andrewpaterson/HCP65/Website/docs/runtime/index.md

# HCP65 Drivers and Runtime

The HCP65's device drivers and the runtime routines compiled programs call.

- [W65C816 Runtime](w65c816.md) - the compiler's multiply, divide, shift and BCD routines, with
  and without the maths tables, and where the tables are in memory.
