andrewpaterson/HCP65/Documents/HCP65/GPIO 4bit/GPIO 4bit.odt

FEATURES

- 4 bits of individually programmable IO
- 5V CMOS level outputs and 5V TTL level inputs
- Latch input values for later reading

DESCRIPTION

The HCP65 GPIO 4bit board is a general purpose input or output component with four individually programmable pins in a pseudo DIP package.

The HCP65 GPIO 4bit board is designed to interface with an 8bit microprocessors database

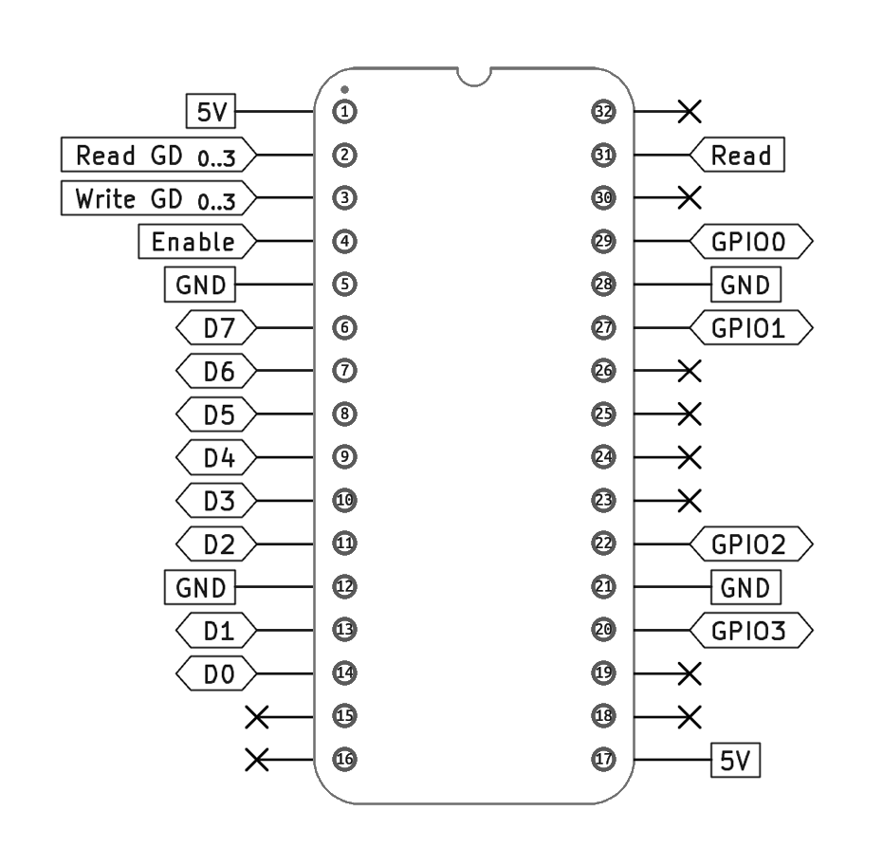
[picture p9: figure]

Pin | | I/O | Function
Name | Number
5V | 1, 17 | Power
GND | 5, 12, 21, 28 | Power
Read GD | 2 | I | Read from data bus.
Write GD | 3 | I | Write to data bus.
D0 | 14 | IO | Data bus. Eight data lines with 3-state outputs provide a bidirectional path for data and control of the GPIO board.
D1 | 13
D2 | 11
D3 | 10
D4 | 9
D5 | 8
D6 | 7
D7 | 6
Enable | 4 | I
GPIO0 | 29 | IO
GPIO1 | 27
GPIO2 | 22
GPIO3 | 20
No Connect | 15, 16, 18, 19, 23, 24, 25, 26, 30, 32 | NC

FUNCTIONAL BLOCK DIAGRAM

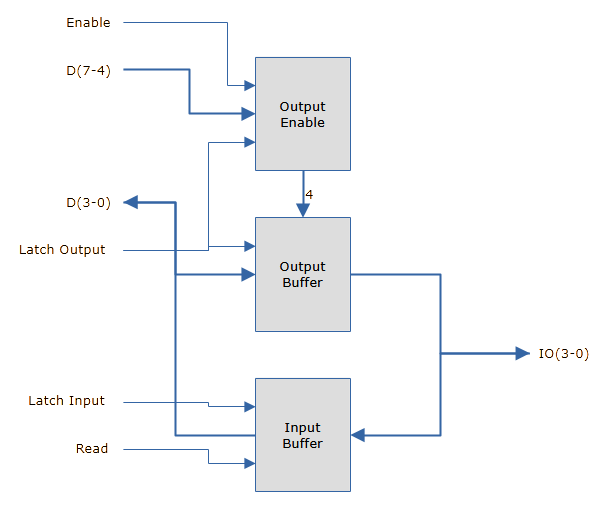
[picture p10: figure]

SCHEMATIC DIAGRAM

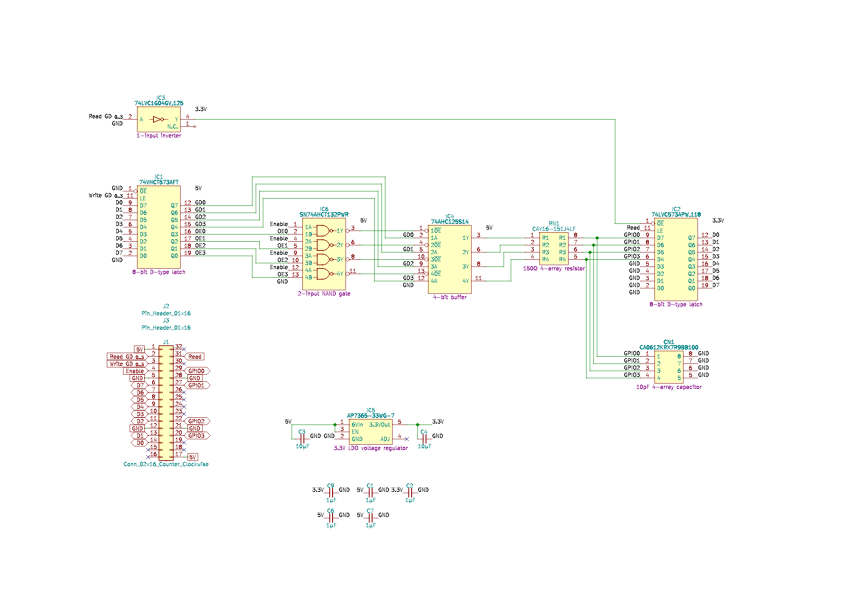
[picture p11: figure]

HCP65 GPIO 4bit
