andrewpaterson/HCP65/Documents/HCP65/Blank Pinouts/HCP65 32Pad Board W15.24mm.png

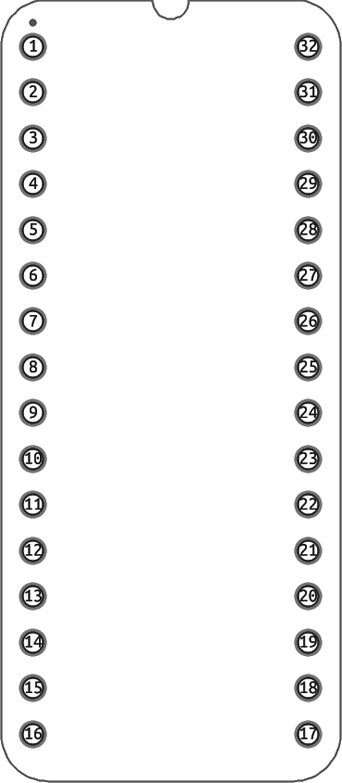
Documents/HCP65/Blank Pinouts/HCP65 32Pad Board W15.24mm.png
