andrewpaterson/HCP65/Documents/HCP65/Mainboard Small.png

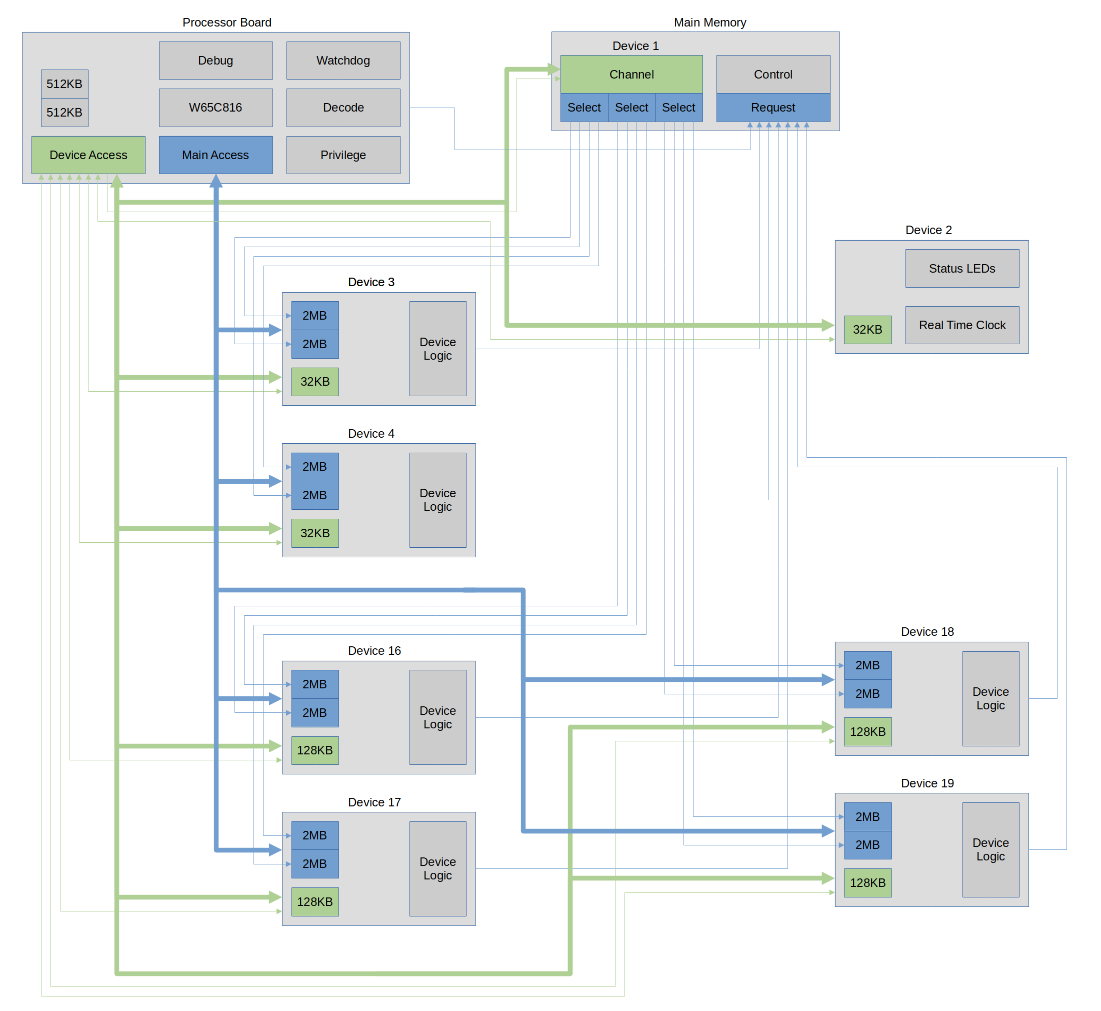
Documents/HCP65/Mainboard Small.png
