andrewpaterson/HCP65/Documents/NAND ABT.png

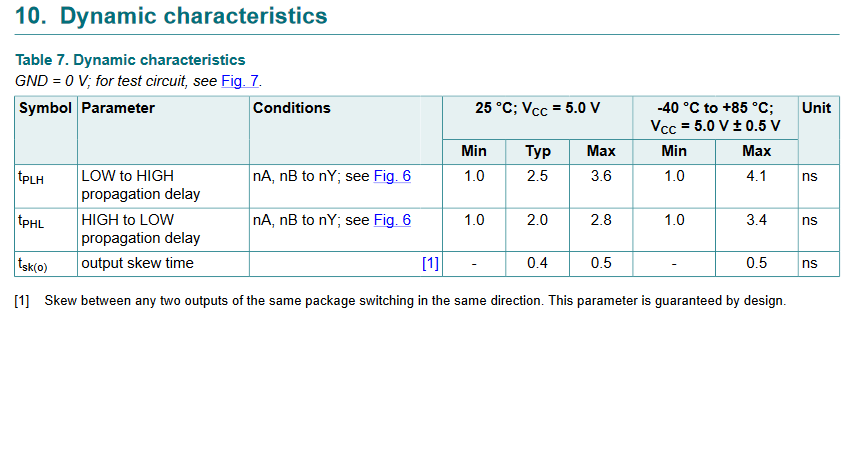
Documents/NAND ABT.png
