andrewpaterson/HCP65/Documents/NAND AC.png

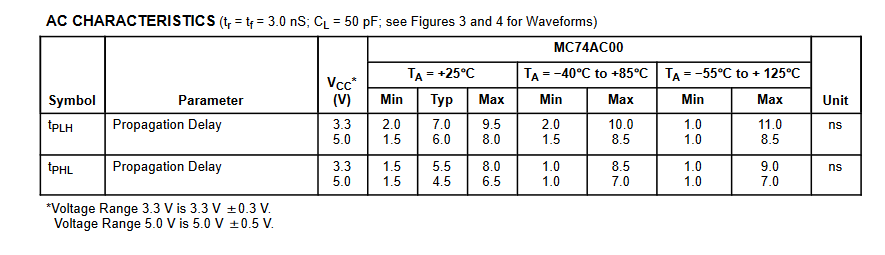
Documents/NAND AC.png
