andrewpaterson/HCP65/Documents/NAND ACT.png

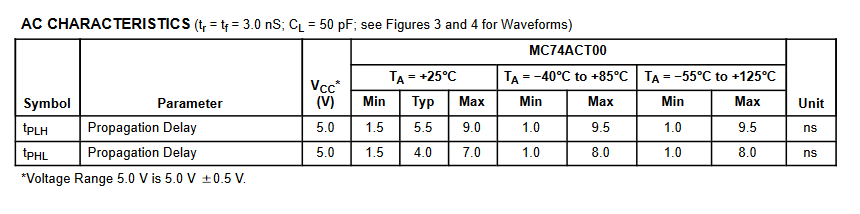
Documents/NAND ACT.png
