andrewpaterson/HCP65/Documents/NAND AHC and AHCT.png

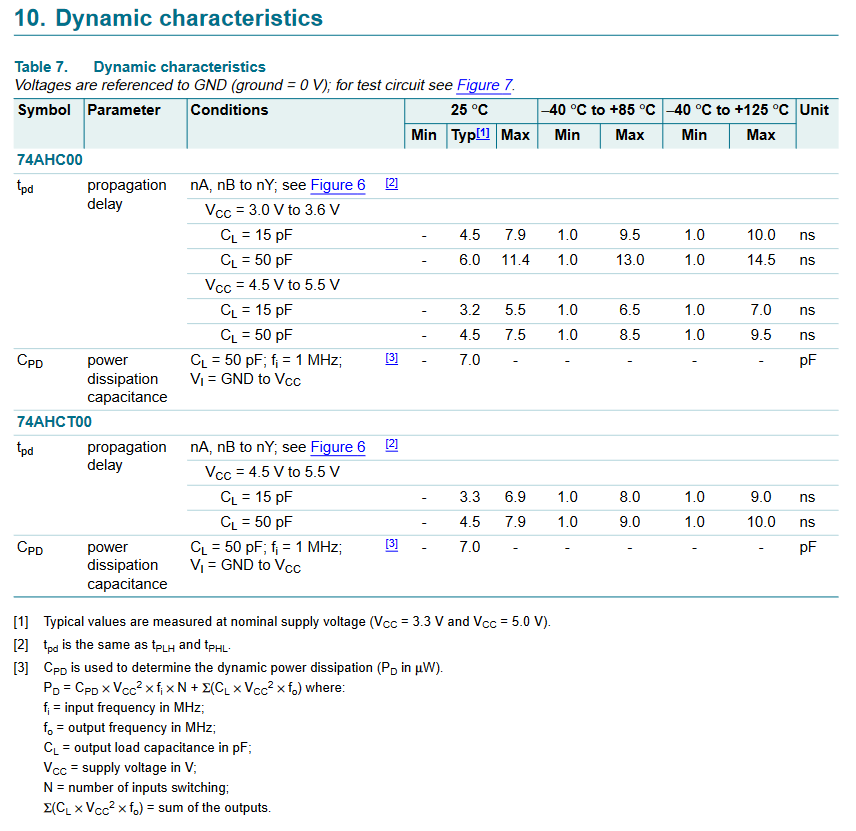
Documents/NAND AHC and AHCT.png
