andrewpaterson/HCP65/Documents/NAND ALVC.png

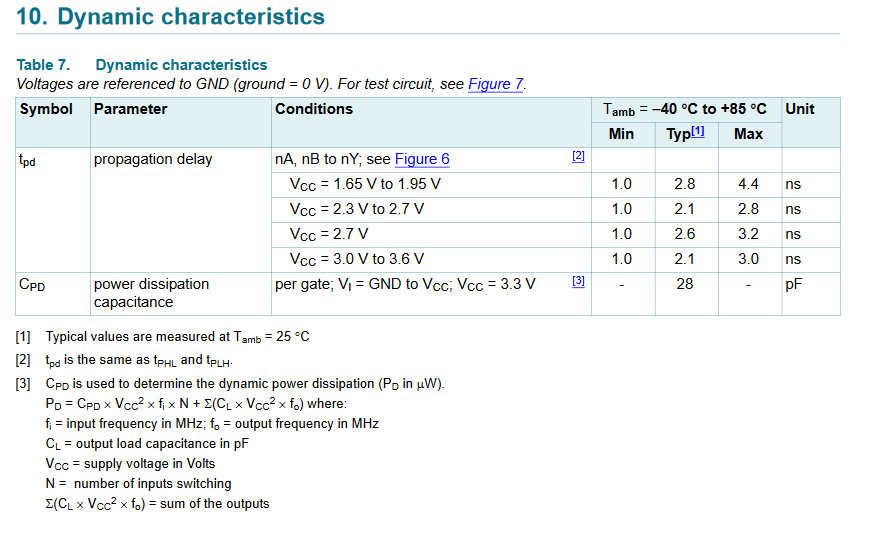
Documents/NAND ALVC.png
