andrewpaterson/HCP65/Documents/NAND F.png

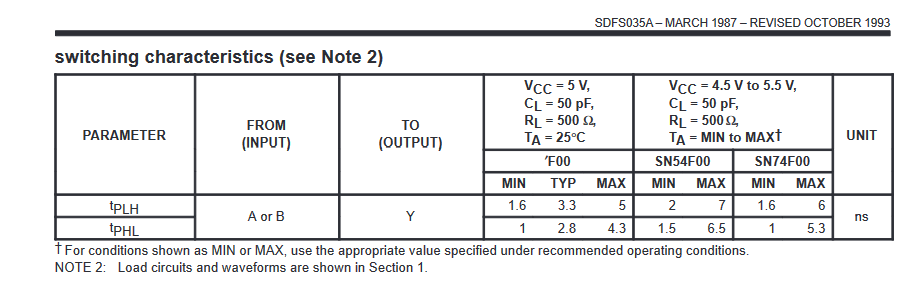
Documents/NAND F.png
