andrewpaterson/HCP65/Documents/NAND HC and HCT.png

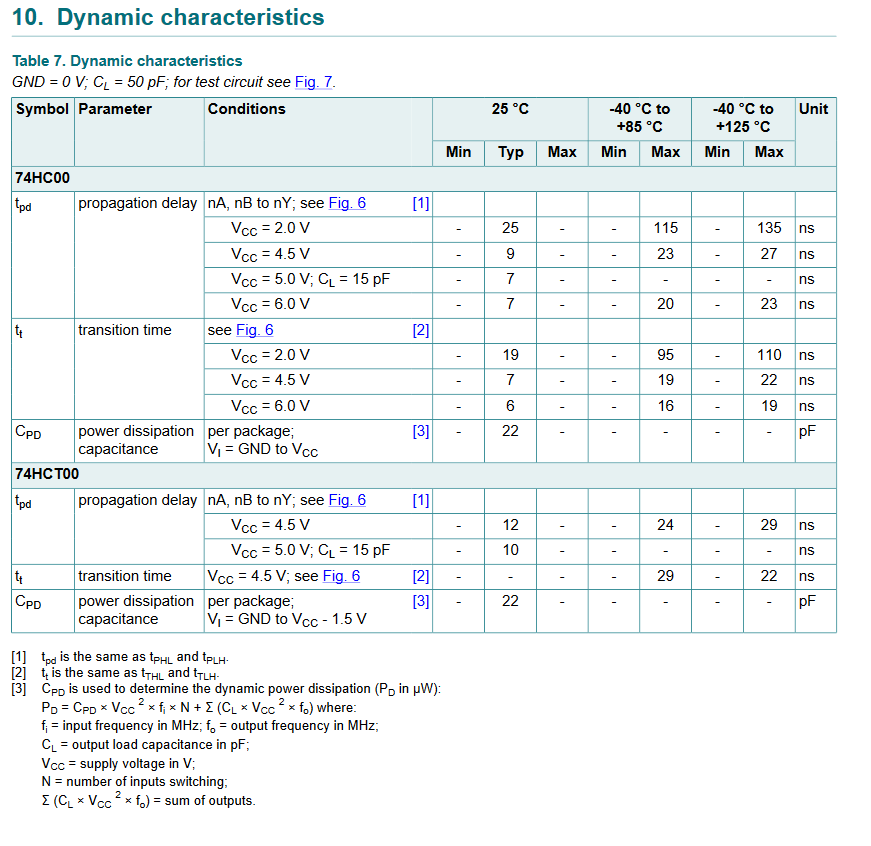
Documents/NAND HC and HCT.png
