andrewpaterson/HCP65/Documents/NAND LCX.png

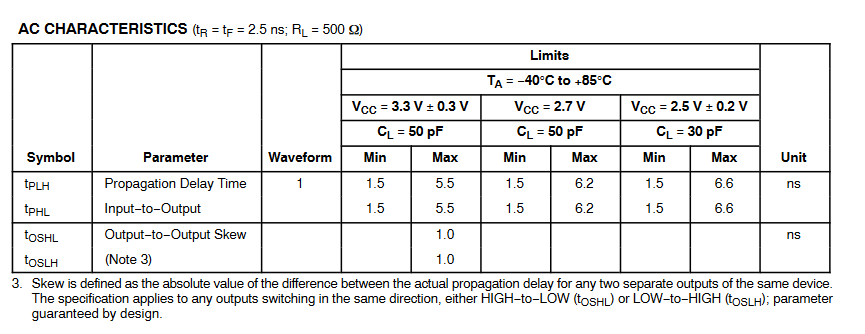
Documents/NAND LCX.png
