andrewpaterson/HCP65/Documents/NAND LV.png

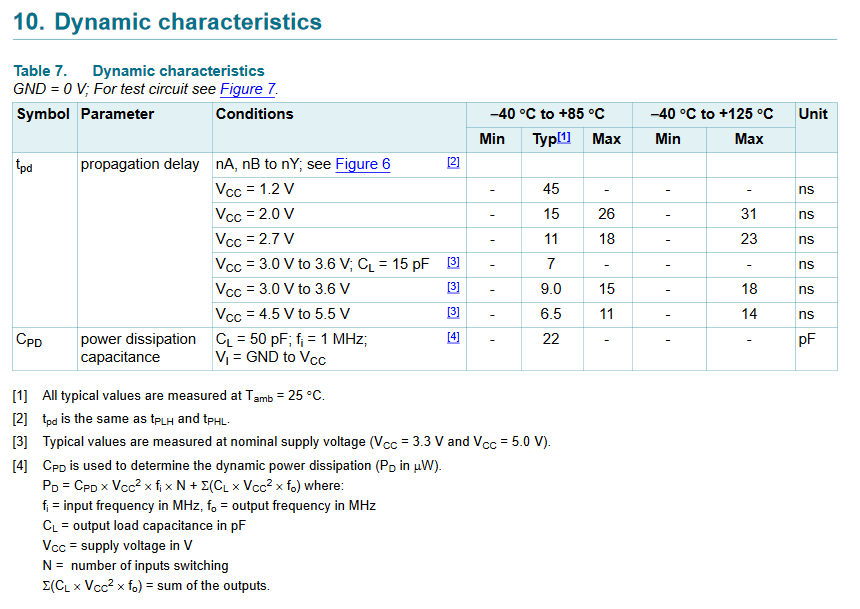
Documents/NAND LV.png
