andrewpaterson/HCP65/Documents/NAND LVC.png

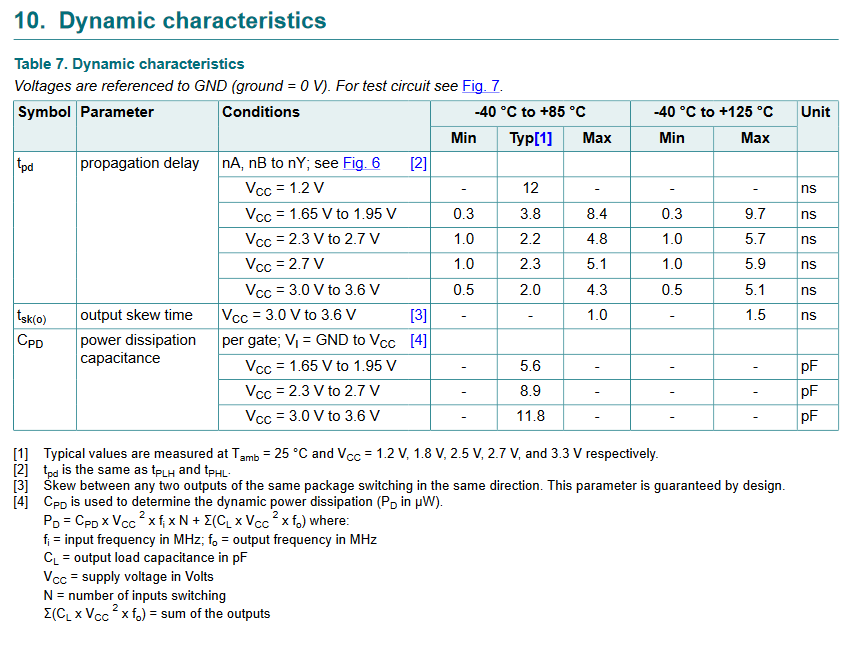
Documents/NAND LVC.png
