andrewpaterson/HCP65/Documents/NAND VHC.png

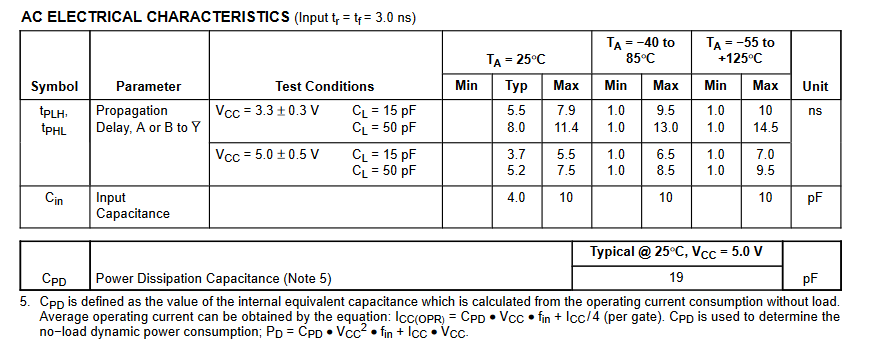
Documents/NAND VHC.png
