andrewpaterson/HCP65/Documents/NAND VHCT.png

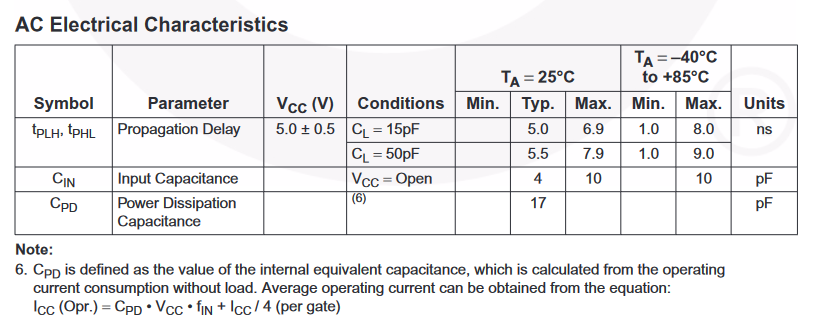
Documents/NAND VHCT.png
