andrewpaterson/HCP65/Pictures/3 Input Or Gare - Source 3V.png

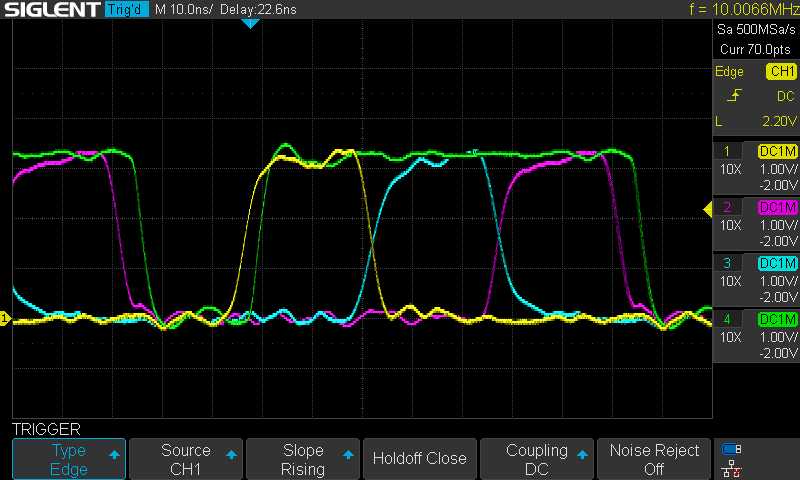
Pictures/3 Input Or Gare - Source 3V.png
