andrewpaterson/HCP65/Pictures/3 Input Or Gare - Source 5V.png

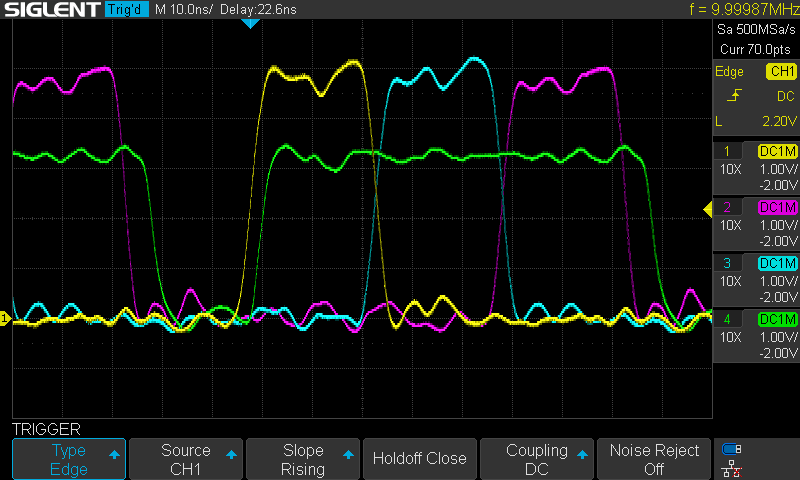
Pictures/3 Input Or Gare - Source 5V.png
