andrewpaterson/HCP65/Pictures/7 Segment Reader.png

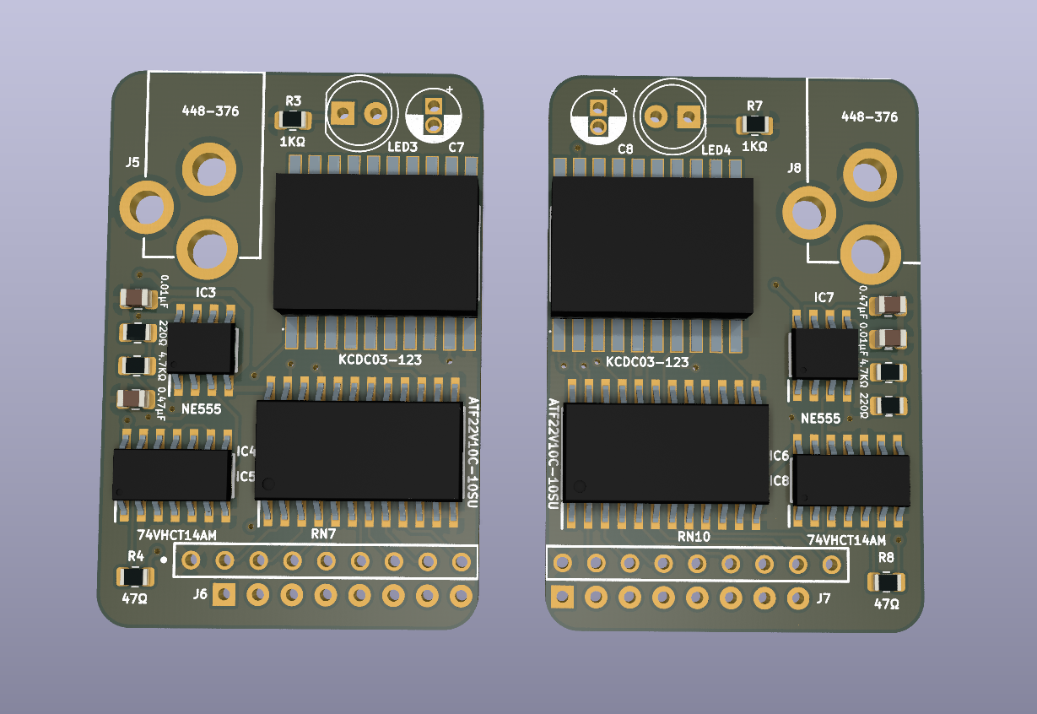
Pictures/7 Segment Reader.png
