andrewpaterson/HCP65/Pictures/300Hz No Schmitt.png

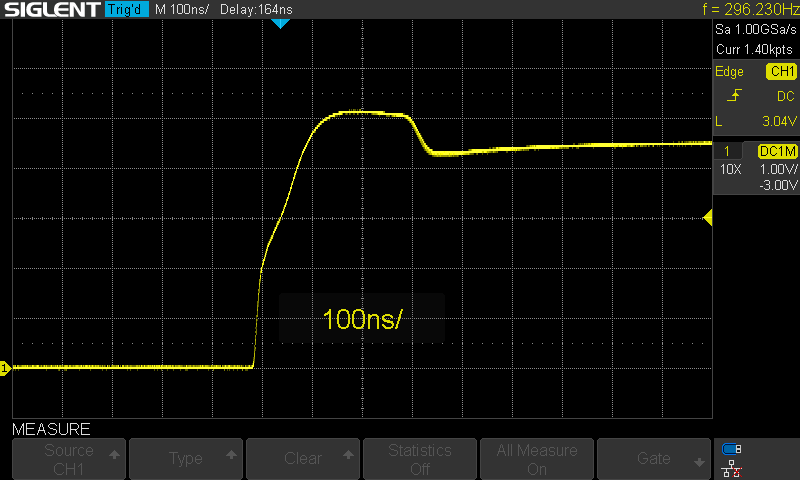
Pictures/300Hz No Schmitt.png
