andrewpaterson/HCP65/Pictures/300Hz with Schmitt.png

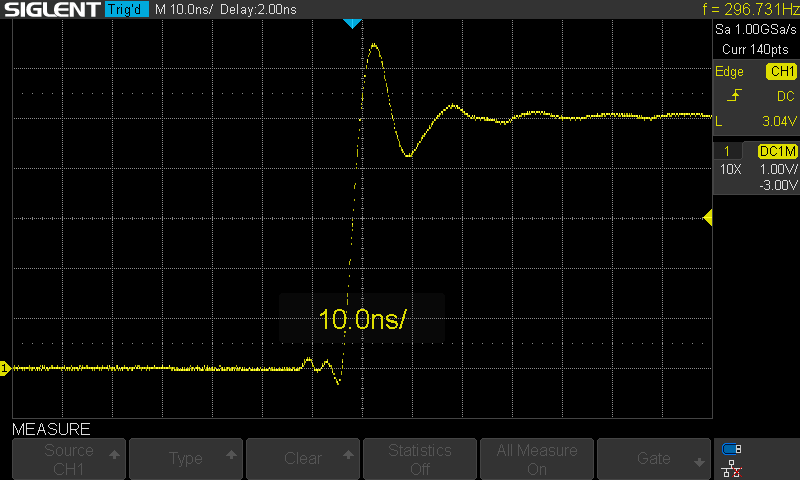
Pictures/300Hz with Schmitt.png
