andrewpaterson/HCP65/Pictures/300Hz.png

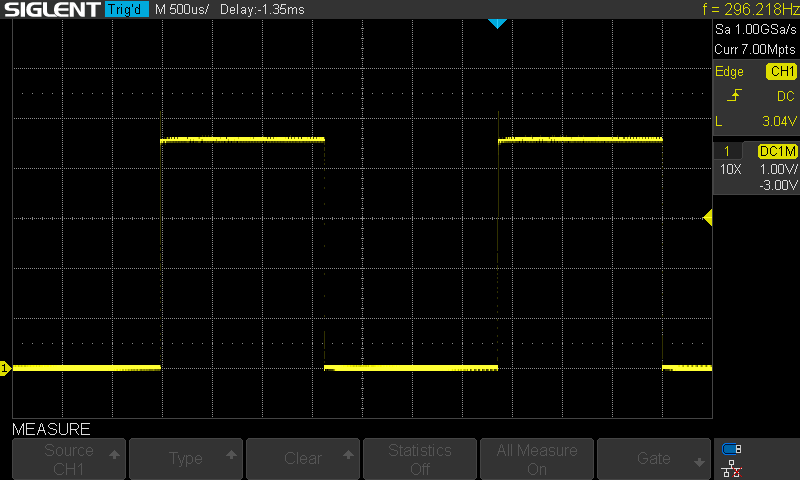
Pictures/300Hz.png
