andrewpaterson/HCP65/Pictures/400x300 Ref1.png

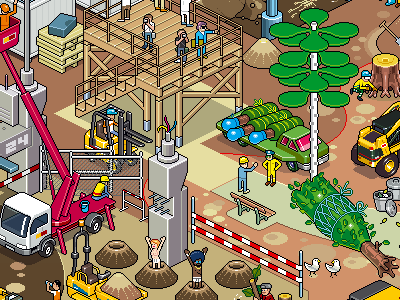
Pictures/400x300 Ref1.png
