andrewpaterson/HCP65/Pictures/400x300 Ref2.png

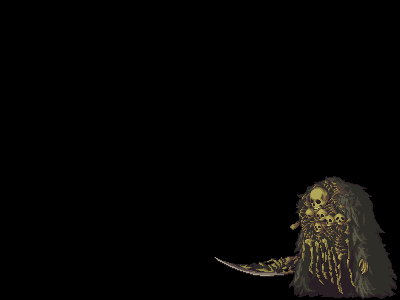
Pictures/400x300 Ref2.png
