andrewpaterson/HCP65/Pictures/400x300 Ref3.png

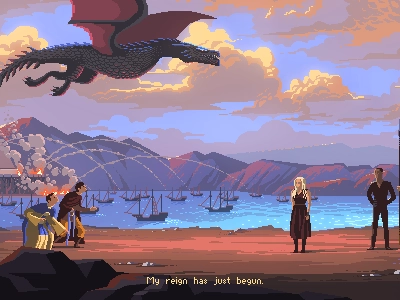
Pictures/400x300 Ref3.png
