andrewpaterson/HCP65/Pictures/400x300 Ref4.png

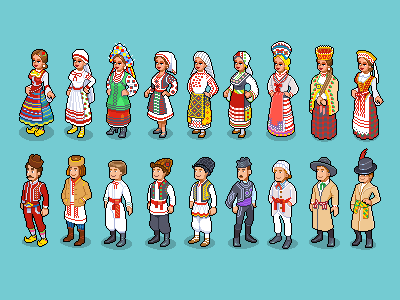
Pictures/400x300 Ref4.png
