andrewpaterson/HCP65/Pictures/816 Bodge Board V1 - important stuff.png

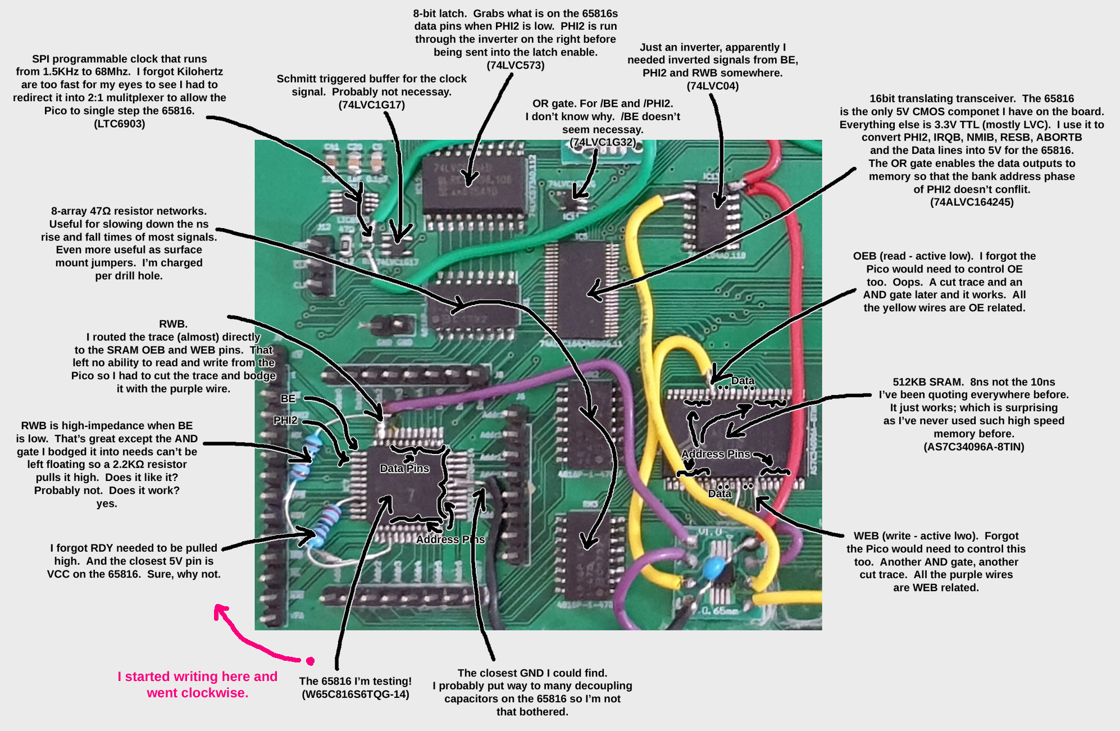
Pictures/816 Bodge Board V1 - important stuff.png
