andrewpaterson/HCP65/Pictures/816 bodge board V1 populated.jpg

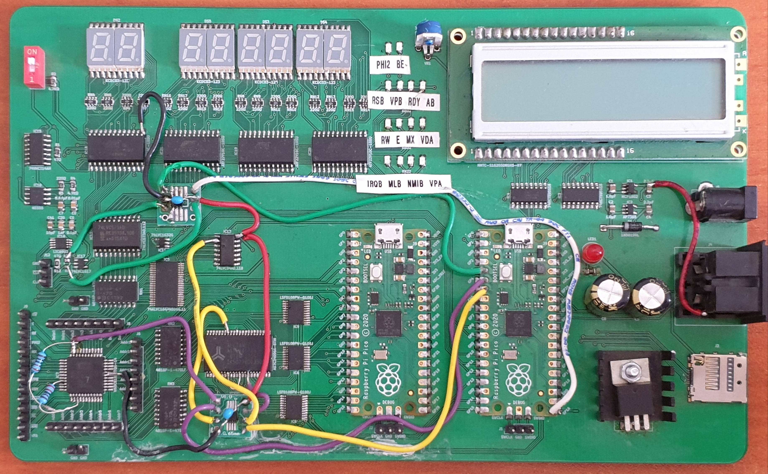
Pictures/816 bodge board V1 populated.jpg
