andrewpaterson/HCP65/Pictures/816 bodge board V1 running.jpg

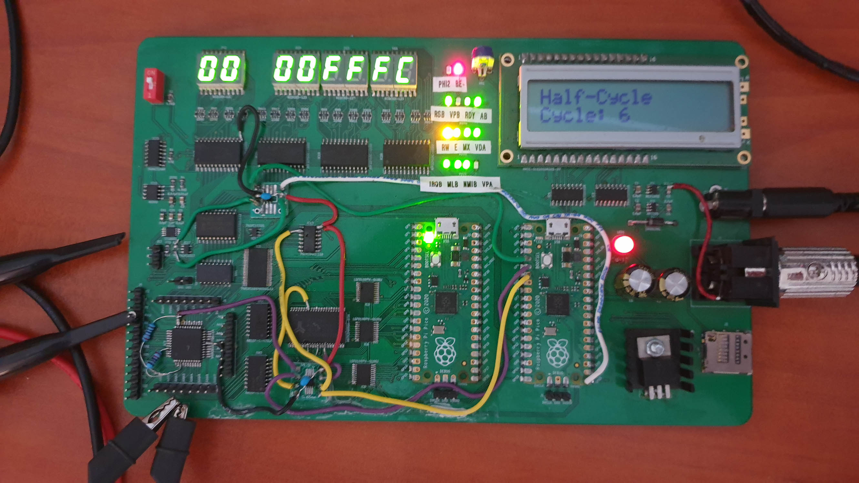
Pictures/816 bodge board V1 running.jpg
