andrewpaterson/HCP65/Pictures/816 bodge board V1 unpopulated.jpg

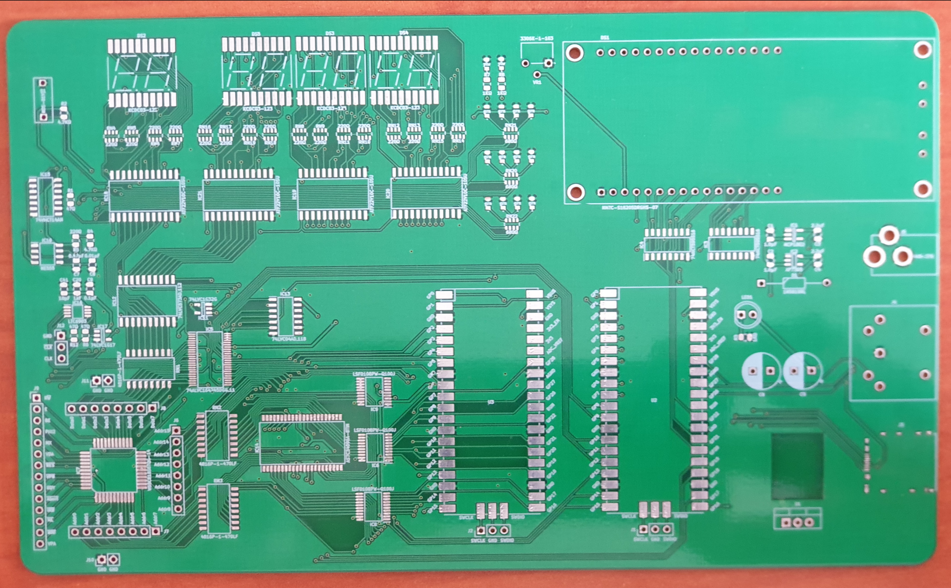
Pictures/816 bodge board V1 unpopulated.jpg
