andrewpaterson/HCP65/Pictures/20220211_165340.jpg

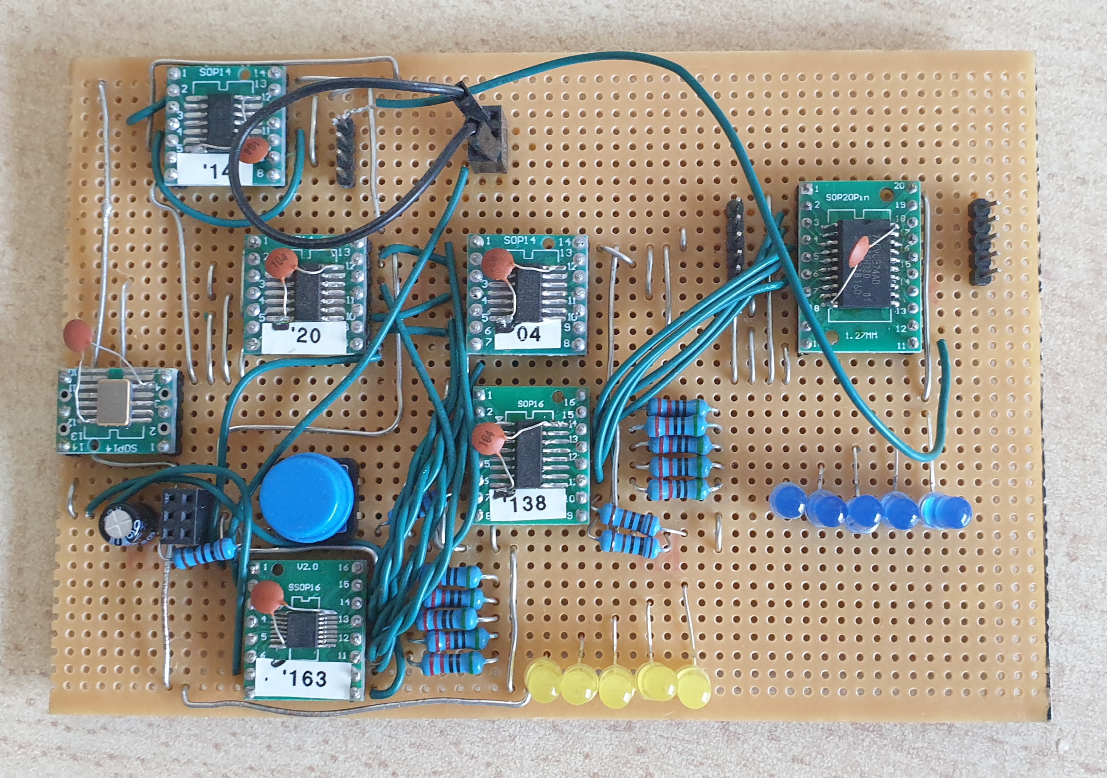
Pictures/20220211_165340.jpg
