andrewpaterson/HCP65/Pictures/20220607_114405.jpg

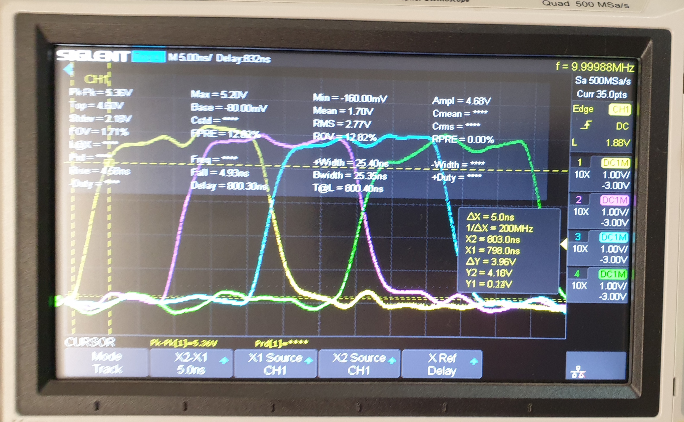
Pictures/20220607_114405.jpg
