andrewpaterson/HCP65/Pictures/Address Decode.png

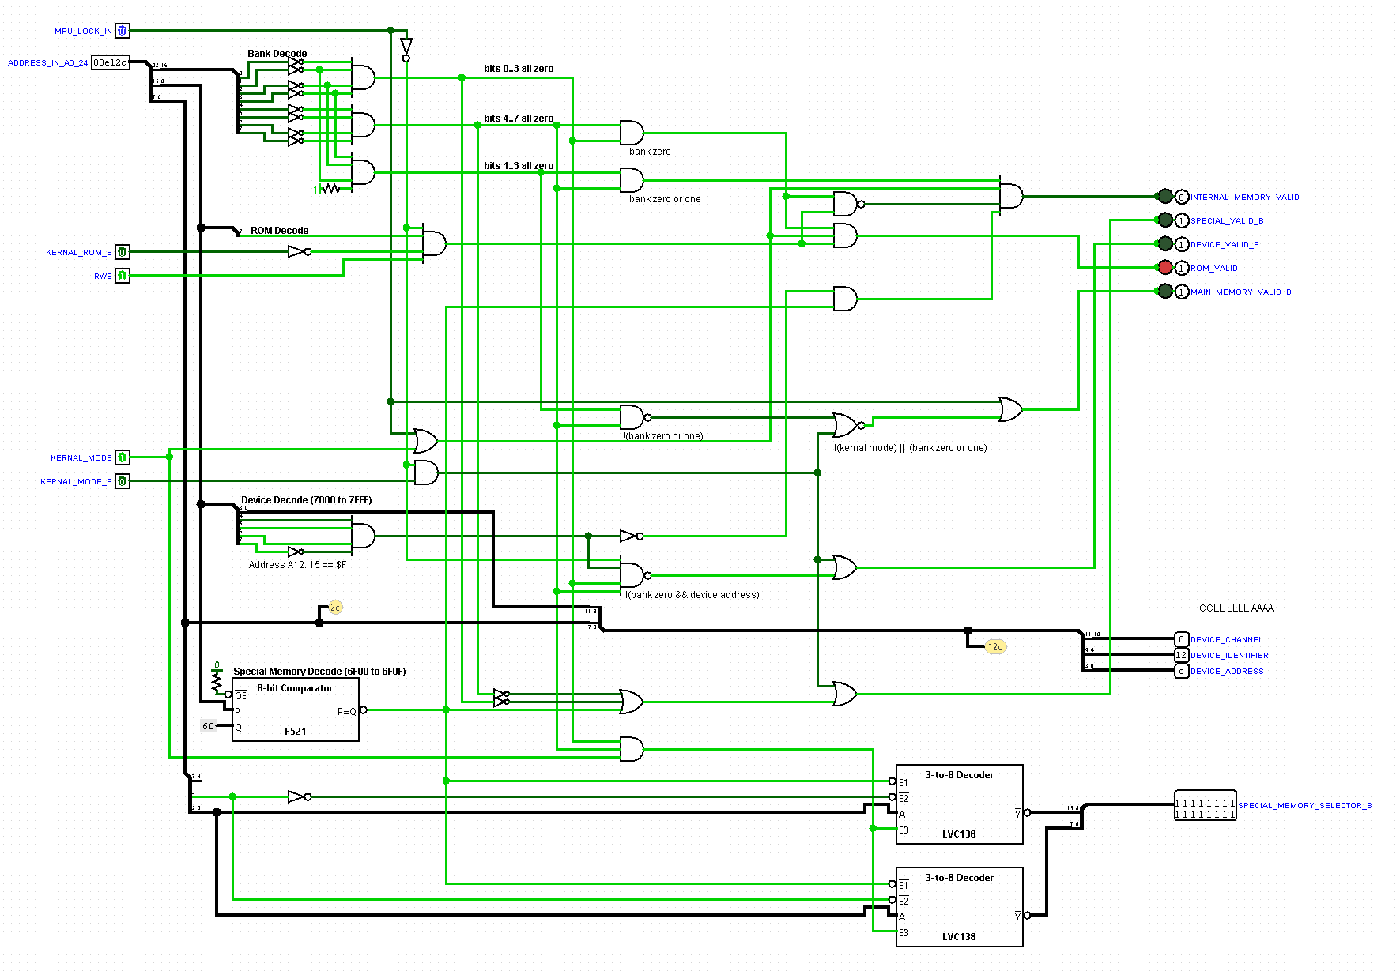
Pictures/Address Decode.png
