andrewpaterson/HCP65/Pictures/Address Predecode.png

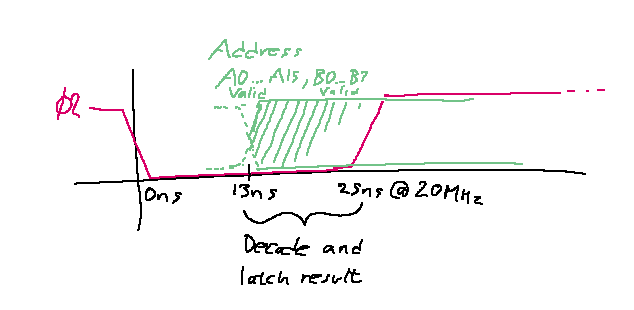
Pictures/Address Predecode.png
