andrewpaterson/HCP65/Pictures/Apple II/Apple II Rev0 - partially populated.jpg

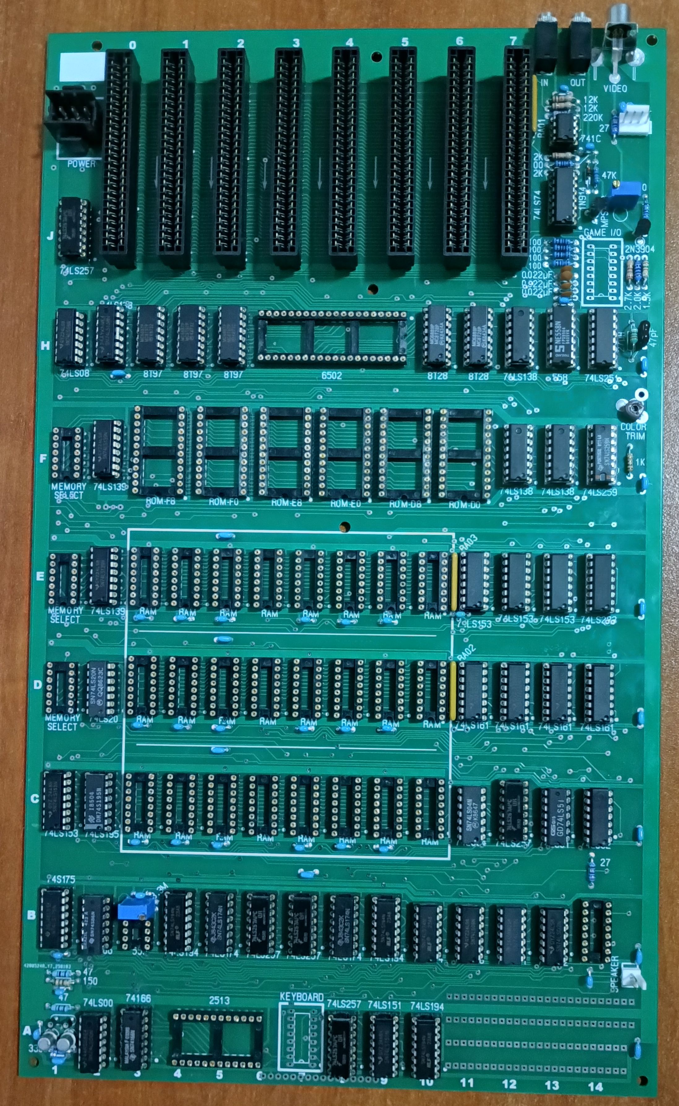
Pictures/Apple II/Apple II Rev0 - partially populated.jpg
