andrewpaterson/HCP65/Pictures/Audio DAC schematic 2.png

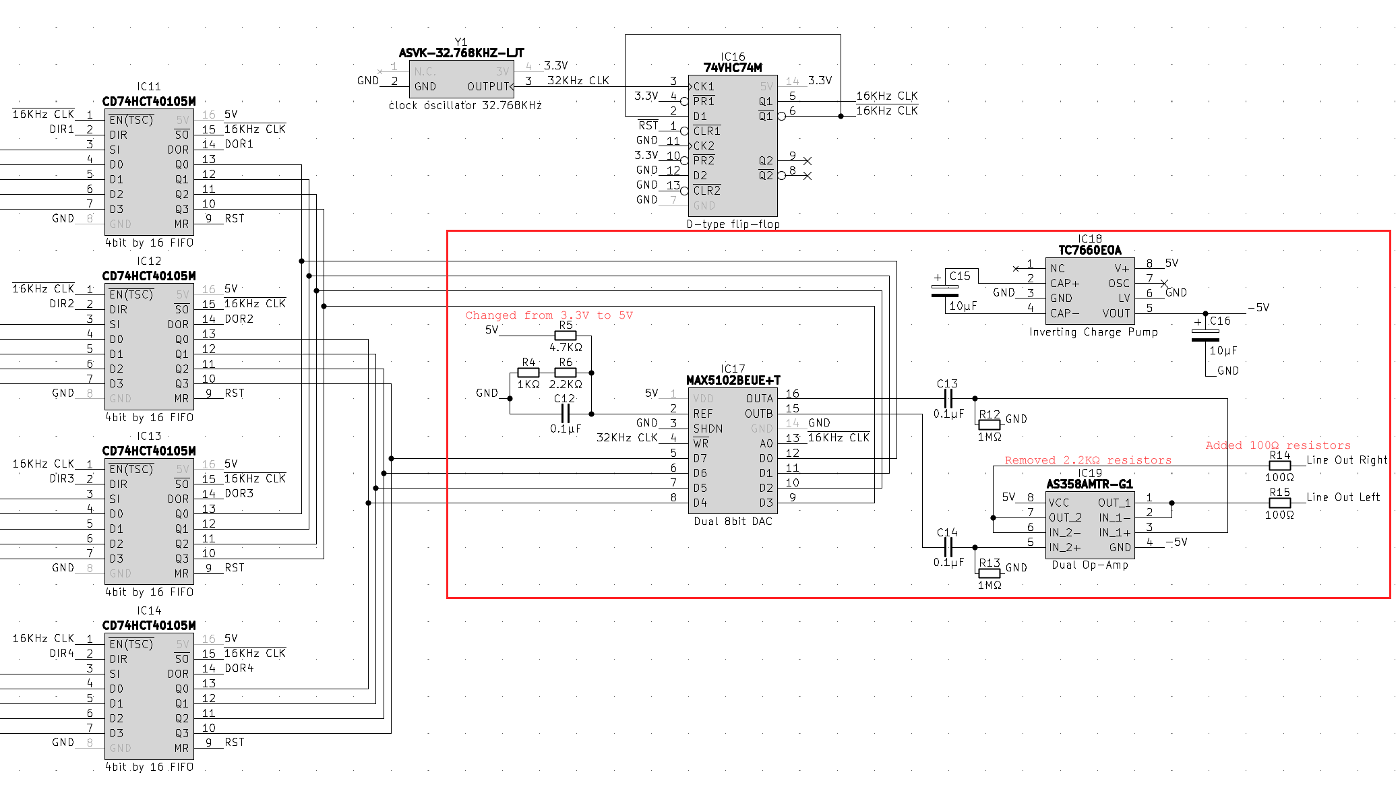
Pictures/Audio DAC schematic 2.png
