andrewpaterson/HCP65/Pictures/Audio DAC schematic.png

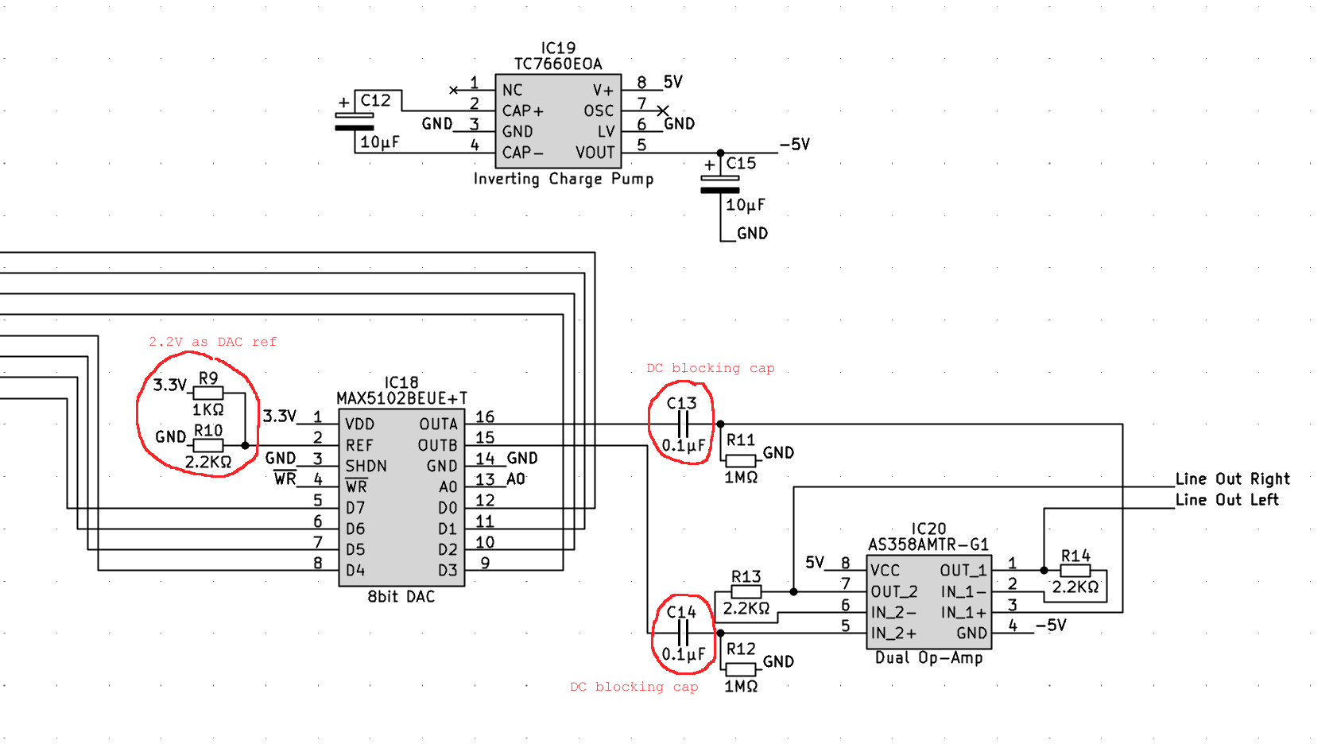
Pictures/Audio DAC schematic.png
