andrewpaterson/HCP65/Pictures/Audio DAC waveform.jpg

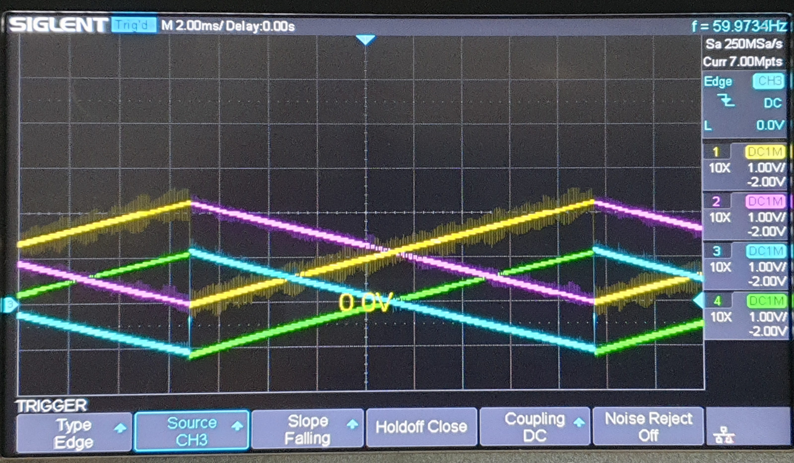
Pictures/Audio DAC waveform.jpg
