andrewpaterson/HCP65/Pictures/Audo DAC boad.jpg

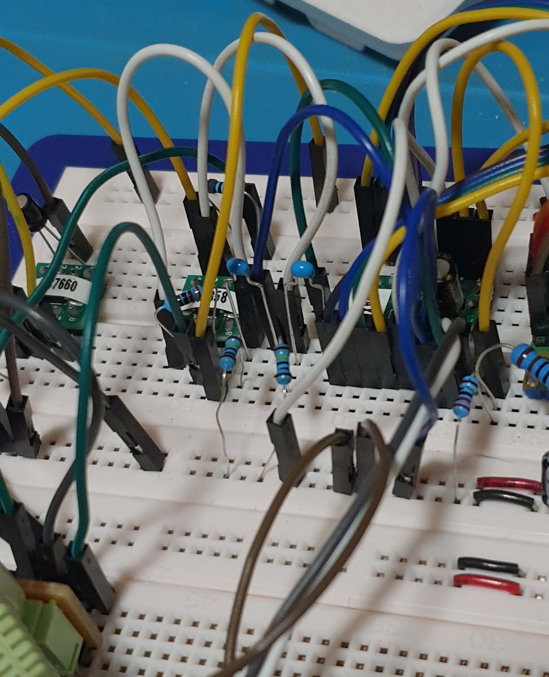
Pictures/Audo DAC boad.jpg
