andrewpaterson/HCP65/Pictures/Bank is Zero Latch.png

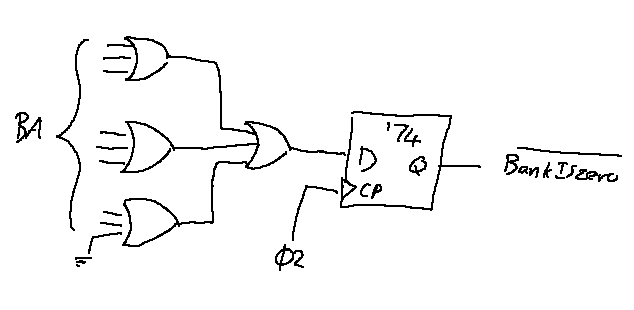
Pictures/Bank is Zero Latch.png
