andrewpaterson/HCP65/Pictures/Blitter Board.png

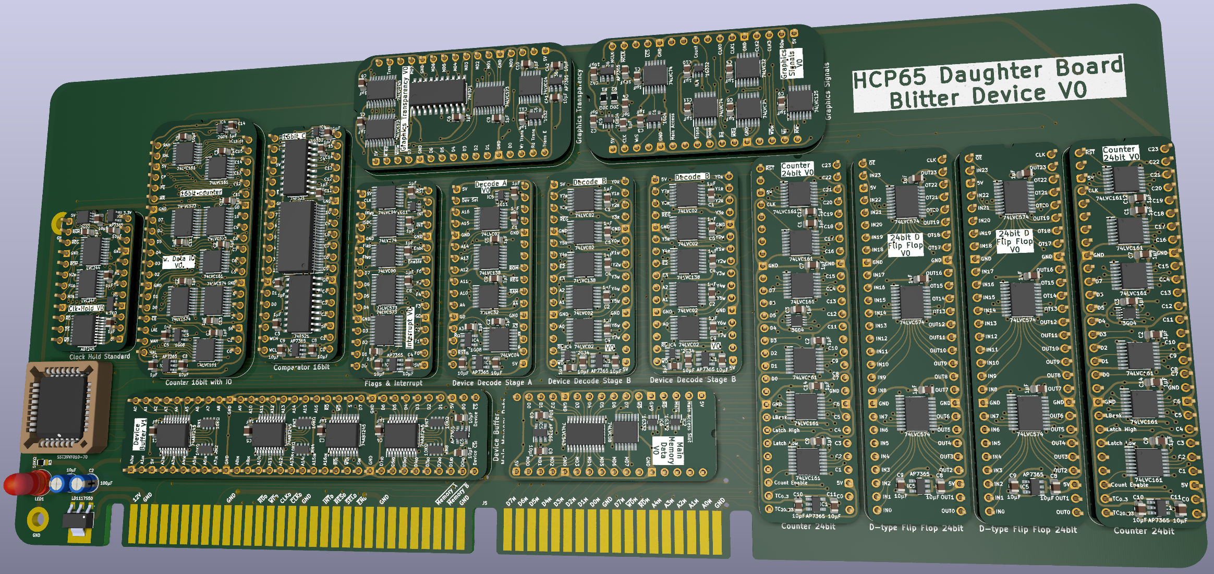
Pictures/Blitter Board.png
