andrewpaterson/HCP65/Pictures/Block Diagram/Bigger Block Diagram.png

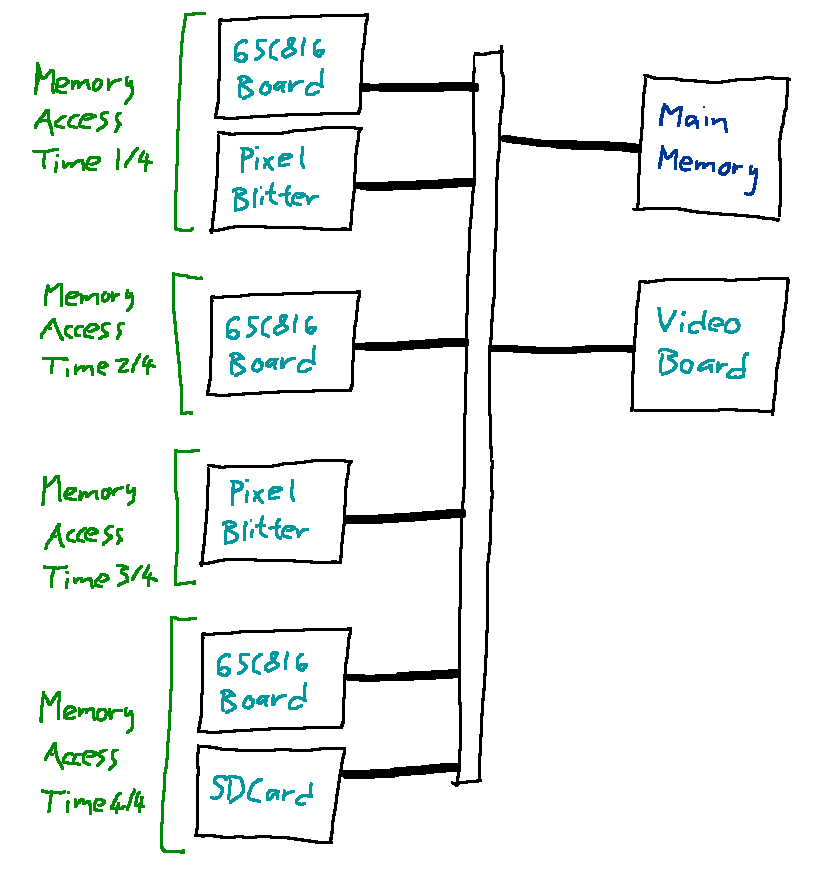
Pictures/Block Diagram/Bigger Block Diagram.png
