andrewpaterson/HCP65/Pictures/Block Diagram/Sorta Block Diagram.png

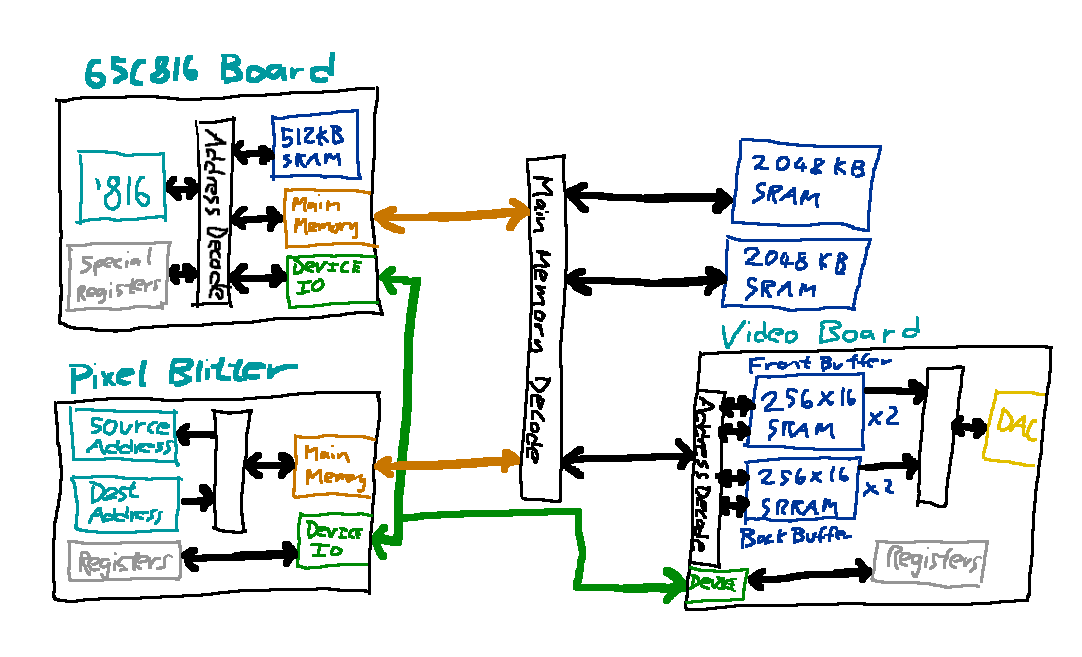
Pictures/Block Diagram/Sorta Block Diagram.png
