andrewpaterson/HCP65/Pictures/Block Diagram/Timing.png

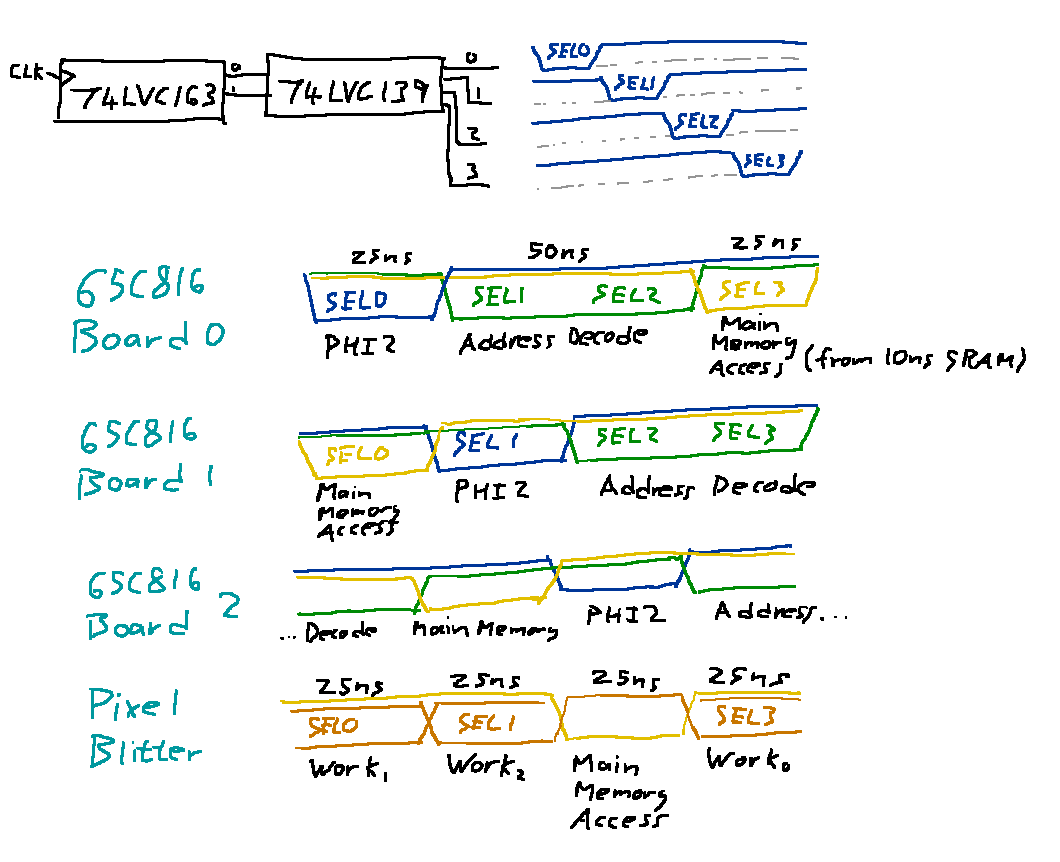
Pictures/Block Diagram/Timing.png
