andrewpaterson/HCP65/Pictures/Buffered Timer.jpg

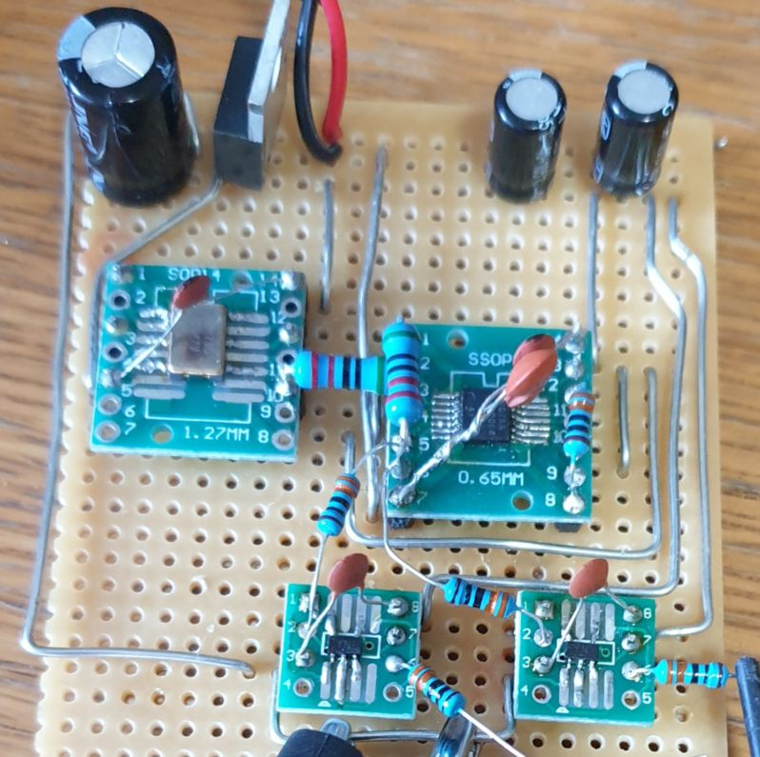
Pictures/Buffered Timer.jpg
