andrewpaterson/HCP65/Pictures/Calling Conventiion/Function Call.png

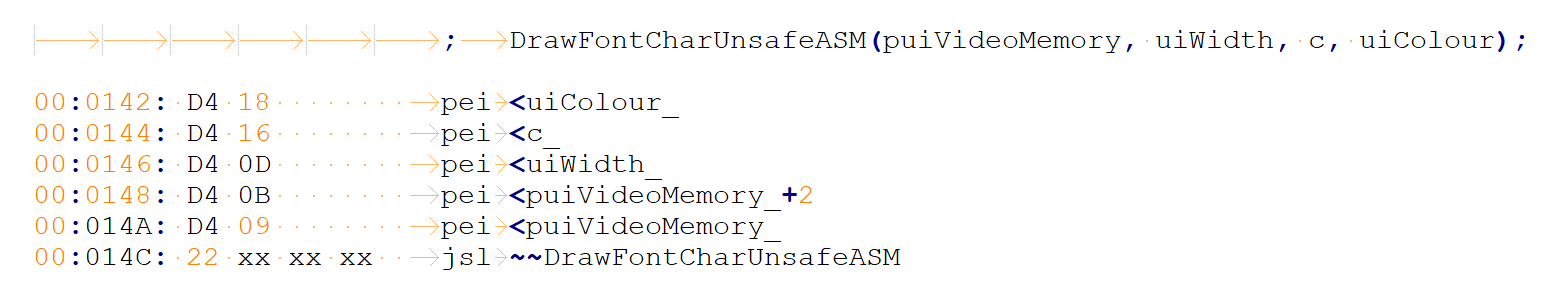
Pictures/Calling Conventiion/Function Call.png
