andrewpaterson/HCP65/Pictures/Calling Conventiion/Function Cleanup.png

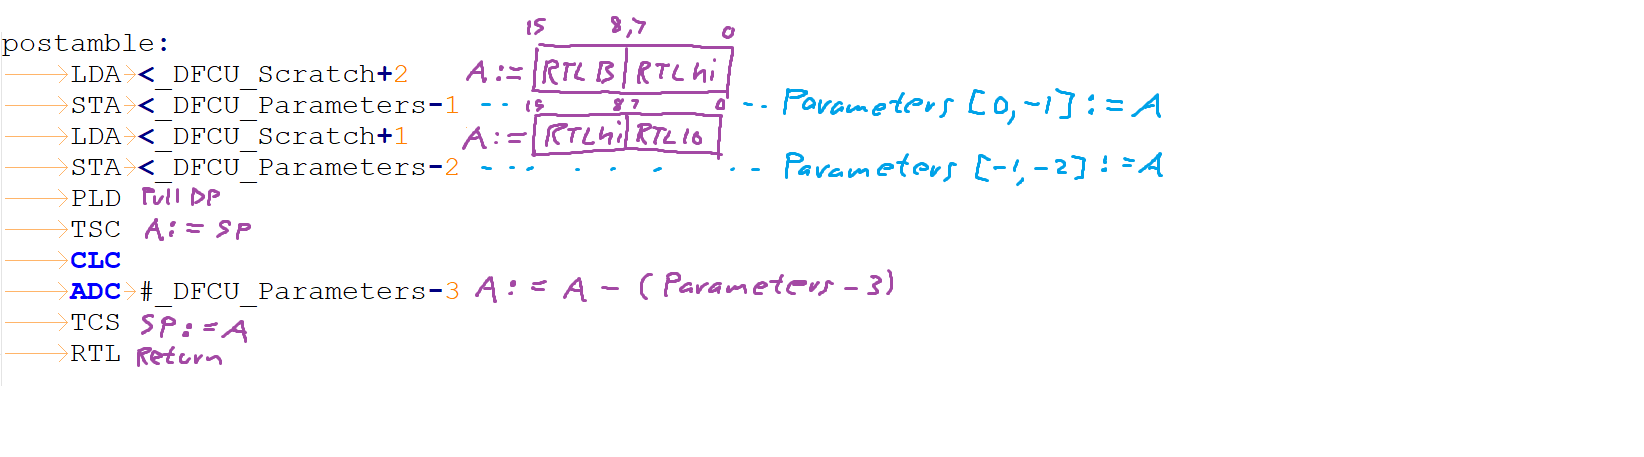
Pictures/Calling Conventiion/Function Cleanup.png
