andrewpaterson/HCP65/Pictures/Calling Conventiion/Function Definition.png

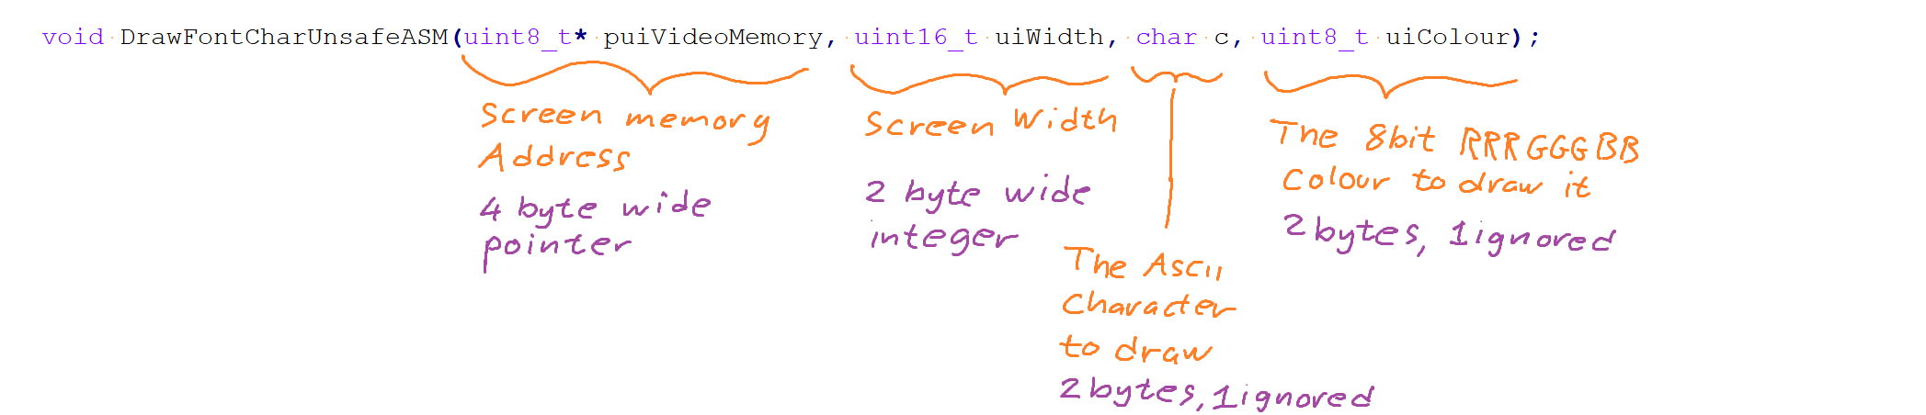
Pictures/Calling Conventiion/Function Definition.png
