andrewpaterson/HCP65/Pictures/Calling Conventiion/Function Stack After Cleanup.png

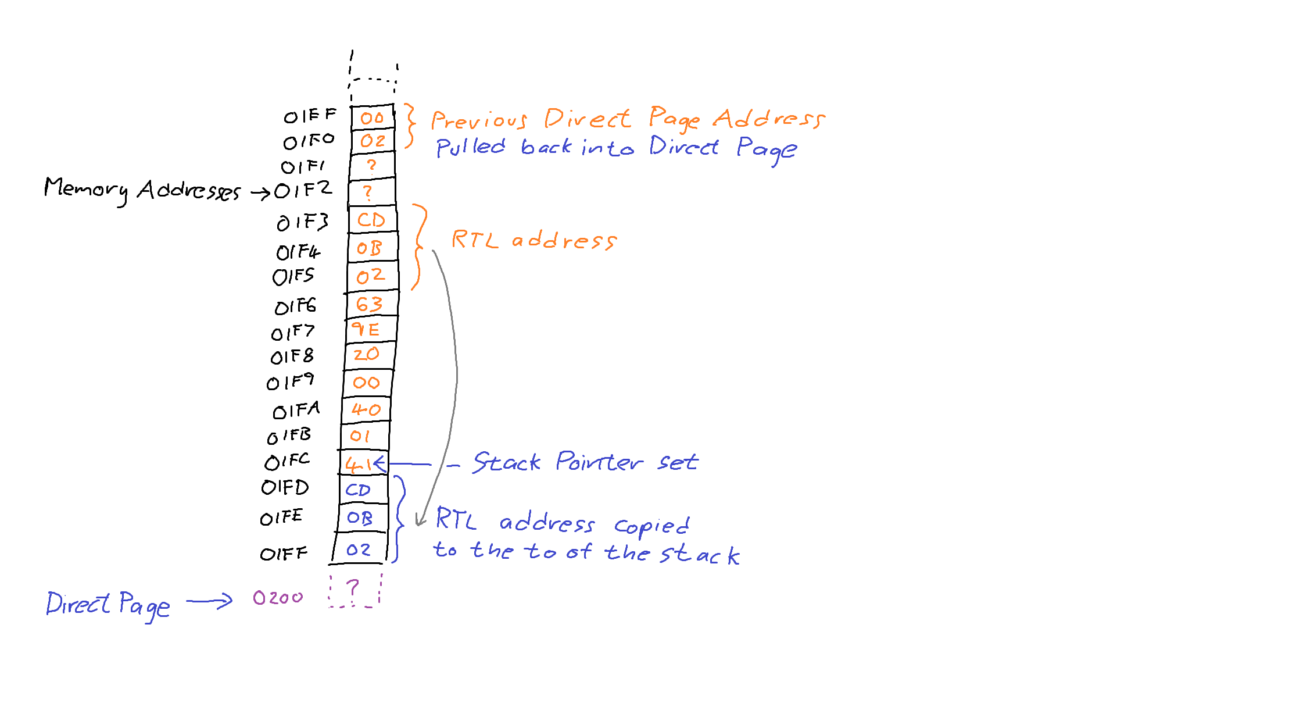
Pictures/Calling Conventiion/Function Stack After Cleanup.png
