andrewpaterson/HCP65/Pictures/Clock Hold.png

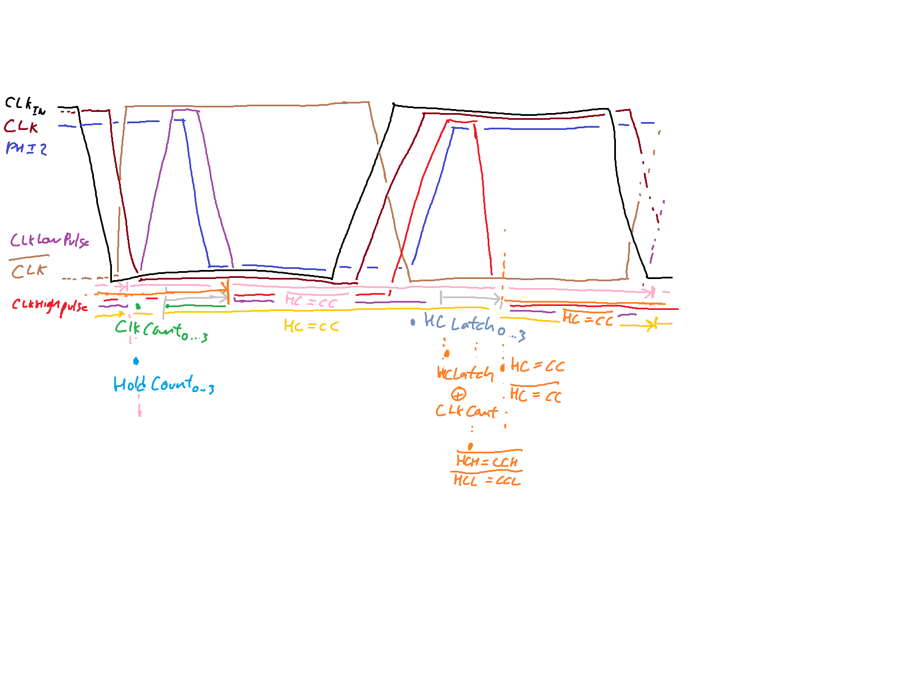
Pictures/Clock Hold.png
