andrewpaterson/HCP65/Pictures/Coprocessor/Coprocessor Board - Additional.png

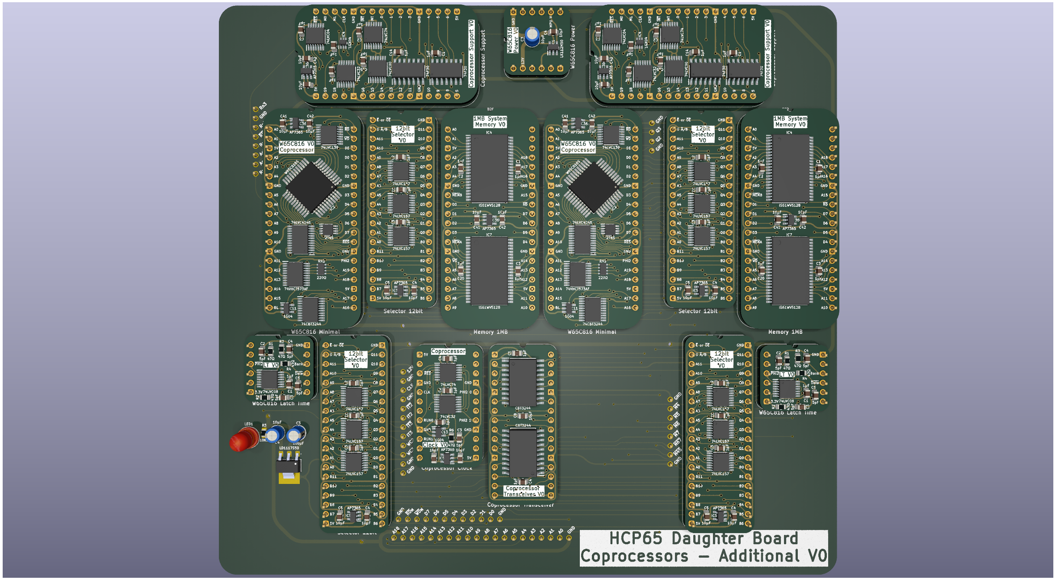
Pictures/Coprocessor/Coprocessor Board - Additional.png
