andrewpaterson/HCP65/Pictures/Coprocessor/Coprocessor Board - Main.png

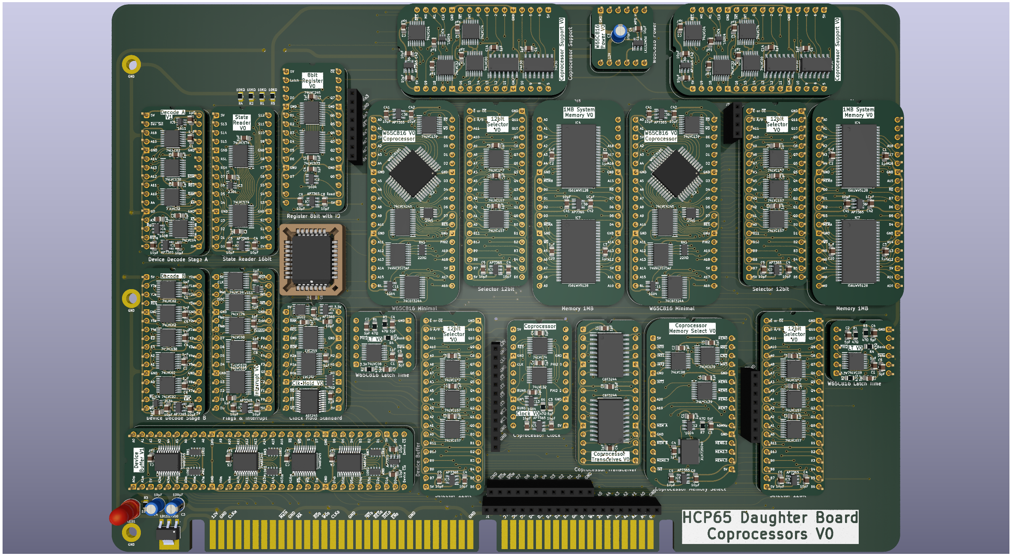
Pictures/Coprocessor/Coprocessor Board - Main.png
