andrewpaterson/HCP65/Pictures/CounterDecoder.png

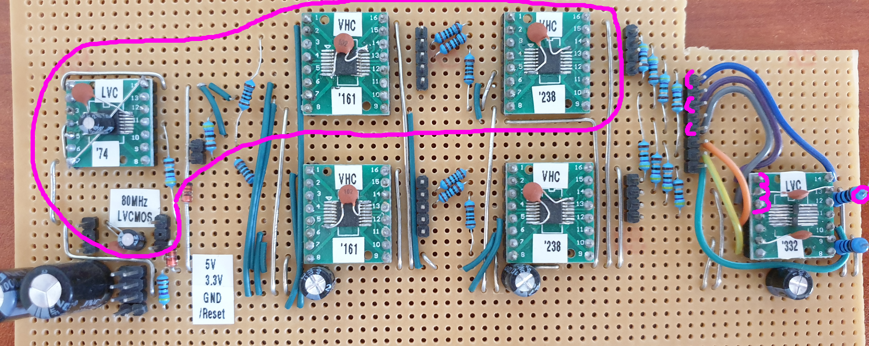
Pictures/CounterDecoder.png
