andrewpaterson/HCP65/Pictures/EPM570 Programmer PCB.png

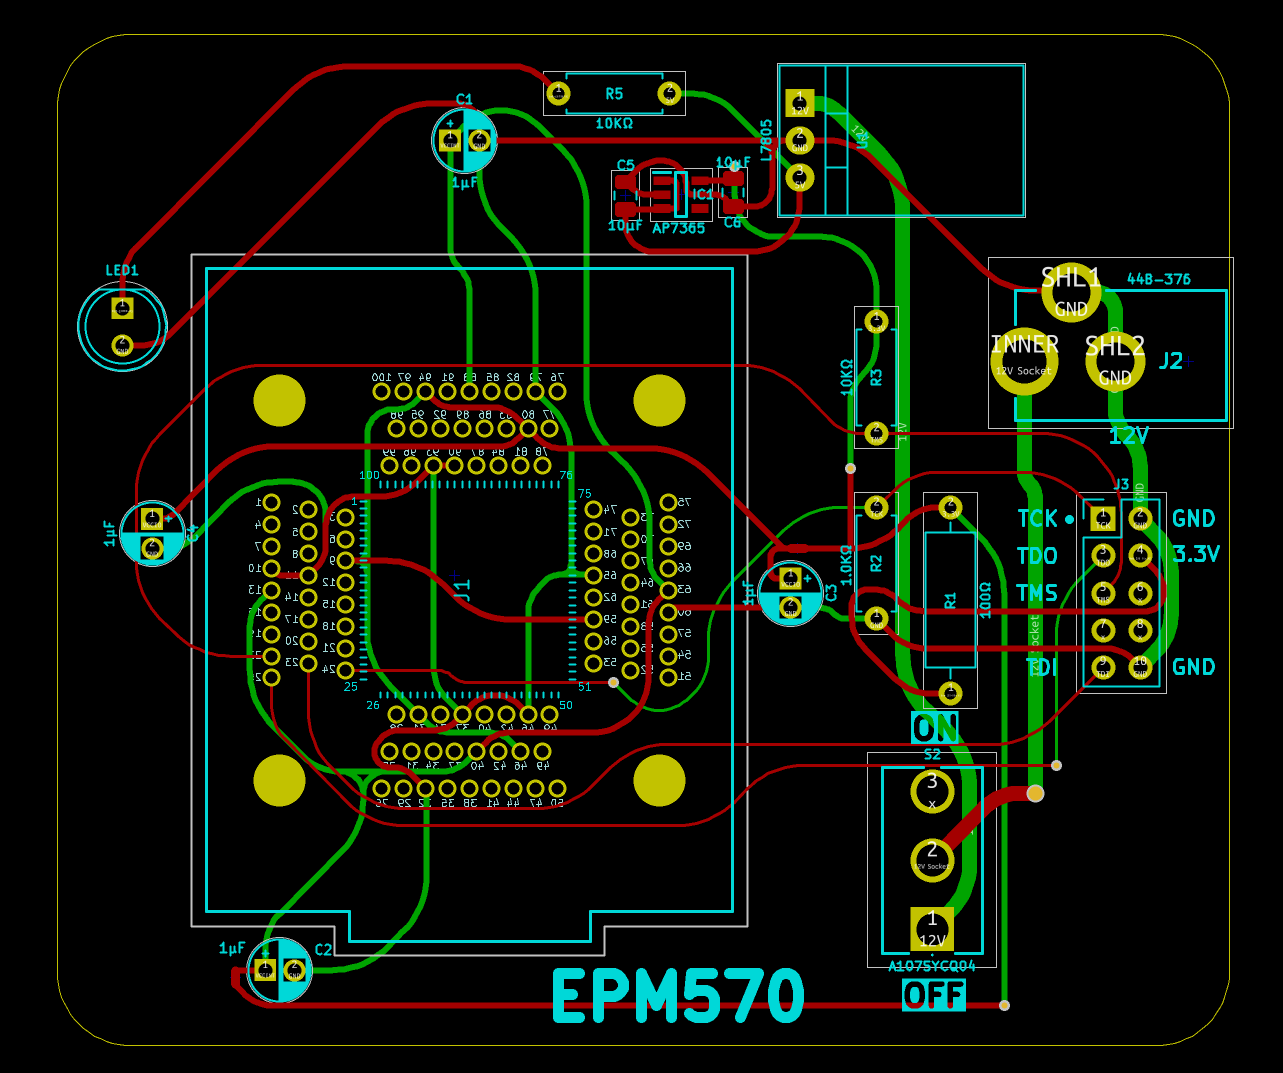
Pictures/EPM570 Programmer PCB.png
