andrewpaterson/HCP65/Pictures/EPM570 Programmer Schematic.png

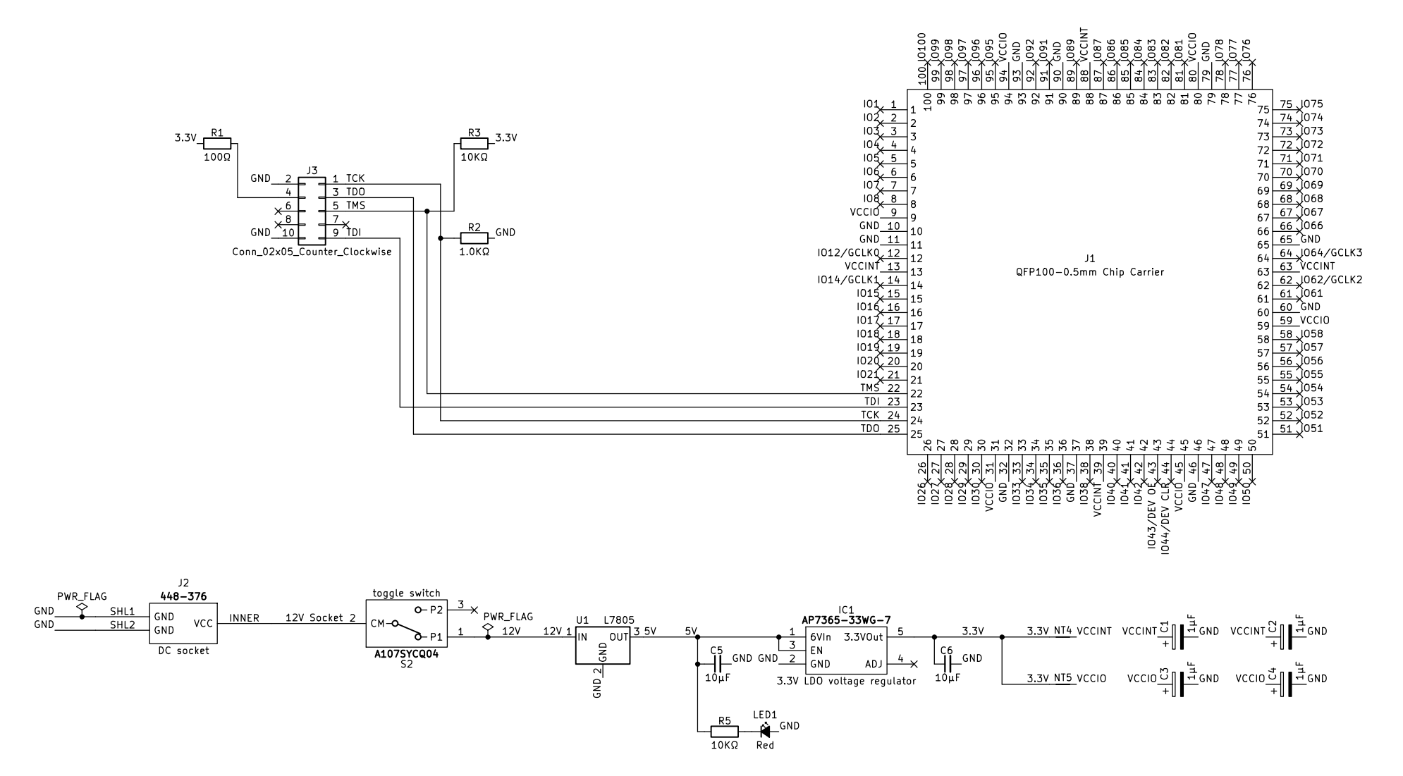
Pictures/EPM570 Programmer Schematic.png
