andrewpaterson/HCP65/Pictures/EPM570 Programmer.jpg

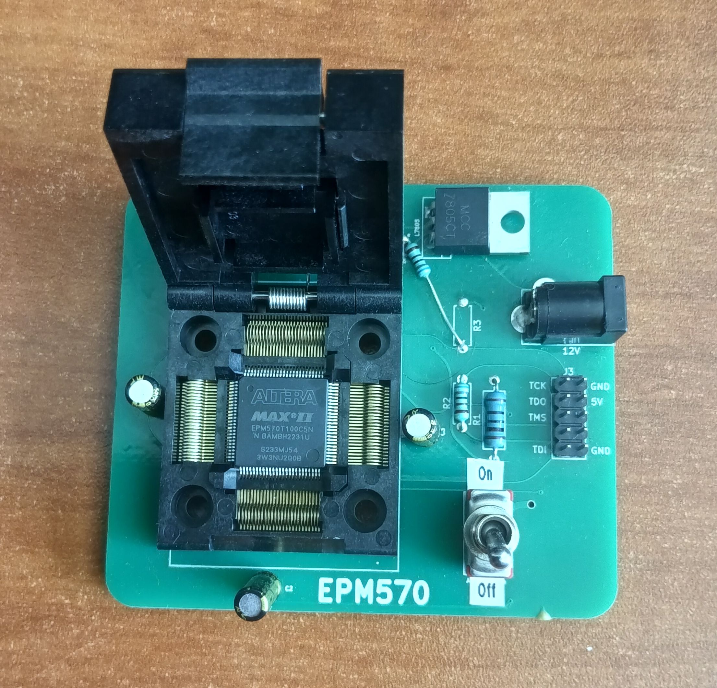
Pictures/EPM570 Programmer.jpg
