andrewpaterson/HCP65/Pictures/EPM7160S - 100pin TQFP.png

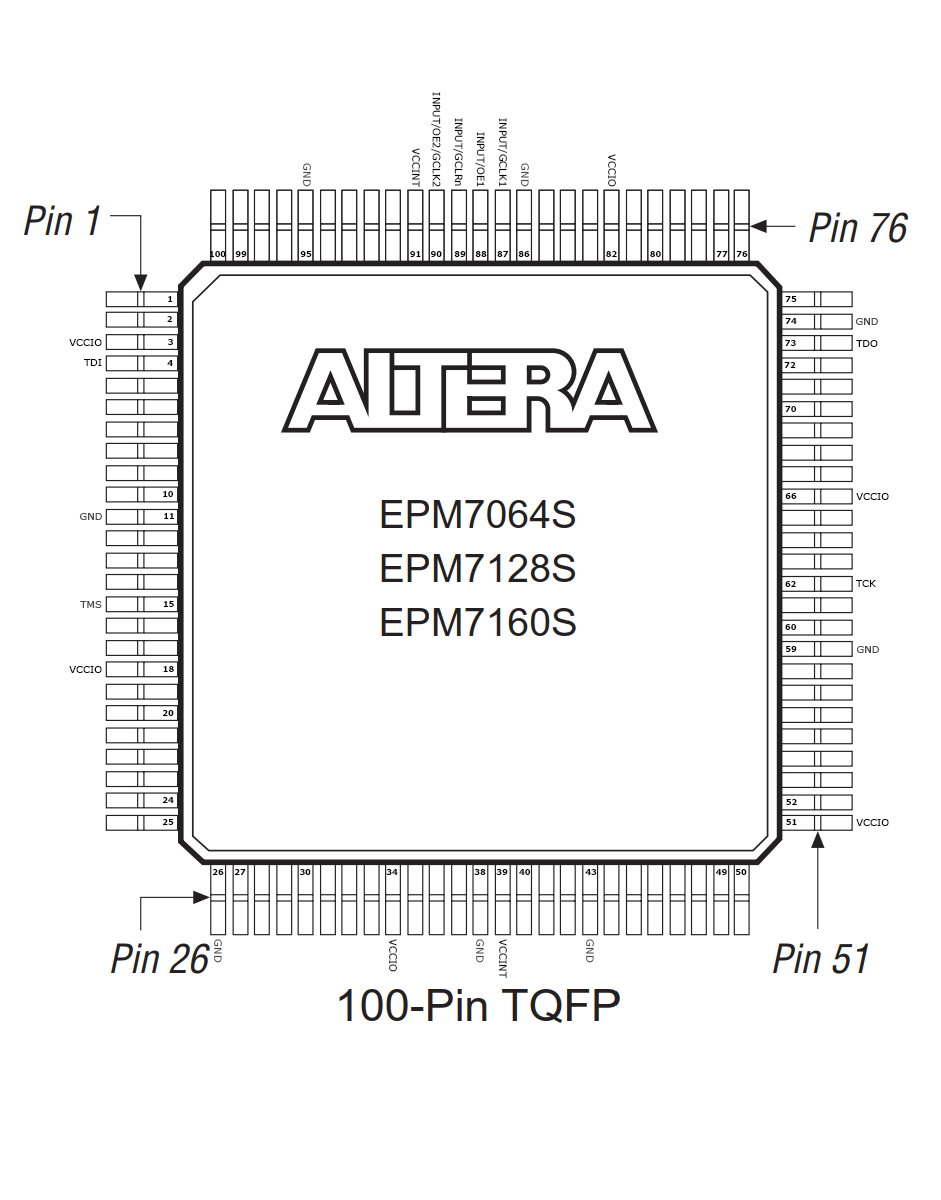
Pictures/EPM7160S - 100pin TQFP.png
