andrewpaterson/HCP65/Pictures/HCP65 MPU NMI/MPU NMI DIP render.png

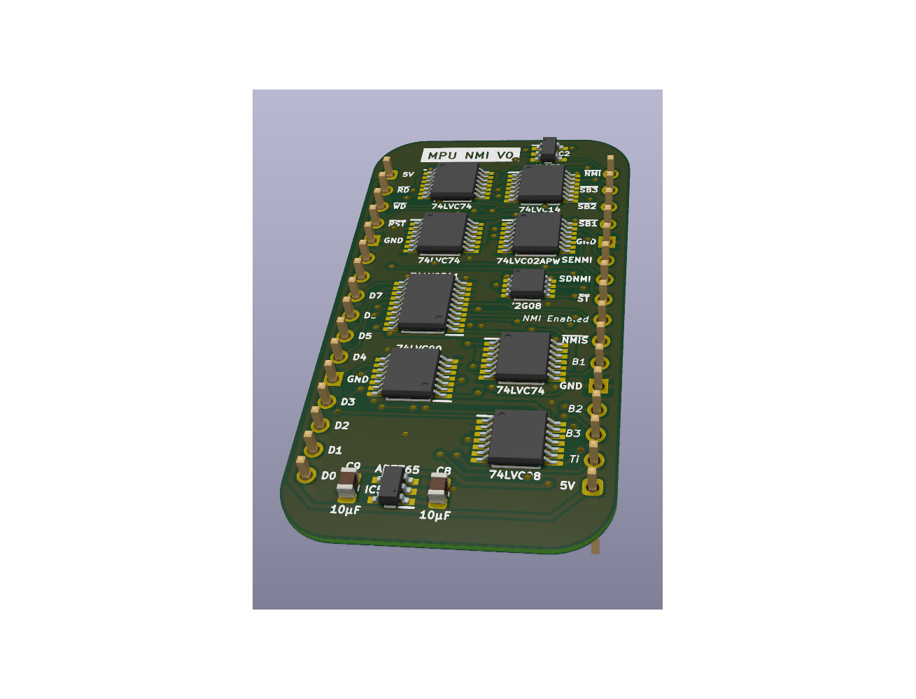
Pictures/HCP65 MPU NMI/MPU NMI DIP render.png
