andrewpaterson/HCP65/Pictures/HCP65 MPU NMI/NMI Mask.png

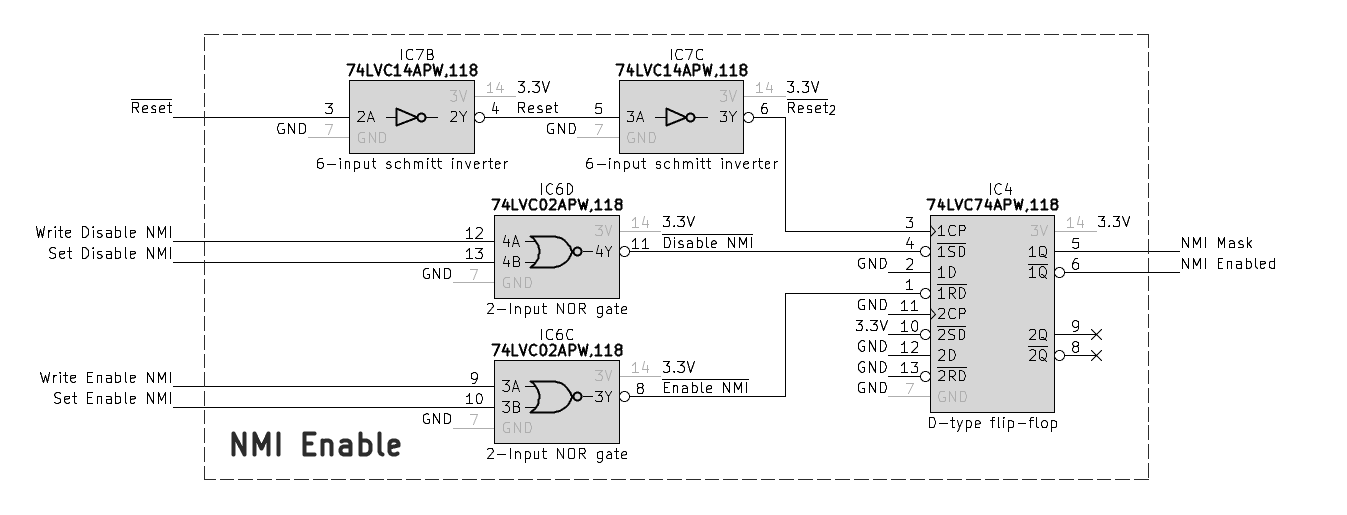
Pictures/HCP65 MPU NMI/NMI Mask.png
