andrewpaterson/HCP65/Pictures/HCP65 MPU NMI/NMI Read State and Write Clear.png

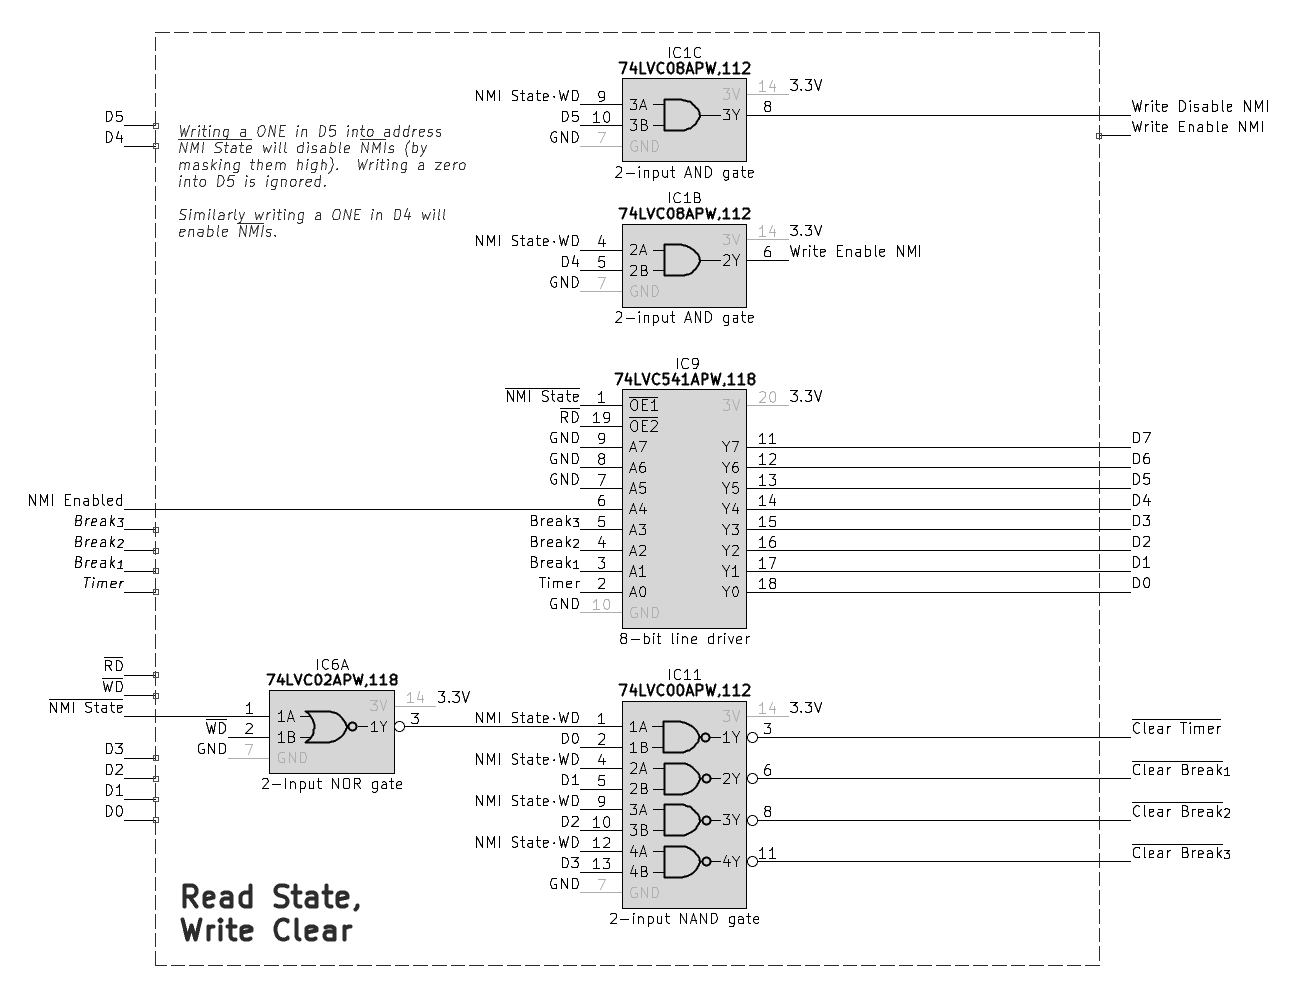
Pictures/HCP65 MPU NMI/NMI Read State and Write Clear.png
