andrewpaterson/HCP65/Pictures/HCP65 MPU NMI/NMI Signal.png

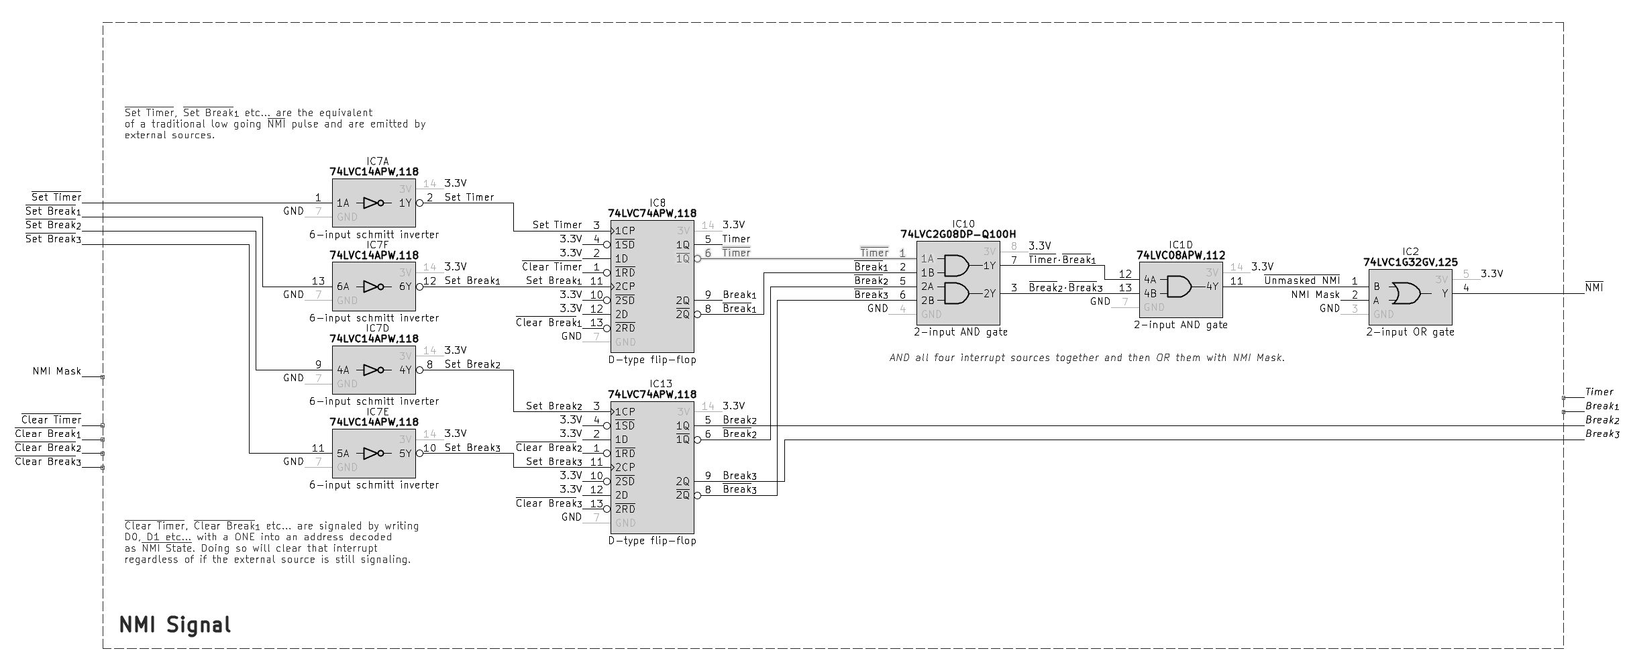
Pictures/HCP65 MPU NMI/NMI Signal.png
