andrewpaterson/HCP65/Pictures/HCP65 Processor Board.jpg

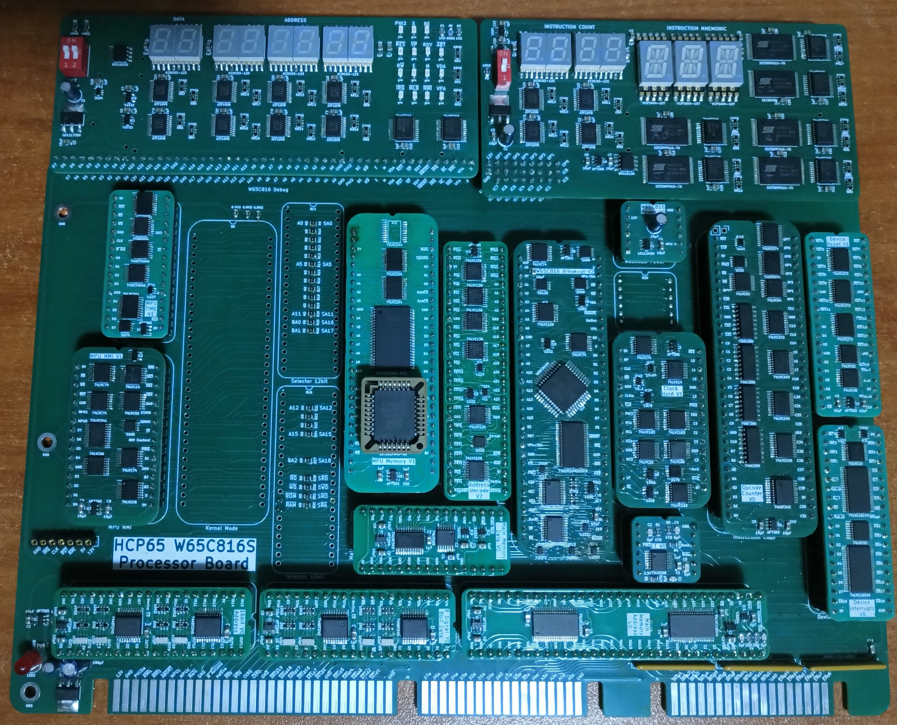
Pictures/HCP65 Processor Board.jpg
