andrewpaterson/HCP65/Pictures/HCP65.png

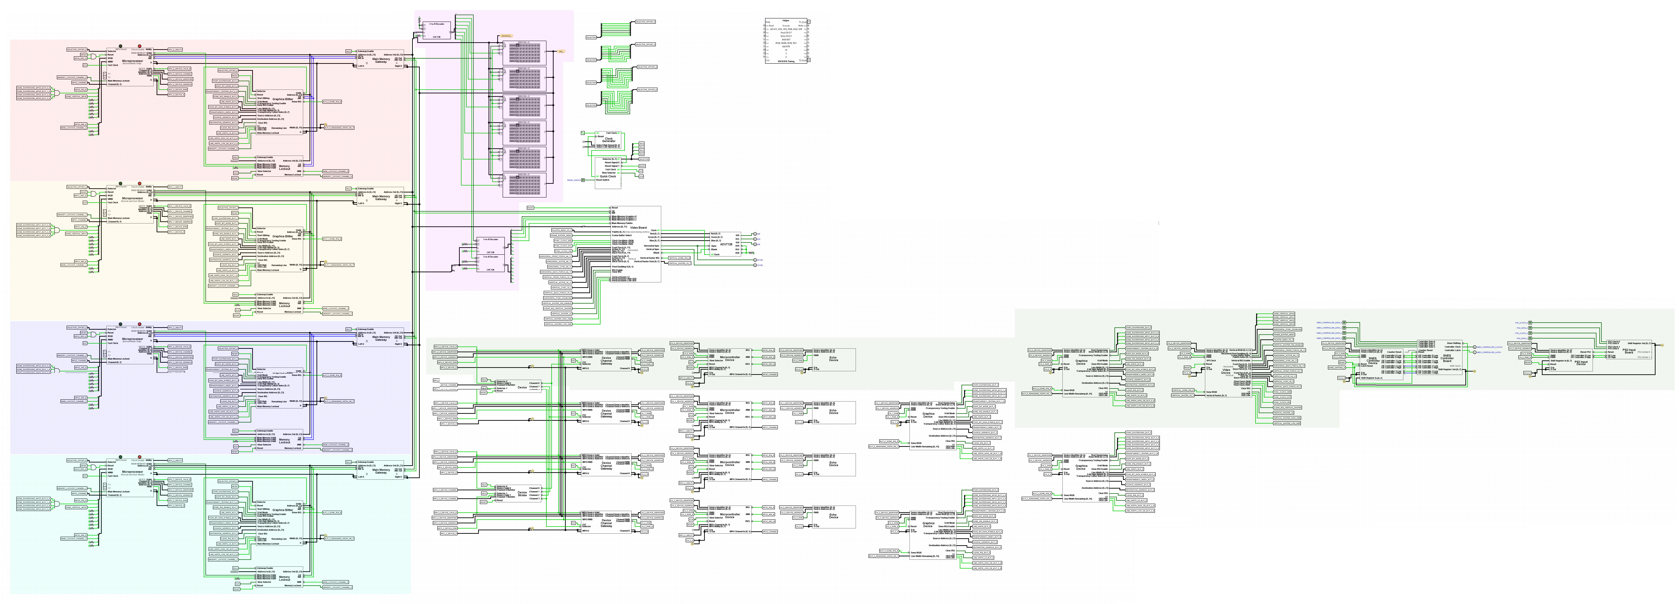
Pictures/HCP65.png
