andrewpaterson/HCP65/Pictures/LogicimPaths.png

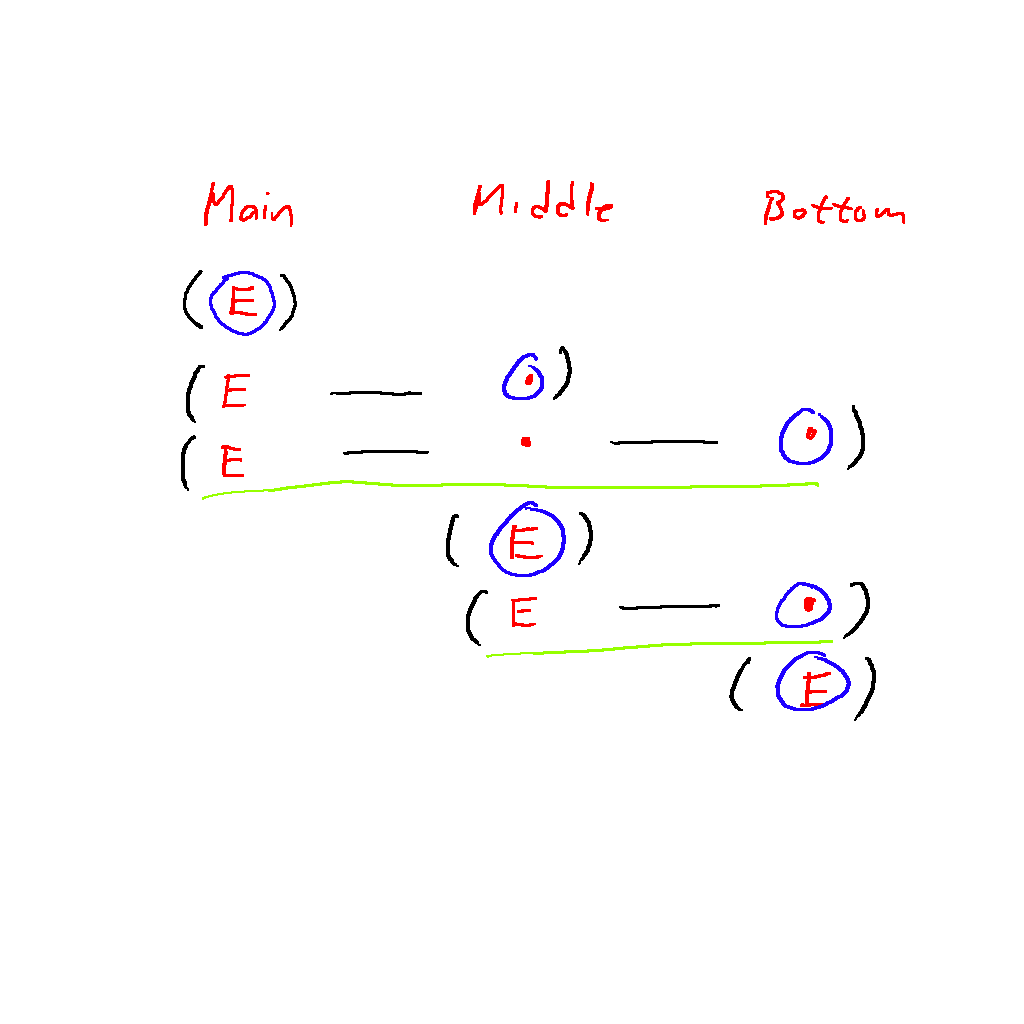
Pictures/LogicimPaths.png
