andrewpaterson/HCP65/Pictures/LSF0102 Circuit.jpg

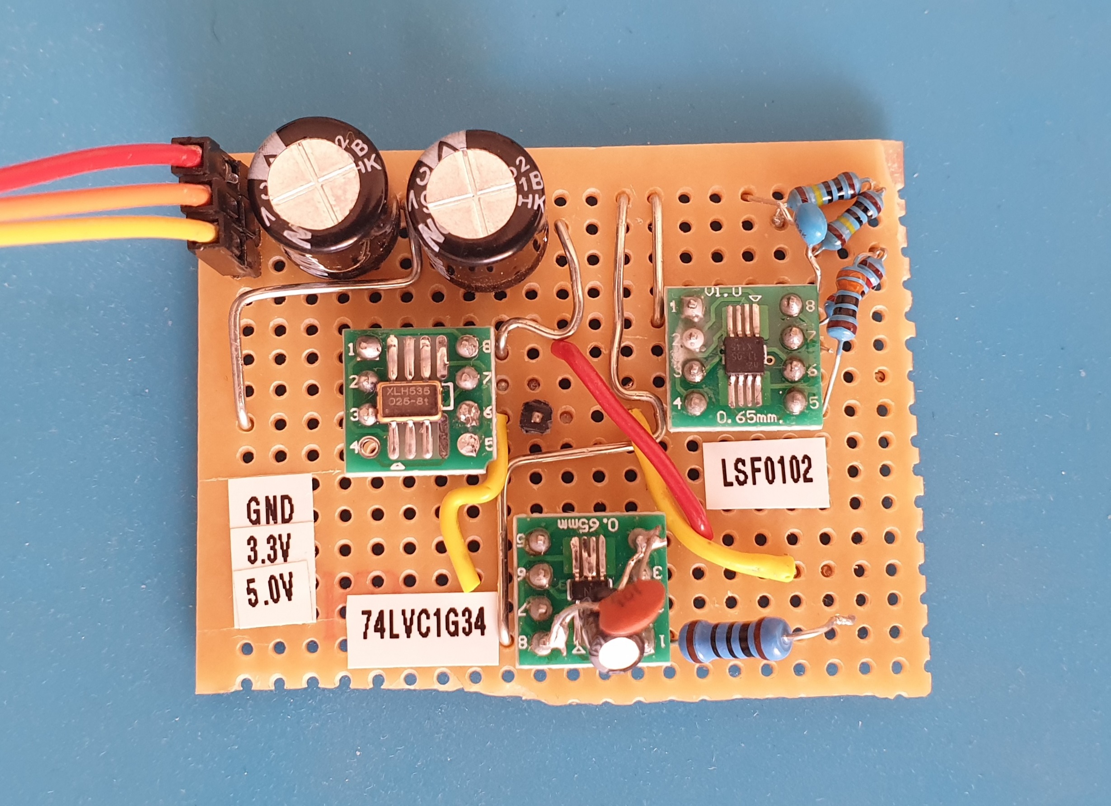
Pictures/LSF0102 Circuit.jpg
