andrewpaterson/HCP65/Pictures/LSF0102 Connected.png

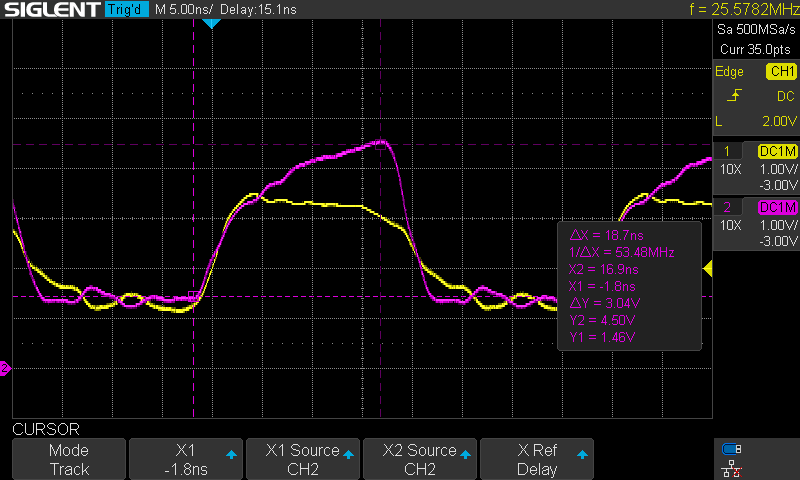
Pictures/LSF0102 Connected.png
