andrewpaterson/HCP65/Pictures/LSF0102 Disconnected.png

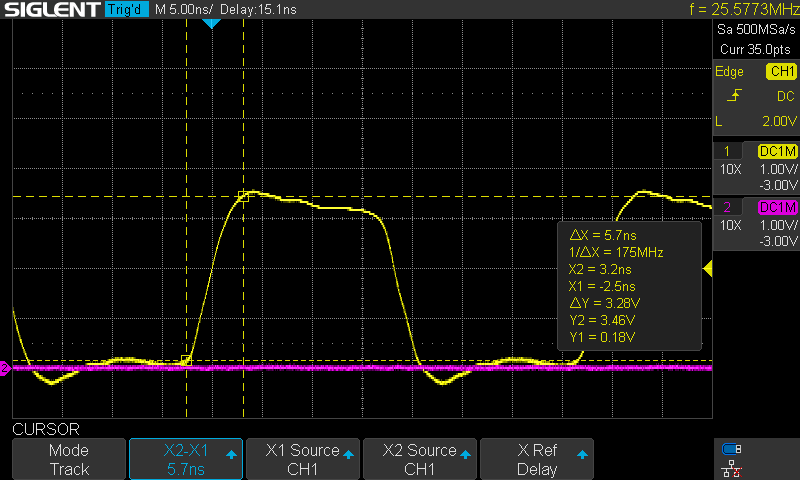
Pictures/LSF0102 Disconnected.png
