andrewpaterson/HCP65/Pictures/LSF0102.png

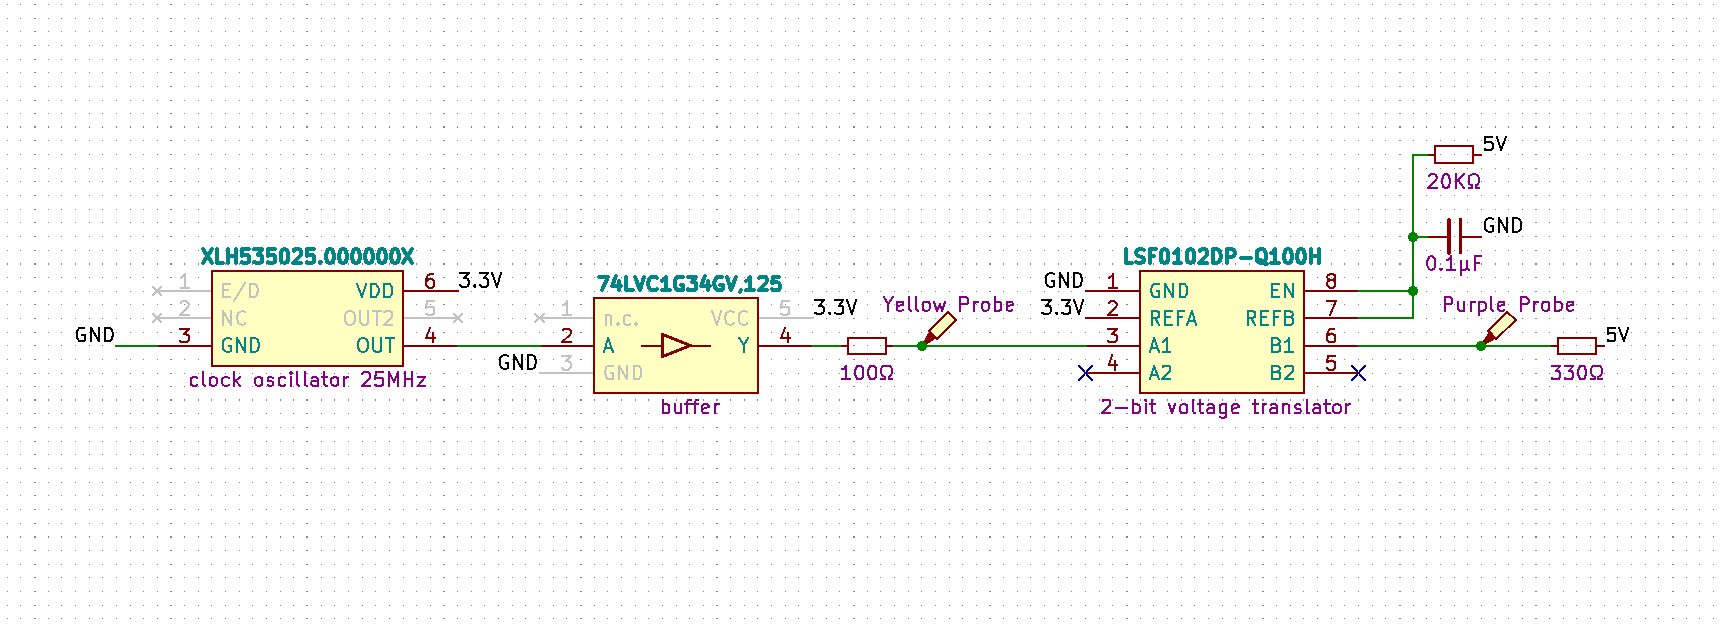
Pictures/LSF0102.png
