andrewpaterson/HCP65/Pictures/LSF0204.jpg

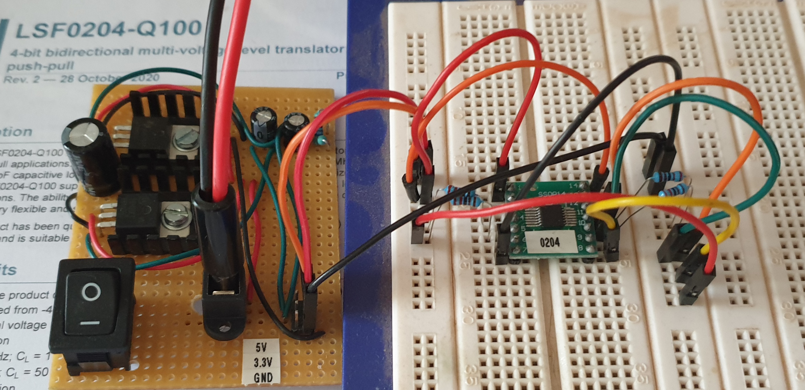
Pictures/LSF0204.jpg
