andrewpaterson/HCP65/Pictures/LSF0204.png

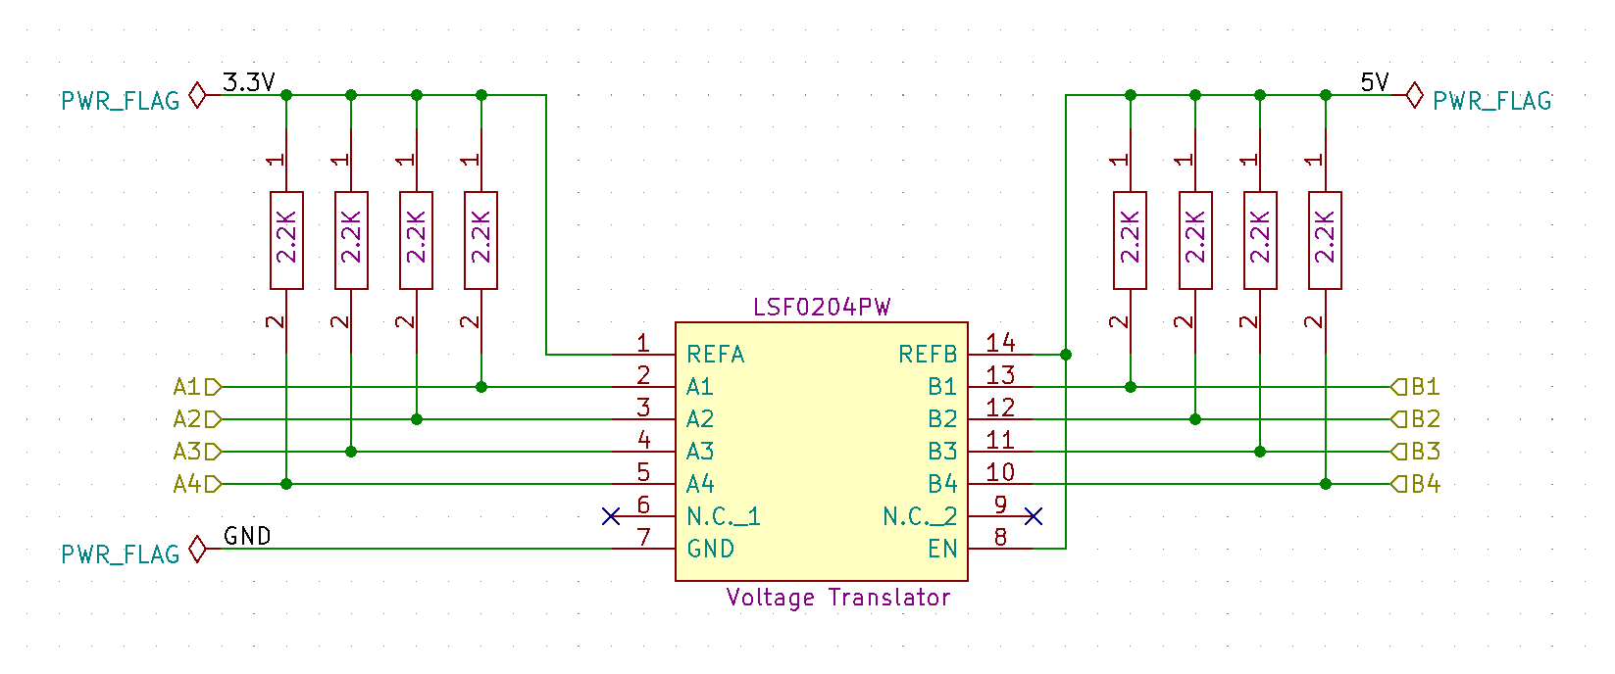
Pictures/LSF0204.png
