andrewpaterson/HCP65/Pictures/Mainboard Full.png

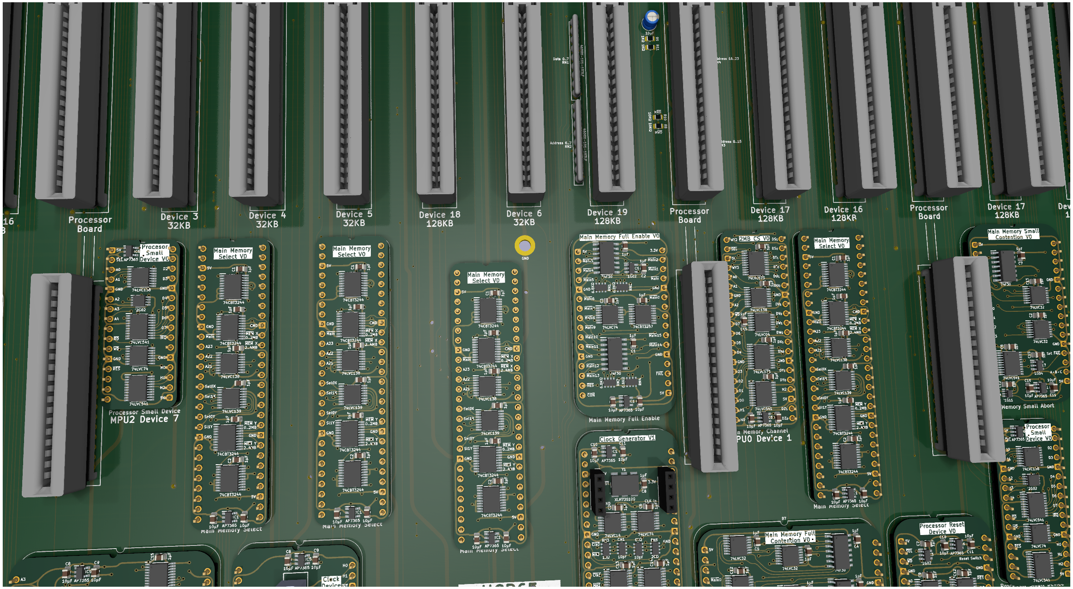
Pictures/Mainboard Full.png
