andrewpaterson/HCP65/Pictures/Mainboard Small - Populated.png

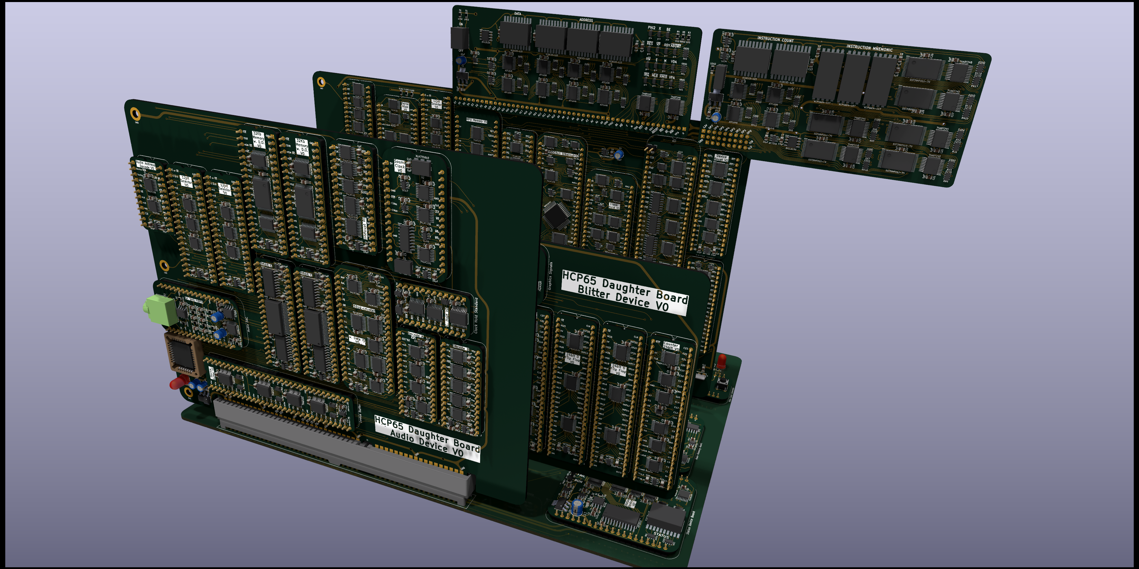
Pictures/Mainboard Small - Populated.png
