andrewpaterson/HCP65/Pictures/Mainboard Small.png

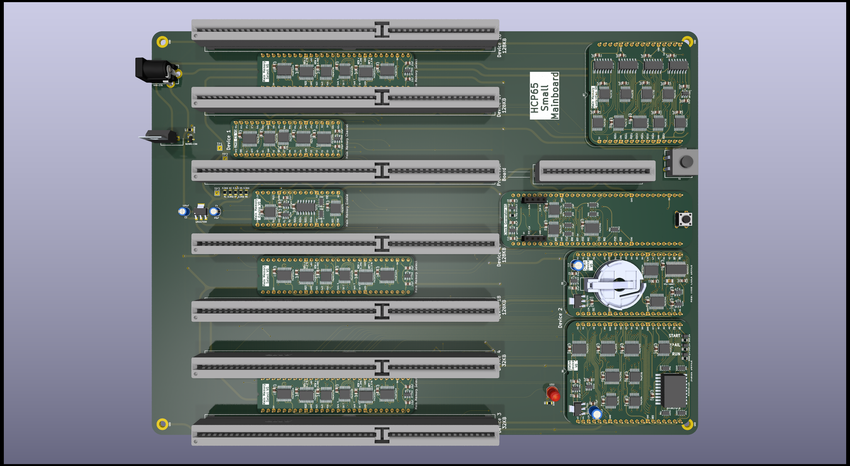
Pictures/Mainboard Small.png
