andrewpaterson/HCP65/Pictures/Memory Map (Andre)y.png

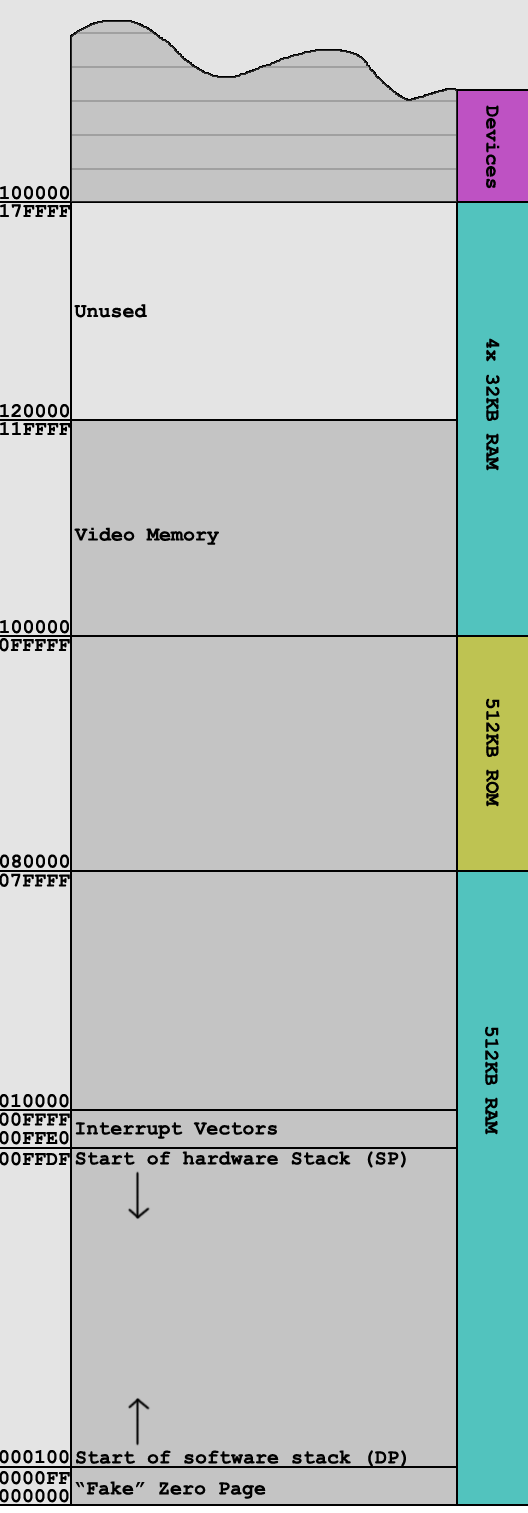
Pictures/Memory Map (Andre)y.png
