andrewpaterson/HCP65/Pictures/Memory Map.png

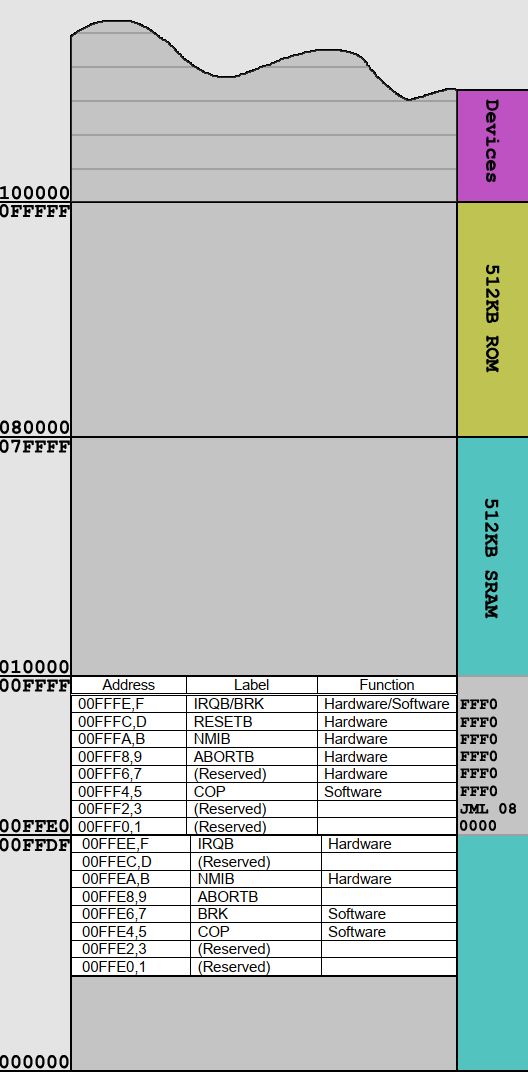
Pictures/Memory Map.png
