andrewpaterson/HCP65/Pictures/MPU Kernal Only.png

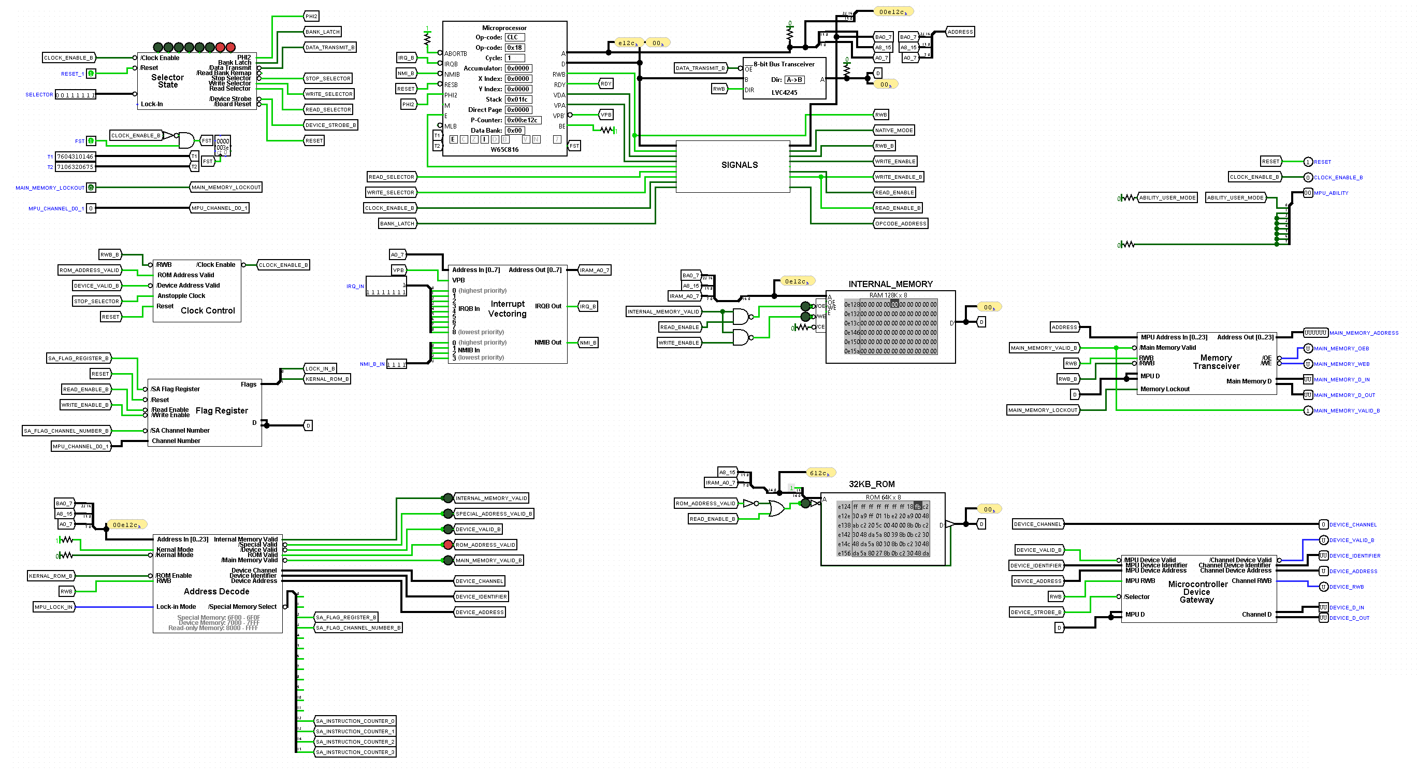
Pictures/MPU Kernal Only.png
