andrewpaterson/HCP65/Pictures/PHI2 Timing.png

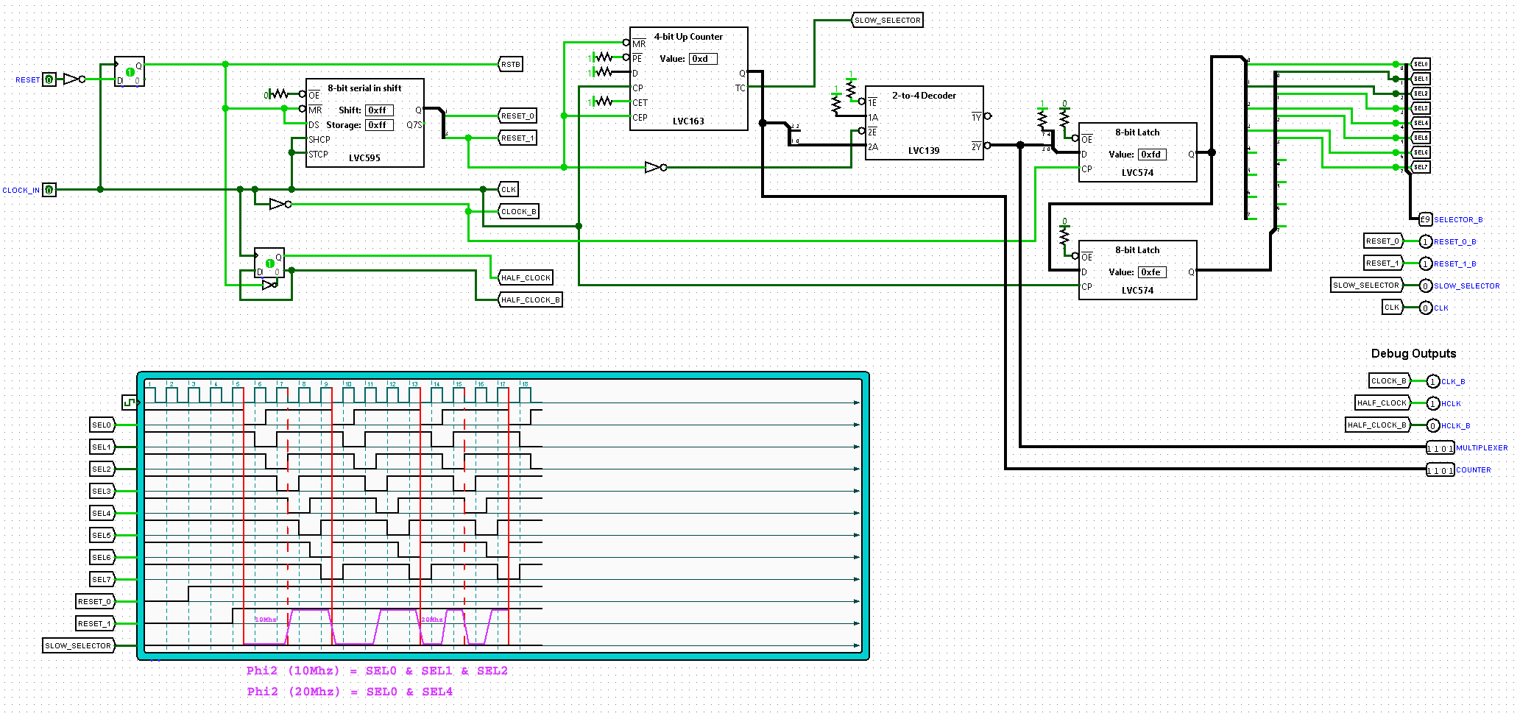
Pictures/PHI2 Timing.png
