andrewpaterson/HCP65/Pictures/Pico to Pi Connection.png

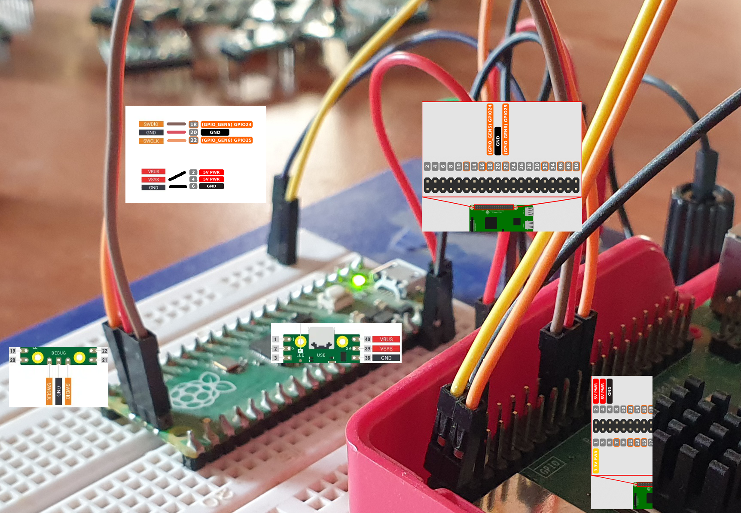
Pictures/Pico to Pi Connection.png
