andrewpaterson/HCP65/Pictures/Processor Board V2-2.png

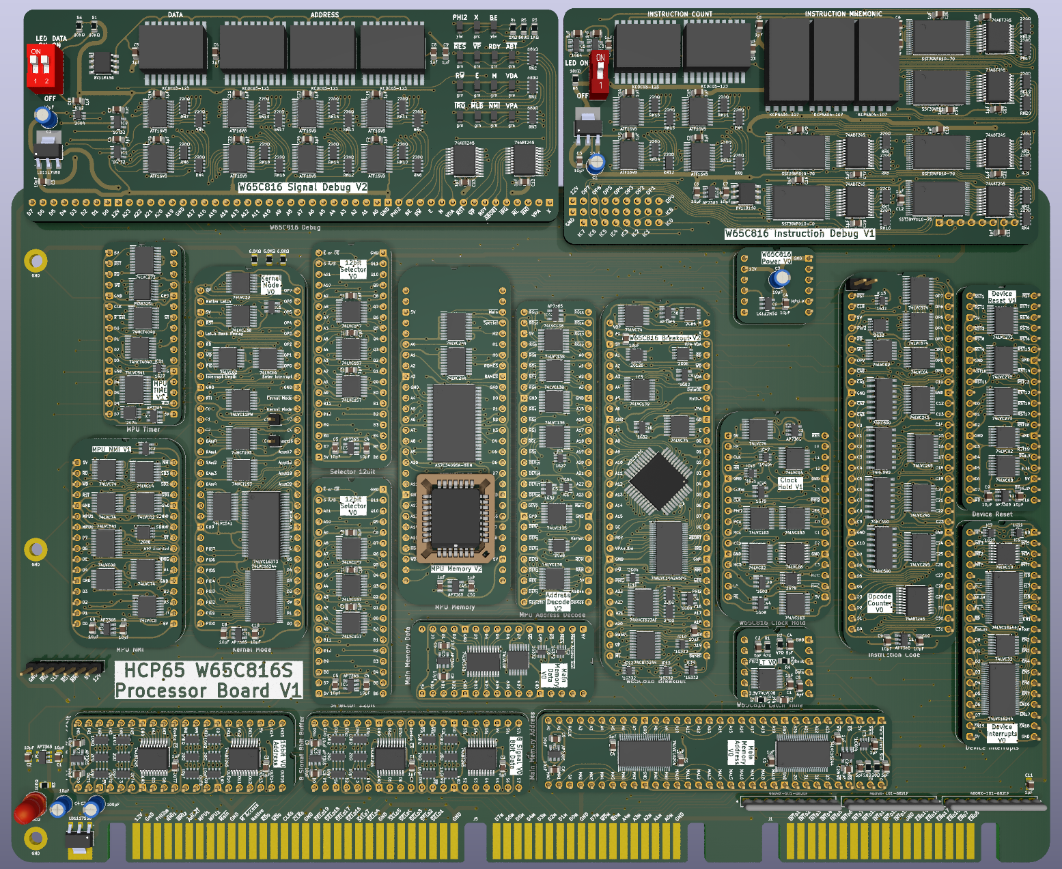
Pictures/Processor Board V2-2.png
