andrewpaterson/HCP65/Pictures/Putty/Github-New-ssh-key.png

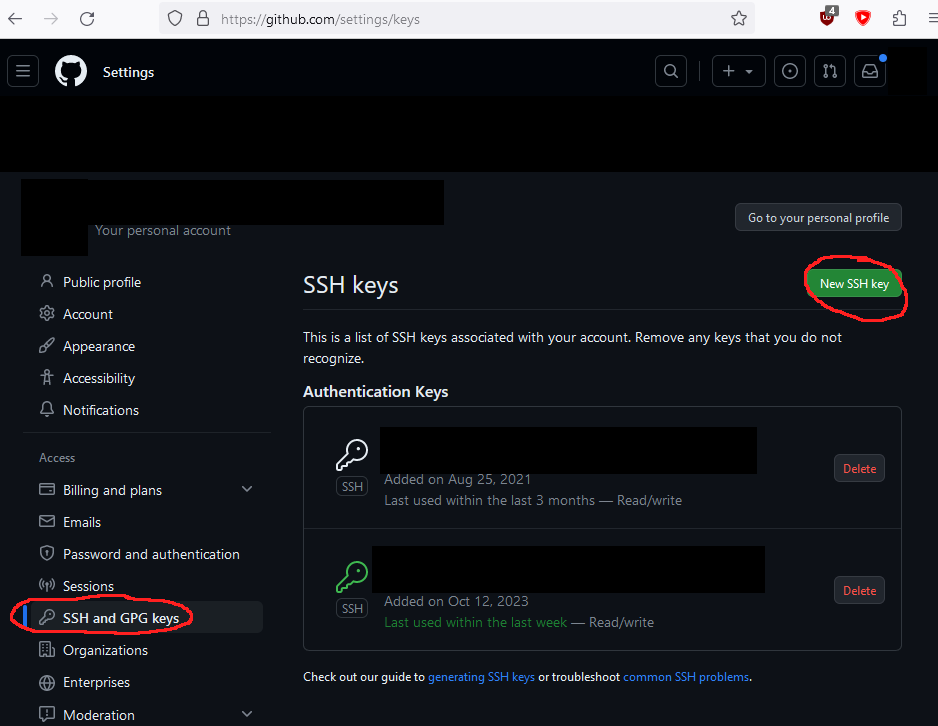
Pictures/Putty/Github-New-ssh-key.png
