andrewpaterson/HCP65/Pictures/Putty/Github-Paste-key.png

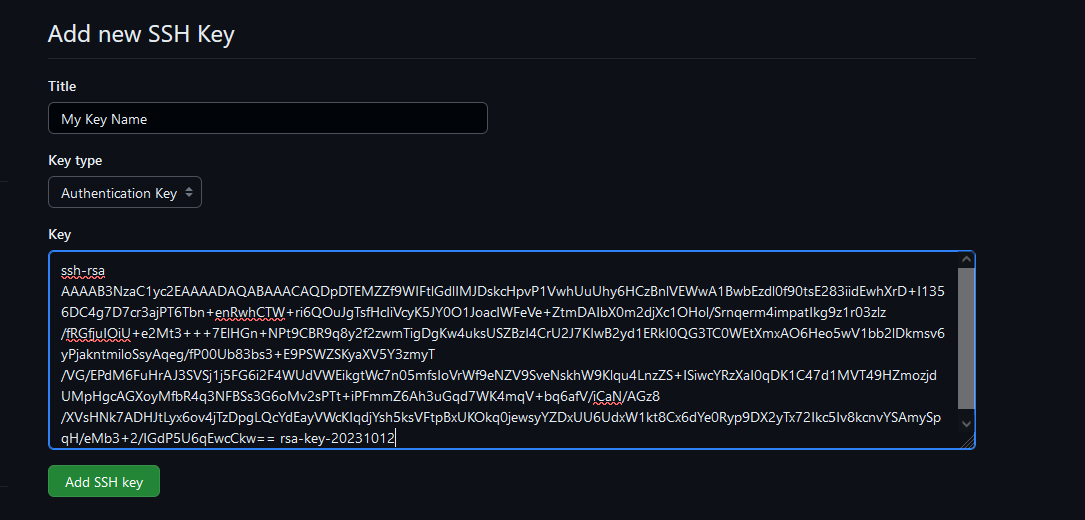
Pictures/Putty/Github-Paste-key.png
