andrewpaterson/HCP65/Pictures/Putty/Pageant-Add-key.png

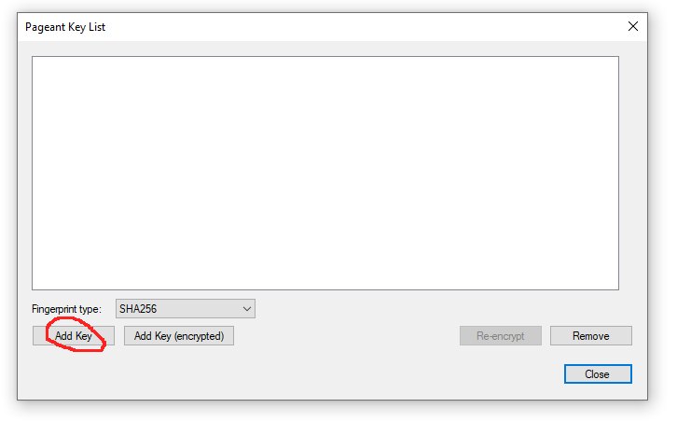
Pictures/Putty/Pageant-Add-key.png
