andrewpaterson/HCP65/Pictures/Putty/Pageant-done.png

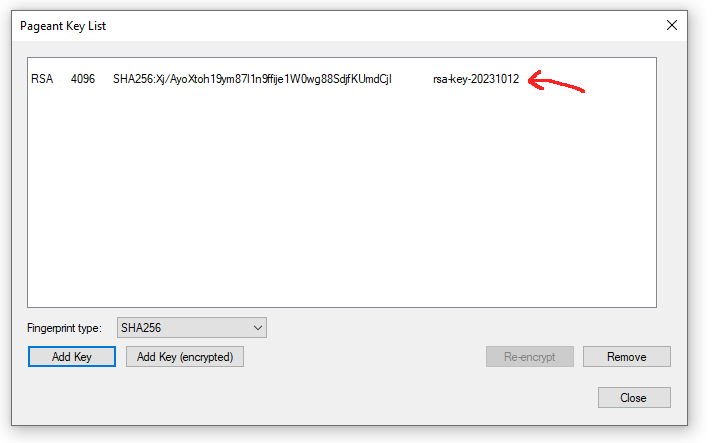
Pictures/Putty/Pageant-done.png
