andrewpaterson/HCP65/Pictures/Putty/Pageant-Taskbar.png

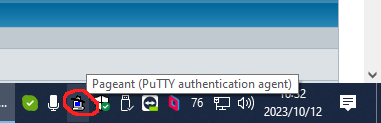
Pictures/Putty/Pageant-Taskbar.png
