andrewpaterson/HCP65/Pictures/Putty/PuttyGen-Copy-public-key.png

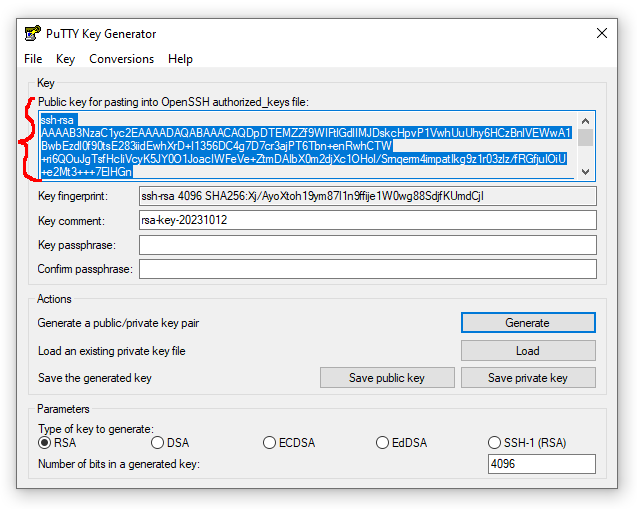
Pictures/Putty/PuttyGen-Copy-public-key.png
