andrewpaterson/HCP65/Pictures/Putty/PuttyGen-Export-private-key.png

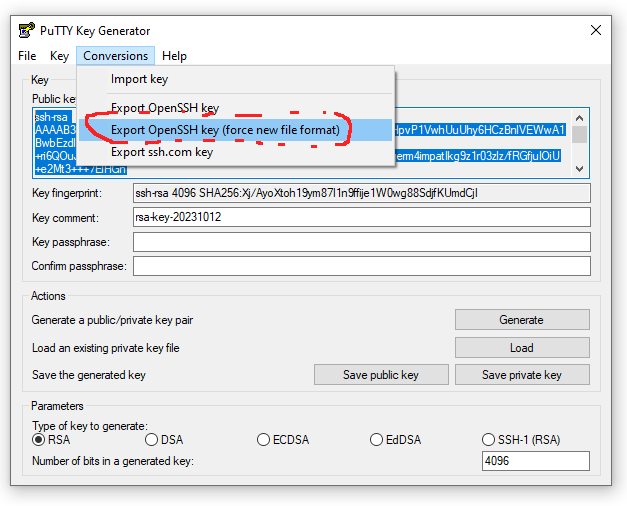
Pictures/Putty/PuttyGen-Export-private-key.png
