andrewpaterson/HCP65/Pictures/Putty/PuttyGen-Generate.png

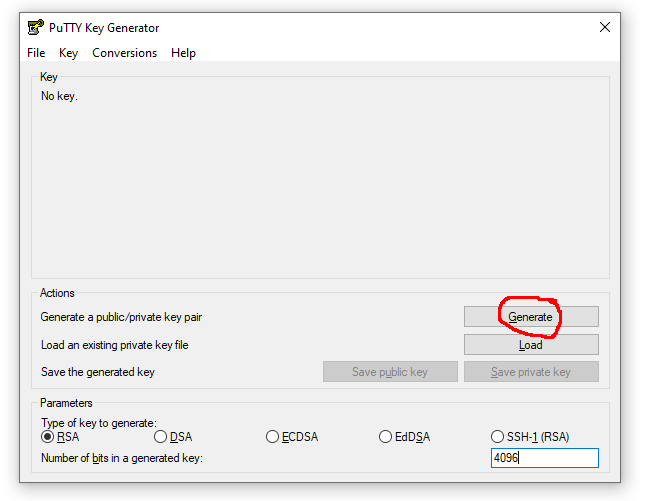
Pictures/Putty/PuttyGen-Generate.png
