andrewpaterson/HCP65/Pictures/Read Data Hold Time.png

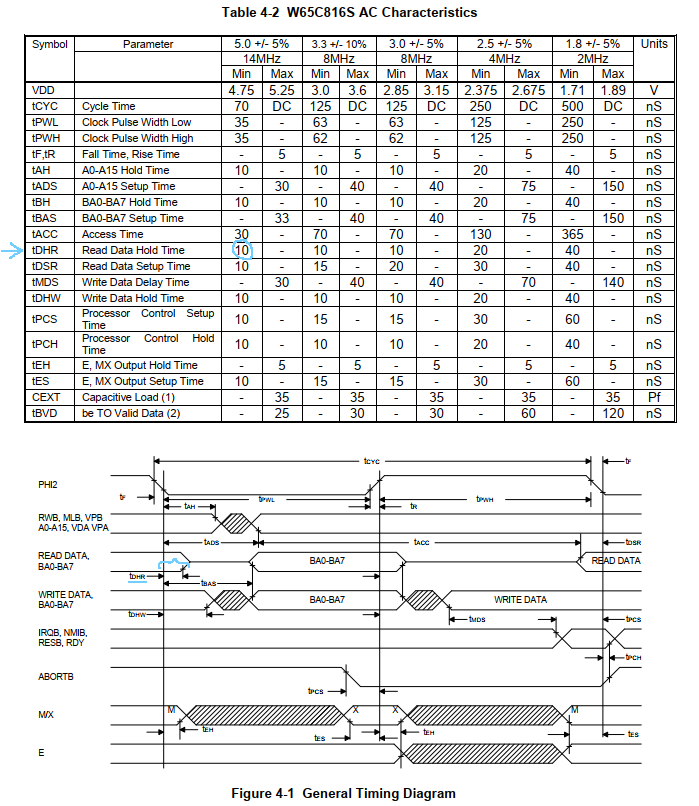
Pictures/Read Data Hold Time.png
