andrewpaterson/HCP65/Pictures/Read Write 139.png

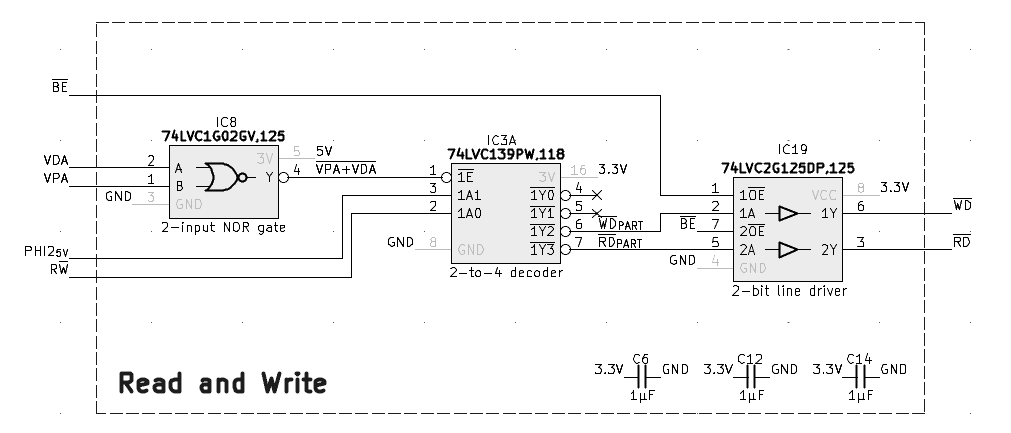
Pictures/Read Write 139.png
