andrewpaterson/HCP65/Pictures/Reset Long Vector.png

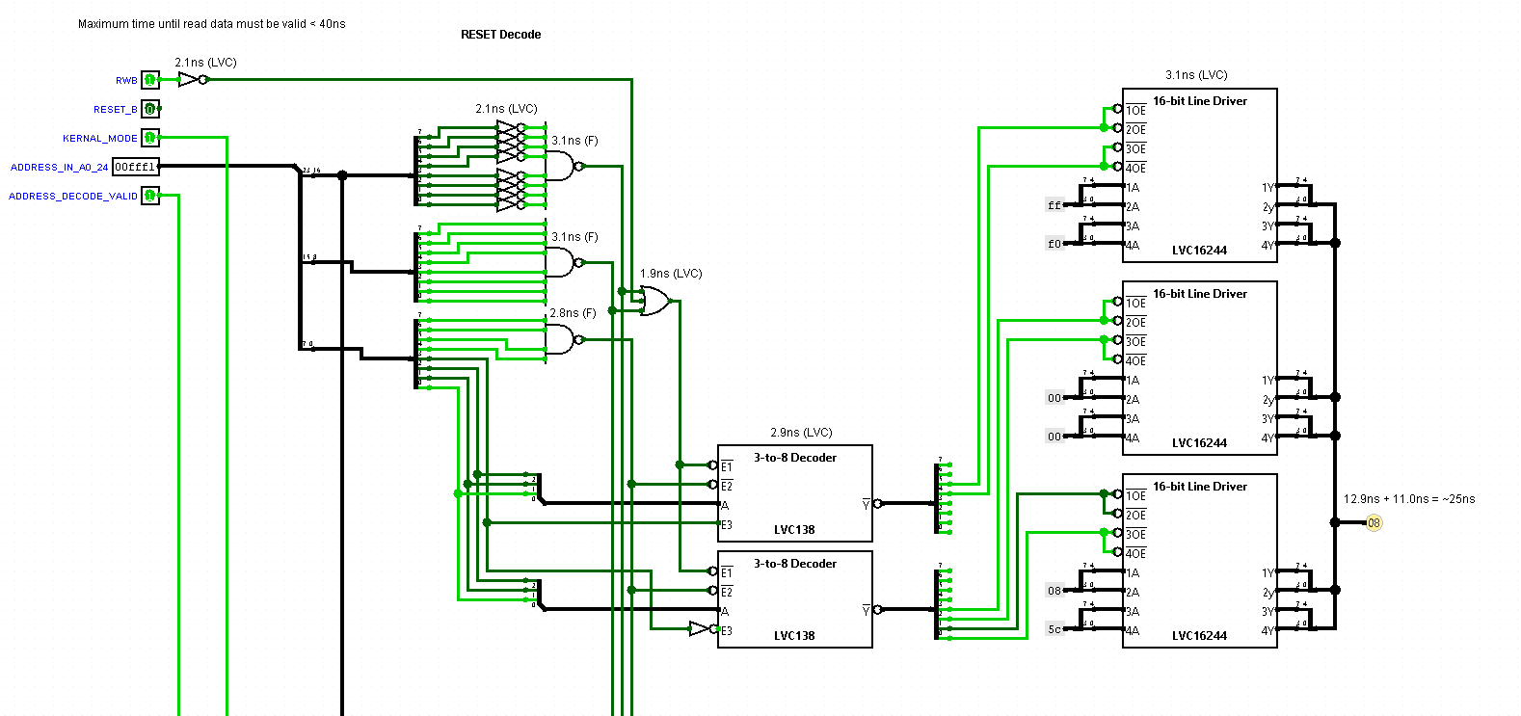
Pictures/Reset Long Vector.png
