andrewpaterson/HCP65/Pictures/Reset/65C816 Reset.png

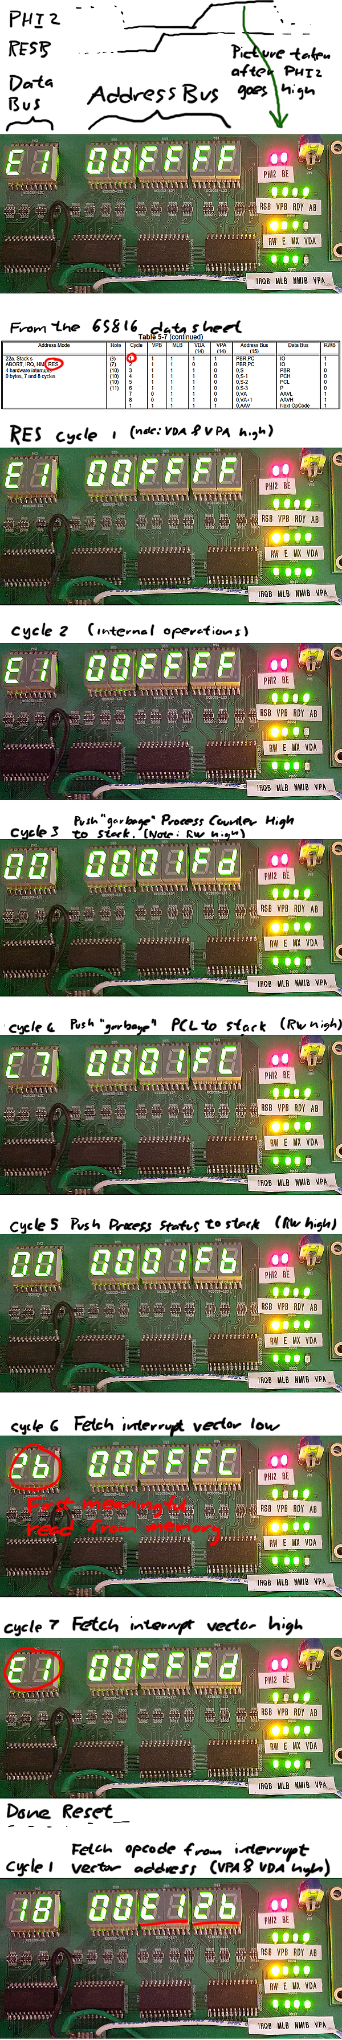
Pictures/Reset/65C816 Reset.png
