andrewpaterson/HCP65/Pictures/Reset/20230302_093954.jpg

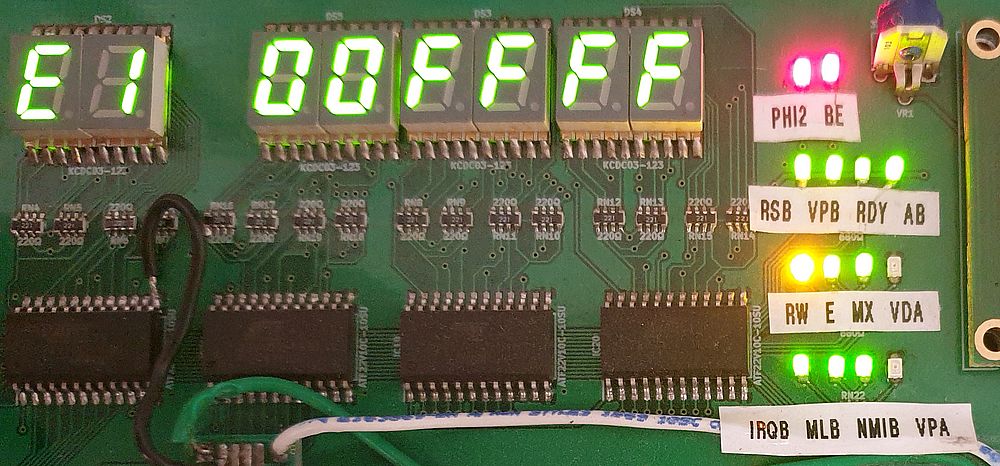
Pictures/Reset/20230302_093954.jpg
