andrewpaterson/HCP65/Pictures/Reset/20230302_094029.jpg

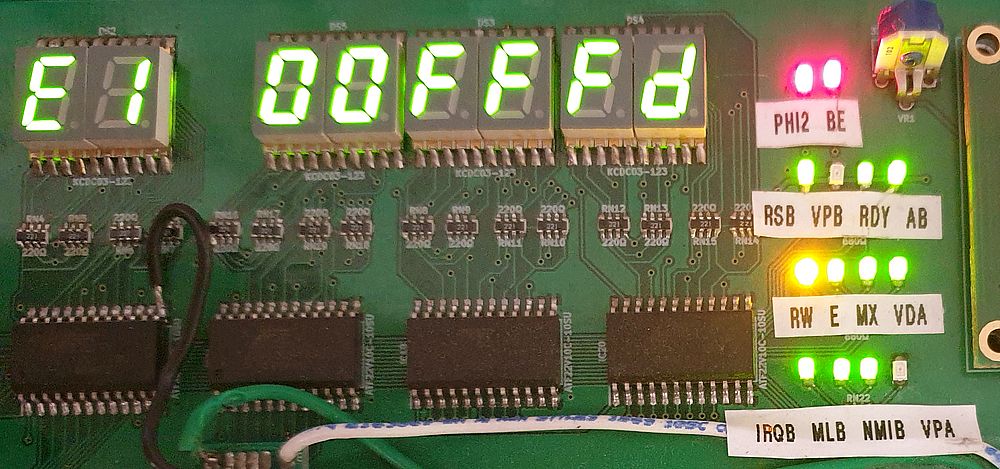
Pictures/Reset/20230302_094029.jpg
