andrewpaterson/HCP65/Pictures/Reset/20230302_094040.jpg

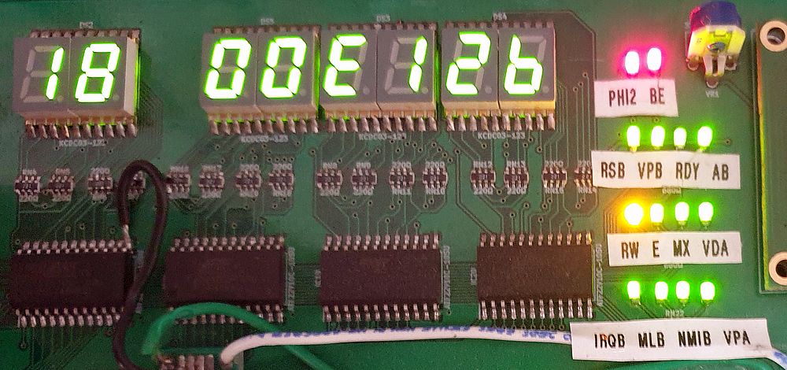
Pictures/Reset/20230302_094040.jpg
