andrewpaterson/HCP65/Pictures/SD Card Board - back.png

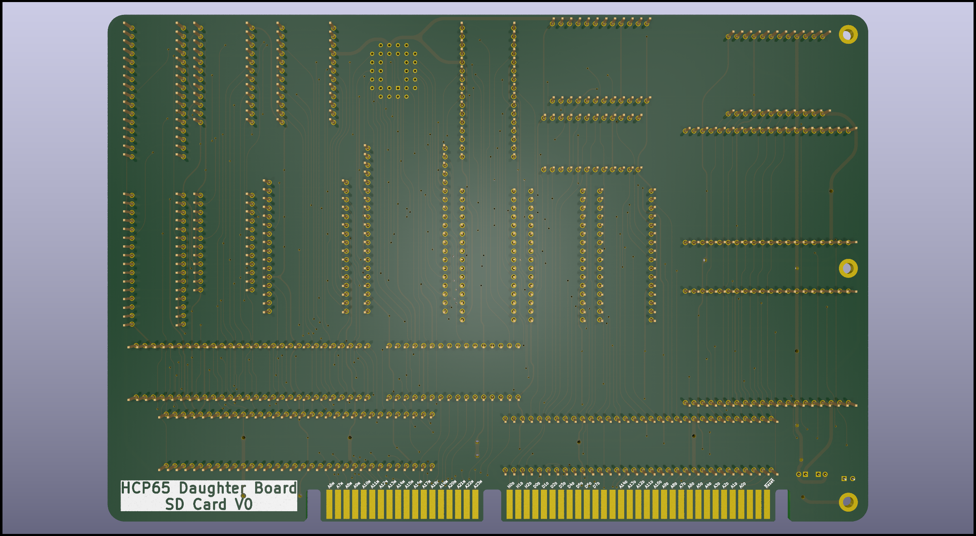
Pictures/SD Card Board - back.png
