andrewpaterson/HCP65/Pictures/SD Card Board - no mess.png

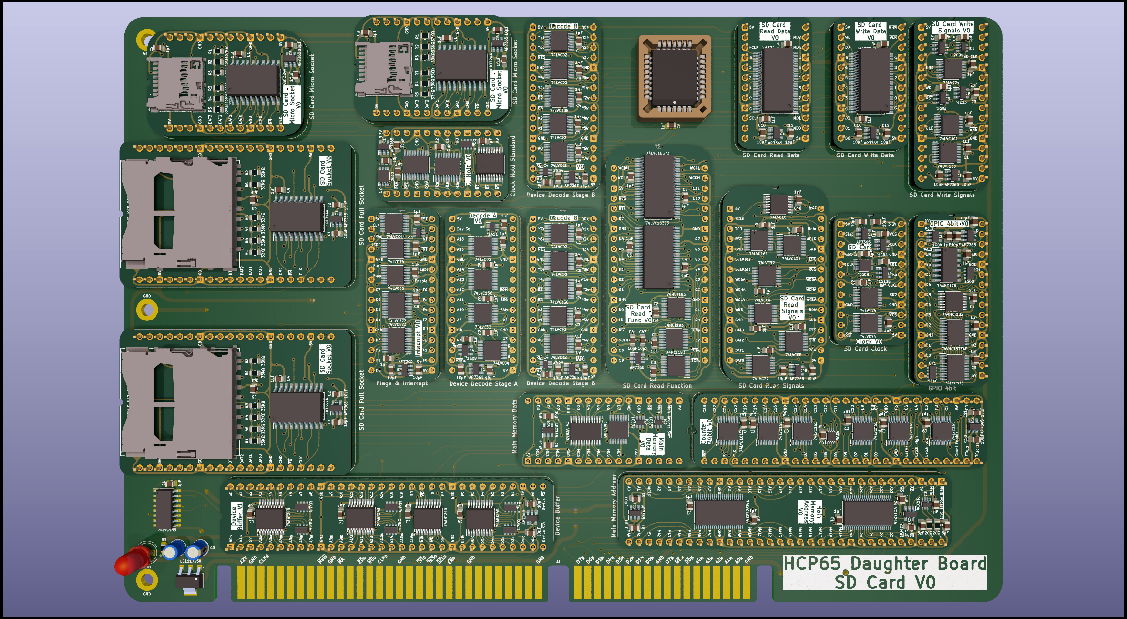
Pictures/SD Card Board - no mess.png
