andrewpaterson/HCP65/Pictures/SD Card/SD Card Bus Timing.png

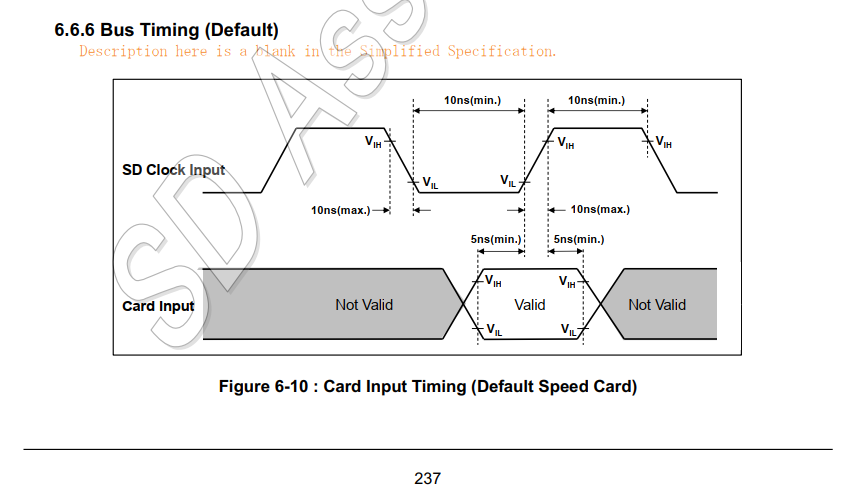
Pictures/SD Card/SD Card Bus Timing.png
