andrewpaterson/HCP65/Pictures/SD Card/SD Card Cmd0 Detail.png

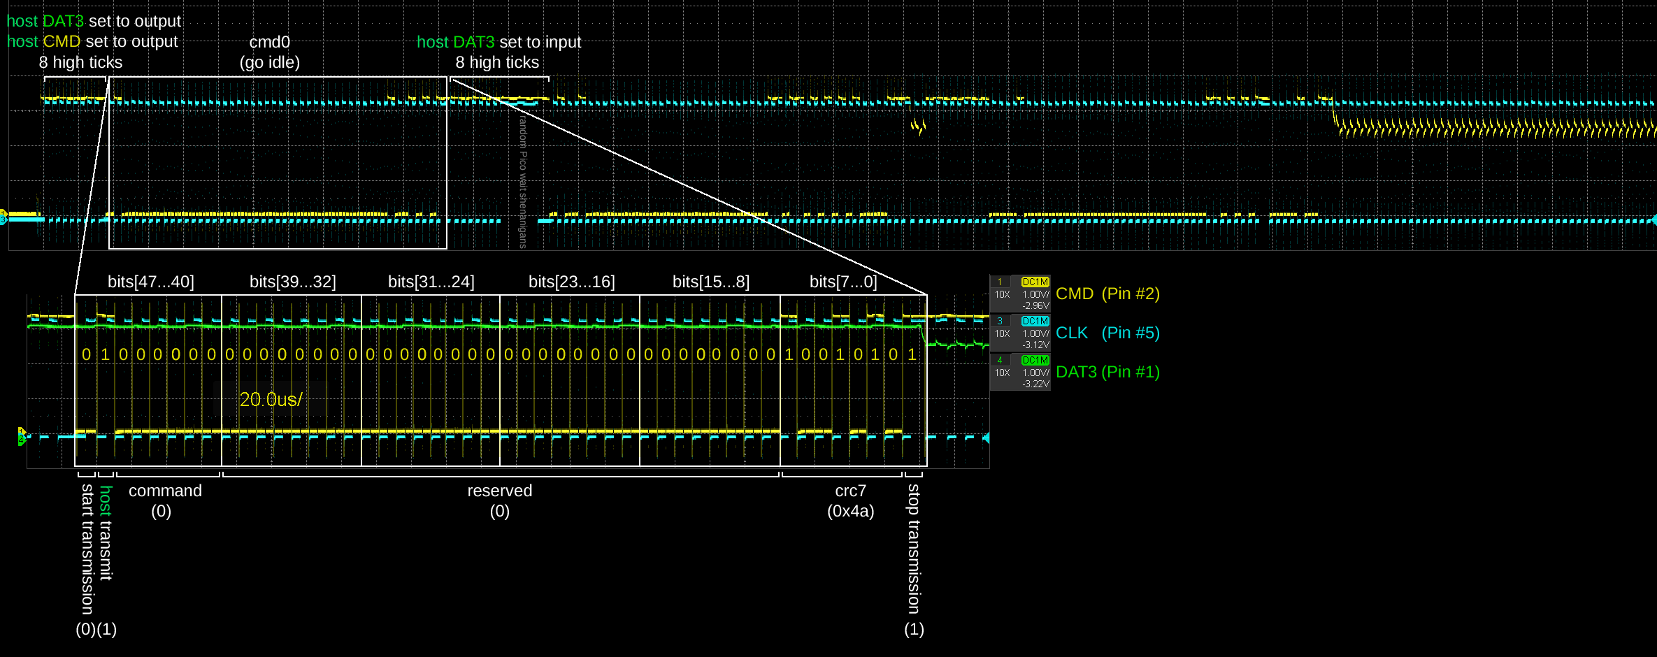
Pictures/SD Card/SD Card Cmd0 Detail.png
