andrewpaterson/HCP65/Pictures/SD Card/SD Card Cmd8 Detail.png

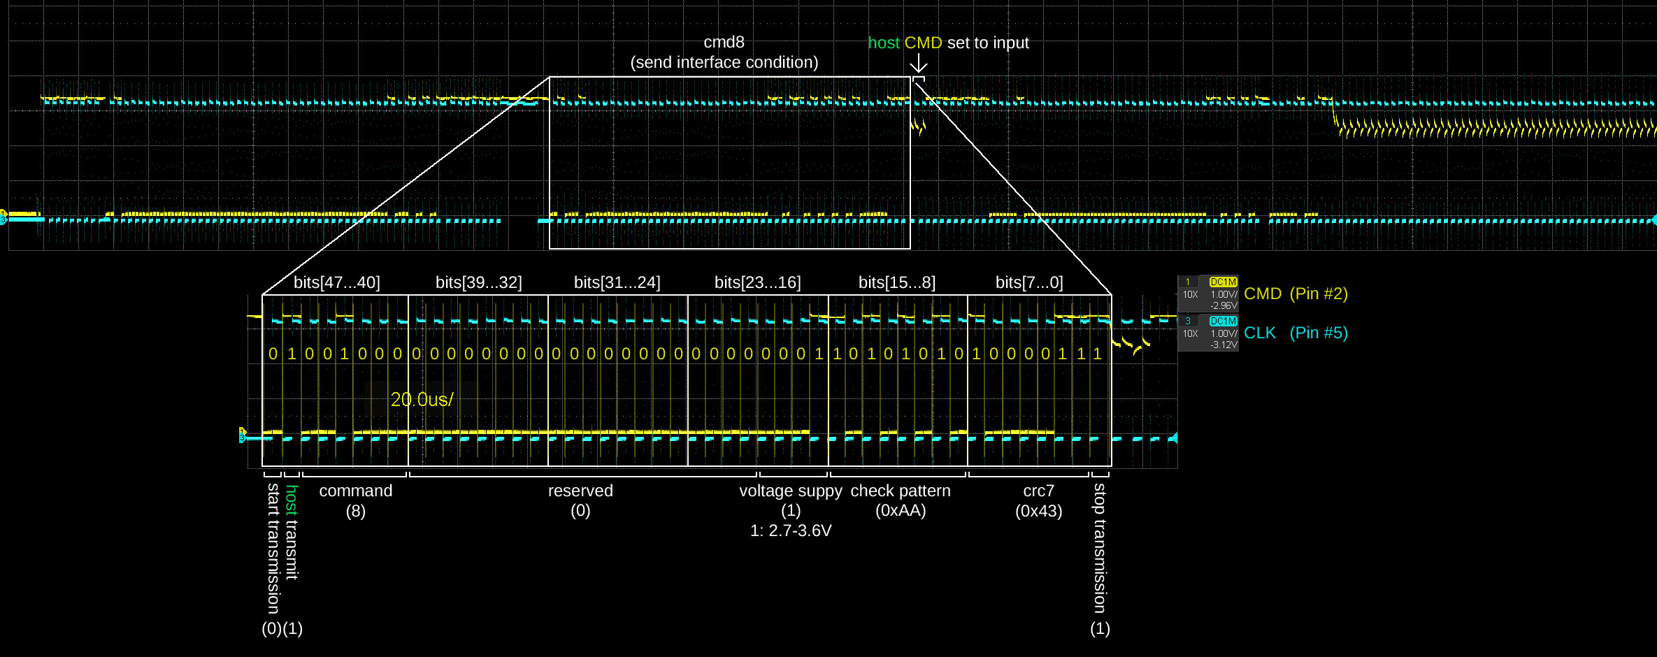
Pictures/SD Card/SD Card Cmd8 Detail.png
