andrewpaterson/HCP65/Pictures/SD Card/SD Card Cmd8 Response Detail.png

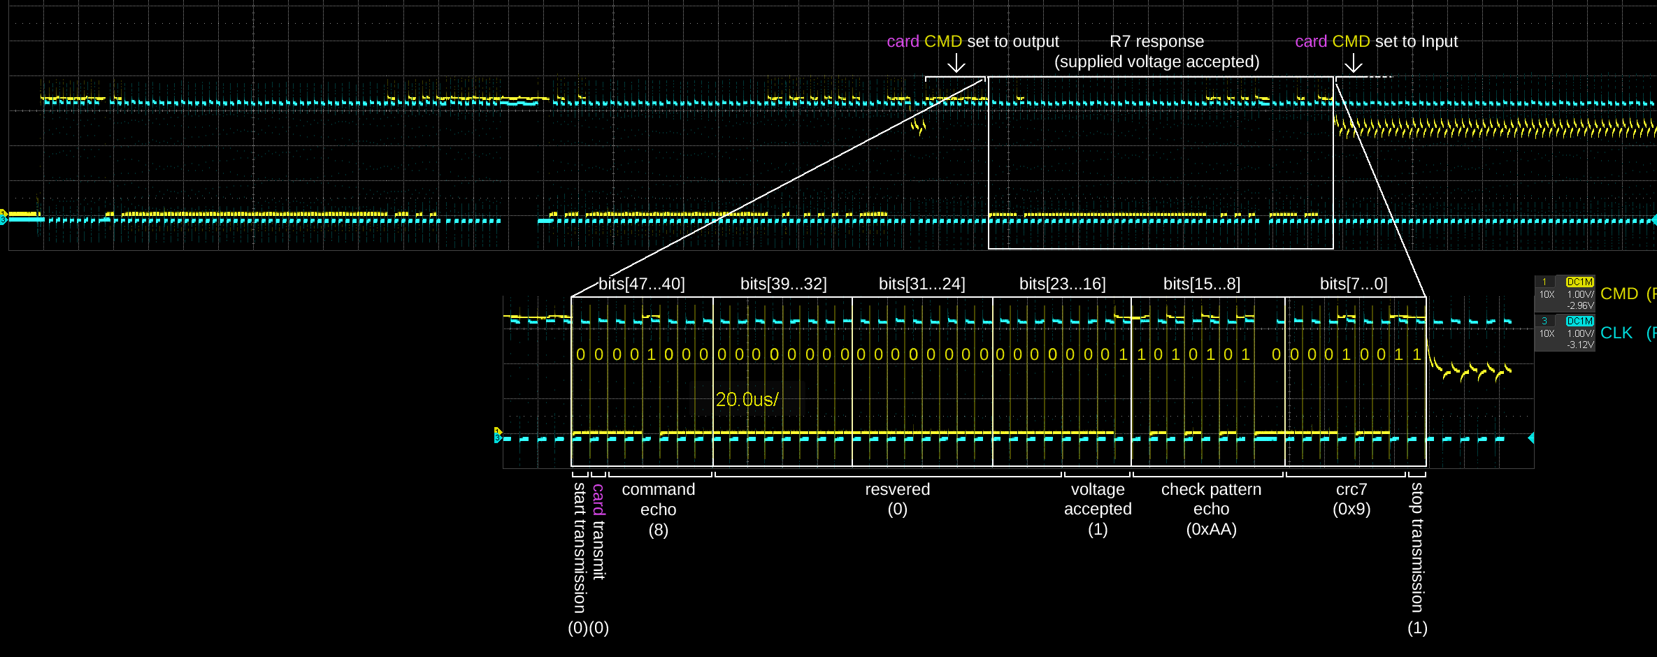
Pictures/SD Card/SD Card Cmd8 Response Detail.png
