andrewpaterson/HCP65/Pictures/SD Card/SD Card Command Format.png

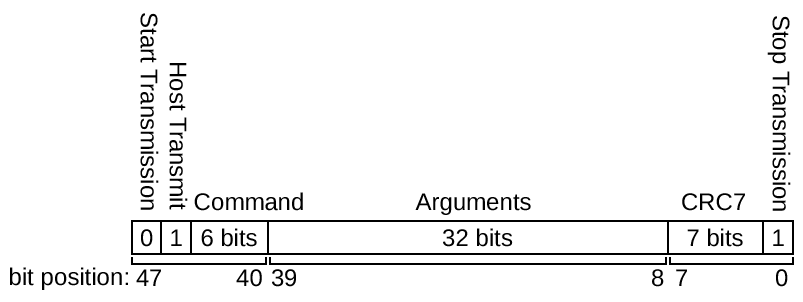
Pictures/SD Card/SD Card Command Format.png
