andrewpaterson/HCP65/Pictures/SD Card/SD Card Initialistion Flow.png

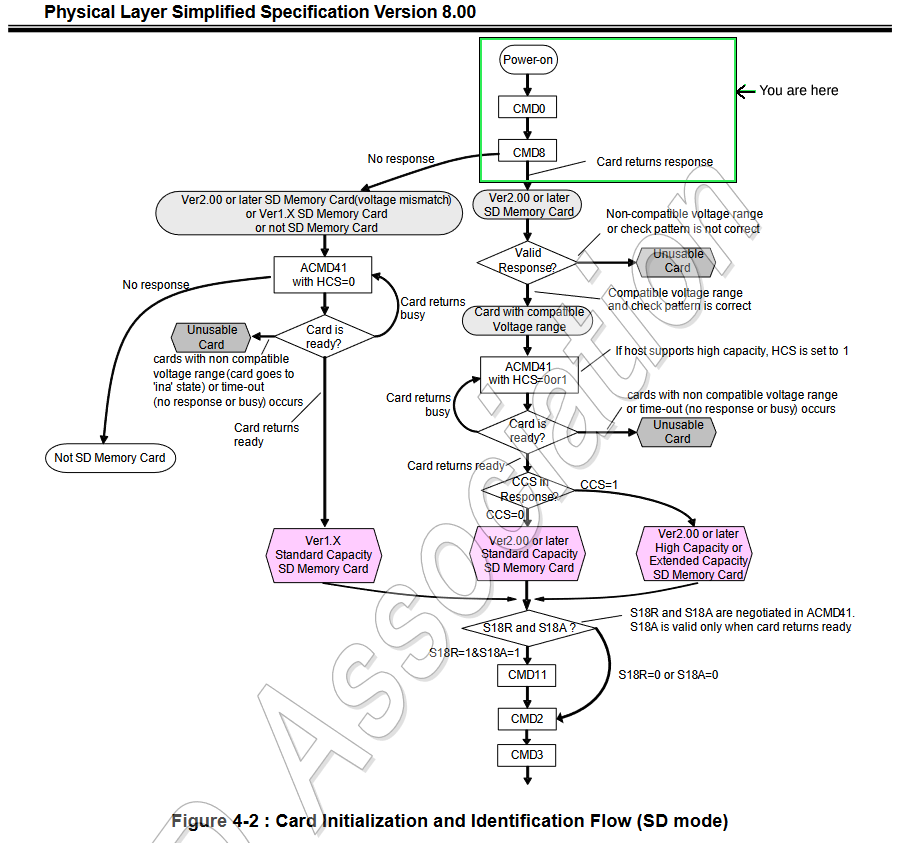
Pictures/SD Card/SD Card Initialistion Flow.png
