andrewpaterson/HCP65/Pictures/SD Card/SD Card Pins.png

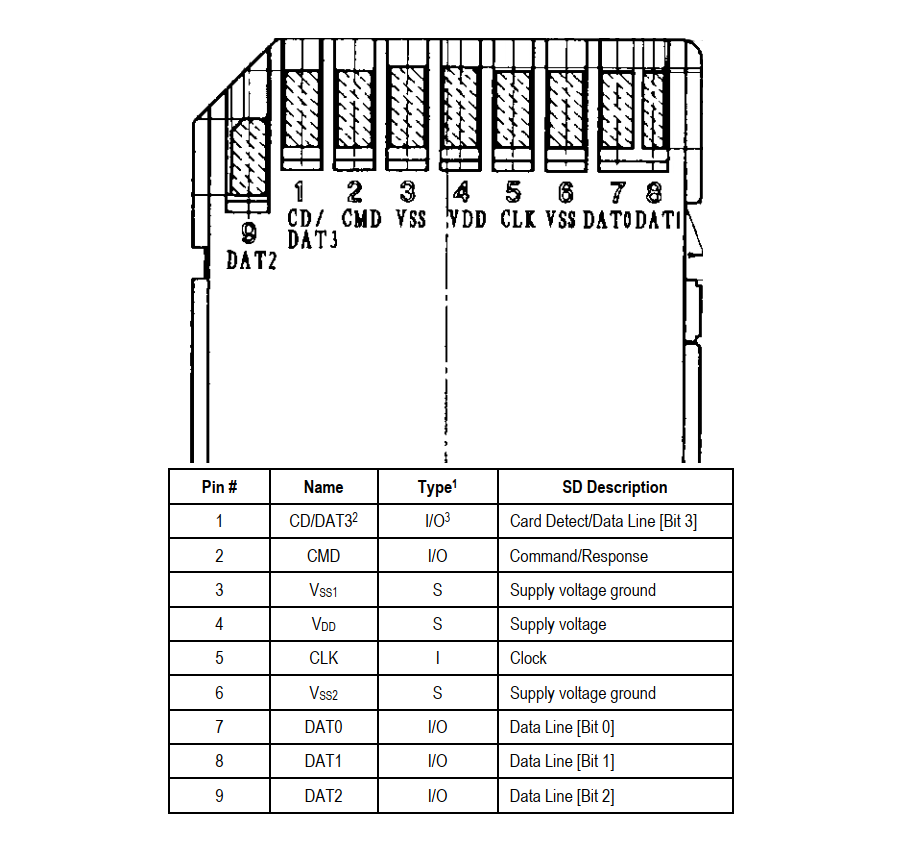
Pictures/SD Card/SD Card Pins.png
