andrewpaterson/HCP65/Pictures/SD Card/SD Card Read Timing.png

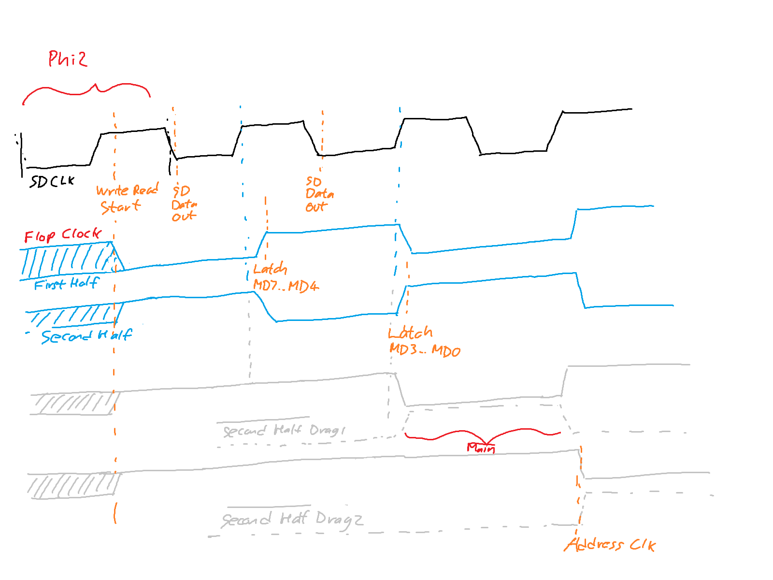
Pictures/SD Card/SD Card Read Timing.png
