andrewpaterson/HCP65/Pictures/Small Signal Delay/Pic1 Schematic.png

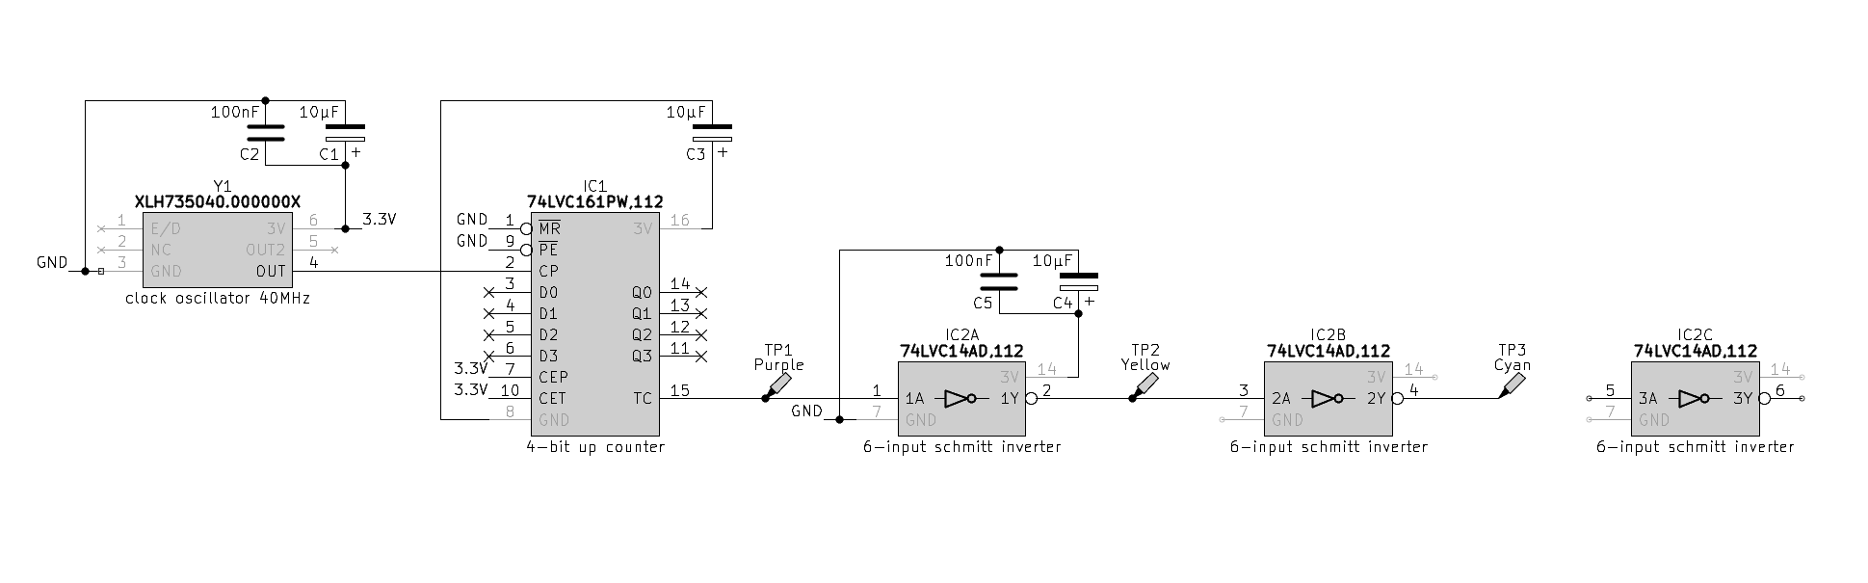
Pictures/Small Signal Delay/Pic1 Schematic.png
