andrewpaterson/HCP65/Pictures/Small Signal Delay/Pic1 Trace.jpg

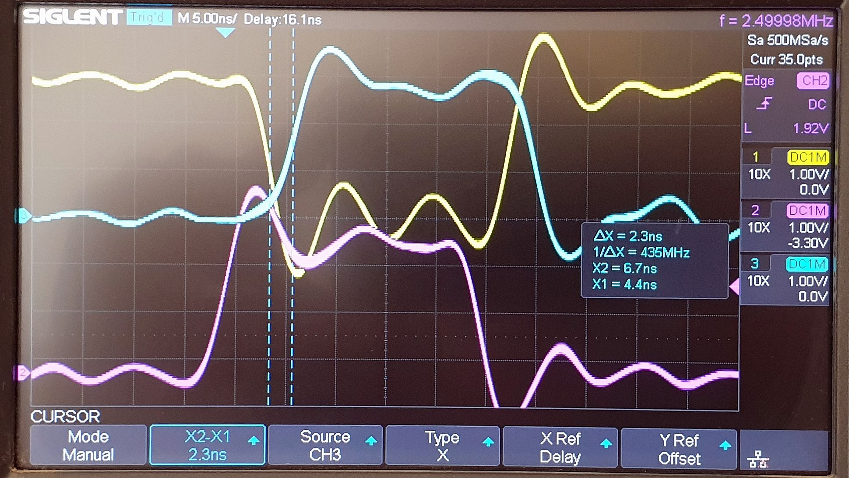
Pictures/Small Signal Delay/Pic1 Trace.jpg
