andrewpaterson/HCP65/Pictures/Small Signal Delay/Pic2 Trace.jpg

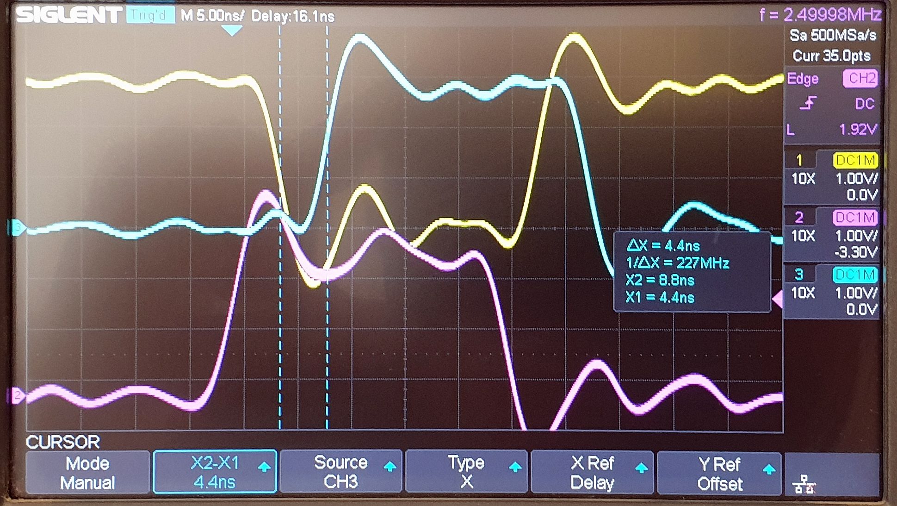
Pictures/Small Signal Delay/Pic2 Trace.jpg
