andrewpaterson/HCP65/Pictures/Small Signal Delay/Pic3 Trace.jpg

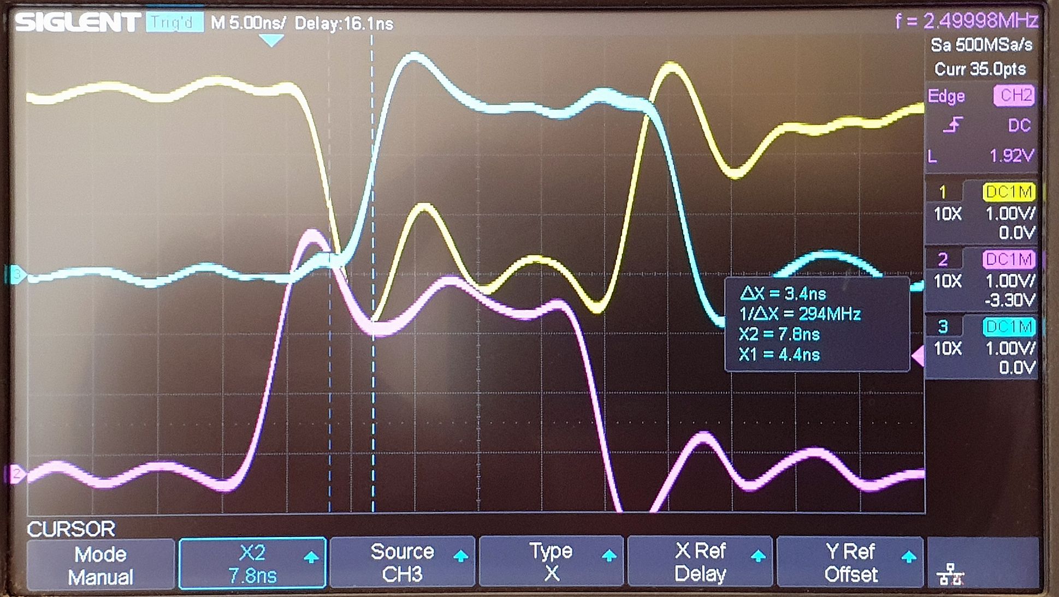
Pictures/Small Signal Delay/Pic3 Trace.jpg
