andrewpaterson/HCP65/Pictures/Small Signal Delay/Pic4 Trace.jpg

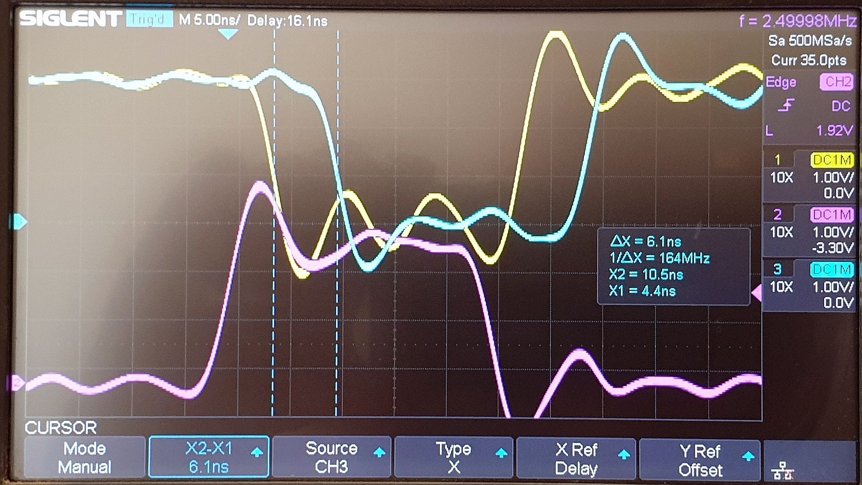
Pictures/Small Signal Delay/Pic4 Trace.jpg
