andrewpaterson/HCP65/Pictures/Small Signal Delay/Pic5 Trace.jpg

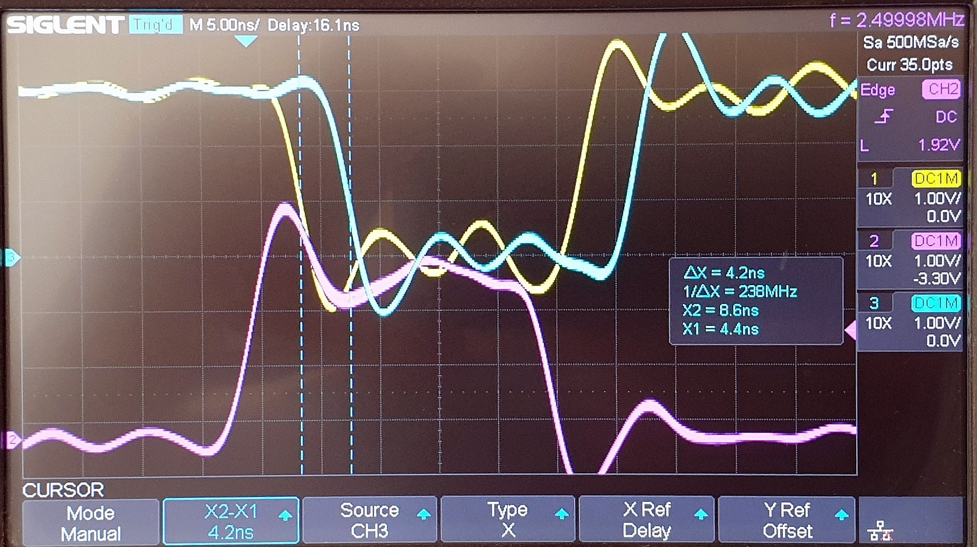
Pictures/Small Signal Delay/Pic5 Trace.jpg
