andrewpaterson/HCP65/Pictures/Small Signal Delay/Pic6 Breadboard.jpg

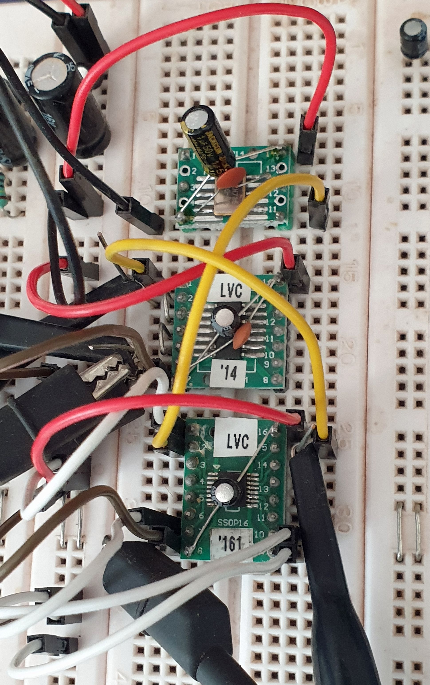
Pictures/Small Signal Delay/Pic6 Breadboard.jpg
