andrewpaterson/HCP65/Pictures/Small Signal Delay/Pic7 Trace.jpg

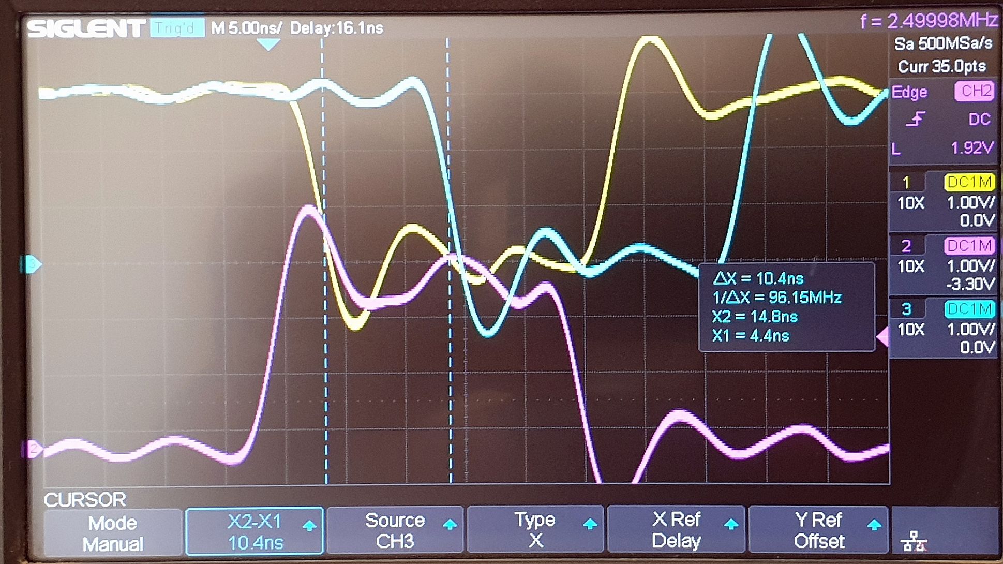
Pictures/Small Signal Delay/Pic7 Trace.jpg
