andrewpaterson/HCP65/Pictures/SNES Controller.png

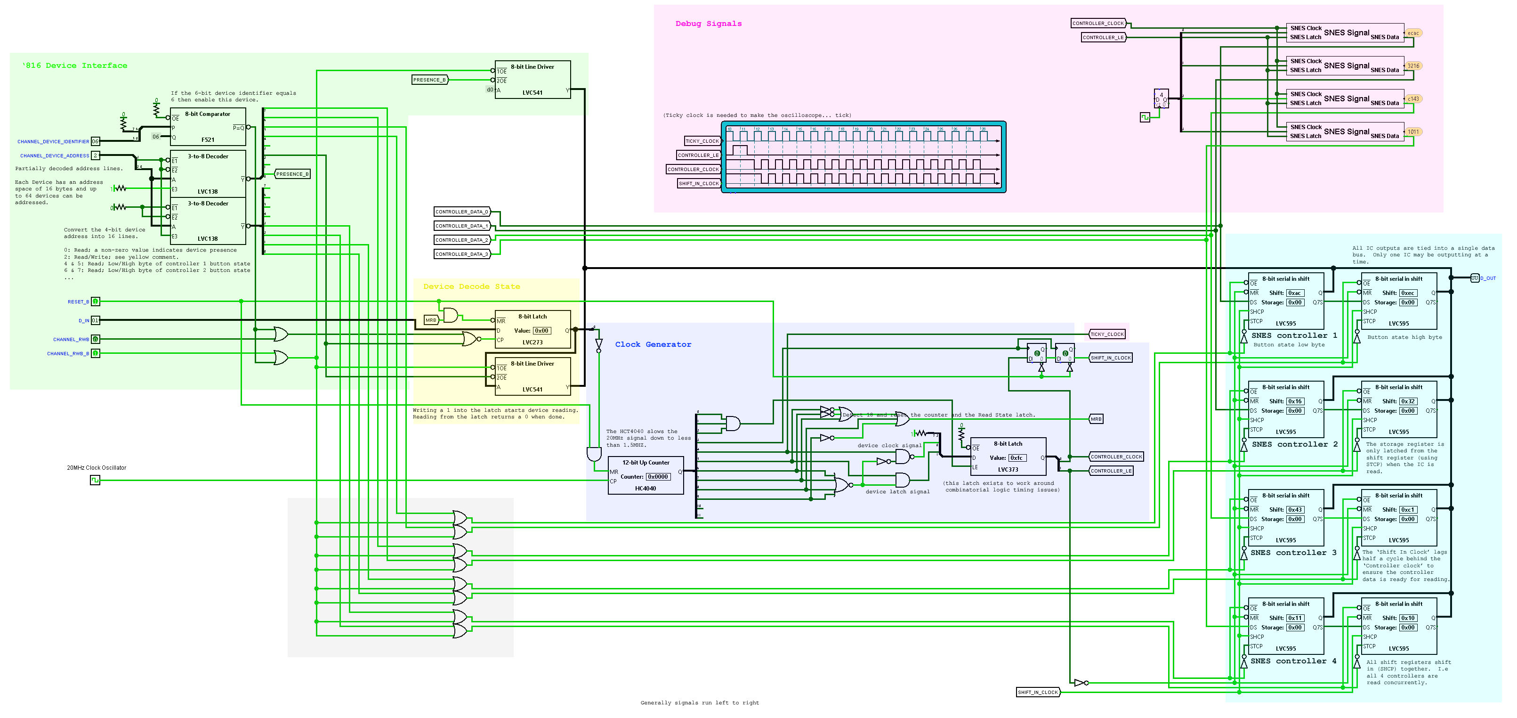
Pictures/SNES Controller.png
