andrewpaterson/HCP65/Pictures/SO MANY FIFOS.png

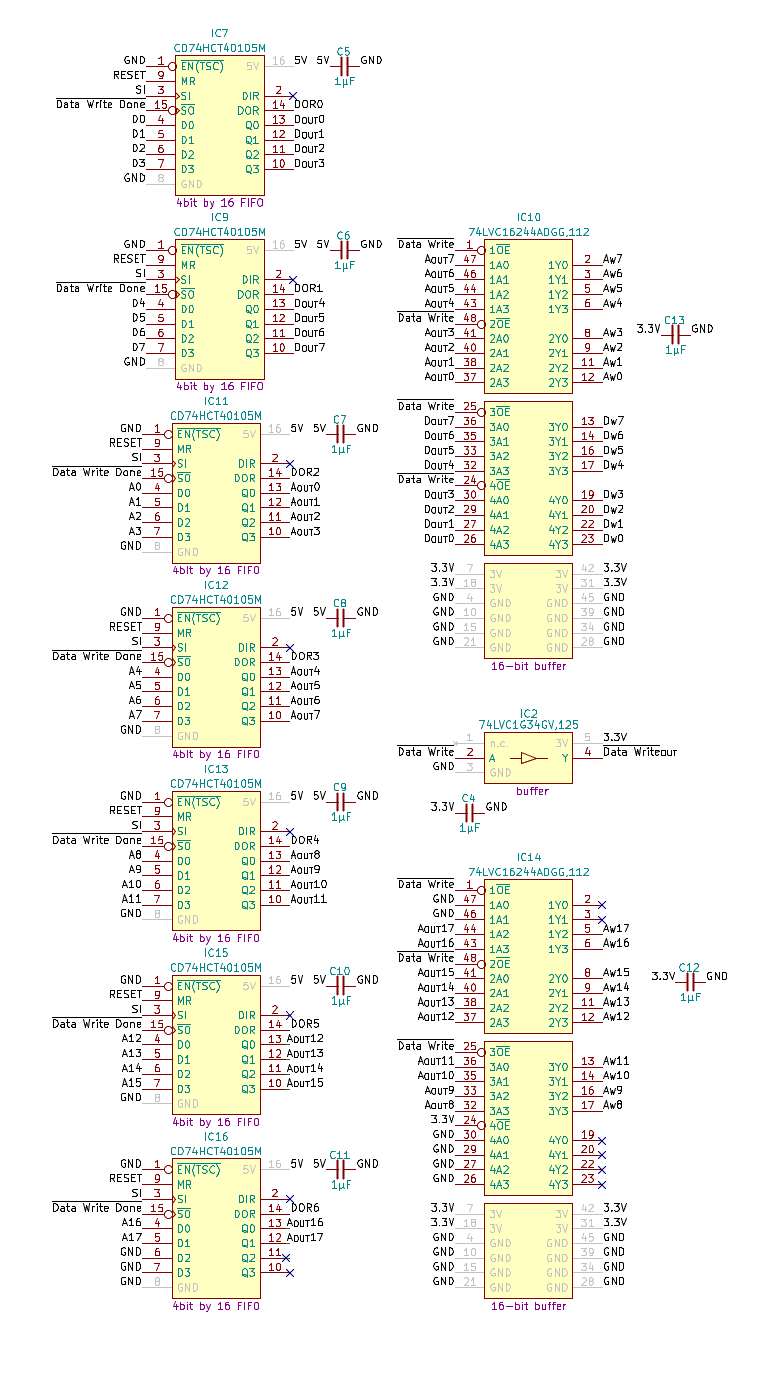
Pictures/SO MANY FIFOS.png
