andrewpaterson/HCP65/Pictures/Sound Buffer Device.jpg

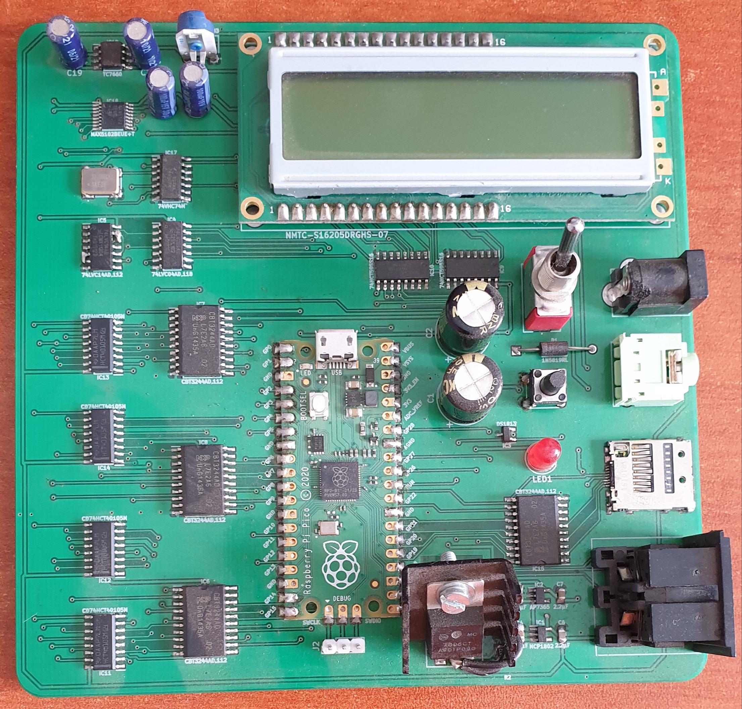
Pictures/Sound Buffer Device.jpg
