andrewpaterson/HCP65/Pictures/Sprite Stretching 1.png

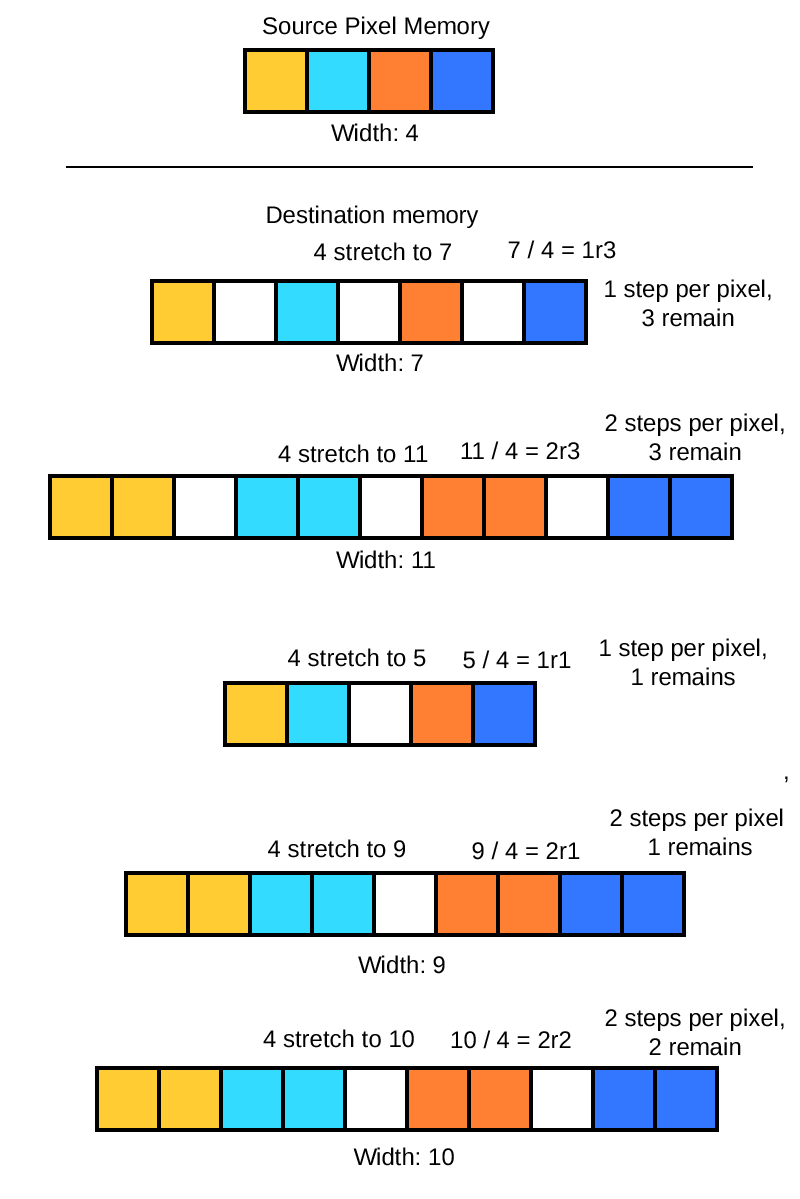
Pictures/Sprite Stretching 1.png
