andrewpaterson/HCP65/Pictures/Sprite Stretching 2.png

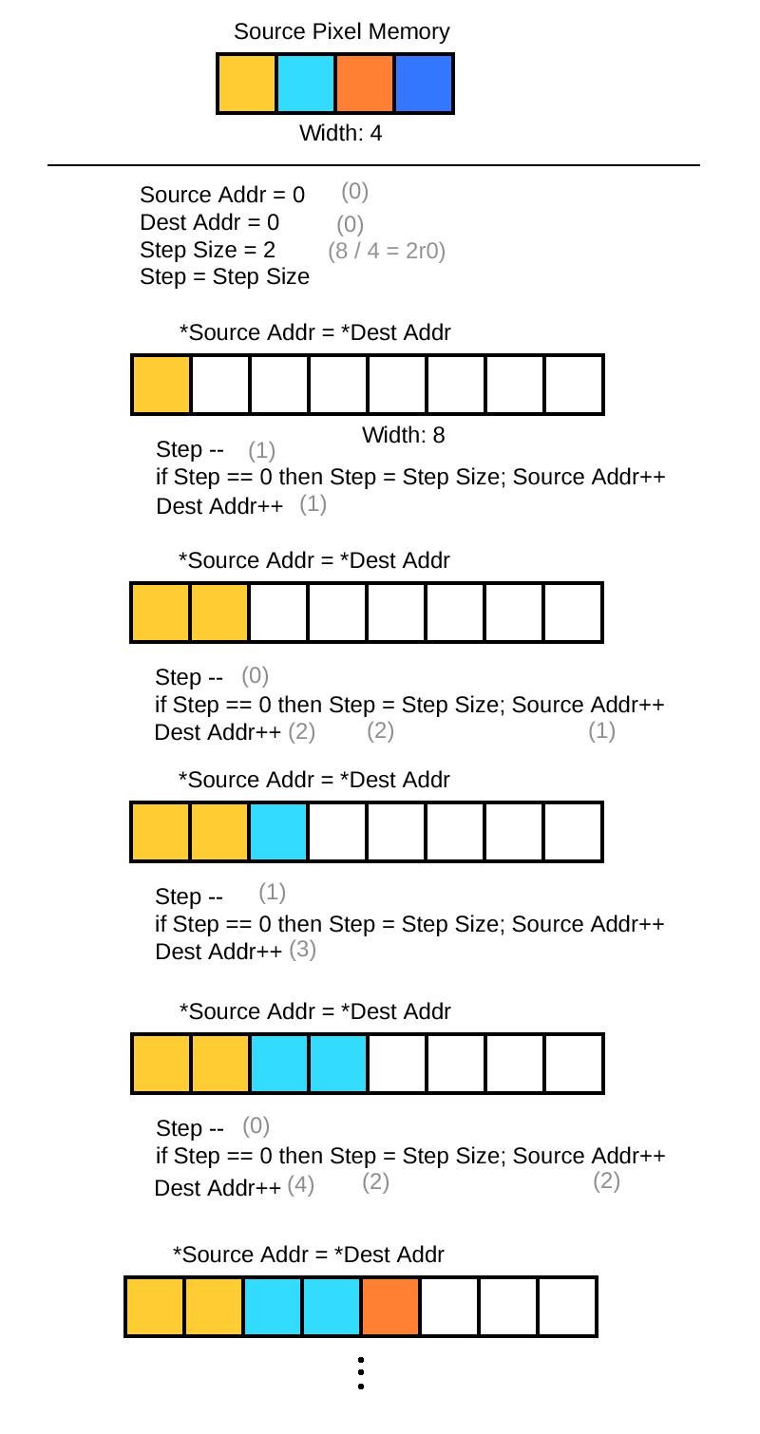
Pictures/Sprite Stretching 2.png
