andrewpaterson/HCP65/Pictures/Sprite Stretching 3.png

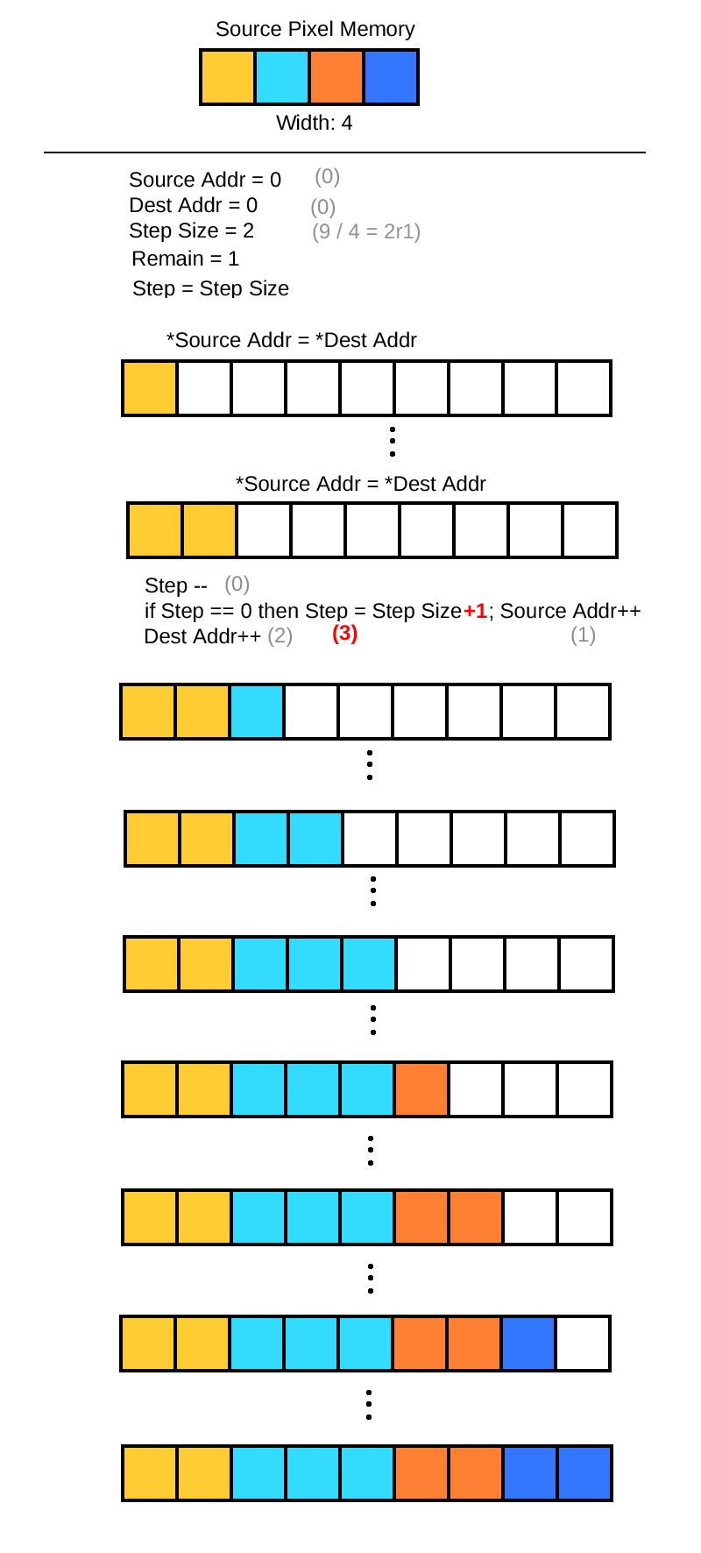
Pictures/Sprite Stretching 3.png
