andrewpaterson/HCP65/Pictures/Sprite Stretching 5.png

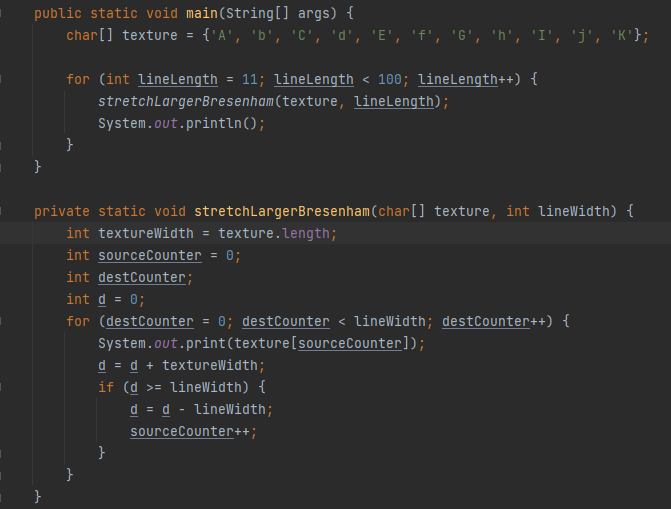
Pictures/Sprite Stretching 5.png
