andrewpaterson/HCP65/Pictures/Sprite Stretching 7.png

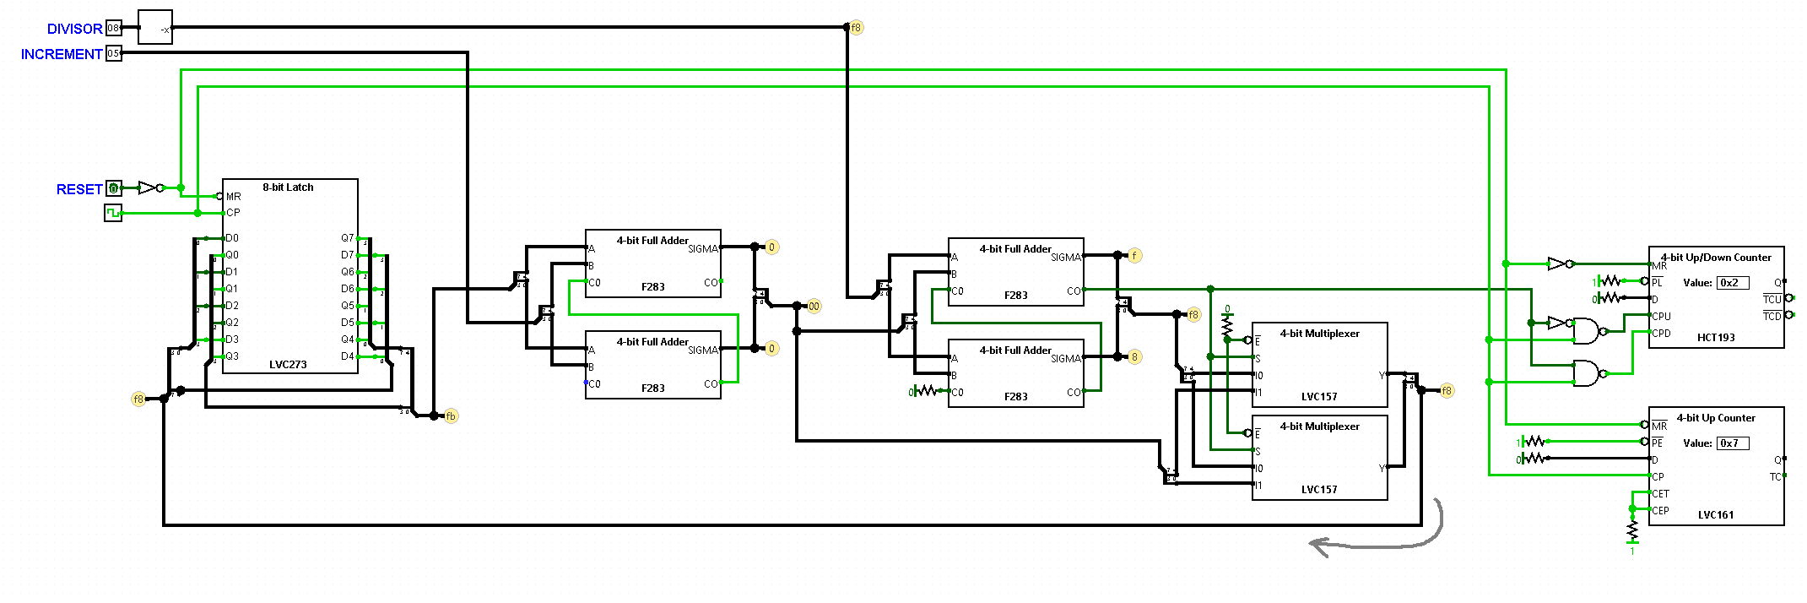
Pictures/Sprite Stretching 7.png
