andrewpaterson/HCP65/Pictures/Sprite Stretching 8.png

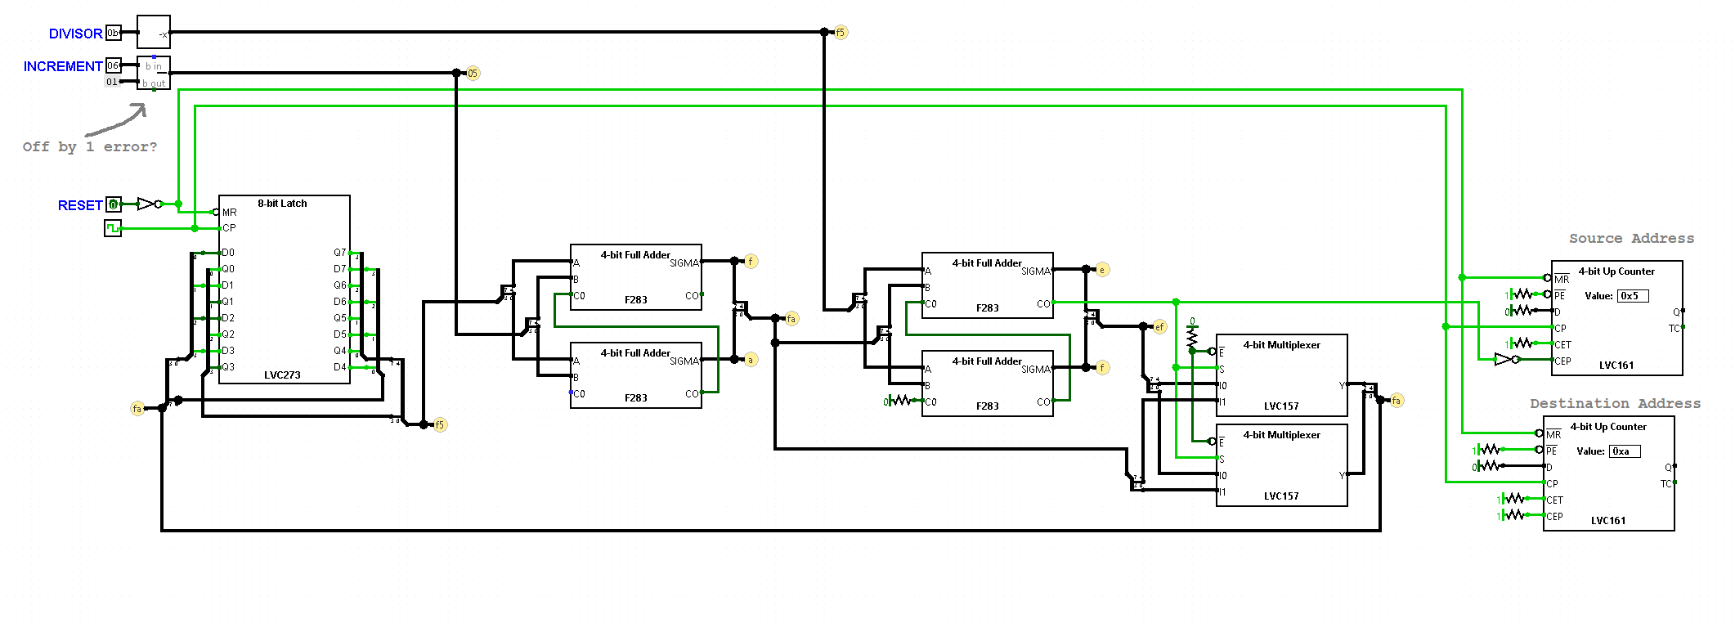
Pictures/Sprite Stretching 8.png
