andrewpaterson/HCP65/Pictures/Sprite Stretching 9.png

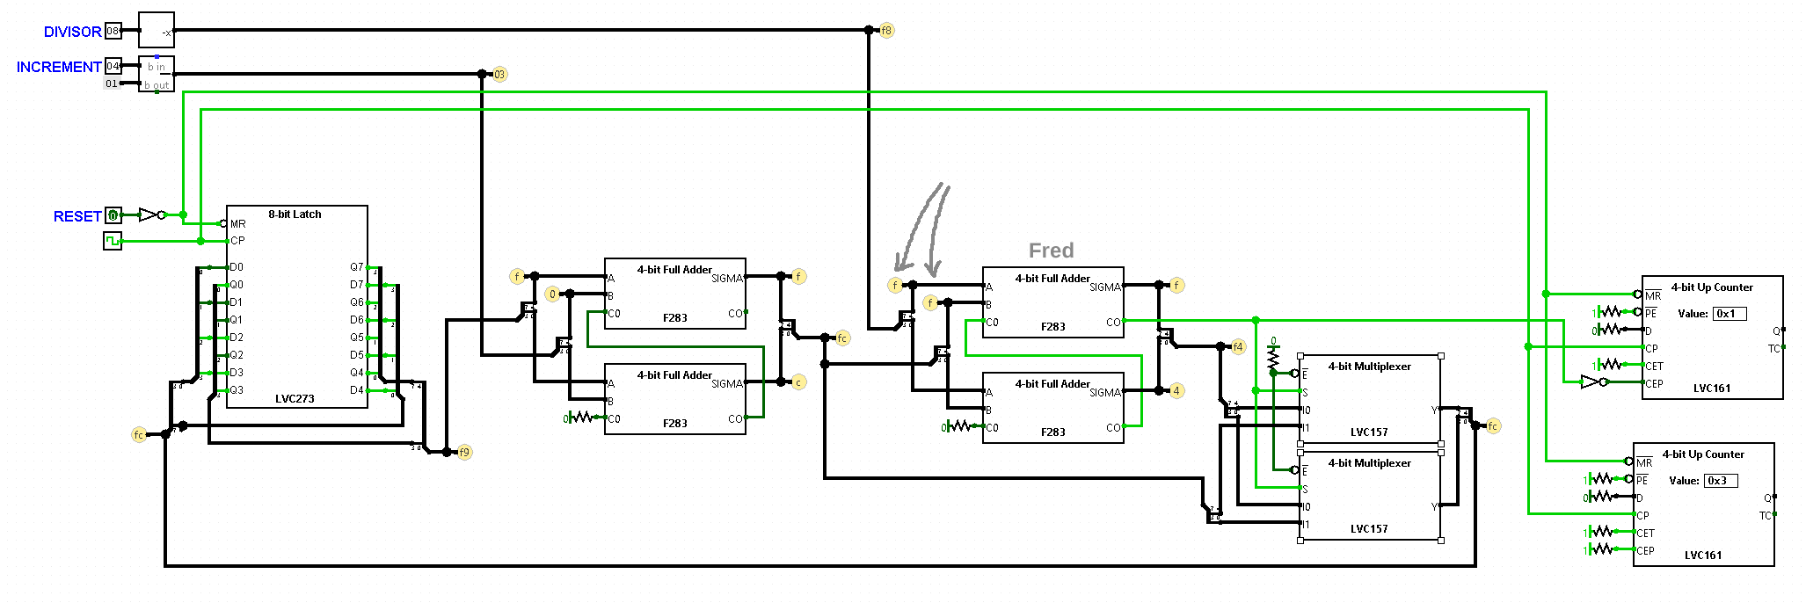
Pictures/Sprite Stretching 9.png
