andrewpaterson/HCP65/Pictures/Sprite Stretching A.png

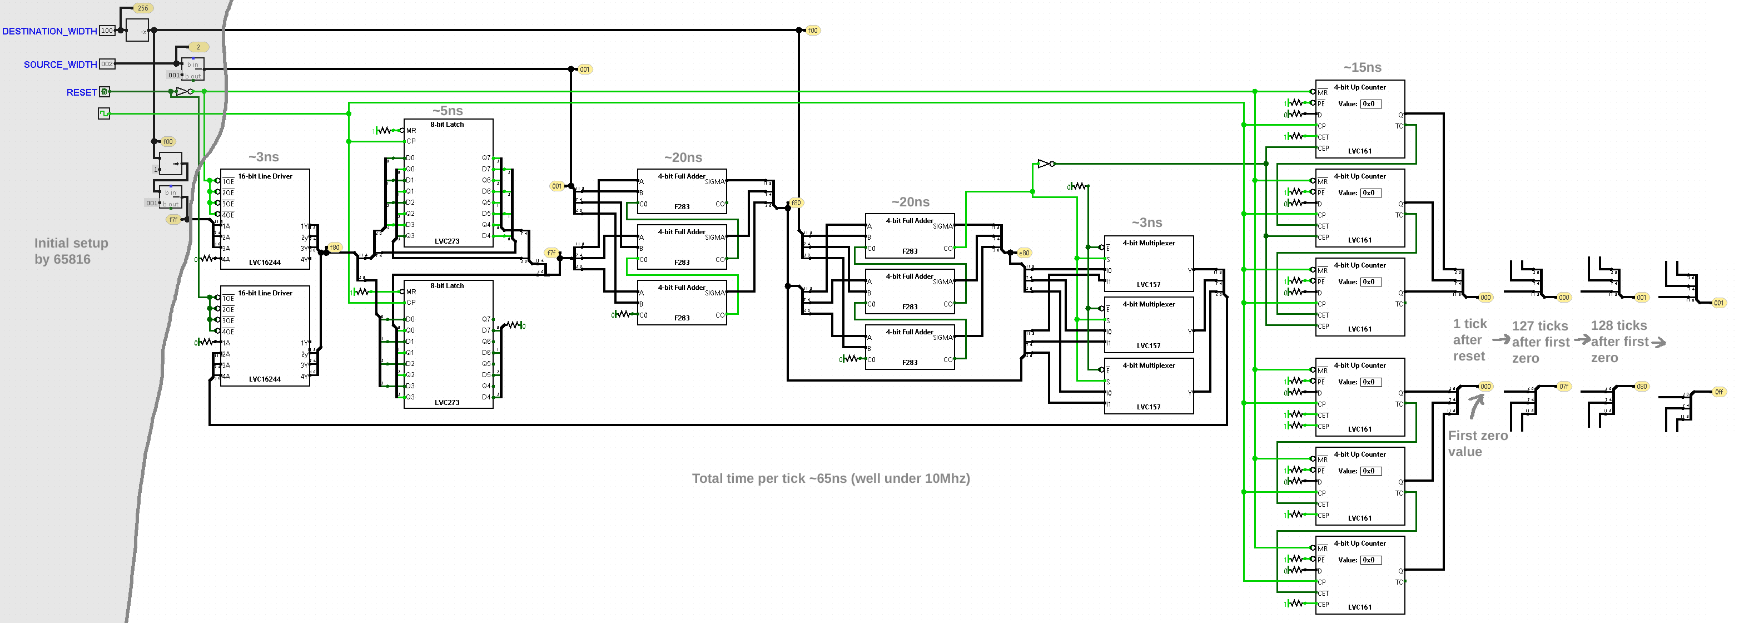
Pictures/Sprite Stretching A.png
