andrewpaterson/HCP65/Pictures/Sprite Stretching B.png

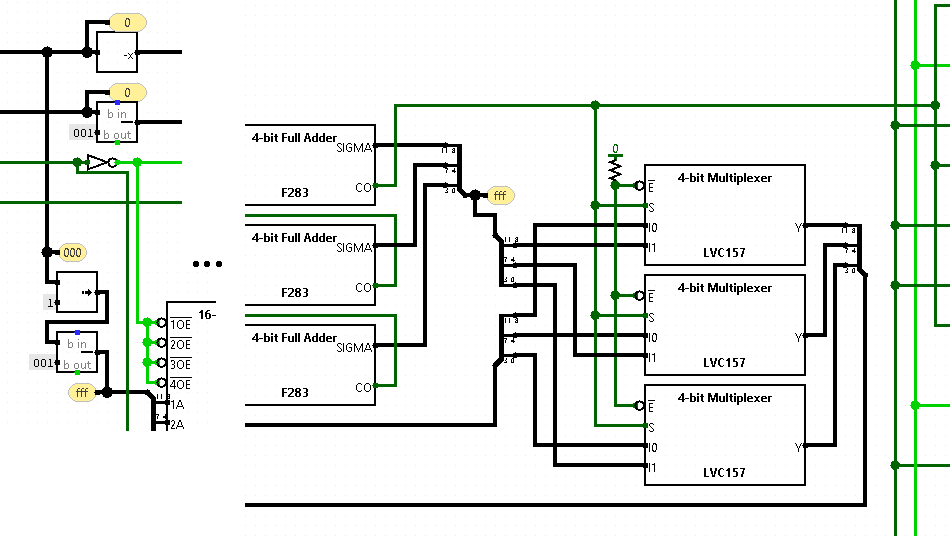
Pictures/Sprite Stretching B.png
