andrewpaterson/HCP65/Pictures/Sprite Stretching C.png

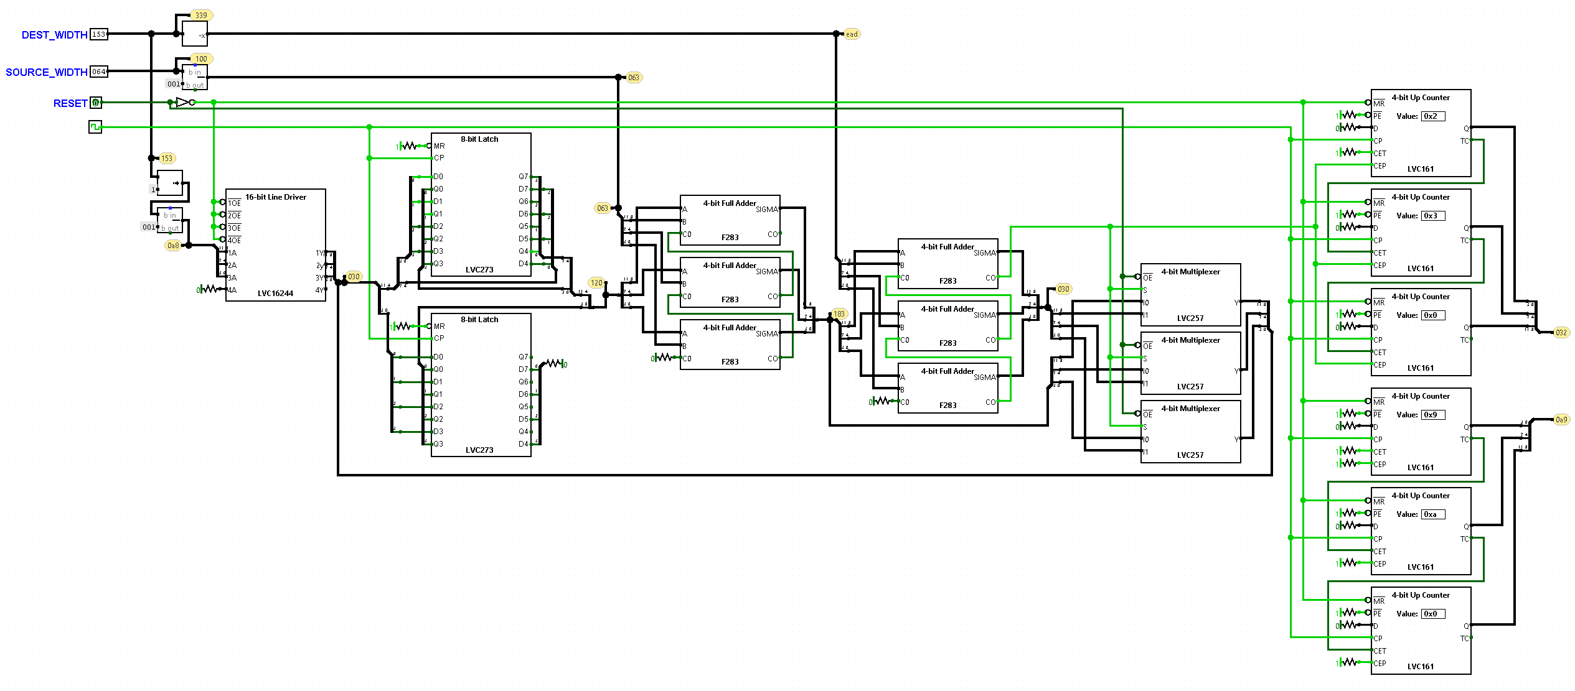
Pictures/Sprite Stretching C.png
