andrewpaterson/HCP65/Pictures/Stripboard.jpg

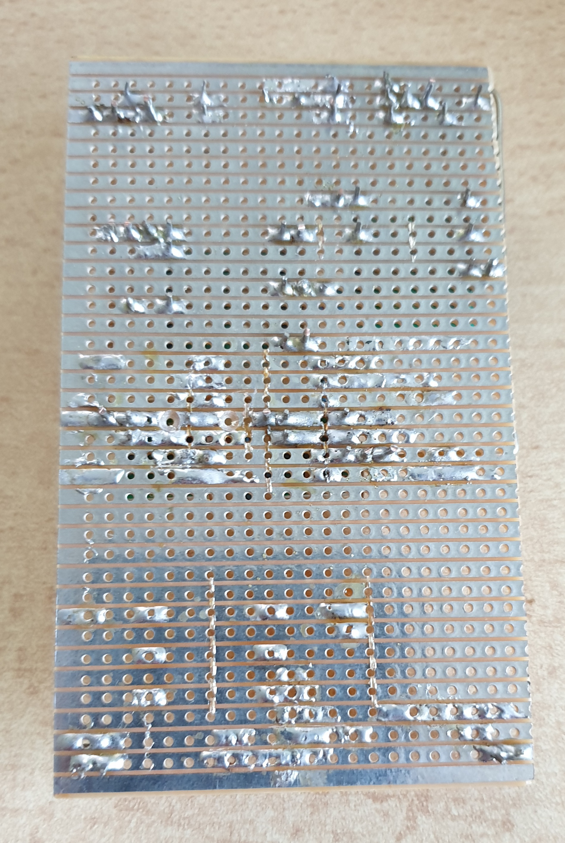
Pictures/Stripboard.jpg
