andrewpaterson/HCP65/Pictures/Timing.png

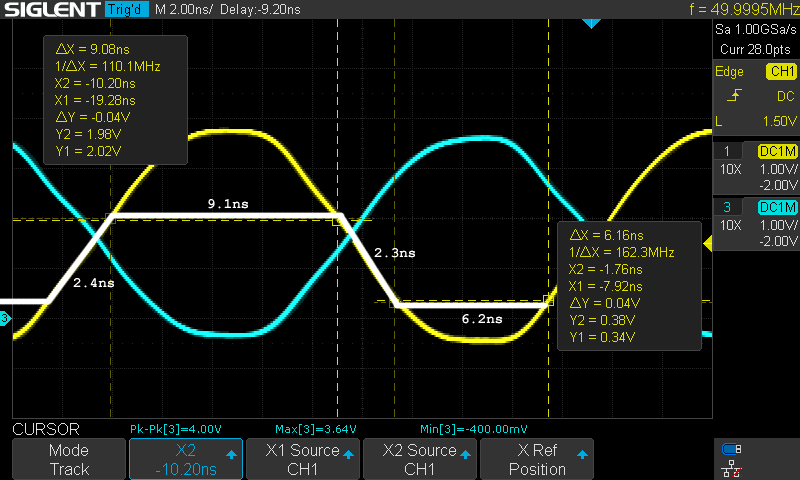
Pictures/Timing.png
