andrewpaterson/HCP65/Pictures/Tomb Raider 512x384.png

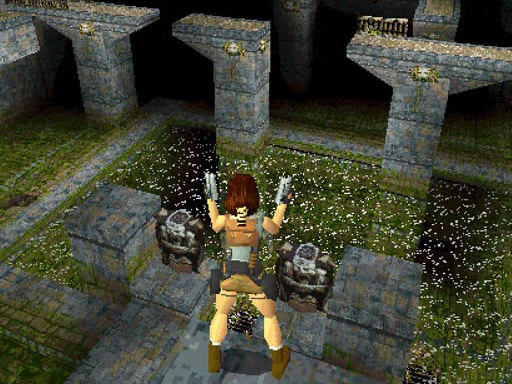
Pictures/Tomb Raider 512x384.png
