andrewpaterson/HCP65/Pictures/USB Blasters.jpg

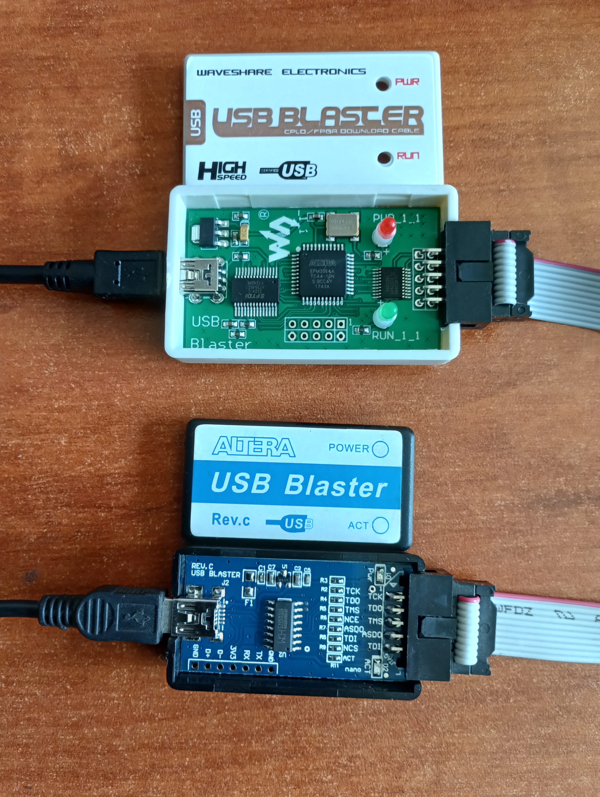
Pictures/USB Blasters.jpg
