andrewpaterson/HCP65/Pictures/Video board - memory.png

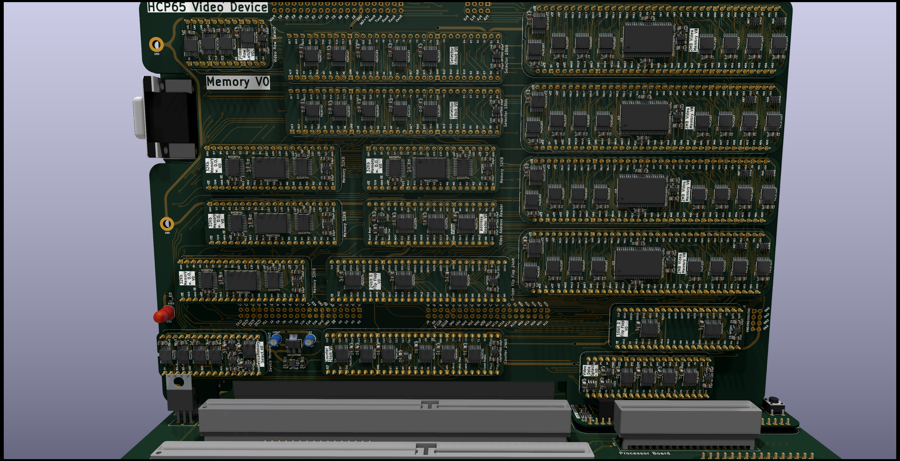
Pictures/Video board - memory.png
