andrewpaterson/HCP65/Pictures/Video board - signals.png

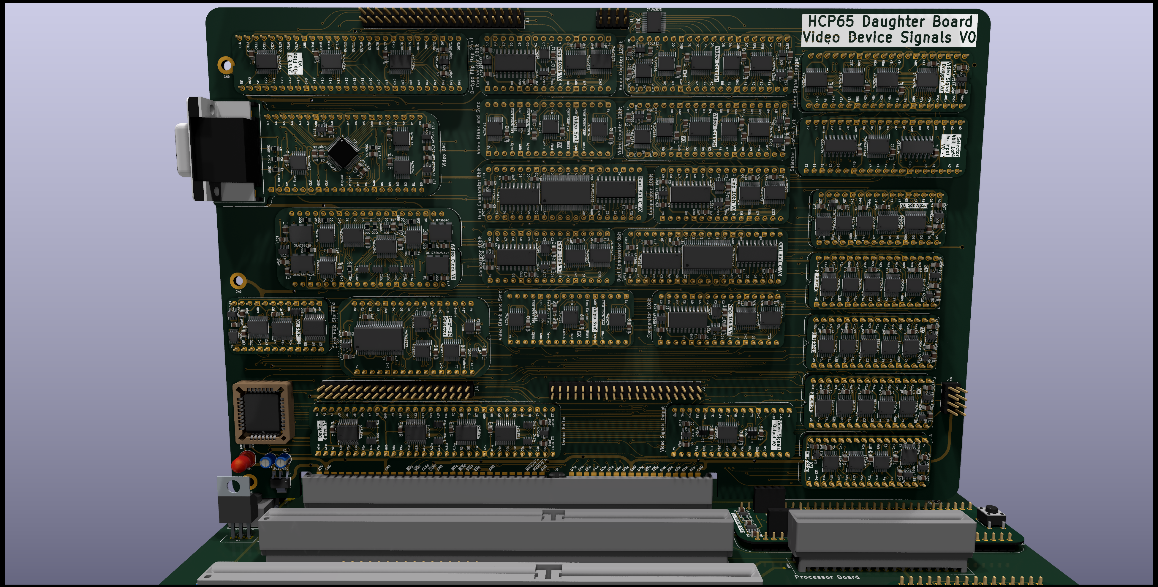
Pictures/Video board - signals.png
