andrewpaterson/HCP65/Pictures/Video Card/Memory Front Copper.png

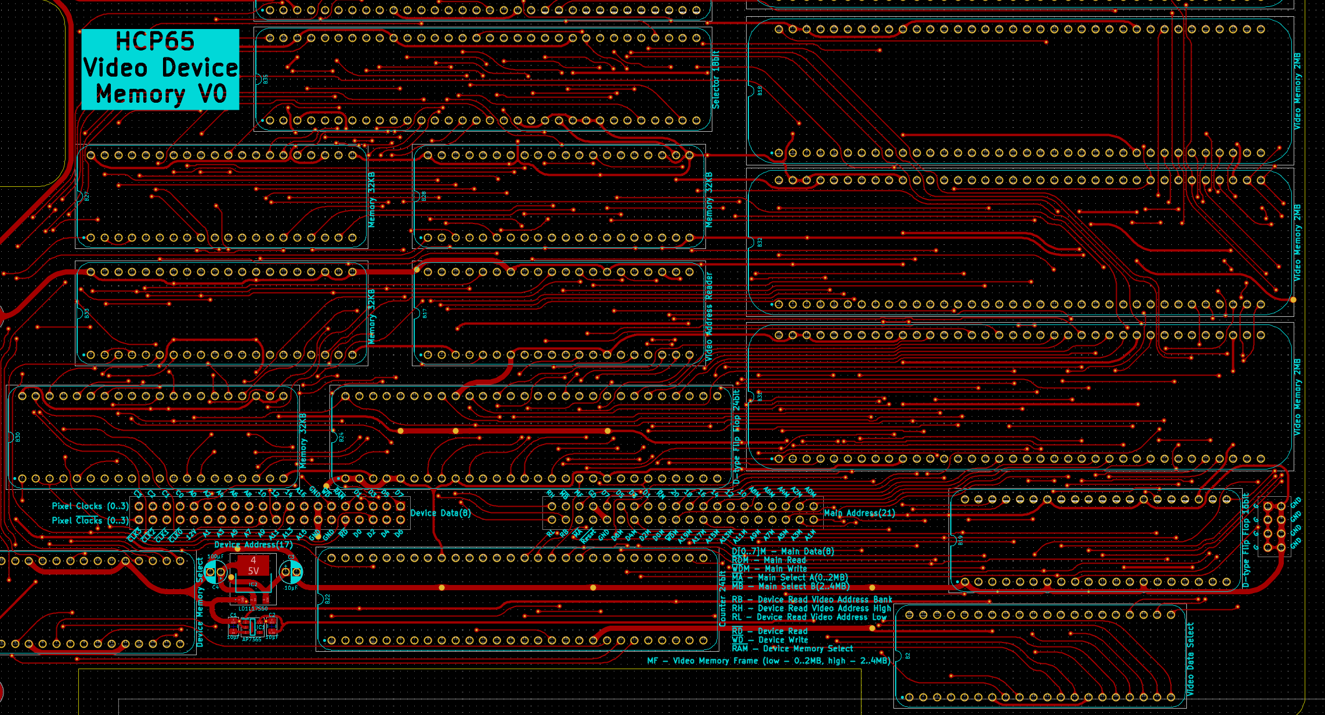
Pictures/Video Card/Memory Front Copper.png
