andrewpaterson/HCP65/Pictures/Video Card/Memory Render.png

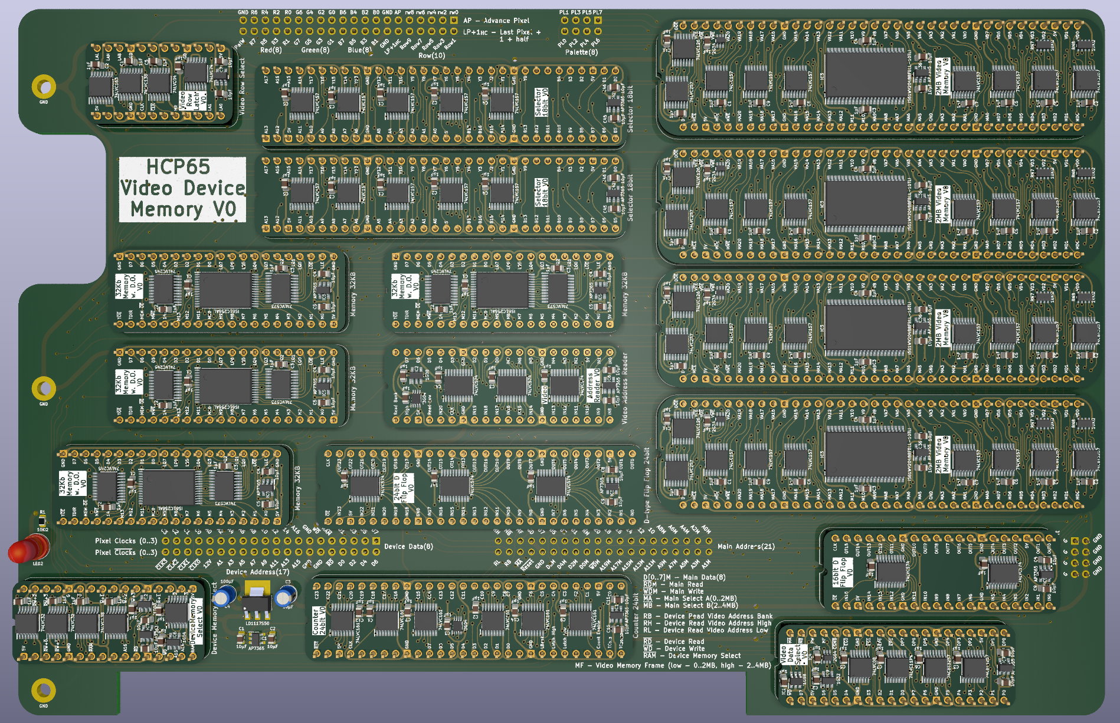
Pictures/Video Card/Memory Render.png
