andrewpaterson/HCP65/Pictures/Video Card/Signals Front Copper.png

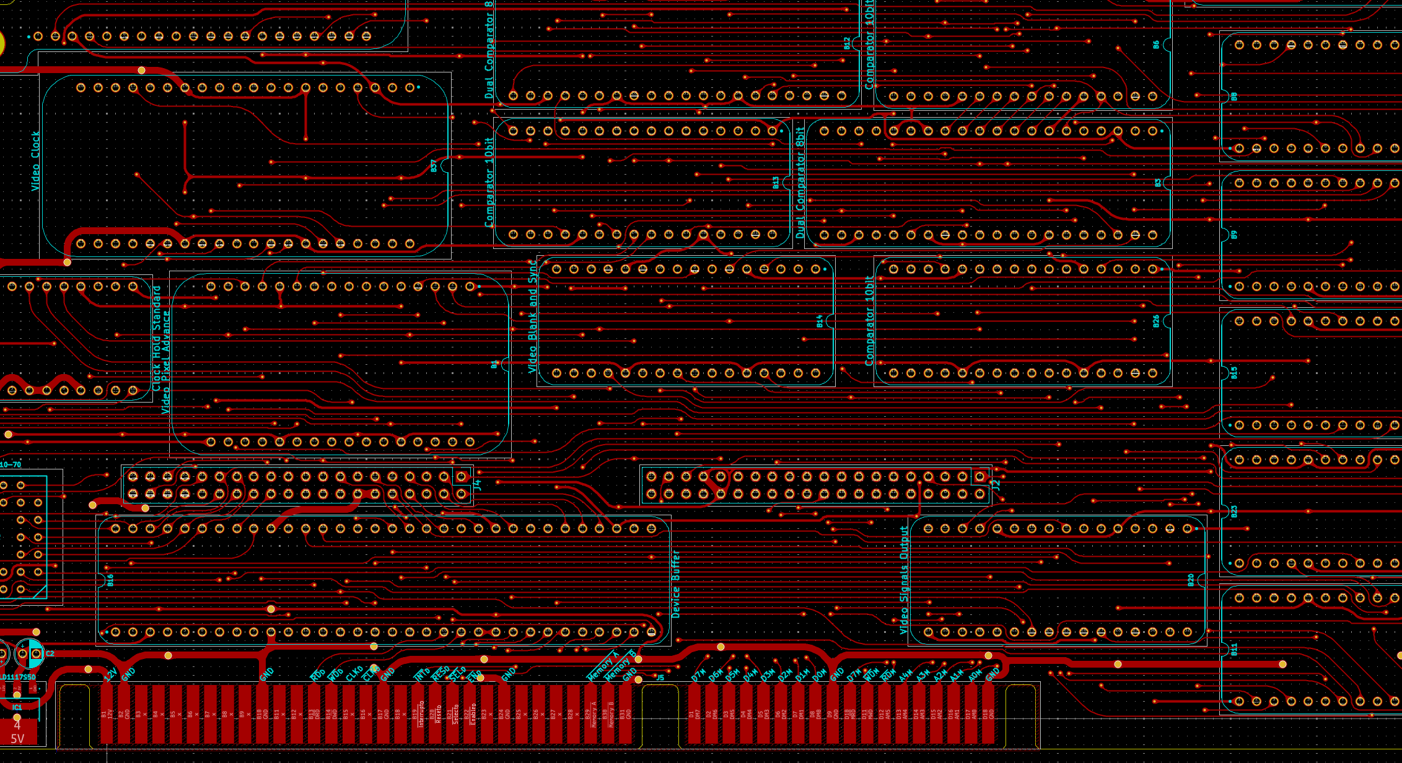
Pictures/Video Card/Signals Front Copper.png
