andrewpaterson/HCP65/Pictures/Video Card/Signals Render.png

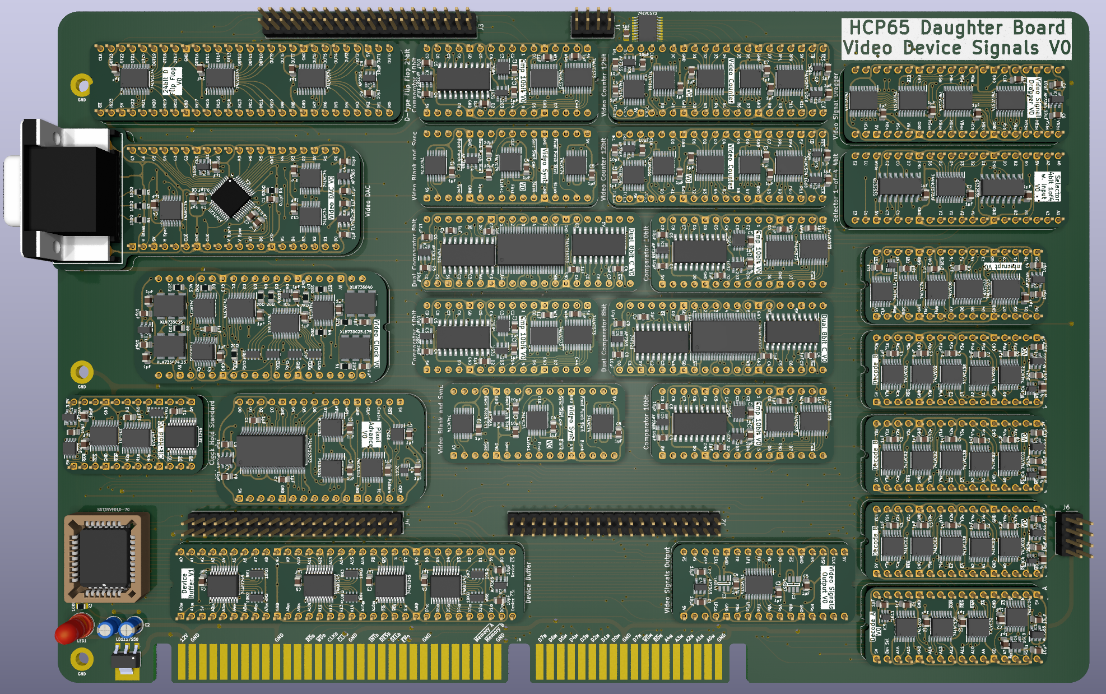
Pictures/Video Card/Signals Render.png
