andrewpaterson/HCP65/Pictures/Video Write Waiting.png

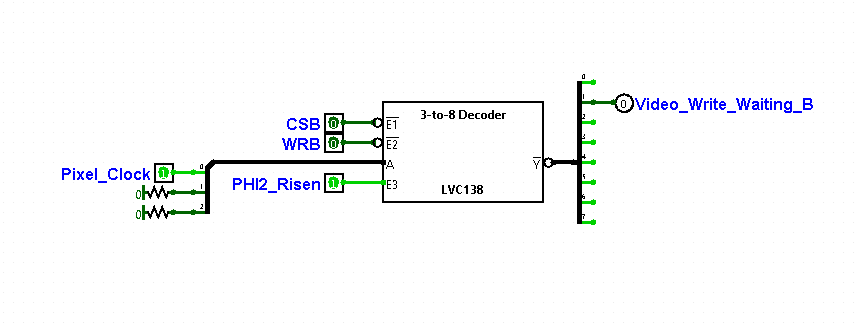
Pictures/Video Write Waiting.png
