andrewpaterson/HCP65/Pictures/W65C51 Status Register.png

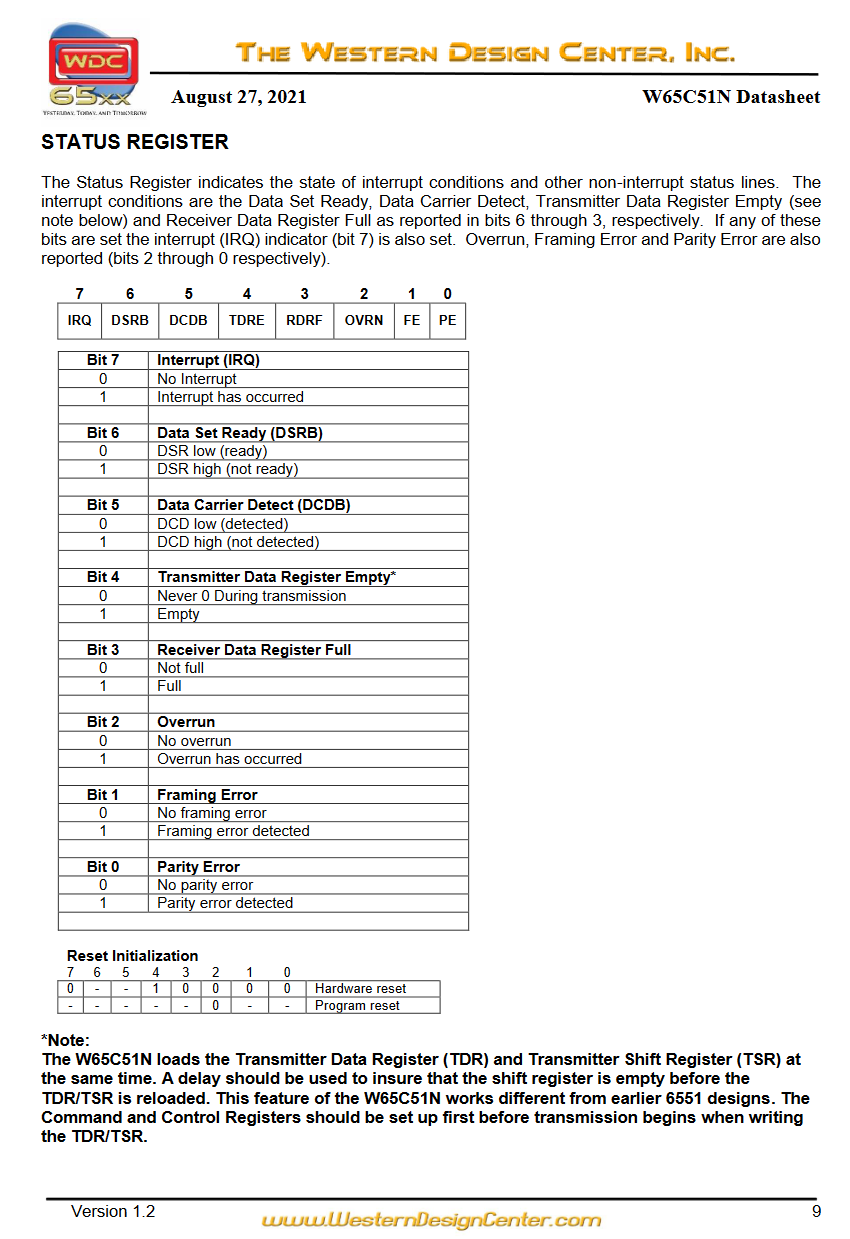
Pictures/W65C51 Status Register.png
