andrewpaterson/HCP65/Pictures/W65C134.png

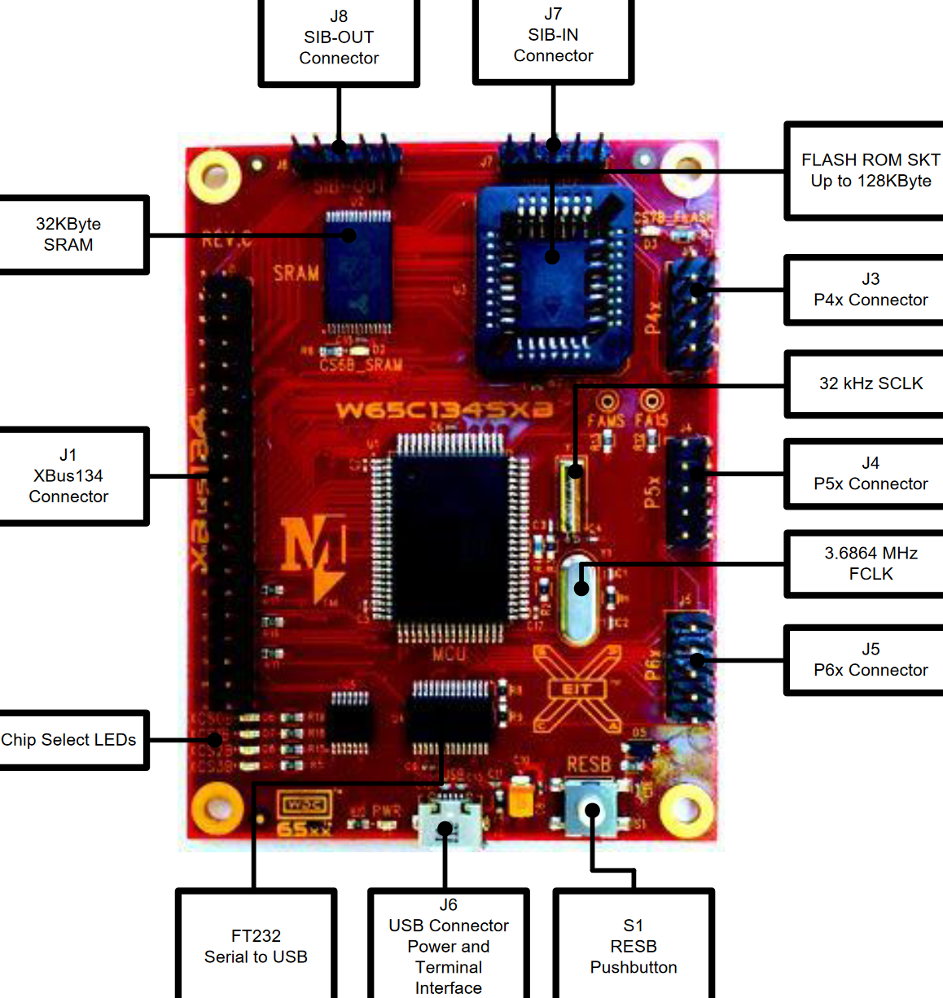
Pictures/W65C134.png
