andrewpaterson/HCP65/Pictures/W65C265.png

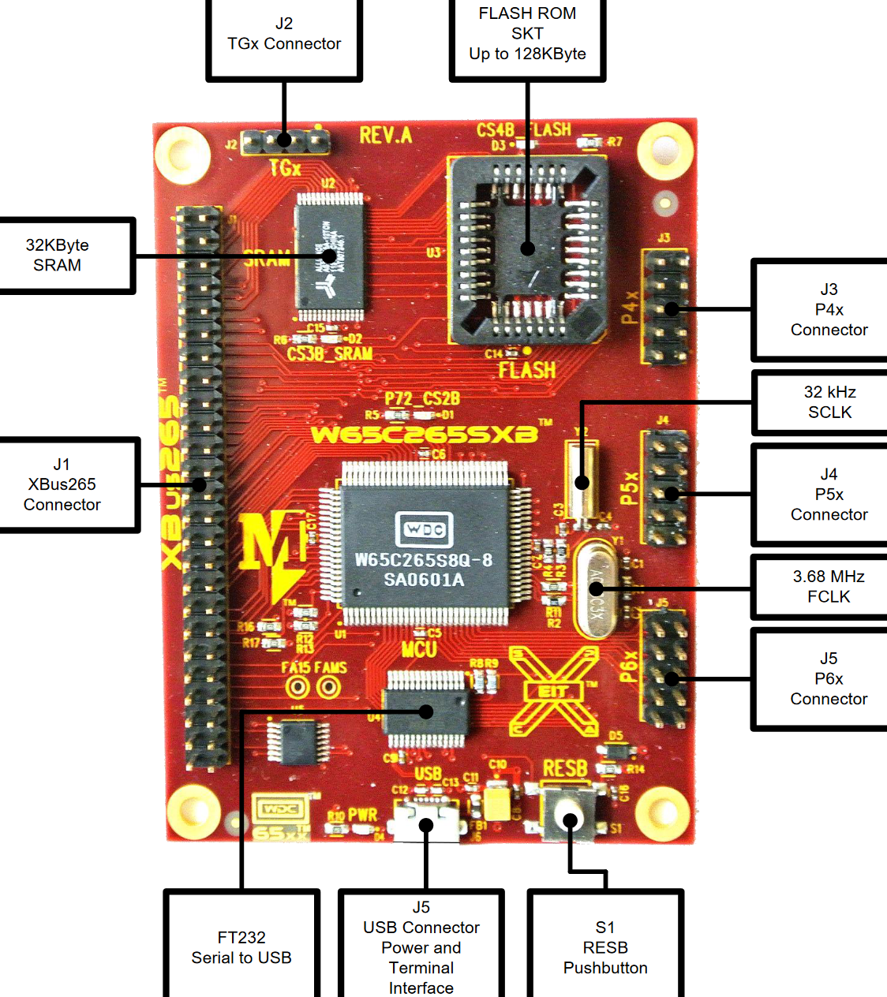
Pictures/W65C265.png
