andrewpaterson/HCP65/Pictures/W65C816S Footprint.png

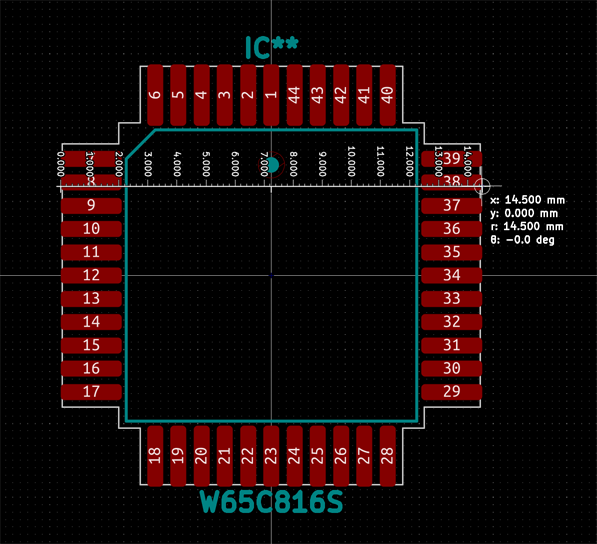
Pictures/W65C816S Footprint.png
