andrewpaterson/HCP65/Pictures/Zener Protection.png

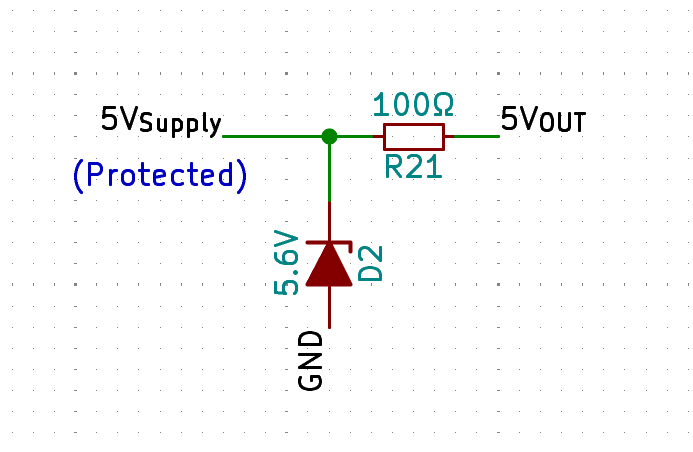
Pictures/Zener Protection.png
