andrewpaterson/HCP65/W65C64/Addressing Modes.png

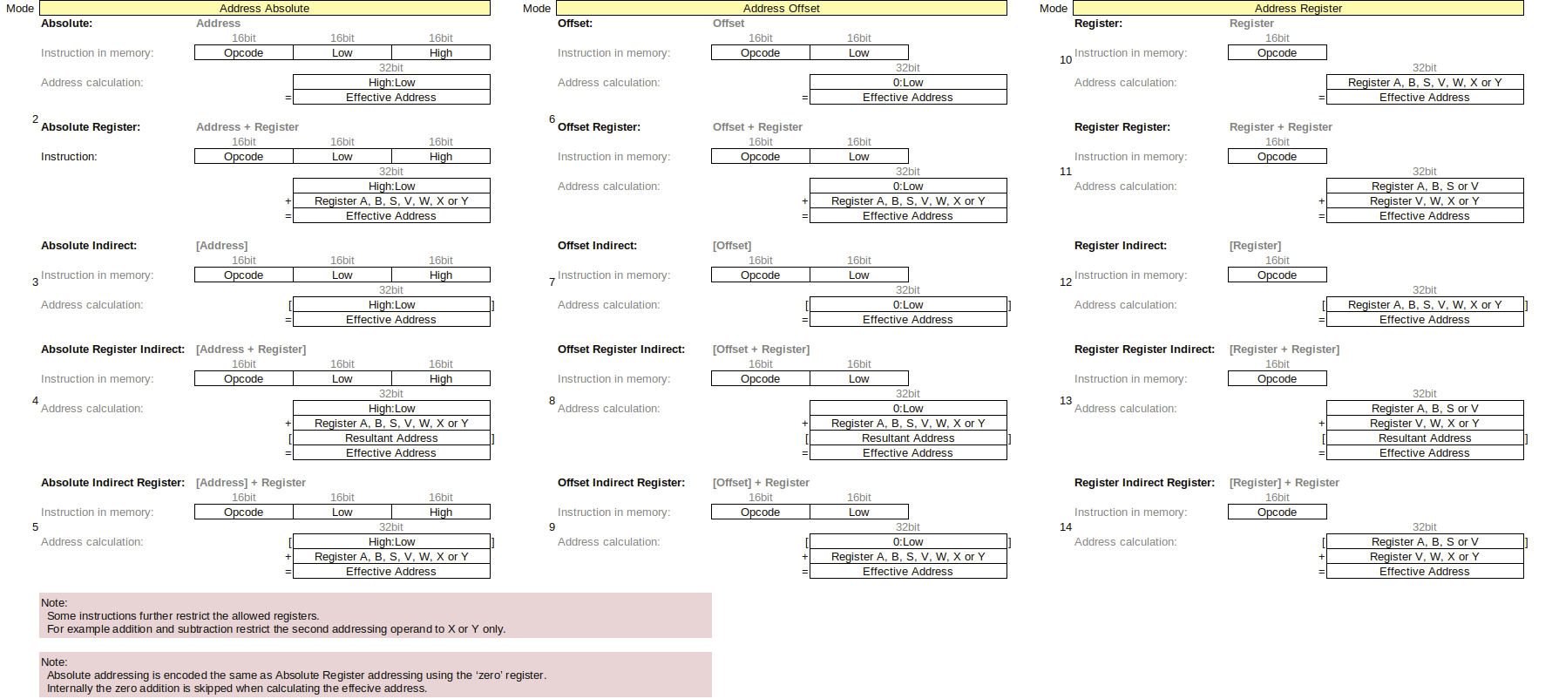
W65C64/Addressing Modes.png
