andrewpaterson/HCP65/W65C64/Opcode Encoding.png

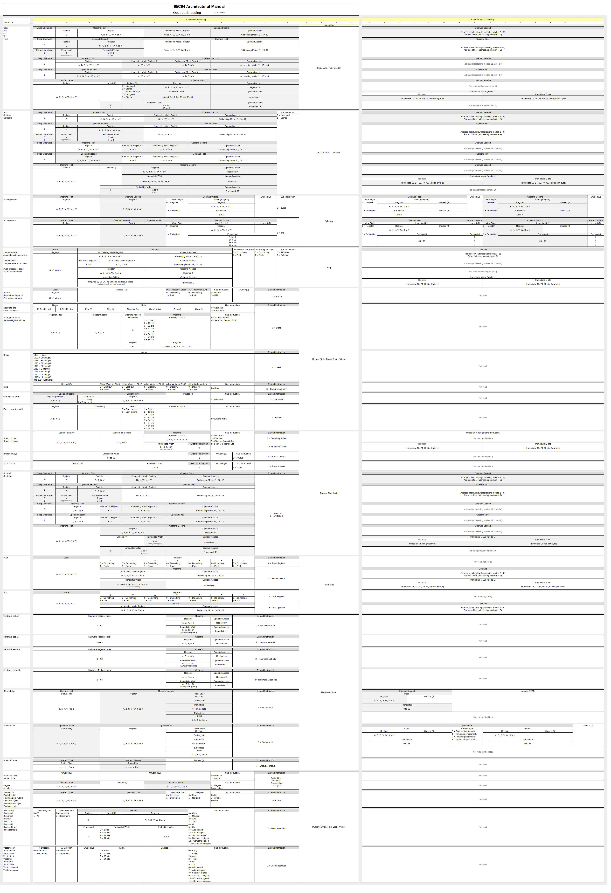
W65C64/Opcode Encoding.png
