andrewpaterson/HCP65/W65C64/Operand Mode Encoding.png

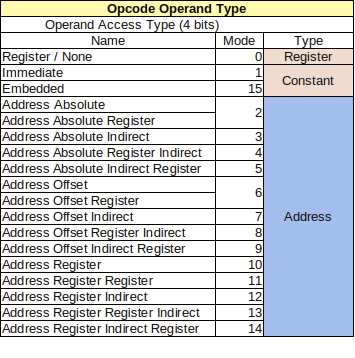
W65C64/Operand Mode Encoding.png
