andrewpaterson/HCP65/W65C64/Registers.png

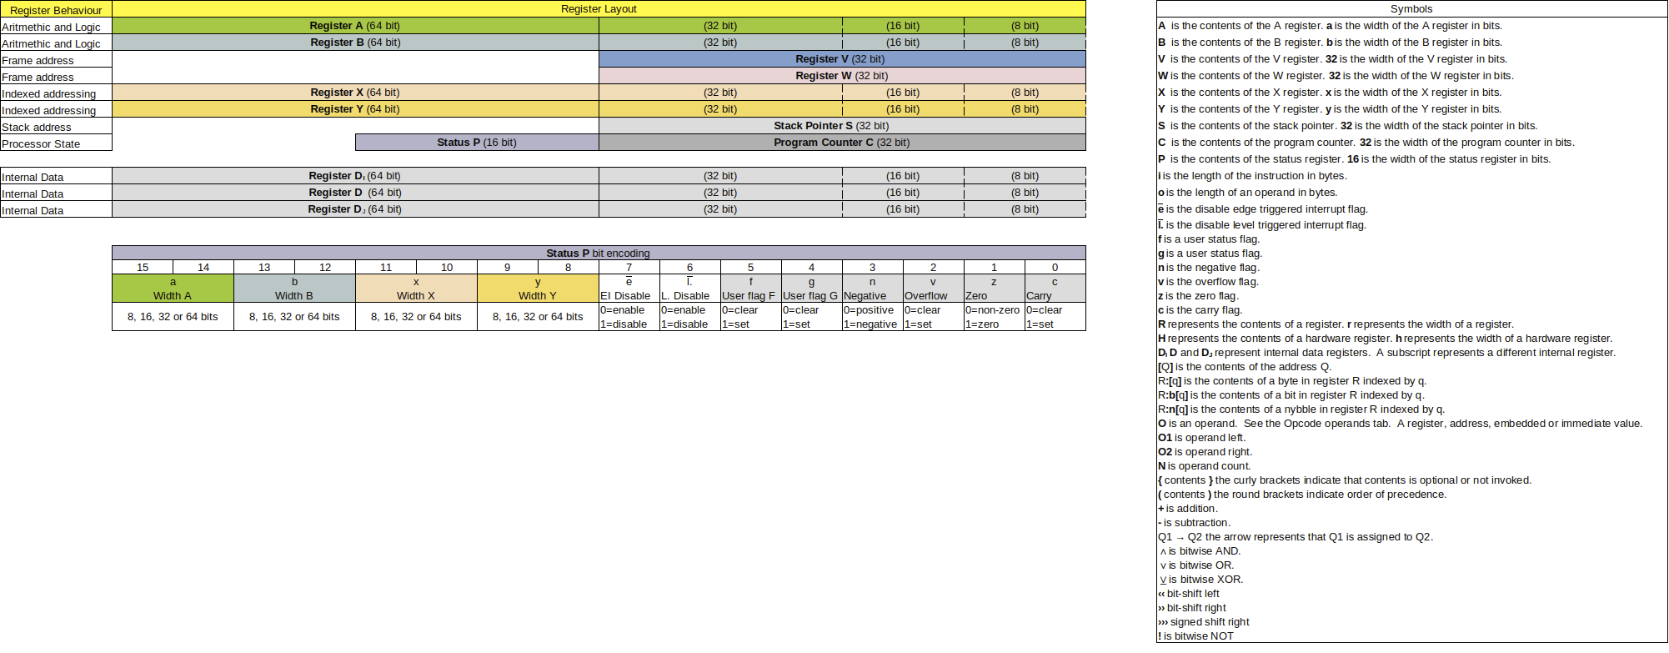
W65C64/Registers.png
