andrewpaterson/HCP65/(list of files, cad)

Other CAD files:
Kicad/Old/Pico Programmer/GPIO Address Decode/Pico GPIO Address Decode.step
Kicad/Old/Pico Programmer/Pico Power/Pico Power.step
