andrewpaterson/HCP65/Documents/65020/Indexed Instructions.ods

Indexed Indirect Instruction | Operand | Notes
Opcode | 16bit address
 | +
 | 32bit Index Register | (A0-A3 or X0-X3)
 | =
 | 32bit indirect address
 | -> | (dereference)
 | 32bit effective address
Indexed Instruction | Operand | Notes
Opcode | 16bit or 32bit address
 | +
 | 32bit Index Register | (A0-A3, X0-X3, Y0-Y3, Z or SP)
 | =
 | 32bit effective address
Indirect Indexed Instruction | Operand | Notes
Opcode | 16bit address
 | -> | (dereference)
 | 32bit indirect address
 | +
 | 32bit Index Register | (Y0-Y3, Z, SP, PC, or 0)
 | =
 | 32bit effective address
