andrewpaterson/HCP65/Pictures/816BodgeBoardOperation.png

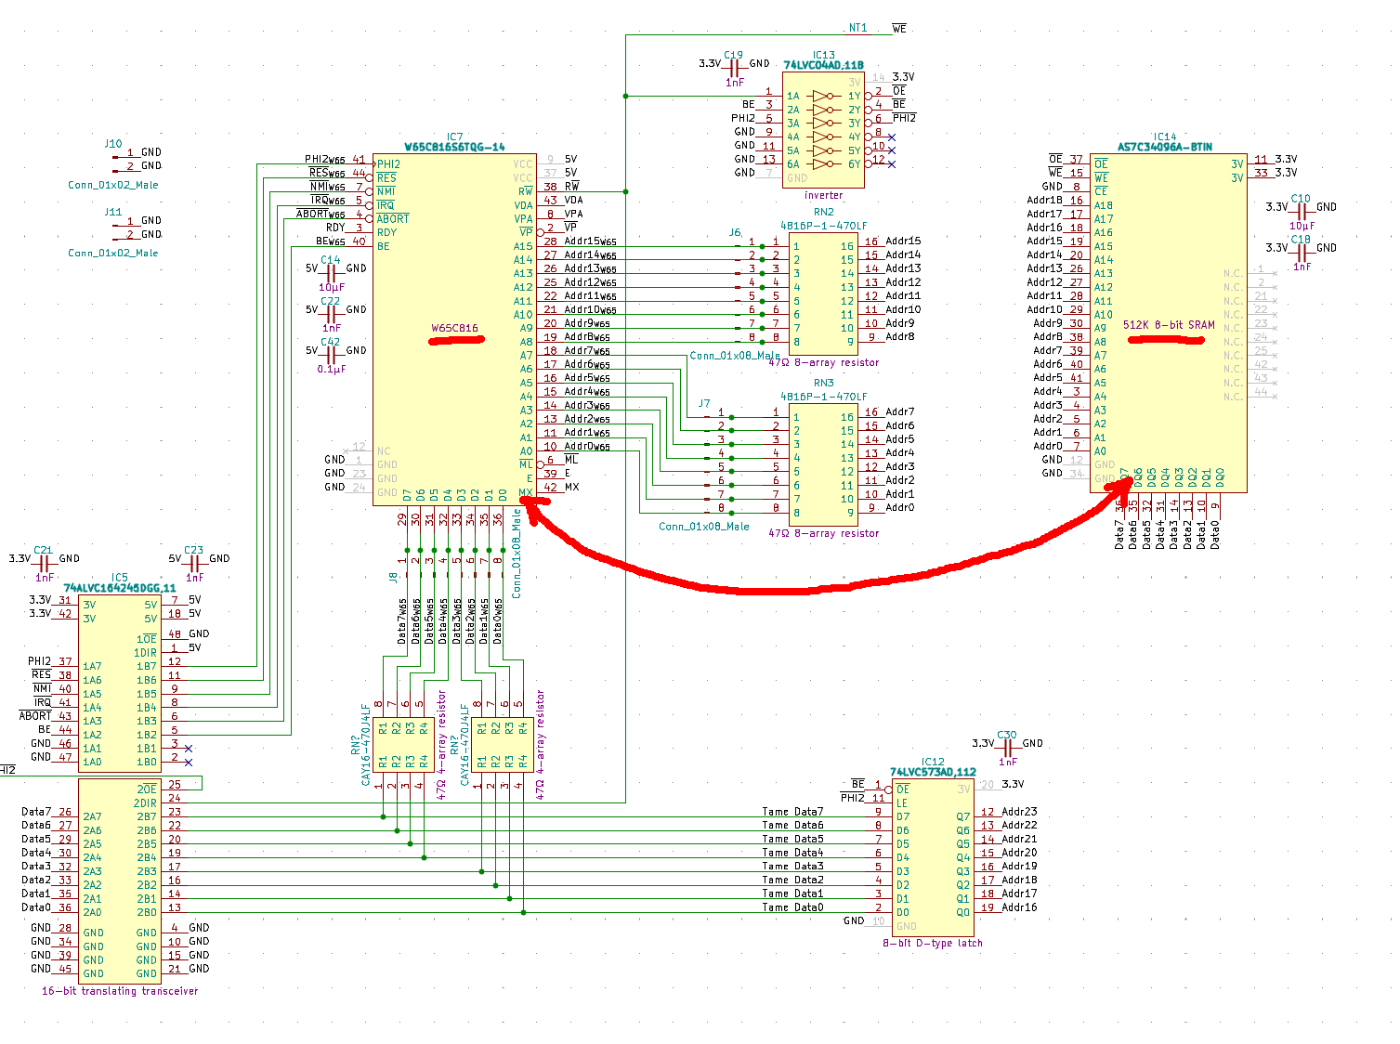
Pictures/816BodgeBoardOperation.png
