andrewpaterson/HCP65/Pictures/Calling Conventiion/Function Setup.png

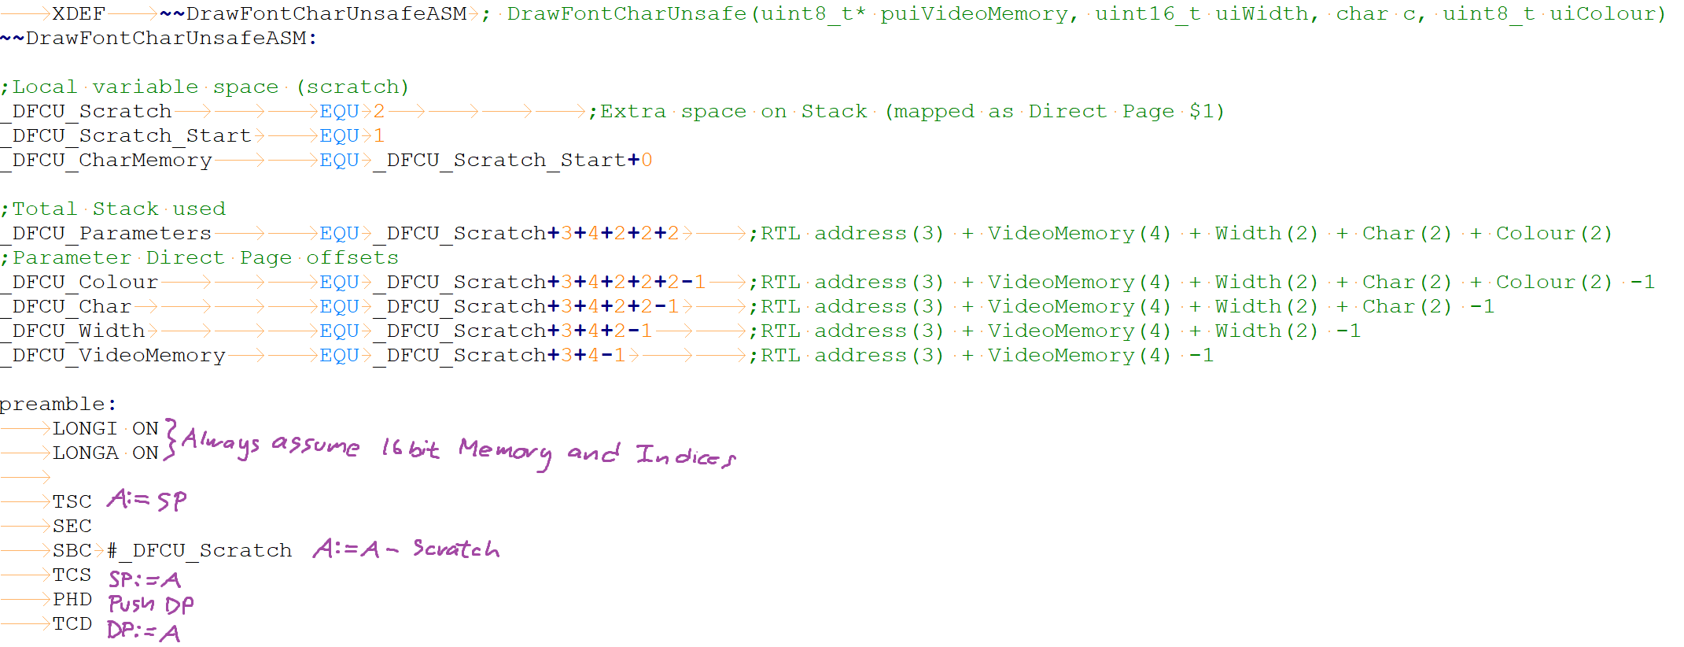
Pictures/Calling Conventiion/Function Setup.png
