andrewpaterson/HCP65/Pictures/Calling Conventiion/Function Stack after Setup.png

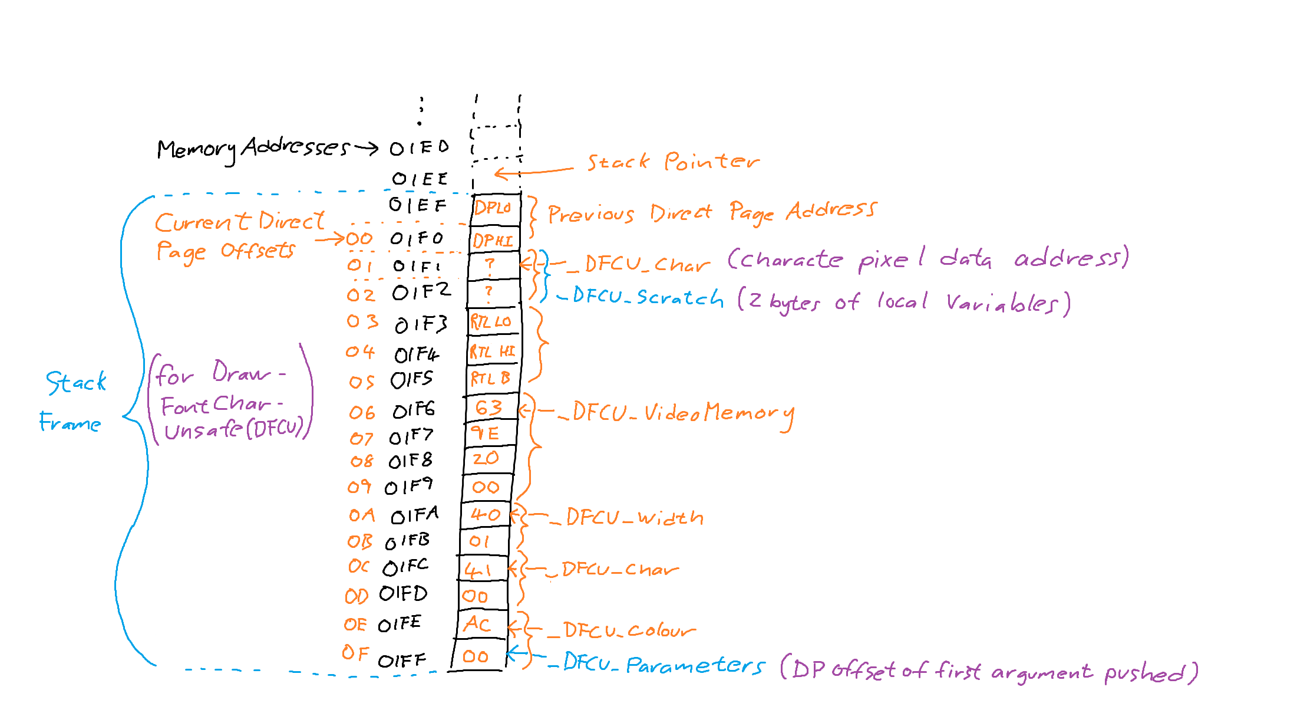
Pictures/Calling Conventiion/Function Stack after Setup.png
