andrewpaterson/HCP65/Pictures/Calling Conventiion/Function Stack before Setup.png

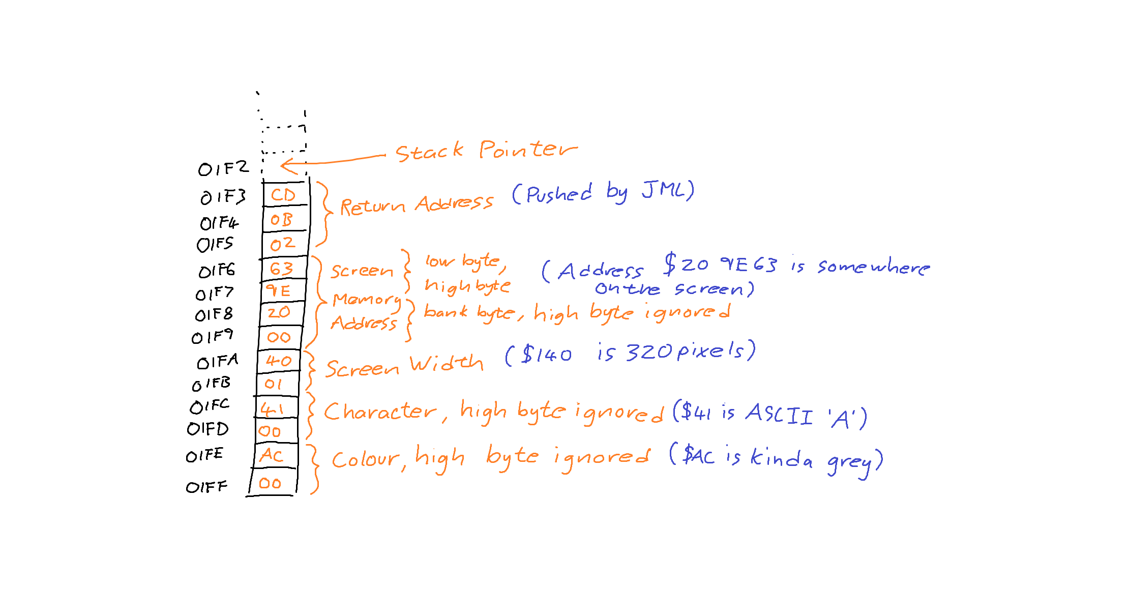
Pictures/Calling Conventiion/Function Stack before Setup.png
