andrewpaterson/HCP65/Pictures/Calling Conventiion/PEA Instruction.png

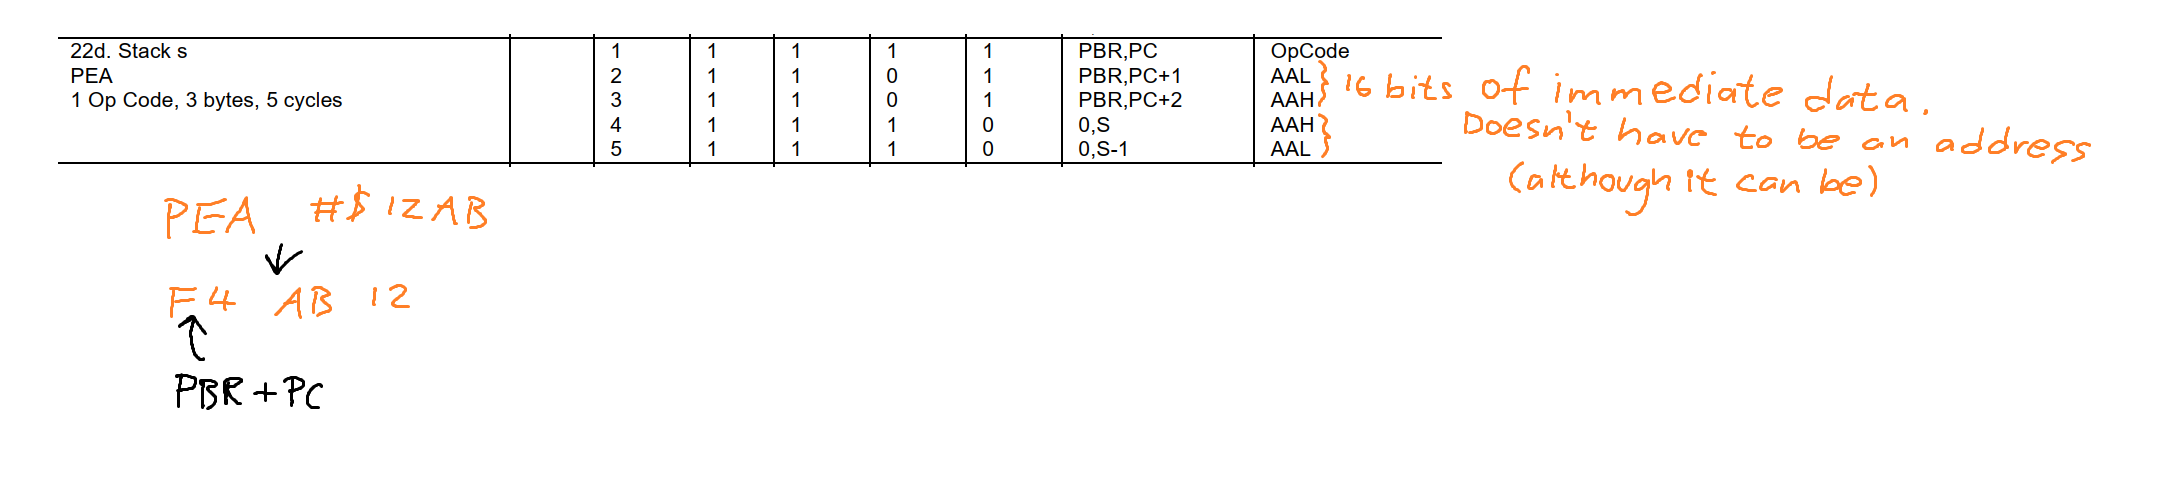
Pictures/Calling Conventiion/PEA Instruction.png
