andrewpaterson/HCP65/Pictures/Calling Conventiion/PEI Instruction.png

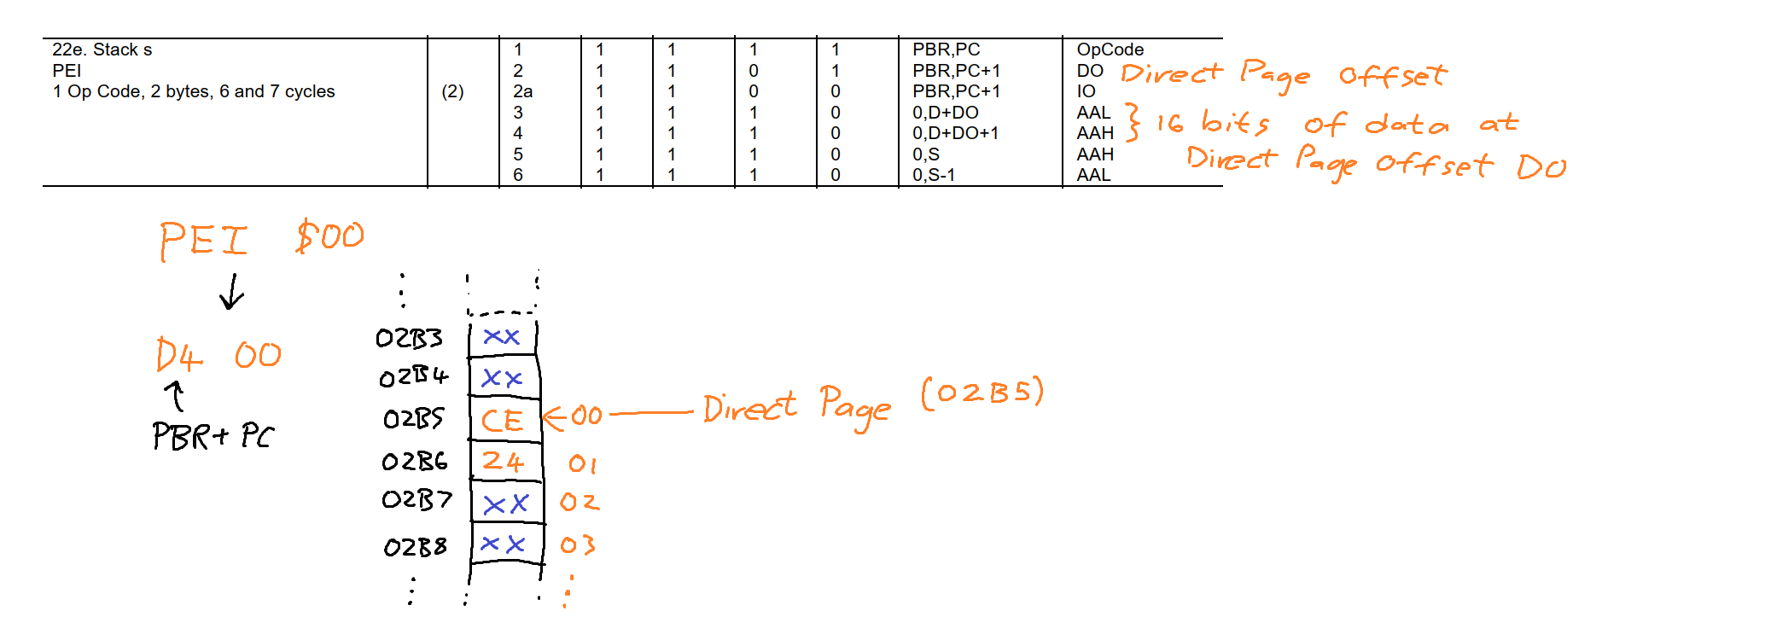
Pictures/Calling Conventiion/PEI Instruction.png
