andrewpaterson/HCP65/Pictures/Debug Display/Instruction Debug.png

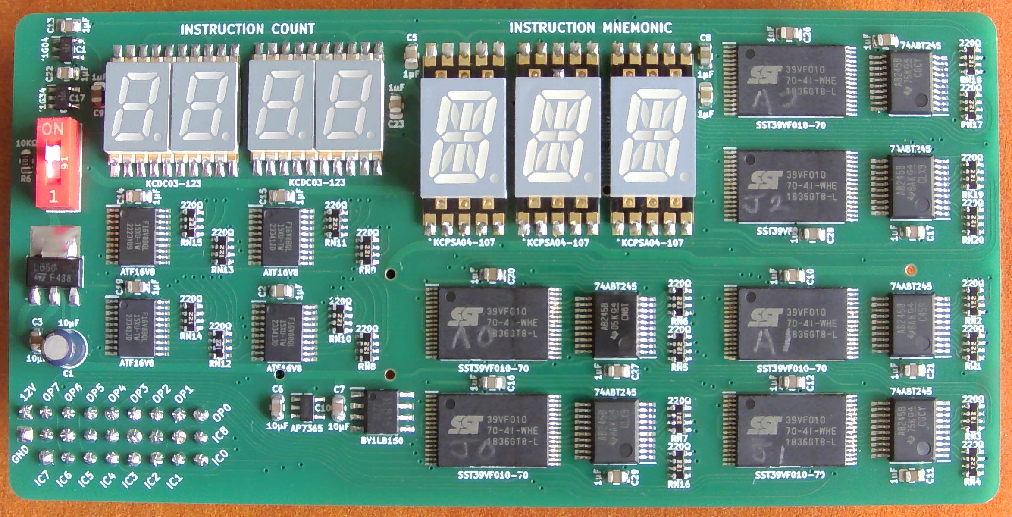
Pictures/Debug Display/Instruction Debug.png
