andrewpaterson/HCP65/W65C64/Instruction Set - sample.png

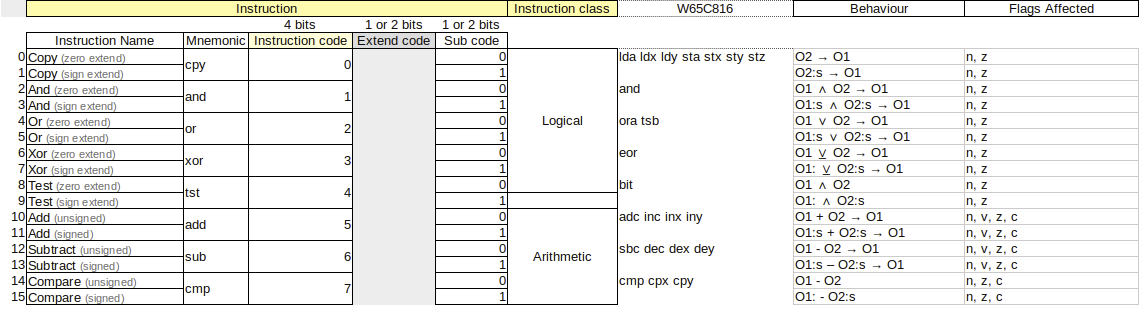
W65C64/Instruction Set - sample.png
