andrewpaterson/HCP65/W65C64/Instruction Set.png

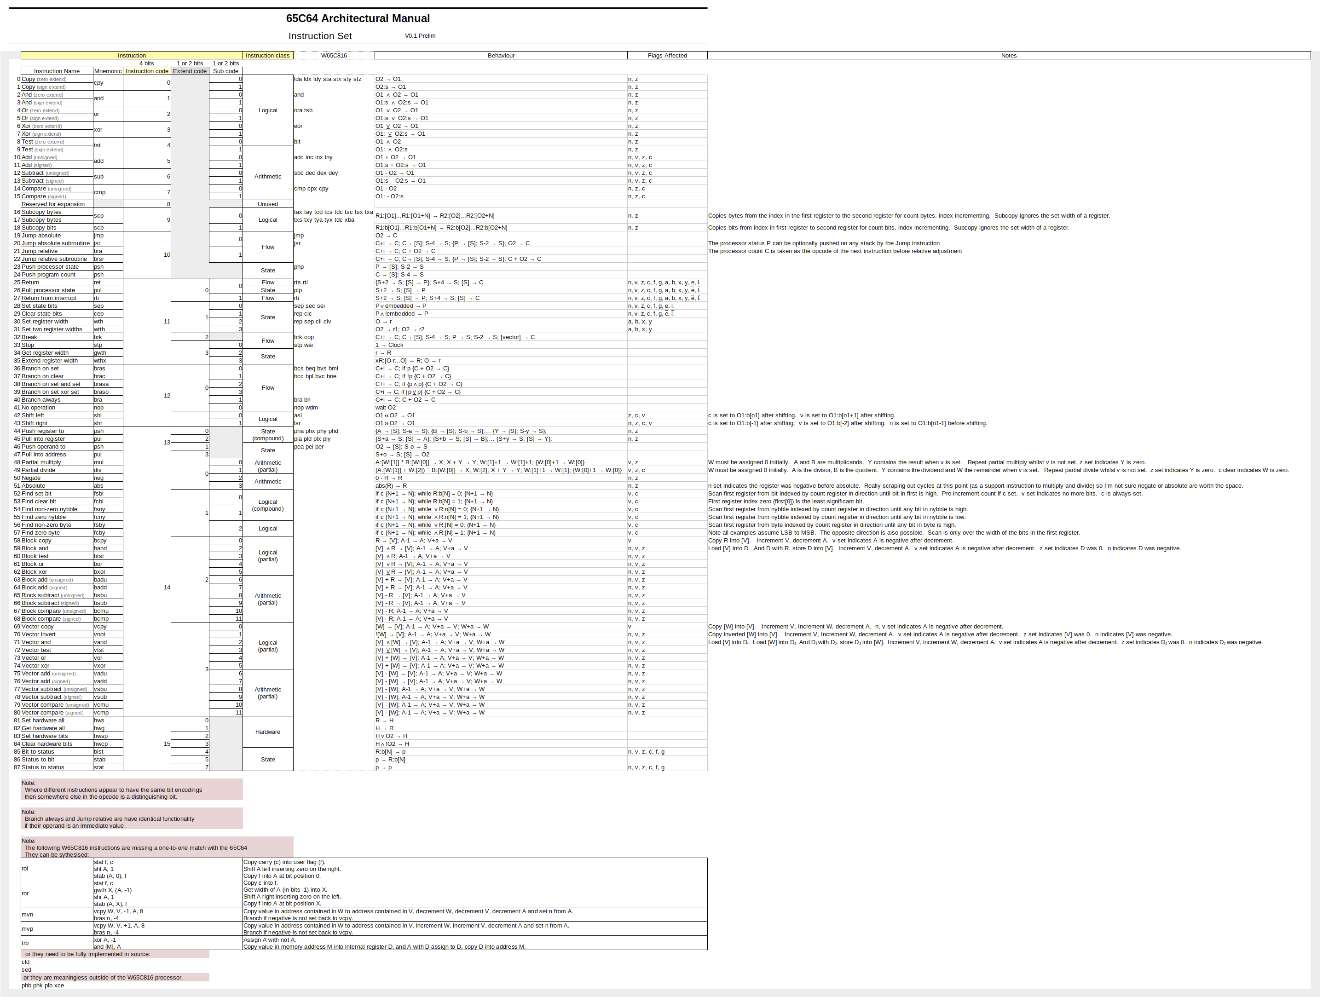
W65C64/Instruction Set.png
