andrewpaterson/HCP65/Pictures/Calling Conventiion/PEA Result.png

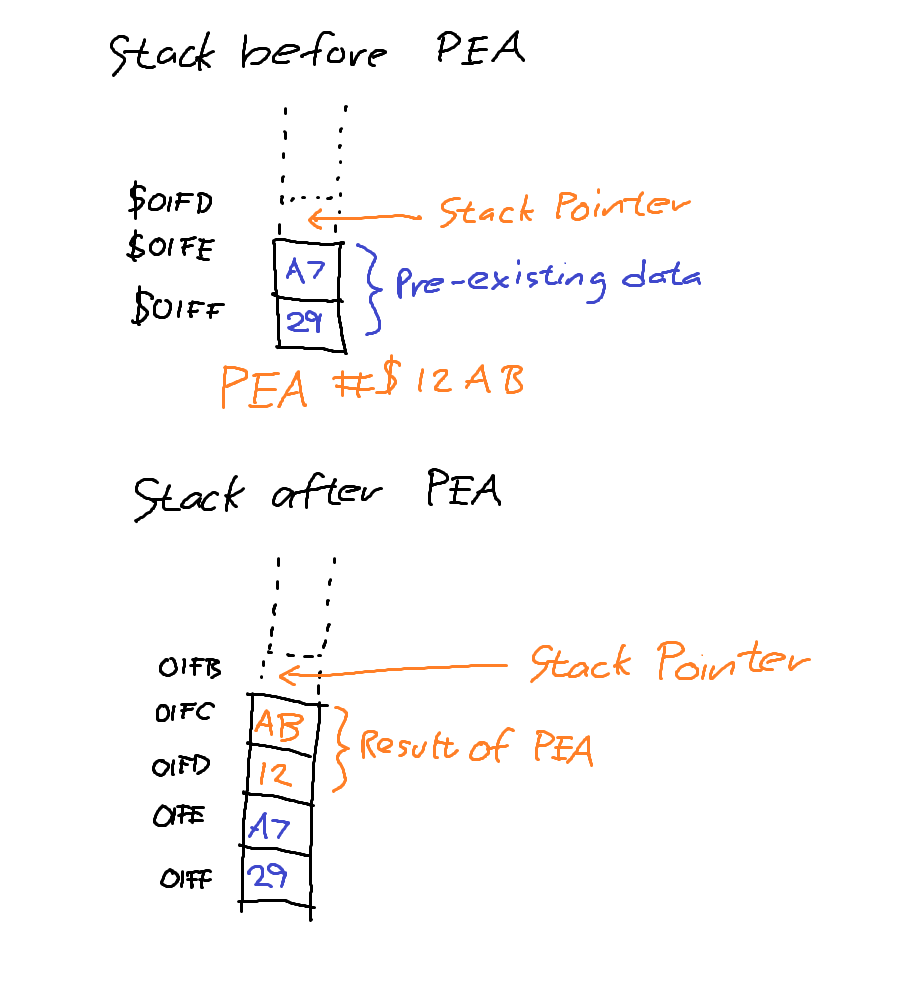
Pictures/Calling Conventiion/PEA Result.png
