andrewpaterson/HCP65/Pictures/Calling Conventiion/PEI Result.png

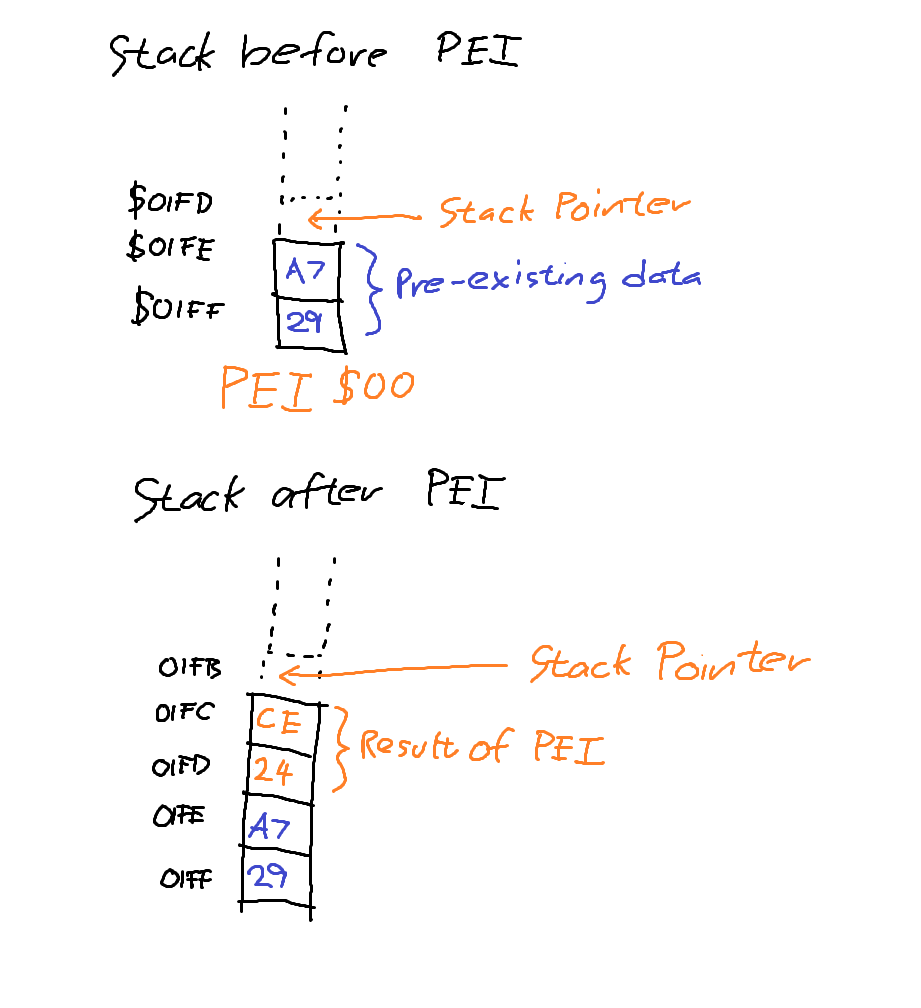
Pictures/Calling Conventiion/PEI Result.png
