andrewpaterson/HCP65/Pictures/HCP65 Tester.jpg

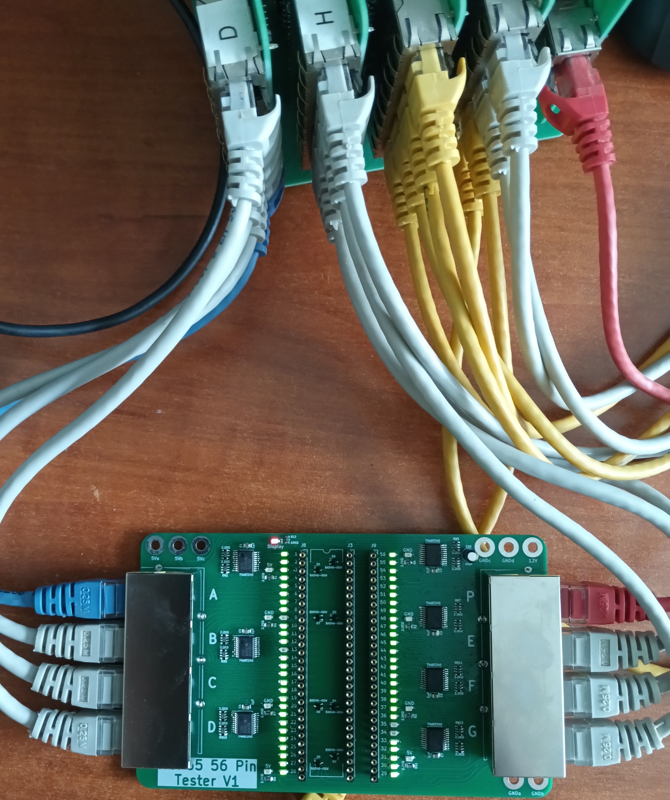
Pictures/HCP65 Tester.jpg
