andrewpaterson/HCP65/Pictures/Pico Tester.png

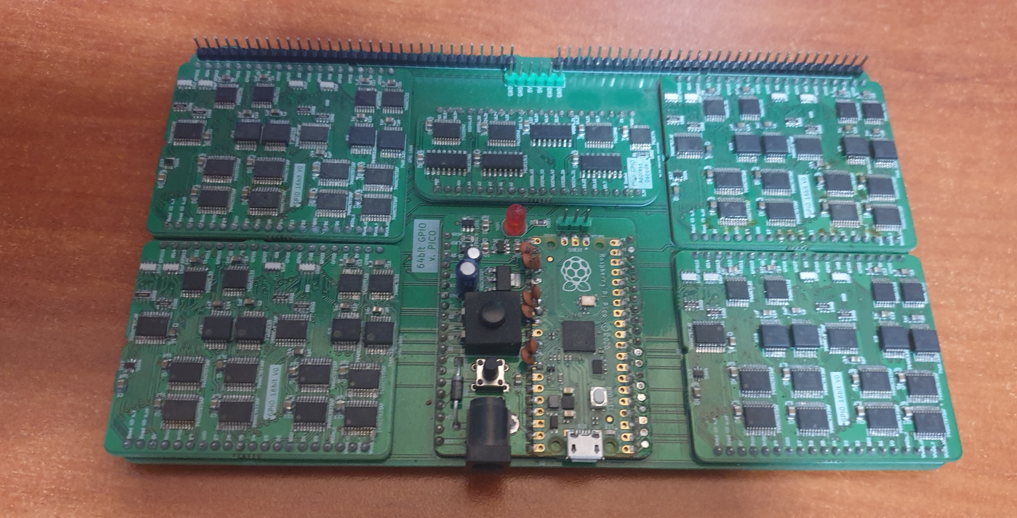
Pictures/Pico Tester.png
