andrewpaterson/HCP65/Pictures/Debug Display/Front Gerbers.png

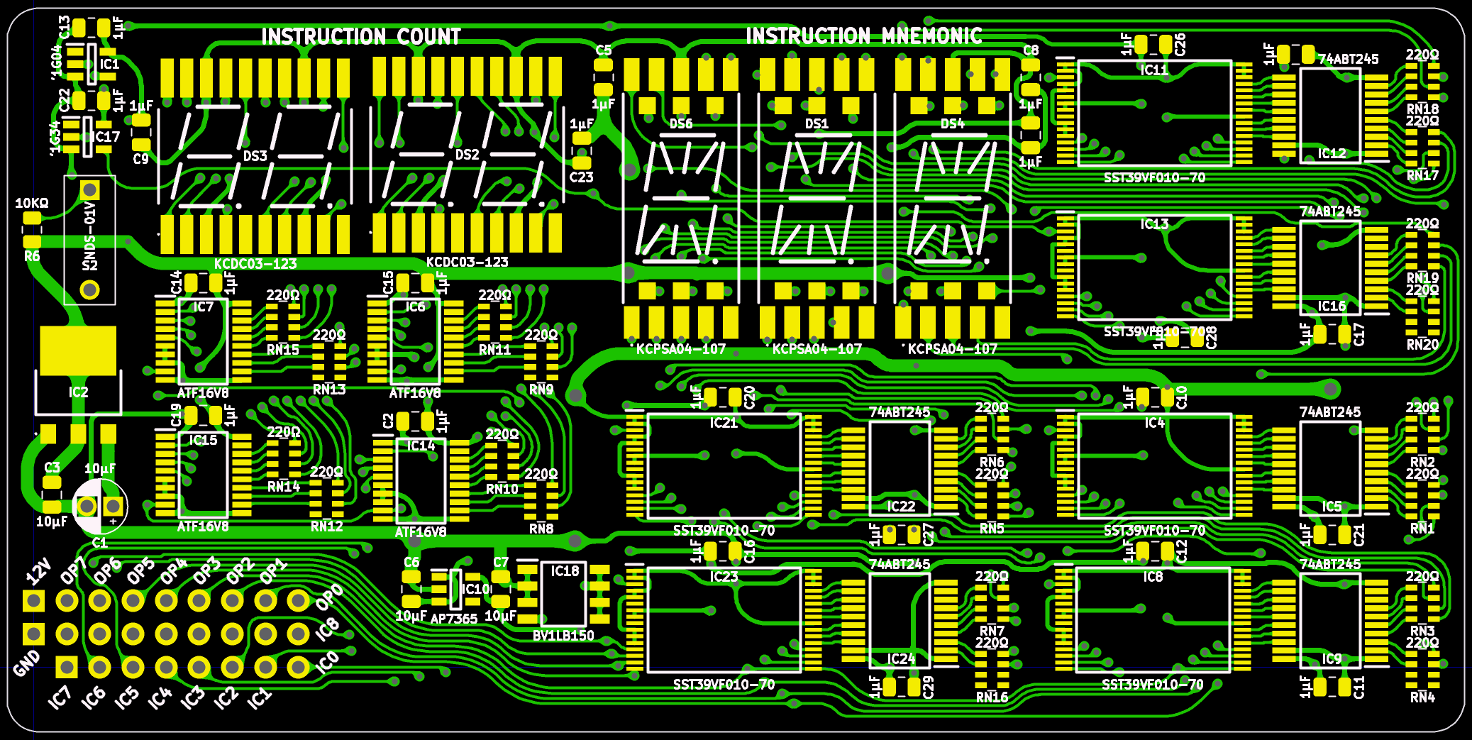
Pictures/Debug Display/Front Gerbers.png
