andrewpaterson/HCP65/Pictures/Debug Display/Signal Debug.png

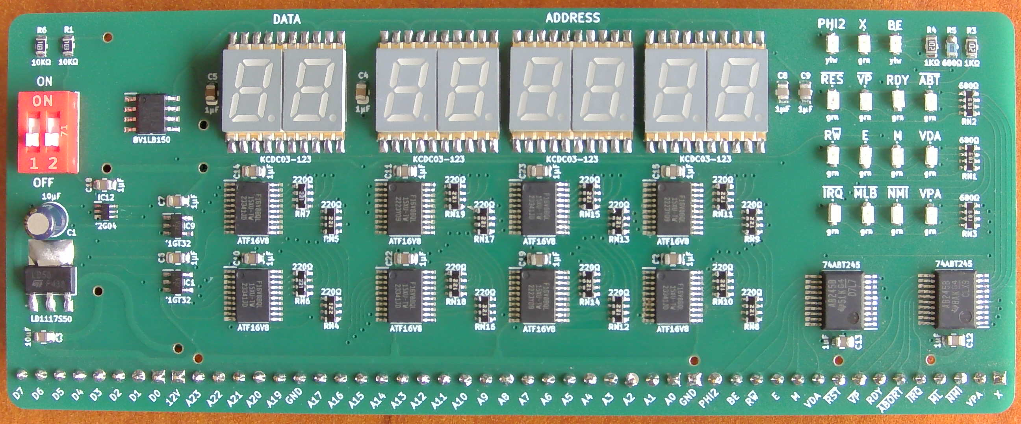
Pictures/Debug Display/Signal Debug.png
