andrewpaterson/HCP65/Kicad/Computer/Main/Mainboard Small/Mainboard Small.kicad_pcb

## KiCad design Kicad/Computer/Main/Mainboard Small/Mainboard Small.kicad_pcb (2026-11-08)

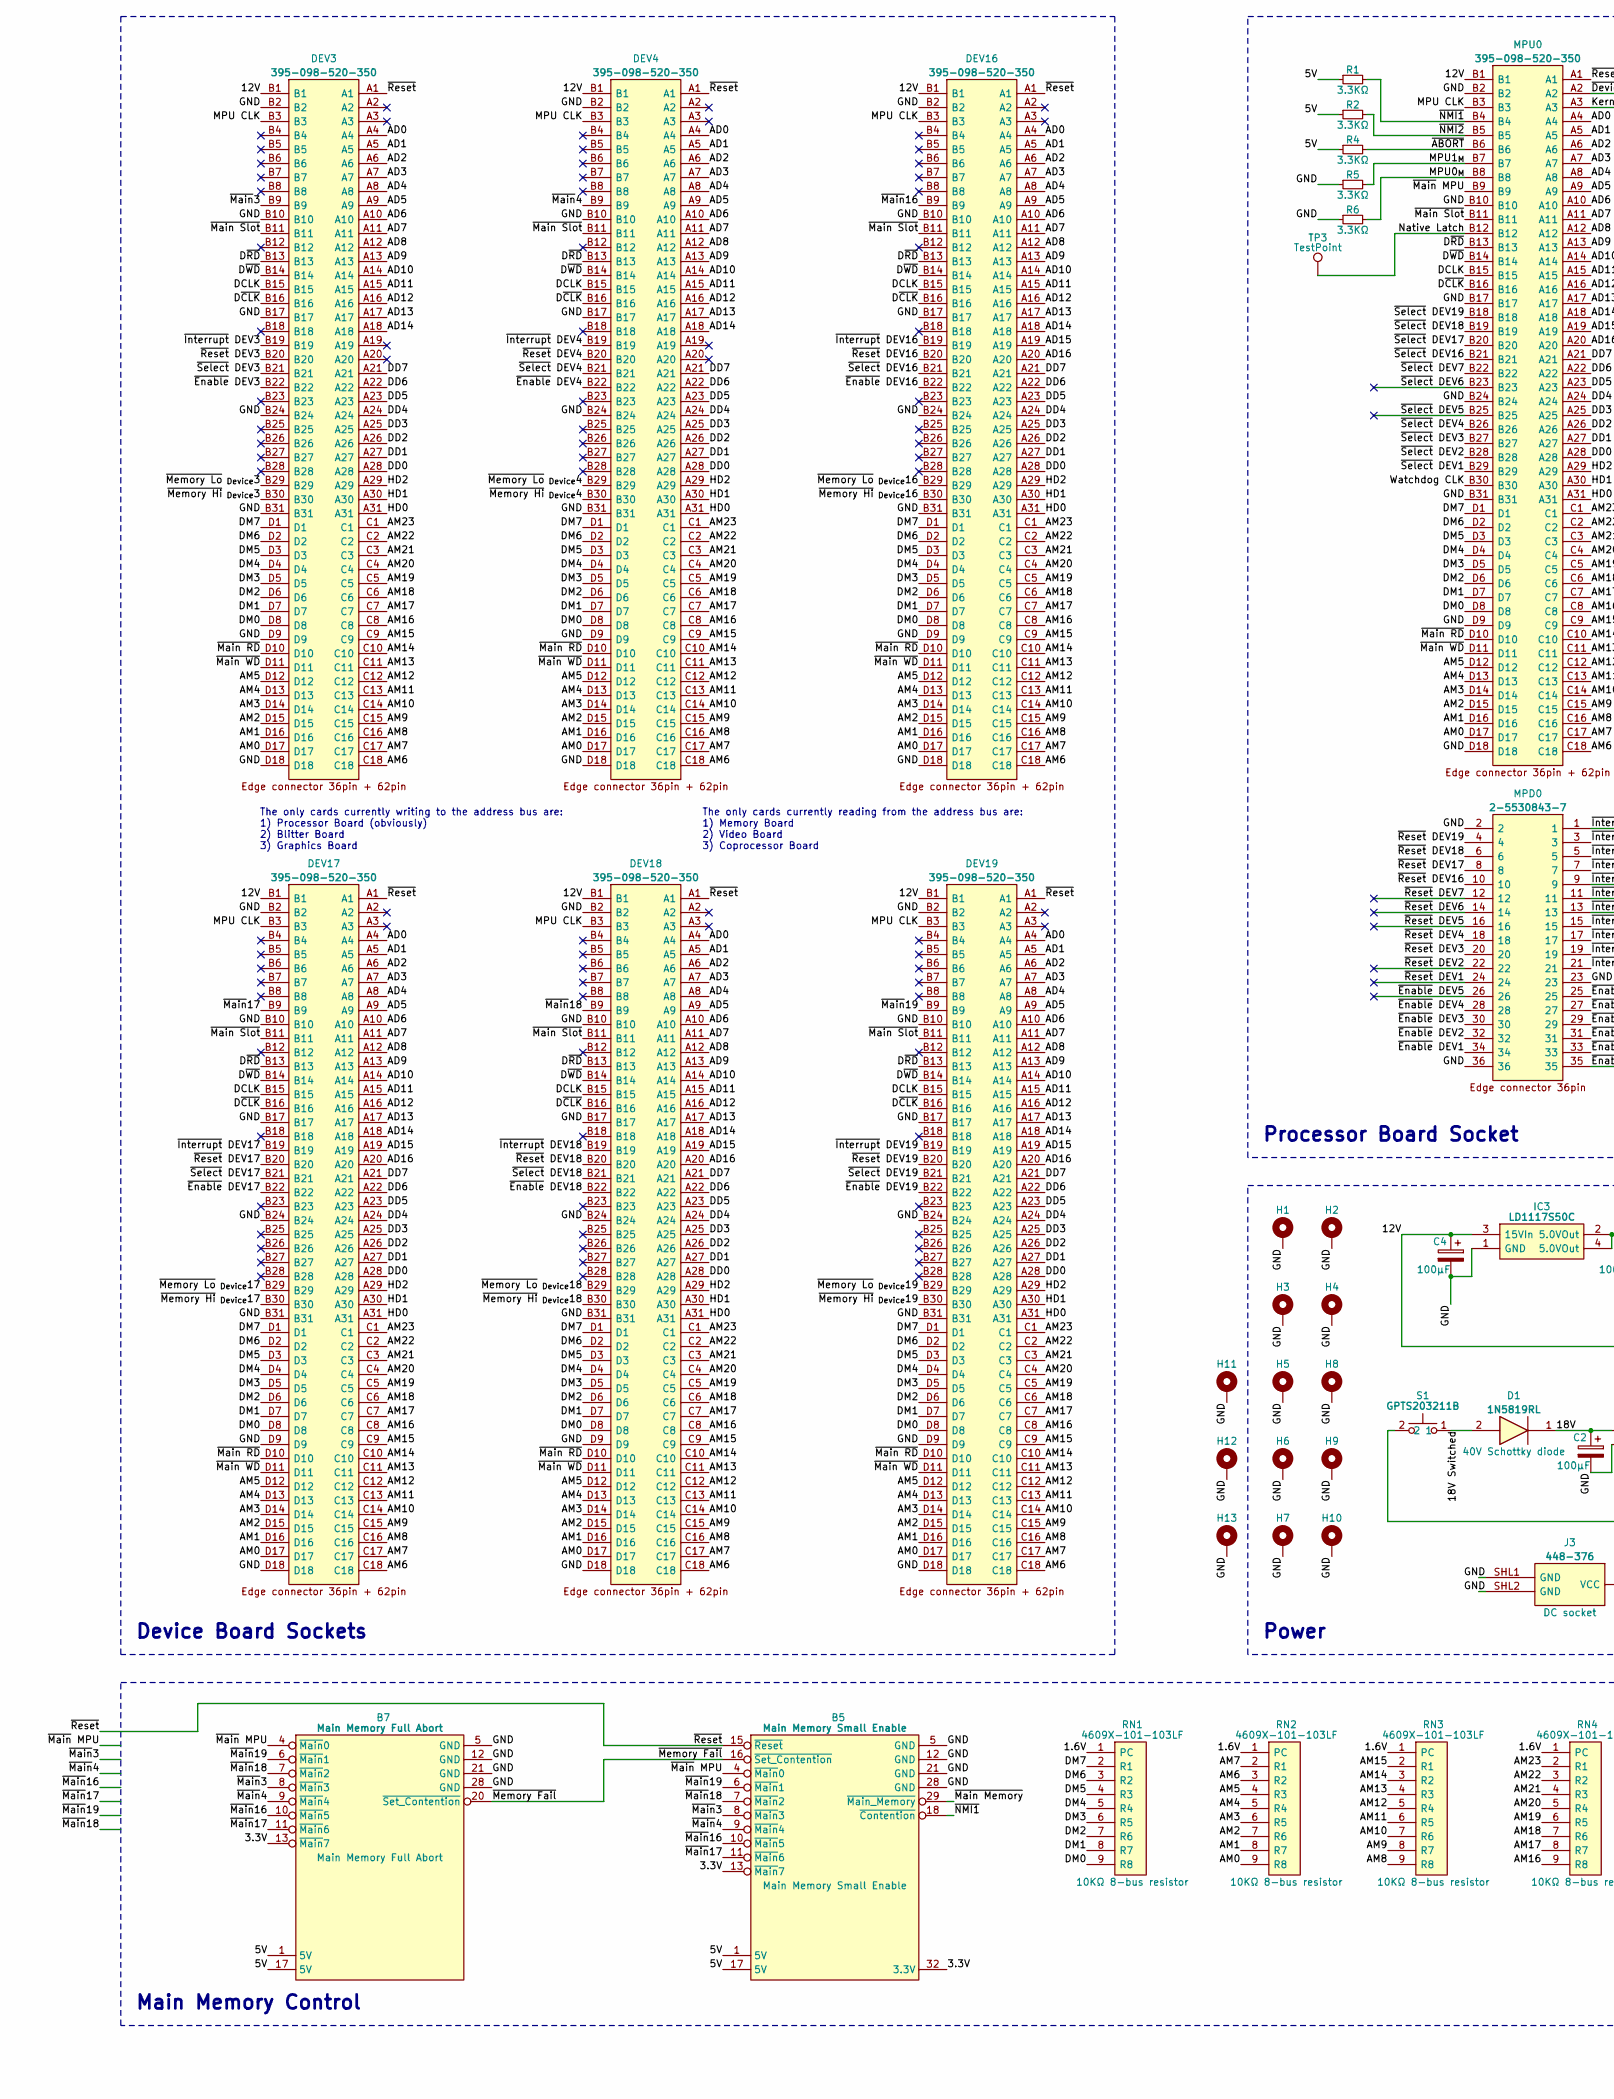
[picture p173: schematic Mainboard Small.kicad_sch, HCP65 Small Mainboard, part in row 1, column 1]

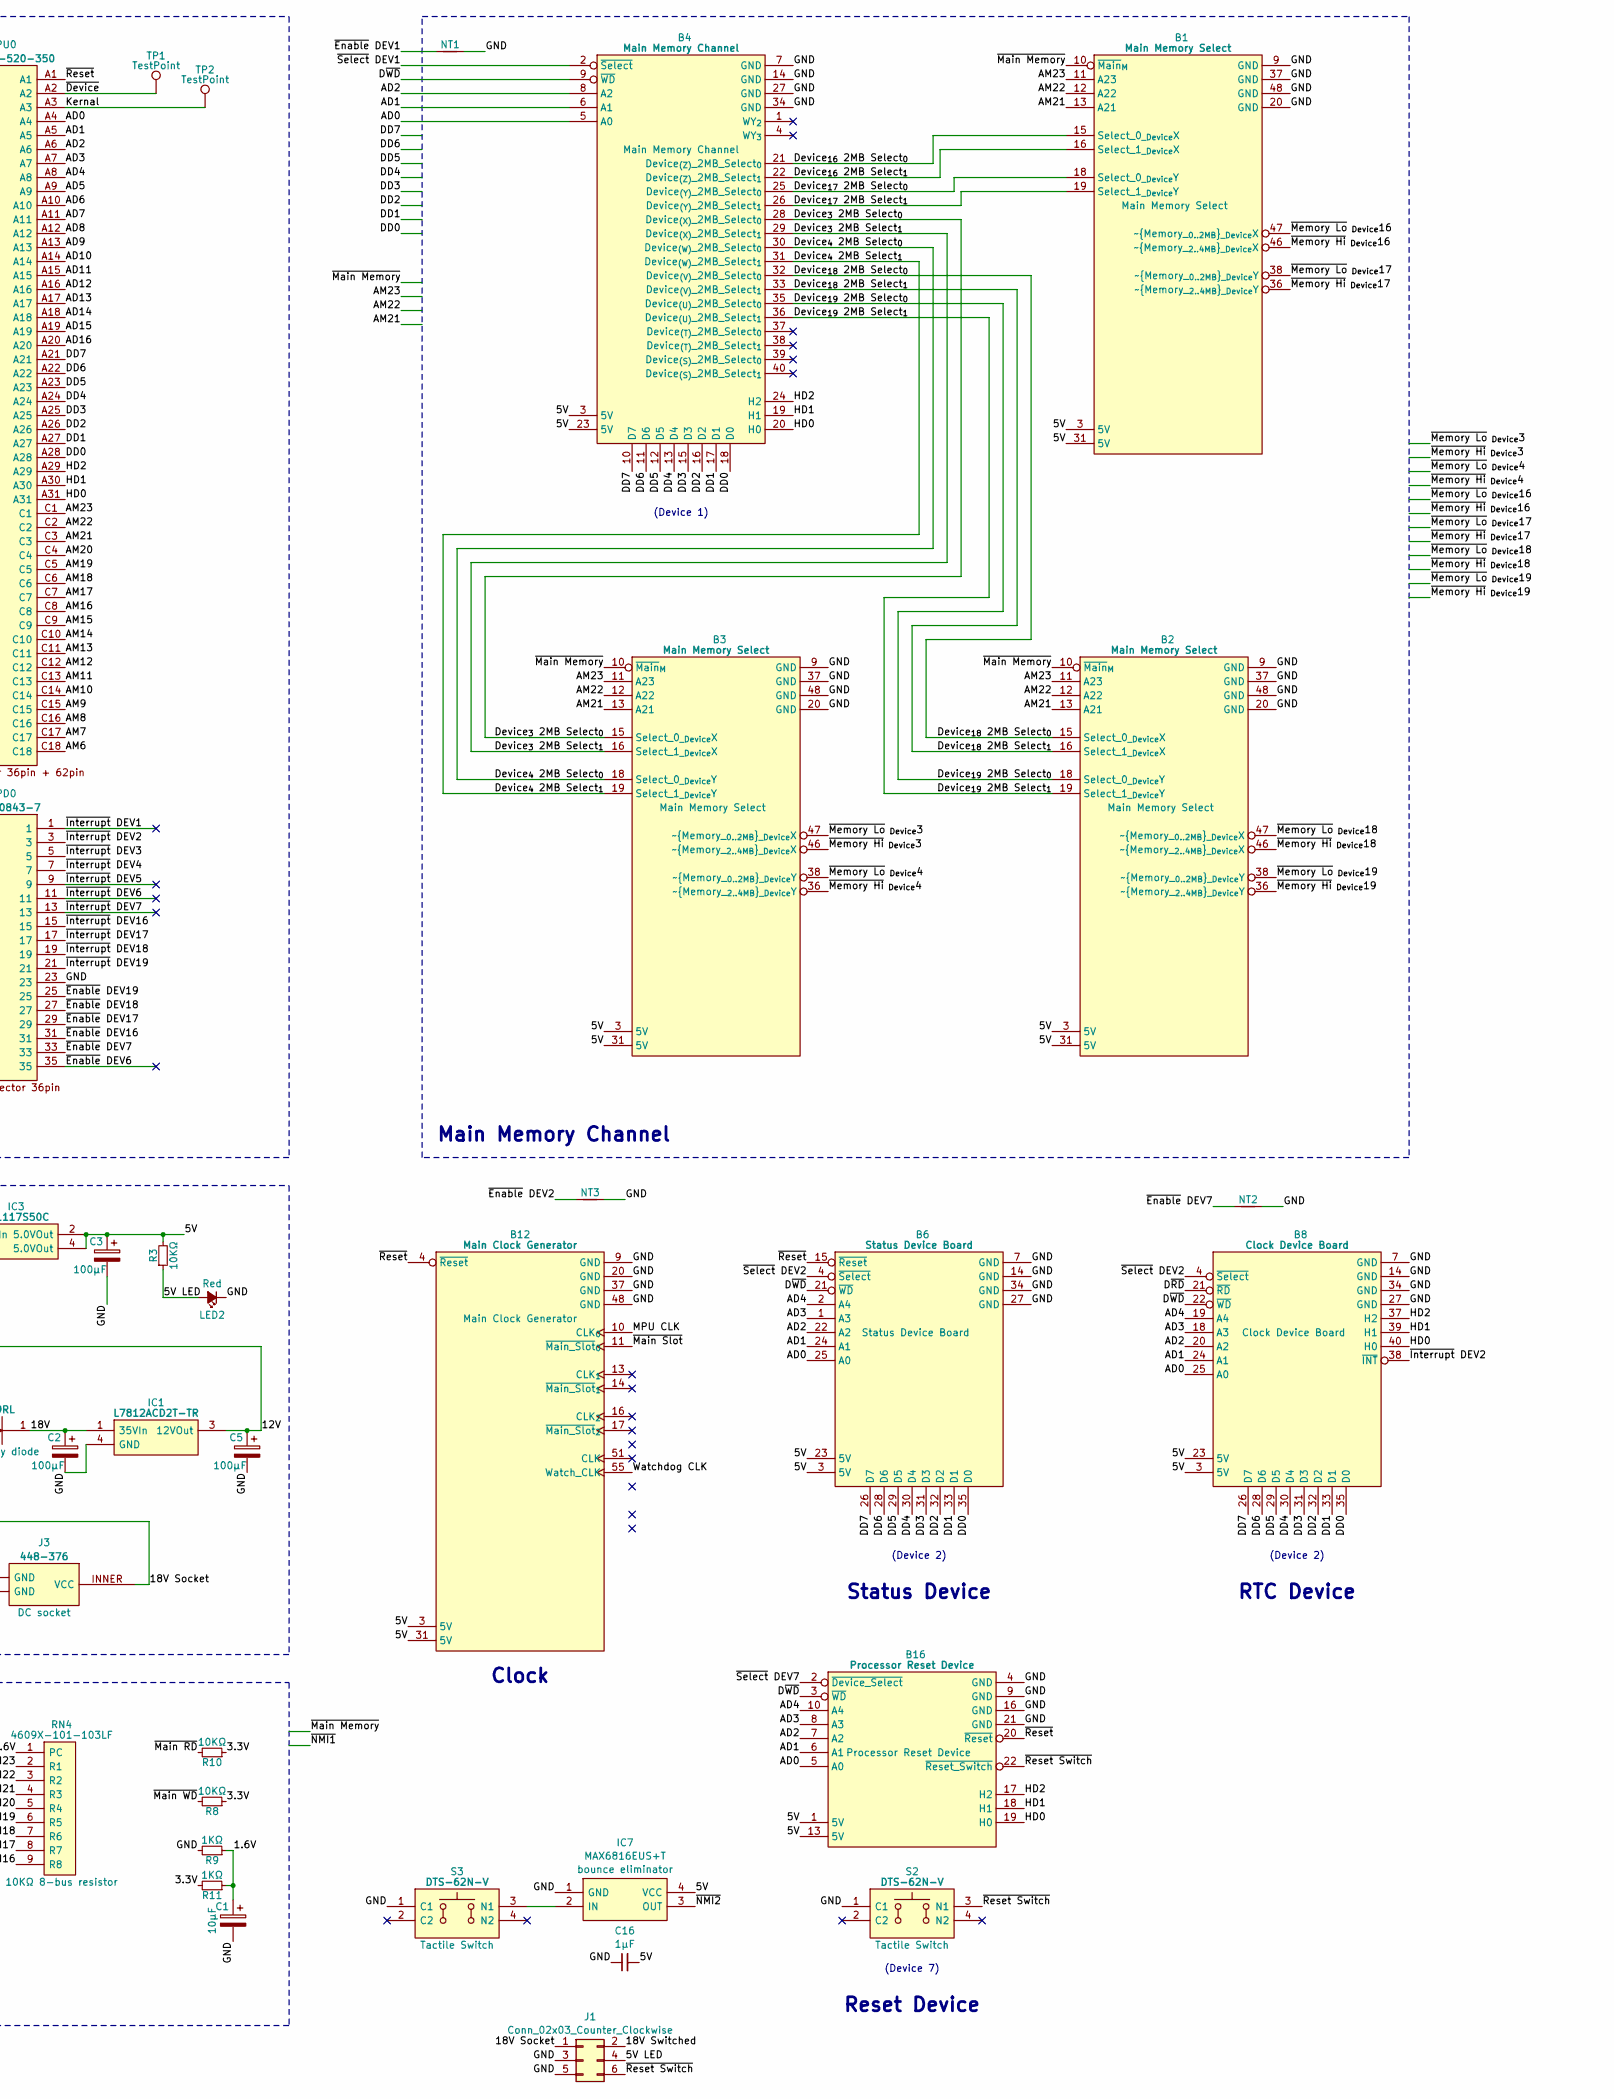
[picture p174: schematic Mainboard Small.kicad_sch, HCP65 Small Mainboard, part in row 1, column 2]

Parts:
B1, B2, B3: Main Memory Select; HCP65_Main_Memory_Select
B4: Main Memory Channel; HCP65_Main_Memory_Channel
B5: Main Memory Small Enable; HCP65_Main_Memory_Small_Enable
B6: Status Device Board; HCP65_Status_Device_Board
B7: Main Memory Full Abort; HCP65_Main_Memory_Full_Abort
B8: Clock Device Board; HCP65_Clock_Device_Board
B12: Main Clock Generator; HCP65_Clock_Generator
B16: Processor Reset Device; HCP65_Processor_Reset_Device
C1: 10μF; CP_Radial_D4.0mm_P2.00mm
C2, C3, C4, C5: 100μF; CP_Radial_D6.3mm_P2.50mm
C16: 1μF; C_0805
D1: 1N5819RL; DIOAD1414W86L464D238; Manufacturer_Part_Number 1N5819RL; Mouser Part Number 511-1N5819-TR
DEV3, DEV4, DEV16, DEV17, DEV18, DEV19: 395-098-520-350; 395098520350; Manufacturer_Part_Number 395-098-520-350; Mouser Part Number 587-395-098-520-350
H1, H2, H3, H4, H5, H6, H7, H8, H9, H10, H11, H12, H13: MountingHole_Pad; HCP65_MountingHole_M3_
IC1: L7812ACD2T-TR; TO254P1542X460-3N; Manufacturer_Part_Number L7812ACD2T-TR
IC3: LD1117S50C; LD1117S33C; Manufacturer_Part_Number LD1117S50C
IC7: MAX6816EUS+T; MAX812REUST; Manufacturer_Part_Number MAX6816EUS+T; Mouser Part Number 700-MAX6816EUST
J1: Conn_02x03_Counter_Clockwise; PinHeader_2x03_P2.54mm_Vertical
J3: 448-376; 448376; Manufacturer_Part_Number 448-376
LED2: Red; LED_D5.0mm
MPD0: 2-5530843-7; 255308437; Manufacturer_Part_Number 2-5530843-7; Mouser Part Number 571-2-5530843-7
MPU0: 395-098-520-350; 395098520350; Manufacturer_Part_Number 395-098-520-350; Mouser Part Number 587-395-098-520-350
NT1, NT2, NT3: NetTie; NetTie-2_SMD_Pad0.5mm
R1, R2, R4, R5, R6: 3.3KΩ; R_0805
R3, R8, R10: 10KΩ; R_0805
R9, R11: 1KΩ; R_0805
RN1, RN2, RN3, RN4: 4609X-101-103LF; 4609X
S1: GPTS203211B; Manufacturer_Part_Number GPTS203211B; Mouser Part Number 629-GPTS203211B
S2, S3: DTS-62N-V; DTS62NV; Manufacturer_Part_Number DTS-62N-V; Mouser Part Number 113-DTS-62N-V
TP1, TP2, TP3: TestPoint; TestPoint_THTPad_2.0x2.0mm_Drill1.0mm

Connections:
/1.6V: C1.1, R9.1, R11.1, RN1.1 (PC), RN2.1 (PC), RN3.1 (PC), RN4.1 (PC)
/3.3V: B5.13 (~Main7), B5.32 (3.3V), B7.13 (~Main7), R8.1, R10.1, R11.2
/5V: B1.3 (5V), B1.31 (5V), B2.3 (5V), B2.31 (5V), B3.3 (5V), B3.31 (5V), B4.3 (5V), B4.23 (5V), B5.1 (5V), B5.17 (5V), B6.3 (5V), B6.23 (5V), B7.1 (5V), B7.17 (5V), B8.3 (5V), B8.23 (5V), B12.3 (5V), B12.31 (5V), B16.1 (5V), B16.13 (5V), C3.1, C16.2, IC3.2 (5.0VOut), IC3.4 (5.0VOut), IC7.4 (VCC), R1.1, R2.1, R3.2, R4.1
/5V LED: J1.4, LED2.2 (A), R3.1
/12V: C4.1, C5.1, DEV3.B1, DEV4.B1, DEV16.B1, DEV17.B1, DEV18.B1, DEV19.B1, IC1.3 (12VOut), IC3.3 (15VIn), MPU0.B1
/18V: C2.1, D1.1, IC1.1 (35VIn)
/18V Socket: J1.1, J3.INNER (VCC), S1.2
/18V Switched: D1.2, J1.2, S1.1
/AD0: B4.5 (A0), B6.25 (A0), B8.25 (A0), B16.5 (A0), DEV3.A4, DEV4.A4, DEV16.A4, DEV17.A4, DEV18.A4, DEV19.A4, MPU0.A4
/AD1: B4.6 (A1), B6.24 (A1), B8.24 (A1), B16.6 (A1), DEV3.A5, DEV4.A5, DEV16.A5, DEV17.A5, DEV18.A5, DEV19.A5, MPU0.A5
/AD2: B4.8 (A2), B6.22 (A2), B8.20 (A2), B16.7 (A2), DEV3.A6, DEV4.A6, DEV16.A6, DEV17.A6, DEV18.A6, DEV19.A6, MPU0.A6
/AD3: B6.1 (A3), B8.18 (A3), B16.8 (A3), DEV3.A7, DEV4.A7, DEV16.A7, DEV17.A7, DEV18.A7, DEV19.A7, MPU0.A7
/AD4: B6.2 (A4), B8.19 (A4), B16.10 (A4), DEV3.A8, DEV4.A8, DEV16.A8, DEV17.A8, DEV18.A8, DEV19.A8, MPU0.A8
/AD5: DEV3.A9, DEV4.A9, DEV16.A9, DEV17.A9, DEV18.A9, DEV19.A9, MPU0.A9
/AD6: DEV3.A10, DEV4.A10, DEV16.A10, DEV17.A10, DEV18.A10, DEV19.A10, MPU0.A10
/AD7: DEV3.A11, DEV4.A11, DEV16.A11, DEV17.A11, DEV18.A11, DEV19.A11, MPU0.A11
/AD8: DEV3.A12, DEV4.A12, DEV16.A12, DEV17.A12, DEV18.A12, DEV19.A12, MPU0.A12
/AD9: DEV3.A13, DEV4.A13, DEV16.A13, DEV17.A13, DEV18.A13, DEV19.A13, MPU0.A13
/AD10: DEV3.A14, DEV4.A14, DEV16.A14, DEV17.A14, DEV18.A14, DEV19.A14, MPU0.A14
/AD11: DEV3.A15, DEV4.A15, DEV16.A15, DEV17.A15, DEV18.A15, DEV19.A15, MPU0.A15
/AD12: DEV3.A16, DEV4.A16, DEV16.A16, DEV17.A16, DEV18.A16, DEV19.A16, MPU0.A16
/AD13: DEV3.A17, DEV4.A17, DEV16.A17, DEV17.A17, DEV18.A17, DEV19.A17, MPU0.A17
/AD14: DEV3.A18, DEV4.A18, DEV16.A18, DEV17.A18, DEV18.A18, DEV19.A18, MPU0.A18
/AD15: DEV16.A19, DEV17.A19, DEV18.A19, DEV19.A19, MPU0.A19
/AD16: DEV16.A20, DEV17.A20, DEV18.A20, DEV19.A20, MPU0.A20
/AM0: DEV3.D17, DEV4.D17, DEV16.D17, DEV17.D17, DEV18.D17, DEV19.D17, MPU0.D17, RN2.9 (R8)
/AM1: DEV3.D16, DEV4.D16, DEV16.D16, DEV17.D16, DEV18.D16, DEV19.D16, MPU0.D16, RN2.8 (R7)
/AM2: DEV3.D15, DEV4.D15, DEV16.D15, DEV17.D15, DEV18.D15, DEV19.D15, MPU0.D15, RN2.7 (R6)
/AM3: DEV3.D14, DEV4.D14, DEV16.D14, DEV17.D14, DEV18.D14, DEV19.D14, MPU0.D14, RN2.6 (R5)
/AM4: DEV3.D13, DEV4.D13, DEV16.D13, DEV17.D13, DEV18.D13, DEV19.D13, MPU0.D13, RN2.5 (R4)
/AM5: DEV3.D12, DEV4.D12, DEV16.D12, DEV17.D12, DEV18.D12, DEV19.D12, MPU0.D12, RN2.4 (R3)
/AM6: DEV3.C18, DEV4.C18, DEV16.C18, DEV17.C18, DEV18.C18, DEV19.C18, MPU0.C18, RN2.3 (R2)
/AM7: DEV3.C17, DEV4.C17, DEV16.C17, DEV17.C17, DEV18.C17, DEV19.C17, MPU0.C17, RN2.2 (R1)
/AM8: DEV3.C16, DEV4.C16, DEV16.C16, DEV17.C16, DEV18.C16, DEV19.C16, MPU0.C16, RN3.9 (R8)
/AM9: DEV3.C15, DEV4.C15, DEV16.C15, DEV17.C15, DEV18.C15, DEV19.C15, MPU0.C15, RN3.8 (R7)
/AM10: DEV3.C14, DEV4.C14, DEV16.C14, DEV17.C14, DEV18.C14, DEV19.C14, MPU0.C14, RN3.7 (R6)
/AM11: DEV3.C13, DEV4.C13, DEV16.C13, DEV17.C13, DEV18.C13, DEV19.C13, MPU0.C13, RN3.6 (R5)
/AM12: DEV3.C12, DEV4.C12, DEV16.C12, DEV17.C12, DEV18.C12, DEV19.C12, MPU0.C12, RN3.5 (R4)
/AM13: DEV3.C11, DEV4.C11, DEV16.C11, DEV17.C11, DEV18.C11, DEV19.C11, MPU0.C11, RN3.4 (R3)
/AM14: DEV3.C10, DEV4.C10, DEV16.C10, DEV17.C10, DEV18.C10, DEV19.C10, MPU0.C10, RN3.3 (R2)
/AM15: DEV3.C9, DEV4.C9, DEV16.C9, DEV17.C9, DEV18.C9, DEV19.C9, MPU0.C9, RN3.2 (R1)
/AM16: DEV3.C8, DEV4.C8, DEV16.C8, DEV17.C8, DEV18.C8, DEV19.C8, MPU0.C8, RN4.9 (R8)
/AM17: DEV3.C7, DEV4.C7, DEV16.C7, DEV17.C7, DEV18.C7, DEV19.C7, MPU0.C7, RN4.8 (R7)
/AM18: DEV3.C6, DEV4.C6, DEV16.C6, DEV17.C6, DEV18.C6, DEV19.C6, MPU0.C6, RN4.7 (R6)
/AM19: DEV3.C5, DEV4.C5, DEV16.C5, DEV17.C5, DEV18.C5, DEV19.C5, MPU0.C5, RN4.6 (R5)
/AM20: DEV3.C4, DEV4.C4, DEV16.C4, DEV17.C4, DEV18.C4, DEV19.C4, MPU0.C4, RN4.5 (R4)
/AM21: B1.13 (A21), B2.13 (A21), B3.13 (A21), DEV3.C3, DEV4.C3, DEV16.C3, DEV17.C3, DEV18.C3, DEV19.C3, MPU0.C3, RN4.4 (R3)
/AM22: B1.12 (A22), B2.12 (A22), B3.12 (A22), DEV3.C2, DEV4.C2, DEV16.C2, DEV17.C2, DEV18.C2, DEV19.C2, MPU0.C2, RN4.3 (R2)
/AM23: B1.11 (A23), B2.11 (A23), B3.11 (A23), DEV3.C1, DEV4.C1, DEV16.C1, DEV17.C1, DEV18.C1, DEV19.C1, MPU0.C1, RN4.2 (R1)
/DCLK: DEV3.B15, DEV4.B15, DEV16.B15, DEV17.B15, DEV18.B15, DEV19.B15, MPU0.B15
/DD0: B4.18 (D0), B6.35 (D0), B8.35 (D0), DEV3.A28, DEV4.A28, DEV16.A28, DEV17.A28, DEV18.A28, DEV19.A28, MPU0.A28
/DD1: B4.17 (D1), B6.33 (D1), B8.33 (D1), DEV3.A27, DEV4.A27, DEV16.A27, DEV17.A27, DEV18.A27, DEV19.A27, MPU0.A27
/DD2: B4.16 (D2), B6.32 (D2), B8.32 (D2), DEV3.A26, DEV4.A26, DEV16.A26, DEV17.A26, DEV18.A26, DEV19.A26, MPU0.A26
/DD3: B4.15 (D3), B6.31 (D3), B8.31 (D3), DEV3.A25, DEV4.A25, DEV16.A25, DEV17.A25, DEV18.A25, DEV19.A25, MPU0.A25
/DD4: B4.13 (D4), B6.30 (D4), B8.30 (D4), DEV3.A24, DEV4.A24, DEV16.A24, DEV17.A24, DEV18.A24, DEV19.A24, MPU0.A24
/DD5: B4.12 (D5), B6.29 (D5), B8.29 (D5), DEV3.A23, DEV4.A23, DEV16.A23, DEV17.A23, DEV18.A23, DEV19.A23, MPU0.A23
/DD6: B4.11 (D6), B6.28 (D6), B8.28 (D6), DEV3.A22, DEV4.A22, DEV16.A22, DEV17.A22, DEV18.A22, DEV19.A22, MPU0.A22
/DD7: B4.10 (D7), B6.26 (D7), B8.26 (D7), DEV3.A21, DEV4.A21, DEV16.A21, DEV17.A21, DEV18.A21, DEV19.A21, MPU0.A21
/DM0: DEV3.D8, DEV4.D8, DEV16.D8, DEV17.D8, DEV18.D8, DEV19.D8, MPU0.D8, RN1.9 (R8)
/DM1: DEV3.D7, DEV4.D7, DEV16.D7, DEV17.D7, DEV18.D7, DEV19.D7, MPU0.D7, RN1.8 (R7)
/DM2: DEV3.D6, DEV4.D6, DEV16.D6, DEV17.D6, DEV18.D6, DEV19.D6, MPU0.D6, RN1.7 (R6)
/DM3: DEV3.D5, DEV4.D5, DEV16.D5, DEV17.D5, DEV18.D5, DEV19.D5, MPU0.D5, RN1.6 (R5)
/DM4: DEV3.D4, DEV4.D4, DEV16.D4, DEV17.D4, DEV18.D4, DEV19.D4, MPU0.D4, RN1.5 (R4)
/DM5: DEV3.D3, DEV4.D3, DEV16.D3, DEV17.D3, DEV18.D3, DEV19.D3, MPU0.D3, RN1.4 (R3)
/DM6: DEV3.D2, DEV4.D2, DEV16.D2, DEV17.D2, DEV18.D2, DEV19.D2, MPU0.D2, RN1.3 (R2)
/DM7: DEV3.D1, DEV4.D1, DEV16.D1, DEV17.D1, DEV18.D1, DEV19.D1, MPU0.D1, RN1.2 (R1)
/Device_{3} 2MB Select_{0}: B3.15 (Select_0_{_Device}X), B4.28 (Device_{(X)}_2MB_Select_{0})
/Device_{3} 2MB Select_{1}: B3.16 (Select_1_{_Device}X), B4.29 (Device_{(X)}_2MB_Select_{1})
/Device_{4} 2MB Select_{0}: B3.18 (Select_0_{_Device}Y), B4.30 (Device_{(W)}_2MB_Select_{0})
/Device_{4} 2MB Select_{1}: B3.19 (Select_1_{_Device}Y), B4.31 (Device_{(W)}_2MB_Select_{1})
/Device_{16} 2MB Select_{0}: B1.15 (Select_0_{_Device}X), B4.21 (Device_{(Z)}_2MB_Select_{0})
/Device_{16} 2MB Select_{1}: B1.16 (Select_1_{_Device}X), B4.22 (Device_{(Z)}_2MB_Select_{1})
/Device_{17} 2MB Select_{0}: B1.18 (Select_0_{_Device}Y), B4.25 (Device_{(Y)}_2MB_Select_{0})
/Device_{17} 2MB Select_{1}: B1.19 (Select_1_{_Device}Y), B4.26 (Device_{(Y)}_2MB_Select_{1})
/Device_{18} 2MB Select_{0}: B2.15 (Select_0_{_Device}X), B4.32 (Device_{(V)}_2MB_Select_{0})
/Device_{18} 2MB Select_{1}: B2.16 (Select_1_{_Device}X), B4.33 (Device_{(V)}_2MB_Select_{1})
/Device_{19} 2MB Select_{0}: B2.18 (Select_0_{_Device}Y), B4.35 (Device_{(U)}_2MB_Select_{0})
/Device_{19} 2MB Select_{1}: B2.19 (Select_1_{_Device}Y), B4.36 (Device_{(U)}_2MB_Select_{1})
/D~CLK: DEV3.B16, DEV4.B16, DEV16.B16, DEV17.B16, DEV18.B16, DEV19.B16, MPU0.B16
/D~RD: B8.21 (~RD), DEV3.B13, DEV4.B13, DEV16.B13, DEV17.B13, DEV18.B13, DEV19.B13, MPU0.B13
/D~WD: B4.9 (~WD), B6.21 (~WD), B8.22 (~WD), B16.3 (~WD), DEV3.B14, DEV4.B14, DEV16.B14, DEV17.B14, DEV18.B14, DEV19.B14, MPU0.B14
/GND: B1.9 (GND), B1.20 (GND), B1.37 (GND), B1.48 (GND), B2.9 (GND), B2.20 (GND), B2.37 (GND), B2.48 (GND), B3.9 (GND), B3.20 (GND), B3.37 (GND), B3.48 (GND), B4.7 (GND), B4.14 (GND), B4.27 (GND), B4.34 (GND), B5.5 (GND), B5.12 (GND), B5.21 (GND), B5.28 (GND), B6.7 (GND), B6.14 (GND), B6.27 (GND), B6.34 (GND), B7.5 (GND), B7.12 (GND), B7.21 (GND), B7.28 (GND), B8.7 (GND), B8.14 (GND), B8.27 (GND), B8.34 (GND), B12.9 (GND), B12.20 (GND), B12.37 (GND), B12.48 (GND), B16.4 (GND), B16.9 (GND), B16.16 (GND), B16.21 (GND), C1.2, C2.2, C3.2, C4.2, C5.2, C16.1, DEV3.B2, DEV3.B10, DEV3.B17, DEV3.B24, DEV3.B31, DEV3.D9, DEV3.D18, DEV4.B2, DEV4.B10, DEV4.B17, DEV4.B24, DEV4.B31, DEV4.D9, DEV4.D18, DEV16.B2, DEV16.B10, DEV16.B17, DEV16.B24, DEV16.B31, DEV16.D9, DEV16.D18, DEV17.B2, DEV17.B10, DEV17.B17, DEV17.B24, DEV17.B31, DEV17.D9, DEV17.D18, DEV18.B2, DEV18.B10, DEV18.B17, DEV18.B24, DEV18.B31, DEV18.D9, DEV18.D18, DEV19.B2, DEV19.B10, DEV19.B17, DEV19.B24, DEV19.B31, DEV19.D9, DEV19.D18, H1.1 (GND_1), H2.1 (GND_1), H3.1 (GND_1), H4.1 (GND_1), H5.1 (GND_1), H6.1 (GND_1), H7.1 (GND_1), H8.1 (GND_1), H9.1 (GND_1), H10.1 (GND_1), H11.1 (GND_1), H12.1 (GND_1), H13.1 (GND_1), IC1.4 (GND), IC3.1 (GND), IC7.1 (GND), J1.3, J1.5, J3.SHL1 (GND), J3.SHL2 (GND), LED2.1 (K), MPD0.2, MPD0.23, MPD0.36, MPU0.B2, MPU0.B10, MPU0.B17, MPU0.B24, MPU0.B31, MPU0.D9, MPU0.D18, NT1.2, NT2.2, NT3.2, R5.1, R6.1, R9.2, S2.1 (C1), S3.1 (C1)
/HD0: B4.20 (H0), B8.40 (H0), B16.19 (H0), DEV3.A31, DEV4.A31, DEV16.A31, DEV17.A31, DEV18.A31, DEV19.A31, MPU0.A31
/HD1: B4.19 (H1), B8.39 (H1), B16.18 (H1), DEV3.A30, DEV4.A30, DEV16.A30, DEV17.A30, DEV18.A30, DEV19.A30, MPU0.A30
/HD2: B4.24 (H2), B8.37 (H2), B16.17 (H2), DEV3.A29, DEV4.A29, DEV16.A29, DEV17.A29, DEV18.A29, DEV19.A29, MPU0.A29
/Kernal: MPU0.A3, TP2.1 (1_1)
/MPU0_{M}: MPU0.B8, R6.2
/MPU1_{M}: MPU0.B7, R5.2
/MPU CLK: B12.10 (CLK_{0}), DEV3.B3, DEV4.B3, DEV16.B3, DEV17.B3, DEV18.B3, DEV19.B3, MPU0.B3
/Native Latch: MPU0.B12, TP3.1 (1_1)
/Watchdog CLK: B12.55 (Watch_CLK), MPU0.B30
/~ABORT: MPU0.B6, R4.2
/~Device: MPU0.A2, TP1.1 (1_1)
/~Enable DEV1: MPD0.34, NT1.1
/~Enable DEV2: MPD0.32, NT3.1
/~Enable DEV3: DEV3.B22, MPD0.30
/~Enable DEV4: DEV4.B22, MPD0.28
/~Enable DEV5: MPD0.26
/~Enable DEV6: MPD0.35
/~Enable DEV7: MPD0.33, NT2.1
/~Enable DEV16: DEV16.B22, MPD0.31
/~Enable DEV17: DEV17.B22, MPD0.29
/~Enable DEV18: DEV18.B22, MPD0.27
/~Enable DEV19: DEV19.B22, MPD0.25
/~Interrupt DEV1: MPD0.1
/~Interrupt DEV2: B8.38 (~INT), MPD0.3
/~Interrupt DEV3: DEV3.B19, MPD0.5
/~Interrupt DEV4: DEV4.B19, MPD0.7
/~Interrupt DEV5: MPD0.9
/~Interrupt DEV6: MPD0.11
/~Interrupt DEV7: MPD0.13
/~Interrupt DEV16: DEV16.B19, MPD0.15
/~Interrupt DEV17: DEV17.B19, MPD0.17
/~Interrupt DEV18: DEV18.B19, MPD0.19
/~Interrupt DEV19: DEV19.B19, MPD0.21
/~Main Memory: B1.10 (~Main_{M}), B2.10 (~Main_{M}), B3.10 (~Main_{M}), B5.29 (~Main_Memory)
/~Main RD: DEV3.D10, DEV4.D10, DEV16.D10, DEV17.D10, DEV18.D10, DEV19.D10, MPU0.D10, R10.2
/~Main Slot: B12.11 (~Main_Slot_{0}), DEV3.B11, DEV4.B11, DEV16.B11, DEV17.B11, DEV18.B11, DEV19.B11, MPU0.B11
/~Main WD: DEV3.D11, DEV4.D11, DEV16.D11, DEV17.D11, DEV18.D11, DEV19.D11, MPU0.D11, R8.2
/~Main3: B5.8 (~Main3), B7.8 (~Main3), DEV3.B9
/~Main4: B5.9 (~Main4), B7.9 (~Main4), DEV4.B9
/~Main16: B5.10 (~Main5), B7.10 (~Main5), DEV16.B9
/~Main17: B5.11 (~Main6), B7.11 (~Main6), DEV17.B9
/~Main18: B5.7 (~Main2), B7.7 (~Main2), DEV18.B9
/~Main19: B5.6 (~Main1), B7.6 (~Main1), DEV19.B9
/~Main MPU: B5.4 (~Main0), B7.4 (~Main0), MPU0.B9
/~Memory Fail: B5.16 (~Set_Contention), B7.20 (~Set_Contention)
/~Memory Hi_{ Device}3: B3.46 (~Memory__{2..4MB}_{_Device}X), DEV3.B30
/~Memory Hi_{ Device}4: B3.36 (~Memory__{2..4MB}_{_Device}Y), DEV4.B30
/~Memory Hi_{ Device}16: B1.46 (~Memory__{2..4MB}_{_Device}X), DEV16.B30
/~Memory Hi_{ Device}17: B1.36 (~Memory__{2..4MB}_{_Device}Y), DEV17.B30
/~Memory Hi_{ Device}18: B2.46 (~Memory__{2..4MB}_{_Device}X), DEV18.B30
/~Memory Hi_{ Device}19: B2.36 (~Memory__{2..4MB}_{_Device}Y), DEV19.B30
/~Memory Lo_{ Device}3: B3.47 (~Memory__{0..2MB}_{_Device}X), DEV3.B29
/~Memory Lo_{ Device}4: B3.38 (~Memory__{0..2MB}_{_Device}Y), DEV4.B29
/~Memory Lo_{ Device}16: B1.47 (~Memory__{0..2MB}_{_Device}X), DEV16.B29
/~Memory Lo_{ Device}17: B1.38 (~Memory__{0..2MB}_{_Device}Y), DEV17.B29
/~Memory Lo_{ Device}18: B2.47 (~Memory__{0..2MB}_{_Device}X), DEV18.B29
/~Memory Lo_{ Device}19: B2.38 (~Memory__{0..2MB}_{_Device}Y), DEV19.B29
/~NMI1: B5.18 (~Contention), MPU0.B4, R1.2
/~NMI2: IC7.3 (OUT), MPU0.B5, R2.2
/~Reset Switch: B16.22 (~Reset_Switch), J1.6, S2.3 (N1)
/~Reset: B5.15 (~Reset), B6.15 (~Reset), B12.4 (~Reset), B16.20 (~Reset), DEV3.A1, DEV4.A1, DEV16.A1, DEV17.A1, DEV18.A1, DEV19.A1, MPU0.A1
/~Reset DEV1: MPD0.24
/~Reset DEV2: MPD0.22
/~Reset DEV3: DEV3.B20, MPD0.20
/~Reset DEV4: DEV4.B20, MPD0.18
/~Reset DEV5: MPD0.16
/~Reset DEV6: MPD0.14
/~Reset DEV7: MPD0.12
/~Reset DEV16: DEV16.B20, MPD0.10
/~Reset DEV17: DEV17.B20, MPD0.8
/~Reset DEV18: DEV18.B20, MPD0.6
/~Reset DEV19: DEV19.B20, MPD0.4
/~Select DEV1: B4.2 (~Select), MPU0.B29
/~Select DEV2: B6.4 (~Select), B8.4 (~Select), MPU0.B28
/~Select DEV3: DEV3.B21, MPU0.B27
/~Select DEV4: DEV4.B21, MPU0.B26
/~Select DEV5: MPU0.B25
/~Select DEV6: MPU0.B23
/~Select DEV7: B16.2 (~Device_Select), MPU0.B22
/~Select DEV16: DEV16.B21, MPU0.B21
/~Select DEV17: DEV17.B21, MPU0.B20
/~Select DEV18: DEV18.B21, MPU0.B19
/~Select DEV19: DEV19.B21, MPU0.B18
unnamed: IC7.2 (IN), S3.3 (N1)

Notes on the sheet:
RTC Device
Clock
(Device 1)
Processor Board Socket
Power
Main Memory Control
The only cards currently writing to the address bus are: 1) Processor Board (obviously) 2) Blitter Board 3) Graphics Board
(Device 2)
(Device 7)
The only cards currently reading from the address bus are: 1) Memory Board 2) Video Board 3) Coprocessor Board
Main Memory Channel
Status Device
Device Board Sockets
Reset Device

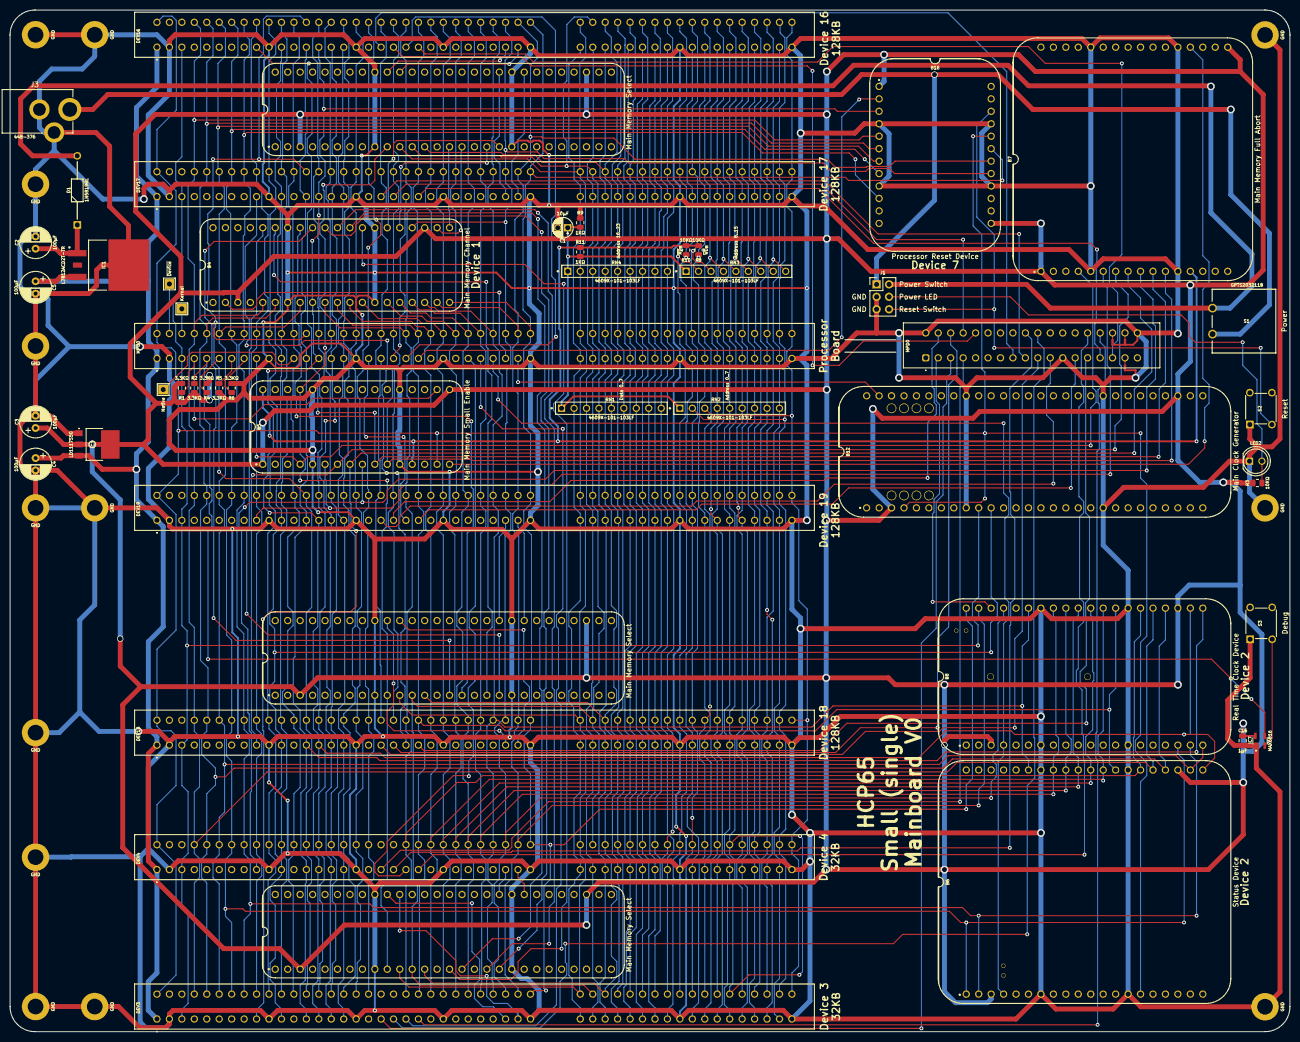
[picture p175: board Mainboard Small.kicad_pcb from above]

Board: 2 copper layers, 261.1 x 208.4 mm, 67 parts (0 on the bottom side), 153 nets.
