andrewpaterson/HCP65/Kicad/Computer/Processor/Processor Board/Processor Board.kicad_pcb

## KiCad design Kicad/Computer/Processor/Processor Board/Processor Board.kicad_pcb (2026-11-08)

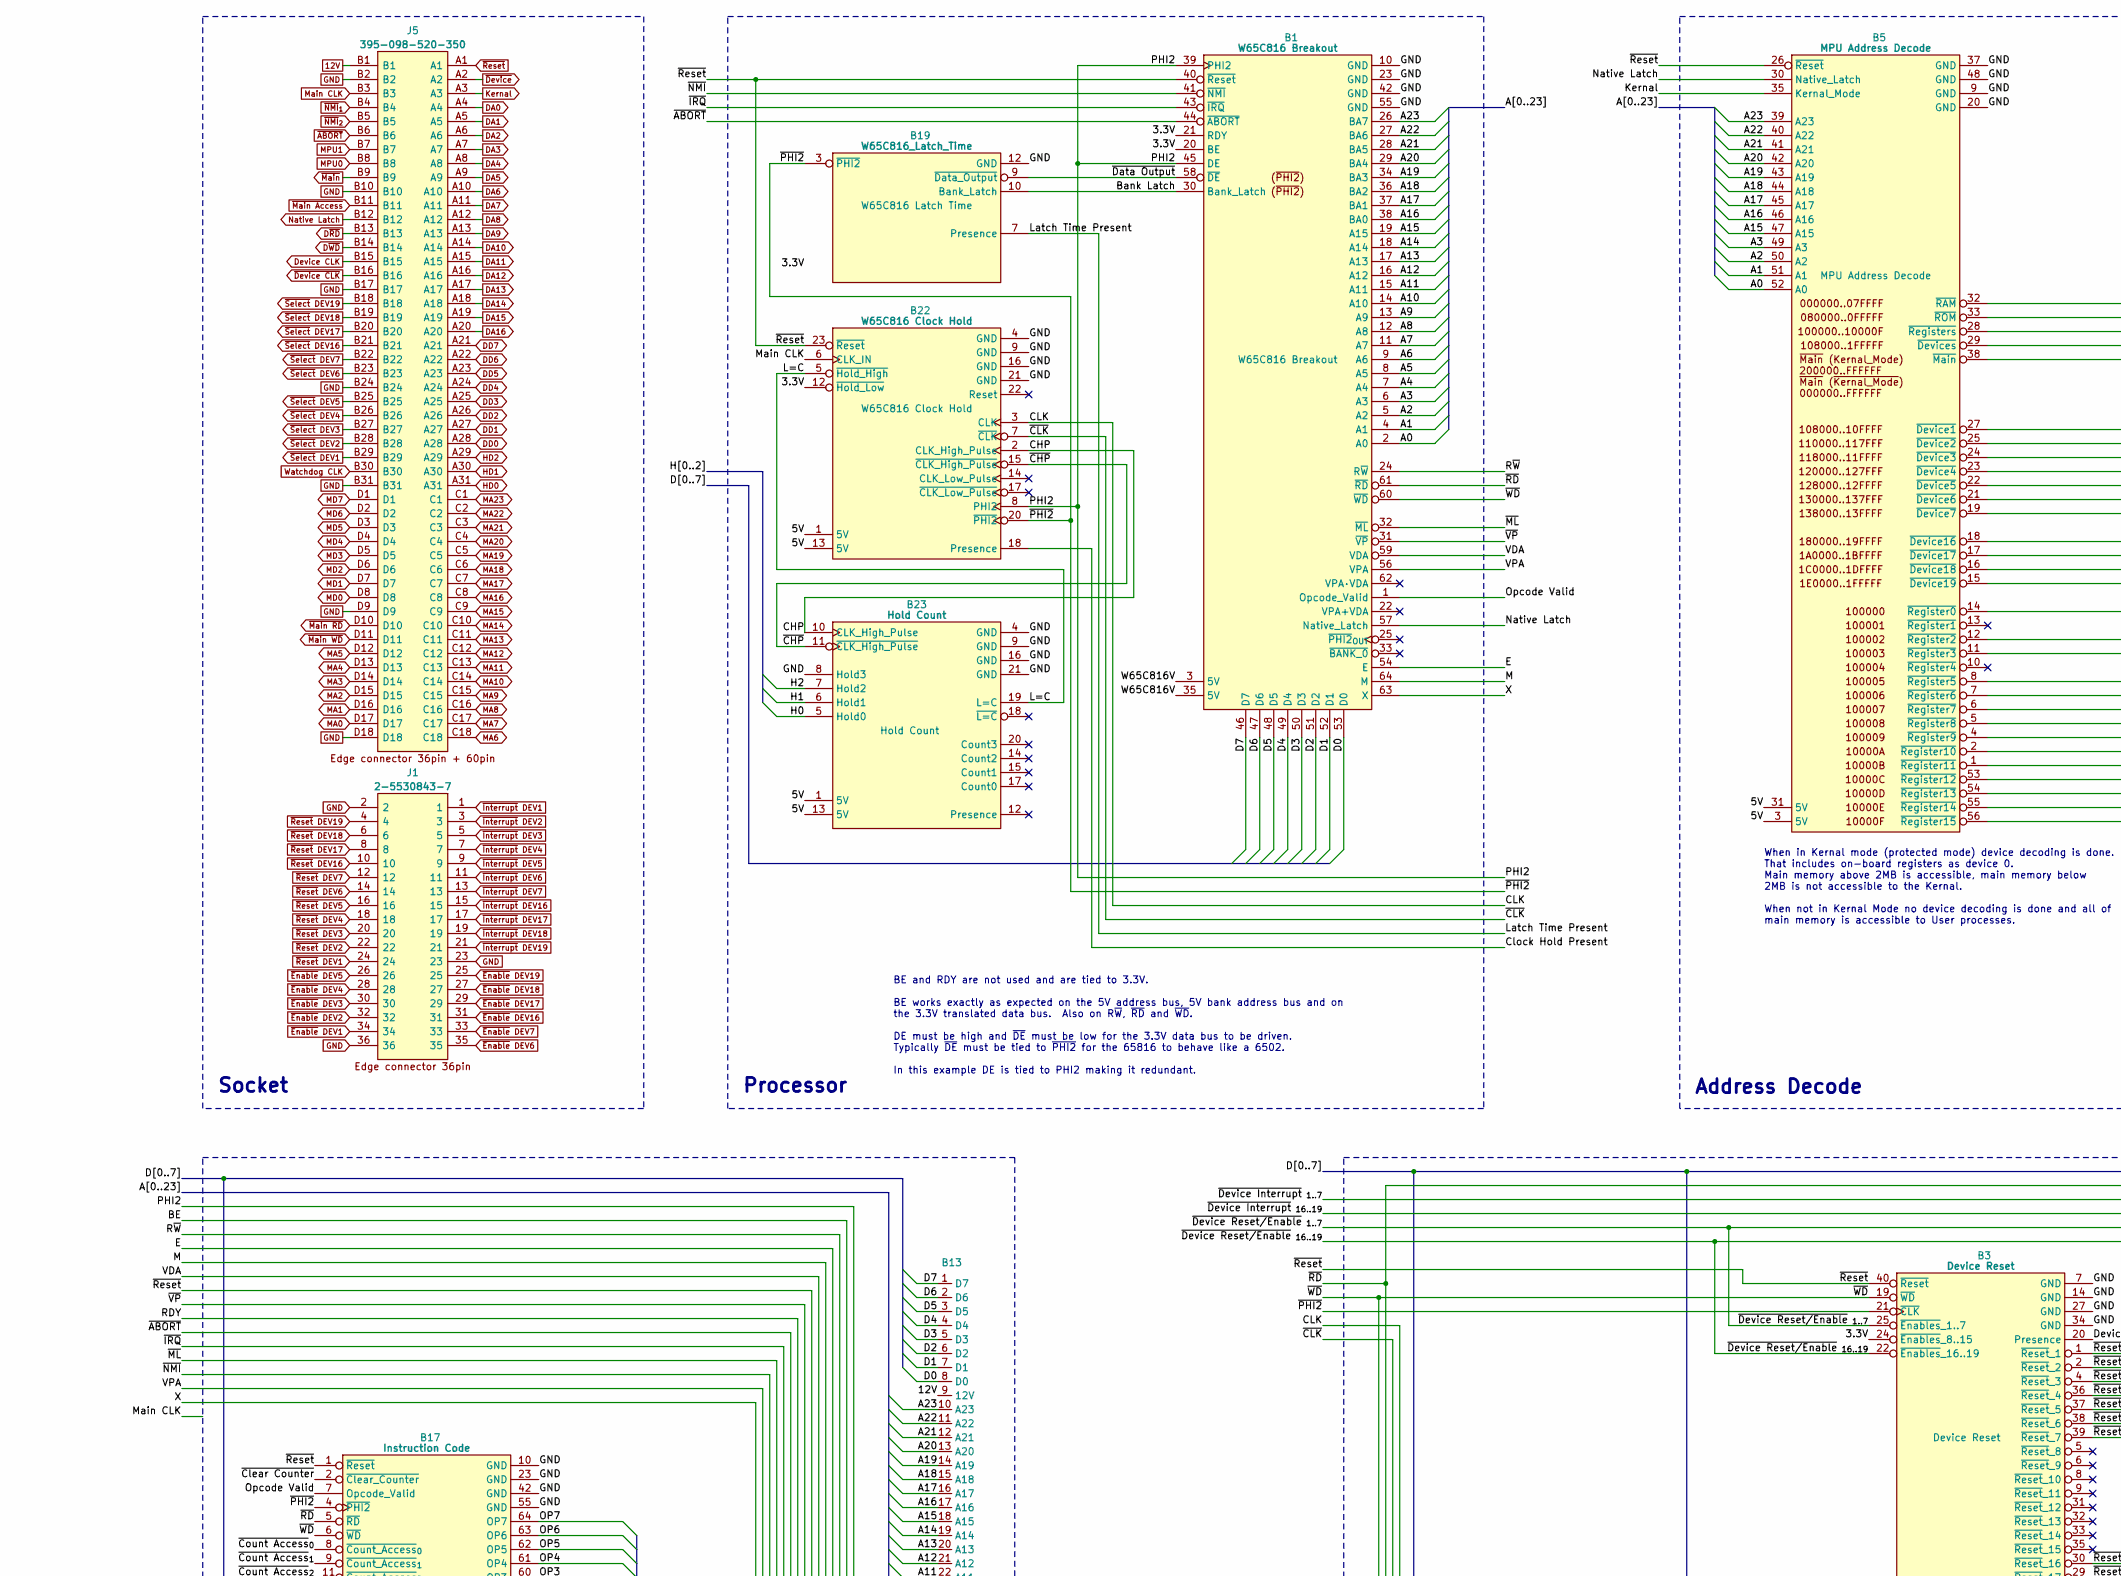
[picture p176: schematic Processor Board.kicad_sch, HCP65 Test MPU Board, part in row 1, column 1]

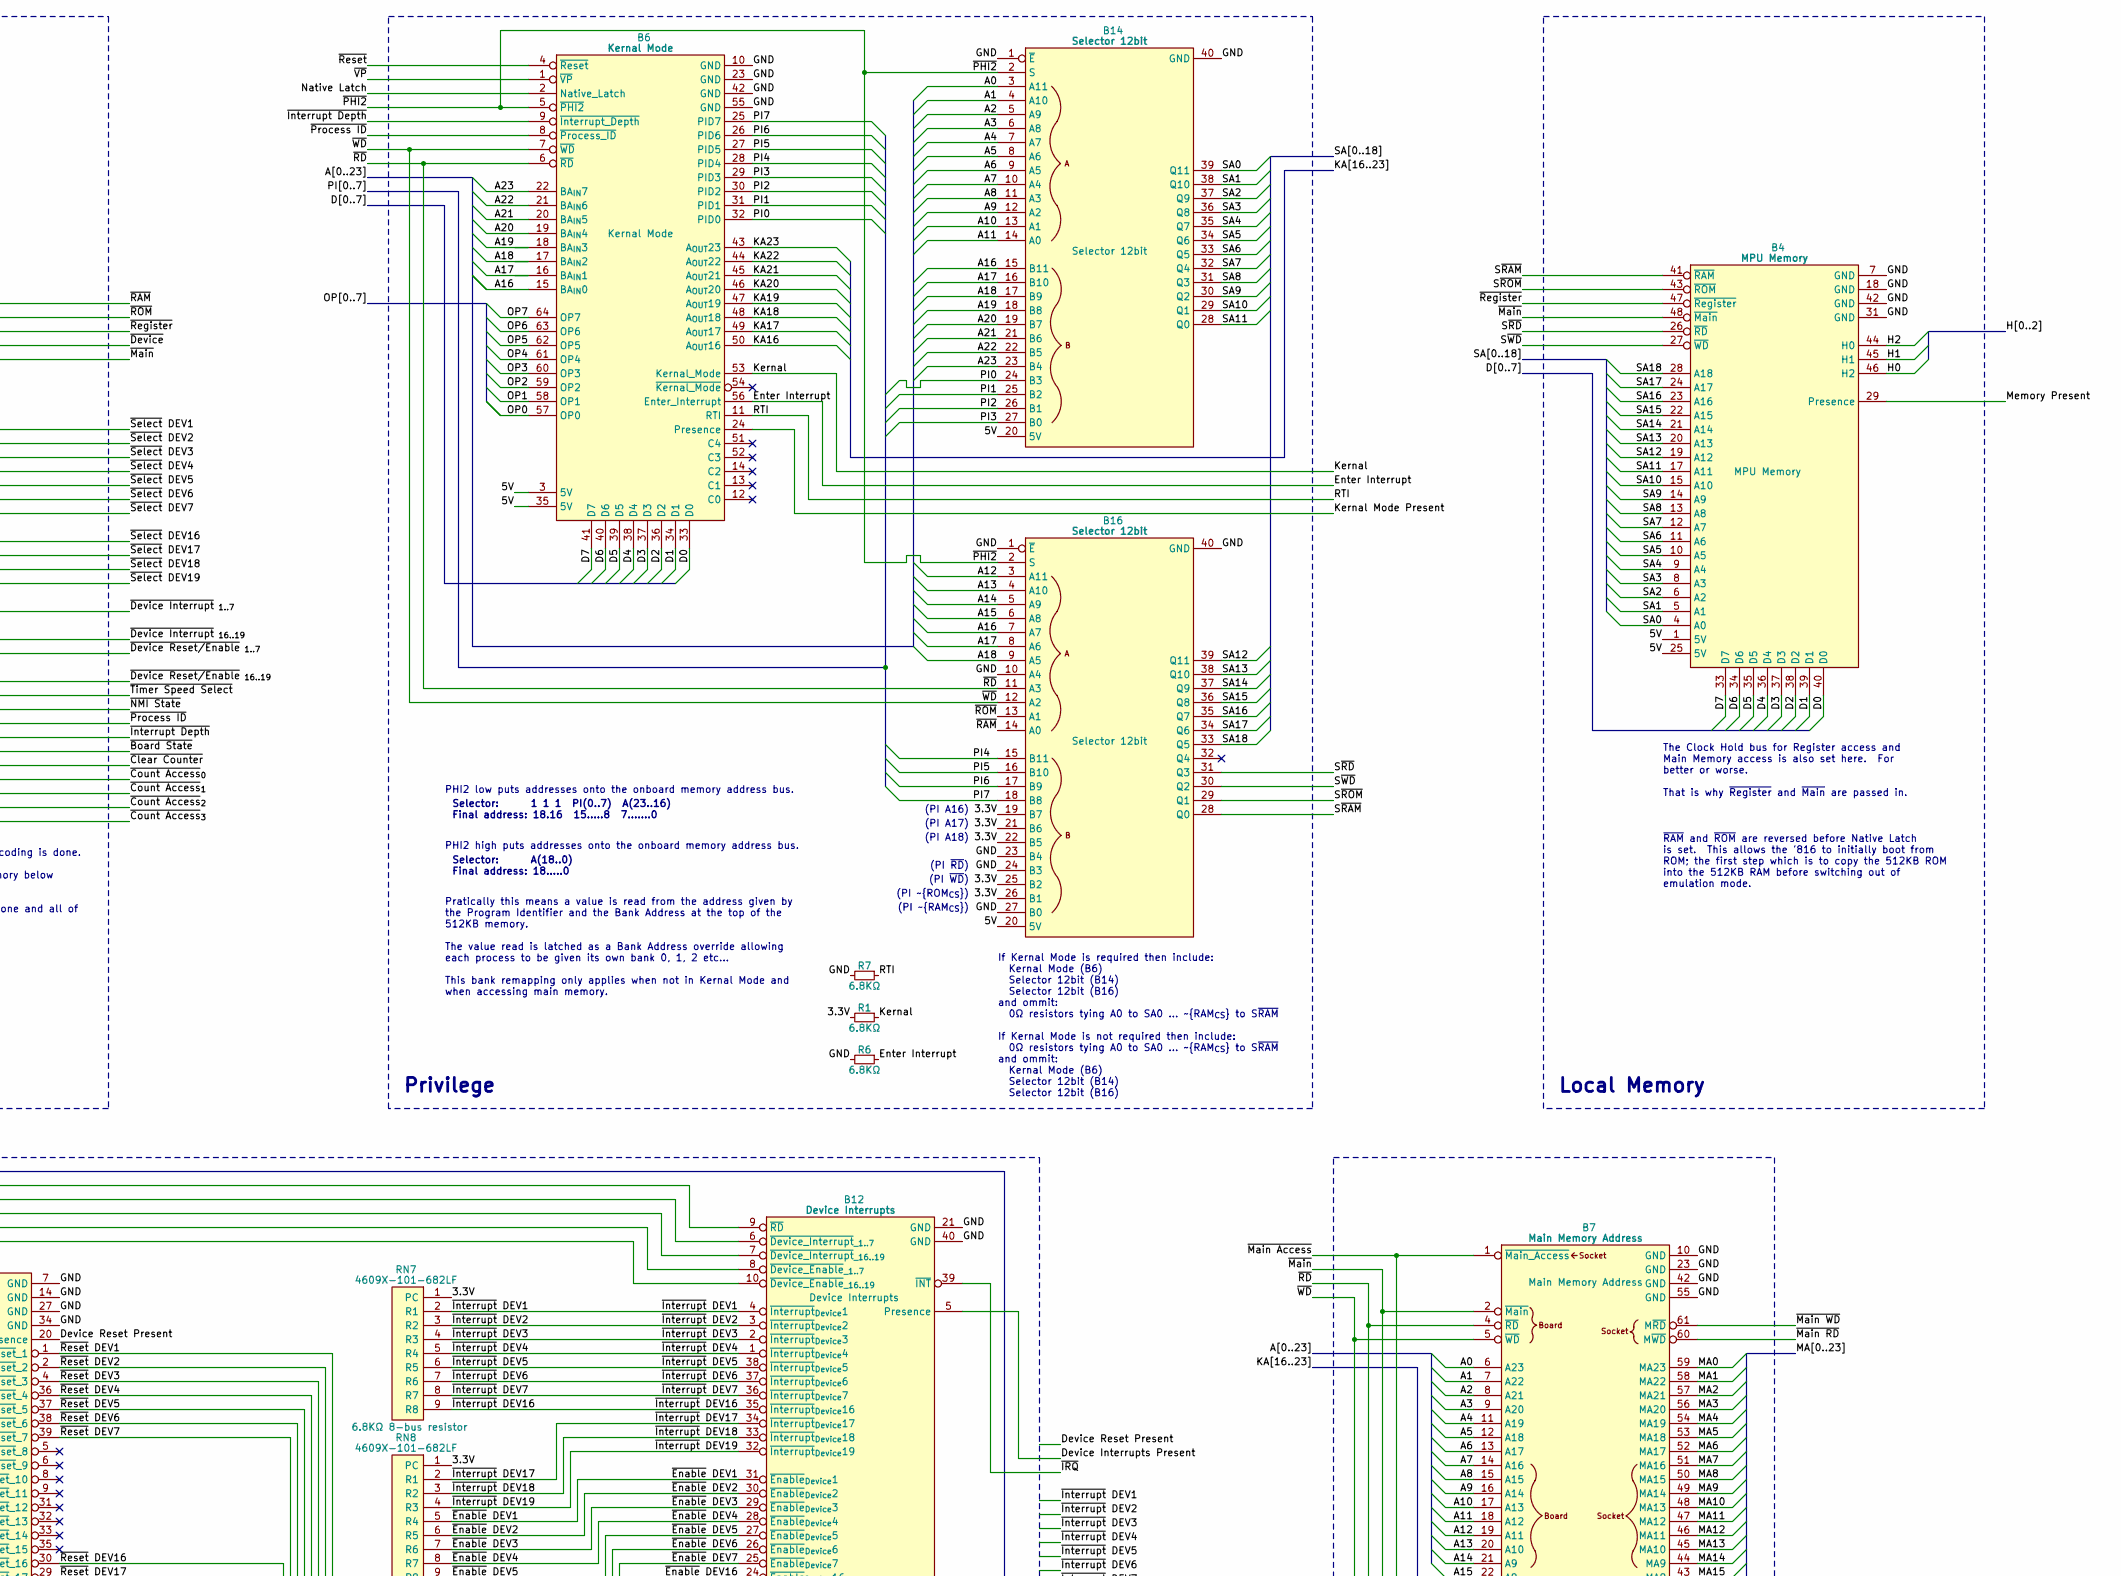
[picture p177: schematic Processor Board.kicad_sch, HCP65 Test MPU Board, part in row 1, column 2]

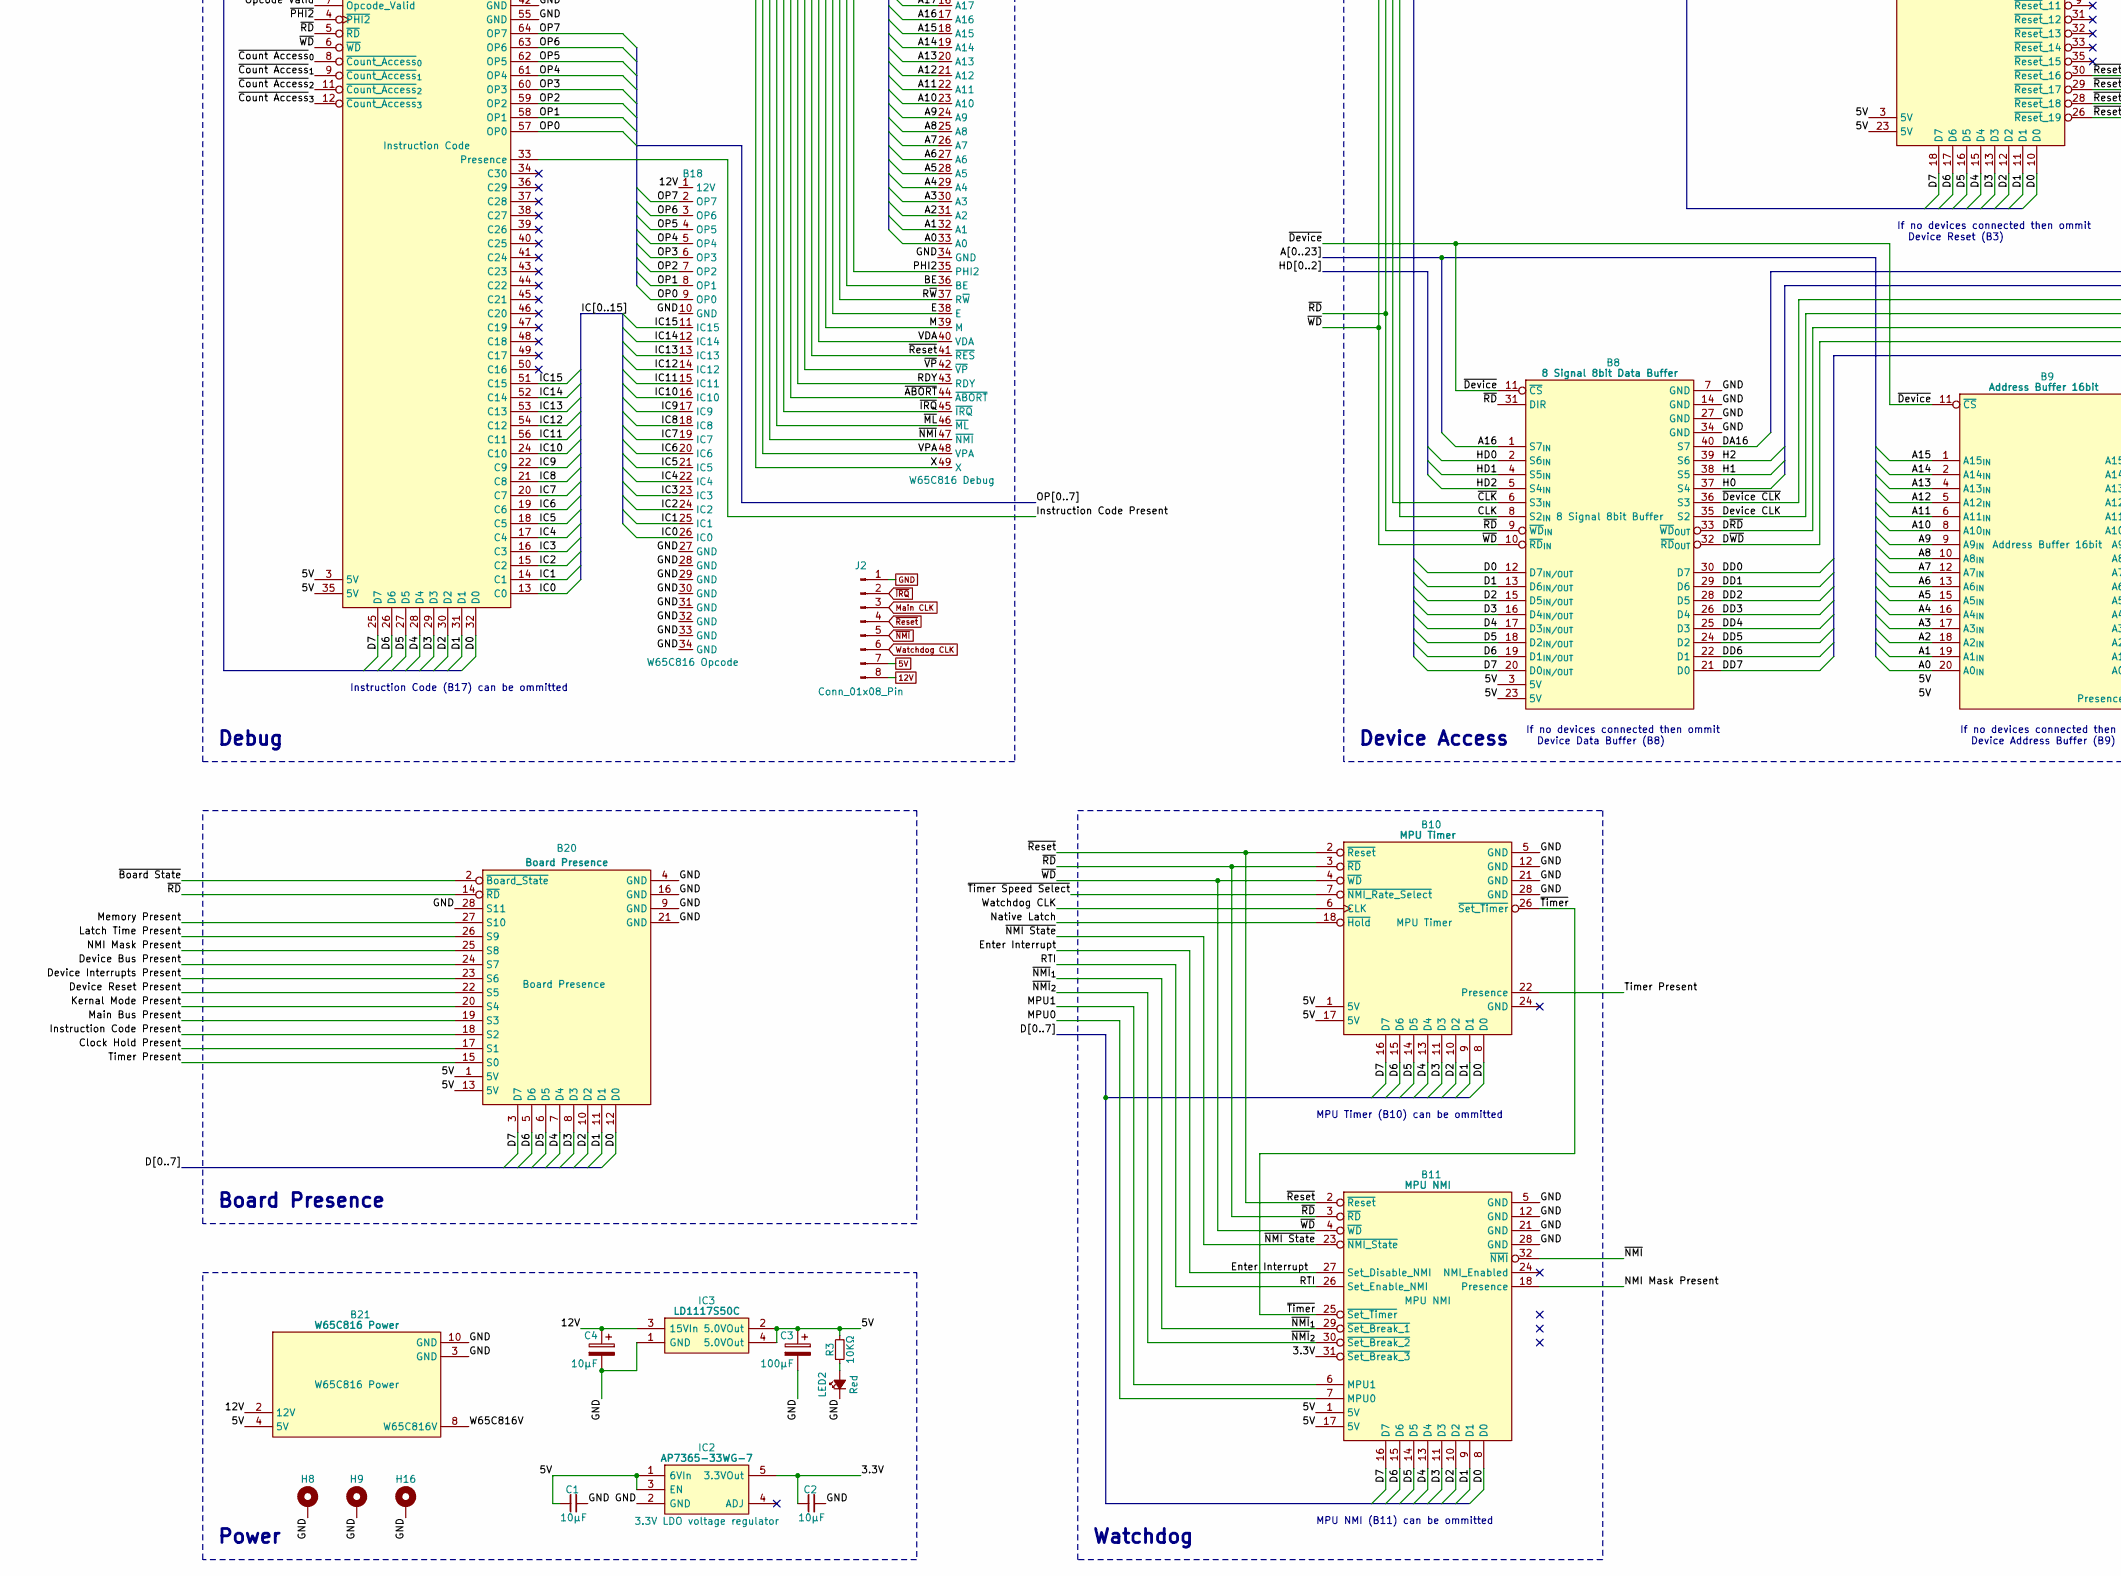
[picture p178: schematic Processor Board.kicad_sch, HCP65 Test MPU Board, part in row 2, column 1]

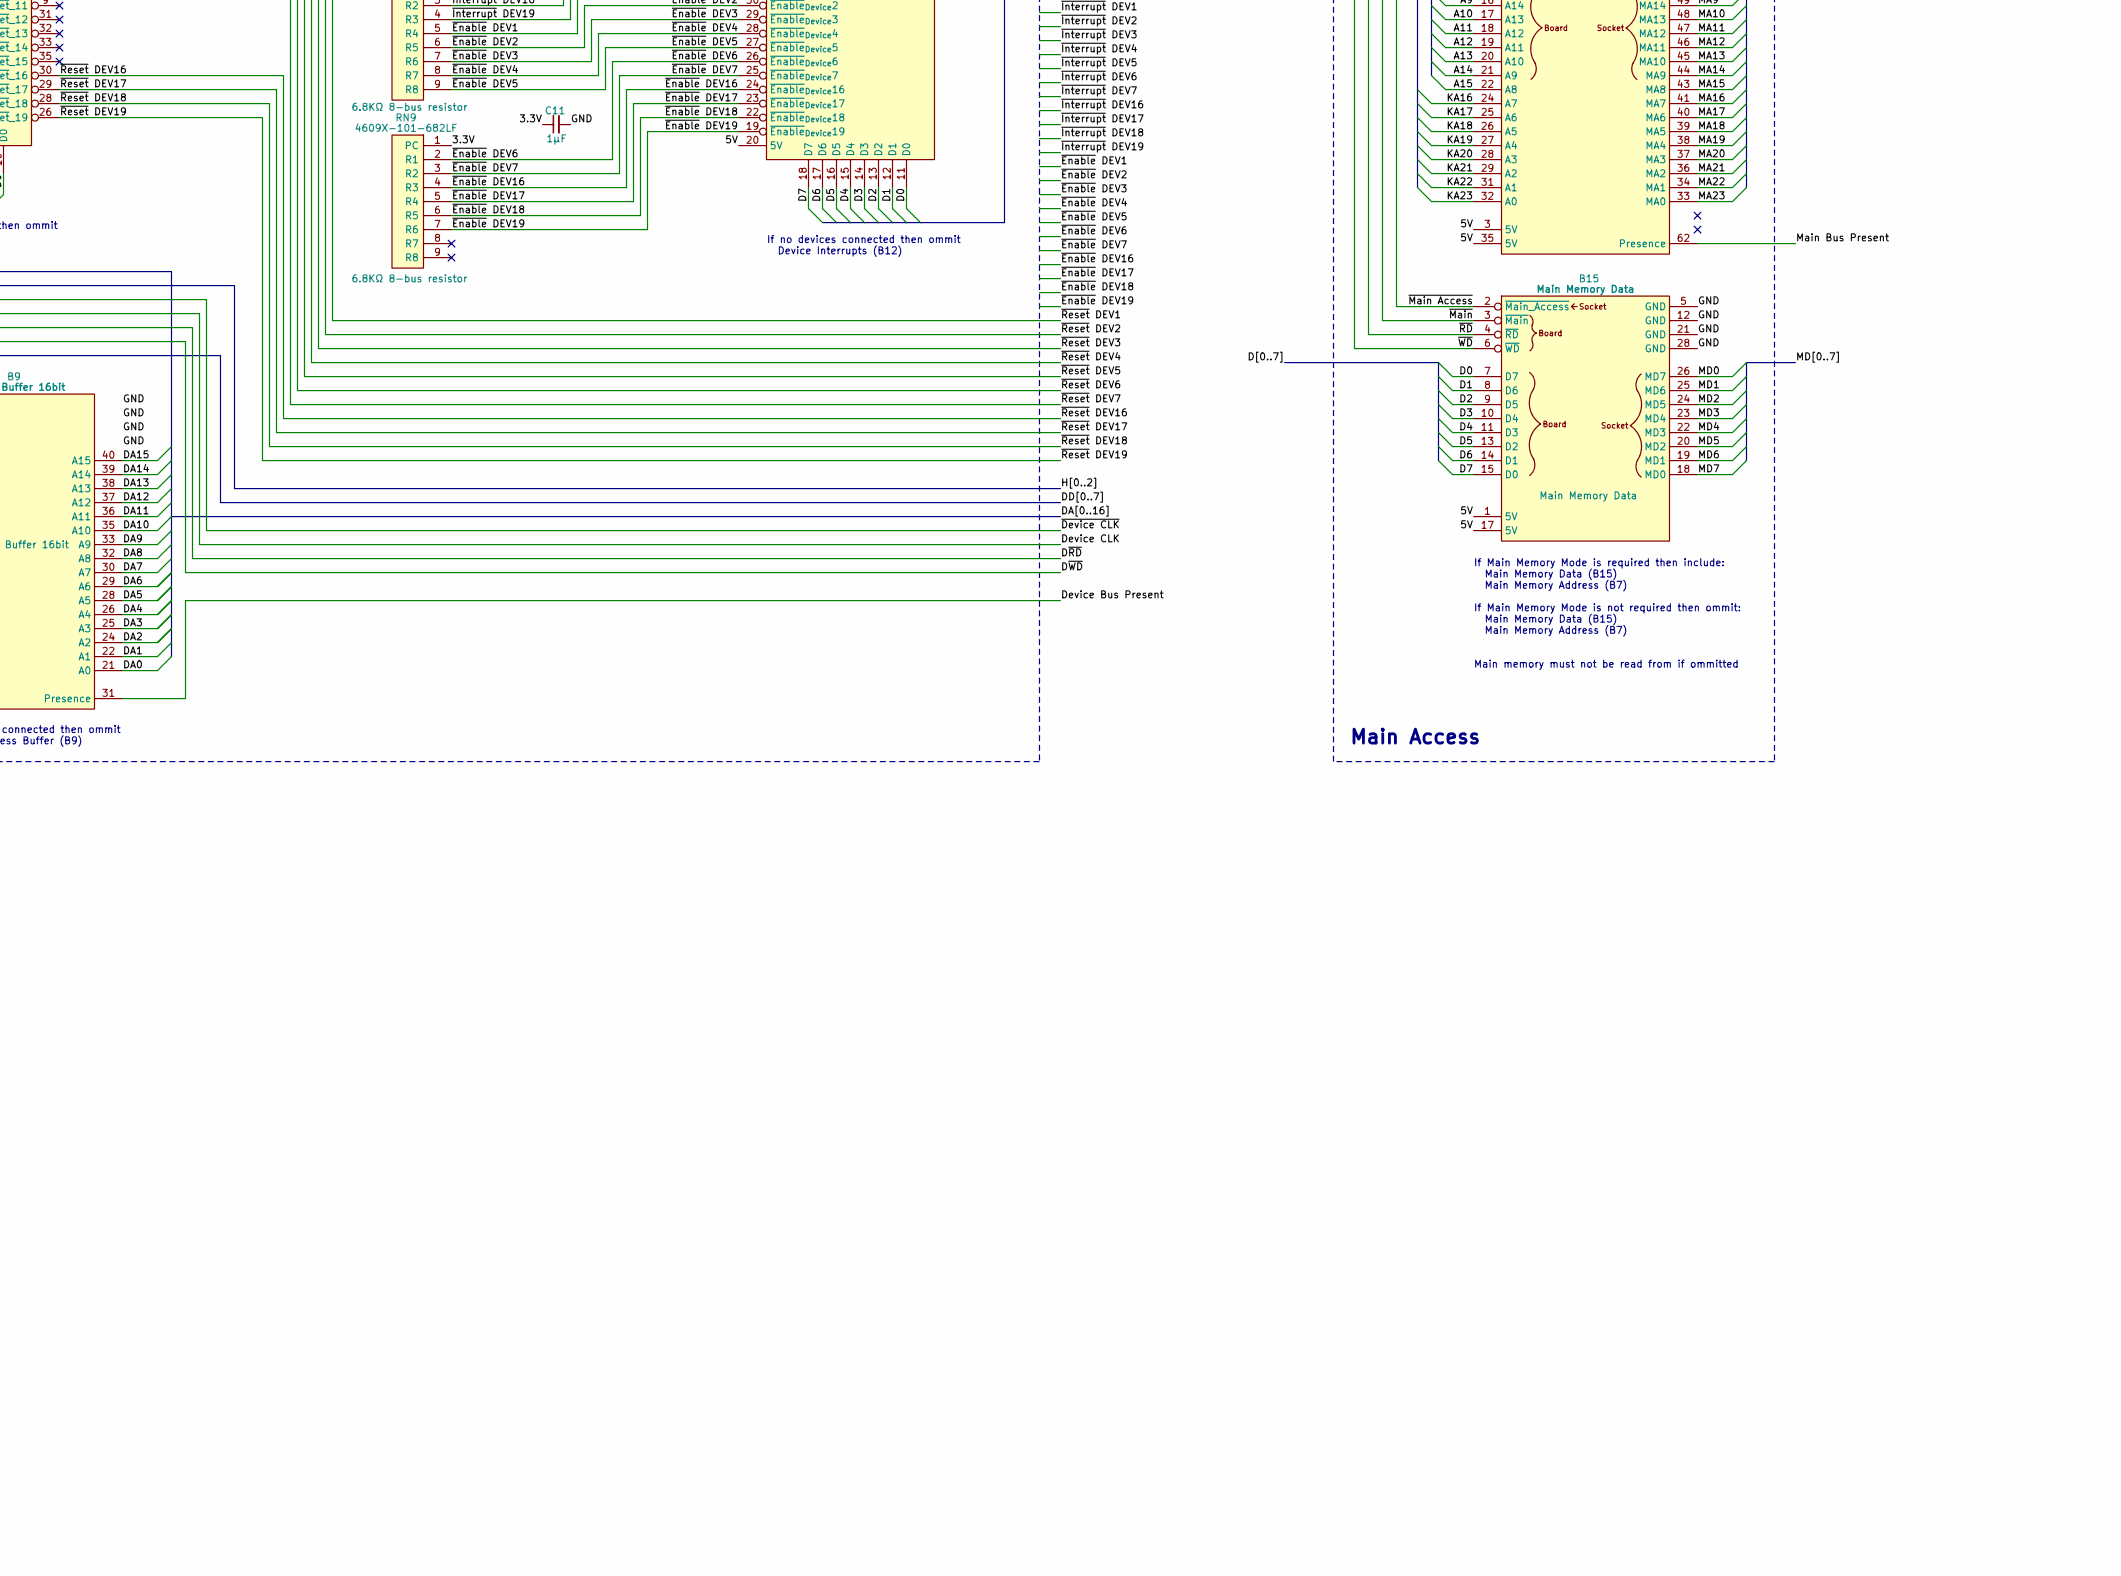
[picture p179: schematic Processor Board.kicad_sch, HCP65 Test MPU Board, part in row 2, column 2]

Parts:
B1: W65C816 Breakout; HCP65_W65C816_Breakout
B3: Device Reset; HCP65_Device_Reset
B4: MPU Memory; HCP65_MPU_Memory
B5: MPU Address Decode; HCP65_MPU_Address_Decode
B6: Kernal Mode; HCP65_Kernal_Mode
B7: Main Memory Address; HCP65_Main_Memory_Address
B8: 8 Signal 8bit Data Buffer; HCP65_Data_and_Signal_Buffer
B9: Address Buffer 16bit; HCP65_Address_Buffer_16bit
B10: MPU Timer; HCP65_MPU_Timer
B11: MPU NMI; HCP65_MPU_NMI
B12: Device Interrupts; HCP65_Device_Interrupts
B13: W65C816 Debug; HCP65_W65C816_Debug_Display
B14, B16: Selector 12bit; HCP65_Selector_12bit
B15: Main Memory Data; HCP65_Main_Memory_Data
B17: Instruction Code; HCP65_Instruction_Code
B18: W65C816 Opcode; HCP65_W65C816_Debug_Instruction
B19: W65C816_Latch_Time; HCP65_W65C816_Latch_Time
B20: Board Presence; HCP65_Board_Presence
B21: W65C816 Power; HCP65_W65C816_Power
B22: W65C816 Clock Hold; HCP65_W65C816_Clock_Hold
B23: Hold Count; HCP65_Hold_Count
C1, C2: 10µF; C_0805
C3: 100μF; CP_Radial_D4.0mm_P2.00mm
C4: 10μF; CP_Radial_D4.0mm_P2.00mm
C11: 1μF; C_0805
H8, H9, H16: MountingHole_Pad; HCP65_MountingHole_M3_
IC2: AP7365-33WG-7; SOT95P285X130-5N; Manufacturer_Part_Number AP7365-33WG-7; Mouser Part Number 621-AP7365-33WG-7
IC3: LD1117S50C; LD1117S33C; Manufacturer_Part_Number LD1117S50C
J1: 2-5530843-7; 36pin Edge Connector; Manufacturer_Part_Number 2-5530843-7; Mouser Part Number 571-2-5530843-7
J2: Conn_01x08_Pin; PinHeader_1x08_P2.54mm_Vertical
J5: 395-098-520-350; 98pin Edge Connector; Manufacturer_Part_Number 395-098-520-350; Mouser Part Number 587-395-098-520-350
LED2: Red; LED_D5.0mm
R1, R6, R7: 6.8KΩ; R_0805
R3: 10KΩ; R_0805
RN7, RN8, RN9: 4609X-101-682LF; 4609X; Manufacturer_Part_Number 4609X-101-682LF; Mouser Part Number 652-4609X-1LF-6.8K

Connections:
5V: B3.3 (5V), B3.23 (5V), B4.1 (5V), B4.25 (5V), B5.3 (5V), B5.31 (5V), B6.3 (5V), B6.35 (5V), B7.3 (5V), B7.35 (5V), B8.3 (5V), B8.23 (5V), B9.3 (5V), B9.23 (5V), B10.1 (5V), B10.17 (5V), B11.1 (5V), B11.17 (5V), B12.20 (5V), B14.20 (5V), B15.1 (5V), B15.17 (5V), B16.20 (5V), B17.3 (5V), B17.35 (5V), B20.1 (5V), B20.13 (5V), B21.4 (5V), B22.1 (5V), B22.13 (5V), B23.1 (5V), B23.13 (5V), C1.1, C3.1, IC2.1 (6VIn), IC2.3 (EN), IC3.2 (5.0VOut), IC3.4 (5.0VOut), J2.7, R3.2
12V: B13.9 (12V), B18.1 (12V), B21.2 (12V), C4.1, IC3.3 (15VIn), J2.8, J5.B1
/3.3V: B1.20 (BE), B1.21 (RDY), B3.24 (~Enables_8..15), B11.31 (~Set_Break_3), B16.19 (B7), B16.21 (B6), B16.22 (B5), B16.25 (B2), B16.26 (B1), B19.6 (3.3V), B22.12 (~Hold_Low), C2.1, C11.1, IC2.5 (3.3VOut), R1.2, RN7.1 (PC), RN8.1 (PC), RN9.1 (PC)
/A0: B1.2 (A0), B5.52 (A0), B7.6 (A23), B9.20 (A0_{IN}), B13.33 (A0), B14.3 (A11)
/A1: B1.4 (A1), B5.51 (A1), B7.7 (A22), B9.19 (A1_{IN}), B13.32 (A1), B14.4 (A10)
/A2: B1.5 (A2), B5.50 (A2), B7.8 (A21), B9.18 (A2_{IN}), B13.31 (A2), B14.5 (A9)
/A3: B1.6 (A3), B5.49 (A3), B7.9 (A20), B9.17 (A3_{IN}), B13.30 (A3), B14.6 (A8)
/A4: B1.7 (A4), B7.11 (A19), B9.16 (A4_{IN}), B13.29 (A4), B14.7 (A7)
/A5: B1.8 (A5), B7.12 (A18), B9.15 (A5_{IN}), B13.28 (A5), B14.8 (A6)
/A6: B1.9 (A6), B7.13 (A17), B9.13 (A6_{IN}), B13.27 (A6), B14.9 (A5)
/A7: B1.11 (A7), B7.14 (A16), B9.12 (A7_{IN}), B13.26 (A7), B14.10 (A4)
/A8: B1.12 (A8), B7.15 (A15), B9.10 (A8_{IN}), B13.25 (A8), B14.11 (A3)
/A9: B1.13 (A9), B7.16 (A14), B9.9 (A9_{IN}), B13.24 (A9), B14.12 (A2)
/A10: B1.14 (A10), B7.17 (A13), B9.8 (A10_{IN}), B13.23 (A10), B14.13 (A1)
/A11: B1.15 (A11), B7.18 (A12), B9.6 (A11_{IN}), B13.22 (A11), B14.14 (A0)
/A12: B1.16 (A12), B7.19 (A11), B9.5 (A12_{IN}), B13.21 (A12), B16.3 (A11)
/A13: B1.17 (A13), B7.20 (A10), B9.4 (A13_{IN}), B13.20 (A13), B16.4 (A10)
/A14: B1.18 (A14), B7.21 (A9), B9.2 (A14_{IN}), B13.19 (A14), B16.5 (A9)
/A15: B1.19 (A15), B5.47 (A15), B7.22 (A8), B9.1 (A15_{IN}), B13.18 (A15), B16.6 (A8)
/A16: B1.38 (BA0), B5.46 (A16), B6.15 (BA_{IN}0), B8.1 (S7_{IN}), B13.17 (A16), B14.15 (B11), B16.7 (A7)
/A17: B1.37 (BA1), B5.45 (A17), B6.16 (BA_{IN}1), B13.16 (A17), B14.16 (B10), B16.8 (A6)
/A18: B1.36 (BA2), B5.44 (A18), B6.17 (BA_{IN}2), B13.15 (A18), B14.17 (B9), B16.9 (A5)
/A19: B1.34 (BA3), B5.43 (A19), B6.18 (BA_{IN}3), B13.14 (A19), B14.18 (B8)
/A20: B1.29 (BA4), B5.42 (A20), B6.19 (BA_{IN}4), B13.13 (A20), B14.19 (B7)
/A21: B1.28 (BA5), B5.41 (A21), B6.20 (BA_{IN}5), B13.12 (A21), B14.21 (B6)
/A22: B1.27 (BA6), B5.40 (A22), B6.21 (BA_{IN}6), B13.11 (A22), B14.22 (B5)
/A23: B1.26 (BA7), B5.39 (A23), B6.22 (BA_{IN}7), B13.10 (A23), B14.23 (B4)
/BE: B13.36 (BE)
/Bank Latch: B1.30 (Bank_Latch), B19.10 (Bank_Latch)
/CHP: B22.2 (CLK_High_Pulse), B23.10 (CLK_High_Pulse)
/CLK: B8.8 (S2_{IN}), B22.3 (CLK)
/Clock Hold Present: B20.17 (S1), B22.18 (Presence)
/D0: B1.53 (D0), B3.10 (D0), B4.40 (D0), B6.33 (D0), B8.12 (D7_{IN/OUT}), B10.8 (D0), B11.8 (D0), B12.11 (D0), B13.8 (D0), B15.7 (D7), B17.32 (D0), B20.12 (D0)
/D1: B1.52 (D1), B3.11 (D1), B4.39 (D1), B6.34 (D1), B8.13 (D6_{IN/OUT}), B10.9 (D1), B11.9 (D1), B12.12 (D1), B13.7 (D1), B15.8 (D6), B17.31 (D1), B20.11 (D1)
/D2: B1.51 (D2), B3.12 (D2), B4.38 (D2), B6.36 (D2), B8.15 (D5_{IN/OUT}), B10.10 (D2), B11.10 (D2), B12.13 (D2), B13.6 (D2), B15.9 (D5), B17.30 (D2), B20.10 (D2)
/D3: B1.50 (D3), B3.13 (D3), B4.37 (D3), B6.37 (D3), B8.16 (D4_{IN/OUT}), B10.11 (D3), B11.11 (D3), B12.14 (D3), B13.5 (D3), B15.10 (D4), B17.29 (D3), B20.8 (D3)
/D4: B1.49 (D4), B3.15 (D4), B4.36 (D4), B6.38 (D4), B8.17 (D3_{IN/OUT}), B10.13 (D4), B11.13 (D4), B12.15 (D4), B13.4 (D4), B15.11 (D3), B17.28 (D4), B20.7 (D4)
/D5: B1.48 (D5), B3.16 (D5), B4.35 (D5), B6.39 (D5), B8.18 (D2_{IN/OUT}), B10.14 (D5), B11.14 (D5), B12.16 (D5), B13.3 (D5), B15.13 (D2), B17.27 (D5), B20.6 (D5)
/D6: B1.47 (D6), B3.17 (D6), B4.34 (D6), B6.40 (D6), B8.19 (D1_{IN/OUT}), B10.15 (D6), B11.15 (D6), B12.17 (D6), B13.2 (D6), B15.14 (D1), B17.26 (D6), B20.5 (D6)
/D7: B1.46 (D7), B3.18 (D7), B4.33 (D7), B6.41 (D7), B8.20 (D0_{IN/OUT}), B10.16 (D7), B11.16 (D7), B12.18 (D7), B13.1 (D7), B15.15 (D0), B17.25 (D7), B20.3 (D7)
/Device Bus Present: B9.31 (Presence), B20.24 (S7)
/Device Interrupts Present: B12.5 (Presence), B20.23 (S6)
/Device Reset Present: B3.20 (Presence), B20.22 (S5)
/E: B1.54 (E), B13.38 (E)
/Enter Interrupt: B6.56 (Enter_Interrupt), B11.27 (Set_Disable_NMI), R6.1
/H0: B4.46 (H2), B8.37 (S4), B23.5 (Hold0)
/H1: B4.45 (H1), B8.38 (S5), B23.6 (Hold1)
/H2: B4.44 (H0), B8.39 (S6), B23.7 (Hold2)
/IC0: B17.13 (C0), B18.26 (IC0)
/IC1: B17.14 (C1), B18.25 (IC1)
/IC2: B17.15 (C2), B18.24 (IC2)
/IC3: B17.16 (C3), B18.23 (IC3)
/IC4: B17.17 (C4), B18.22 (IC4)
/IC5: B17.18 (C5), B18.21 (IC5)
/IC6: B17.19 (C6), B18.20 (IC6)
/IC7: B17.20 (C7), B18.19 (IC7)
/IC8: B17.21 (C8), B18.18 (IC8)
/IC9: B17.22 (C9), B18.17 (IC9)
/IC10: B17.24 (C10), B18.16 (IC10)
/IC11: B17.56 (C11), B18.15 (IC11)
/IC12: B17.54 (C12), B18.14 (IC12)
/IC13: B17.53 (C13), B18.13 (IC13)
/IC14: B17.52 (C14), B18.12 (IC14)
/IC15: B17.51 (C15), B18.11 (IC15)
/Instruction Code Present: B17.33 (Presence), B20.18 (S2)
/KA16: B6.50 (A_{OUT}16), B7.24 (A7)
/KA17: B6.49 (A_{OUT}17), B7.25 (A6)
/KA18: B6.48 (A_{OUT}18), B7.26 (A5)
/KA19: B6.47 (A_{OUT}19), B7.27 (A4)
/KA20: B6.46 (A_{OUT}20), B7.28 (A3)
/KA21: B6.45 (A_{OUT}21), B7.29 (A2)
/KA22: B6.44 (A_{OUT}22), B7.31 (A1)
/KA23: B6.43 (A_{OUT}23), B7.32 (A0)
/Kernal Mode Present: B6.24 (Presence), B20.20 (S4)
/L=C: B22.5 (~Hold_High), B23.19 (L=C)
/Latch Time Present: B19.7 (Presence), B20.26 (S9)
/M: B1.64 (M), B13.39 (M)
/Main Bus Present: B7.62 (Presence), B20.19 (S3)
/Memory Present: B4.29 (Presence), B20.27 (S10)
/NMI Mask Present: B11.18 (Presence), B20.25 (S8)
/OP0: B6.57 (OP0), B17.57 (OP0), B18.9 (OP0)
/OP1: B6.58 (OP1), B17.58 (OP1), B18.8 (OP1)
/OP2: B6.59 (OP2), B17.59 (OP2), B18.7 (OP2)
/OP3: B6.60 (OP3), B17.60 (OP3), B18.6 (OP3)
/OP4: B6.61 (OP4), B17.61 (OP4), B18.5 (OP4)
/OP5: B6.62 (OP5), B17.62 (OP5), B18.4 (OP5)
/OP6: B6.63 (OP6), B17.63 (OP6), B18.3 (OP6)
/OP7: B6.64 (OP7), B17.64 (OP7), B18.2 (OP7)
/Opcode Valid: B1.1 (Opcode_Valid), B17.7 (Opcode_Valid)
/PHI2: B1.39 (PHI2), B1.45 (DE), B13.35 (PHI2), B22.8 (PHI2)
/PI0: B6.32 (PID0), B14.24 (B3)
/PI1: B6.31 (PID1), B14.25 (B2)
/PI2: B6.30 (PID2), B14.26 (B1)
/PI3: B6.29 (PID3), B14.27 (B0)
/PI4: B6.28 (PID4), B16.15 (B11)
/PI5: B6.27 (PID5), B16.16 (B10)
/PI6: B6.26 (PID6), B16.17 (B9)
/PI7: B6.25 (PID7), B16.18 (B8)
/RDY: B13.43 (RDY)
/RTI: B6.11 (RTI), B11.26 (Set_Enable_NMI), R7.1
/R~W: B1.24 (R~W), B13.37 (R~W)
/SA0: B4.4 (A0), B14.39 (Q11)
/SA1: B4.5 (A1), B14.38 (Q10)
/SA2: B4.6 (A2), B14.37 (Q9)
/SA3: B4.8 (A3), B14.36 (Q8)
/SA4: B4.9 (A4), B14.35 (Q7)
/SA5: B4.10 (A5), B14.34 (Q6)
/SA6: B4.11 (A6), B14.33 (Q5)
/SA7: B4.12 (A7), B14.32 (Q4)
/SA8: B4.13 (A8), B14.31 (Q3)
/SA9: B4.14 (A9), B14.30 (Q2)
/SA10: B4.15 (A10), B14.29 (Q1)
/SA11: B4.17 (A11), B14.28 (Q0)
/SA12: B4.19 (A12), B16.39 (Q11)
/SA13: B4.20 (A13), B16.38 (Q10)
/SA14: B4.21 (A14), B16.37 (Q9)
/SA15: B4.22 (A15), B16.36 (Q8)
/SA16: B4.23 (A16), B16.35 (Q7)
/SA17: B4.24 (A17), B16.34 (Q6)
/SA18: B4.28 (A18), B16.33 (Q5)
/S~RAM: B4.41 (~RAM), B16.28 (Q0)
/S~RD: B4.26 (~RD), B16.31 (Q3)
/S~ROM: B4.43 (~ROM), B16.29 (Q1)
/S~WD: B4.27 (~WD), B16.30 (Q2)
/Timer Present: B10.22 (Presence), B20.15 (S0)
/VDA: B1.59 (VDA), B13.40 (VDA)
/VPA: B1.56 (VPA), B13.48 (VPA)
/W65C816V: B1.3 (5V), B1.35 (5V), B21.8 (W65C816V)
/X: B1.63 (X), B13.49 (X)
/~Board State: B5.2 (~Register10), B20.2 (~Board_State)
/~CHP: B22.15 (~CLK_High_Pulse), B23.11 (~CLK_High_Pulse)
/~CLK: B8.6 (S3_{IN}), B22.7 (~CLK)
/~Clear Counter: B5.1 (~Register11), B17.2 (~Clear_Counter)
/~Count Access_{0}: B5.53 (~Register12), B17.8 (~Count_Access_{0})
/~Count Access_{1}: B5.54 (~Register13), B17.9 (~Count_Access_{1})
/~Count Access_{2}: B5.55 (~Register14), B17.11 (~Count_Access_{2})
/~Count Access_{3}: B5.56 (~Register15), B17.12 (~Count_Access_{3})
/~Data Output: B1.58 (~DE), B19.9 (~Data_Output)
/~Device Interrupt_{ 1..7}: B5.14 (~Register0), B12.6 (~Device_Interrupt_{_1..7})
/~Device Interrupt_{ 16..19}: B5.12 (~Register2), B12.7 (~Device_Interrupt_{_16..19})
/~Device Reset/Enable_{ 1..7}: B3.25 (~Enables_1..7), B5.11 (~Register3), B12.8 (~Device_Enable_{_1..7})
/~Device Reset/Enable_{ 16..19}: B3.22 (~Enables_16..19), B5.8 (~Register5), B12.10 (~Device_Enable_{_16..19})
/~Interrupt Depth: B5.4 (~Register9), B6.9 (~Interrupt_Depth)
/~ML: B1.32 (~ML), B13.46 (~ML)
/~NMI State: B5.6 (~Register7), B11.23 (~NMI_State)
/~PHI2: B3.21 (~CLK), B6.5 (~PHI2), B14.2 (S), B16.2 (S), B17.4 (~PHI2), B19.3 (~PHI2), B22.20 (~PHI2)
/~Process ID: B5.5 (~Register8), B6.8 (~Process_ID)
/~RAM: B5.32 (~RAM), B16.14 (A0)
/~RD: B1.61 (~RD), B6.6 (~RD), B7.4 (~RD), B8.9 (~WD_{IN}), B8.31 (DIR), B10.3 (~RD), B11.3 (~RD), B12.9 (~RD), B15.4 (~RD), B16.11 (A3), B17.5 (~RD), B20.14 (~RD)
/~ROM: B5.33 (~ROM), B16.13 (A1)
/~Register: B4.47 (~Register), B5.28 (~Registers)
/~Timer Speed Select: B5.7 (~Register6), B10.7 (~NMI_Rate_Select)
/~Timer: B10.26 (~Set_Timer), B11.25 (~Set_Timer)
/~VP: B1.31 (~VP), B6.1 (~VP), B13.42 (~VP)
/~WD: B1.60 (~WD), B3.19 (~WD), B6.7 (~WD), B7.5 (~WD), B8.10 (~RD_{IN}), B10.4 (~WD), B11.4 (~WD), B15.6 (~WD), B16.12 (A2), B17.6 (~WD)
DA0: B9.21 (A0), J5.A4
DA1: B9.22 (A1), J5.A5
DA2: B9.24 (A2), J5.A6
DA3: B9.25 (A3), J5.A7
DA4: B9.26 (A4), J5.A8
DA5: B9.28 (A5), J5.A9
DA6: B9.29 (A6), J5.A10
DA7: B9.30 (A7), J5.A11
DA8: B9.32 (A8), J5.A12
DA9: B9.33 (A9), J5.A13
DA10: B9.35 (A10), J5.A14
DA11: B9.36 (A11), J5.A15
DA12: B9.37 (A12), J5.A16
DA13: B9.38 (A13), J5.A17
DA14: B9.39 (A14), J5.A18
DA15: B9.40 (A15), J5.A19
DA16: B8.40 (S7), J5.A20
DD0: B8.30 (D7), J5.A28
DD1: B8.29 (D6), J5.A27
DD2: B8.28 (D5), J5.A26
DD3: B8.26 (D4), J5.A25
DD4: B8.25 (D3), J5.A24
DD5: B8.24 (D2), J5.A23
DD6: B8.22 (D1), J5.A22
DD7: B8.21 (D0), J5.A21
Device CLK: B8.35 (S2), J5.B15
D~RD: B8.33 (~WD_{OUT}), J5.B13
D~WD: B8.32 (~RD_{OUT}), J5.B14
GND: B1.10 (GND), B1.23 (GND), B1.42 (GND), B1.55 (GND), B3.7 (GND), B3.14 (GND), B3.27 (GND), B3.34 (GND), B4.7 (GND), B4.18 (GND), B4.31 (GND), B4.42 (GND), B5.9 (GND), B5.20 (GND), B5.37 (GND), B5.48 (GND), B6.10 (GND), B6.23 (GND), B6.42 (GND), B6.55 (GND), B7.10 (GND), B7.23 (GND), B7.42 (GND), B7.55 (GND), B8.7 (GND), B8.14 (GND), B8.27 (GND), B8.34 (GND), B9.7 (GND), B9.14 (GND), B9.27 (GND), B9.34 (GND), B10.5 (GND), B10.12 (GND), B10.21 (GND), B10.28 (GND), B11.5 (GND), B11.12 (GND), B11.21 (GND), B11.28 (GND), B12.21 (GND), B12.40 (GND), B13.34 (GND), B14.1 (~E), B14.40 (GND), B15.5 (GND), B15.12 (GND), B15.21 (GND), B15.28 (GND), B16.1 (~E), B16.10 (A4), B16.23 (B4), B16.24 (B3), B16.27 (B0), B16.40 (GND), B17.10 (GND), B17.23 (GND), B17.42 (GND), B17.55 (GND), B18.10 (GND), B18.27 (GND), B18.28 (GND), B18.29 (GND), B18.30 (GND), B18.31 (GND), B18.32 (GND), B18.33 (GND), B18.34 (GND), B19.12 (GND), B20.4 (GND), B20.9 (GND), B20.16 (GND), B20.21 (GND), B20.28 (S11), B21.3 (GND), B21.10 (GND), B22.4 (GND), B22.9 (GND), B22.16 (GND), B22.21 (GND), B23.4 (GND), B23.8 (Hold3), B23.9 (GND), B23.16 (GND), B23.21 (GND), C1.2, C2.2, C3.2, C4.2, C11.2, H8.1 (GND_1), H9.1 (GND_1), H16.1 (GND_1), IC2.2 (GND), IC3.1 (GND), J1.2, J1.23, J1.36, J2.1, J5.B2, J5.B10, J5.B17, J5.B24, J5.B31, J5.D9, J5.D18, LED2.1 (K), R6.2, R7.2
HD0: B8.2 (S6_{IN}), J5.A31
HD1: B8.4 (S5_{IN}), J5.A30
HD2: B8.5 (S4_{IN}), J5.A29
Kernal: B5.35 (Kernal_Mode), B6.53 (Kernal_Mode), J5.A3, R1.1
MA0: B7.59 (MA23), J5.D17
MA1: B7.58 (MA22), J5.D16
MA2: B7.57 (MA21), J5.D15
MA3: B7.56 (MA20), J5.D14
MA4: B7.54 (MA19), J5.D13
MA5: B7.53 (MA18), J5.D12
MA6: B7.52 (MA17), J5.C18
MA7: B7.51 (MA16), J5.C17
MA8: B7.50 (MA15), J5.C16
MA9: B7.49 (MA14), J5.C15
MA10: B7.48 (MA13), J5.C14
MA11: B7.47 (MA12), J5.C13
MA12: B7.46 (MA11), J5.C12
MA13: B7.45 (MA10), J5.C11
MA14: B7.44 (MA9), J5.C10
MA15: B7.43 (MA8), J5.C9
MA16: B7.41 (MA7), J5.C8
MA17: B7.40 (MA6), J5.C7
MA18: B7.39 (MA5), J5.C6
MA19: B7.38 (MA4), J5.C5
MA20: B7.37 (MA3), J5.C4
MA21: B7.36 (MA2), J5.C3
MA22: B7.34 (MA1), J5.C2
MA23: B7.33 (MA0), J5.C1
MD0: B15.26 (MD7), J5.D8
MD1: B15.25 (MD6), J5.D7
MD2: B15.24 (MD5), J5.D6
MD3: B15.23 (MD4), J5.D5
MD4: B15.22 (MD3), J5.D4
MD5: B15.20 (MD2), J5.D3
MD6: B15.19 (MD1), J5.D2
MD7: B15.18 (MD0), J5.D1
MPU0: B11.7 (MPU0), J5.B8
MPU1: B11.6 (MPU1), J5.B7
Main CLK: B22.6 (CLK_IN), J2.3, J5.B3
Native Latch: B1.57 (Native_Latch), B5.30 (Native_Latch), B6.2 (Native_Latch), B10.18 (~Hold), J5.B12
unnamed: LED2.2 (A), R3.1
Watchdog CLK: B10.6 (CLK), J2.6, J5.B30
~ABORT: B1.44 (~ABORT), B13.44 (~ABORT), J5.B6
~Device CLK: B8.36 (S3), J5.B16
~Device: B5.29 (~Devices), B8.11 (~CS), B9.11 (~CS), J5.A2
~Enable DEV1: B12.31 (~Enable_{Device}1), J1.34, RN8.5 (R4)
~Enable DEV2: B12.30 (~Enable_{Device}2), J1.32, RN8.6 (R5)
~Enable DEV3: B12.29 (~Enable_{Device}3), J1.30, RN8.7 (R6)
~Enable DEV4: B12.28 (~Enable_{Device}4), J1.28, RN8.8 (R7)
~Enable DEV5: B12.27 (~Enable_{Device}5), J1.26, RN8.9 (R8)
~Enable DEV6: B12.26 (~Enable_{Device}6), J1.35, RN9.2 (R1)
~Enable DEV7: B12.25 (~Enable_{Device}7), J1.33, RN9.3 (R2)
~Enable DEV16: B12.24 (~Enable_{Device}16), J1.31, RN9.4 (R3)
~Enable DEV17: B12.23 (~Enable_{Device}17), J1.29, RN9.5 (R4)
~Enable DEV18: B12.22 (~Enable_{Device}18), J1.27, RN9.6 (R5)
~Enable DEV19: B12.19 (~Enable_{Device}19), J1.25, RN9.7 (R6)
~IRQ: B1.43 (~IRQ), B12.39 (~INT), B13.45 (~IRQ), J2.2
~Interrupt DEV1: B12.4 (~Interrupt_{Device}1), J1.1, RN7.2 (R1)
~Interrupt DEV2: B12.3 (~Interrupt_{Device}2), J1.3, RN7.3 (R2)
~Interrupt DEV3: B12.2 (~Interrupt_{Device}3), J1.5, RN7.4 (R3)
~Interrupt DEV4: B12.1 (~Interrupt_{Device}4), J1.7, RN7.5 (R4)
~Interrupt DEV5: B12.38 (~Interrupt_{Device}5), J1.9, RN7.6 (R5)
~Interrupt DEV6: B12.37 (~Interrupt_{Device}6), J1.11, RN7.7 (R6)
~Interrupt DEV7: B12.36 (~Interrupt_{Device}7), J1.13, RN7.8 (R7)
~Interrupt DEV16: B12.35 (~Interrupt_{Device}16), J1.15, RN7.9 (R8)
~Interrupt DEV17: B12.34 (~Interrupt_{Device}17), J1.17, RN8.2 (R1)
~Interrupt DEV18: B12.33 (~Interrupt_{Device}18), J1.19, RN8.3 (R2)
~Interrupt DEV19: B12.32 (~Interrupt_{Device}19), J1.21, RN8.4 (R3)
~Main Access: B7.1 (~Main_Access), B15.2 (~Main_Access), J5.B11
~Main RD: B7.60 (M~WD), J5.D10
~Main WD: B7.61 (M~RD), J5.D11
~Main: B4.48 (~Main), B5.38 (~Main), B7.2 (~Main), B15.3 (~Main), J5.B9
~NMI: B1.41 (~NMI), B11.32 (~NMI), B13.47 (~NMI), J2.5
~NMI_{1}: B11.29 (~Set_Break_1), J5.B4
~NMI_{2}: B11.30 (~Set_Break_2), J5.B5
~Reset: B1.40 (~Reset), B3.40 (~Reset), B5.26 (~Reset), B6.4 (~Reset), B10.2 (~Reset), B11.2 (~Reset), B13.41 (~RES), B17.1 (~Reset), B22.23 (~Reset), J2.4, J5.A1
~Reset DEV1: B3.1 (~Reset_1), J1.24
~Reset DEV2: B3.2 (~Reset_2), J1.22
~Reset DEV3: B3.4 (~Reset_3), J1.20
~Reset DEV4: B3.36 (~Reset_4), J1.18
~Reset DEV5: B3.37 (~Reset_5), J1.16
~Reset DEV6: B3.38 (~Reset_6), J1.14
~Reset DEV7: B3.39 (~Reset_7), J1.12
~Reset DEV16: B3.30 (~Reset_16), J1.10
~Reset DEV17: B3.29 (~Reset_17), J1.8
~Reset DEV18: B3.28 (~Reset_18), J1.6
~Reset DEV19: B3.26 (~Reset_19), J1.4
~Select DEV1: B5.27 (~Device1), J5.B29
~Select DEV2: B5.25 (~Device2), J5.B28
~Select DEV3: B5.24 (~Device3), J5.B27
~Select DEV4: B5.23 (~Device4), J5.B26
~Select DEV5: B5.22 (~Device5), J5.B25
~Select DEV6: B5.21 (~Device6), J5.B23
~Select DEV7: B5.19 (~Device7), J5.B22
~Select DEV16: B5.18 (~Device16), J5.B21
~Select DEV17: B5.17 (~Device17), J5.B20
~Select DEV18: B5.16 (~Device18), J5.B19
~Select DEV19: B5.15 (~Device19), J5.B18

Notes on the sheet:
~{RAM} and ~{ROM} are reversed before Native Latch is set. This allows the '816 to initially boot from ROM; the first step which is to copy the 512KB ROM into the 512KB RAM before switching out of emulation mode.
The Clock Hold bus for Register access and Main Memory access is also set here. For better or worse. That is why ~{Register} and ~{Main} are passed in.
Selector: 1 1 1 PI(0..7) A(23..16) Final address: 18.16 15.....8 7.......0 Selector: A(18..0) Final address: 18.....0
Main Access
Board Presence
If Main Memory Mode is required then include: Main Memory Data (B15) Main Memory Address (B7) If Main Memory Mode is not required then ommit: Main Memory Data (B15) Main Memory Address (B7) Main memory must not be read from if ommitted
MPU Timer (B10) can be ommitted
Processor
(PI A18)
Privilege
Debug
MPU NMI (B11) can be ommitted
If no devices connected then ommit Device Reset (B3)
(PI ~{WD})
If no devices connected then ommit Device Address Buffer (B9)
BE and RDY are not used and are tied to 3.3V. BE works exactly as expected on the 5V address bus, 5V bank address bus and on the 3.3V translated data bus. Also on R~{W}, ~{RD} and ~{WD}. DE must be high and ~{DE} must be low for the 3.3V data bus to be driven. Typically ~{DE} must be tied to ~{PHI2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
Watchdog
Pratically this means a value is read from the address given by the Program Identifier and the Bank Address at the top of the 512KB memory. The value read is latched as a Bank Address override allowing each process to be given its own bank 0, 1, 2 etc... This bank remapping only applies when not in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
PHI2 low puts addresses onto the onboard memory address bus.
Socket
Local Memory
PHI2 high puts addresses onto the onboard memory address bus.
When in Kernal mode (protected mode) device decoding is done. That includes on-board registers as device 0. Main memory above 2MB is accessible, main memory below 2MB is not accessible to the Kernal. When not in Kernal Mode no device decoding is done and all of main memory is accessible to User pro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
If no devices connected then ommit Device Data Buffer (B8)
Power
(PI A16)
Device Access
(PI A17)
(PI ~{RD})
Address Decode
If no devices connected then ommit Device Interrupts (B12)
(PI ~{RAM_{CS}})
If Kernal Mode is required then include: Kernal Mode (B6) Selector 12bit (B14) Selector 12bit (B16) and ommit: 0Ω resistors tying A0 to SA0 ... ~{RAM_{CS}} to S~{RAM} If Kernal Mode is not required then include: 0Ω resistors tying A0 to SA0 ... ~{RAM_{CS}} to S~{RAM} and ommit: Kernal Mode (B6) Sel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
Instruction Code (B17) can be ommitted
(PI ~{ROM_{CS}})

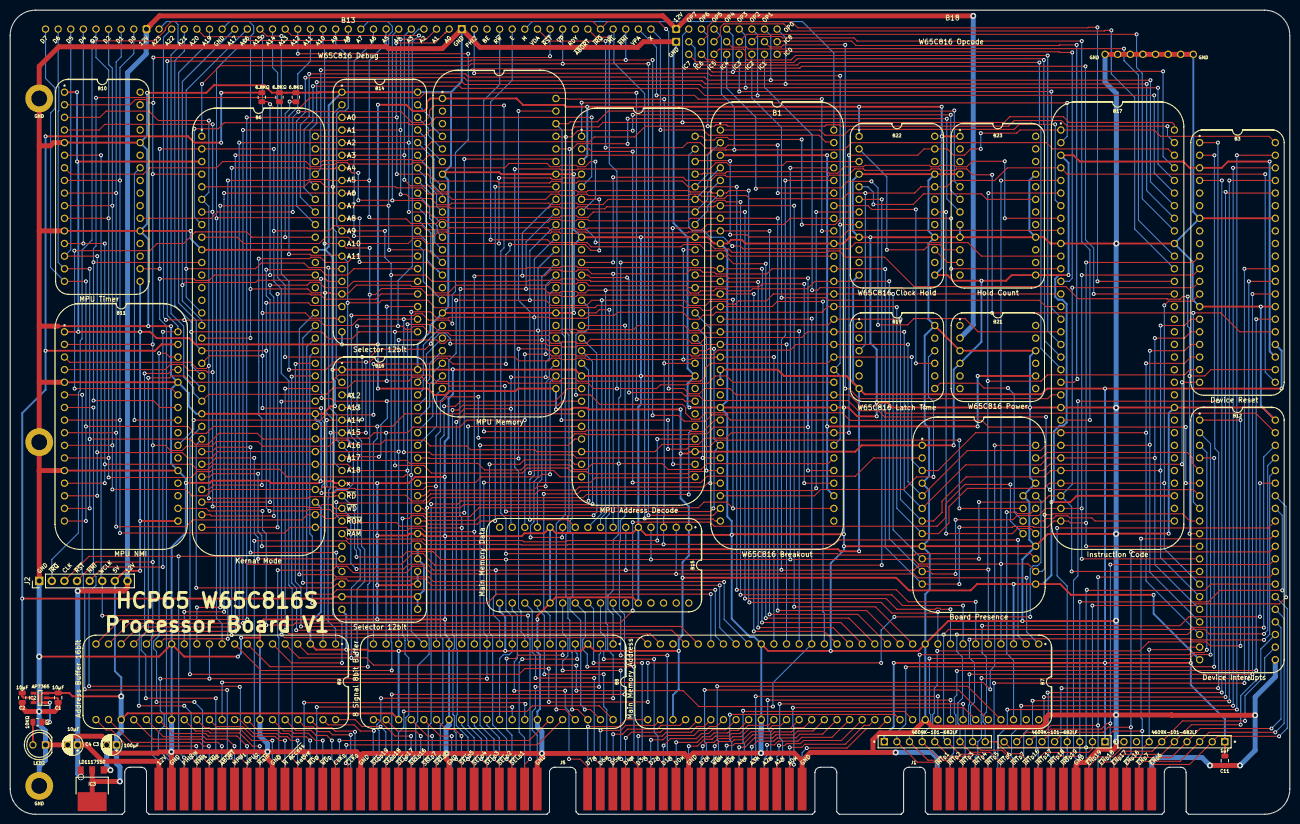
[picture p180: board Processor Board.kicad_pcb from above]

Board: 2 copper layers, 257.7 x 161.9 mm, 43 parts (0 on the bottom side), 280 nets.
