andrewpaterson/HCP65/Kicad/Computer/Video/Video DAC/Video DAC.kicad_pcb

## KiCad design Kicad/Computer/Video/Video DAC/Video DAC.kicad_pcb (2026-11-01)

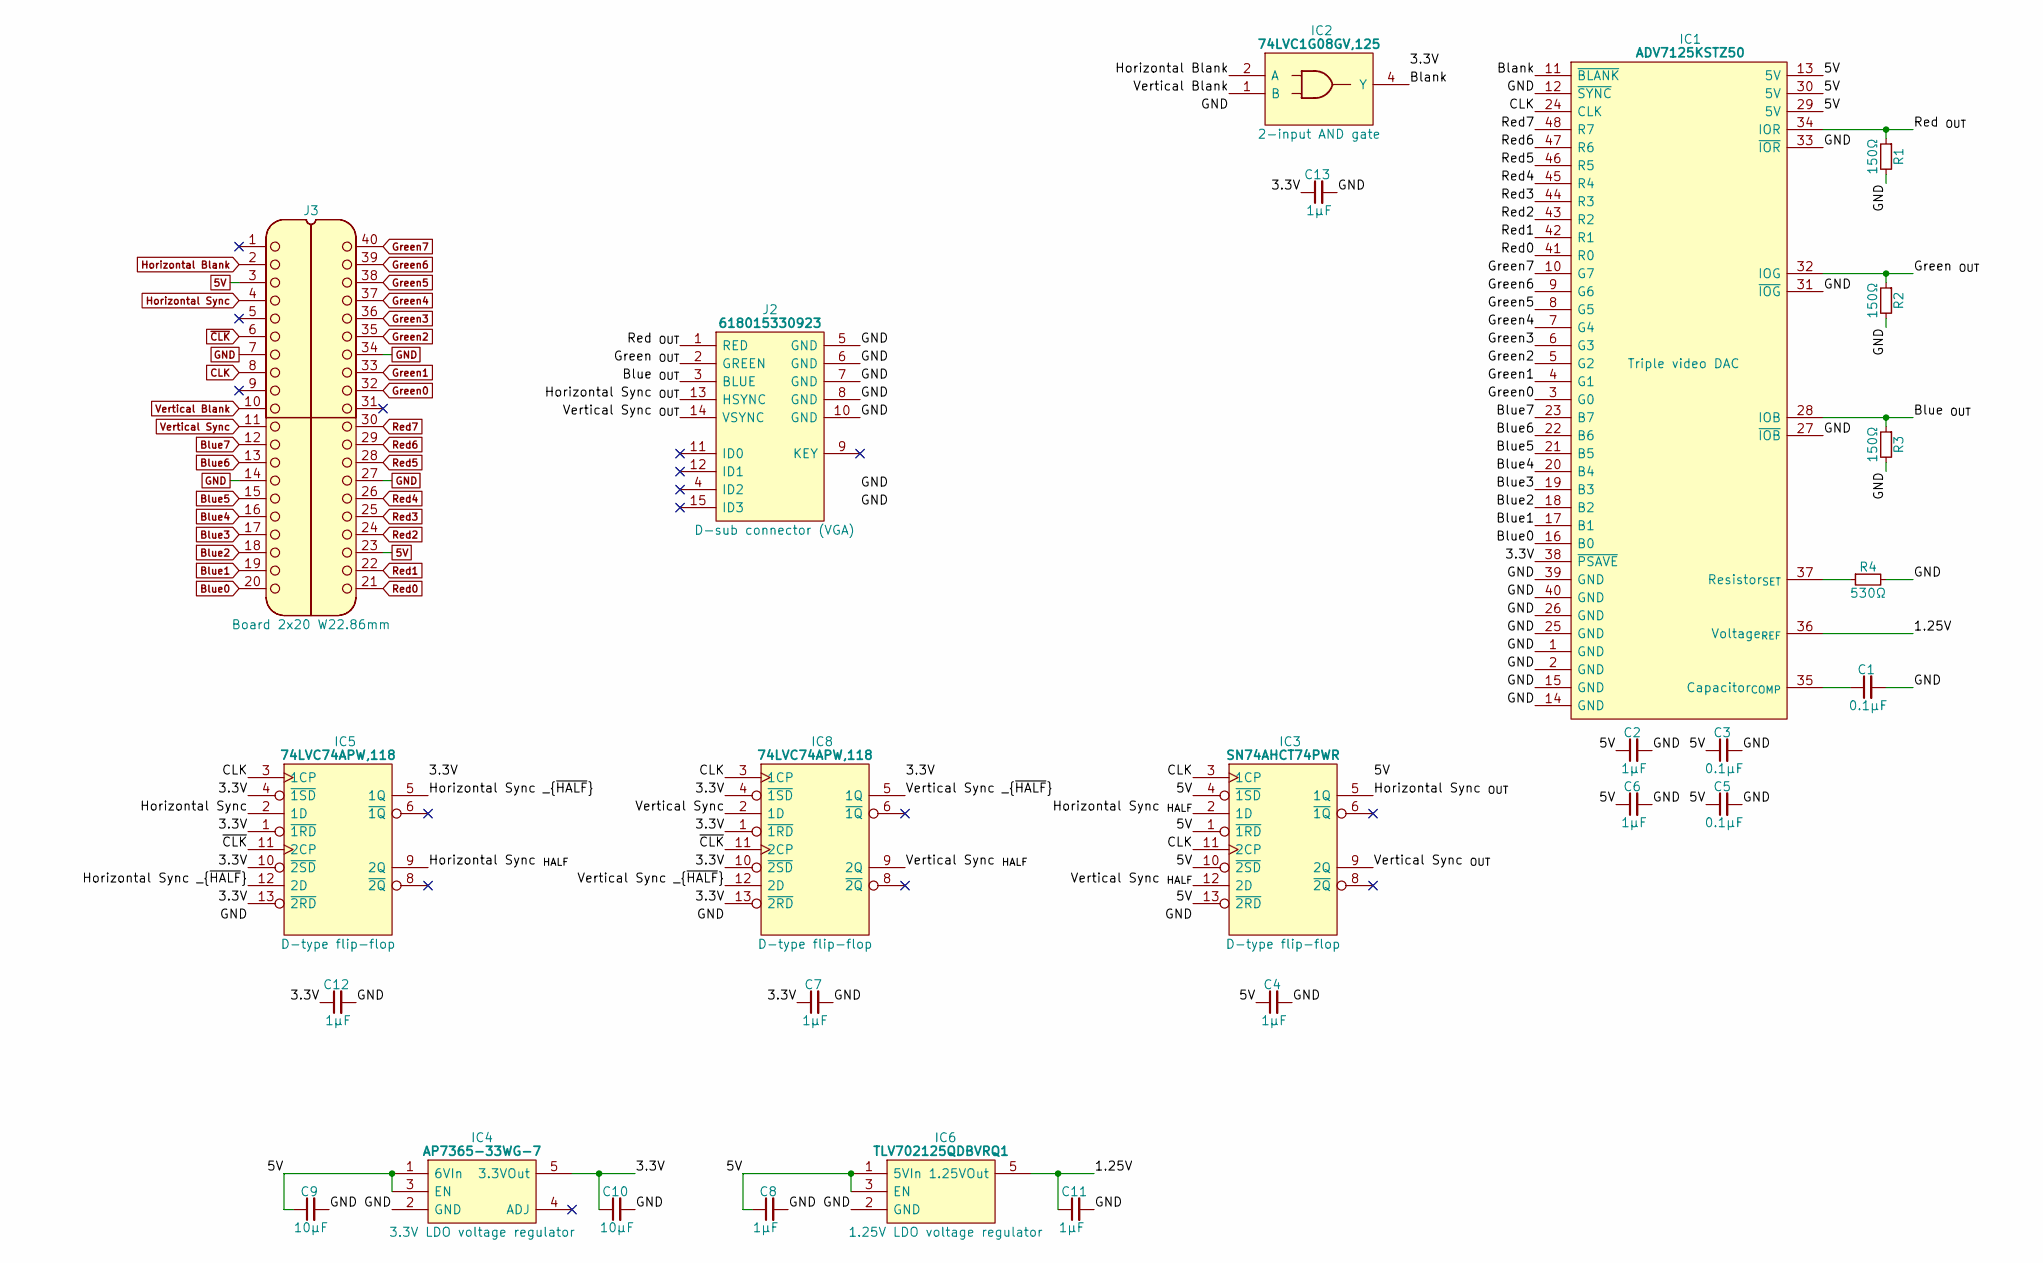
[picture p188: schematic Video DAC.kicad_sch]

Parts:
C1, C3, C5: 0.1μF; C_0805
C2, C4, C6, C7, C12, C13: 1μF; C_0805
C8, C11: 1µF; C_0805
C9, C10: 10µF; C_0805
IC1: ADV7125KSTZ50; QFP50P900X900X160-48N; Mouser Part Number 584-ADV7125KSTZ50
IC2: 74LVC1G08GV,125; SOT95P275X110-5N; Manufacturer_Part_Number 74LVC1G08GV,125; Mouser Part Number 771-74LVC1G08GV
IC3: SN74AHCT74PWR; SOP65P640X110-14N; Mouser Part Number 595-SN74AHCT74PWR
IC4: AP7365-33WG-7; SOT95P285X130-5N; Manufacturer_Part_Number AP7365-33WG-7; Mouser Part Number 621-AP7365-33WG-7
IC5, IC8: 74LVC74APW,118; SOP65P640X110-14N; Mouser Part Number 771-74LVC74APW-T
IC6: TLV702125QDBVRQ1; SOT95P280X145-5N; Manufacturer_Part_Number TLV702125QDBVRQ1; Mouser Part Number 595-TLV702125QDBVRQ1
J2: 618015330923; Manufacturer_Part_Number 618015330923; Mouser Part Number 710-618015330923
J3: Board 2x20 W22.86mm; DIP-40_Board_W22.86mm_Nak
R1, R2, R3: 150Ω; R_0805
R4: 530Ω; R_0805

Connections:
5V: C2.1, C3.1, C4.1, C5.1, C6.1, C8.1, C9.1, IC1.13 (5V), IC1.29 (5V), IC1.30 (5V), IC3.1 (~1RD), IC3.4 (~1SD), IC3.10 (~2SD), IC3.13 (~2RD), IC3.14 (5V), IC4.1 (6VIn), IC4.3 (EN), IC6.1 (5VIn), IC6.3 (EN), J3.3, J3.23
/1.25V: C11.1, IC1.36 (Voltage_{REF}), IC6.5 (1.25VOut)
/3.3V: C7.1, C10.1, C12.1, C13.1, IC1.38 (~PSAVE), IC2.5 (3V), IC4.5 (3.3VOut), IC5.1 (~1RD), IC5.4 (~1SD), IC5.10 (~2SD), IC5.13 (~2RD), IC5.14 (3V), IC8.1 (~1RD), IC8.4 (~1SD), IC8.10 (~2SD), IC8.13 (~2RD), IC8.14 (3V)
/Blank: IC1.11 (~BLANK), IC2.4 (Y)
/Blue _{OUT}: IC1.28 (IOB), J2.3 (BLUE), R3.1
/Green _{OUT}: IC1.32 (IOG), J2.2 (GREEN), R2.1
/Horizontal Sync _{HALF}: IC3.2 (1D), IC5.9 (2Q)
/Horizontal Sync _{OUT}: IC3.5 (1Q), J2.13 (HSYNC)
/Horizontal Sync _{~HALF}: IC5.5 (1Q), IC5.12 (2D)
/Red _{OUT}: IC1.34 (IOR), J2.1 (RED), R1.1
/Vertical Sync _{HALF}: IC3.12 (2D), IC8.9 (2Q)
/Vertical Sync _{OUT}: IC3.9 (2Q), J2.14 (VSYNC)
/Vertical Sync _{~HALF}: IC8.5 (1Q), IC8.12 (2D)
Blue0: IC1.16 (B0), J3.20
Blue1: IC1.17 (B1), J3.19
Blue2: IC1.18 (B2), J3.18
Blue3: IC1.19 (B3), J3.17
Blue4: IC1.20 (B4), J3.16
Blue5: IC1.21 (B5), J3.15
Blue6: IC1.22 (B6), J3.13
Blue7: IC1.23 (B7), J3.12
CLK: IC1.24 (CLK), IC3.3 (1CP), IC3.11 (2CP), IC5.3 (1CP), IC8.3 (1CP), J3.8
GND: C1.2, C2.2, C3.2, C4.2, C5.2, C6.2, C7.2, C8.2, C9.2, C10.2, C11.2, C12.2, C13.2, IC1.1 (GND), IC1.2 (GND), IC1.12 (~SYNC), IC1.14 (GND), IC1.15 (GND), IC1.25 (GND), IC1.26 (GND), IC1.27 (~IOB), IC1.31 (~IOG), IC1.33 (~IOR), IC1.39 (GND), IC1.40 (GND), IC2.3 (GND), IC3.7 (GND), IC4.2 (GND), IC5.7 (GND), IC6.2 (GND), IC8.7 (GND), J2.5 (GND), J2.6 (GND), J2.7 (GND), J2.8 (GND), J2.10 (GND), J2.MH1, J2.MH2, J3.7, J3.14, J3.27, J3.34, R1.2, R2.2, R3.2, R4.2
Green0: IC1.3 (G0), J3.32
Green1: IC1.4 (G1), J3.33
Green2: IC1.5 (G2), J3.35
Green3: IC1.6 (G3), J3.36
Green4: IC1.7 (G4), J3.37
Green5: IC1.8 (G5), J3.38
Green6: IC1.9 (G6), J3.39
Green7: IC1.10 (G7), J3.40
Horizontal Blank: IC2.2 (A), J3.2
Horizontal Sync: IC5.2 (1D), J3.4
unnamed: C1.1, IC1.35 (Capacitor_{COMP})
unnamed: IC1.37 (Resistor_{SET}), R4.1
Red0: IC1.41 (R0), J3.21
Red1: IC1.42 (R1), J3.22
Red2: IC1.43 (R2), J3.24
Red3: IC1.44 (R3), J3.25
Red4: IC1.45 (R4), J3.26
Red5: IC1.46 (R5), J3.28
Red6: IC1.47 (R6), J3.29
Red7: IC1.48 (R7), J3.30
Vertical Blank: IC2.1 (B), J3.10
Vertical Sync: IC8.2 (1D), J3.11
~CLK: IC5.11 (2CP), IC8.11 (2CP), J3.6

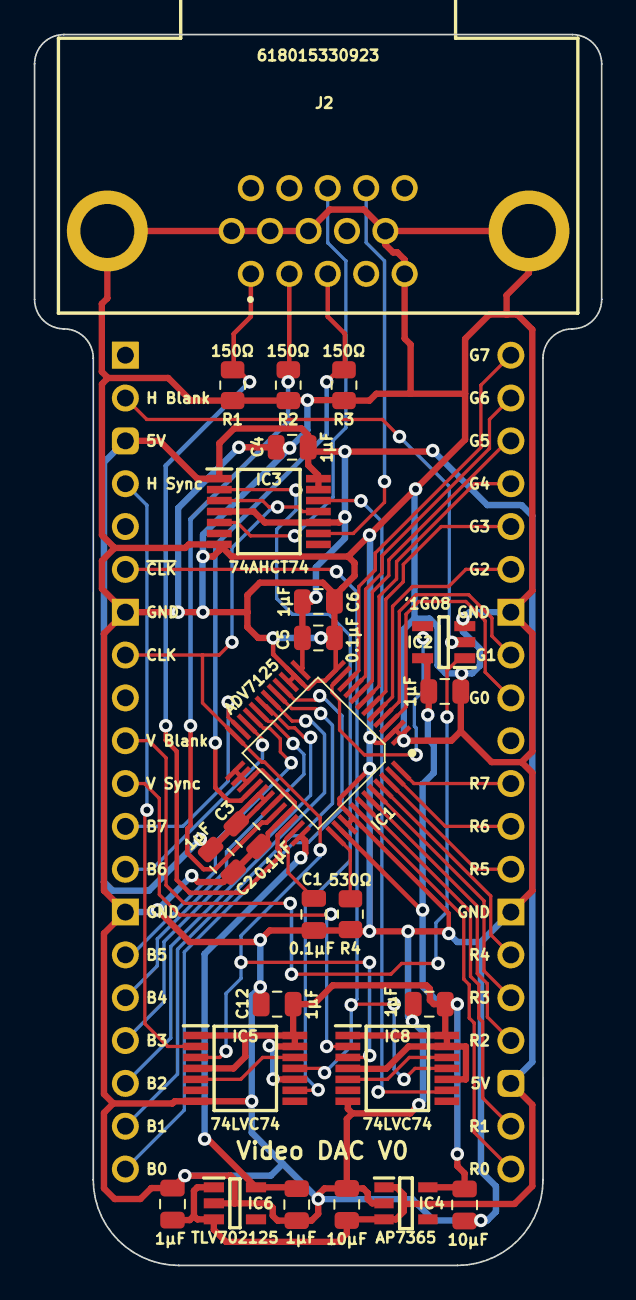
[picture p189: board Video DAC.kicad_pcb from above]

Board: 2 copper layers, 33.6 x 73.0 mm, 26 parts (0 on the bottom side), 46 nets.
