andrewpaterson/HCP65/Kicad/Computer/Component Boards/Clock Transition/Clock Transition.kicad_pcb

## KiCad design Kicad/Computer/Component Boards/Clock Transition/Clock Transition.kicad_pcb (2026-11-01)

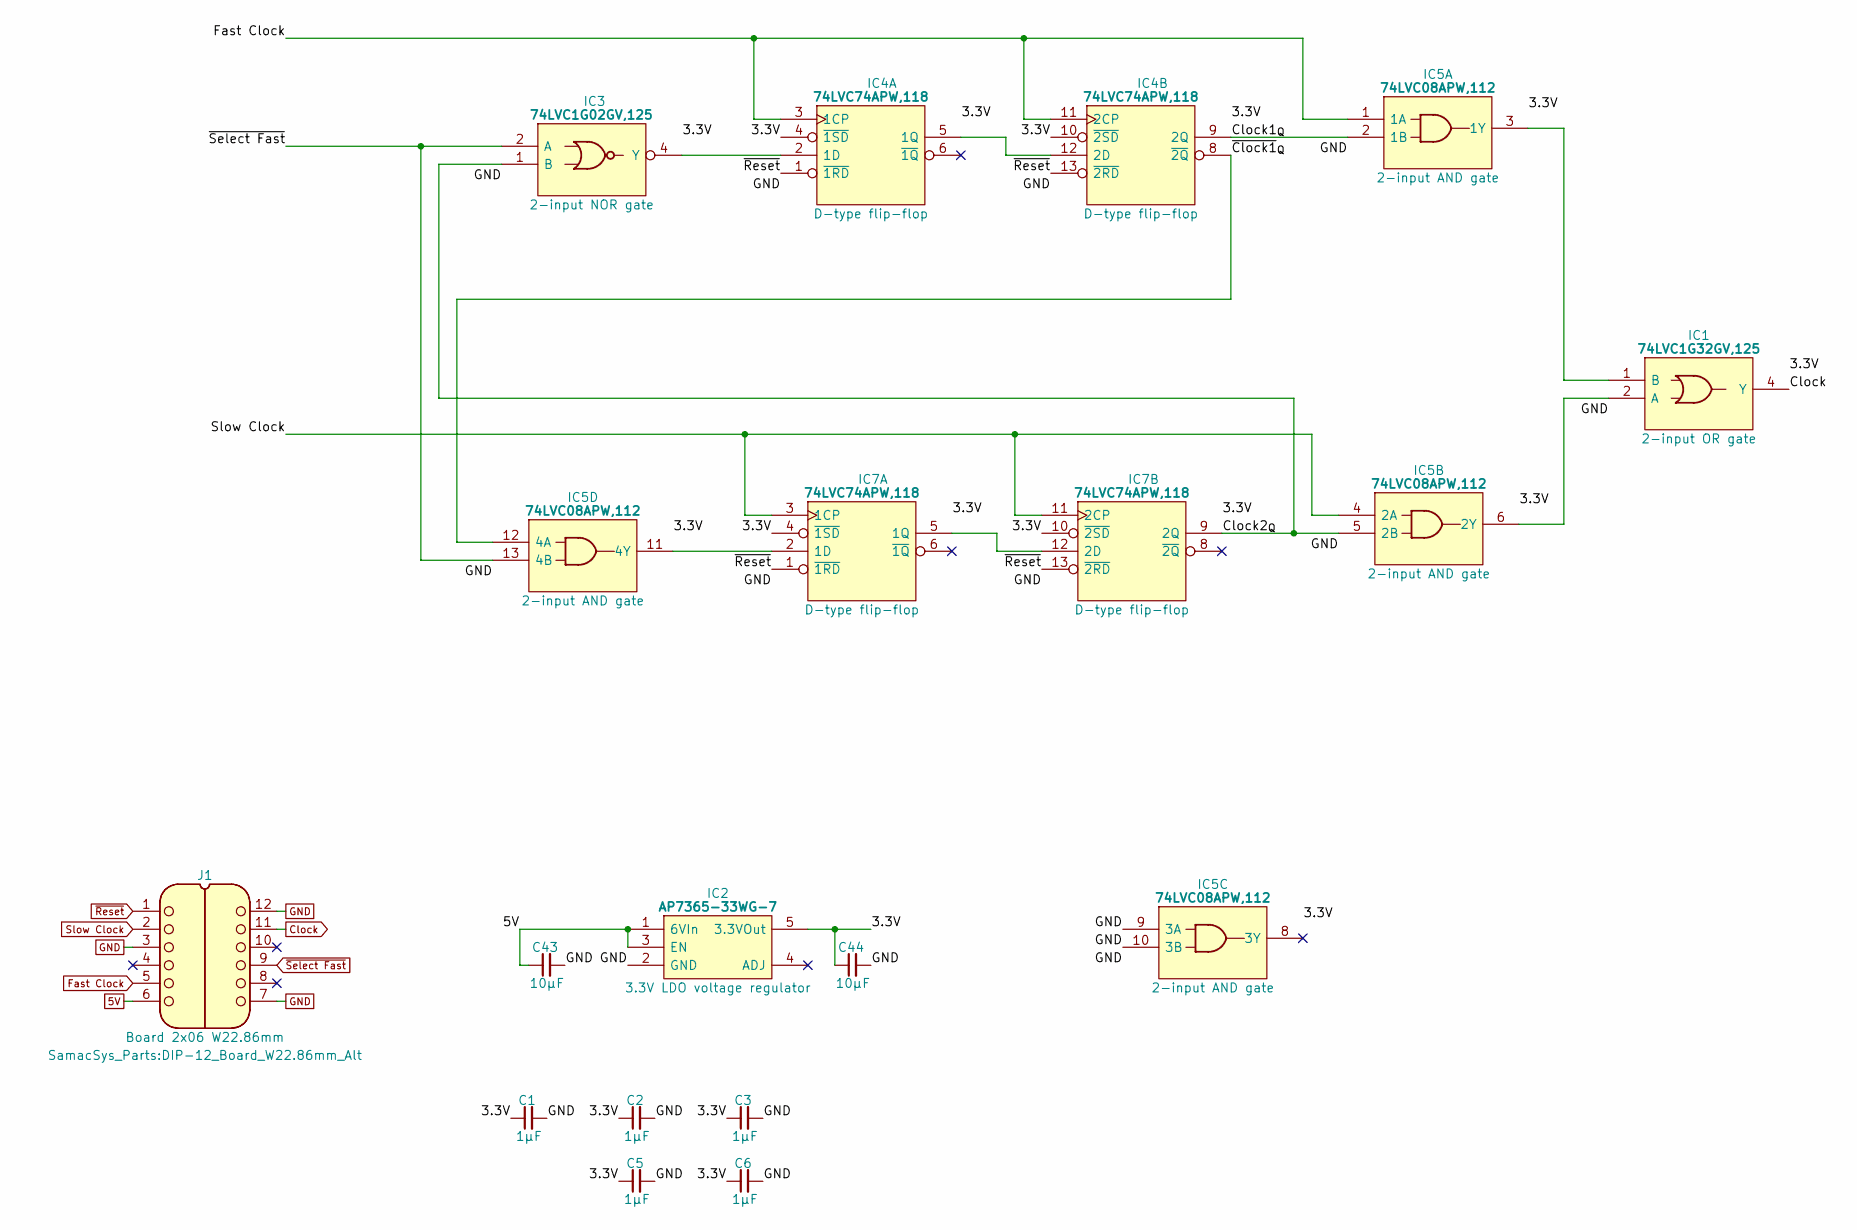
[picture p190: schematic Clock Transition.kicad_sch, HCP65 Clock Transition]

Parts:
C1, C2, C3, C5, C6: 1μF; C_0805
C43, C44: 10μF; C_0805
IC1: 74LVC1G32GV,125; SOT95P275X110-5N; Manufacturer_Part_Number 74LVC1G32GV,125; Mouser Part Number 771-LVC1G32GV125
IC2: AP7365-33WG-7; SOT95P285X130-5N; Manufacturer_Part_Number AP7365-33WG-7; Mouser Part Number 621-AP7365-33WG-7
IC3: 74LVC1G02GV,125; SOT95P275X110-5N; Manufacturer_Part_Number 74LVC1G02GV,125; Mouser Part Number 771-LVC1G02GV125
IC4, IC7: 74LVC74APW,118; SOP65P640X110-14N; Mouser Part Number 771-74LVC74APW-T
IC5: 74LVC08APW,112; SOP65P640X110-14N; Manufacturer_Part_Number 74LVC08APW,112; Mouser Part Number 771-74LVC08APW
J1: Board 2x06 W22.86mm; DIP-12_Board_W22.86mm_Alt

Connections:
5V: C43.1, IC2.1 (6VIn), IC2.3 (EN), J1.6
/3.3V: C1.1, C2.1, C3.1, C5.1, C6.1, C44.1, IC1.5 (3V), IC2.5 (3.3VOut), IC3.5 (3V), IC4.4 (~1SD), IC4.10 (~2SD), IC4.14 (3V), IC5.14 (3V), IC7.4 (~1SD), IC7.10 (~2SD), IC7.14 (3V)
/Clock1_{Q}: IC4.9 (2Q), IC5.2 (1B)
/Clock2_{Q}: IC3.1 (B), IC5.5 (2B), IC7.9 (2Q)
/~Clock1_{Q}: IC4.8 (~2Q), IC5.12 (4A)
Clock: IC1.4 (Y), J1.11
Fast Clock: IC4.3 (1CP), IC4.11 (2CP), IC5.1 (1A), J1.5
GND: C1.2, C2.2, C3.2, C5.2, C6.2, C43.2, C44.2, IC1.3 (GND), IC2.2 (GND), IC3.3 (GND), IC4.7 (GND), IC5.7 (GND), IC5.9 (3A), IC5.10 (3B), IC7.7 (GND), J1.3, J1.7, J1.12
unnamed: IC1.2 (A), IC5.6 (2Y)
unnamed: IC1.1 (B), IC5.3 (1Y)
unnamed: IC3.4 (Y), IC4.2 (1D)
unnamed: IC4.5 (1Q), IC4.12 (2D)
unnamed: IC5.11 (4Y), IC7.2 (1D)
unnamed: IC7.5 (1Q), IC7.12 (2D)
Slow Clock: IC5.4 (2A), IC7.3 (1CP), IC7.11 (2CP), J1.2
~Reset: IC4.1 (~1RD), IC4.13 (~2RD), IC7.1 (~1RD), IC7.13 (~2RD), J1.1
~Select Fast: IC3.2 (A), IC5.13 (4B), J1.9

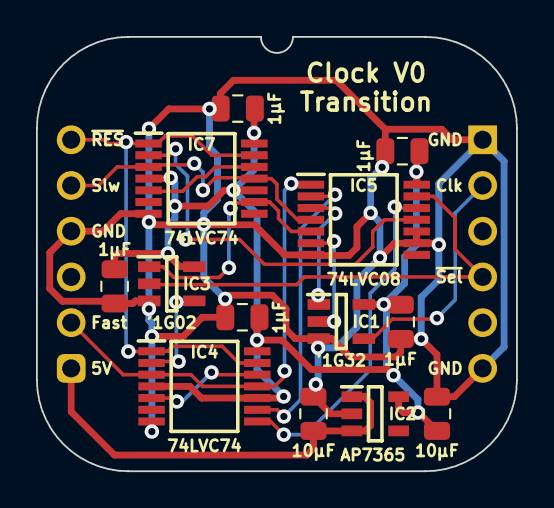
[picture p191: board Clock Transition.kicad_pcb from above]

Board: 2 copper layers, 26.7 x 24.1 mm, 14 parts (0 on the bottom side), 17 nets.
