andrewpaterson/HCP65/Kicad/Computer/Coprocessor/Coprocessor Transceiver/Coprocessor Transceiver.kicad_pcb

## KiCad design Kicad/Computer/Coprocessor/Coprocessor Transceiver/Coprocessor Transceiver.kicad_pcb (2026-11-01)

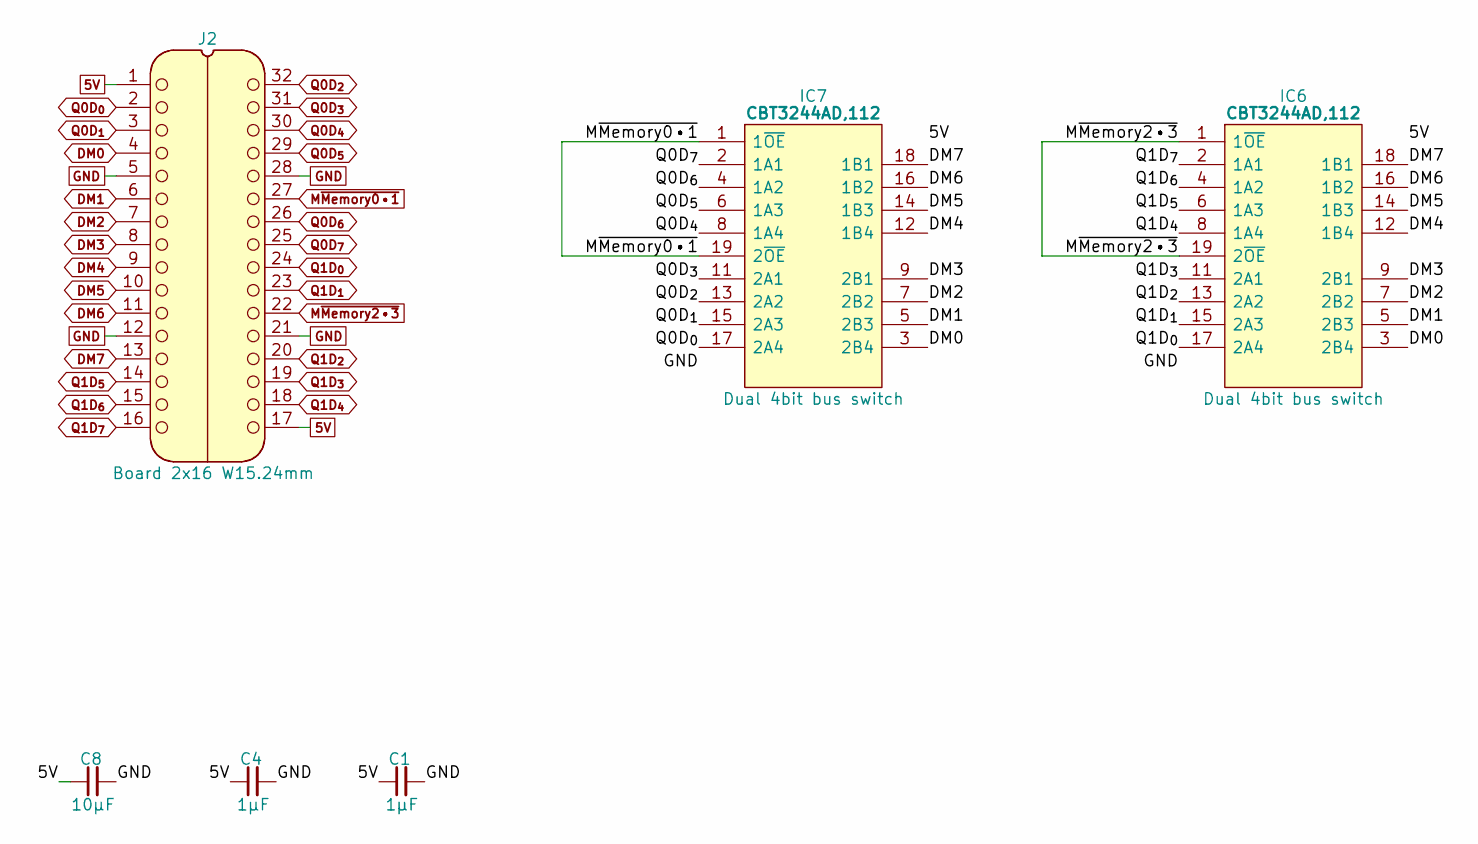
[picture p192: schematic Coprocessor Transceiver.kicad_sch]

Parts:
C1, C4: 1μF; C_0805
C8: 10µF; C_0805
IC6, IC7: CBT3244AD,112; SOIC127P1032X265-20N; Manufacturer_Part_Number CBT3244AD,112; Mouser Part Number 771-CBT3244AD
J2: Board 2x16 W15.24mm; DIP-32_Board_W15.24mm

Connections:
5V: C1.1, C4.1, C8.1, IC6.20 (5V), IC7.20 (5V), J2.1, J2.17
DM0: IC6.3 (2B4), IC7.3 (2B4), J2.4
DM1: IC6.5 (2B3), IC7.5 (2B3), J2.6
DM2: IC6.7 (2B2), IC7.7 (2B2), J2.7
DM3: IC6.9 (2B1), IC7.9 (2B1), J2.8
DM4: IC6.12 (1B4), IC7.12 (1B4), J2.9
DM5: IC6.14 (1B3), IC7.14 (1B3), J2.10
DM6: IC6.16 (1B2), IC7.16 (1B2), J2.11
DM7: IC6.18 (1B1), IC7.18 (1B1), J2.13
GND: C1.2, C4.2, C8.2, IC6.10 (GND), IC7.10 (GND), J2.5, J2.12, J2.21, J2.28
M~Memory0•1: IC7.1 (1~OE), IC7.19 (2~OE), J2.27
M~Memory2•3: IC6.1 (1~OE), IC6.19 (2~OE), J2.22
Q0D_{0}: IC7.17 (2A4), J2.2
Q0D_{1}: IC7.15 (2A3), J2.3
Q0D_{2}: IC7.13 (2A2), J2.32
Q0D_{3}: IC7.11 (2A1), J2.31
Q0D_{4}: IC7.8 (1A4), J2.30
Q0D_{5}: IC7.6 (1A3), J2.29
Q0D_{6}: IC7.4 (1A2), J2.26
Q0D_{7}: IC7.2 (1A1), J2.25
Q1D_{0}: IC6.17 (2A4), J2.24
Q1D_{1}: IC6.15 (2A3), J2.23
Q1D_{2}: IC6.13 (2A2), J2.20
Q1D_{3}: IC6.11 (2A1), J2.19
Q1D_{4}: IC6.8 (1A4), J2.18
Q1D_{5}: IC6.6 (1A3), J2.14
Q1D_{6}: IC6.4 (1A2), J2.15
Q1D_{7}: IC6.2 (1A1), J2.16

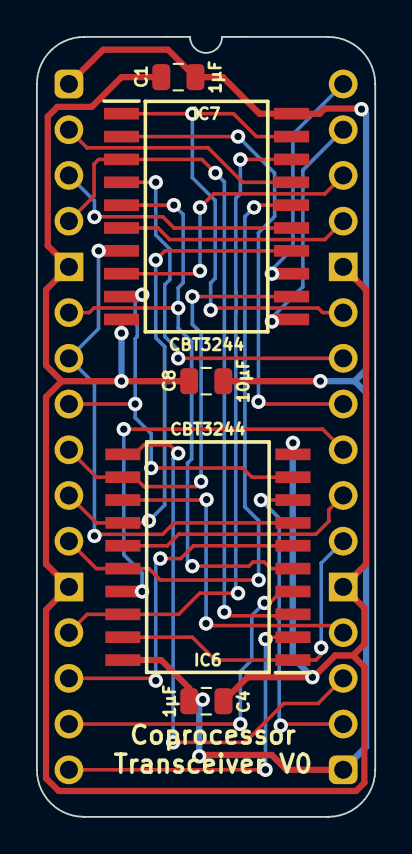
[picture p193: board Coprocessor Transceiver.kicad_pcb from above]

Board: 2 copper layers, 18.8 x 43.3 mm, 6 parts (0 on the bottom side), 28 nets.
