andrewpaterson/HCP65/Kicad/Computer/Processor/HCP65 Device Reset/HCP65 Device Reset.kicad_pcb

## KiCad design Kicad/Computer/Processor/HCP65 Device Reset/HCP65 Device Reset.kicad_pcb (2026-11-01)

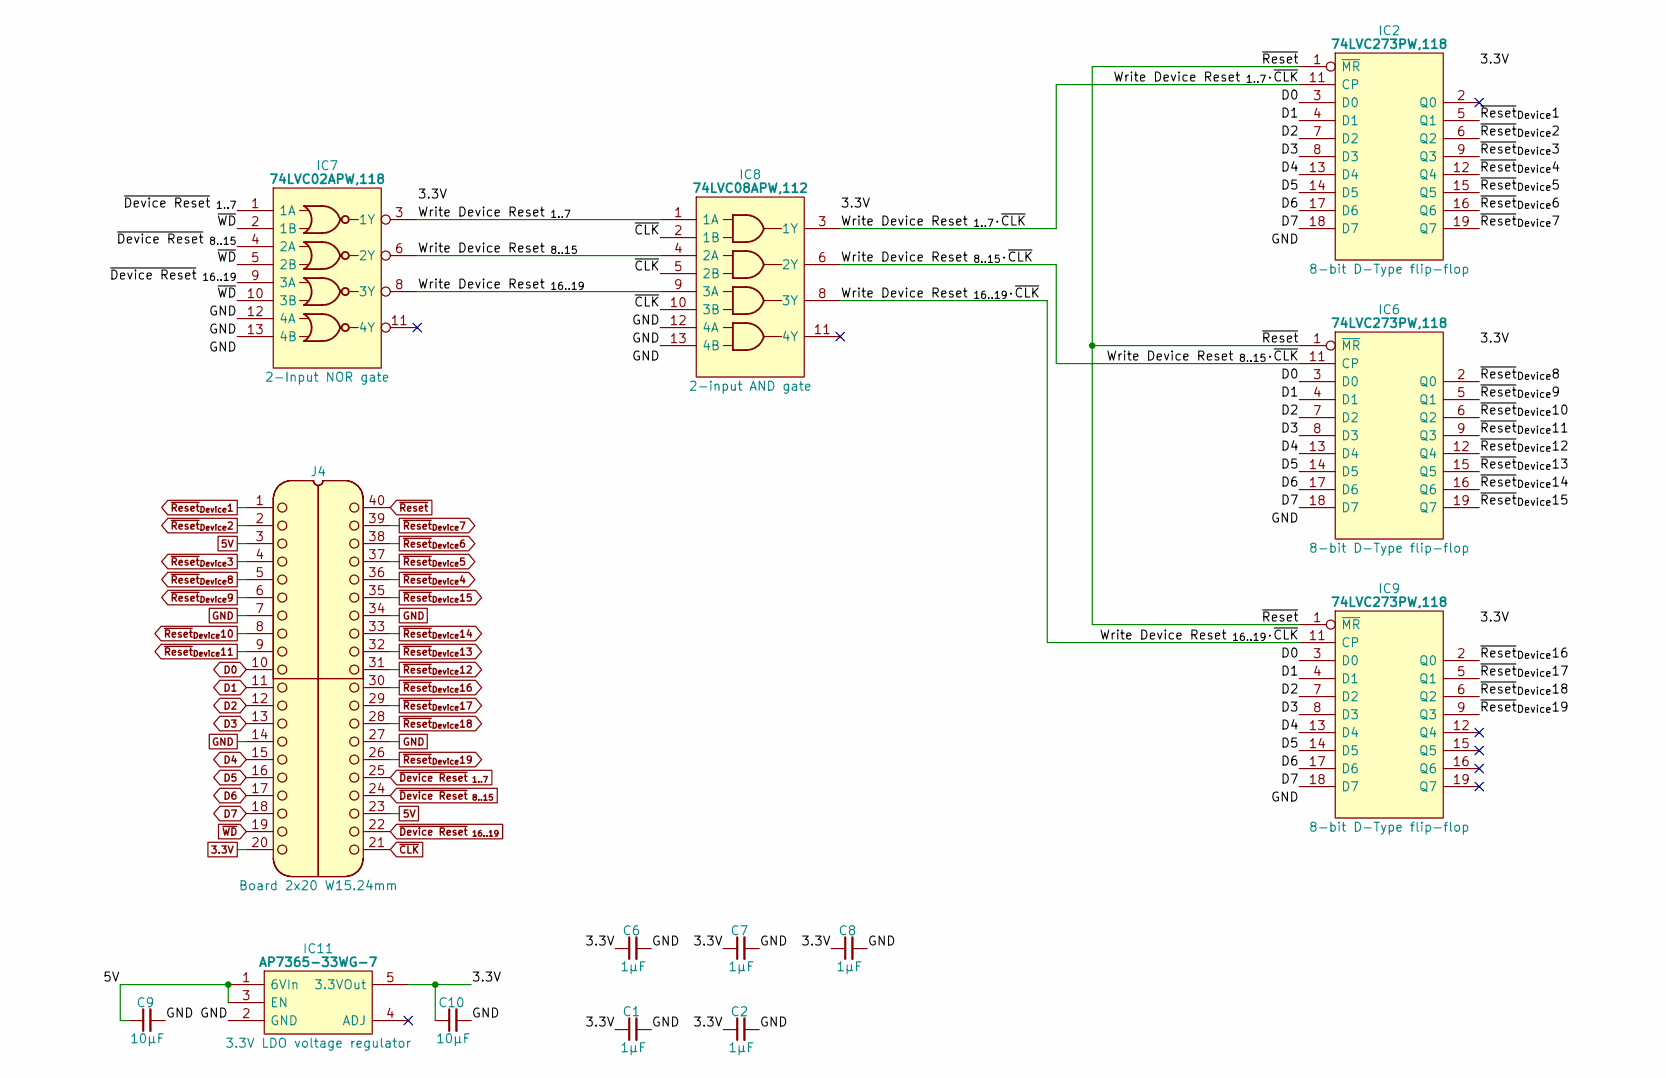
[picture p194: schematic HCP65 Device Reset.kicad_sch]

Parts:
C1, C2, C6, C7, C8: 1μF; C_0805
C9, C10: 10μF; C_0805
IC2, IC6, IC9: 74LVC273PW,118; SOP65P640X110-20N; Manufacturer_Part_Number 74LVC273PW,118; Mouser Part Number 771-74LVC273PW-T
IC7: 74LVC02APW,118; SOP65P640X110-14N; Mouser Part Number 771-74LVC02APW-T
IC8: 74LVC08APW,112; SOP65P640X110-14N; Manufacturer_Part_Number 74LVC08APW,112; Mouser Part Number 771-74LVC08APW
IC11: AP7365-33WG-7; SOT95P285X130-5N; Manufacturer_Part_Number AP7365-33WG-7; Mouser Part Number 621-AP7365-33WG-7
J4: Board 2x20 W15.24mm; DIP-40_Board_W15.24mm

Connections:
3.3V: C1.1, C2.1, C6.1, C7.1, C8.1, C10.1, IC2.20 (3V), IC6.20 (3V), IC7.14 (3V), IC8.14 (3V), IC9.20 (3V), IC11.5 (3.3VOut), J4.20
5V: C9.1, IC11.1 (6VIn), IC11.3 (EN), J4.3, J4.23
/Write Device Reset_{ 1..7}: IC7.3 (1Y), IC8.1 (1A)
/Write Device Reset_{ 1..7}·~CLK: IC2.11 (CP), IC8.3 (1Y)
/Write Device Reset_{ 8..15}: IC7.6 (2Y), IC8.4 (2A)
/Write Device Reset_{ 8..15}·~CLK: IC6.11 (CP), IC8.6 (2Y)
/Write Device Reset_{ 16..19}: IC7.8 (3Y), IC8.9 (3A)
/Write Device Reset_{ 16..19}·~CLK: IC8.8 (3Y), IC9.11 (CP)
D0: IC2.3 (D0), IC6.3 (D0), IC9.3 (D0), J4.10
D1: IC2.4 (D1), IC6.4 (D1), IC9.4 (D1), J4.11
D2: IC2.7 (D2), IC6.7 (D2), IC9.7 (D2), J4.12
D3: IC2.8 (D3), IC6.8 (D3), IC9.8 (D3), J4.13
D4: IC2.13 (D4), IC6.13 (D4), IC9.13 (D4), J4.15
D5: IC2.14 (D5), IC6.14 (D5), IC9.14 (D5), J4.16
D6: IC2.17 (D6), IC6.17 (D6), IC9.17 (D6), J4.17
D7: IC2.18 (D7), IC6.18 (D7), IC9.18 (D7), J4.18
GND: C1.2, C2.2, C6.2, C7.2, C8.2, C9.2, C10.2, IC2.10 (GND), IC6.10 (GND), IC7.7 (GND), IC7.12 (4A), IC7.13 (4B), IC8.7 (GND), IC8.12 (4A), IC8.13 (4B), IC9.10 (GND), IC11.2 (GND), J4.7, J4.14, J4.27, J4.34
~CLK: IC8.2 (1B), IC8.5 (2B), IC8.10 (3B), J4.21
~Device Reset_{ 1..7}: IC7.1 (1A), J4.25
~Device Reset_{ 8..15}: IC7.4 (2A), J4.24
~Device Reset_{ 16..19}: IC7.9 (3A), J4.22
~Reset: IC2.1 (~MR), IC6.1 (~MR), IC9.1 (~MR), J4.40
~Reset_{Device}1: IC2.5 (Q1), J4.1
~Reset_{Device}2: IC2.6 (Q2), J4.2
~Reset_{Device}3: IC2.9 (Q3), J4.4
~Reset_{Device}4: IC2.12 (Q4), J4.36
~Reset_{Device}5: IC2.15 (Q5), J4.37
~Reset_{Device}6: IC2.16 (Q6), J4.38
~Reset_{Device}7: IC2.19 (Q7), J4.39
~Reset_{Device}8: IC6.2 (Q0), J4.5
~Reset_{Device}9: IC6.5 (Q1), J4.6
~Reset_{Device}10: IC6.6 (Q2), J4.8
~Reset_{Device}11: IC6.9 (Q3), J4.9
~Reset_{Device}12: IC6.12 (Q4), J4.31
~Reset_{Device}13: IC6.15 (Q5), J4.32
~Reset_{Device}14: IC6.16 (Q6), J4.33
~Reset_{Device}15: IC6.19 (Q7), J4.35
~Reset_{Device}16: IC9.2 (Q0), J4.30
~Reset_{Device}17: IC9.5 (Q1), J4.29
~Reset_{Device}18: IC9.6 (Q2), J4.28
~Reset_{Device}19: IC9.9 (Q3), J4.26
~WD: IC7.2 (1B), IC7.5 (2B), IC7.10 (3B), J4.19

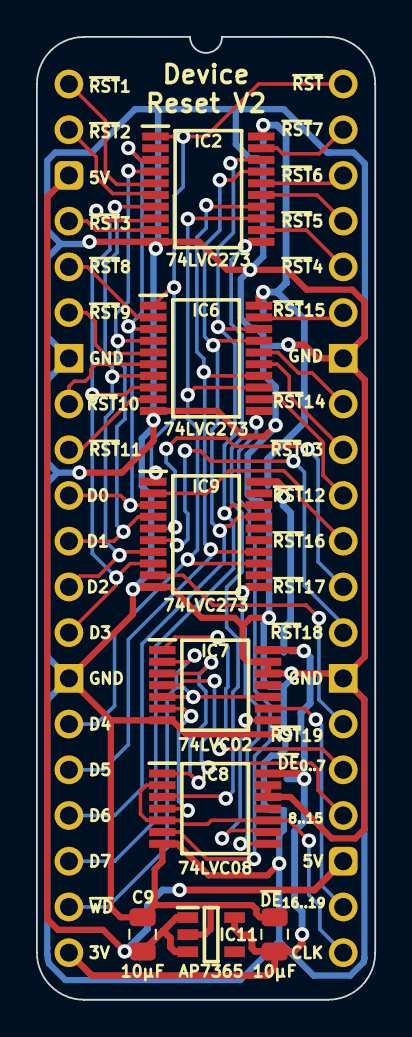
[picture p195: board HCP65 Device Reset.kicad_pcb from above]

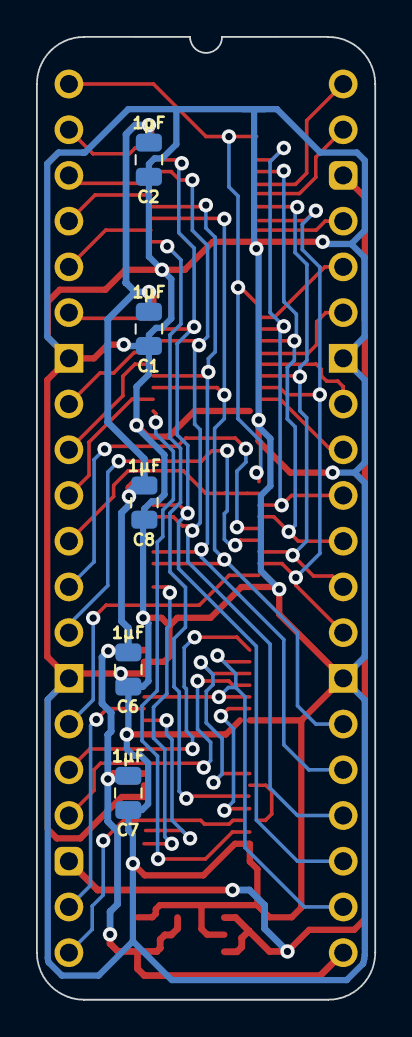
[picture p196: board HCP65 Device Reset.kicad_pcb from below]

Board: 2 copper layers, 18.8 x 53.5 mm, 14 parts (5 on the bottom side), 42 nets.
