andrewpaterson/HCP65/Kicad/Pico/LED Digit Tester/LED Digit Tester.kicad_pcb

## KiCad design Kicad/Pico/LED Digit Tester/LED Digit Tester.kicad_pcb (2026-11-01)

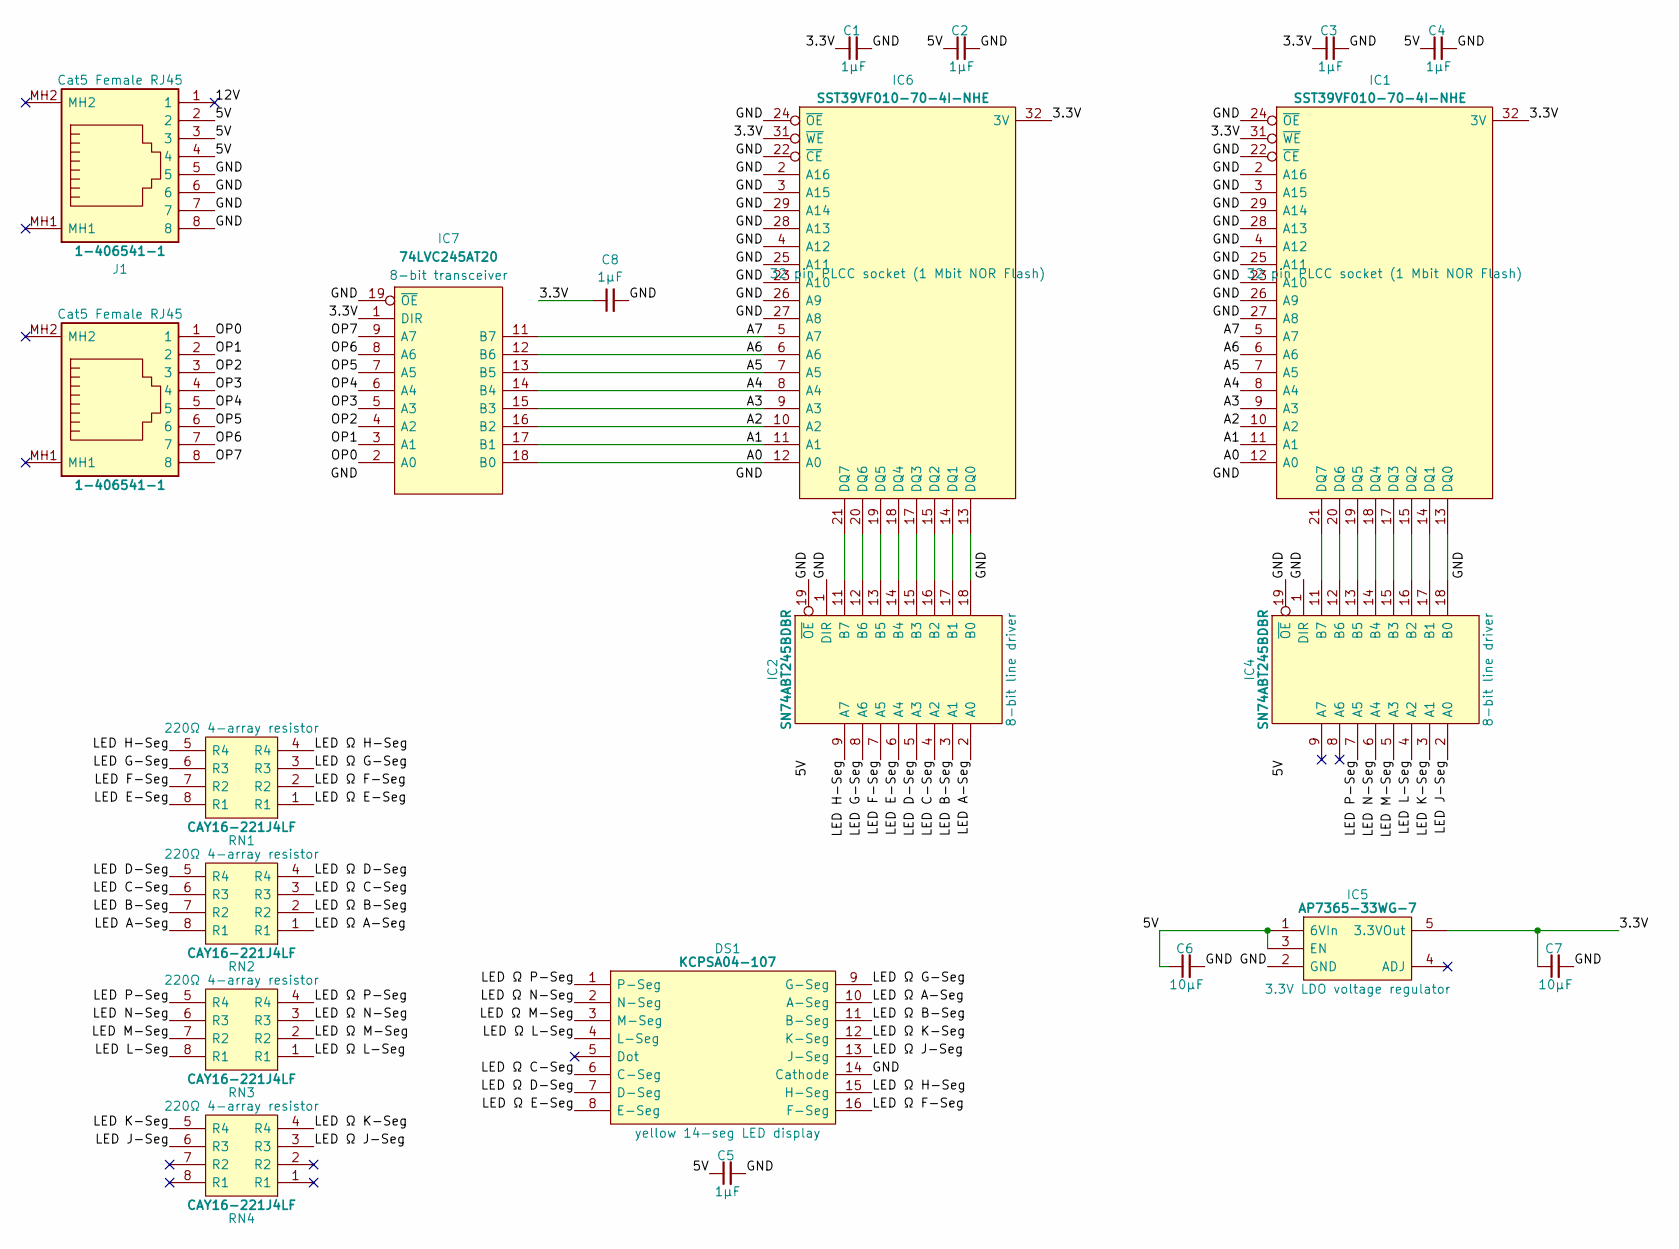
[picture p197: schematic LED Digit Tester.kicad_sch]

Parts:
C1, C2, C3, C4, C5, C8: 1μF; C_0805
C6, C7: 10µF; C_0805
DS1: KCPSA04-107; KCPSA04107; Manufacturer_Part_Number KCPSA04-107; Mouser Part Number N/A
IC1, IC6: SST39VF010-70-4I-NHE; 5408803224008; Manufacturer_Part_Number SST39VF010-70-4I-NHE
IC2, IC4: SN74ABT245BDBR; SOP65P780X200-20N; Manufacturer_Part_Number SN74ABT245BDBR; Mouser Part Number 595-SN74ABT245BDBR
IC5: AP7365-33WG-7; SOT95P285X130-5N; Manufacturer_Part_Number AP7365-33WG-7; Mouser Part Number 621-AP7365-33WG-7
IC7: 74LVC245AT20; SOP65P640X120-20N; Manufacturer_Part_Number 74LVC245AT20-13; Mouser Part Number 621-74LVC245AT20-13
J1, J2: 1-406541-1; 1-406541-1_1; Manufacturer_Part_Number 1-406541-1; Mouser Part Number 571-1-406541-1
RN1, RN2, RN3, RN4: CAY16-221J4LF; CAY16-F4; Manufacturer_Part_Number CAY16-221J4LF; Mouser Part Number 652-CAY16-221J4LF

Connections:
/3.3V: C1.1, C3.1, C7.1, C8.1, IC1.31 (~WE), IC1.32 (3V), IC5.5 (3.3VOut), IC6.31 (~WE), IC6.32 (3V), IC7.1 (DIR), IC7.20 (3V)
/5V: C2.1, C4.1, C5.1, C6.1, IC2.20 (5V), IC4.20 (5V), IC5.1 (6VIn), IC5.3 (EN), J1.2, J1.3, J1.4
/12V: J1.1
/A0: IC1.12 (A0), IC6.12 (A0), IC7.18 (B0)
/A1: IC1.11 (A1), IC6.11 (A1), IC7.17 (B1)
/A2: IC1.10 (A2), IC6.10 (A2), IC7.16 (B2)
/A3: IC1.9 (A3), IC6.9 (A3), IC7.15 (B3)
/A4: IC1.8 (A4), IC6.8 (A4), IC7.14 (B4)
/A5: IC1.7 (A5), IC6.7 (A5), IC7.13 (B5)
/A6: IC1.6 (A6), IC6.6 (A6), IC7.12 (B6)
/A7: IC1.5 (A7), IC6.5 (A7), IC7.11 (B7)
/GND: C1.2, C2.2, C3.2, C4.2, C5.2, C6.2, C7.2, C8.2, DS1.14 (Cathode), IC1.2 (A16), IC1.3 (A15), IC1.4 (A12), IC1.16 (GND), IC1.22 (~CE), IC1.23 (A10), IC1.24 (~OE), IC1.25 (A11), IC1.26 (A9), IC1.27 (A8), IC1.28 (A13), IC1.29 (A14), IC2.1 (DIR), IC2.10 (GND), IC2.19 (~OE), IC4.1 (DIR), IC4.10 (GND), IC4.19 (~OE), IC5.2 (GND), IC6.2 (A16), IC6.3 (A15), IC6.4 (A12), IC6.16 (GND), IC6.22 (~CE), IC6.23 (A10), IC6.24 (~OE), IC6.25 (A11), IC6.26 (A9), IC6.27 (A8), IC6.28 (A13), IC6.29 (A14), IC7.10 (GND), IC7.19 (~OE), J1.5, J1.6, J1.7, J1.8
/LED A-Seg: IC2.2 (A0), RN2.8 (R1)
/LED B-Seg: IC2.3 (A1), RN2.7 (R2)
/LED C-Seg: IC2.4 (A2), RN2.6 (R3)
/LED D-Seg: IC2.5 (A3), RN2.5 (R4)
/LED E-Seg: IC2.6 (A4), RN1.8 (R1)
/LED F-Seg: IC2.7 (A5), RN1.7 (R2)
/LED G-Seg: IC2.8 (A6), RN1.6 (R3)
/LED H-Seg: IC2.9 (A7), RN1.5 (R4)
/LED J-Seg: IC4.2 (A0), RN4.6 (R3)
/LED K-Seg: IC4.3 (A1), RN4.5 (R4)
/LED L-Seg: IC4.4 (A2), RN3.8 (R1)
/LED M-Seg: IC4.5 (A3), RN3.7 (R2)
/LED N-Seg: IC4.6 (A4), RN3.6 (R3)
/LED P-Seg: IC4.7 (A5), RN3.5 (R4)
/LED Ω A-Seg: DS1.10 (A-Seg), RN2.1 (R1)
/LED Ω B-Seg: DS1.11 (B-Seg), RN2.2 (R2)
/LED Ω C-Seg: DS1.6 (C-Seg), RN2.3 (R3)
/LED Ω D-Seg: DS1.7 (D-Seg), RN2.4 (R4)
/LED Ω E-Seg: DS1.8 (E-Seg), RN1.1 (R1)
/LED Ω F-Seg: DS1.16 (F-Seg), RN1.2 (R2)
/LED Ω G-Seg: DS1.9 (G-Seg), RN1.3 (R3)
/LED Ω H-Seg: DS1.15 (H-Seg), RN1.4 (R4)
/LED Ω J-Seg: DS1.13 (J-Seg), RN4.3 (R3)
/LED Ω K-Seg: DS1.12 (K-Seg), RN4.4 (R4)
/LED Ω L-Seg: DS1.4 (L-Seg), RN3.1 (R1)
/LED Ω M-Seg: DS1.3 (M-Seg), RN3.2 (R2)
/LED Ω N-Seg: DS1.2 (N-Seg), RN3.3 (R3)
/LED Ω P-Seg: DS1.1 (P-Seg), RN3.4 (R4)
/OP0: IC7.2 (A0), J2.1
/OP1: IC7.3 (A1), J2.2
/OP2: IC7.4 (A2), J2.3
/OP3: IC7.5 (A3), J2.4
/OP4: IC7.6 (A4), J2.5
/OP5: IC7.7 (A5), J2.6
/OP6: IC7.8 (A6), J2.7
/OP7: IC7.9 (A7), J2.8
unnamed: IC1.13 (DQ0), IC4.18 (B0)
unnamed: IC1.14 (DQ1), IC4.17 (B1)
unnamed: IC1.15 (DQ2), IC4.16 (B2)
unnamed: IC1.17 (DQ3), IC4.15 (B3)
unnamed: IC1.18 (DQ4), IC4.14 (B4)
unnamed: IC1.19 (DQ5), IC4.13 (B5)
unnamed: IC1.20 (DQ6), IC4.12 (B6)
unnamed: IC1.21 (DQ7), IC4.11 (B7)
unnamed: IC2.18 (B0), IC6.13 (DQ0)
unnamed: IC2.17 (B1), IC6.14 (DQ1)
unnamed: IC2.16 (B2), IC6.15 (DQ2)
unnamed: IC2.15 (B3), IC6.17 (DQ3)
unnamed: IC2.14 (B4), IC6.18 (DQ4)
unnamed: IC2.13 (B5), IC6.19 (DQ5)
unnamed: IC2.12 (B6), IC6.20 (DQ6)
unnamed: IC2.11 (B7), IC6.21 (DQ7)

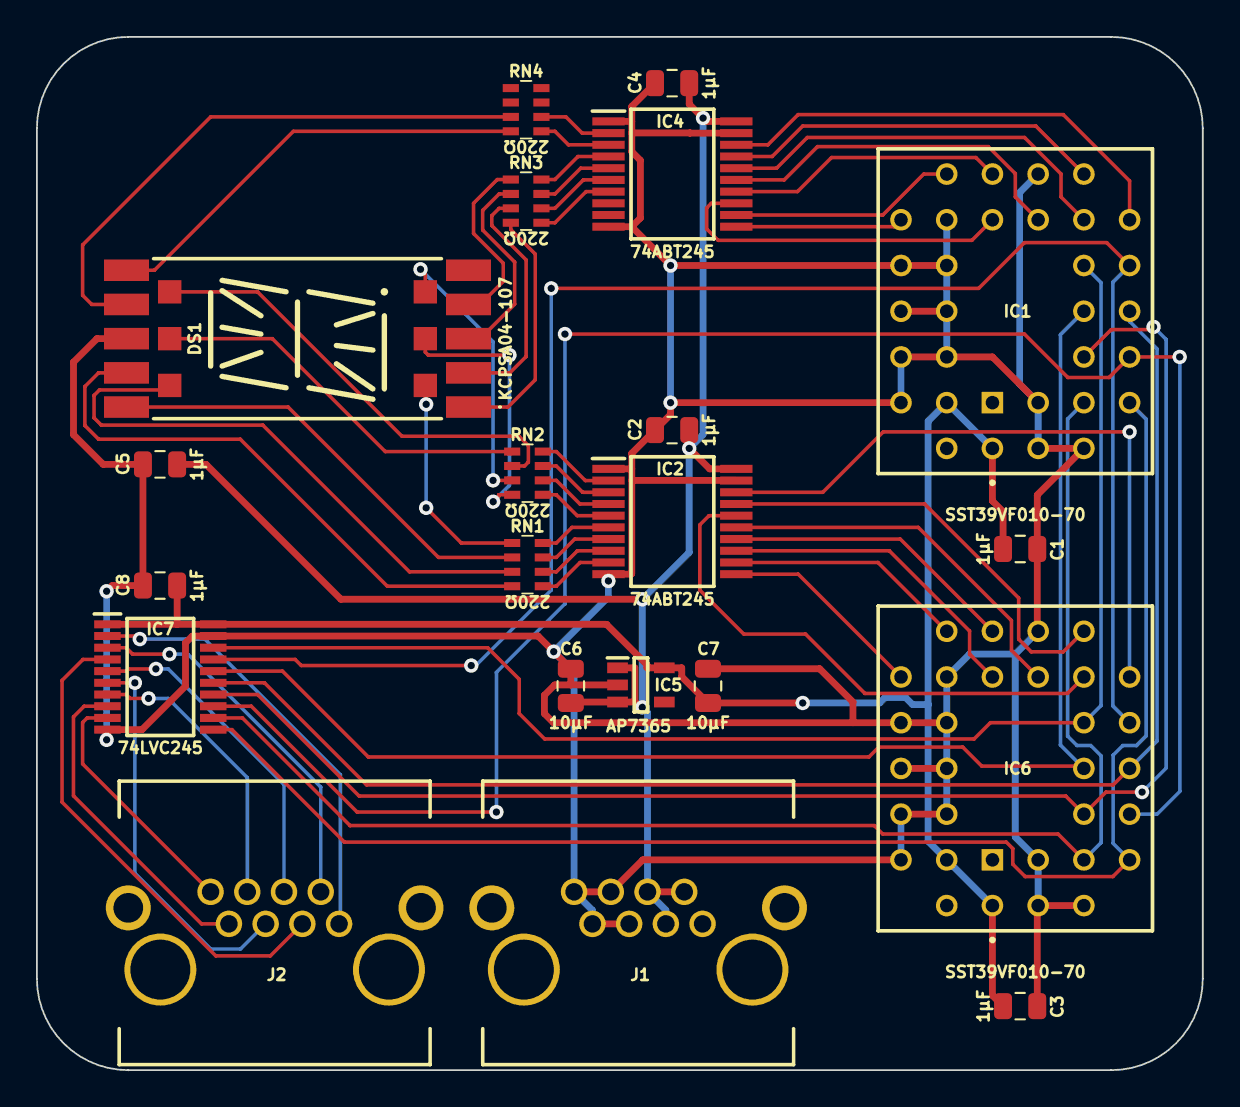
[picture p198: board LED Digit Tester.kicad_pcb from above]

Board: 2 copper layers, 64.8 x 57.4 mm, 21 parts (0 on the bottom side), 63 nets.
