andrewpaterson/HCP65/Kicad/Computer/Component Boards/State Reader 8bit/State Reader 8bit.kicad_pcb

## KiCad design Kicad/Computer/Component Boards/State Reader 8bit/State Reader 8bit.kicad_pcb (2026-11-01)

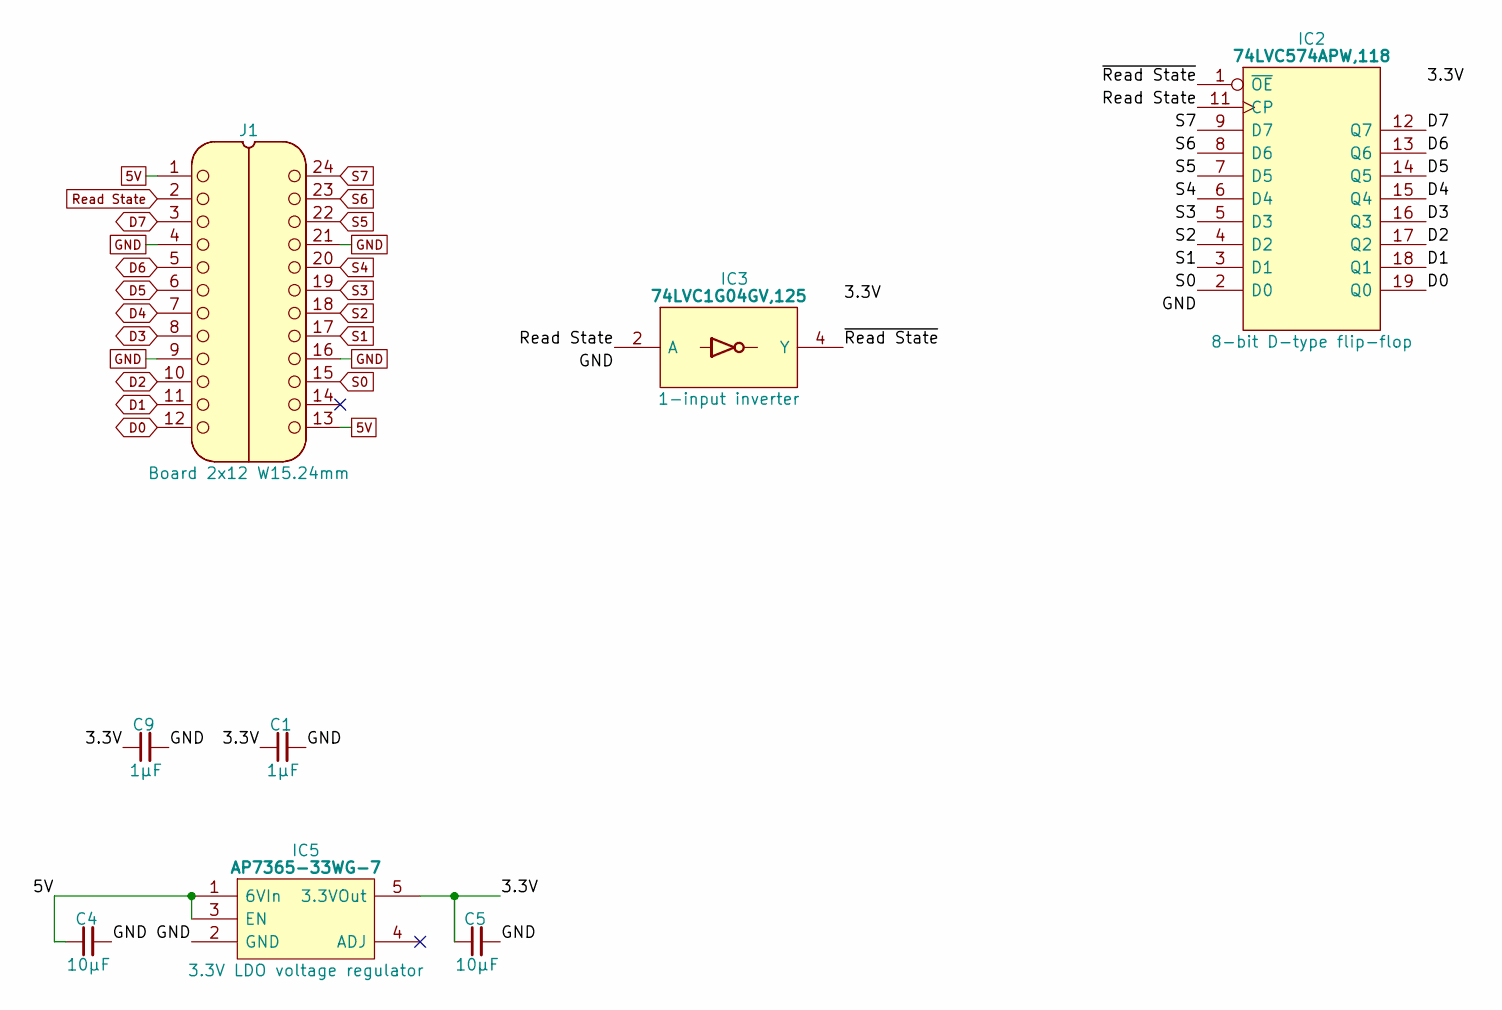
[picture p199: schematic State Reader 8bit.kicad_sch]

Parts:
C1, C9: 1μF; C_0805
C4, C5: 10µF; C_0805
IC2: 74LVC574APW,118; SOP65P640X110-20N; Mouser Part Number 771-74LVC574APW-T
IC3: 74LVC1G04GV,125; SOT95P275X110-5N; Manufacturer_Part_Number 74LVC1G04GV,125; Mouser Part Number 771-74LVC1G04GV
IC5: AP7365-33WG-7; SOT95P285X130-5N; Manufacturer_Part_Number AP7365-33WG-7; Mouser Part Number 621-AP7365-33WG-7
J1: Board 2x12 W15.24mm; DIP-24_Board_W15.24mm

Connections:
5V: C4.1, IC5.1 (6VIn), IC5.3 (EN), J1.1, J1.13
/3.3V: C1.1, C5.1, C9.1, IC2.20 (3V), IC5.5 (3.3VOut)
/~Read State: IC2.1 (~OE), IC3.4 (Y)
D0: IC2.19 (Q0), J1.12
D1: IC2.18 (Q1), J1.11
D2: IC2.17 (Q2), J1.10
D3: IC2.16 (Q3), J1.8
D4: IC2.15 (Q4), J1.7
D5: IC2.14 (Q5), J1.6
D6: IC2.13 (Q6), J1.5
D7: IC2.12 (Q7), J1.3
GND: C1.2, C4.2, C5.2, C9.2, IC2.10 (GND), IC3.3 (GND), IC5.2 (GND), J1.4, J1.9, J1.16, J1.21
Read State: IC2.11 (CP), IC3.2 (A), J1.2
S0: IC2.2 (D0), J1.15
S1: IC2.3 (D1), J1.17
S2: IC2.4 (D2), J1.18
S3: IC2.5 (D3), J1.19
S4: IC2.6 (D4), J1.20
S5: IC2.7 (D5), J1.22
S6: IC2.8 (D6), J1.23
S7: IC2.9 (D7), J1.24

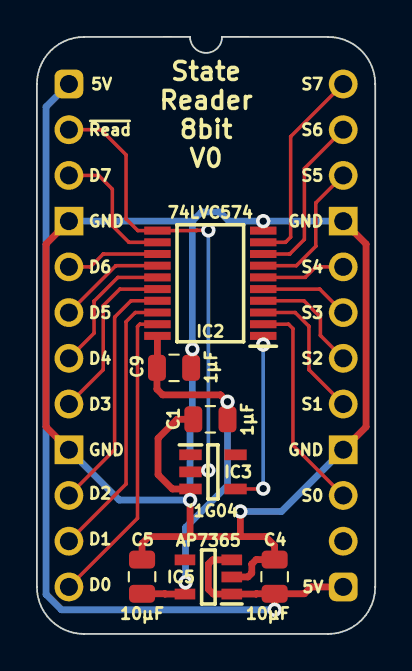
[picture p200: board State Reader 8bit.kicad_pcb from above]

Board: 2 copper layers, 18.8 x 33.2 mm, 8 parts (0 on the bottom side), 21 nets.
