andrewpaterson/HCP65/Kicad/Computer/PS2/PS2 Timing/PS2 Timing.kicad_pcb

## KiCad design Kicad/Computer/PS2/PS2 Timing/PS2 Timing.kicad_pcb (2026-11-01)

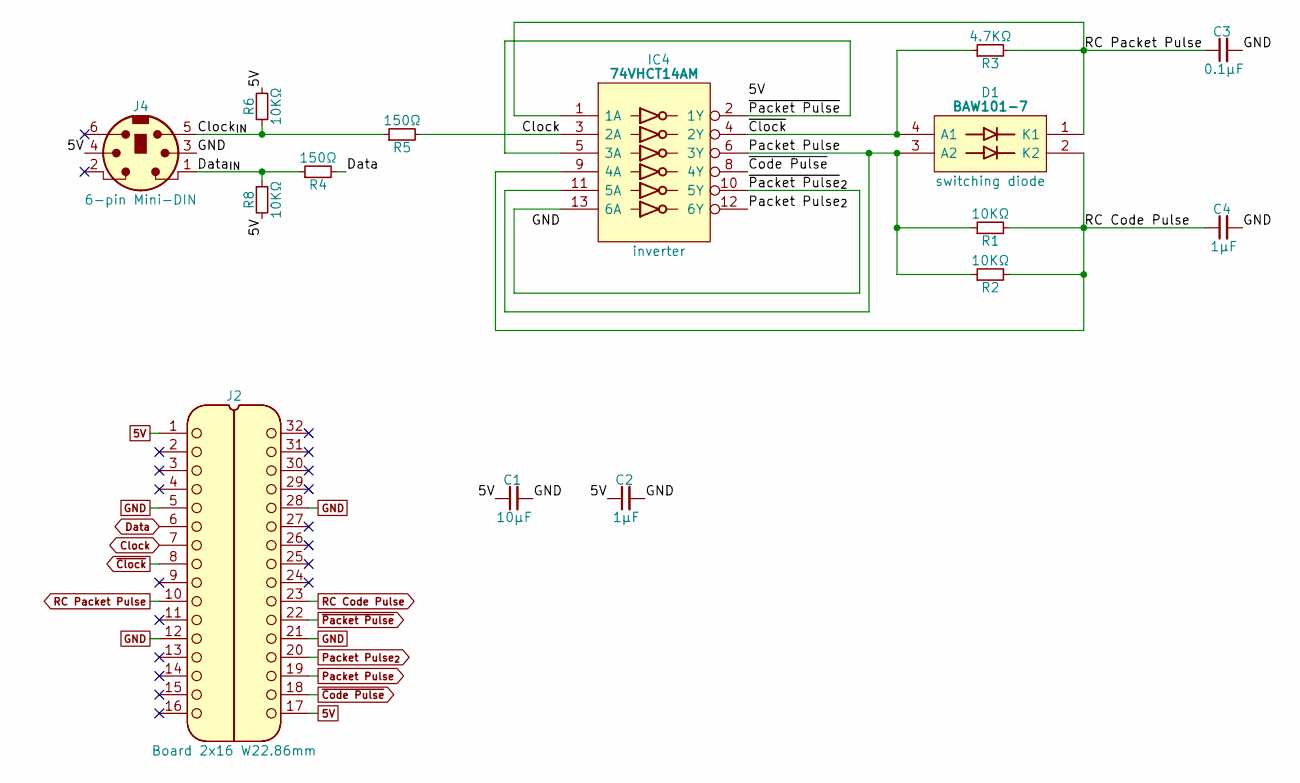
[picture p203: schematic PS2 Timing.kicad_sch]

Parts:
C1: 10μF; C_0805
C2, C4: 1μF; C_0805
C3: 0.1μF; C_0805
D1: BAW101-7; BAW1017; Manufacturer_Part_Number BAW101-7; Mouser Part Number 621-BAW101-7
IC4: 74VHCT14AM; SOIC127P600X175-14N; Manufacturer_Part_Number 74VHCT14AM; Mouser Part Number 512-74VHCT14AM
J2: Board 2x16 W22.86mm; DIP-32_Board_W22.86mm
J4: TM-0508 A/6; TM0508A6
R1, R2, R6, R8: 10KΩ; R_0805
R3: 4.7KΩ; R_0805
R4, R5: 150Ω; R_0805

Connections:
5V: C1.1, C2.1, IC4.14 (5V), J2.1, J2.17, J4.4, R6.2, R8.2
/Clock_{IN}: J4.5, R5.1, R6.1
/Data_{IN}: J4.1, R4.1, R8.1
/~Packet Pulse_{2}: IC4.10 (5Y), IC4.13 (6A)
Clock: IC4.3 (2A), J2.7, R5.2
Data: J2.6, R4.2
GND: C1.2, C2.2, C3.2, C4.2, IC4.7 (GND), J2.5, J2.12, J2.21, J2.28, J4.3
Packet Pulse: D1.3 (A2), IC4.6 (3Y), IC4.11 (5A), J2.19, R1.1, R2.1
Packet Pulse_{2}: IC4.12 (6Y), J2.20
RC Code Pulse: C4.1, D1.2 (K2), IC4.9 (4A), J2.23, R1.2, R2.2
RC Packet Pulse: C3.1, D1.1 (K1), IC4.1 (1A), J2.10, R3.2
~Clock: D1.4 (A1), IC4.4 (2Y), J2.8, R3.1
~Code Pulse: IC4.8 (4Y), J2.18
~Packet Pulse: IC4.2 (1Y), IC4.5 (3A), J2.22

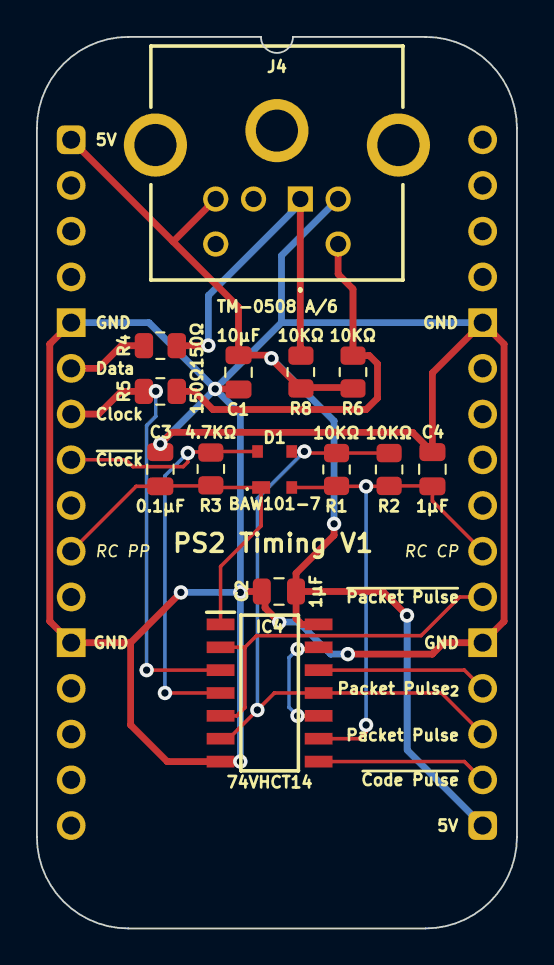
[picture p204: board PS2 Timing.kicad_pcb from above]

Board: 2 copper layers, 26.7 x 49.5 mm, 15 parts (0 on the bottom side), 14 nets.
