andrewpaterson/HCP65/Kicad/Computer/Component Boards/GPIO 4bit/GPIO 4bit.kicad_pcb

## KiCad design Kicad/Computer/Component Boards/GPIO 4bit/GPIO 4bit.kicad_pcb (2026-11-01)

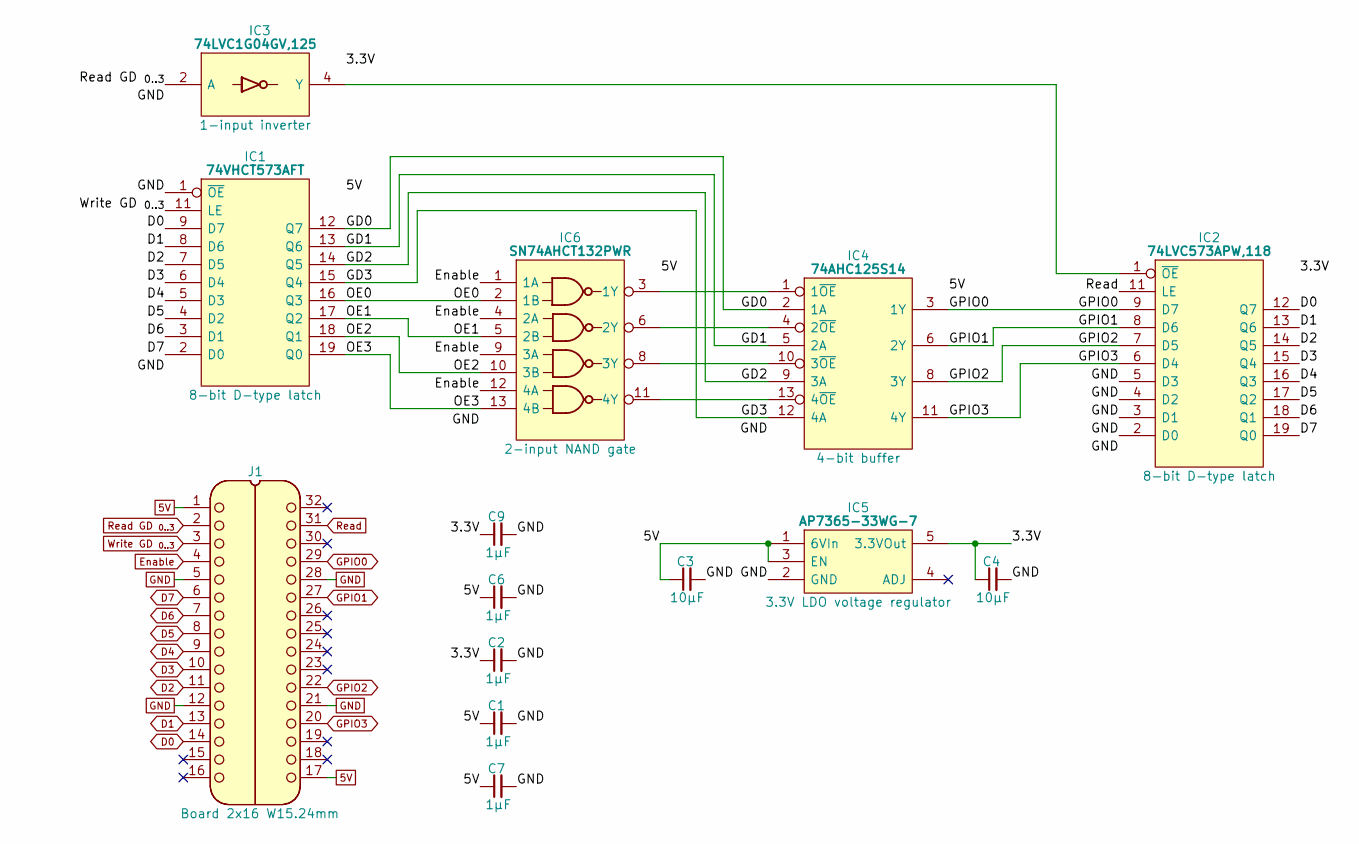
[picture p205: schematic GPIO 4bit.kicad_sch]

Parts:
C1, C2, C6, C7, C9: 1μF; C_0805
C3, C4: 10µF; C_0805
IC1: 74VHCT573AFT; SOP65P640X120-20N; Manufacturer_Part_Number 74VHCT573AFT; Mouser Part Number N/A
IC2: 74LVC573APW,118; SOP65P640X110-20N; Mouser Part Number 771-74LVC573APW-T
IC3: 74LVC1G04GV,125; SOT95P275X110-5N; Manufacturer_Part_Number 74LVC1G04GV,125; Mouser Part Number 771-74LVC1G04GV
IC4: 74AHC125S14; SOIC127P600X173-14N; Manufacturer_Part_Number 74AHC125S14-13; Mouser Part Number 621-74AHC125S14-13
IC5: AP7365-33WG-7; SOT95P285X130-5N; Manufacturer_Part_Number AP7365-33WG-7; Mouser Part Number 621-AP7365-33WG-7
IC6: SN74AHCT132PWR; SOP65P640X120-14N; Manufacturer_Part_Number SN74AHCT132PWR; Mouser Part Number 595-SN74AHCT132PWR
J1: Board 2x16 W15.24mm; DIP-32_Board_W15.24mm

Connections:
5V: C1.1, C3.1, C6.1, C7.1, IC1.20 (5V), IC4.14 (VCC), IC5.1 (6VIn), IC5.3 (EN), IC6.14 (5V), J1.1, J1.17
/3.3V: C2.1, C4.1, C9.1, IC2.20 (3V), IC3.5 (3V), IC5.5 (3.3VOut)
/GD0: IC1.12 (Q7), IC4.2 (1A)
/GD1: IC1.13 (Q6), IC4.5 (2A)
/GD2: IC1.14 (Q5), IC4.9 (3A)
/GD3: IC1.15 (Q4), IC4.12 (4A)
/OE0: IC1.16 (Q3), IC6.2 (1B)
/OE1: IC1.17 (Q2), IC6.5 (2B)
/OE2: IC1.18 (Q1), IC6.10 (3B)
/OE3: IC1.19 (Q0), IC6.13 (4B)
D0: IC1.9 (D7), IC2.12 (Q7), J1.14
D1: IC1.8 (D6), IC2.13 (Q6), J1.13
D2: IC1.7 (D5), IC2.14 (Q5), J1.11
D3: IC1.6 (D4), IC2.15 (Q4), J1.10
D4: IC1.5 (D3), IC2.16 (Q3), J1.9
D5: IC1.4 (D2), IC2.17 (Q2), J1.8
D6: IC1.3 (D1), IC2.18 (Q1), J1.7
D7: IC1.2 (D0), IC2.19 (Q0), J1.6
Enable: IC6.1 (1A), IC6.4 (2A), IC6.9 (3A), IC6.12 (4A), J1.4
GND: C1.2, C2.2, C3.2, C4.2, C6.2, C7.2, C9.2, IC1.1 (~OE), IC1.10 (GND), IC2.2 (D0), IC2.3 (D1), IC2.4 (D2), IC2.5 (D3), IC2.10 (GND), IC3.3 (GND), IC4.7 (GND), IC5.2 (GND), IC6.7 (GND), J1.5, J1.12, J1.21, J1.28
GPIO0: IC2.9 (D7), IC4.3 (1Y), J1.29
GPIO1: IC2.8 (D6), IC4.6 (2Y), J1.27
GPIO2: IC2.7 (D5), IC4.8 (3Y), J1.22
GPIO3: IC2.6 (D4), IC4.11 (4Y), J1.20
unnamed: IC2.1 (~OE), IC3.4 (Y)
unnamed: IC4.1 (1~OE), IC6.3 (1Y)
unnamed: IC4.4 (2~OE), IC6.6 (2Y)
unnamed: IC4.10 (3~OE), IC6.8 (3Y)
unnamed: IC4.13 (4~OE), IC6.11 (4Y)
Read: IC2.11 (LE), J1.31
Read GD _{0..3}: IC3.2 (A), J1.2
Write GD _{0..3}: IC1.11 (LE), J1.3

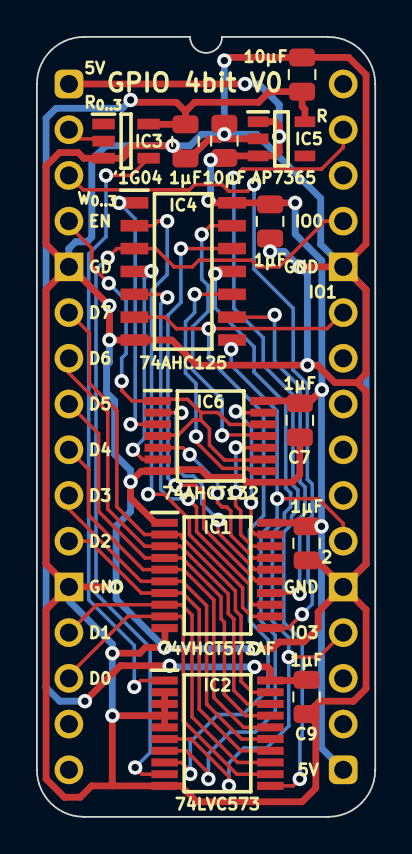
[picture p206: board GPIO 4bit.kicad_pcb from above]

Board: 2 copper layers, 18.8 x 43.3 mm, 14 parts (0 on the bottom side), 32 nets.
