andrewpaterson/HCP65/Kicad/Computer/UART/RS232/RS232.kicad_pcb

## KiCad design Kicad/Computer/UART/RS232/RS232.kicad_pcb (2026-11-01)

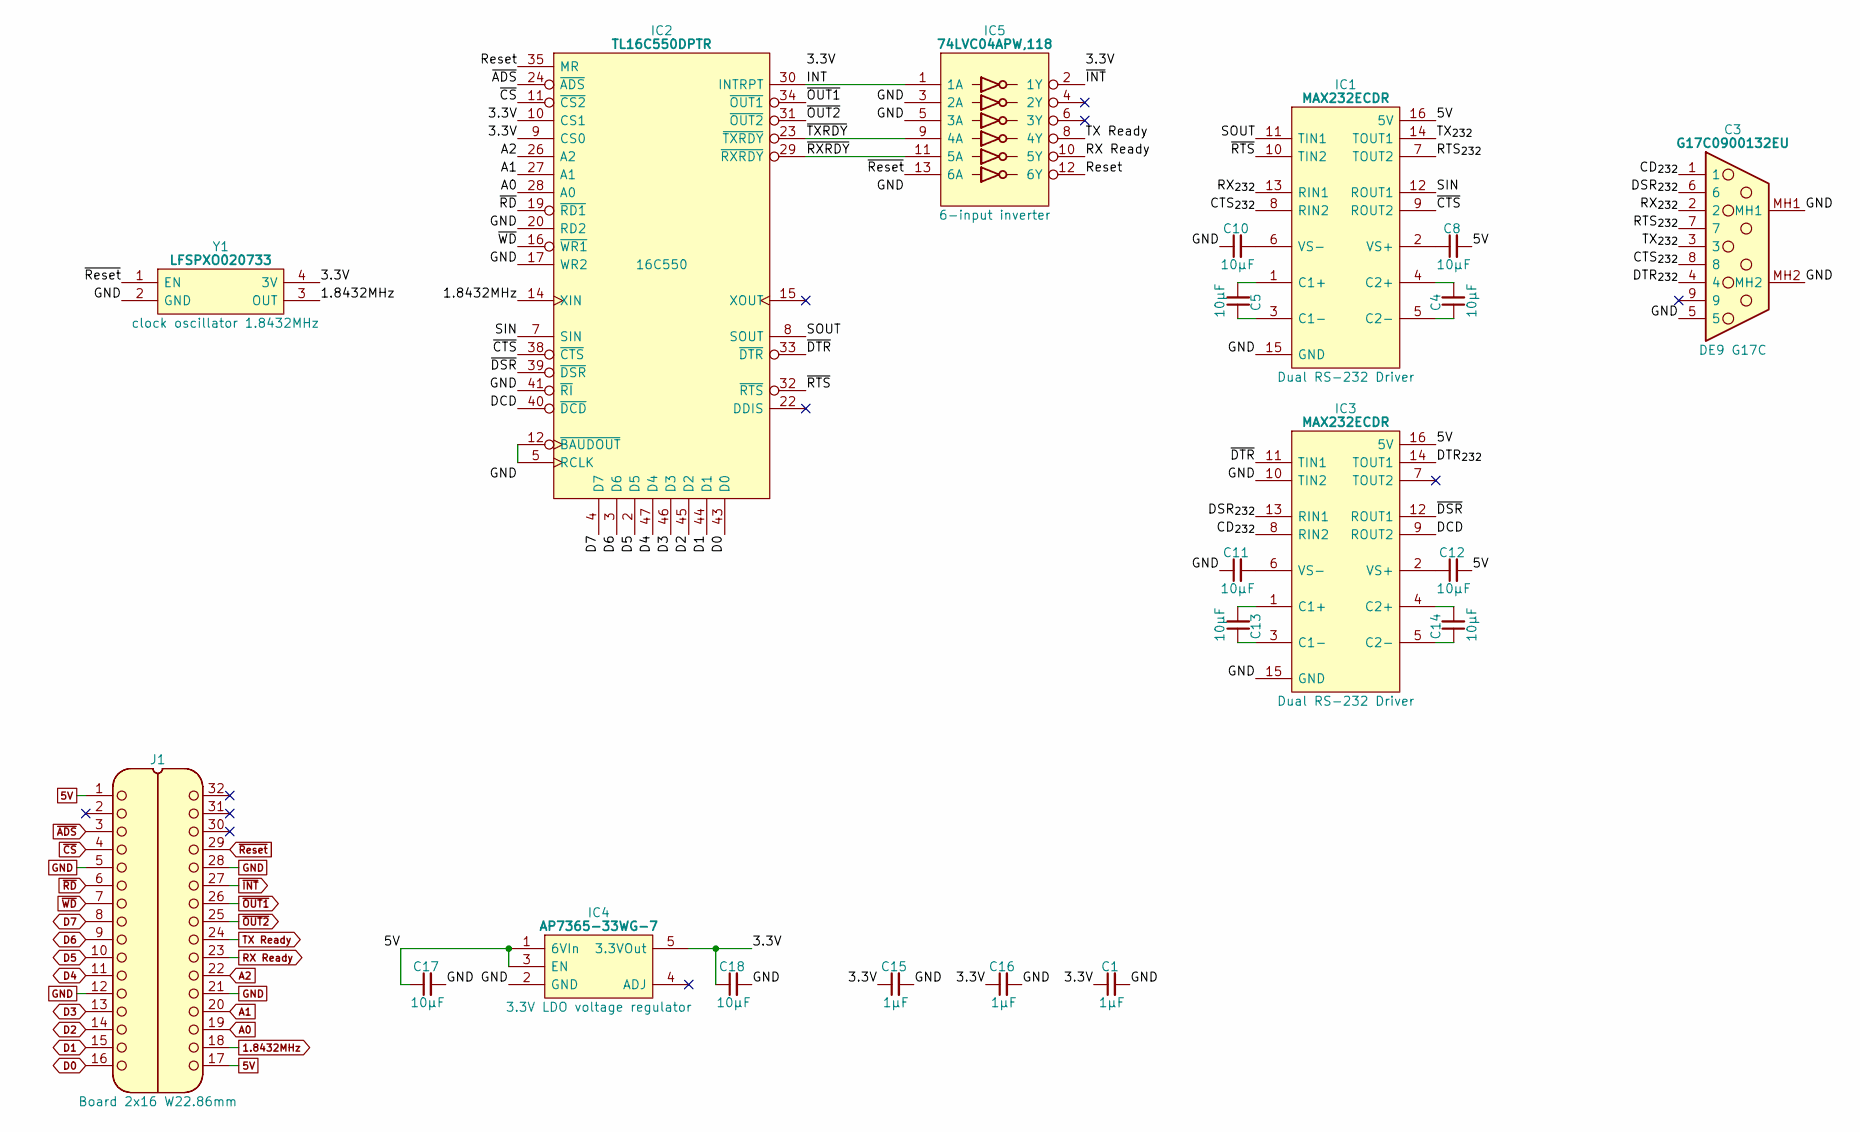
[picture p207: schematic RS232.kicad_sch, RS232 UART]

Parts:
C1, C15, C16: 1μF; C_0805
C3: G17C0900132EU; Manufacturer_Part_Number G17C0900132EU; Mouser Part Number 523-G17C0900132EU
C4, C5, C8, C10, C11, C12, C13, C14: 10μF; C_0805
C17, C18: 10µF; C_0805
IC1, IC3: MAX232ECDR; SOIC127P600X175-16N; Manufacturer_Part_Number MAX232ECDR; Mouser Part Number 595-MAX232ECDR
IC2: TL16C550DPTR; QFP50P900X900X160-48N; Manufacturer_Part_Number TL16C550DPTR; Mouser Part Number 595-TL16C550DPTR
IC4: AP7365-33WG-7; SOT95P285X130-5N; Manufacturer_Part_Number AP7365-33WG-7; Mouser Part Number 621-AP7365-33WG-7
IC5: 74LVC04APW,118; SOP65P640X110-14N; Manufacturer_Part_Number 74LVC04APW,118; Mouser Part Number 771-74LVC04APW-T
J1: Board 2x16 W22.86mm; DIP-32_Board_W22.86mm_Nak
Y1: LFSPXO020733

Connections:
1.8432MHz: IC2.14 (XIN), J1.18, Y1.3 (OUTPUT)
5V: C8.2, C12.2, C17.1, IC1.16 (5V), IC3.16 (5V), IC4.1 (6VIn), IC4.3 (EN), J1.1, J1.17
/3.3V: C1.1, C15.1, C16.1, C18.1, IC2.9 (CS0), IC2.10 (CS1), IC2.42 (5V), IC4.5 (3.3VOut), IC5.14 (3V), Y1.4 (3V)
/CD_{232}: C3.1, IC3.8 (RIN2)
/CTS_{232}: C3.8, IC1.8 (RIN2)
/DCD: IC2.40 (~DCD), IC3.9 (ROUT2)
/DSR_{232}: C3.6, IC3.13 (RIN1)
/DTR_{232}: C3.4, IC3.14 (TOUT1)
/INT: IC2.30 (INTRPT), IC5.1 (1A)
/RTS_{232}: C3.7, IC1.7 (TOUT2)
/RX_{232}: C3.2, IC1.13 (RIN1)
/Reset: IC2.35 (MR), IC5.12 (6Y)
/SIN: IC1.12 (ROUT1), IC2.7 (SIN)
/SOUT: IC1.11 (TIN1), IC2.8 (SOUT)
/TX_{232}: C3.3, IC1.14 (TOUT1)
/~CTS: IC1.9 (ROUT2), IC2.38 (~CTS)
/~DSR: IC2.39 (~DSR), IC3.12 (ROUT1)
/~DTR: IC2.33 (~DTR), IC3.11 (TIN1)
/~RTS: IC1.10 (TIN2), IC2.32 (~RTS)
/~RXRDY: IC2.29 (~RXRDY), IC5.11 (5A)
/~TXRDY: IC2.23 (~TXRDY), IC5.9 (4A)
A0: IC2.28 (A0), J1.19
A1: IC2.27 (A1), J1.20
A2: IC2.26 (A2), J1.22
D0: IC2.43 (D0), J1.16
D1: IC2.44 (D1), J1.15
D2: IC2.45 (D2), J1.14
D3: IC2.46 (D3), J1.13
D4: IC2.47 (D4), J1.11
D5: IC2.2 (D5), J1.10
D6: IC2.3 (D6), J1.9
D7: IC2.4 (D7), J1.8
GND: C1.2, C3.5, C3.MH1, C3.MH2, C10.1, C11.1, C15.2, C16.2, C17.2, C18.2, IC1.15 (GND), IC2.17 (WR2), IC2.18 (GND), IC2.20 (RD2), IC2.41 (~RI), IC3.10 (TIN2), IC3.15 (GND), IC4.2 (GND), IC5.3 (2A), IC5.5 (3A), IC5.7 (GND), J1.5, J1.12, J1.21, J1.28, Y1.2 (GND)
unnamed: C5.2, IC1.1 (C1+)
unnamed: C5.1, IC1.3 (C1-)
unnamed: C4.2, IC1.4 (C2+)
unnamed: C4.1, IC1.5 (C2-)
unnamed: C8.1, IC1.2 (VS+)
unnamed: C10.2, IC1.6 (VS-)
unnamed: IC2.5 (RCLK), IC2.12 (~BAUDOUT)
unnamed: C13.2, IC3.1 (C1+)
unnamed: C13.1, IC3.3 (C1-)
unnamed: C14.2, IC3.4 (C2+)
unnamed: C14.1, IC3.5 (C2-)
unnamed: C12.1, IC3.2 (VS+)
unnamed: C11.2, IC3.6 (VS-)
RX Ready: IC5.10 (5Y), J1.23
TX Ready: IC5.8 (4Y), J1.24
~ADS: IC2.24 (~ADS), J1.3
~CS: IC2.11 (~CS2), J1.4
~INT: IC5.2 (1Y), J1.27
~OUT1: IC2.34 (~OUT1), J1.26
~OUT2: IC2.31 (~OUT2), J1.25
~RD: IC2.19 (~RD1), J1.6
~Reset: IC5.13 (6A), J1.29, Y1.1 (EN)
~WD: IC2.16 (~WR1), J1.7

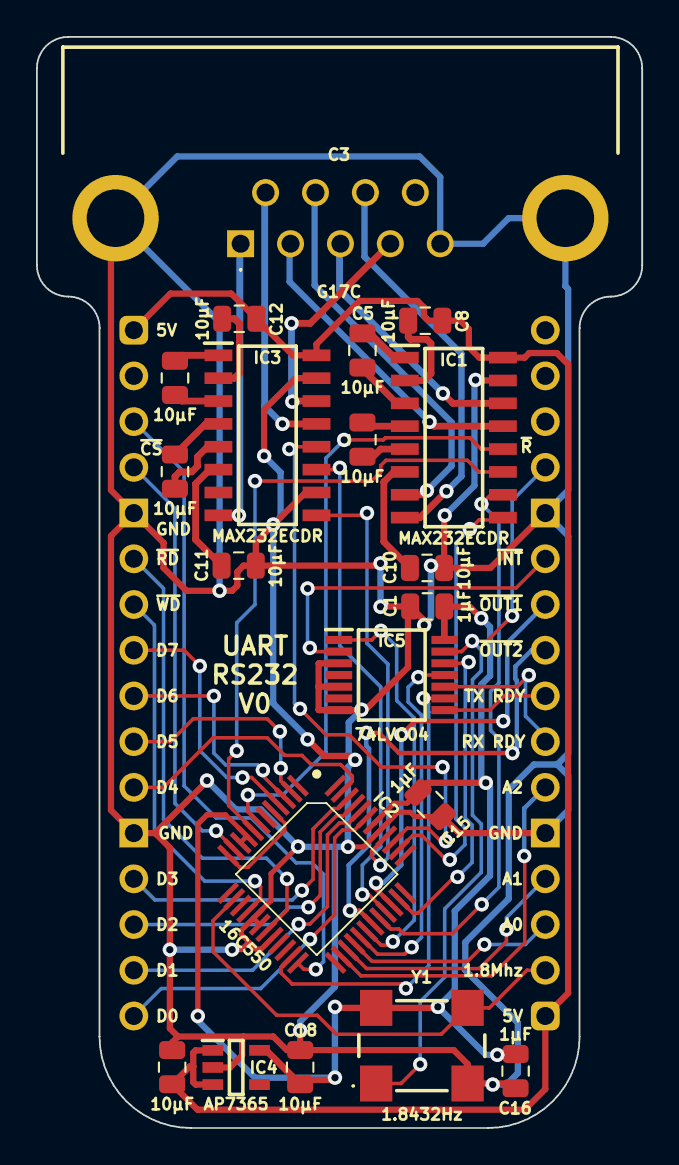
[picture p208: board RS232.kicad_pcb from above]

Board: 2 copper layers, 33.6 x 60.6 mm, 21 parts (0 on the bottom side), 56 nets.
