andrewpaterson/HCP65/Kicad/Computer/Coprocessor/Coprocessor Clock/Coprocessor Clock.kicad_pcb

## KiCad design Kicad/Computer/Coprocessor/Coprocessor Clock/Coprocessor Clock.kicad_pcb (2026-11-01)

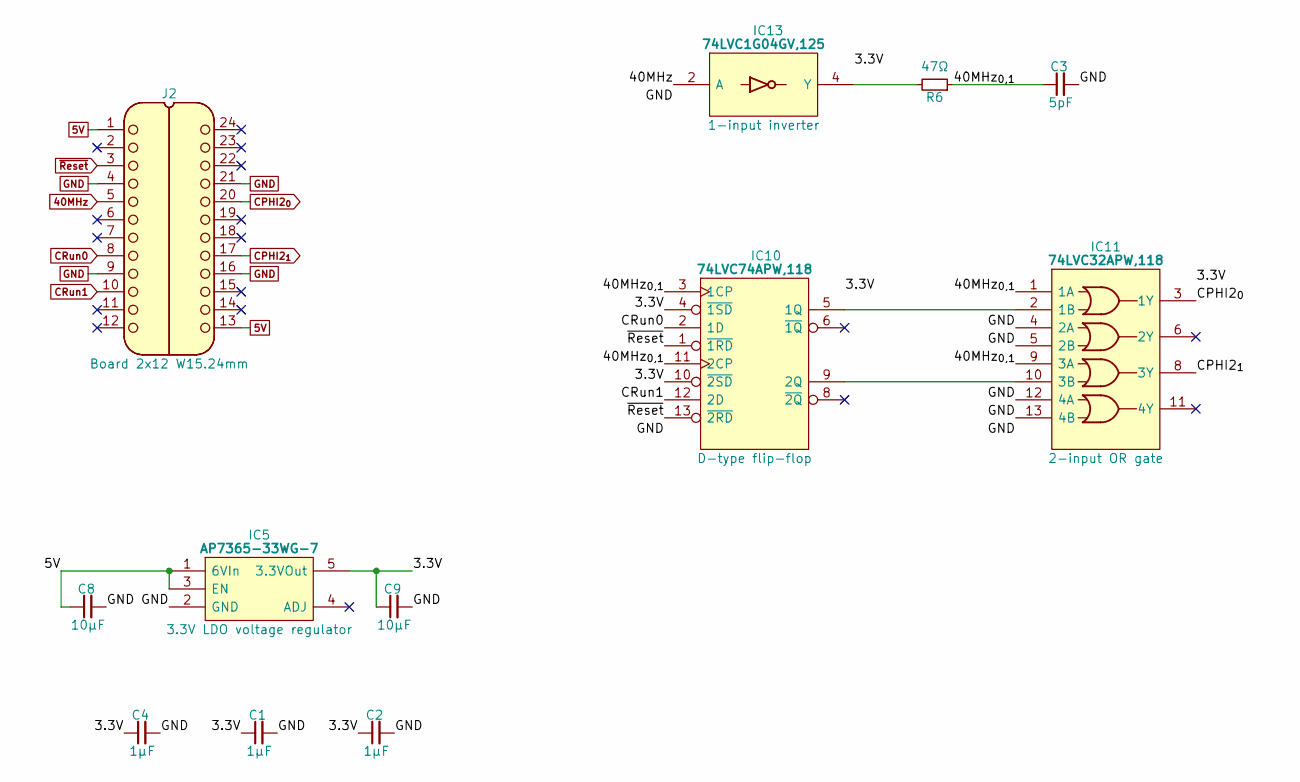
[picture p209: schematic Coprocessor Clock.kicad_sch, Coprocessor Memory Select]

Parts:
C1, C2, C4: 1μF; C_0805
C3: 5pF; C_0805
C8, C9: 10µF; C_0805
IC5: AP7365-33WG-7; SOT95P285X130-5N; Manufacturer_Part_Number AP7365-33WG-7; Mouser Part Number 621-AP7365-33WG-7
IC10: 74LVC74APW,118; SOP65P640X110-14N; Mouser Part Number 771-74LVC74APW-T
IC11: 74LVC32APW,118; SOP65P640X110-14N; Manufacturer_Part_Number 74LVC32APW,118; Mouser Part Number 771-74LVC32APW-T
IC13: 74LVC1G04GV,125; SOT95P275X110-5N; Manufacturer_Part_Number 74LVC1G04GV,125; Mouser Part Number 771-74LVC1G04GV
J2: Board 2x12 W15.24mm; DIP-24_Board_W15.24mm
R6: 47Ω; R_0805

Connections:
5V: C8.1, IC5.1 (6VIn), IC5.3 (EN), J2.1, J2.13
40MHz: IC13.2 (A), J2.5
/3.3V: C1.1, C2.1, C4.1, C9.1, IC5.5 (3.3VOut), IC10.4 (~1SD), IC10.10 (~2SD), IC10.14 (3V), IC11.14 (3V), IC13.5 (3V)
/40MHz_{0,1}: C3.1, IC10.3 (1CP), IC10.11 (2CP), IC11.1 (1A), IC11.9 (3A), R6.1
CPHI2_{0}: IC11.3 (1Y), J2.20
CPHI2_{1}: IC11.8 (3Y), J2.17
CRun0: IC10.2 (1D), J2.8
CRun1: IC10.12 (2D), J2.10
GND: C1.2, C2.2, C3.2, C4.2, C8.2, C9.2, IC5.2 (GND), IC10.7 (GND), IC11.4 (2A), IC11.5 (2B), IC11.7 (GND), IC11.12 (4A), IC11.13 (4B), IC13.3 (GND), J2.4, J2.9, J2.16, J2.21
unnamed: IC10.5 (1Q), IC11.2 (1B)
unnamed: IC10.9 (2Q), IC11.10 (3B)
unnamed: IC13.4 (Y), R6.2
~Reset: IC10.1 (~1RD), IC10.13 (~2RD), J2.3

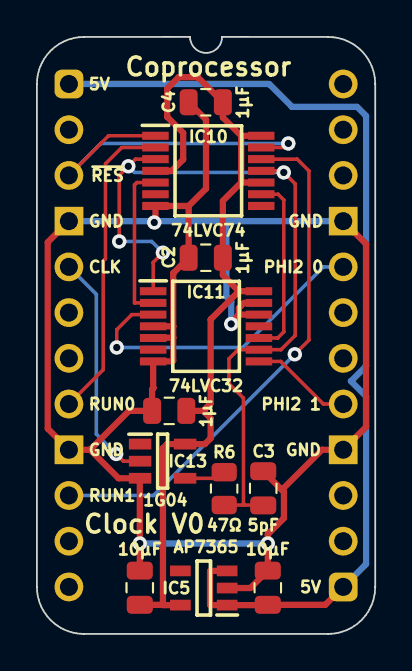
[picture p210: board Coprocessor Clock.kicad_pcb from above]

Board: 2 copper layers, 18.8 x 33.2 mm, 12 parts (0 on the bottom side), 13 nets.
