andrewpaterson/HCP65/Kicad/Computer/Processor/HCP65 Hold Count/HCP65 Hold Count.kicad_pcb

## KiCad design Kicad/Computer/Processor/HCP65 Hold Count/HCP65 Hold Count.kicad_pcb (2026-11-01)

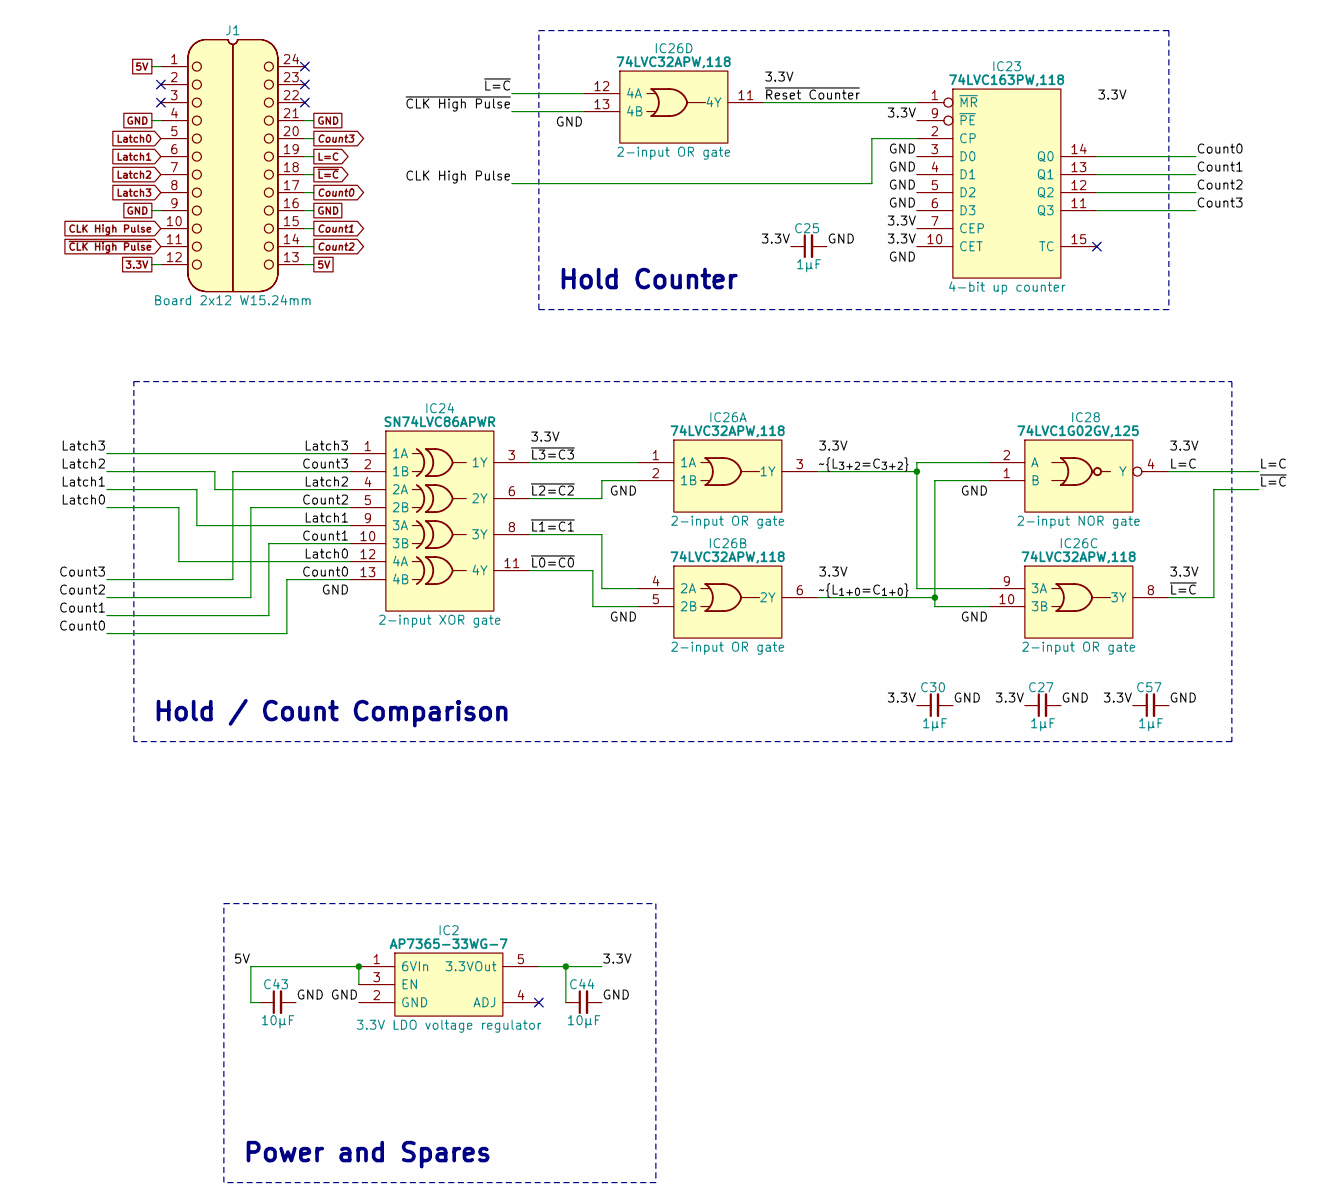
[picture p211: schematic HCP65 Hold Count.kicad_sch, Hold Count]

Parts:
C25, C27, C30, C57: 1μF; C_0805
C43, C44: 10μF; C_0805
IC2: AP7365-33WG-7; SOT95P285X130-5N; Manufacturer_Part_Number AP7365-33WG-7; Mouser Part Number 621-AP7365-33WG-7
IC23: 74LVC163PW,118; SOP65P640X110-16N; Mouser Part Number 771-74LVC163PW-T
IC24: SN74LVC86APWR; SOP65P640X120-14N; Manufacturer_Part_Number SN74LVC86APWR; Mouser Part Number 595-SN74LVC86APWR
IC26: 74LVC32APW,118; SOP65P640X110-14N; Manufacturer_Part_Number 74LVC32APW,118; Mouser Part Number 771-74LVC32APW-T
IC28: 74LVC1G02GV,125; SOT95P275X110-5N; Manufacturer_Part_Number 74LVC1G02GV,125; Mouser Part Number 771-LVC1G02GV125
J1: Board 2x12 W15.24mm; DIP-24_Board_W15.24mm

Connections:
3.3V: C25.1, C27.1, C30.1, C44.1, C57.1, IC2.5 (3.3VOut), IC23.7 (CEP), IC23.9 (~PE), IC23.10 (CET), IC23.16 (3V), IC24.14 (3V), IC26.14 (3V), IC28.5 (3V), J1.12
5V: C43.1, IC2.1 (6VIn), IC2.3 (EN), J1.1, J1.13
/~L0=C0: IC24.11 (4Y), IC26.5 (2B)
/~L1=C1: IC24.8 (3Y), IC26.4 (2A)
/~L2=C2: IC24.6 (2Y), IC26.2 (1B)
/~L3=C3: IC24.3 (1Y), IC26.1 (1A)
/~L_{1+0=C_{1+0}}: IC26.6 (2Y), IC26.10 (3B), IC28.1 (B)
/~L_{3+2=C_{3+2}}: IC26.3 (1Y), IC26.9 (3A), IC28.2 (A)
/~Reset Counter: IC23.1 (~MR), IC26.11 (4Y)
CLK High Pulse: IC23.2 (CP), J1.10
Count0: IC23.14 (Q0), IC24.13 (4B), J1.17
Count1: IC23.13 (Q1), IC24.10 (3B), J1.15
Count2: IC23.12 (Q2), IC24.5 (2B), J1.14
Count3: IC23.11 (Q3), IC24.2 (1B), J1.20
GND: C25.2, C27.2, C30.2, C43.2, C44.2, C57.2, IC2.2 (GND), IC23.3 (D0), IC23.4 (D1), IC23.5 (D2), IC23.6 (D3), IC23.8 (GND), IC24.7 (GND), IC26.7 (GND), IC28.3 (GND), J1.4, J1.9, J1.16, J1.21
L=C: IC28.4 (Y), J1.19
Latch0: IC24.12 (4A), J1.5
Latch1: IC24.9 (3A), J1.6
Latch2: IC24.4 (2A), J1.7
Latch3: IC24.1 (1A), J1.8
~CLK High Pulse: IC26.13 (4B), J1.11
~L=C: IC26.8 (3Y), IC26.12 (4A), J1.18

Notes on the sheet:
Power and Spares
Hold Counter
Hold / Count Comparison

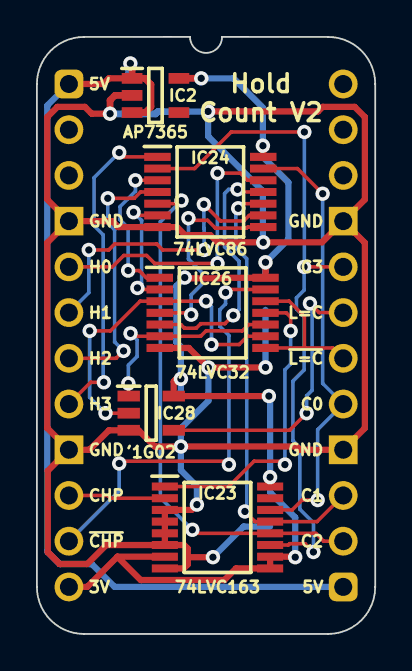
[picture p212: board HCP65 Hold Count.kicad_pcb from above]

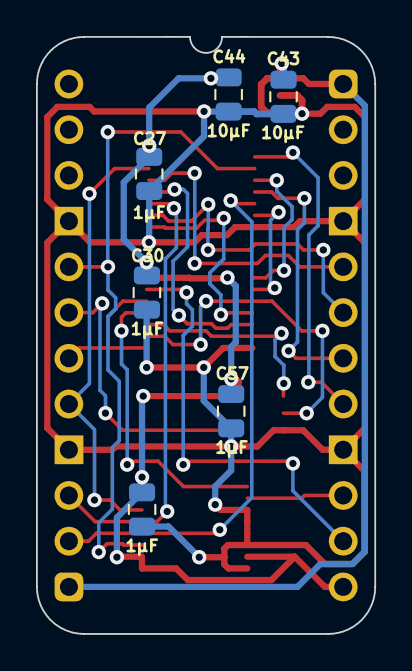
[picture p213: board HCP65 Hold Count.kicad_pcb from below]

Board: 2 copper layers, 18.8 x 33.2 mm, 12 parts (6 on the bottom side), 22 nets.
