andrewpaterson/HCP65/Kicad/Computer/Processor/HCP65 MPU Address Decode/HCP65 MPU Address Decode.kicad_pcb

## KiCad design Kicad/Computer/Processor/HCP65 MPU Address Decode/HCP65 MPU Address Decode.kicad_pcb (2026-11-01)

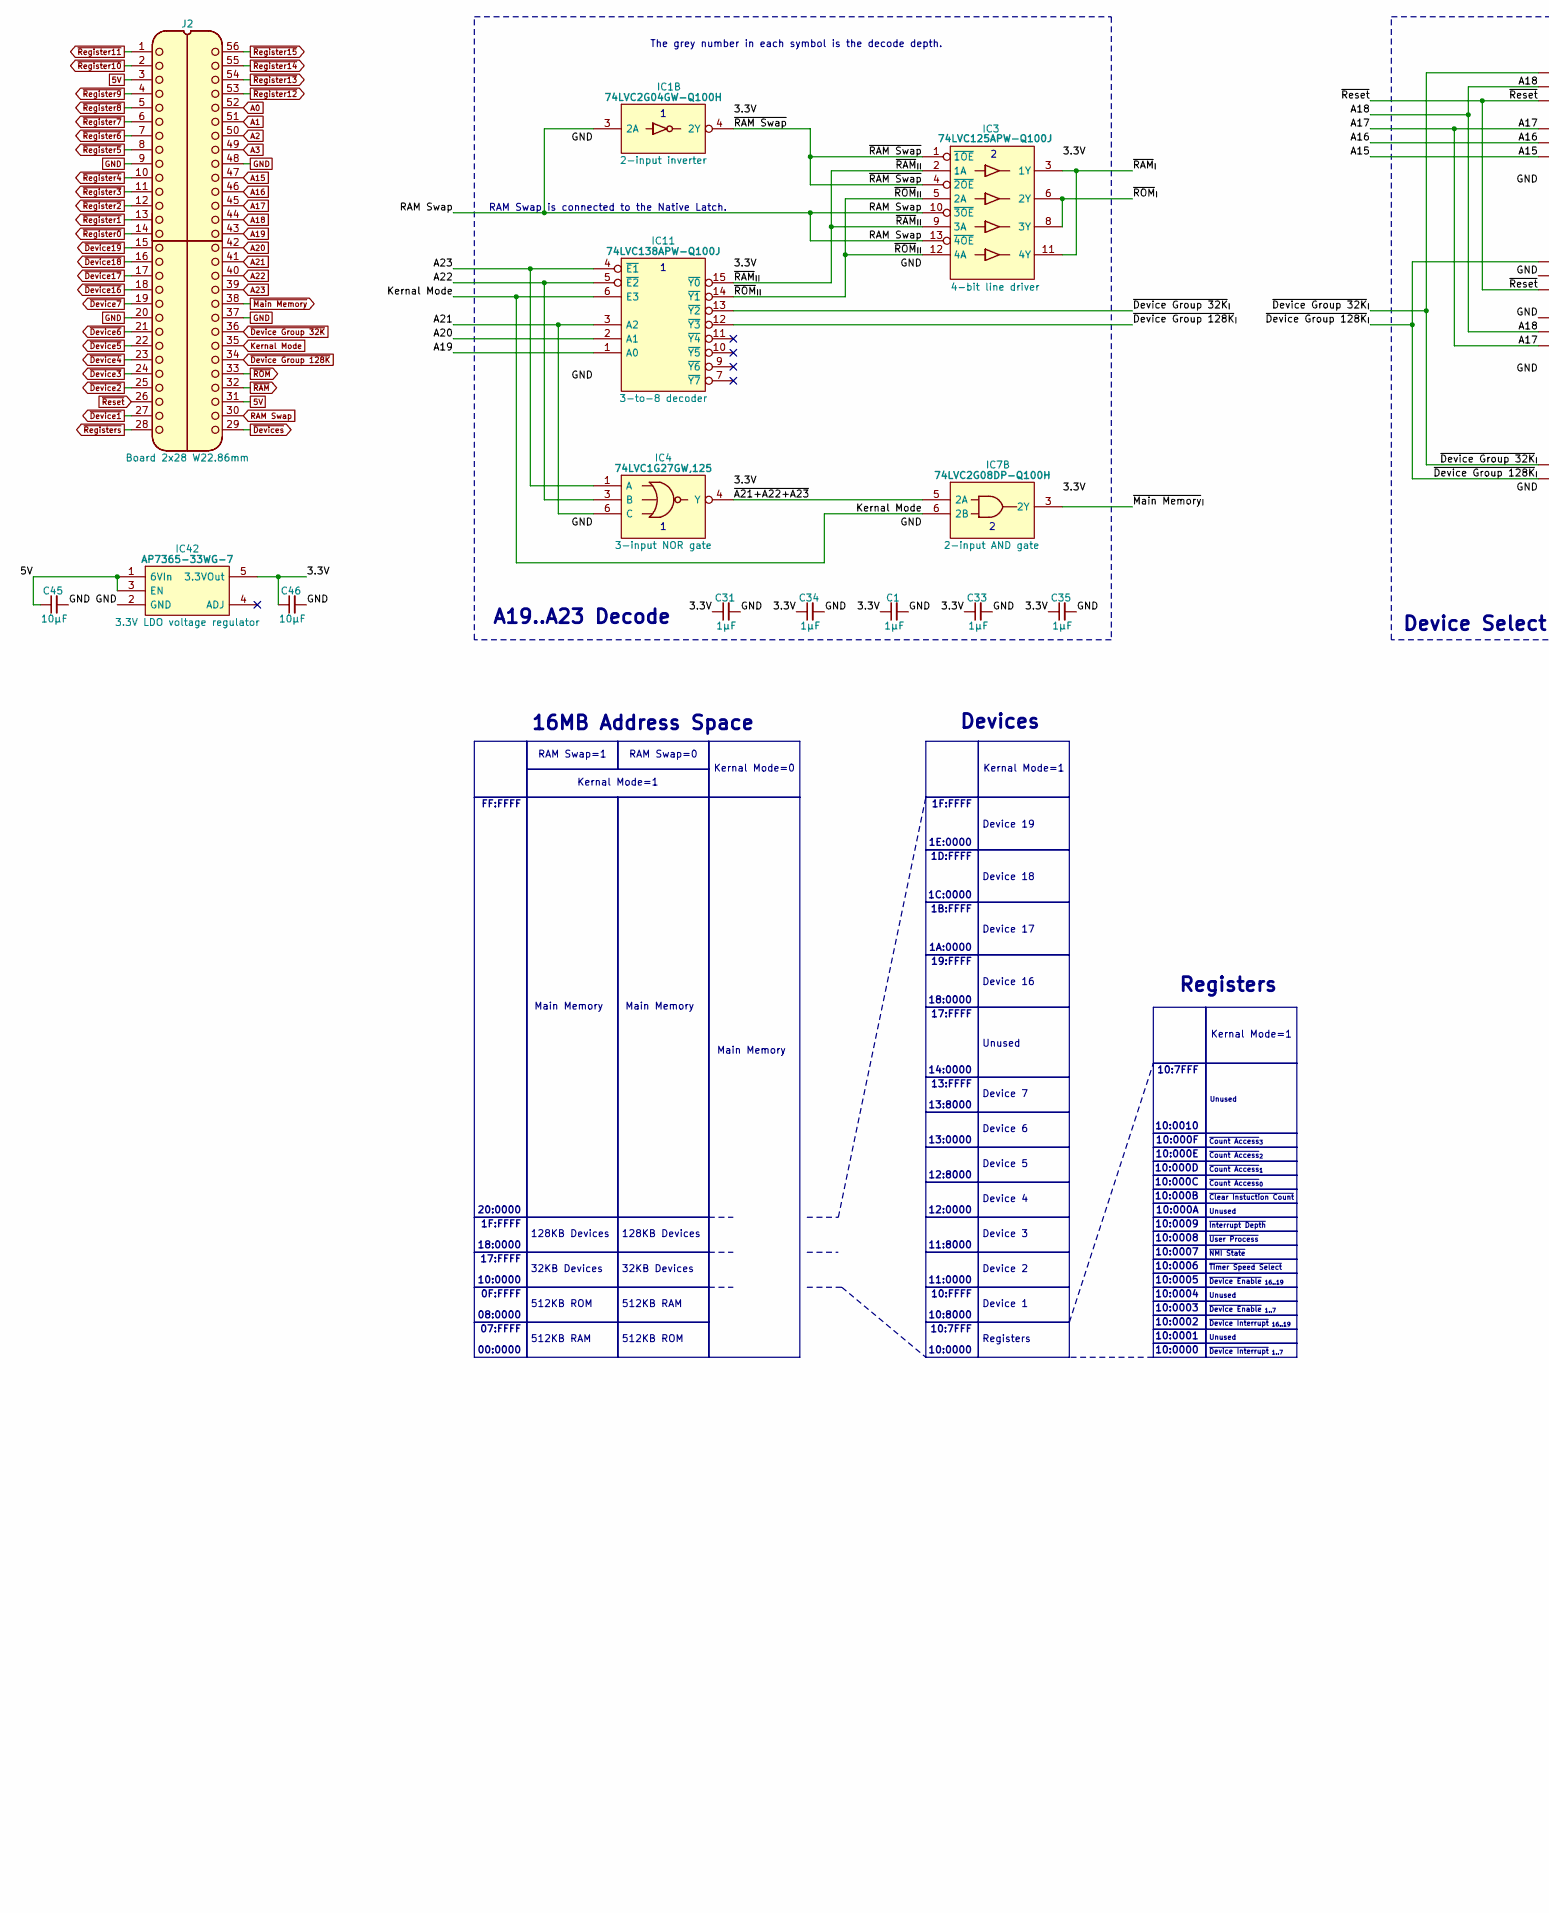
[picture p214: schematic HCP65 MPU Address Decode.kicad_sch, MPU Address Decode, part in row 1, column 1]

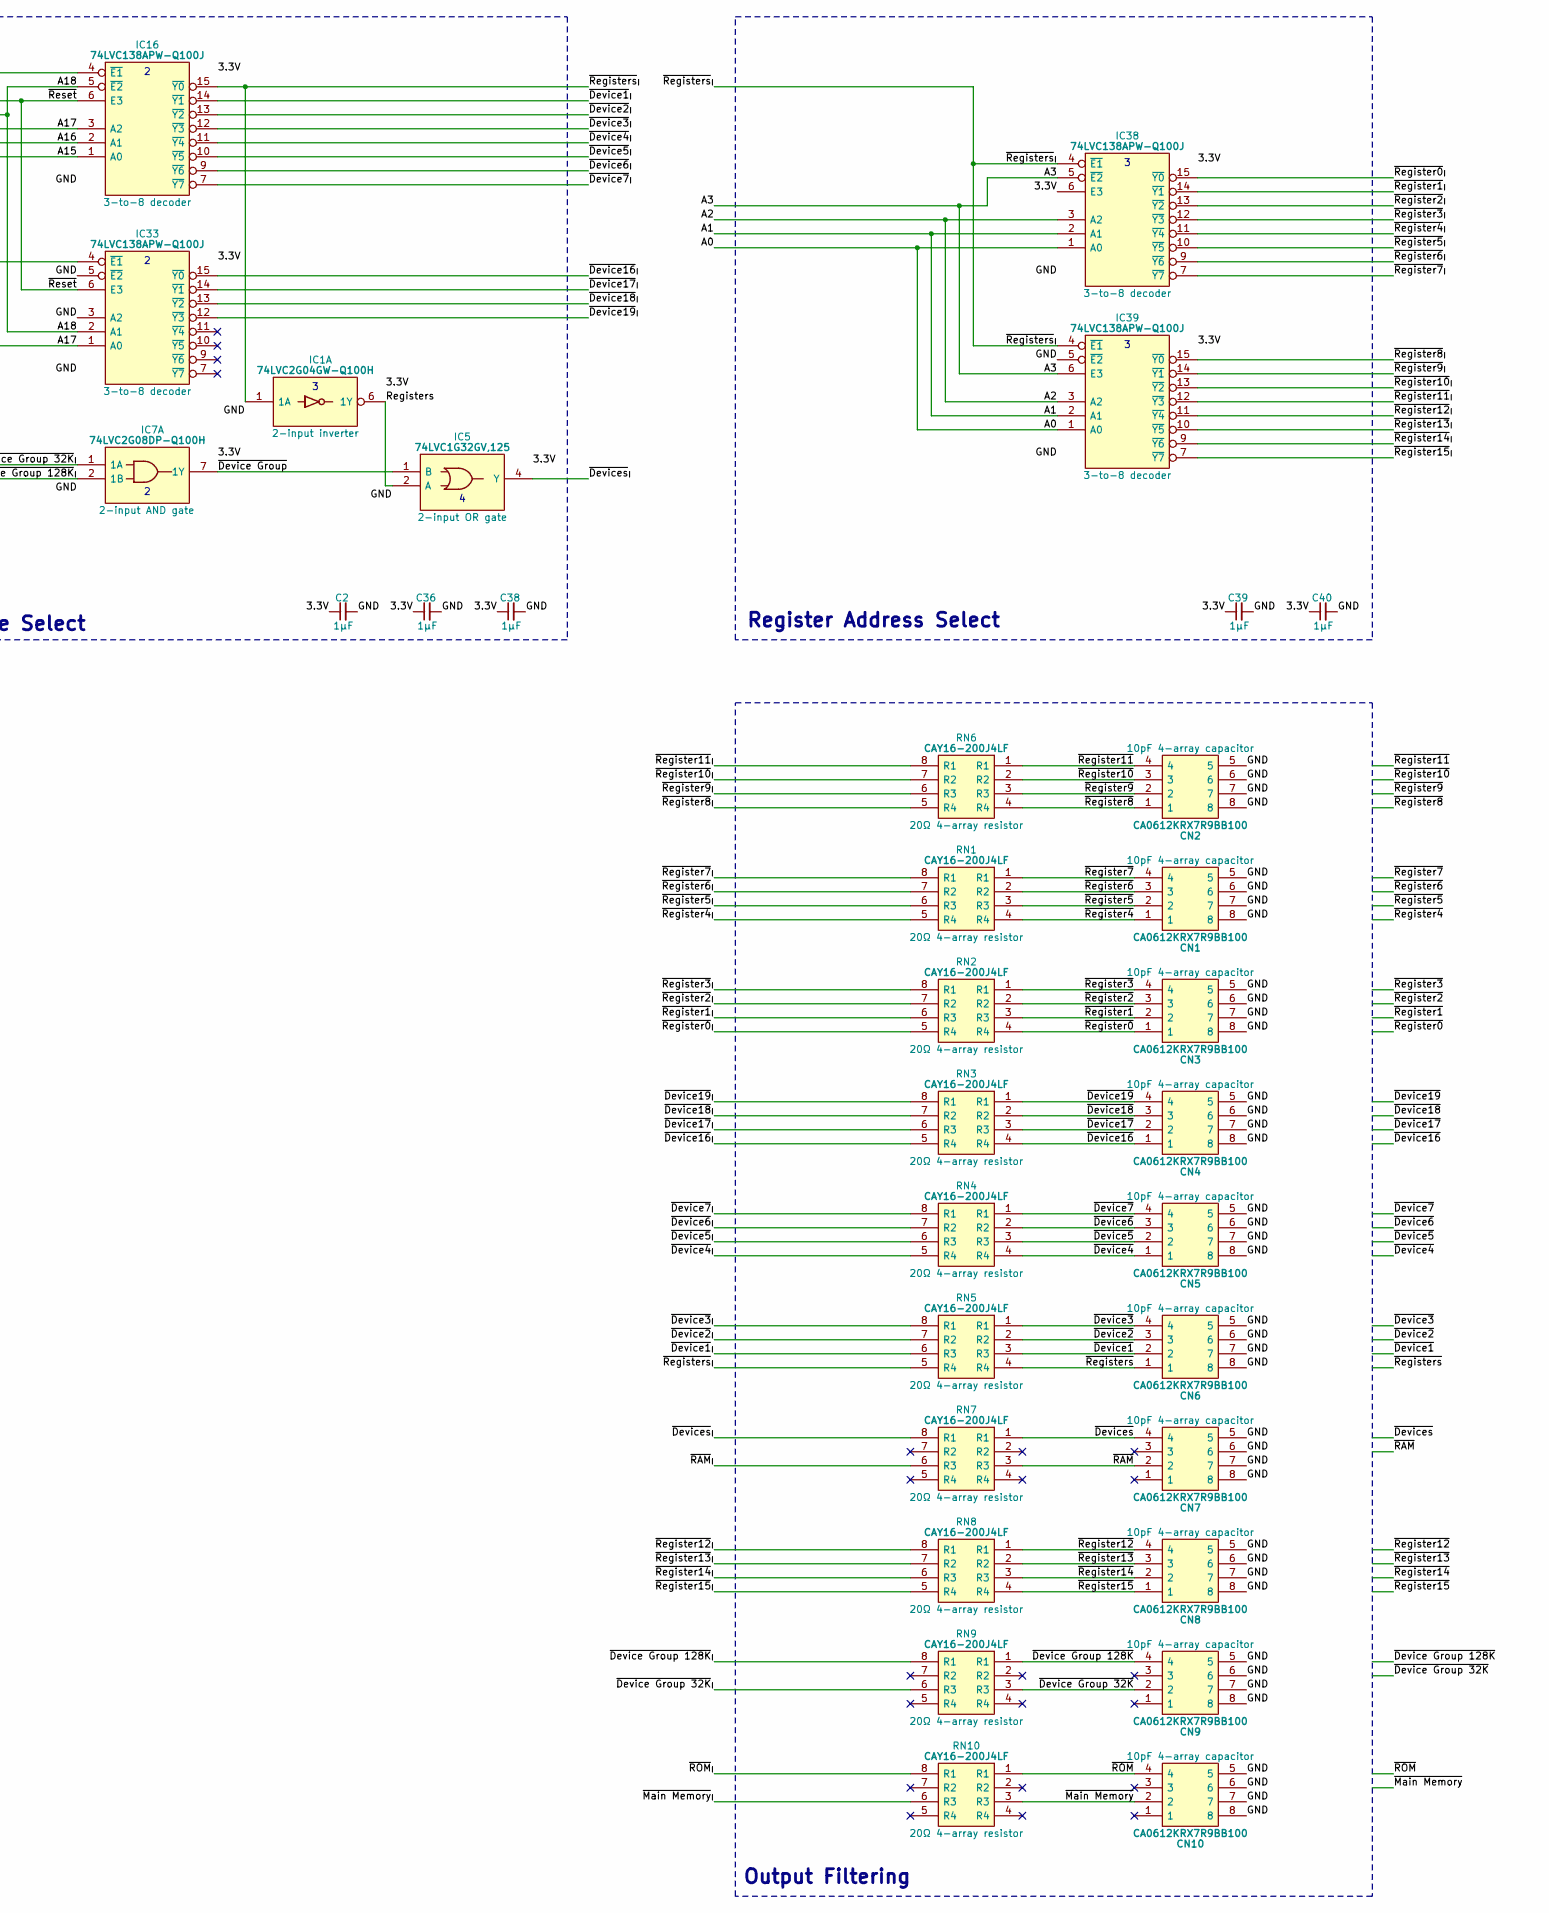
[picture p215: schematic HCP65 MPU Address Decode.kicad_sch, MPU Address Decode, part in row 1, column 2]

Parts:
C1, C2, C31, C33, C34, C35, C36, C38, C39, C40: 1μF; C_0805
C45, C46: 10μF; C_0805
CN1, CN2, CN3, CN4, CN5, CN6, CN7, CN8, CN9, CN10: CA0612KRX7R9BB100; Manufacturer_Part_Number CA0612KRX7R9BB102; Mouser Part Number 603-CA612KRX7R9BB102
IC1: 74LVC2G04GW-Q100H; SOP65P210X110-6N; Manufacturer_Part_Number 74LVC2G04GW-Q100H; Mouser Part Number 771-74LVC2G04GWQ100H
IC3: 74LVC125APW-Q100J; SOP65P640X110-14N; Manufacturer_Part_Number 74LVC125APW-Q100J; Mouser Part Number 771-74LVC125APWQ100J
IC4: 74LVC1G27GW,125; SOP65P210X110-6N; Mouser Part Number 771-74LVC1G27GW125
IC5: 74LVC1G32GV,125; SOT95P275X110-5N; Manufacturer_Part_Number 74LVC1G32GV,125; Mouser Part Number 771-LVC1G32GV125
IC7: 74LVC2G08DP-Q100H; SOP65P400X110-8N; Manufacturer_Part_Number 74LVC2G08DP-Q100H; Mouser Part Number 771-74LVC2G08DPQ100H
IC11, IC16, IC33, IC38, IC39: 74LVC138APW-Q100J; SOP65P640X110-16N; Mouser Part Number 771-74LVC138APWQ100J
IC42: AP7365-33WG-7; SOT95P285X130-5N; Manufacturer_Part_Number AP7365-33WG-7; Mouser Part Number 621-AP7365-33WG-7
J2: Board 2x28 W22.86mm; DIP-56_Board_W22.86mm
RN1, RN2, RN3, RN4, RN5, RN6, RN7, RN8, RN9, RN10: CAY16-200J4LF; CAY16-F4; Manufacturer_Part_Number CAY16-331J4LF; Mouser Part Number 652-CAY16-331J4LF

Connections:
5V: C45.1, IC42.1 (6VIn), IC42.3 (EN), J2.3, J2.31
/3.3V: C1.1, C2.1, C31.1, C33.1, C34.1, C35.1, C36.1, C38.1, C39.1, C40.1, C46.1, IC1.5 (3V), IC3.14 (3V), IC4.5 (3V), IC5.5 (3V), IC7.8 (3V), IC11.16 (3V), IC16.16 (3V), IC33.16 (3V), IC38.6 (E3), IC38.16 (3V), IC39.16 (3V), IC42.5 (3.3VOut)
/Registers: IC1.6 (1Y), IC5.2 (A)
/~A21+A22+A23: IC4.4 (Y), IC7.5 (2A)
/~Device1_{I}: IC16.14 (~Y1), RN5.6 (R3)
/~Device2_{I}: IC16.13 (~Y2), RN5.7 (R2)
/~Device3_{I}: IC16.12 (~Y3), RN5.8 (R1)
/~Device4_{I}: IC16.11 (~Y4), RN4.5 (R4)
/~Device5_{I}: IC16.10 (~Y5), RN4.6 (R3)
/~Device6_{I}: IC16.9 (~Y6), RN4.7 (R2)
/~Device7_{I}: IC16.7 (~Y7), RN4.8 (R1)
/~Device16_{I}: IC33.15 (~Y0), RN3.5 (R4)
/~Device17_{I}: IC33.14 (~Y1), RN3.6 (R3)
/~Device18_{I}: IC33.13 (~Y2), RN3.7 (R2)
/~Device19_{I}: IC33.12 (~Y3), RN3.8 (R1)
/~Device Group 32K_{I}: IC7.1 (1A), IC11.13 (~Y2), IC16.4 (~E1), RN9.6 (R3)
/~Device Group 128K_{I}: IC7.2 (1B), IC11.12 (~Y3), IC33.4 (~E1), RN9.8 (R1)
/~Device Group: IC5.1 (B), IC7.7 (1Y)
/~Devices_{I}: IC5.4 (Y), RN7.8 (R1)
/~Main Memory_{I}: IC7.3 (2Y), RN10.6 (R3)
/~RAM Swap: IC1.4 (2Y), IC3.1 (~1OE), IC3.4 (~2OE)
/~RAM_{II}: IC3.2 (1A), IC3.9 (3A), IC11.15 (~Y0)
/~RAM_{I}: IC3.3 (1Y), IC3.11 (4Y), RN7.6 (R3)
/~ROM_{II}: IC3.5 (2A), IC3.12 (4A), IC11.14 (~Y1)
/~ROM_{I}: IC3.6 (2Y), IC3.8 (3Y), RN10.8 (R1)
/~Register0_{I}: IC38.15 (~Y0), RN2.5 (R4)
/~Register1_{I}: IC38.14 (~Y1), RN2.6 (R3)
/~Register2_{I}: IC38.13 (~Y2), RN2.7 (R2)
/~Register3_{I}: IC38.12 (~Y3), RN2.8 (R1)
/~Register4_{I}: IC38.11 (~Y4), RN1.5 (R4)
/~Register5_{I}: IC38.10 (~Y5), RN1.6 (R3)
/~Register6_{I}: IC38.9 (~Y6), RN1.7 (R2)
/~Register7_{I}: IC38.7 (~Y7), RN1.8 (R1)
/~Register8_{I}: IC39.15 (~Y0), RN6.5 (R4)
/~Register9_{I}: IC39.14 (~Y1), RN6.6 (R3)
/~Register10_{I}: IC39.13 (~Y2), RN6.7 (R2)
/~Register11_{I}: IC39.12 (~Y3), RN6.8 (R1)
/~Register12_{I}: IC39.11 (~Y4), RN8.8 (R1)
/~Register13_{I}: IC39.10 (~Y5), RN8.7 (R2)
/~Register14_{I}: IC39.9 (~Y6), RN8.6 (R3)
/~Register15_{I}: IC39.7 (~Y7), RN8.5 (R4)
/~Registers_{I}: IC1.1 (1A), IC16.15 (~Y0), IC38.4 (~E1), IC39.4 (~E1), RN5.5 (R4)
A0: IC38.1 (A0), IC39.1 (A0), J2.52
A1: IC38.2 (A1), IC39.2 (A1), J2.51
A2: IC38.3 (A2), IC39.3 (A2), J2.50
A3: IC38.5 (~E2), IC39.6 (E3), J2.49
A15: IC16.1 (A0), J2.47
A16: IC16.2 (A1), J2.46
A17: IC16.3 (A2), IC33.1 (A0), J2.45
A18: IC16.5 (~E2), IC33.2 (A1), J2.44
A19: IC11.1 (A0), J2.43
A20: IC11.2 (A1), J2.42
A21: IC4.6 (C), IC11.3 (A2), J2.41
A22: IC4.3 (B), IC11.5 (~E2), J2.40
A23: IC4.1 (A), IC11.4 (~E1), J2.39
GND: C1.2, C2.2, C31.2, C33.2, C34.2, C35.2, C36.2, C38.2, C39.2, C40.2, C45.2, C46.2, CN1.5, CN1.6, CN1.7, CN1.8, CN2.5, CN2.6, CN2.7, CN2.8, CN3.5, CN3.6, CN3.7, CN3.8, CN4.5, CN4.6, CN4.7, CN4.8, CN5.5, CN5.6, CN5.7, CN5.8, CN6.5, CN6.6, CN6.7, CN6.8, CN7.5, CN7.6, CN7.7, CN7.8, CN8.5, CN8.6, CN8.7, CN8.8, CN9.5, CN9.6, CN9.7, CN9.8, CN10.5, CN10.6, CN10.7, CN10.8, IC1.2 (GND), IC3.7 (GND), IC4.2 (GND), IC5.3 (GND), IC7.4 (GND), IC11.8 (GND), IC16.8 (GND), IC33.3 (A2), IC33.5 (~E2), IC33.8 (GND), IC38.8 (GND), IC39.5 (~E2), IC39.8 (GND), IC42.2 (GND), J2.9, J2.20, J2.37, J2.48
Kernal Mode: IC7.6 (2B), IC11.6 (E3), J2.35
RAM Swap: IC1.3 (2A), IC3.10 (~3OE), IC3.13 (~4OE), J2.30
~Device1: CN6.2, J2.27, RN5.3 (R3)
~Device2: CN6.3, J2.25, RN5.2 (R2)
~Device3: CN6.4, J2.24, RN5.1 (R1)
~Device4: CN5.1, J2.23, RN4.4 (R4)
~Device5: CN5.2, J2.22, RN4.3 (R3)
~Device6: CN5.3, J2.21, RN4.2 (R2)
~Device7: CN5.4, J2.19, RN4.1 (R1)
~Device16: CN4.1, J2.18, RN3.4 (R4)
~Device17: CN4.2, J2.17, RN3.3 (R3)
~Device18: CN4.3, J2.16, RN3.2 (R2)
~Device19: CN4.4, J2.15, RN3.1 (R1)
~Device Group 32K: CN9.2, J2.36, RN9.3 (R3)
~Device Group 128K: CN9.4, J2.34, RN9.1 (R1)
~Devices: CN7.4, J2.29, RN7.1 (R1)
~Main Memory: CN10.2, J2.38, RN10.3 (R3)
~RAM: CN7.2, J2.32, RN7.3 (R3)
~ROM: CN10.4, J2.33, RN10.1 (R1)
~Register0: CN3.1, J2.14, RN2.4 (R4)
~Register1: CN3.2, J2.13, RN2.3 (R3)
~Register2: CN3.3, J2.12, RN2.2 (R2)
~Register3: CN3.4, J2.11, RN2.1 (R1)
~Register4: CN1.1, J2.10, RN1.4 (R4)
~Register5: CN1.2, J2.8, RN1.3 (R3)
~Register6: CN1.3, J2.7, RN1.2 (R2)
~Register7: CN1.4, J2.6, RN1.1 (R1)
~Register8: CN2.1, J2.5, RN6.4 (R4)
~Register9: CN2.2, J2.4, RN6.3 (R3)
~Register10: CN2.3, J2.2, RN6.2 (R2)
~Register11: CN2.4, J2.1, RN6.1 (R1)
~Register12: CN8.4, J2.53, RN8.1 (R1)
~Register13: CN8.3, J2.54, RN8.2 (R2)
~Register14: CN8.2, J2.55, RN8.3 (R3)
~Register15: CN8.1, J2.56, RN8.4 (R4)
~Registers: CN6.1, J2.28, RN5.4 (R4)
~Reset: IC16.6 (E3), IC33.6 (E3), J2.26

Notes on the sheet:
17:FFFF
10:0009
Unused
512KB RAM
18:0000
RAM Swap=1
14:0000
10:0006
13:0000
1E:0000
Main Memory
~{Timer Speed Select}
10:8000
10:000F
Kernal Mode=1
Device 17
Kernal Mode=0
~{Interrupt Depth}
~{Device Enable}_{ 1..7}
1C:0000
10:0001
00:0000
19:FFFF
13:FFFF
~{Device Enable}_{ 16..19}
10:0004
10:0000
10:7FFF
10:FFFF
10:000A
~{Device Interrupt}_{ 16..19}
20:0000
11:0000
~{User Process}
Device 5
128KB Devices
512KB ROM
1B:FFFF
Device 6
Registers
12:8000
10:000B
10:0008
Device 16
32KB Devices
~{Count Access}_{0}
~{Device Interrupt}_{ 1..7}
FF:FFFF
Register Address Select
10:0003
Device Select
1A:0000
RAM Swap=0
~{Count Access}_{2}
Devices
08:0000
Device 19
10:0005
0F:FFFF
07:FFFF
12:0000
Device 3
~{Clear Instuction Count}
Device 18
1D:FFFF
10:0007
Device 2
~{NMI State}
RAM Swap is connected to the Native Latch.
1F:FFFF
Device 1
16MB Address Space
13:8000
Device 7
~{Count Access}_{1}
~{Count Access}_{3}
10:0010
11:8000
Output Filtering
10:000E
10:000C
10:0002
Device 4
10:000D
A19..A23 Decode
The grey number in each symbol is the decode depth.

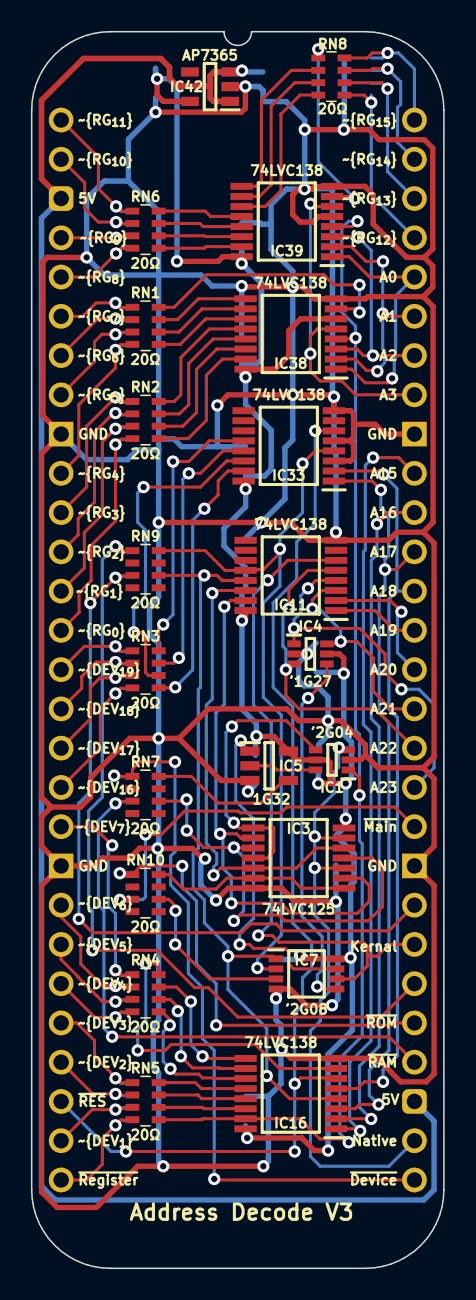
[picture p216: board HCP65 MPU Address Decode.kicad_pcb from above]

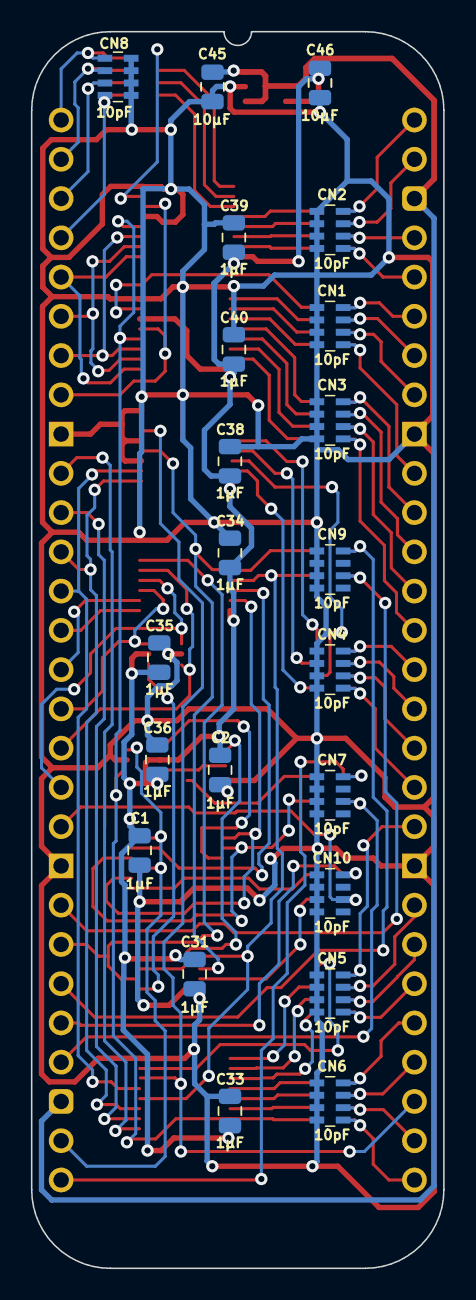
[picture p217: board HCP65 MPU Address Decode.kicad_pcb from below]

Board: 2 copper layers, 26.7 x 80.0 mm, 44 parts (22 on the bottom side), 93 nets.
