andrewpaterson/HCP65/Kicad/Computer/Component Boards/Selector 1-of-4 4bit/Selector 1-of-4 4bit.kicad_pcb

## KiCad design Kicad/Computer/Component Boards/Selector 1-of-4 4bit/Selector 1-of-4 4bit.kicad_pcb (2026-11-01)

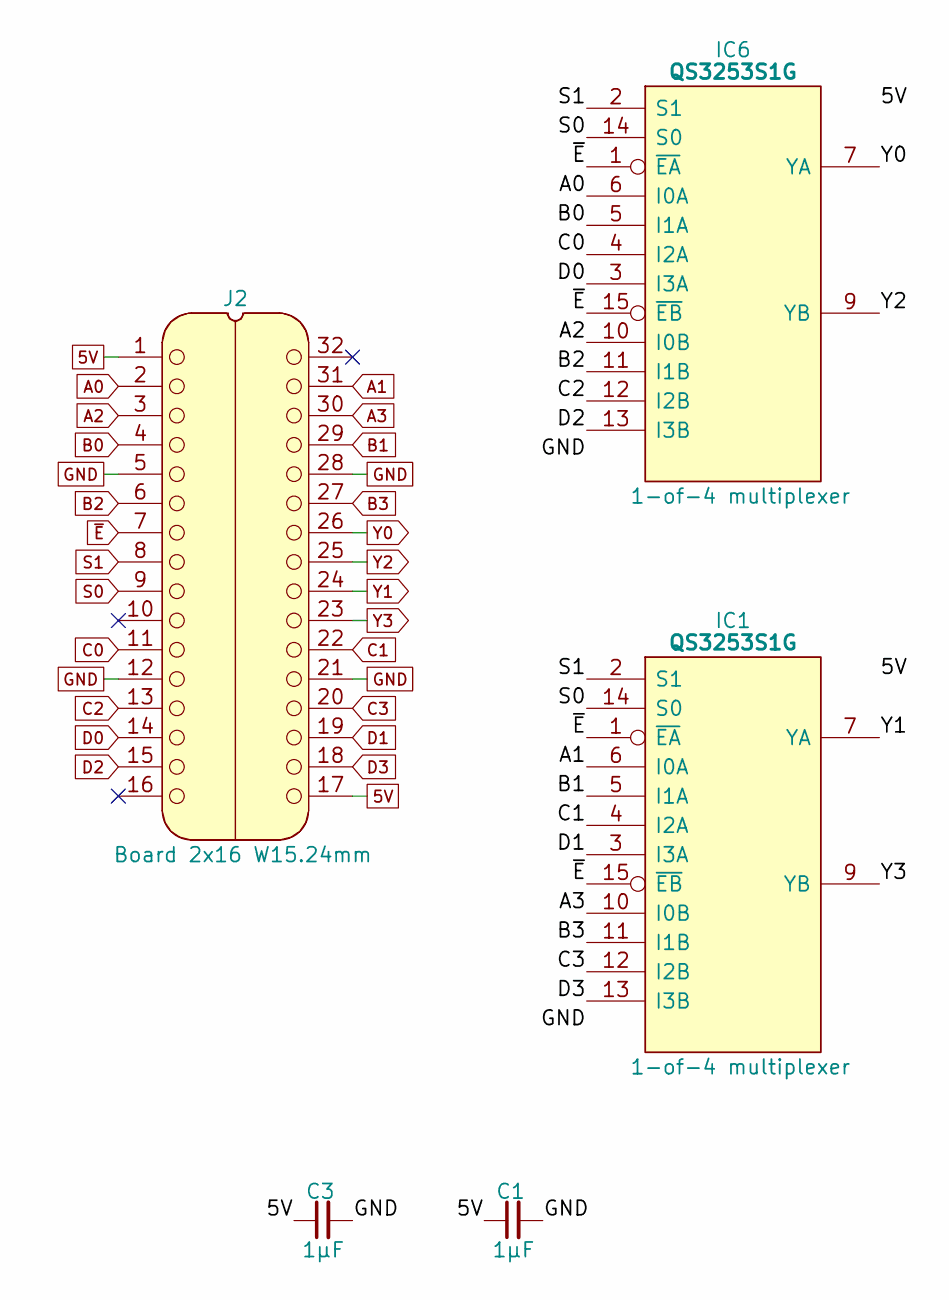
[picture p218: schematic Selector 1-of-4 4bit.kicad_sch]

Parts:
C1, C3: 1μF; C_0805
IC1, IC6: QS3253S1G; SOIC127P602X173-16N; Manufacturer_Part_Number QS3253S1G
J2: Board 2x16 W15.24mm; DIP-32_Board_W15.24mm

Connections:
5V: C1.1, C3.1, IC1.16 (5V), IC6.16 (5V), J2.1, J2.17
A0: IC6.6 (I0A), J2.2
A1: IC1.6 (I0A), J2.31
A2: IC6.10 (I0B), J2.3
A3: IC1.10 (I0B), J2.30
B0: IC6.5 (I1A), J2.4
B1: IC1.5 (I1A), J2.29
B2: IC6.11 (I1B), J2.6
B3: IC1.11 (I1B), J2.27
C0: IC6.4 (I2A), J2.11
C1: IC1.4 (I2A), J2.22
C2: IC6.12 (I2B), J2.13
C3: IC1.12 (I2B), J2.20
D0: IC6.3 (I3A), J2.14
D1: IC1.3 (I3A), J2.19
D2: IC6.13 (I3B), J2.15
D3: IC1.13 (I3B), J2.18
GND: C1.2, C3.2, IC1.8 (GND), IC6.8 (GND), J2.5, J2.12, J2.21, J2.28
S0: IC1.14 (S0), IC6.14 (S0), J2.9
S1: IC1.2 (S1), IC6.2 (S1), J2.8
Y0: IC6.7 (YA), J2.26
Y1: IC1.7 (YA), J2.24
Y2: IC6.9 (YB), J2.25
Y3: IC1.9 (YB), J2.23
~E: IC1.1 (~EA), IC1.15 (~EB), IC6.1 (~EA), IC6.15 (~EB), J2.7

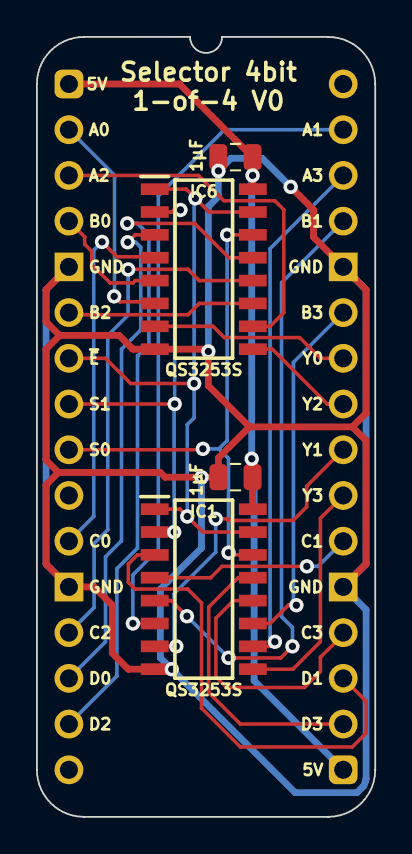
[picture p219: board Selector 1-of-4 4bit.kicad_pcb from above]

Board: 2 copper layers, 18.8 x 43.3 mm, 5 parts (0 on the bottom side), 25 nets.
