andrewpaterson/HCP65/Kicad/Computer/Video/Video Address Reader/Video Address Reader.kicad_pcb

## KiCad design Kicad/Computer/Video/Video Address Reader/Video Address Reader.kicad_pcb (2026-11-01)

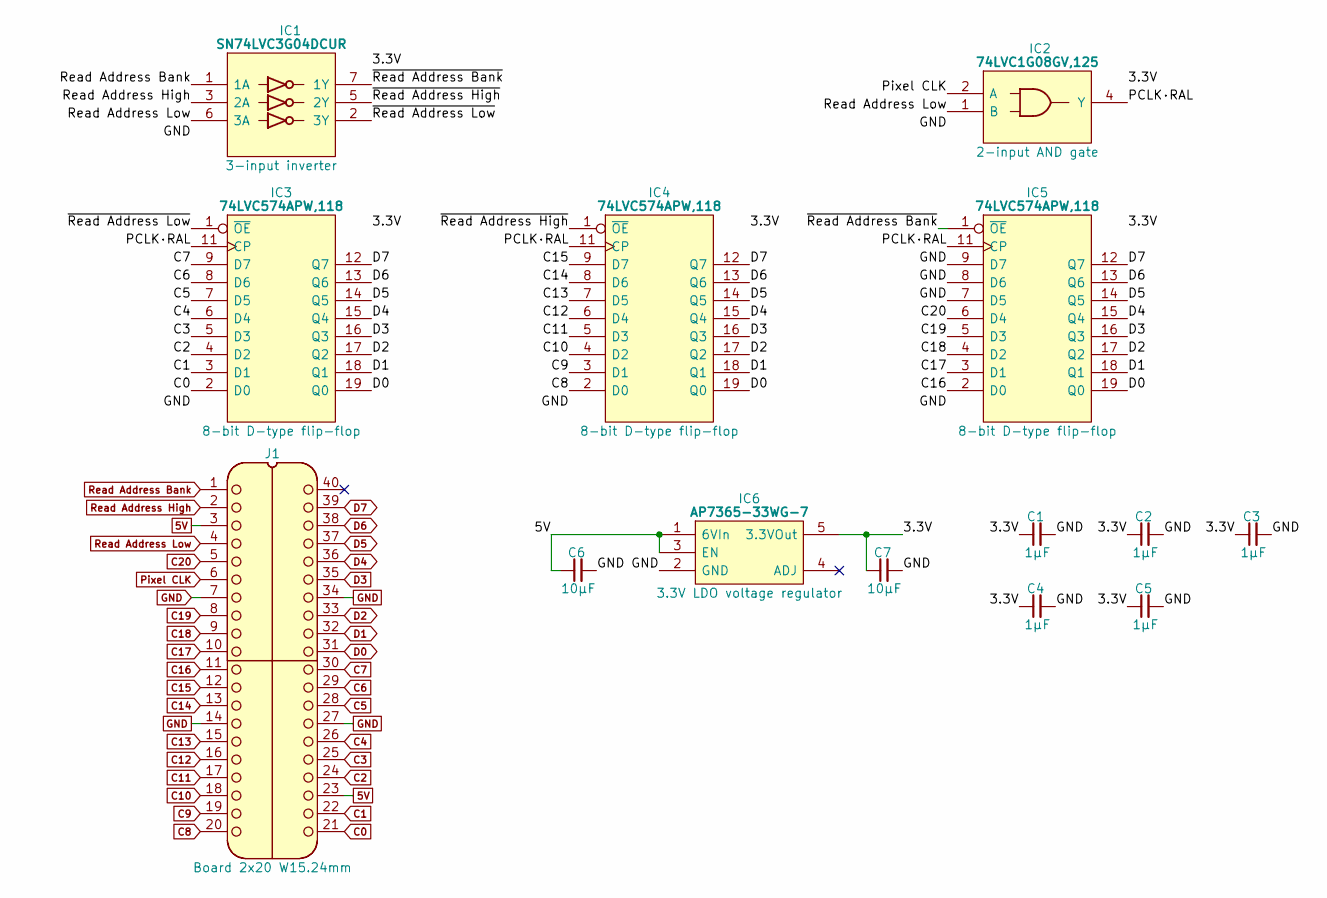
[picture p220: schematic Video Address Reader.kicad_sch]

Parts:
C1, C2, C3, C4, C5: 1μF; C_0805
C6, C7: 10µF; C_0805
IC1: SN74LVC3G04DCUR; SOP50P310X90-8N; Manufacturer_Part_Number SN74LVC3G04DCUR; Mouser Part Number 595-SN74LVC3G04DCUR
IC2: 74LVC1G08GV,125; SOT95P275X110-5N; Manufacturer_Part_Number 74LVC1G08GV,125; Mouser Part Number 771-74LVC1G08GV
IC3, IC4, IC5: 74LVC574APW,118; SOP65P640X110-20N; Manufacturer_Part_Number 74LVC574APW,118; Mouser Part Number 771-74LVC574APW-T
IC6: AP7365-33WG-7; SOT95P285X130-5N; Manufacturer_Part_Number AP7365-33WG-7; Mouser Part Number 621-AP7365-33WG-7
J1: Board 2x20 W15.24mm; DIP-40_Board_W15.24mm

Connections:
5V: C6.1, IC6.1 (6VIn), IC6.3 (EN), J1.3, J1.23
/3.3V: C1.1, C2.1, C3.1, C4.1, C5.1, C7.1, IC1.8 (3V), IC2.5 (3V), IC3.20 (3V), IC4.20 (3V), IC5.20 (3V), IC6.5 (3.3VOut)
/PCLK·RAL: IC2.4 (Y), IC3.11 (CP), IC4.11 (CP), IC5.11 (CP)
/~Read Address Bank: IC1.7 (1Y), IC5.1 (~OE)
/~Read Address High: IC1.5 (2Y), IC4.1 (~OE)
/~Read Address Low: IC1.2 (3Y), IC3.1 (~OE)
C0: IC3.2 (D0), J1.21
C1: IC3.3 (D1), J1.22
C2: IC3.4 (D2), J1.24
C3: IC3.5 (D3), J1.25
C4: IC3.6 (D4), J1.26
C5: IC3.7 (D5), J1.28
C6: IC3.8 (D6), J1.29
C7: IC3.9 (D7), J1.30
C8: IC4.2 (D0), J1.20
C9: IC4.3 (D1), J1.19
C10: IC4.4 (D2), J1.18
C11: IC4.5 (D3), J1.17
C12: IC4.6 (D4), J1.16
C13: IC4.7 (D5), J1.15
C14: IC4.8 (D6), J1.13
C15: IC4.9 (D7), J1.12
C16: IC5.2 (D0), J1.11
C17: IC5.3 (D1), J1.10
C18: IC5.4 (D2), J1.9
C19: IC5.5 (D3), J1.8
C20: IC5.6 (D4), J1.5
D0: IC3.19 (Q0), IC4.19 (Q0), IC5.19 (Q0), J1.31
D1: IC3.18 (Q1), IC4.18 (Q1), IC5.18 (Q1), J1.32
D2: IC3.17 (Q2), IC4.17 (Q2), IC5.17 (Q2), J1.33
D3: IC3.16 (Q3), IC4.16 (Q3), IC5.16 (Q3), J1.35
D4: IC3.15 (Q4), IC4.15 (Q4), IC5.15 (Q4), J1.36
D5: IC3.14 (Q5), IC4.14 (Q5), IC5.14 (Q5), J1.37
D6: IC3.13 (Q6), IC4.13 (Q6), IC5.13 (Q6), J1.38
D7: IC3.12 (Q7), IC4.12 (Q7), IC5.12 (Q7), J1.39
GND: C1.2, C2.2, C3.2, C4.2, C5.2, C6.2, C7.2, IC1.4 (GND), IC2.3 (GND), IC3.10 (GND), IC4.10 (GND), IC5.7 (D5), IC5.8 (D6), IC5.9 (D7), IC5.10 (GND), IC6.2 (GND), J1.7, J1.14, J1.27, J1.34
Pixel CLK: IC2.2 (A), J1.6
Read Address Bank: IC1.1 (1A), J1.1
Read Address High: IC1.3 (2A), J1.2
Read Address Low: IC1.6 (3A), IC2.1 (B), J1.4

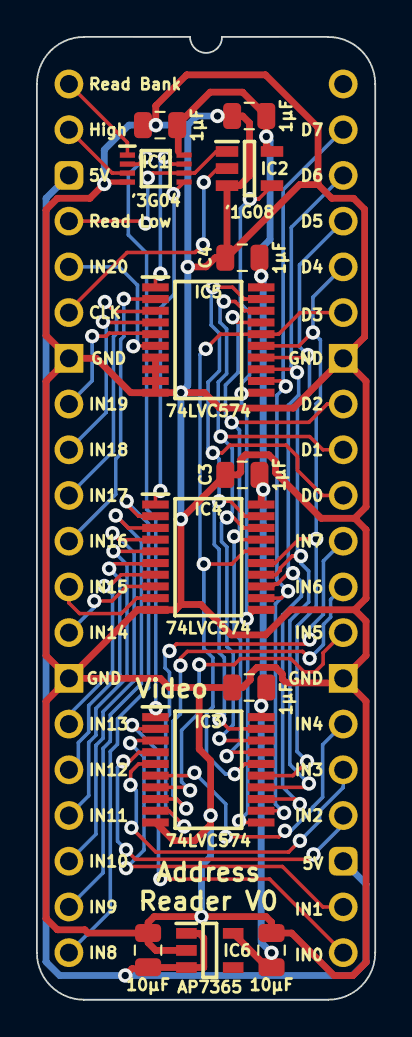
[picture p221: board Video Address Reader.kicad_pcb from above]

Board: 2 copper layers, 18.8 x 53.5 mm, 14 parts (0 on the bottom side), 40 nets.
