andrewpaterson/HCP65/Kicad/Computer/Component Boards/Device Decode stage B/Device Decode stage B.kicad_pcb

## KiCad design Kicad/Computer/Component Boards/Device Decode stage B/Device Decode stage B.kicad_pcb (2026-11-01)

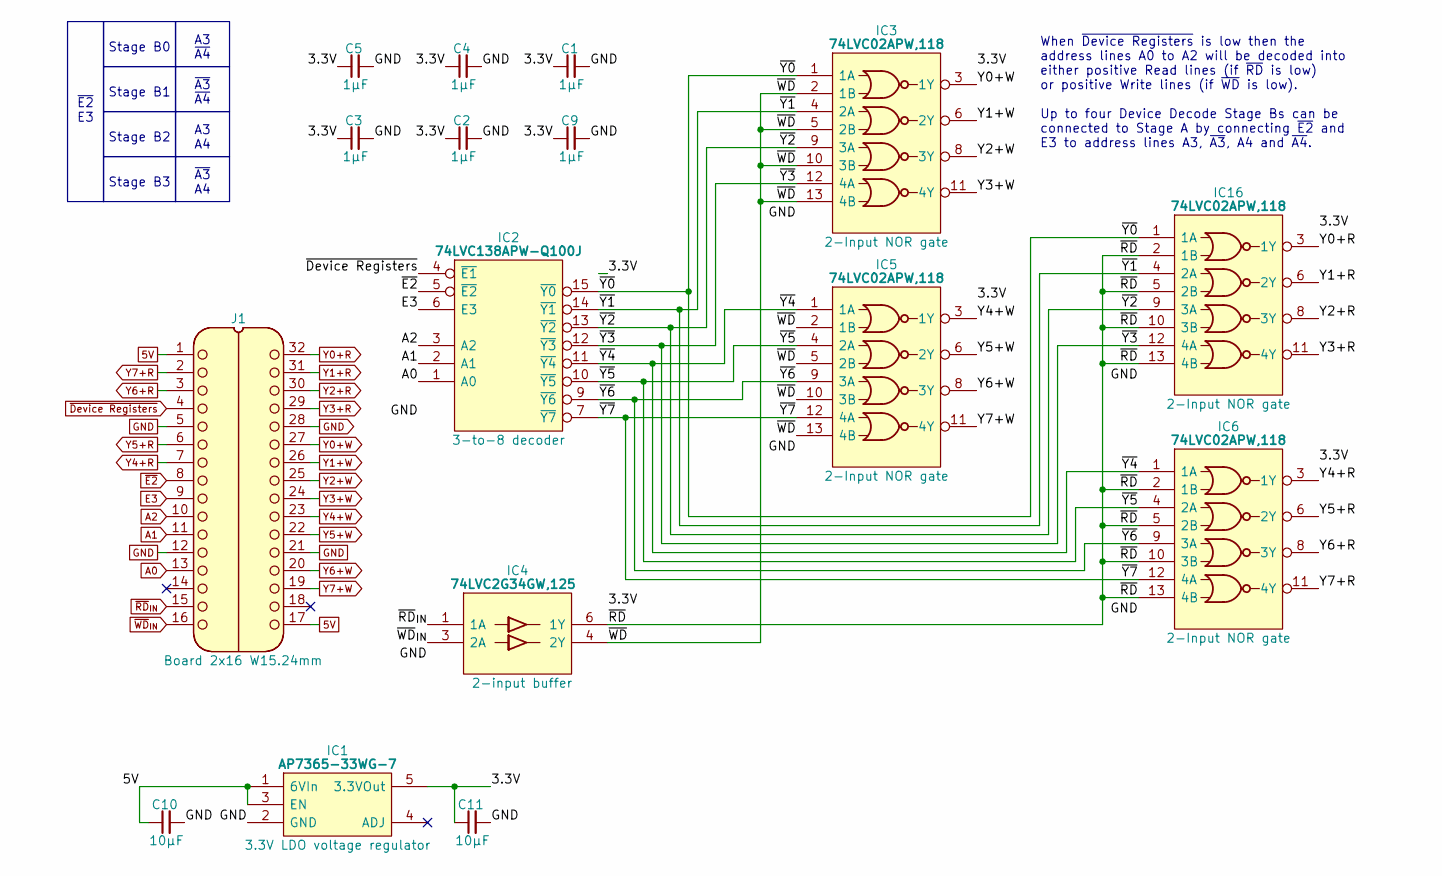
[picture p222: schematic Device Decode stage B.kicad_sch]

Parts:
C1, C2, C3, C4, C5, C9: 1μF; C_0805
C10, C11: 10µF; C_0805
IC1: AP7365-33WG-7; SOT95P285X130-5N; Manufacturer_Part_Number AP7365-33WG-7; Mouser Part Number 621-AP7365-33WG-7
IC2: 74LVC138APW-Q100J; SOP65P640X110-16N; Mouser Part Number 771-74LVC138APWQ100J
IC3, IC5, IC6, IC16: 74LVC02APW,118; SOP65P640X110-14N; Mouser Part Number 771-74LVC02APW-T
IC4: 74LVC2G34GW,125; 74LVC2G34GW125; Manufacturer_Part_Number 74LVC2G34GW,125; Mouser Part Number 771-LVC2G34GW125
J1: Board 2x16 W15.24mm; DIP-32_Board_W15.24mm

Connections:
5V: C10.1, IC1.1 (6VIn), IC1.3 (EN), J1.1, J1.17
/3.3V: C1.1, C2.1, C3.1, C4.1, C5.1, C9.1, C11.1, IC1.5 (3.3VOut), IC2.16 (3V), IC3.14 (3V), IC4.5 (3V), IC5.14 (3V), IC6.14 (3V), IC16.14 (3V)
/~RD: IC4.6 (1Y), IC6.2 (1B), IC6.5 (2B), IC6.10 (3B), IC6.13 (4B), IC16.2 (1B), IC16.5 (2B), IC16.10 (3B), IC16.13 (4B)
/~WD: IC3.2 (1B), IC3.5 (2B), IC3.10 (3B), IC3.13 (4B), IC4.4 (2Y), IC5.2 (1B), IC5.5 (2B), IC5.10 (3B), IC5.13 (4B)
/~Y0: IC2.15 (~Y0), IC3.1 (1A), IC16.1 (1A)
/~Y1: IC2.14 (~Y1), IC3.4 (2A), IC16.4 (2A)
/~Y2: IC2.13 (~Y2), IC3.9 (3A), IC16.9 (3A)
/~Y3: IC2.12 (~Y3), IC3.12 (4A), IC16.12 (4A)
/~Y4: IC2.11 (~Y4), IC5.1 (1A), IC6.1 (1A)
/~Y5: IC2.10 (~Y5), IC5.4 (2A), IC6.4 (2A)
/~Y6: IC2.9 (~Y6), IC5.9 (3A), IC6.9 (3A)
/~Y7: IC2.7 (~Y7), IC5.12 (4A), IC6.12 (4A)
A0: IC2.1 (A0), J1.13
A1: IC2.2 (A1), J1.11
A2: IC2.3 (A2), J1.10
E3: IC2.6 (E3), J1.9
GND: C1.2, C2.2, C3.2, C4.2, C5.2, C9.2, C10.2, C11.2, IC1.2 (GND), IC2.8 (GND), IC3.7 (GND), IC4.2 (GND), IC5.7 (GND), IC6.7 (GND), IC16.7 (GND), J1.5, J1.12, J1.21, J1.28
Y0+R: IC16.3 (1Y), J1.32
Y0+W: IC3.3 (1Y), J1.27
Y1+R: IC16.6 (2Y), J1.31
Y1+W: IC3.6 (2Y), J1.26
Y2+R: IC16.8 (3Y), J1.30
Y2+W: IC3.8 (3Y), J1.25
Y3+R: IC16.11 (4Y), J1.29
Y3+W: IC3.11 (4Y), J1.24
Y4+R: IC6.3 (1Y), J1.7
Y4+W: IC5.3 (1Y), J1.23
Y5+R: IC6.6 (2Y), J1.6
Y5+W: IC5.6 (2Y), J1.22
Y6+R: IC6.8 (3Y), J1.3
Y6+W: IC5.8 (3Y), J1.20
Y7+R: IC6.11 (4Y), J1.2
Y7+W: IC5.11 (4Y), J1.19
~Device Registers: IC2.4 (~E1), J1.4
~E2: IC2.5 (~E2), J1.8
~RD_{IN}: IC4.1 (1A), J1.15
~WD_{IN}: IC4.3 (2A), J1.16

Notes on the sheet:
Stage B0
Stage B2
A3 A4
~{E2} E3
Stage B1
A3 ~{A4}
~{A3} A4
Stage B3
When ~{Device Registers} is low then the address lines A0 to A2 will be decoded into either positive Read lines (if ~{RD} is low) or positive Write lines (if ~{WD} is low). Up to four Device Decode Stage Bs can be connected to Stage A by connecting ~{E2} and E3 to address lines A3, ~{A3}, A4 and ~{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
~{A3} ~{A4}

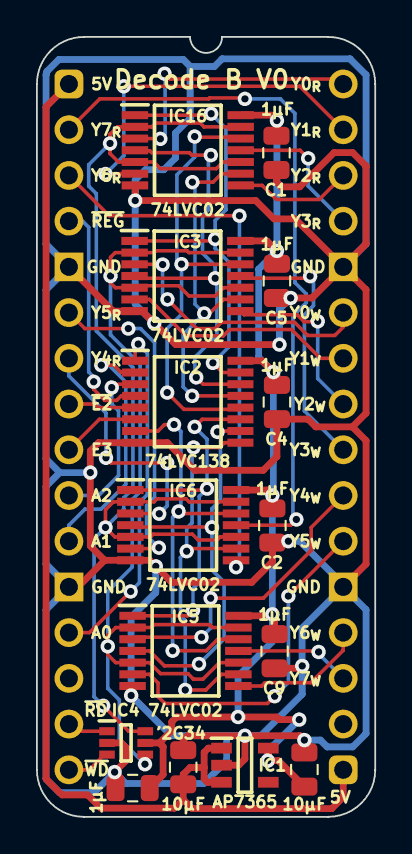
[picture p223: board Device Decode stage B.kicad_pcb from above]

Board: 2 copper layers, 18.8 x 43.3 mm, 16 parts (0 on the bottom side), 37 nets.
