andrewpaterson/HCP65/Kicad/Computer/Processor/HCP65 MPU Memory/HCP65 MPU Memory.kicad_pcb

## KiCad design Kicad/Computer/Processor/HCP65 MPU Memory/HCP65 MPU Memory.kicad_pcb (2026-11-01)

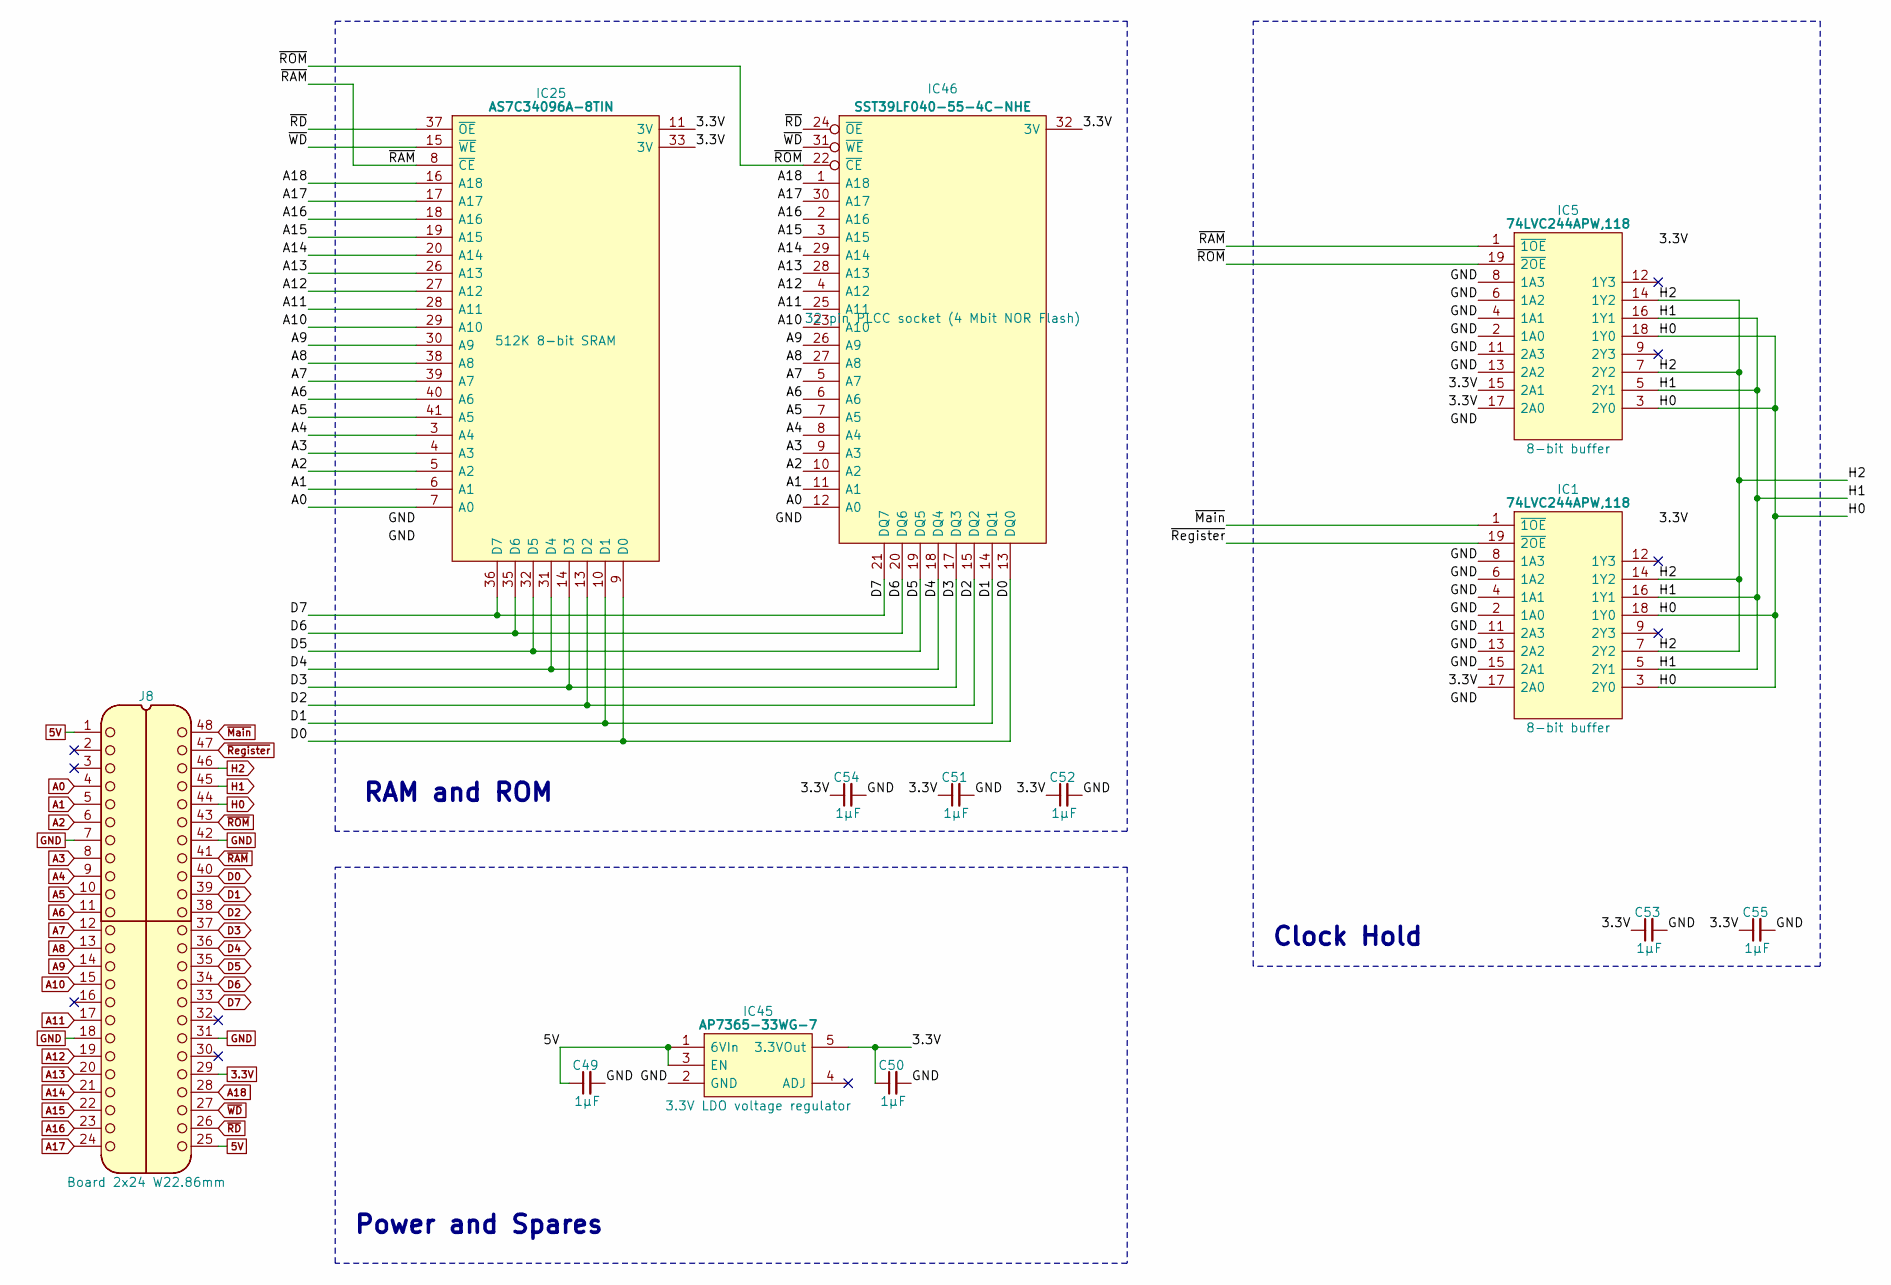
[picture p224: schematic HCP65 MPU Memory.kicad_sch, MPU Memory]

Parts:
C49, C50, C51, C52, C53, C54, C55: 1μF; C_0805
IC1, IC5: 74LVC244APW,118; SOP65P640X110-20N; Manufacturer_Part_Number 74LVC244APW,118; Mouser Part Number 771-74LVC244APW-T
IC25: AS7C34096A-8TIN; SOP80P1176X120-44N; Manufacturer_Part_Number AS7C34096A-8TIN; Mouser Part Number 913-AS7C34096A-8TIN
IC45: AP7365-33WG-7; SOT95P285X130-5N; Manufacturer_Part_Number AP7365-33WG-7; Mouser Part Number 621-AP7365-33WG-7
IC46: SST39LF040-55-4C-NHE; 5408803224008; Manufacturer_Part_Number SST39LF040-55-4C-NHE
J8: Board 2x24 W22.86mm; DIP-48_Board_W22.86mm

Connections:
3.3V: C50.1, C51.1, C52.1, C53.1, C54.1, C55.1, IC1.17 (2A0), IC1.20 (3V), IC5.15 (2A1), IC5.17 (2A0), IC5.20 (3V), IC25.11 (3V), IC25.33 (3V), IC45.5 (3.3VOut), IC46.32 (3V), J8.29
5V: C49.1, IC45.1 (6VIn), IC45.3 (EN), J8.1, J8.25
A0: IC25.7 (A0), IC46.12 (A0), J8.4
A1: IC25.6 (A1), IC46.11 (A1), J8.5
A2: IC25.5 (A2), IC46.10 (A2), J8.6
A3: IC25.4 (A3), IC46.9 (A3), J8.8
A4: IC25.3 (A4), IC46.8 (A4), J8.9
A5: IC25.41 (A5), IC46.7 (A5), J8.10
A6: IC25.40 (A6), IC46.6 (A6), J8.11
A7: IC25.39 (A7), IC46.5 (A7), J8.12
A8: IC25.38 (A8), IC46.27 (A8), J8.13
A9: IC25.30 (A9), IC46.26 (A9), J8.14
A10: IC25.29 (A10), IC46.23 (A10), J8.15
A11: IC25.28 (A11), IC46.25 (A11), J8.17
A12: IC25.27 (A12), IC46.4 (A12), J8.19
A13: IC25.26 (A13), IC46.28 (A13), J8.20
A14: IC25.20 (A14), IC46.29 (A14), J8.21
A15: IC25.19 (A15), IC46.3 (A15), J8.22
A16: IC25.18 (A16), IC46.2 (A16), J8.23
A17: IC25.17 (A17), IC46.30 (A17), J8.24
A18: IC25.16 (A18), IC46.1 (A18), J8.28
D0: IC25.9 (D0), IC46.13 (DQ0), J8.40
D1: IC25.10 (D1), IC46.14 (DQ1), J8.39
D2: IC25.13 (D2), IC46.15 (DQ2), J8.38
D3: IC25.14 (D3), IC46.17 (DQ3), J8.37
D4: IC25.31 (D4), IC46.18 (DQ4), J8.36
D5: IC25.32 (D5), IC46.19 (DQ5), J8.35
D6: IC25.35 (D6), IC46.20 (DQ6), J8.34
D7: IC25.36 (D7), IC46.21 (DQ7), J8.33
GND: C49.2, C50.2, C51.2, C52.2, C53.2, C54.2, C55.2, IC1.2 (1A0), IC1.4 (1A1), IC1.6 (1A2), IC1.8 (1A3), IC1.10 (GND), IC1.11 (2A3), IC1.13 (2A2), IC1.15 (2A1), IC5.2 (1A0), IC5.4 (1A1), IC5.6 (1A2), IC5.8 (1A3), IC5.10 (GND), IC5.11 (2A3), IC5.13 (2A2), IC25.12 (GND), IC25.34 (GND), IC45.2 (GND), IC46.16 (GND), J8.7, J8.18, J8.31, J8.42
H0: IC1.3 (2Y0), IC1.18 (1Y0), IC5.3 (2Y0), IC5.18 (1Y0), J8.44
H1: IC1.5 (2Y1), IC1.16 (1Y1), IC5.5 (2Y1), IC5.16 (1Y1), J8.45
H2: IC1.7 (2Y2), IC1.14 (1Y2), IC5.7 (2Y2), IC5.14 (1Y2), J8.46
~Main: IC1.1 (~1OE), J8.48
~RAM: IC5.1 (~1OE), IC25.8 (~CE), J8.41
~RD: IC25.37 (~OE), IC46.24 (~OE), J8.26
~ROM: IC5.19 (~2OE), IC46.22 (~CE), J8.43
~Register: IC1.19 (~2OE), J8.47
~WD: IC25.15 (~WE), IC46.31 (~WE), J8.27

Notes on the sheet:
Power and Spares
Clock Hold
RAM and ROM

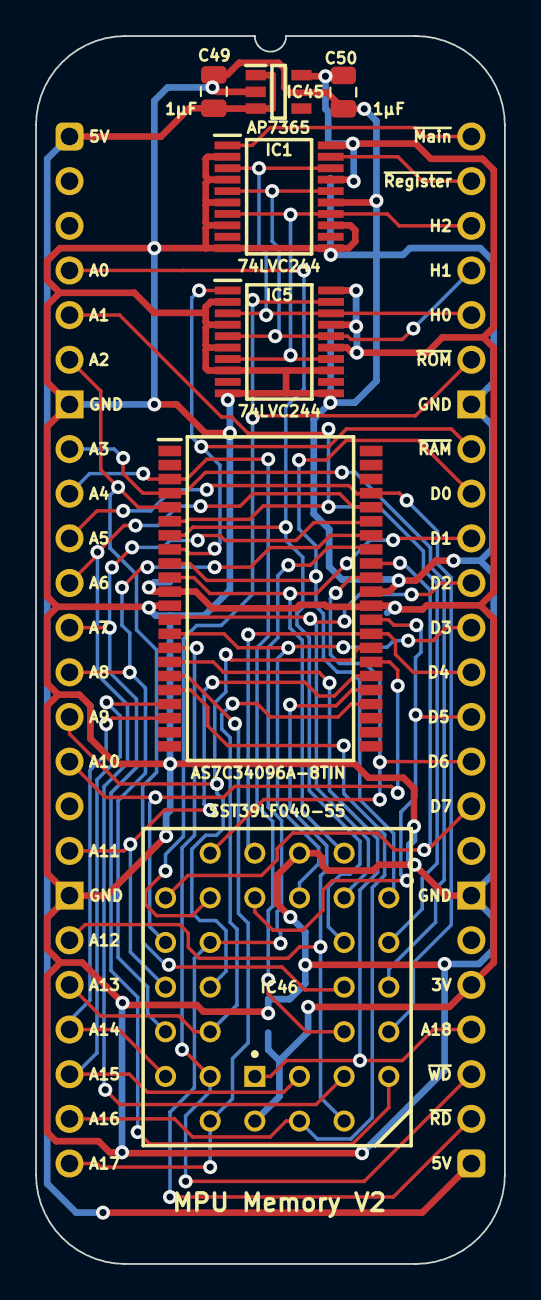
[picture p225: board HCP65 MPU Memory.kicad_pcb from above]

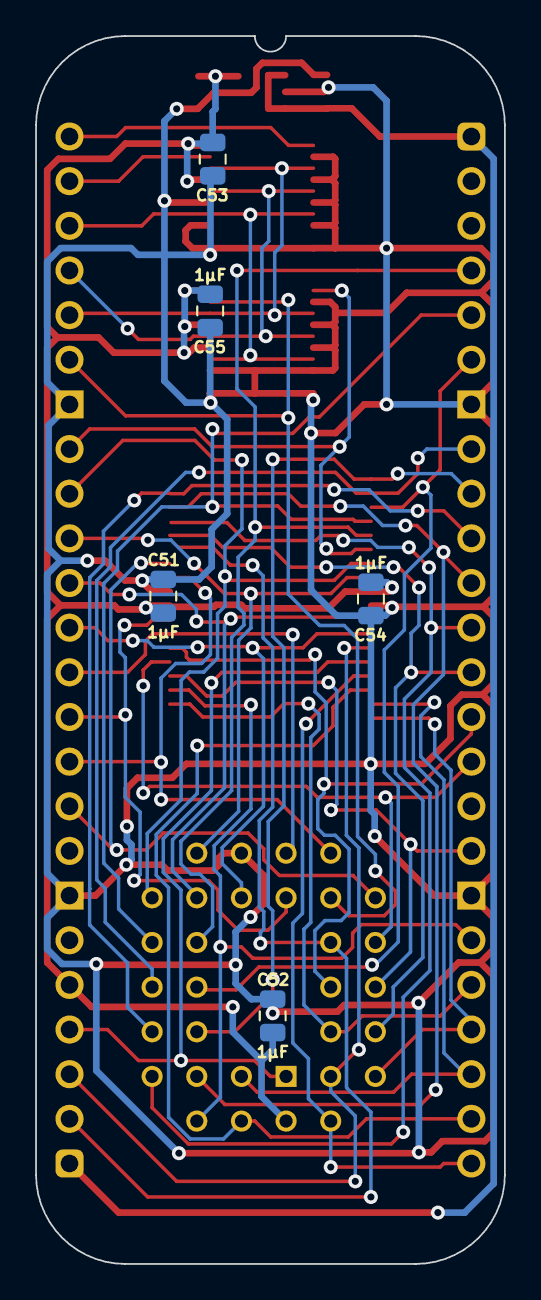
[picture p226: board HCP65 MPU Memory.kicad_pcb from below]

Board: 2 copper layers, 26.7 x 69.9 mm, 13 parts (5 on the bottom side), 39 nets.
