andrewpaterson/HCP65/Kicad/Computer/Video/Video Counter 12bit/Video Counter 12bit.kicad_pcb

## KiCad design Kicad/Computer/Video/Video Counter 12bit/Video Counter 12bit.kicad_pcb (2026-11-01)

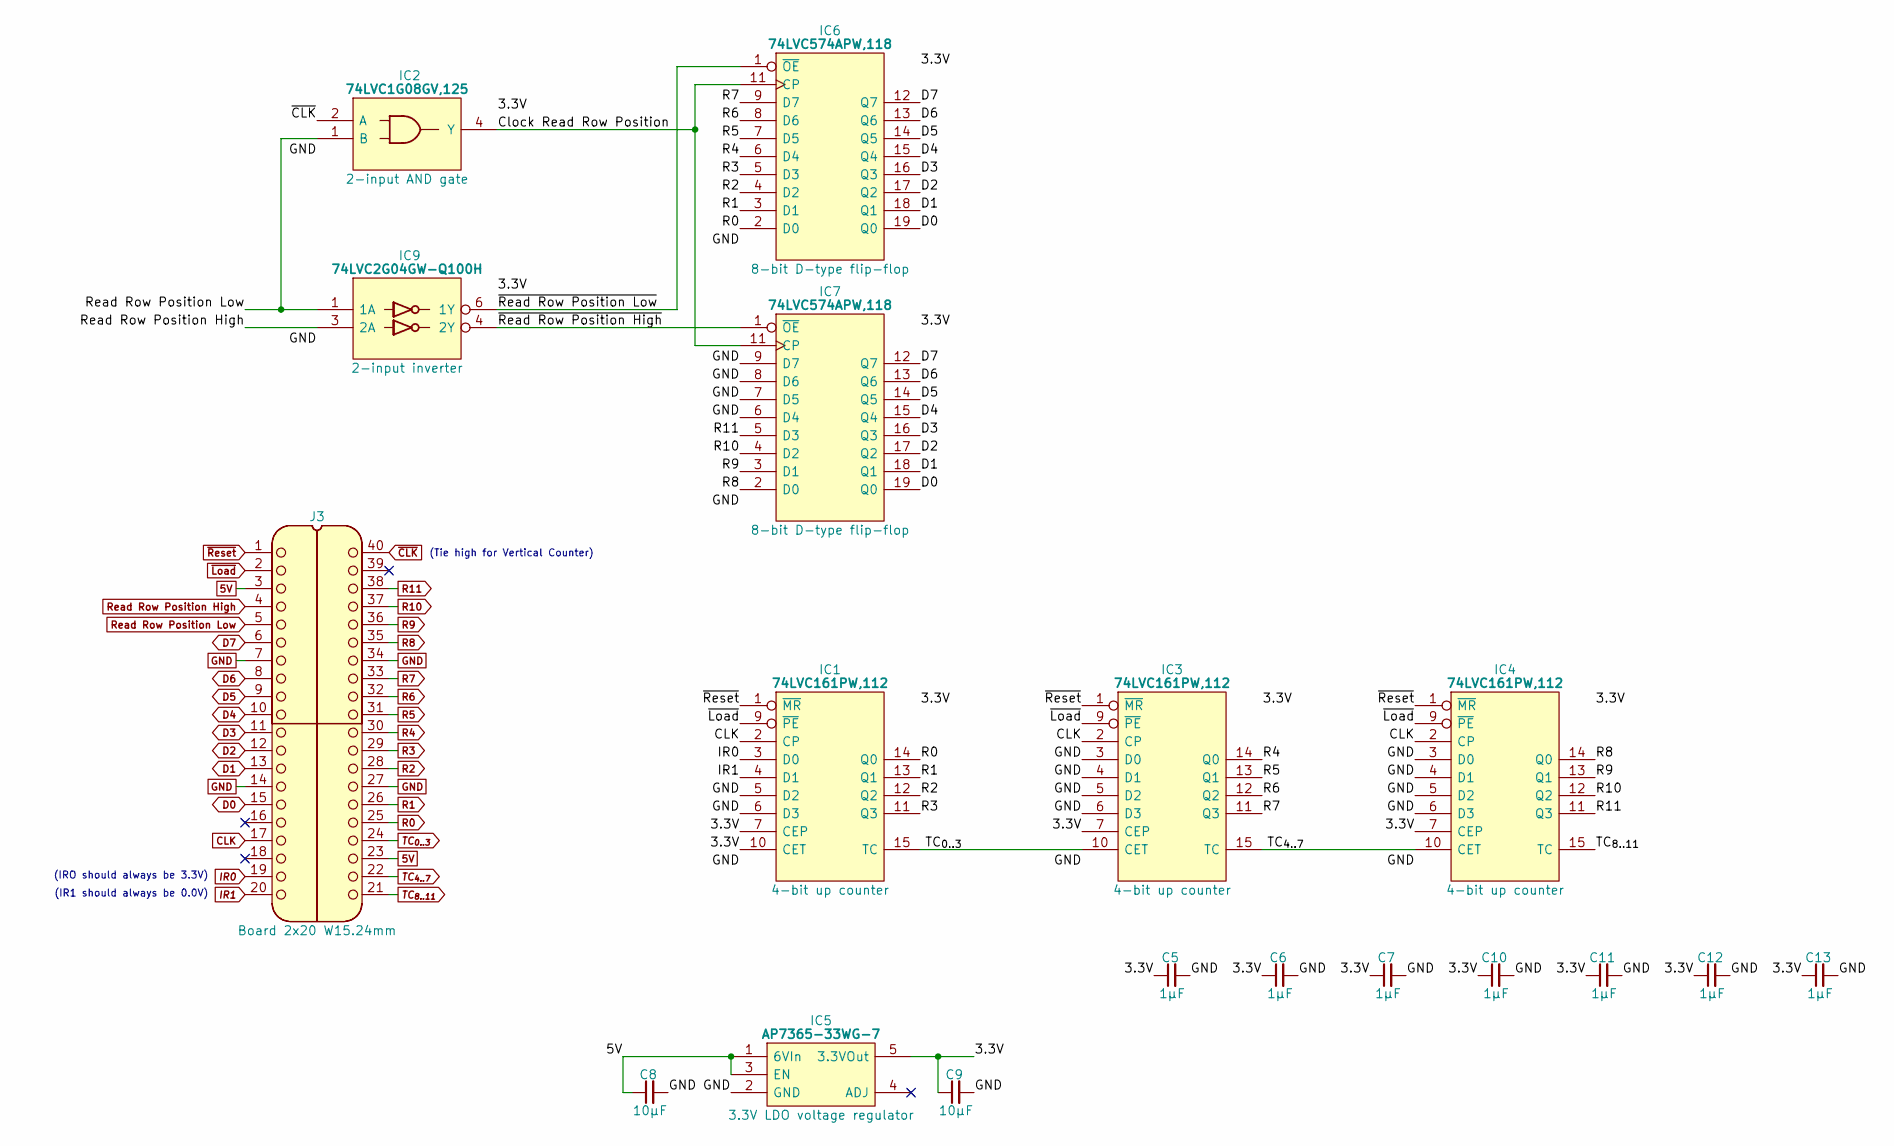
[picture p227: schematic Video Counter 12bit.kicad_sch, 12bit Video Counter]

Parts:
C5, C6, C7, C10, C11, C12, C13: 1μF; C_0805
C8, C9: 10µF; C_0805
IC1, IC3, IC4: 74LVC161PW,112; SOP65P640X110-16N; Mouser Part Number 771-LVC161PW112
IC2: 74LVC1G08GV,125; SOT95P275X110-5N; Manufacturer_Part_Number 74LVC1G08GV,125; Mouser Part Number 771-74LVC1G08GV
IC5: AP7365-33WG-7; SOT95P285X130-5N; Manufacturer_Part_Number AP7365-33WG-7; Mouser Part Number 621-AP7365-33WG-7
IC6, IC7: 74LVC574APW,118; SOP65P640X110-20N; Manufacturer_Part_Number 74LVC574APW,118; Mouser Part Number 771-74LVC574APW-T
IC9: 74LVC2G04GW-Q100H; SOP65P210X110-6N; Manufacturer_Part_Number 74LVC2G04GW-Q100H; Mouser Part Number 771-74LVC2G04GWQ100H
J3: Board 2x20 W15.24mm; DIP-40_Board_W15.24mm

Connections:
5V: C8.1, IC5.1 (6VIn), IC5.3 (EN), J3.3, J3.23
/3.3V: C5.1, C6.1, C7.1, C9.1, C10.1, C11.1, C12.1, C13.1, IC1.7 (CEP), IC1.10 (CET), IC1.16 (3V), IC2.5 (3V), IC3.7 (CEP), IC3.16 (3V), IC4.7 (CEP), IC4.16 (3V), IC5.5 (3.3VOut), IC6.20 (3V), IC7.20 (3V), IC9.5 (3V)
/Clock Read Row Position: IC2.4 (Y), IC6.11 (CP), IC7.11 (CP)
/~Read Row Position High: IC7.1 (~OE), IC9.4 (2Y)
/~Read Row Position Low: IC6.1 (~OE), IC9.6 (1Y)
CLK: IC1.2 (CP), IC3.2 (CP), IC4.2 (CP), J3.17
D0: IC6.19 (Q0), IC7.19 (Q0), J3.15
D1: IC6.18 (Q1), IC7.18 (Q1), J3.13
D2: IC6.17 (Q2), IC7.17 (Q2), J3.12
D3: IC6.16 (Q3), IC7.16 (Q3), J3.11
D4: IC6.15 (Q4), IC7.15 (Q4), J3.10
D5: IC6.14 (Q5), IC7.14 (Q5), J3.9
D6: IC6.13 (Q6), IC7.13 (Q6), J3.8
D7: IC6.12 (Q7), IC7.12 (Q7), J3.6
GND: C5.2, C6.2, C7.2, C8.2, C9.2, C10.2, C11.2, C12.2, C13.2, IC1.5 (D2), IC1.6 (D3), IC1.8 (GND), IC2.3 (GND), IC3.3 (D0), IC3.4 (D1), IC3.5 (D2), IC3.6 (D3), IC3.8 (GND), IC4.3 (D0), IC4.4 (D1), IC4.5 (D2), IC4.6 (D3), IC4.8 (GND), IC5.2 (GND), IC6.10 (GND), IC7.6 (D4), IC7.7 (D5), IC7.8 (D6), IC7.9 (D7), IC7.10 (GND), IC9.2 (GND), J3.7, J3.14, J3.27, J3.34
IR0: IC1.3 (D0), J3.19
IR1: IC1.4 (D1), J3.20
R0: IC1.14 (Q0), IC6.2 (D0), J3.25
R1: IC1.13 (Q1), IC6.3 (D1), J3.26
R2: IC1.12 (Q2), IC6.4 (D2), J3.28
R3: IC1.11 (Q3), IC6.5 (D3), J3.29
R4: IC3.14 (Q0), IC6.6 (D4), J3.30
R5: IC3.13 (Q1), IC6.7 (D5), J3.31
R6: IC3.12 (Q2), IC6.8 (D6), J3.32
R7: IC3.11 (Q3), IC6.9 (D7), J3.33
R8: IC4.14 (Q0), IC7.2 (D0), J3.35
R9: IC4.13 (Q1), IC7.3 (D1), J3.36
R10: IC4.12 (Q2), IC7.4 (D2), J3.37
R11: IC4.11 (Q3), IC7.5 (D3), J3.38
Read Row Position High: IC9.3 (2A), J3.4
Read Row Position Low: IC2.1 (B), IC9.1 (1A), J3.5
TC_{0..3}: IC1.15 (TC), IC3.10 (CET), J3.24
TC_{4..7}: IC3.15 (TC), IC4.10 (CET), J3.22
TC_{8..11}: IC4.15 (TC), J3.21
~CLK: IC2.2 (A), J3.40
~Load: IC1.9 (~PE), IC3.9 (~PE), IC4.9 (~PE), J3.2
~Reset: IC1.1 (~MR), IC3.1 (~MR), IC4.1 (~MR), J3.1

Notes on the sheet:
(Tie high for Vertical Counter)
(IRO should always be 3.3V)
(IR1 should always be 0.0V)

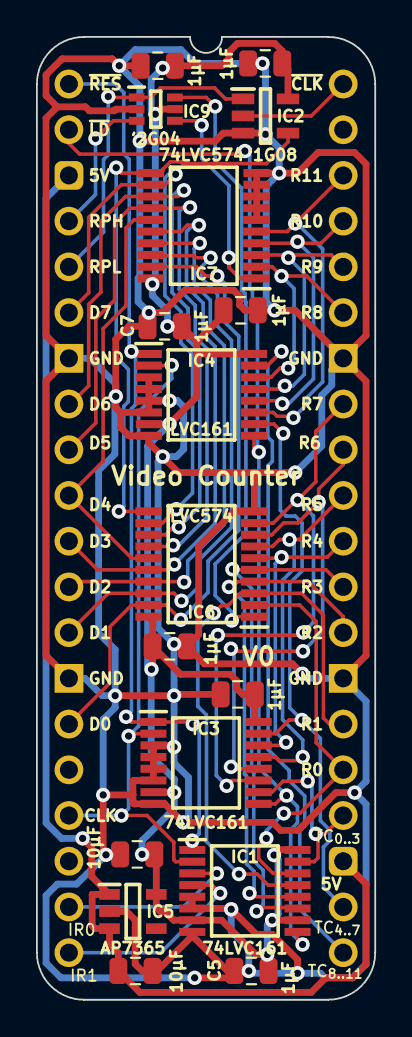
[picture p228: board Video Counter 12bit.kicad_pcb from above]

Board: 2 copper layers, 18.8 x 53.5 mm, 18 parts (0 on the bottom side), 37 nets.
