andrewpaterson/HCP65/Kicad/Computer/PS2/PS2 FIFO/PS2 FIFO.kicad_pcb

## KiCad design Kicad/Computer/PS2/PS2 FIFO/PS2 FIFO.kicad_pcb (2026-11-01)

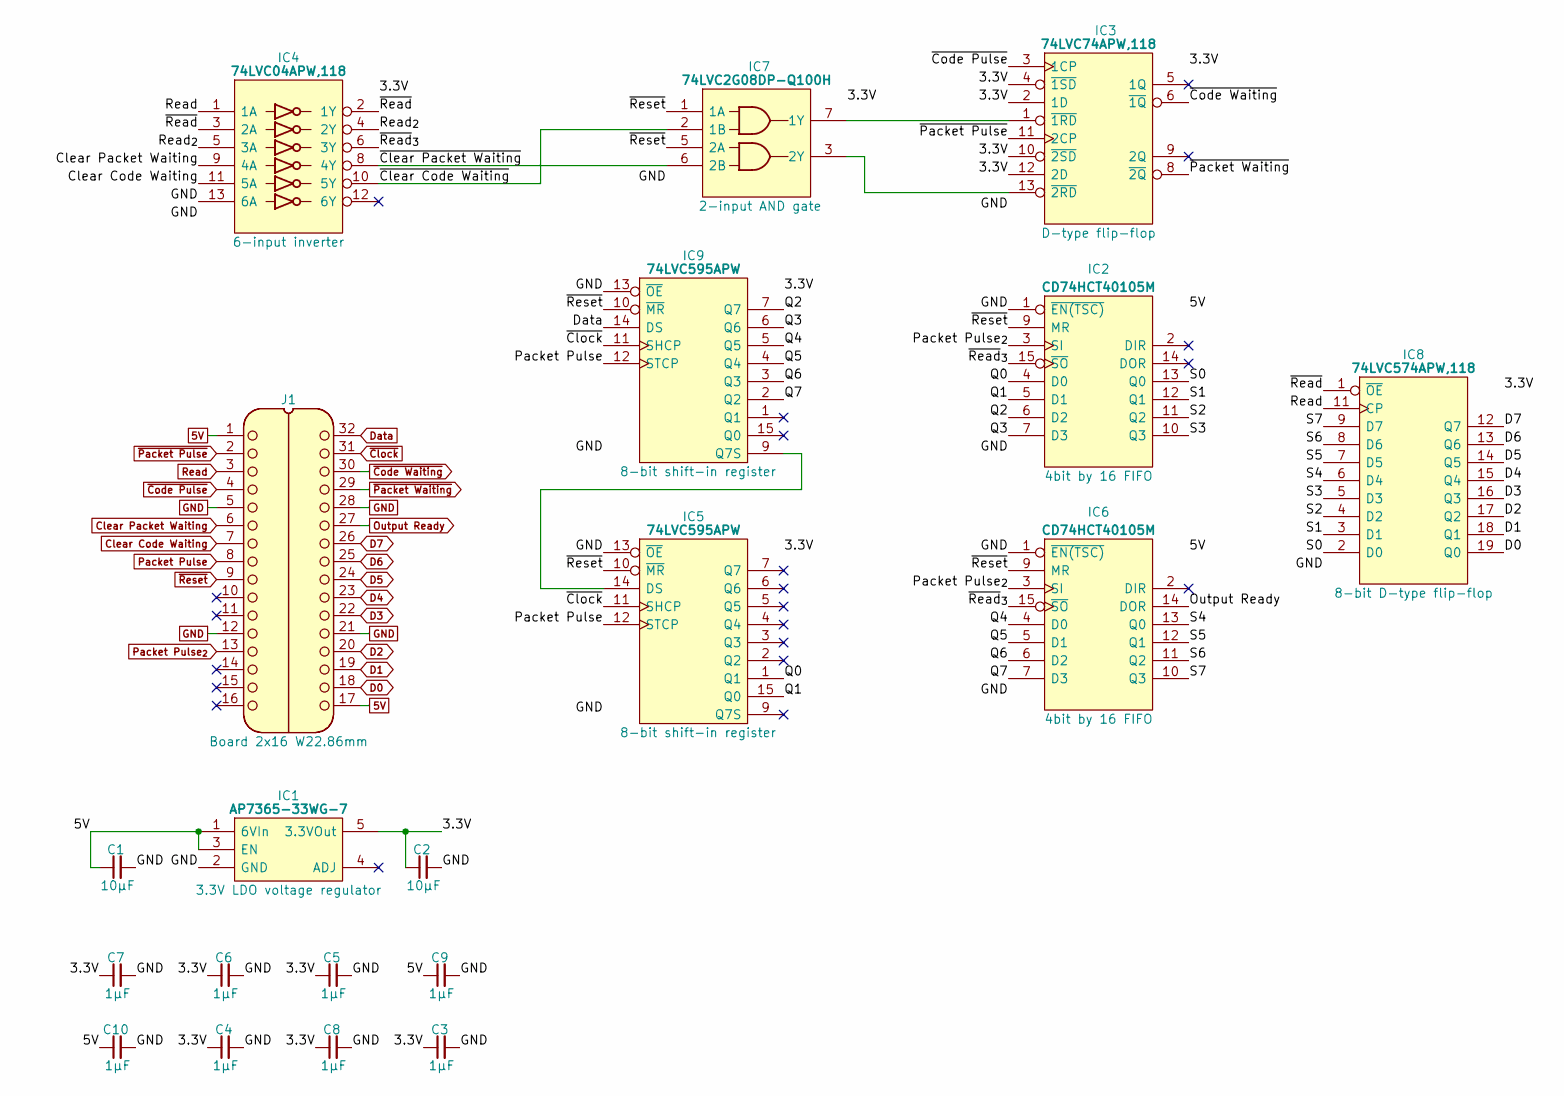
[picture p231: schematic PS2 FIFO.kicad_sch]

Parts:
C1, C2: 10μF; C_0805
C3, C4, C5, C6, C7, C8, C9, C10: 1μF; C_0805
IC1: AP7365-33WG-7; SOT95P285X130-5N; Manufacturer_Part_Number AP7365-33WG-7; Mouser Part Number 621-AP7365-33WG-7
IC2, IC6: CD74HCT40105M; SOIC127P600X175-16N; Manufacturer_Part_Number CD74HCT40105M
IC3: 74LVC74APW,118; SOP65P640X110-14N; Mouser Part Number 771-74LVC74APW-T
IC4: 74LVC04APW,118; SOP65P640X110-14N; Manufacturer_Part_Number 74LVC04APW,118; Mouser Part Number 771-74LVC04APW-T
IC5, IC9: 74LVC595APW; SOP65P640X110-16N; Mouser Part Number 771-74LVC595AD
IC7: 74LVC2G08DP-Q100H; SOP65P400X110-8N; Manufacturer_Part_Number 74LVC2G08DP-Q100H; Mouser Part Number 771-74LVC2G08DPQ100H
IC8: 74LVC574APW,118; SOP65P640X110-20N; Manufacturer_Part_Number 74LVC574APW,118; Mouser Part Number 771-74LVC574APW-T
J1: Board 2x16 W22.86mm; DIP-32_Board_W22.86mm

Connections:
5V: C1.1, C9.1, C10.1, IC1.1 (6VIn), IC1.3 (EN), IC2.16 (5V), IC6.16 (5V), J1.1, J1.17
/3.3V: C2.1, C3.1, C4.1, C5.1, C6.1, C7.1, C8.1, IC1.5 (3.3VOut), IC3.2 (1D), IC3.4 (~1SD), IC3.10 (~2SD), IC3.12 (2D), IC3.14 (3V), IC4.14 (3V), IC5.16 (3V), IC7.8 (3V), IC8.20 (3V), IC9.16 (3V)
/Q0: IC2.4 (D0), IC5.1 (Q1)
/Q1: IC2.5 (D1), IC5.15 (Q0)
/Q2: IC2.6 (D2), IC9.7 (Q7)
/Q3: IC2.7 (D3), IC9.6 (Q6)
/Q4: IC6.4 (D0), IC9.5 (Q5)
/Q5: IC6.5 (D1), IC9.4 (Q4)
/Q6: IC6.6 (D2), IC9.3 (Q3)
/Q7: IC6.7 (D3), IC9.2 (Q2)
/Read_{2}: IC4.4 (2Y), IC4.5 (3A)
/S0: IC2.13 (Q0), IC8.2 (D0)
/S1: IC2.12 (Q1), IC8.3 (D1)
/S2: IC2.11 (Q2), IC8.4 (D2)
/S3: IC2.10 (Q3), IC8.5 (D3)
/S4: IC6.13 (Q0), IC8.6 (D4)
/S5: IC6.12 (Q1), IC8.7 (D5)
/S6: IC6.11 (Q2), IC8.8 (D6)
/S7: IC6.10 (Q3), IC8.9 (D7)
/~Clear Code Waiting: IC4.10 (5Y), IC7.2 (1B)
/~Clear Packet Waiting: IC4.8 (4Y), IC7.6 (2B)
/~Read: IC4.2 (1Y), IC4.3 (2A), IC8.1 (~OE)
/~Read_{3}: IC2.15 (~SO), IC4.6 (3Y), IC6.15 (~SO)
Clear Code Waiting: IC4.11 (5A), J1.7
Clear Packet Waiting: IC4.9 (4A), J1.6
D0: IC8.19 (Q0), J1.18
D1: IC8.18 (Q1), J1.19
D2: IC8.17 (Q2), J1.20
D3: IC8.16 (Q3), J1.22
D4: IC8.15 (Q4), J1.23
D5: IC8.14 (Q5), J1.24
D6: IC8.13 (Q6), J1.25
D7: IC8.12 (Q7), J1.26
Data: IC9.14 (DS), J1.32
GND: C1.2, C2.2, C3.2, C4.2, C5.2, C6.2, C7.2, C8.2, C9.2, C10.2, IC1.2 (GND), IC2.1 (~EN(TSC)), IC2.8 (GND), IC3.7 (GND), IC4.7 (GND), IC4.13 (6A), IC5.8 (GND), IC5.13 (~OE), IC6.1 (~EN(TSC)), IC6.8 (GND), IC7.4 (GND), IC8.10 (GND), IC9.8 (GND), IC9.13 (~OE), J1.5, J1.12, J1.21, J1.28
unnamed: IC3.1 (~1RD), IC7.7 (1Y)
unnamed: IC3.13 (~2RD), IC7.3 (2Y)
unnamed: IC5.14 (DS), IC9.9 (Q7S)
Output Ready: IC6.14 (DOR), J1.27
Packet Pulse: IC5.12 (STCP), IC9.12 (STCP), J1.8
Packet Pulse_{2}: IC2.3 (SI), IC6.3 (SI), J1.13
Read: IC4.1 (1A), IC8.11 (CP), J1.3
~Clock: IC5.11 (SHCP), IC9.11 (SHCP), J1.31
~Code Pulse: IC3.3 (1CP), J1.4
~Code Waiting: IC3.6 (~1Q), J1.30
~Packet Pulse: IC3.11 (2CP), J1.2
~Packet Waiting: IC3.8 (~2Q), J1.29
~Reset: IC2.9 (MR), IC5.10 (~MR), IC6.9 (MR), IC7.1 (1A), IC7.5 (2A), IC9.10 (~MR), J1.9

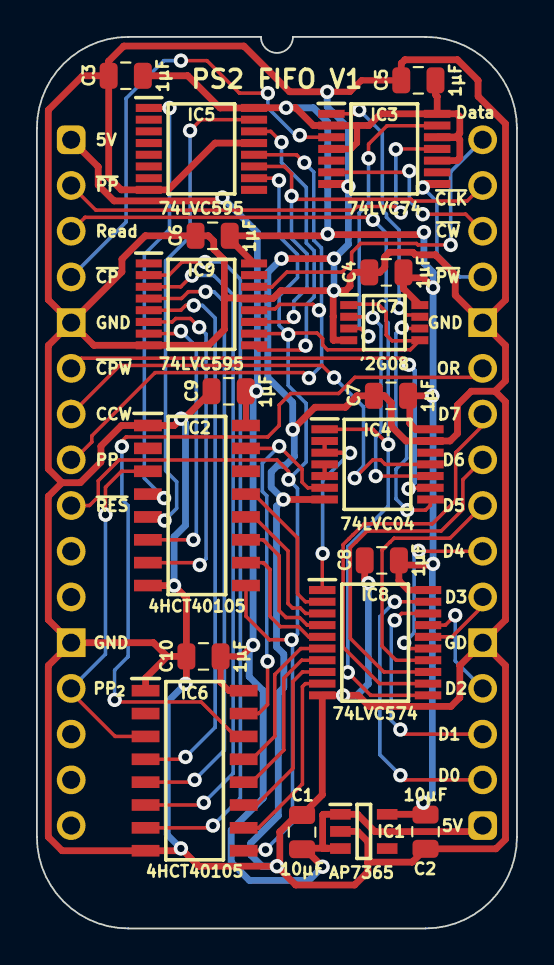
[picture p232: board PS2 FIFO.kicad_pcb from above]

Board: 2 copper layers, 26.7 x 49.5 mm, 20 parts (0 on the bottom side), 48 nets.
