andrewpaterson/HCP65/Kicad/Computer/Graphics/Graphics Transparency/Graphics Transparency.kicad_pcb

## KiCad design Kicad/Computer/Graphics/Graphics Transparency/Graphics Transparency.kicad_pcb (2026-11-01)

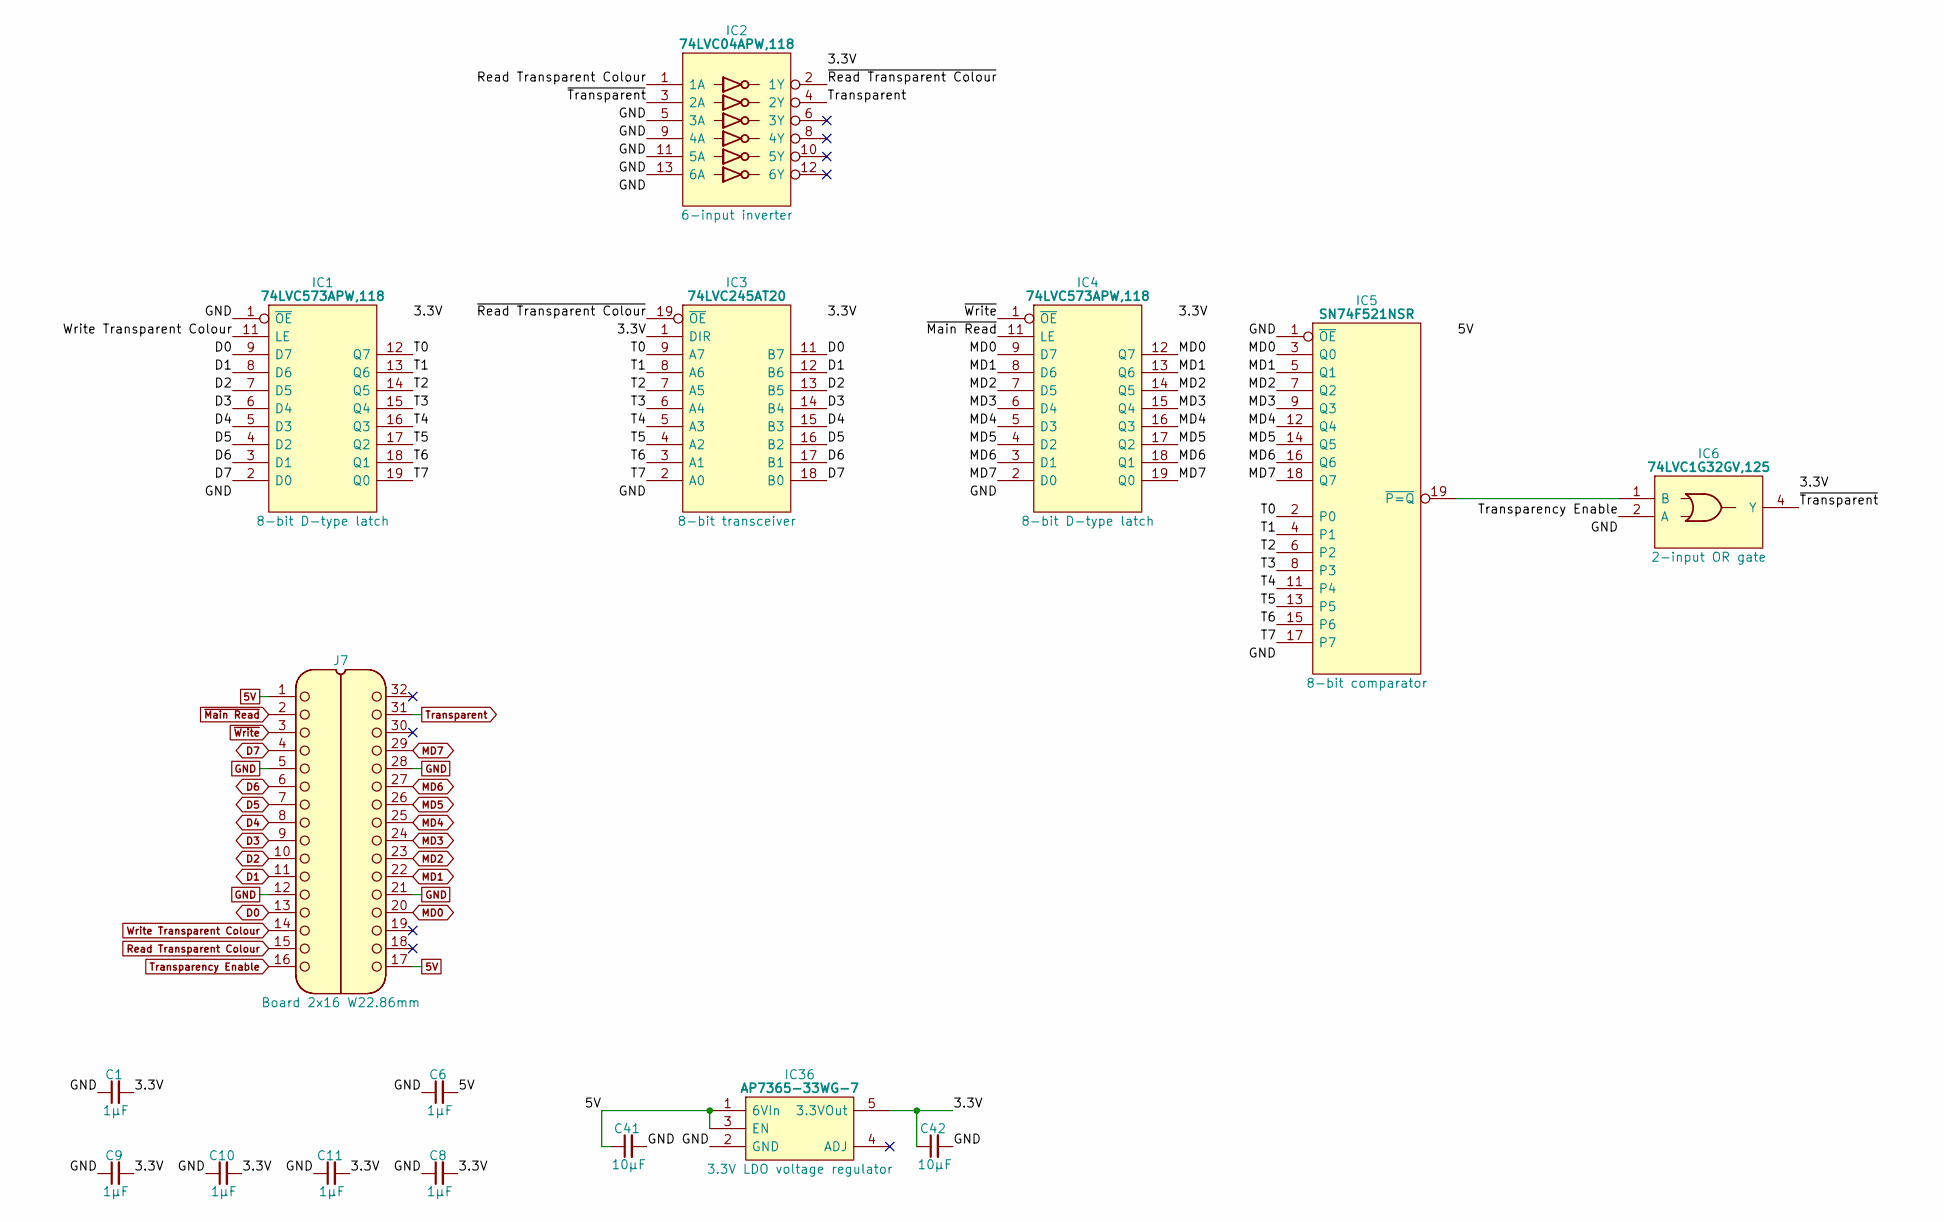
[picture p233: schematic Graphics Transparency.kicad_sch]

Parts:
C1, C6, C8, C9, C10, C11: 1μF; C_0805
C41, C42: 10μF; C_0805
IC1, IC4: 74LVC573APW,118; SOP65P640X110-20N; Mouser Part Number 771-74LVC573APW-T
IC2: 74LVC04APW,118; SOP65P640X110-14N; Manufacturer_Part_Number 74LVC04APW,118; Mouser Part Number 771-74LVC04APW-T
IC3: 74LVC245AT20; SOP65P640X120-20N; Manufacturer_Part_Number 74LVC245AT20-13; Mouser Part Number 621-74LVC245AT20-13
IC5: SN74F521NSR; SOIC127P780X200-20N; Mouser Part Number 595-SN74F521NSR
IC6: 74LVC1G32GV,125; SOT95P275X110-5N; Manufacturer_Part_Number 74LVC1G32GV,125; Mouser Part Number 771-LVC1G32GV125
IC36: AP7365-33WG-7; SOT95P285X130-5N; Manufacturer_Part_Number AP7365-33WG-7; Mouser Part Number 621-AP7365-33WG-7
J7: Board 2x16 W22.86mm; DIP-32_Board_W22.86mm

Connections:
5V: C6.2, C41.1, IC5.20 (5V), IC36.1 (6VIn), IC36.3 (EN), J7.1, J7.17
/3.3V: C1.2, C8.2, C9.2, C10.2, C11.2, C42.1, IC1.20 (3V), IC2.14 (3V), IC3.1 (DIR), IC3.20 (3V), IC4.20 (3V), IC6.5 (3V), IC36.5 (3.3VOut)
/T0: IC1.12 (Q7), IC3.9 (A7), IC5.2 (P0)
/T1: IC1.13 (Q6), IC3.8 (A6), IC5.4 (P1)
/T2: IC1.14 (Q5), IC3.7 (A5), IC5.6 (P2)
/T3: IC1.15 (Q4), IC3.6 (A4), IC5.8 (P3)
/T4: IC1.16 (Q3), IC3.5 (A3), IC5.11 (P4)
/T5: IC1.17 (Q2), IC3.4 (A2), IC5.13 (P5)
/T6: IC1.18 (Q1), IC3.3 (A1), IC5.15 (P6)
/T7: IC1.19 (Q0), IC3.2 (A0), IC5.17 (P7)
/~Read Transparent Colour: IC2.2 (1Y), IC3.19 (~OE)
/~Transparent: IC2.3 (2A), IC6.4 (Y)
D0: IC1.9 (D7), IC3.11 (B7), J7.13
D1: IC1.8 (D6), IC3.12 (B6), J7.11
D2: IC1.7 (D5), IC3.13 (B5), J7.10
D3: IC1.6 (D4), IC3.14 (B4), J7.9
D4: IC1.5 (D3), IC3.15 (B3), J7.8
D5: IC1.4 (D2), IC3.16 (B2), J7.7
D6: IC1.3 (D1), IC3.17 (B1), J7.6
D7: IC1.2 (D0), IC3.18 (B0), J7.4
GND: C1.1, C6.1, C8.1, C9.1, C10.1, C11.1, C41.2, C42.2, IC1.1 (~OE), IC1.10 (GND), IC2.5 (3A), IC2.7 (GND), IC2.9 (4A), IC2.11 (5A), IC2.13 (6A), IC3.10 (GND), IC4.10 (GND), IC5.1 (~OE), IC5.10 (GND), IC6.3 (GND), IC36.2 (GND), J7.5, J7.12, J7.21, J7.28
MD0: IC4.9 (D7), IC4.12 (Q7), IC5.3 (Q0), J7.20
MD1: IC4.8 (D6), IC4.13 (Q6), IC5.5 (Q1), J7.22
MD2: IC4.7 (D5), IC4.14 (Q5), IC5.7 (Q2), J7.23
MD3: IC4.6 (D4), IC4.15 (Q4), IC5.9 (Q3), J7.24
MD4: IC4.5 (D3), IC4.16 (Q3), IC5.12 (Q4), J7.25
MD5: IC4.4 (D2), IC4.17 (Q2), IC5.14 (Q5), J7.26
MD6: IC4.3 (D1), IC4.18 (Q1), IC5.16 (Q6), J7.27
MD7: IC4.2 (D0), IC4.19 (Q0), IC5.18 (Q7), J7.29
unnamed: IC5.19 (~P=Q), IC6.1 (B)
Read Transparent Colour: IC2.1 (1A), J7.15
Transparency Enable: IC6.2 (A), J7.16
Transparent: IC2.4 (2Y), J7.31
Write Transparent Colour: IC1.11 (LE), J7.14
~Main Read: IC4.11 (LE), J7.2
~Write: IC4.1 (~OE), J7.3

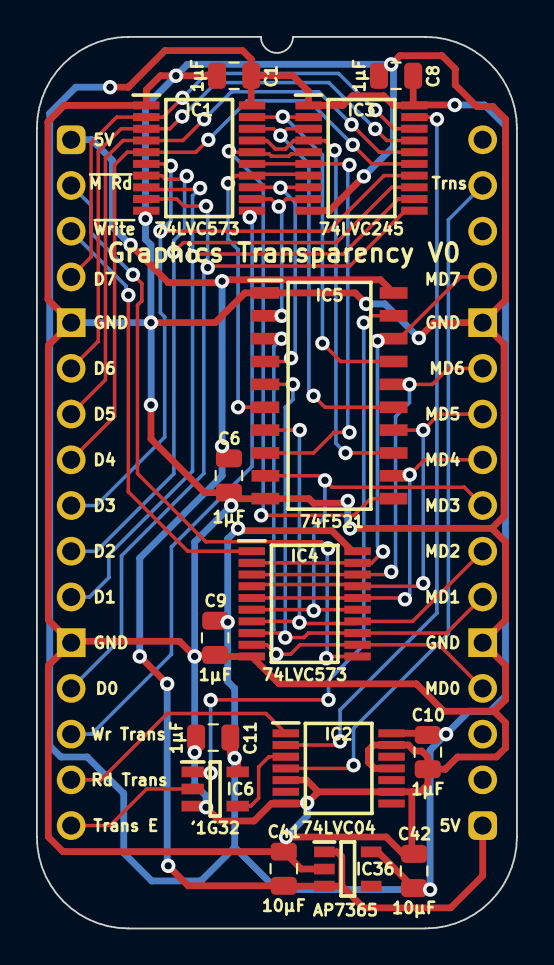
[picture p234: board Graphics Transparency.kicad_pcb from above]

Board: 2 copper layers, 26.7 x 49.5 mm, 16 parts (0 on the bottom side), 36 nets.
