andrewpaterson/HCP65/Kicad/Computer/Component Boards/Added 8bit/Added 8bit.kicad_pcb

## KiCad design Kicad/Computer/Component Boards/Added 8bit/Added 8bit.kicad_pcb (2026-11-01)

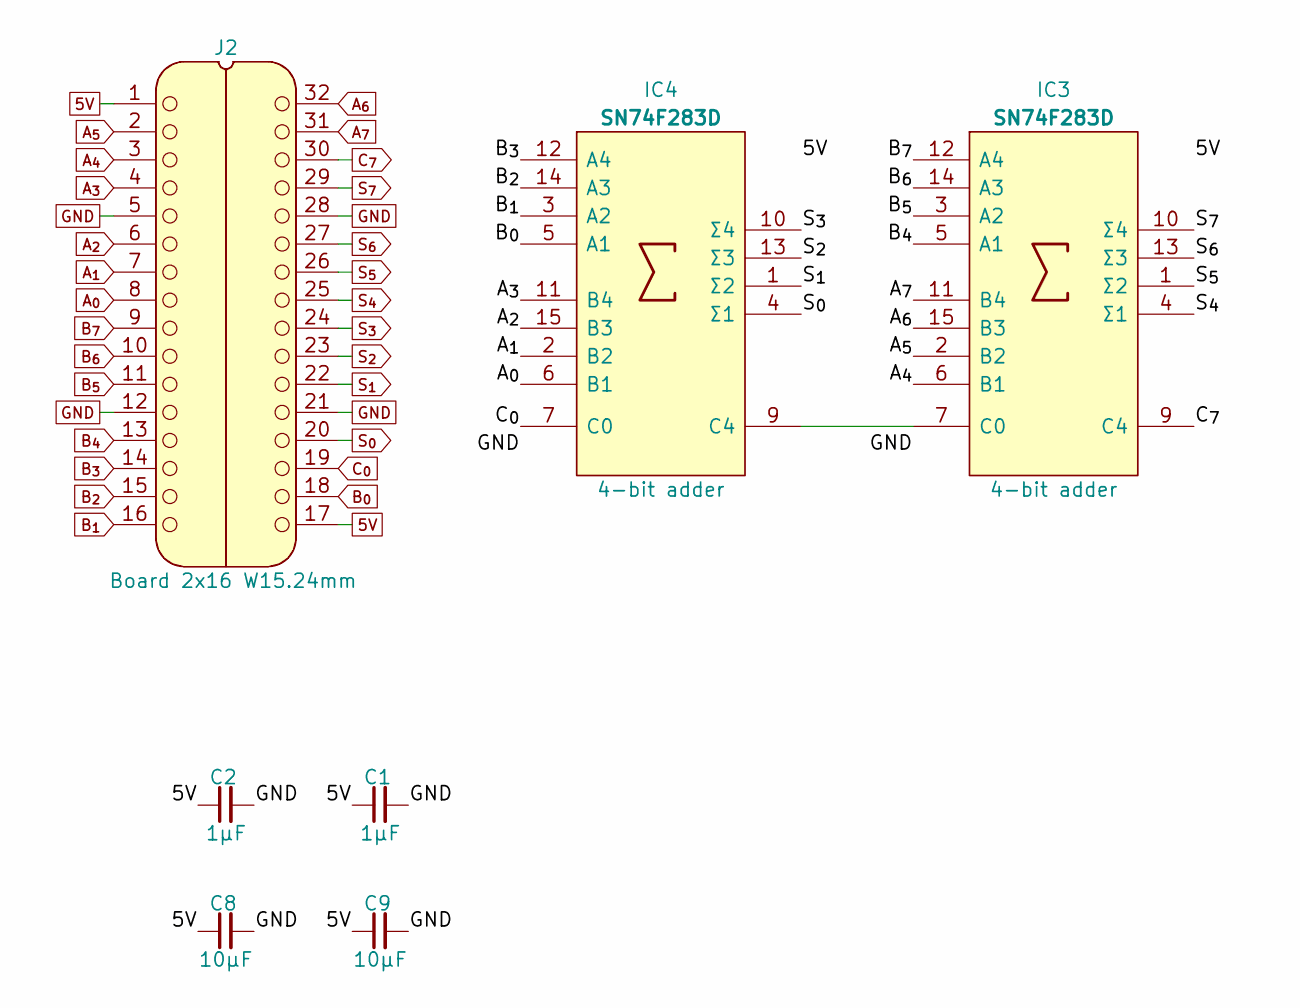
[picture p235: schematic Added 8bit.kicad_sch, 8bit Adder]

Parts:
C1, C2: 1μF; C_0805
C8, C9: 10µF; C_0805
IC3, IC4: SN74F283D; SOIC127P600X175-16N; Mouser Part Number 595-SN74F283D
J2: Board 2x16 W15.24mm; DIP-32_Board_W15.24mm

Connections:
5V: C1.1, C2.1, C8.1, C9.1, IC3.16 (5V), IC4.16 (5V), J2.1, J2.17
A_{0}: IC4.6 (B1), J2.8
A_{1}: IC4.2 (B2), J2.7
A_{2}: IC4.15 (B3), J2.6
A_{3}: IC4.11 (B4), J2.4
A_{4}: IC3.6 (B1), J2.3
A_{5}: IC3.2 (B2), J2.2
A_{6}: IC3.15 (B3), J2.32
A_{7}: IC3.11 (B4), J2.31
B_{0}: IC4.5 (A1), J2.18
B_{1}: IC4.3 (A2), J2.16
B_{2}: IC4.14 (A3), J2.15
B_{3}: IC4.12 (A4), J2.14
B_{4}: IC3.5 (A1), J2.13
B_{5}: IC3.3 (A2), J2.11
B_{6}: IC3.14 (A3), J2.10
B_{7}: IC3.12 (A4), J2.9
C_{0}: IC4.7 (C0), J2.19
C_{7}: IC3.9 (C4), J2.30
GND: C1.2, C2.2, C8.2, C9.2, IC3.8 (GND), IC4.8 (GND), J2.5, J2.12, J2.21, J2.28
unnamed: IC3.7 (C0), IC4.9 (C4)
S_{0}: IC4.4 (Σ1), J2.20
S_{1}: IC4.1 (Σ2), J2.22
S_{2}: IC4.13 (Σ3), J2.23
S_{3}: IC4.10 (Σ4), J2.24
S_{4}: IC3.4 (Σ1), J2.25
S_{5}: IC3.1 (Σ2), J2.26
S_{6}: IC3.13 (Σ3), J2.27
S_{7}: IC3.10 (Σ4), J2.29

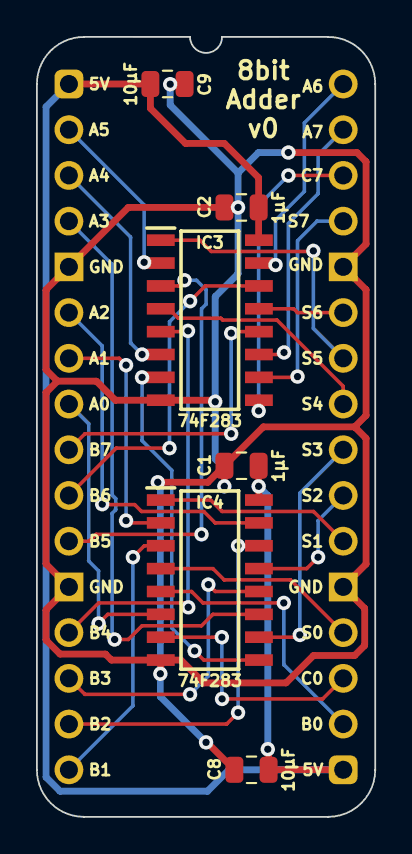
[picture p236: board Added 8bit.kicad_pcb from above]

Board: 2 copper layers, 18.8 x 43.3 mm, 7 parts (0 on the bottom side), 29 nets.
