andrewpaterson/HCP65/Kicad/Computer/Main/Triple MPU Clock Generator/Triple MPU Clock Generator.kicad_pcb

## KiCad design Kicad/Computer/Main/Triple MPU Clock Generator/Triple MPU Clock Generator.kicad_pcb (2026-11-01)

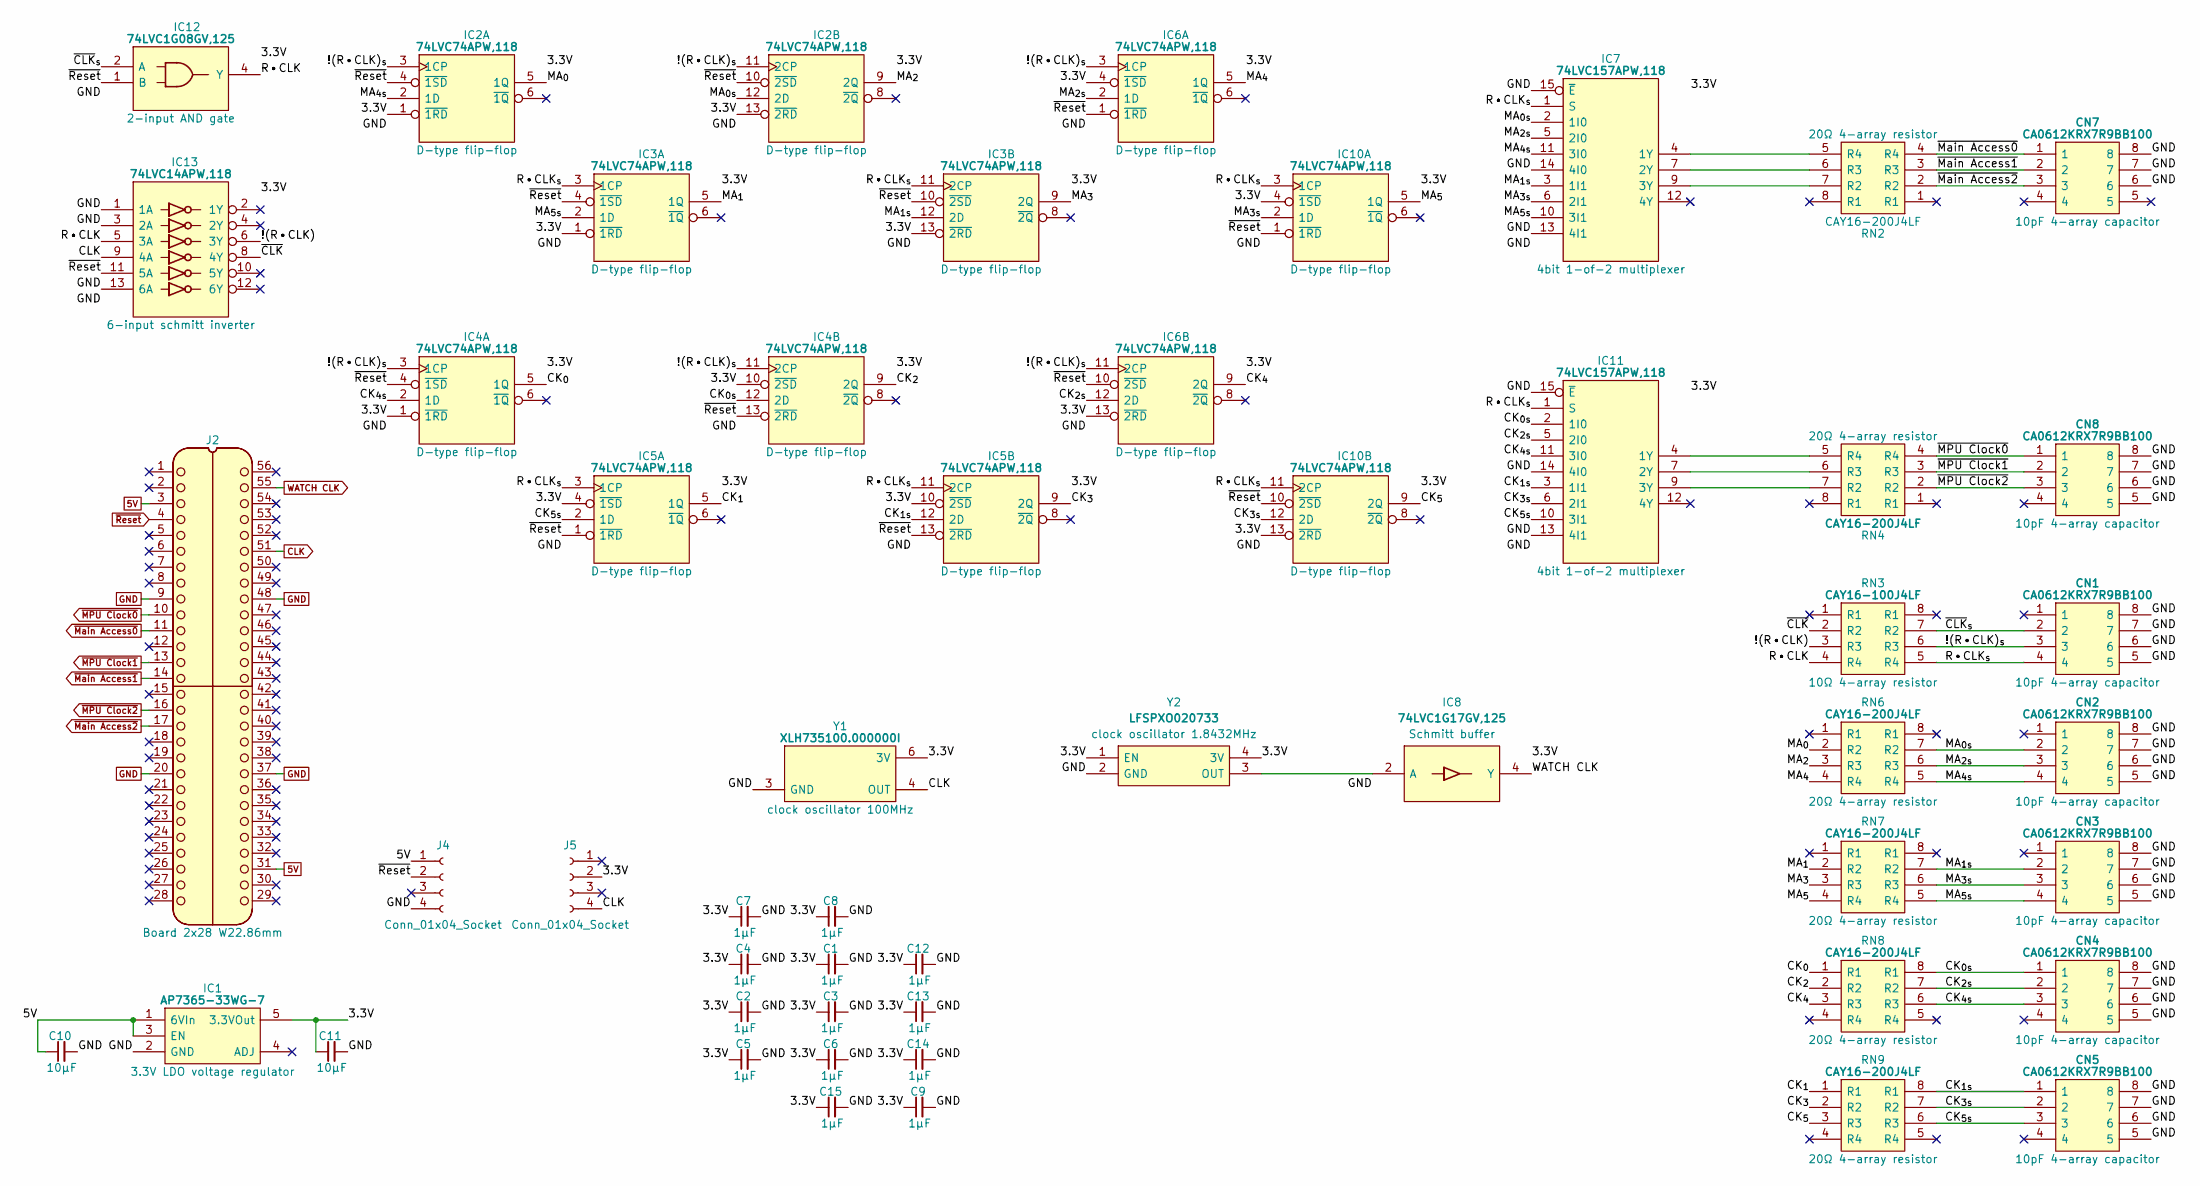
[picture p237: schematic Triple MPU Clock Generator.kicad_sch]

Parts:
C1, C2, C3, C4, C5, C6, C7, C8, C9, C12, C13, C14, C15: 1μF; C_0805
C10, C11: 10µF; C_0805
CN1, CN2, CN3, CN4, CN5, CN7, CN8: CA0612KRX7R9BB100; Manufacturer_Part_Number CA0612KRX7R9BB102; Mouser Part Number 603-CA612KRX7R9BB102
IC1: AP7365-33WG-7; SOT95P285X130-5N; Manufacturer_Part_Number AP7365-33WG-7; Mouser Part Number 621-AP7365-33WG-7
IC2, IC3, IC4, IC5, IC6, IC10: 74LVC74APW,118; SOP65P640X110-14N; Mouser Part Number 771-74LVC74APW-T
IC7, IC11: 74LVC157APW,118; SOP65P640X110-16N; Mouser Part Number 771-74LVC157APW-T
IC8: 74LVC1G17GV,125; SOT95P275X110-5N; Manufacturer_Part_Number 74LVC1G17GV,125
IC12: 74LVC1G08GV,125; SOT95P275X110-5N; Manufacturer_Part_Number 74LVC1G08GV,125; Mouser Part Number 771-74LVC1G08GV
IC13: 74LVC14APW,118; SOP65P640X110-14N; Manufacturer_Part_Number 74LVC14APW,118; Mouser Part Number 771-74LVC14APW-T
J2: Board 2x28 W22.86mm; DIP-56_Board_W22.86mm
J4, J5: Conn_01x04_Socket; PinSocket_1x04_P2.54mm_Vertical
RN2, RN4, RN6, RN7, RN8, RN9: CAY16-200J4LF; CAY16-F4; Manufacturer_Part_Number CAY16-331J4LF; Mouser Part Number 652-CAY16-331J4LF
RN3: CAY16-100J4LF; CAY16-F4; Manufacturer_Part_Number CAY16-331J4LF; Mouser Part Number 652-CAY16-331J4LF
Y1: XLH735100.000000I; XLH735100000000I; Mouser Part Number 972-XLH735100000000I
Y2: LFSPXO020733

Connections:
5V: C10.1, IC1.1 (6VIn), IC1.3 (EN), J2.3, J2.31, J4.1
/3.3V: C1.1, C2.1, C3.1, C4.1, C5.1, C6.1, C7.1, C8.1, C9.1, C11.1, C12.1, C13.1, C14.1, C15.1, IC1.5 (3.3VOut), IC2.1 (~1RD), IC2.13 (~2RD), IC2.14 (3V), IC3.1 (~1RD), IC3.13 (~2RD), IC3.14 (3V), IC4.1 (~1RD), IC4.10 (~2SD), IC4.14 (3V), IC5.4 (~1SD), IC5.10 (~2SD), IC5.14 (3V), IC6.4 (~1SD), IC6.13 (~2RD), IC6.14 (3V), IC7.16 (3V), IC8.5 (3V), IC10.4 (~1SD), IC10.13 (~2RD), IC10.14 (3V), IC11.16 (3V), IC12.5 (3V), IC13.14 (3V), J5.2, Y1.6 (3V), Y2.1 (EN), Y2.4 (3V)
/!(R•CLK): IC13.6 (3Y), RN3.3 (R3)
/!(R•CLK)_{s}: CN1.3, IC2.3 (1CP), IC2.11 (2CP), IC4.3 (1CP), IC4.11 (2CP), IC6.3 (1CP), IC6.11 (2CP), RN3.6 (R3)
/CK_{0s}: CN4.1, IC4.12 (2D), IC11.2 (1I0), RN8.8 (R1)
/CK_{0}: IC4.5 (1Q), RN8.1 (R1)
/CK_{1s}: CN5.1, IC5.12 (2D), IC11.3 (1I1), RN9.8 (R1)
/CK_{1}: IC5.5 (1Q), RN9.1 (R1)
/CK_{2s}: CN4.2, IC6.12 (2D), IC11.5 (2I0), RN8.7 (R2)
/CK_{2}: IC4.9 (2Q), RN8.2 (R2)
/CK_{3s}: CN5.2, IC10.12 (2D), IC11.6 (2I1), RN9.7 (R2)
/CK_{3}: IC5.9 (2Q), RN9.2 (R2)
/CK_{4s}: CN4.3, IC4.2 (1D), IC11.11 (3I0), RN8.6 (R3)
/CK_{4}: IC6.9 (2Q), RN8.3 (R3)
/CK_{5s}: CN5.3, IC5.2 (1D), IC11.10 (3I1), RN9.6 (R3)
/CK_{5}: IC10.9 (2Q), RN9.3 (R3)
/MA_{0s}: CN2.2, IC2.12 (2D), IC7.2 (1I0), RN6.7 (R2)
/MA_{0}: IC2.5 (1Q), RN6.2 (R2)
/MA_{1s}: CN3.2, IC3.12 (2D), IC7.3 (1I1), RN7.7 (R2)
/MA_{1}: IC3.5 (1Q), RN7.2 (R2)
/MA_{2s}: CN2.3, IC6.2 (1D), IC7.5 (2I0), RN6.6 (R3)
/MA_{2}: IC2.9 (2Q), RN6.3 (R3)
/MA_{3s}: CN3.3, IC7.6 (2I1), IC10.2 (1D), RN7.6 (R3)
/MA_{3}: IC3.9 (2Q), RN7.3 (R3)
/MA_{4s}: CN2.4, IC2.2 (1D), IC7.11 (3I0), RN6.5 (R4)
/MA_{4}: IC6.5 (1Q), RN6.4 (R4)
/MA_{5s}: CN3.4, IC3.2 (1D), IC7.10 (3I1), RN7.5 (R4)
/MA_{5}: IC10.5 (1Q), RN7.4 (R4)
/R•CLK: IC12.4 (Y), IC13.5 (3A), RN3.4 (R4)
/R•CLK_{s}: CN1.4, IC3.3 (1CP), IC3.11 (2CP), IC5.3 (1CP), IC5.11 (2CP), IC7.1 (S), IC10.3 (1CP), IC10.11 (2CP), IC11.1 (S), RN3.5 (R4)
/~CLK: IC13.8 (4Y), RN3.2 (R2)
/~CLK_{s}: CN1.2, IC12.2 (A), RN3.7 (R2)
CLK: IC13.9 (4A), J2.51, J5.4, Y1.4 (OUT)
GND: C1.2, C2.2, C3.2, C4.2, C5.2, C6.2, C7.2, C8.2, C9.2, C10.2, C11.2, C12.2, C13.2, C14.2, C15.2, CN1.5, CN1.6, CN1.7, CN1.8, CN2.5, CN2.6, CN2.7, CN2.8, CN3.5, CN3.6, CN3.7, CN3.8, CN4.5, CN4.6, CN4.7, CN4.8, CN5.5, CN5.6, CN5.7, CN5.8, CN7.6, CN7.7, CN7.8, CN8.5, CN8.6, CN8.7, CN8.8, IC1.2 (GND), IC2.7 (GND), IC3.7 (GND), IC4.7 (GND), IC5.7 (GND), IC6.7 (GND), IC7.8 (GND), IC7.13 (4I1), IC7.14 (4I0), IC7.15 (~E), IC8.3 (GND), IC10.7 (GND), IC11.8 (GND), IC11.13 (4I1), IC11.14 (4I0), IC11.15 (~E), IC12.3 (GND), IC13.1 (1A), IC13.3 (2A), IC13.7 (GND), IC13.13 (6A), J2.9, J2.20, J2.37, J2.48, J4.4, Y1.3 (GND), Y2.2 (GND)
unnamed: IC7.4 (1Y), RN2.5 (R4)
unnamed: IC7.7 (2Y), RN2.6 (R3)
unnamed: IC7.9 (3Y), RN2.7 (R2)
unnamed: IC8.2 (A), Y2.3 (OUT)
unnamed: IC11.4 (1Y), RN4.5 (R4)
unnamed: IC11.7 (2Y), RN4.6 (R3)
unnamed: IC11.9 (3Y), RN4.7 (R2)
WATCH CLK: IC8.4 (Y), J2.55
~MPU Clock0: CN8.1, J2.10, RN4.4 (R4)
~MPU Clock1: CN8.2, J2.13, RN4.3 (R3)
~MPU Clock2: CN8.3, J2.16, RN4.2 (R2)
~Main Access0: CN7.1, J2.11, RN2.4 (R4)
~Main Access1: CN7.2, J2.14, RN2.3 (R3)
~Main Access2: CN7.3, J2.17, RN2.2 (R2)
~Reset: IC2.4 (~1SD), IC2.10 (~2SD), IC3.4 (~1SD), IC3.10 (~2SD), IC4.4 (~1SD), IC4.13 (~2RD), IC5.1 (~1RD), IC5.13 (~2RD), IC6.1 (~1RD), IC6.10 (~2SD), IC10.1 (~1RD), IC10.10 (~2SD), IC12.1 (B), IC13.11 (5A), J2.4, J4.2

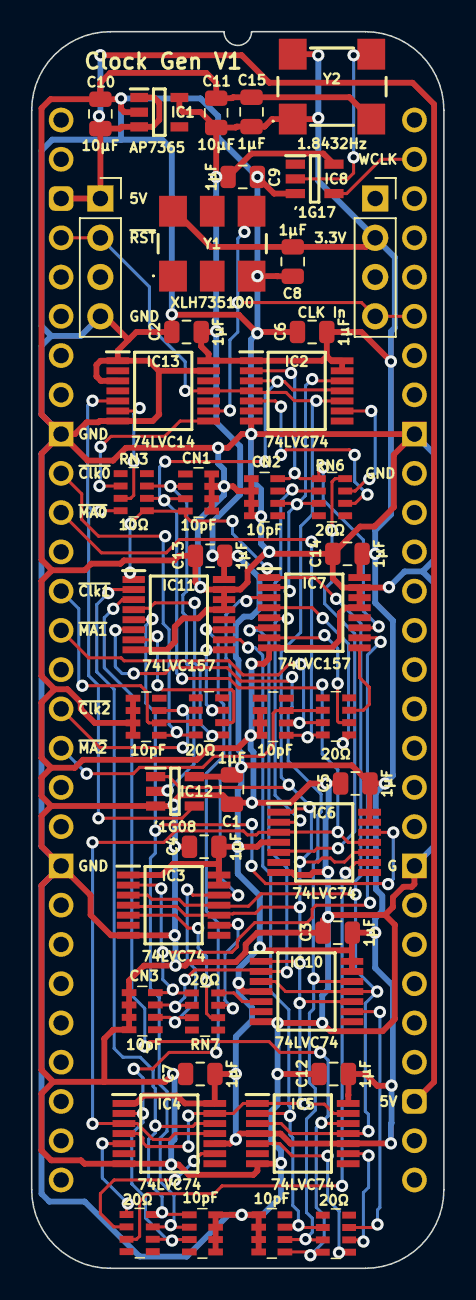
[picture p238: board Triple MPU Clock Generator.kicad_pcb from above]

Board: 2 copper layers, 26.7 x 80.0 mm, 46 parts (0 on the bottom side), 49 nets.
