andrewpaterson/HCP65/Kicad/Computer/Component Boards/Comparator 10bit/Comparator 10bit.kicad_pcb

## KiCad design Kicad/Computer/Component Boards/Comparator 10bit/Comparator 10bit.kicad_pcb (2026-11-01)

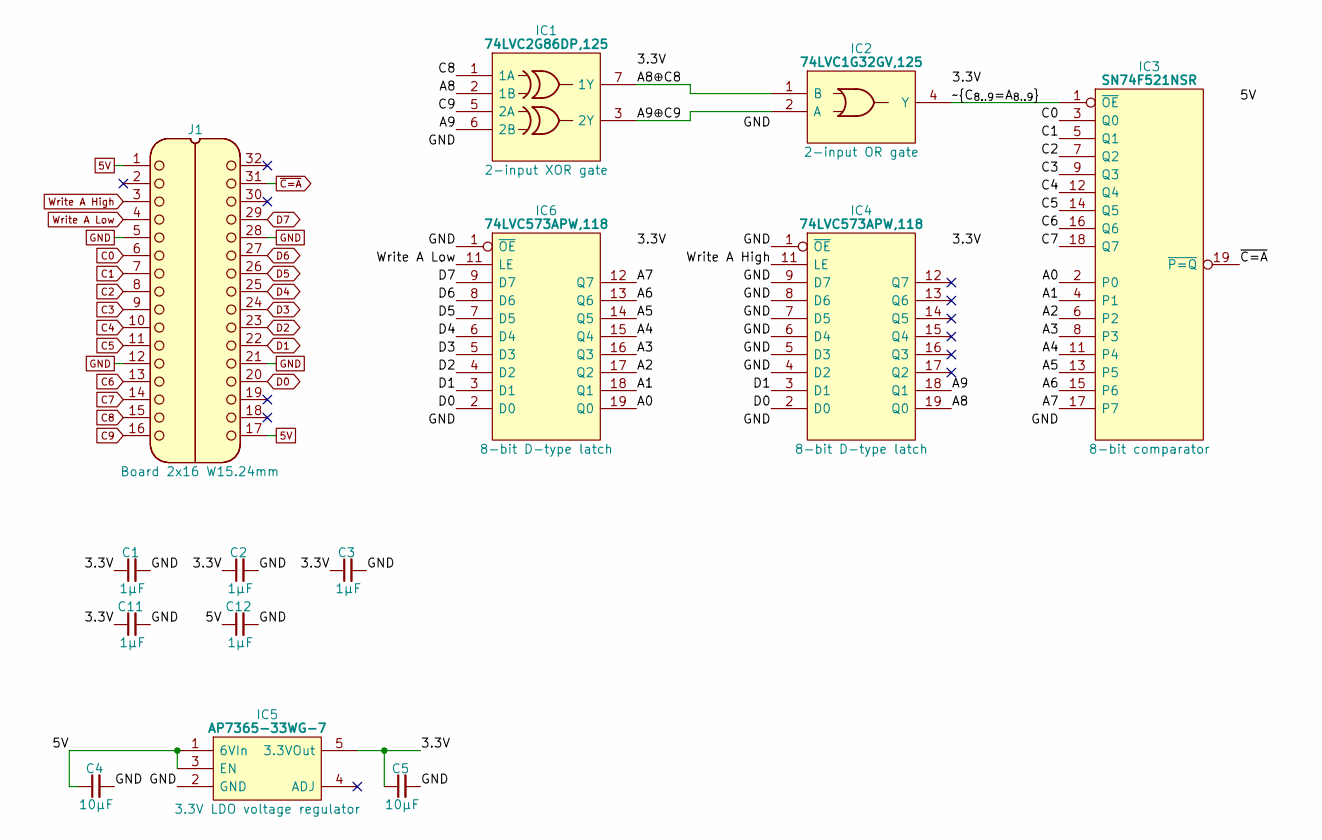
[picture p241: schematic Comparator 10bit.kicad_sch]

Parts:
C1, C2, C3, C11, C12: 1μF; C_0805
C4, C5: 10µF; C_0805
IC1: 74LVC2G86DP,125; SOP65P400X110-8N; Manufacturer_Part_Number 74LVC2G86DP,125; Mouser Part Number 771-LVC2G86DP125
IC2: 74LVC1G32GV,125; SOT95P275X110-5N; Manufacturer_Part_Number 74LVC1G32GV,125; Mouser Part Number 771-LVC1G32GV125
IC3: SN74F521NSR; SOIC127P780X200-20N; Mouser Part Number 595-SN74F521NSR
IC4, IC6: 74LVC573APW,118; SOP65P640X110-20N; Mouser Part Number 771-74LVC573APW-T
IC5: AP7365-33WG-7; SOT95P285X130-5N; Manufacturer_Part_Number AP7365-33WG-7; Mouser Part Number 621-AP7365-33WG-7
J1: Board 2x16 W15.24mm; DIP-32_Board_W15.24mm

Connections:
5V: C4.1, C12.1, IC3.20 (5V), IC5.1 (6VIn), IC5.3 (EN), J1.1, J1.17
/3.3V: C1.1, C2.1, C3.1, C5.1, C11.1, IC1.8 (VCC), IC2.5 (3V), IC4.20 (3V), IC5.5 (3.3VOut), IC6.20 (3V)
/A0: IC3.2 (P0), IC6.19 (Q0)
/A1: IC3.4 (P1), IC6.18 (Q1)
/A2: IC3.6 (P2), IC6.17 (Q2)
/A3: IC3.8 (P3), IC6.16 (Q3)
/A4: IC3.11 (P4), IC6.15 (Q4)
/A5: IC3.13 (P5), IC6.14 (Q5)
/A6: IC3.15 (P6), IC6.13 (Q6)
/A7: IC3.17 (P7), IC6.12 (Q7)
/A8: IC1.2 (1B), IC4.19 (Q0)
/A8⊕C8: IC1.7 (1Y), IC2.1 (B)
/A9: IC1.6 (2B), IC4.18 (Q1)
/A9⊕C9: IC1.3 (2Y), IC2.2 (A)
/~C_{8..9=A_{8..9}}: IC2.4 (Y), IC3.1 (~OE)
C0: IC3.3 (Q0), J1.6
C1: IC3.5 (Q1), J1.7
C2: IC3.7 (Q2), J1.8
C3: IC3.9 (Q3), J1.9
C4: IC3.12 (Q4), J1.10
C5: IC3.14 (Q5), J1.11
C6: IC3.16 (Q6), J1.13
C7: IC3.18 (Q7), J1.14
C8: IC1.1 (1A), J1.15
C9: IC1.5 (2A), J1.16
D0: IC4.2 (D0), IC6.2 (D0), J1.20
D1: IC4.3 (D1), IC6.3 (D1), J1.22
D2: IC6.4 (D2), J1.23
D3: IC6.5 (D3), J1.24
D4: IC6.6 (D4), J1.25
D5: IC6.7 (D5), J1.26
D6: IC6.8 (D6), J1.27
D7: IC6.9 (D7), J1.29
GND: C1.2, C2.2, C3.2, C4.2, C5.2, C11.2, C12.2, IC1.4 (GND), IC2.3 (GND), IC3.10 (GND), IC4.1 (~OE), IC4.4 (D2), IC4.5 (D3), IC4.6 (D4), IC4.7 (D5), IC4.8 (D6), IC4.9 (D7), IC4.10 (GND), IC5.2 (GND), IC6.1 (~OE), IC6.10 (GND), J1.5, J1.12, J1.21, J1.28
Write A High: IC4.11 (LE), J1.3
Write A Low: IC6.11 (LE), J1.4
~C=A: IC3.19 (~P=Q), J1.31

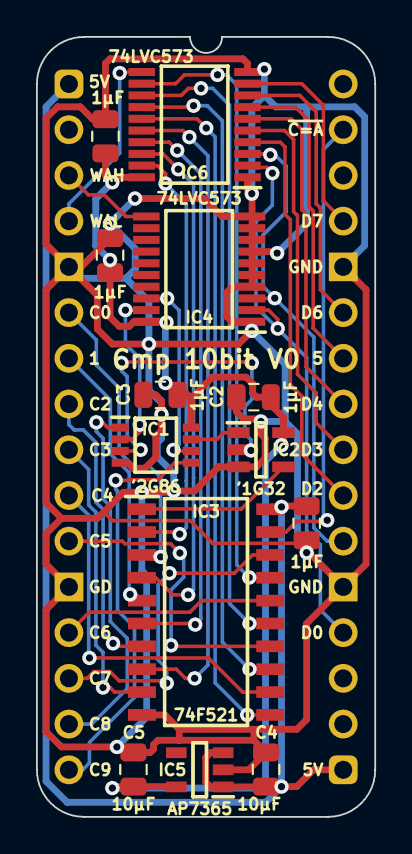
[picture p242: board Comparator 10bit.kicad_pcb from above]

Board: 2 copper layers, 18.8 x 43.3 mm, 14 parts (0 on the bottom side), 37 nets.
