andrewpaterson/HCP65/Kicad/Computer/LCD/LCD Display/LCD Display.kicad_pcb

## KiCad design Kicad/Computer/LCD/LCD Display/LCD Display.kicad_pcb (continued)

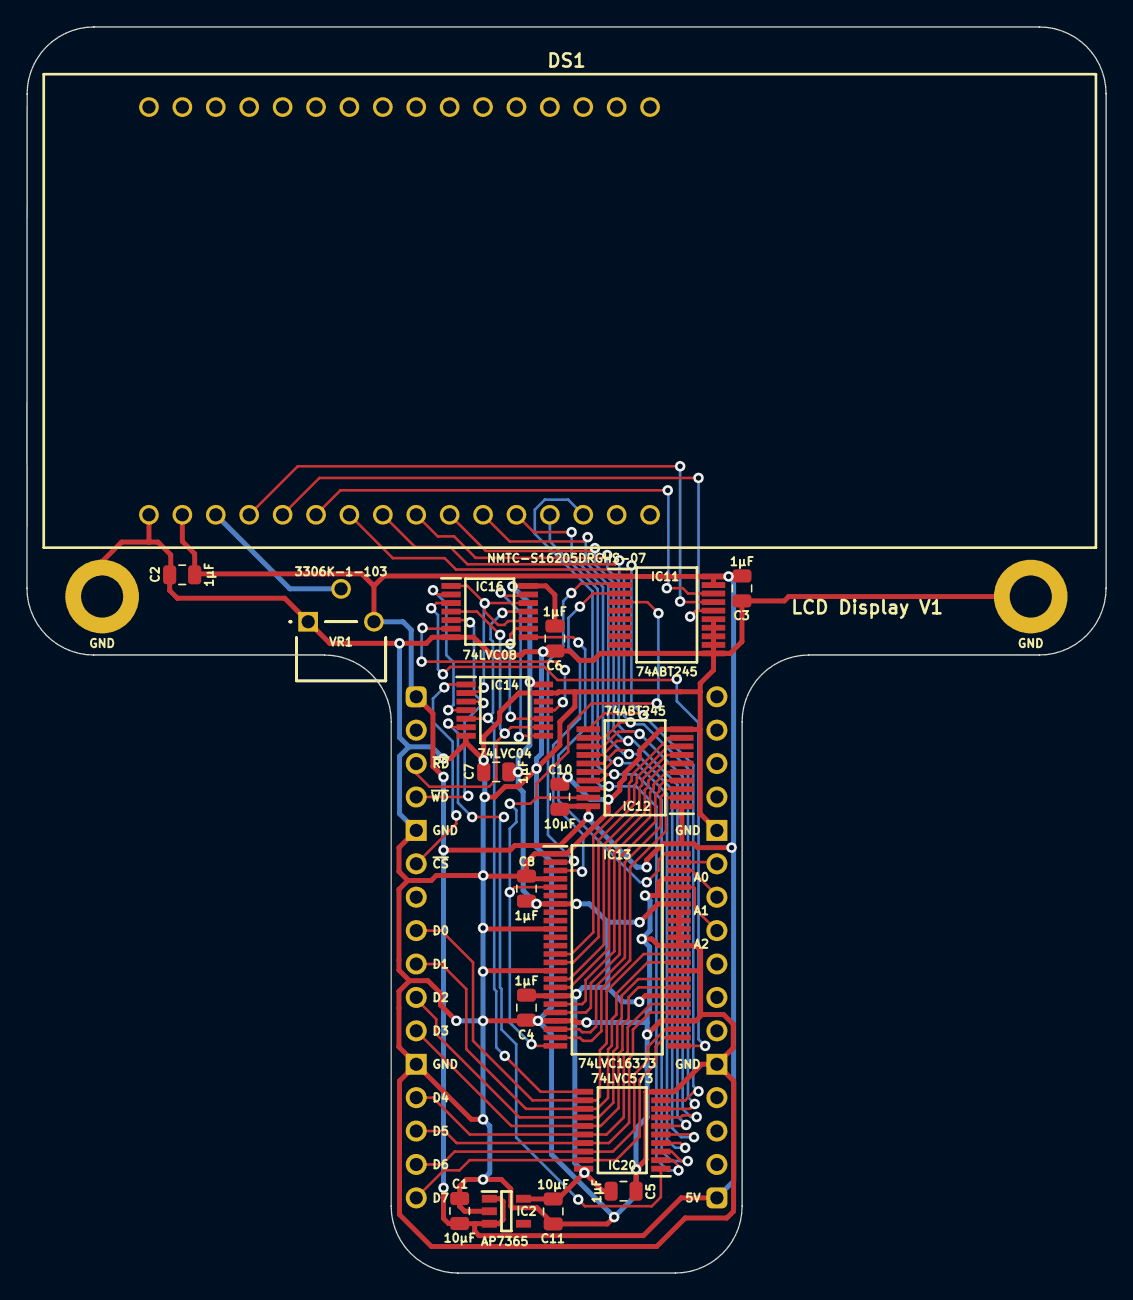
[picture p244: board LCD Display.kicad_pcb from above]

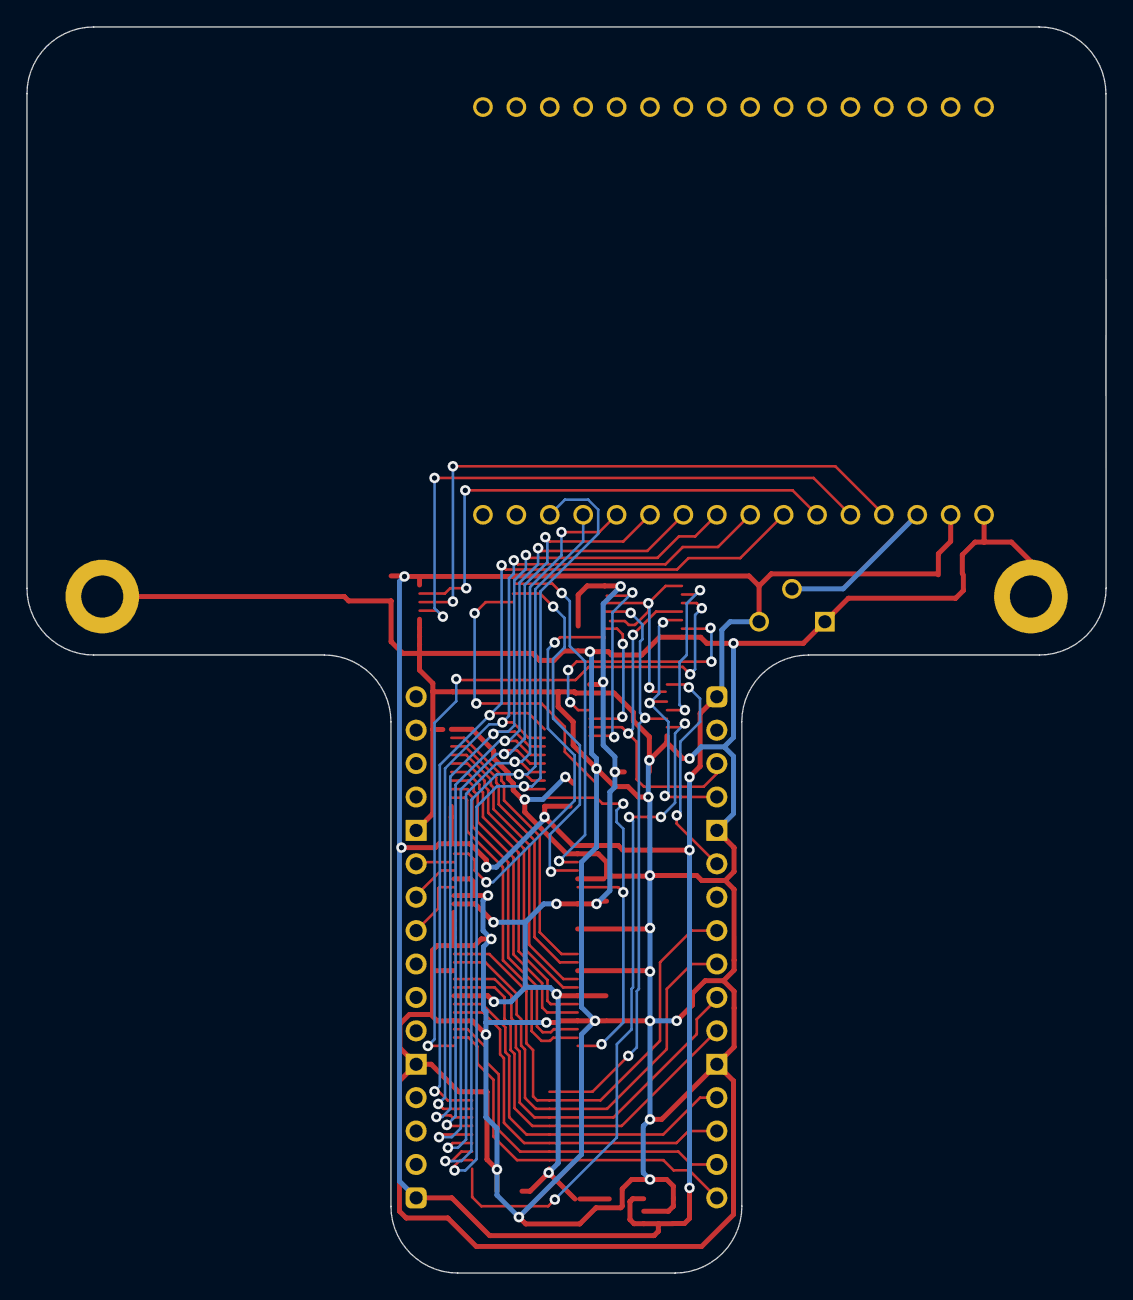
[picture p245: board LCD Display.kicad_pcb from below]

Board: 2 copper layers, 82.0 x 94.7 mm, 24 parts (2 on the bottom side), 49 nets.
