andrewpaterson/HCP65/Kicad/Computer/Processor/HCP65 Main Memory Data/HCP65 Main Memory Data.kicad_pcb

## KiCad design Kicad/Computer/Processor/HCP65 Main Memory Data/HCP65 Main Memory Data.kicad_pcb (2026-11-01)

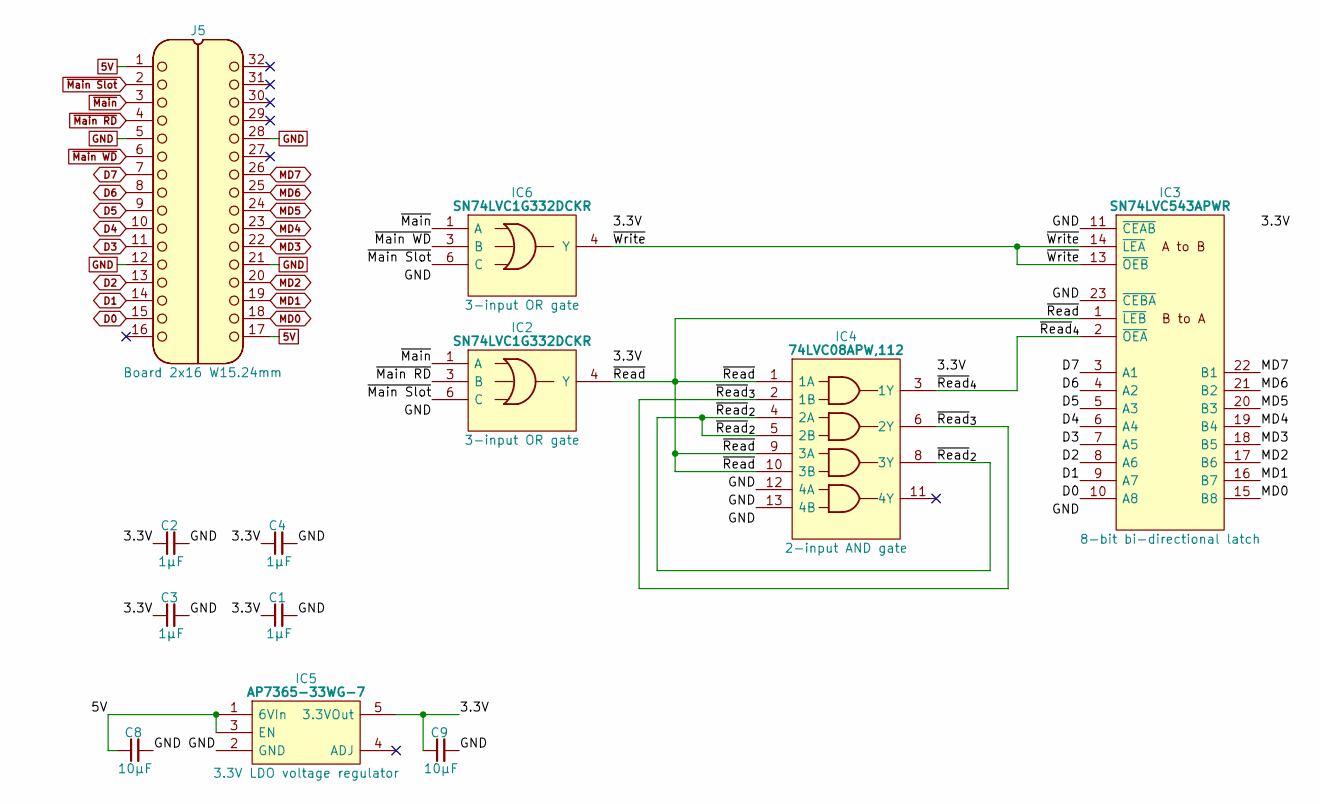
[picture p246: schematic HCP65 Main Memory Data.kicad_sch, Main Memory Data]

Parts:
C1, C2, C3, C4: 1μF; C_0805
C8, C9: 10µF; C_0805
IC2, IC6: SN74LVC1G332DCKR; SOT65P210X110-6N; Mouser Part Number 595-SN74LVC1G332DCKR
IC3: SN74LVC543APWR; SOP65P640X120-24N; Mouser Part Number 595-SN74LVC543APWR
IC4: 74LVC08APW,112; SOP65P640X110-14N; Manufacturer_Part_Number 74LVC08APW,112; Mouser Part Number 771-74LVC08APW
IC5: AP7365-33WG-7; SOT95P285X130-5N; Manufacturer_Part_Number AP7365-33WG-7; Mouser Part Number 621-AP7365-33WG-7
J5: Board 2x16 W15.24mm; DIP-32_Board_W15.24mm

Connections:
5V: C8.1, IC5.1 (6VIn), IC5.3 (EN), J5.1, J5.17
/3.3V: C1.1, C2.1, C3.1, C4.1, C9.1, IC2.5 (3V), IC3.24 (3V), IC4.14 (3V), IC5.5 (3.3VOut), IC6.5 (3V)
/~Read: IC2.4 (Y), IC3.1 (~LEB), IC4.1 (1A), IC4.9 (3A), IC4.10 (3B)
/~Read_{2}: IC4.4 (2A), IC4.5 (2B), IC4.8 (3Y)
/~Read_{3}: IC4.2 (1B), IC4.6 (2Y)
/~Read_{4}: IC3.2 (~OEA), IC4.3 (1Y)
/~Write: IC3.13 (~OEB), IC3.14 (~LEA), IC6.4 (Y)
D0: IC3.10 (A8), J5.15
D1: IC3.9 (A7), J5.14
D2: IC3.8 (A6), J5.13
D3: IC3.7 (A5), J5.11
D4: IC3.6 (A4), J5.10
D5: IC3.5 (A3), J5.9
D6: IC3.4 (A2), J5.8
D7: IC3.3 (A1), J5.7
GND: C1.2, C2.2, C3.2, C4.2, C8.2, C9.2, IC2.2 (GND), IC3.11 (~CEAB), IC3.12 (GND), IC3.23 (~CEBA), IC4.7 (GND), IC4.12 (4A), IC4.13 (4B), IC5.2 (GND), IC6.2 (GND), J5.5, J5.12, J5.21, J5.28
MD0: IC3.15 (B8), J5.18
MD1: IC3.16 (B7), J5.19
MD2: IC3.17 (B6), J5.20
MD3: IC3.18 (B5), J5.22
MD4: IC3.19 (B4), J5.23
MD5: IC3.20 (B3), J5.24
MD6: IC3.21 (B2), J5.25
MD7: IC3.22 (B1), J5.26
~Main RD: IC2.3 (B), J5.4
~Main Slot: IC2.6 (C), IC6.6 (C), J5.2
~Main WD: IC6.3 (B), J5.6
~Main: IC2.1 (A), IC6.1 (A), J5.3

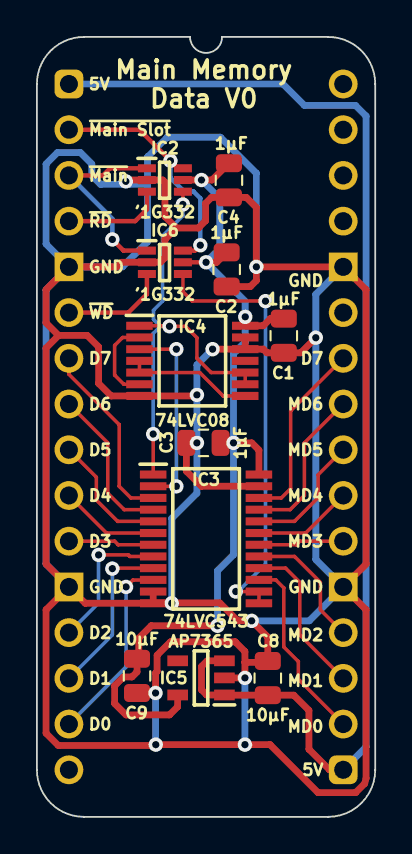
[picture p247: board HCP65 Main Memory Data.kicad_pcb from above]

Board: 2 copper layers, 18.8 x 43.3 mm, 12 parts (0 on the bottom side), 28 nets.
