andrewpaterson/HCP65/Kicad/Computer/Processor/HCP65 Instruction Code/HCP65 Instruction Code.kicad_pcb

## KiCad design Kicad/Computer/Processor/HCP65 Instruction Code/HCP65 Instruction Code.kicad_pcb (2026-11-01)

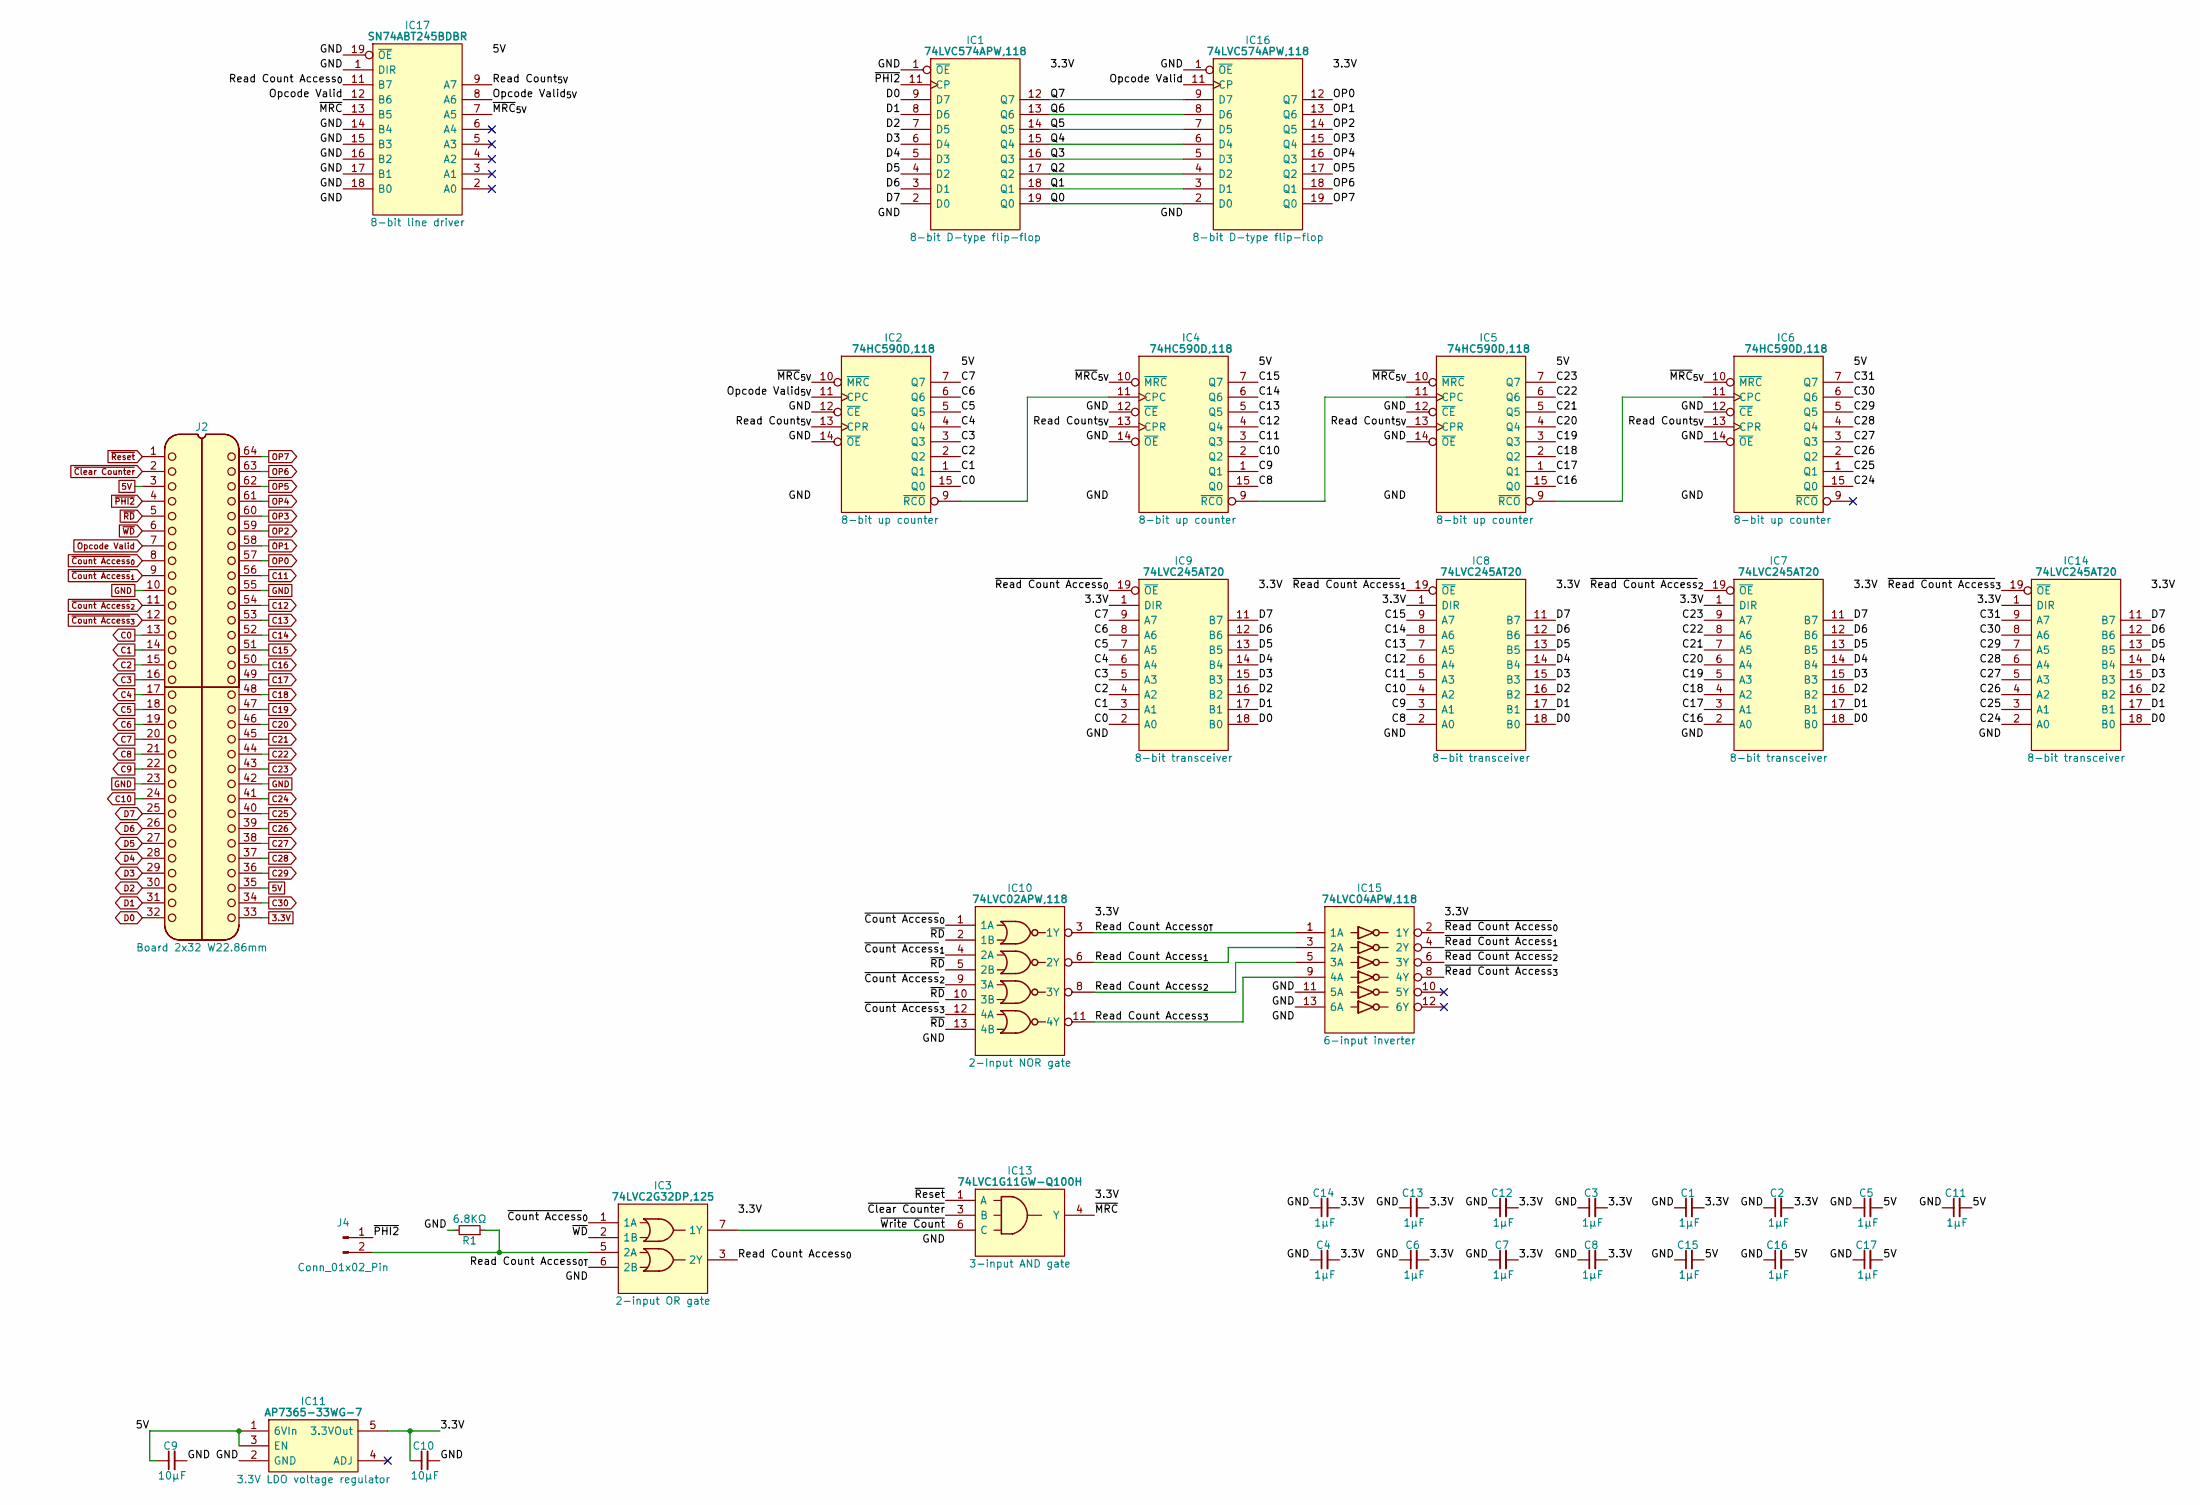
[picture p248: schematic HCP65 Instruction Code.kicad_sch, Instruction Counter and Code]

Parts:
C1, C2, C3, C4, C5, C6, C7, C8, C11, C12, C13, C14, C15, C16, C17: 1μF; C_0805
C9, C10: 10μF; C_0805
IC1, IC16: 74LVC574APW,118; SOP65P640X110-20N; Manufacturer_Part_Number 74LVC574APW,118; Mouser Part Number 771-74LVC574APW-T
IC2, IC4, IC5, IC6: 74HC590D,118; SOIC127P600X175-16N; Mouser Part Number 771-HC590D118
IC3: 74LVC2G32DP,125; SOP65P400X110-8N; Manufacturer_Part_Number 74LVC2G32DP,125; Mouser Part Number 771-LVC2G32DP125
IC7, IC8, IC9, IC14: 74LVC245AT20; SOP65P640X120-20N; Manufacturer_Part_Number 74LVC245AT20-13; Mouser Part Number 621-74LVC245AT20-13
IC10: 74LVC02APW,118; SOP65P640X110-14N; Mouser Part Number 771-74LVC02APW-T
IC11: AP7365-33WG-7; SOT95P285X130-5N; Manufacturer_Part_Number AP7365-33WG-7; Mouser Part Number 621-AP7365-33WG-7
IC13: 74LVC1G11GW-Q100H; SOP65P210X110-6N; Manufacturer_Part_Number 74LVC1G11GW-Q100H; Mouser Part Number 771-74LVC1G11GWQ100H
IC15: 74LVC04APW,118; SOP65P640X110-14N; Manufacturer_Part_Number 74LVC04APW,118; Mouser Part Number 771-74LVC04APW-T
IC17: SN74ABT245BDBR; SOP65P780X200-20N; Manufacturer_Part_Number SN74ABT245BDBR; Mouser Part Number 595-SN74ABT245BDBR
J2: Board 2x32 W22.86mm; DIP-64_Board_W22.86mm
J4: Conn_01x02_Pin; PinHeader_1x02_P2.54mm_Vertical
R1: 6.8KΩ; R_0805

Connections:
3.3V: C1.2, C2.2, C3.2, C4.2, C6.2, C7.2, C8.2, C10.1, C12.2, C13.2, C14.2, IC1.20 (3V), IC3.8 (VCC), IC7.1 (DIR), IC7.20 (3V), IC8.1 (DIR), IC8.20 (3V), IC9.1 (DIR), IC9.20 (3V), IC10.14 (3V), IC11.5 (3.3VOut), IC13.5 (3V), IC14.1 (DIR), IC14.20 (3V), IC15.14 (3V), IC16.20 (3V), J2.33
5V: C5.2, C9.1, C11.2, C15.2, C16.2, C17.2, IC2.16 (VCC), IC4.16 (VCC), IC5.16 (VCC), IC6.16 (VCC), IC11.1 (6VIn), IC11.3 (EN), IC17.20 (5V), J2.3, J2.35
/C31: IC6.7 (Q7), IC14.9 (A7)
/Opcode Valid_{5V}: IC2.11 (CPC), IC17.8 (A6)
/Q0: IC1.19 (Q0), IC16.2 (D0)
/Q1: IC1.18 (Q1), IC16.3 (D1)
/Q2: IC1.17 (Q2), IC16.4 (D2)
/Q3: IC1.16 (Q3), IC16.5 (D3)
/Q4: IC1.15 (Q4), IC16.6 (D4)
/Q5: IC1.14 (Q5), IC16.7 (D5)
/Q6: IC1.13 (Q6), IC16.8 (D6)
/Q7: IC1.12 (Q7), IC16.9 (D7)
/Read Count Access_{0T}: IC3.6 (2B), IC10.3 (1Y), IC15.1 (1A)
/Read Count Access_{0}: IC3.3 (2Y), IC17.11 (B7)
/Read Count Access_{1}: IC10.6 (2Y), IC15.3 (2A)
/Read Count Access_{2}: IC10.8 (3Y), IC15.5 (3A)
/Read Count Access_{3}: IC10.11 (4Y), IC15.9 (4A)
/Read Count_{5V}: IC2.13 (CPR), IC4.13 (CPR), IC5.13 (CPR), IC6.13 (CPR), IC17.9 (A7)
/~MRC: IC13.4 (Y), IC17.13 (B5)
/~MRC_{5V}: IC2.10 (~MRC), IC4.10 (~MRC), IC5.10 (~MRC), IC6.10 (~MRC), IC17.7 (A5)
/~Read Count Access_{0}: IC9.19 (~OE), IC15.2 (1Y)
/~Read Count Access_{1}: IC8.19 (~OE), IC15.4 (2Y)
/~Read Count Access_{2}: IC7.19 (~OE), IC15.6 (3Y)
/~Read Count Access_{3}: IC14.19 (~OE), IC15.8 (4Y)
/~Write Count: IC3.7 (1Y), IC13.6 (C)
C0: IC2.15 (Q0), IC9.2 (A0), J2.13
C1: IC2.1 (Q1), IC9.3 (A1), J2.14
C2: IC2.2 (Q2), IC9.4 (A2), J2.15
C3: IC2.3 (Q3), IC9.5 (A3), J2.16
C4: IC2.4 (Q4), IC9.6 (A4), J2.17
C5: IC2.5 (Q5), IC9.7 (A5), J2.18
C6: IC2.6 (Q6), IC9.8 (A6), J2.19
C7: IC2.7 (Q7), IC9.9 (A7), J2.20
C8: IC4.15 (Q0), IC8.2 (A0), J2.21
C9: IC4.1 (Q1), IC8.3 (A1), J2.22
C10: IC4.2 (Q2), IC8.4 (A2), J2.24
C11: IC4.3 (Q3), IC8.5 (A3), J2.56
C12: IC4.4 (Q4), IC8.6 (A4), J2.54
C13: IC4.5 (Q5), IC8.7 (A5), J2.53
C14: IC4.6 (Q6), IC8.8 (A6), J2.52
C15: IC4.7 (Q7), IC8.9 (A7), J2.51
C16: IC5.15 (Q0), IC7.2 (A0), J2.50
C17: IC5.1 (Q1), IC7.3 (A1), J2.49
C18: IC5.2 (Q2), IC7.4 (A2), J2.48
C19: IC5.3 (Q3), IC7.5 (A3), J2.47
C20: IC5.4 (Q4), IC7.6 (A4), J2.46
C21: IC5.5 (Q5), IC7.7 (A5), J2.45
C22: IC5.6 (Q6), IC7.8 (A6), J2.44
C23: IC5.7 (Q7), IC7.9 (A7), J2.43
C24: IC6.15 (Q0), IC14.2 (A0), J2.41
C25: IC6.1 (Q1), IC14.3 (A1), J2.40
C26: IC6.2 (Q2), IC14.4 (A2), J2.39
C27: IC6.3 (Q3), IC14.5 (A3), J2.38
C28: IC6.4 (Q4), IC14.6 (A4), J2.37
C29: IC6.5 (Q5), IC14.7 (A5), J2.36
C30: IC6.6 (Q6), IC14.8 (A6), J2.34
D0: IC1.9 (D7), IC7.18 (B0), IC8.18 (B0), IC9.18 (B0), IC14.18 (B0), J2.32
D1: IC1.8 (D6), IC7.17 (B1), IC8.17 (B1), IC9.17 (B1), IC14.17 (B1), J2.31
D2: IC1.7 (D5), IC7.16 (B2), IC8.16 (B2), IC9.16 (B2), IC14.16 (B2), J2.30
D3: IC1.6 (D4), IC7.15 (B3), IC8.15 (B3), IC9.15 (B3), IC14.15 (B3), J2.29
D4: IC1.5 (D3), IC7.14 (B4), IC8.14 (B4), IC9.14 (B4), IC14.14 (B4), J2.28
D5: IC1.4 (D2), IC7.13 (B5), IC8.13 (B5), IC9.13 (B5), IC14.13 (B5), J2.27
D6: IC1.3 (D1), IC7.12 (B6), IC8.12 (B6), IC9.12 (B6), IC14.12 (B6), J2.26
D7: IC1.2 (D0), IC7.11 (B7), IC8.11 (B7), IC9.11 (B7), IC14.11 (B7), J2.25
GND: C1.1, C2.1, C3.1, C4.1, C5.1, C6.1, C7.1, C8.1, C9.2, C10.2, C11.1, C12.1, C13.1, C14.1, C15.1, C16.1, C17.1, IC1.1 (~OE), IC1.10 (GND), IC2.8 (GND), IC2.12 (~CE), IC2.14 (~OE), IC3.4 (GND), IC4.8 (GND), IC4.12 (~CE), IC4.14 (~OE), IC5.8 (GND), IC5.12 (~CE), IC5.14 (~OE), IC6.8 (GND), IC6.12 (~CE), IC6.14 (~OE), IC7.10 (GND), IC8.10 (GND), IC9.10 (GND), IC10.7 (GND), IC11.2 (GND), IC13.2 (GND), IC14.10 (GND), IC15.7 (GND), IC15.11 (5A), IC15.13 (6A), IC16.1 (~OE), IC16.10 (GND), IC17.1 (DIR), IC17.10 (GND), IC17.14 (B4), IC17.15 (B3), IC17.16 (B2), IC17.17 (B1), IC17.18 (B0), IC17.19 (~OE), J2.10, J2.23, J2.42, J2.55, R1.2
unnamed: IC2.9 (~RCO), IC4.11 (CPC)
unnamed: IC3.5 (2A), J4.2, R1.1
unnamed: IC4.9 (~RCO), IC5.11 (CPC)
unnamed: IC5.9 (~RCO), IC6.11 (CPC)
OP0: IC16.12 (Q7), J2.57
OP1: IC16.13 (Q6), J2.58
OP2: IC16.14 (Q5), J2.59
OP3: IC16.15 (Q4), J2.60
OP4: IC16.16 (Q3), J2.61
OP5: IC16.17 (Q2), J2.62
OP6: IC16.18 (Q1), J2.63
OP7: IC16.19 (Q0), J2.64
Opcode Valid: IC16.11 (CP), IC17.12 (B6), J2.7
~Clear Counter: IC13.3 (B), J2.2
~Count Access_{0}: IC3.1 (1A), IC10.1 (1A), J2.8
~Count Access_{1}: IC10.4 (2A), J2.9
~Count Access_{2}: IC10.9 (3A), J2.11
~Count Access_{3}: IC10.12 (4A), J2.12
~PHI2: IC1.11 (CP), J2.4, J4.1
~RD: IC10.2 (1B), IC10.5 (2B), IC10.10 (3B), IC10.13 (4B), J2.5
~Reset: IC13.1 (A), J2.1
~WD: IC3.2 (1B), J2.6

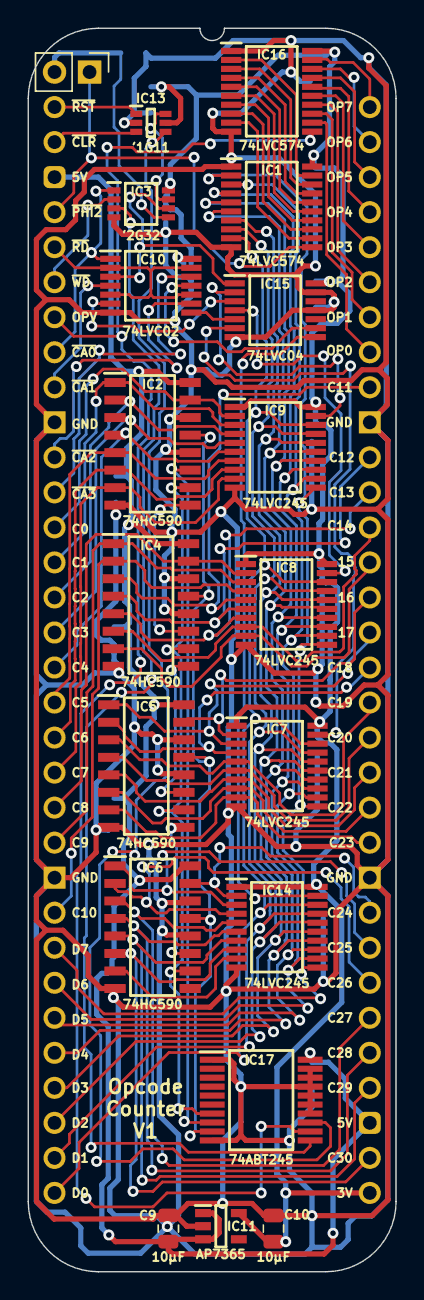
[picture p249: board HCP65 Instruction Code.kicad_pcb from above]

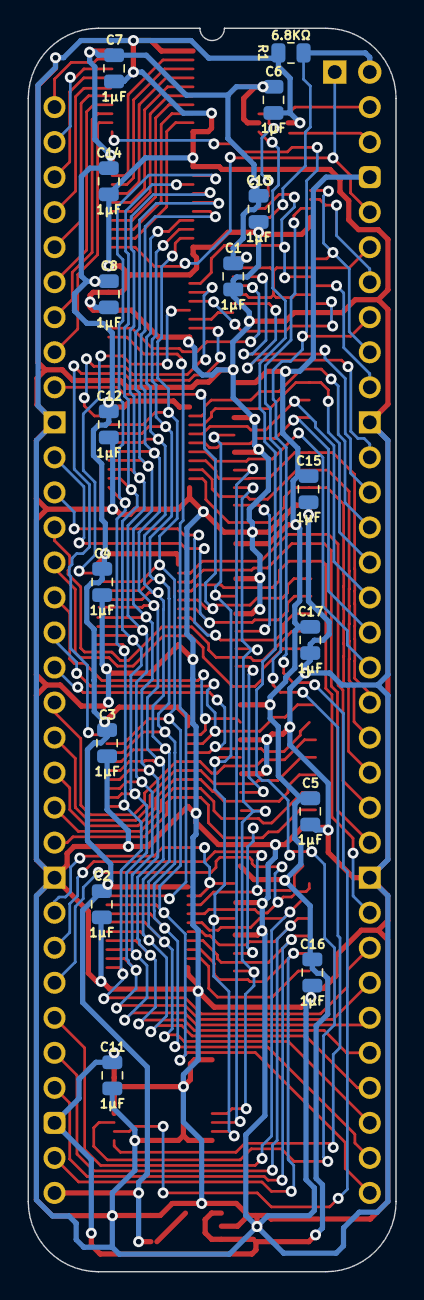
[picture p250: board HCP65 Instruction Code.kicad_pcb from below]

Board: 2 copper layers, 26.7 x 90.2 mm, 36 parts (16 on the bottom side), 87 nets.
