andrewpaterson/HCP65/Kicad/Computer/Component Boards/Audio DAC/Audio DAC.kicad_pcb

## KiCad design Kicad/Computer/Component Boards/Audio DAC/Audio DAC.kicad_pcb (2026-11-01)

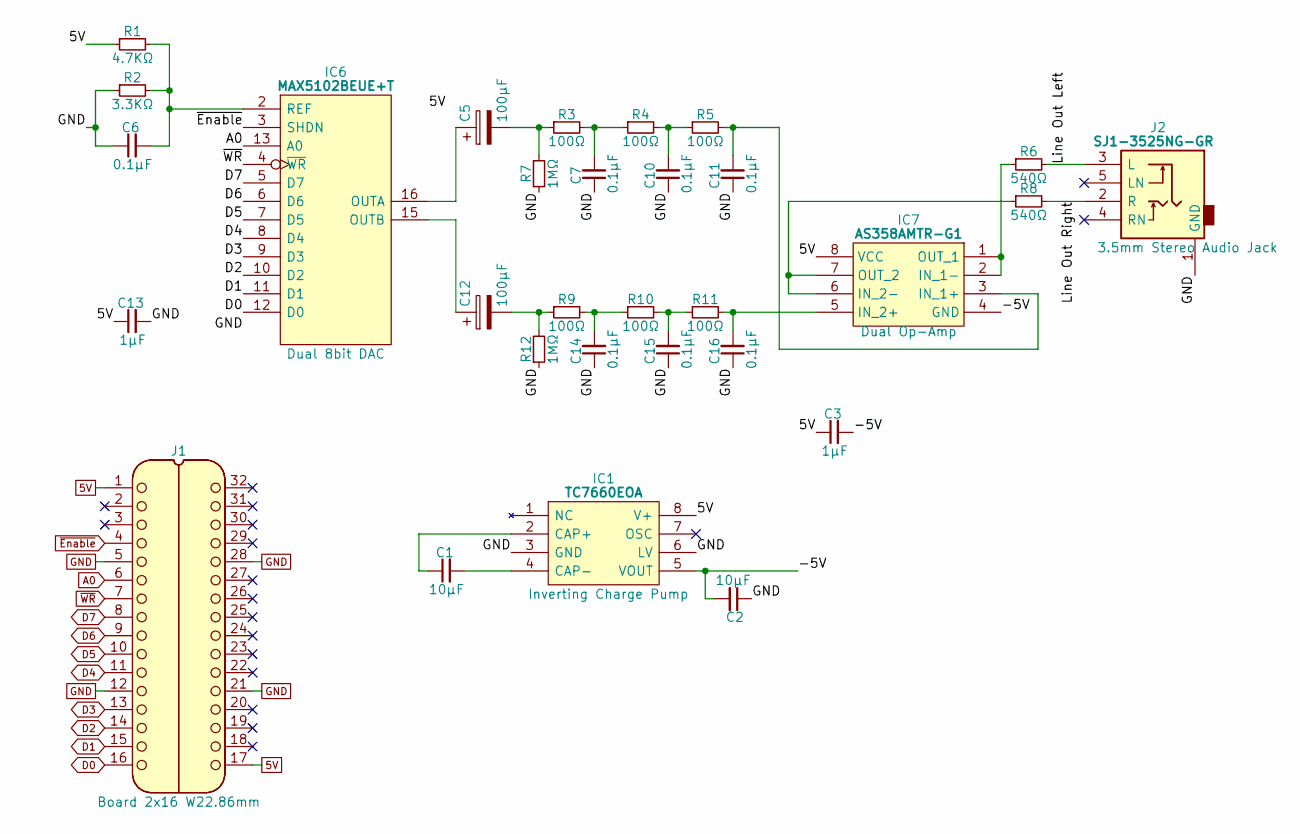
[picture p251: schematic Audio DAC.kicad_sch]

Parts:
C1, C2: 10µF; C_0805
C3, C13: 1μF; C_0805
C5, C12: 100μF; CP_Radial_D4.0mm_P2.00mm
C6, C7, C10, C11, C14, C15, C16: 0.1μF; C_0805
IC1: TC7660EOA; SOIC127P600X175-8N; Manufacturer_Part_Number TC7660EOA; Mouser Part Number 579-TC7660EOA
IC6: MAX5102BEUE+T; SOP65P640X110-16N; Manufacturer_Part_Number MAX5102BEUE+T; Mouser Part Number 700-MAX5102BEUET
IC7: AS358AMTR-G1; SOIC127P600X175-8N; Manufacturer_Part_Number AS358AMTR-G1
J1: Board 2x16 W22.86mm; DIP-32_Board_W22.86mm
J2: SJ1-3525NG-GR; SJ13525NGGR; Manufacturer_Part_Number SJ1-3525NG-GR; Mouser Part Number 490-SJ1-3525NG-GR
R1: 4.7KΩ; R_0805
R2: 3.3KΩ; R_0805
R3, R4, R5, R9, R10, R11: 100Ω; R_0805
R6, R8: 540Ω; R_0805
R7, R12: 1MΩ; R_0805

Connections:
5V: C3.1, C13.1, IC1.8 (V+), IC6.1 (VDD), IC7.8 (VCC), J1.1, J1.17, R1.1
/-5V: C2.2, C3.2, IC1.5 (VOUT), IC7.4 (GND)
/Line Out Left: J2.3 (L), R6.2
/Line Out Right: J2.2 (R), R8.2
A0: IC6.13 (A0), J1.6
D0: IC6.12 (D0), J1.16
D1: IC6.11 (D1), J1.15
D2: IC6.10 (D2), J1.14
D3: IC6.9 (D3), J1.13
D4: IC6.8 (D4), J1.11
D5: IC6.7 (D5), J1.10
D6: IC6.6 (D6), J1.9
D7: IC6.5 (D7), J1.8
GND: C2.1, C6.1, C7.1, C10.1, C11.1, C13.2, C14.1, C15.1, C16.1, IC1.3 (GND), IC1.6 (LV), IC6.14 (GND), J1.5, J1.12, J1.21, J1.28, J2.1 (GND), R2.1, R7.1, R12.1
unnamed: C5.2, R3.1, R7.2
unnamed: C7.2, R3.2, R4.1
unnamed: C10.2, R4.2, R5.1
unnamed: C12.2, R9.1, R12.2
unnamed: C14.2, R9.2, R10.1
unnamed: C15.2, R10.2, R11.1
unnamed: C1.1, IC1.2 (CAP+)
unnamed: C1.2, IC1.4 (CAP-)
unnamed: C5.1, IC6.16 (OUTA)
unnamed: C12.1, IC6.15 (OUTB)
unnamed: C6.2, IC6.2 (REF), R1.2, R2.2
unnamed: C11.2, IC7.3 (IN_1+), R5.2
unnamed: IC7.1 (OUT_1), IC7.2 (IN_1-), R6.1
unnamed: C16.2, IC7.5 (IN_2+), R11.2
unnamed: IC7.6 (IN_2-), IC7.7 (OUT_2), R8.1
~Enable: IC6.3 (SHDN), J1.4
~WR: IC6.4 (~WR), J1.7

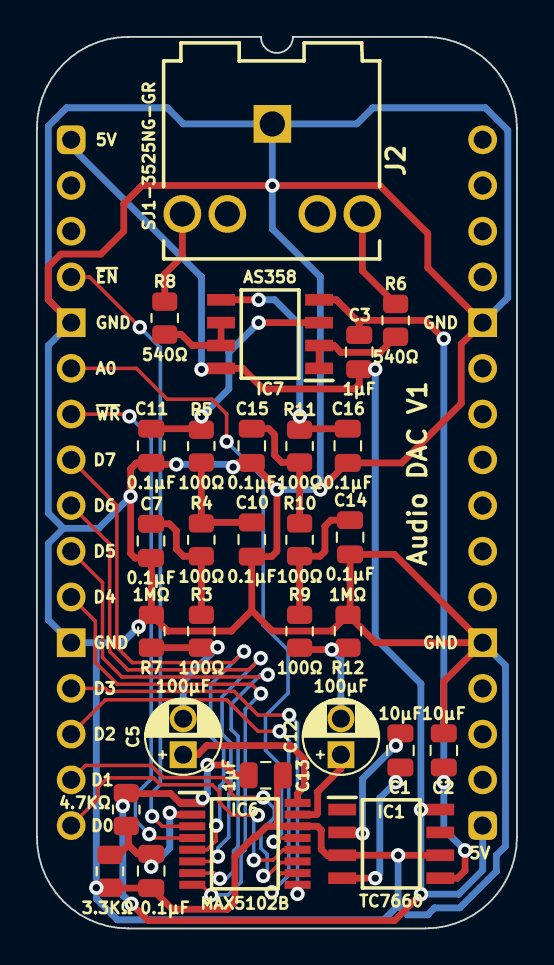
[picture p252: board Audio DAC.kicad_pcb from above]

Board: 2 copper layers, 26.7 x 49.5 mm, 30 parts (0 on the bottom side), 31 nets.
