andrewpaterson/HCP65/Kicad/Computer/Component Boards/Adder 16bit/Adder 16bit.kicad_pcb

## KiCad design Kicad/Computer/Component Boards/Adder 16bit/Adder 16bit.kicad_pcb (2026-11-01)

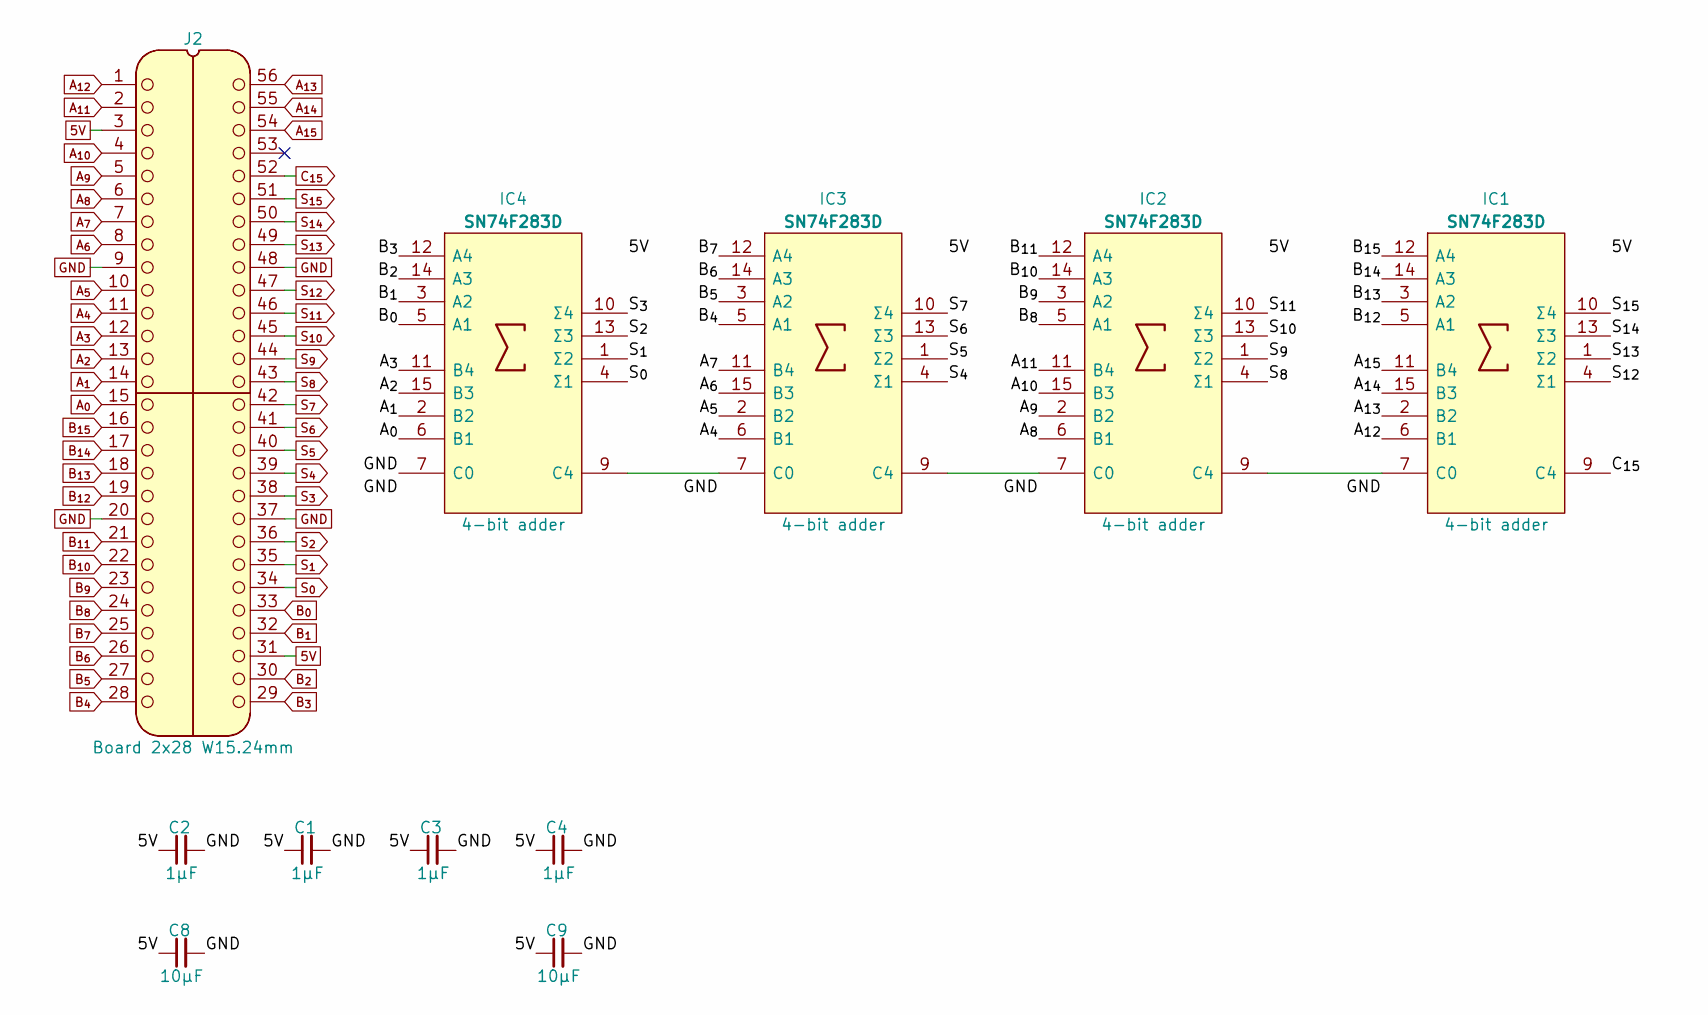
[picture p253: schematic Adder 16bit.kicad_sch, 16bit Adder]

Parts:
C1, C2, C3, C4: 1μF; C_0805
C8, C9: 10µF; C_0805
IC1, IC2, IC3, IC4: SN74F283D; SOIC127P600X175-16N; Mouser Part Number 595-SN74F283D
J2: Board 2x28 W15.24mm; DIP-56_Board_W15.24mm

Connections:
5V: C1.1, C2.1, C3.1, C4.1, C8.1, C9.1, IC1.16 (5V), IC2.16 (5V), IC3.16 (5V), IC4.16 (5V), J2.3, J2.31
A_{0}: IC4.6 (B1), J2.15
A_{1}: IC4.2 (B2), J2.14
A_{2}: IC4.15 (B3), J2.13
A_{3}: IC4.11 (B4), J2.12
A_{4}: IC3.6 (B1), J2.11
A_{5}: IC3.2 (B2), J2.10
A_{6}: IC3.15 (B3), J2.8
A_{7}: IC3.11 (B4), J2.7
A_{8}: IC2.6 (B1), J2.6
A_{9}: IC2.2 (B2), J2.5
A_{10}: IC2.15 (B3), J2.4
A_{11}: IC2.11 (B4), J2.2
A_{12}: IC1.6 (B1), J2.1
A_{13}: IC1.2 (B2), J2.56
A_{14}: IC1.15 (B3), J2.55
A_{15}: IC1.11 (B4), J2.54
B_{0}: IC4.5 (A1), J2.33
B_{1}: IC4.3 (A2), J2.32
B_{2}: IC4.14 (A3), J2.30
B_{3}: IC4.12 (A4), J2.29
B_{4}: IC3.5 (A1), J2.28
B_{5}: IC3.3 (A2), J2.27
B_{6}: IC3.14 (A3), J2.26
B_{7}: IC3.12 (A4), J2.25
B_{8}: IC2.5 (A1), J2.24
B_{9}: IC2.3 (A2), J2.23
B_{10}: IC2.14 (A3), J2.22
B_{11}: IC2.12 (A4), J2.21
B_{12}: IC1.5 (A1), J2.19
B_{13}: IC1.3 (A2), J2.18
B_{14}: IC1.14 (A3), J2.17
B_{15}: IC1.12 (A4), J2.16
C_{15}: IC1.9 (C4), J2.52
GND: C1.2, C2.2, C3.2, C4.2, C8.2, C9.2, IC1.8 (GND), IC2.8 (GND), IC3.8 (GND), IC4.7 (C0), IC4.8 (GND), J2.9, J2.20, J2.37, J2.48
unnamed: IC1.7 (C0), IC2.9 (C4)
unnamed: IC2.7 (C0), IC3.9 (C4)
unnamed: IC3.7 (C0), IC4.9 (C4)
S_{0}: IC4.4 (Σ1), J2.34
S_{1}: IC4.1 (Σ2), J2.35
S_{2}: IC4.13 (Σ3), J2.36
S_{3}: IC4.10 (Σ4), J2.38
S_{4}: IC3.4 (Σ1), J2.39
S_{5}: IC3.1 (Σ2), J2.40
S_{6}: IC3.13 (Σ3), J2.41
S_{7}: IC3.10 (Σ4), J2.42
S_{8}: IC2.4 (Σ1), J2.43
S_{9}: IC2.1 (Σ2), J2.44
S_{10}: IC2.13 (Σ3), J2.45
S_{11}: IC2.10 (Σ4), J2.46
S_{12}: IC1.4 (Σ1), J2.47
S_{13}: IC1.1 (Σ2), J2.49
S_{14}: IC1.13 (Σ3), J2.50
S_{15}: IC1.10 (Σ4), J2.51

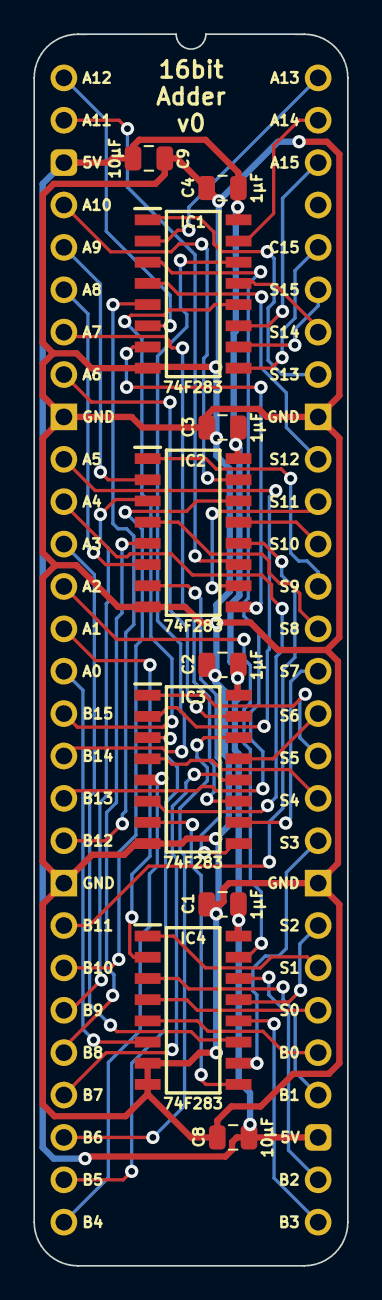
[picture p254: board Adder 16bit.kicad_pcb from above]

Board: 2 copper layers, 18.8 x 73.8 mm, 11 parts (0 on the bottom side), 54 nets.
