andrewpaterson/HCP65/Kicad/Computer/Processor/W65C816 Power/W65C816 Power.kicad_pcb

## KiCad design Kicad/Computer/Processor/W65C816 Power/W65C816 Power.kicad_pcb (2026-11-01)

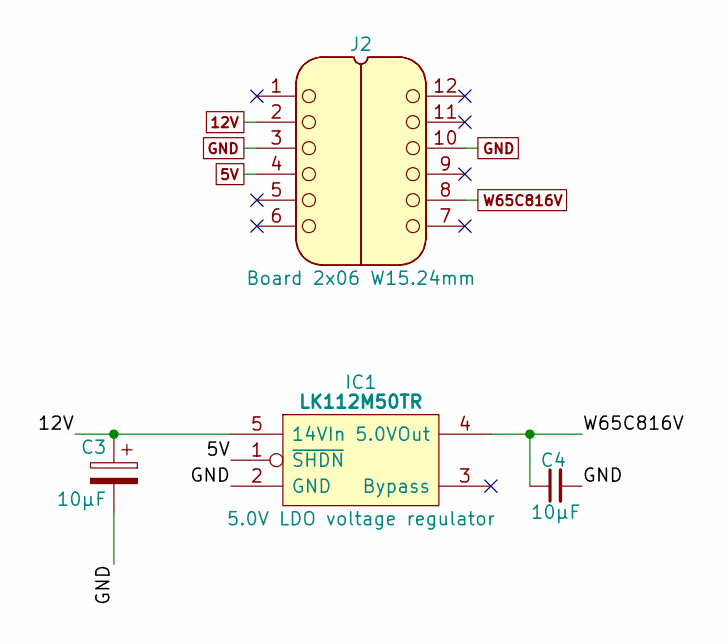
[picture p261: schematic W65C816 Power.kicad_sch]

Parts:
C3: 10μF; CP_Radial_D4.0mm_P2.00mm
C4: 10µF; C_0805
IC1: LK112M50TR; SOT95P285X130-5N; Manufacturer_Part_Number LK112M50TR
J2: Board 2x06 W15.24mm; DIP-12_Board_W15.24mm_Alt

Connections:
5V: IC1.1 (~SHDN), J2.4
12V: C3.1, IC1.5 (14VIn), J2.2
GND: C3.2, C4.2, IC1.2 (GND), J2.3, J2.10
W65C816V: C4.1, IC1.4 (5.0VOut), J2.8

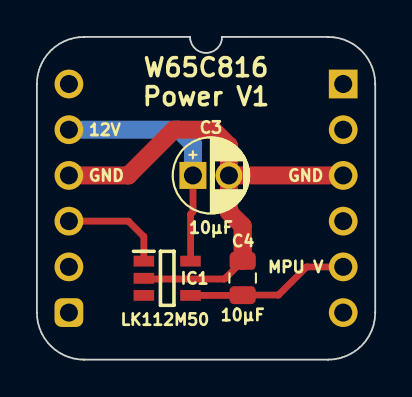
[picture p262: board W65C816 Power.kicad_pcb from above]

Board: 2 copper layers, 18.8 x 17.9 mm, 4 parts (0 on the bottom side), 4 nets.
