andrewpaterson/HCP65/Kicad/Computer/Component Boards/D Flip Flop 24bit/D Flip Flop 24bit.kicad_pcb

## KiCad design Kicad/Computer/Component Boards/D Flip Flop 24bit/D Flip Flop 24bit.kicad_pcb (2026-11-01)

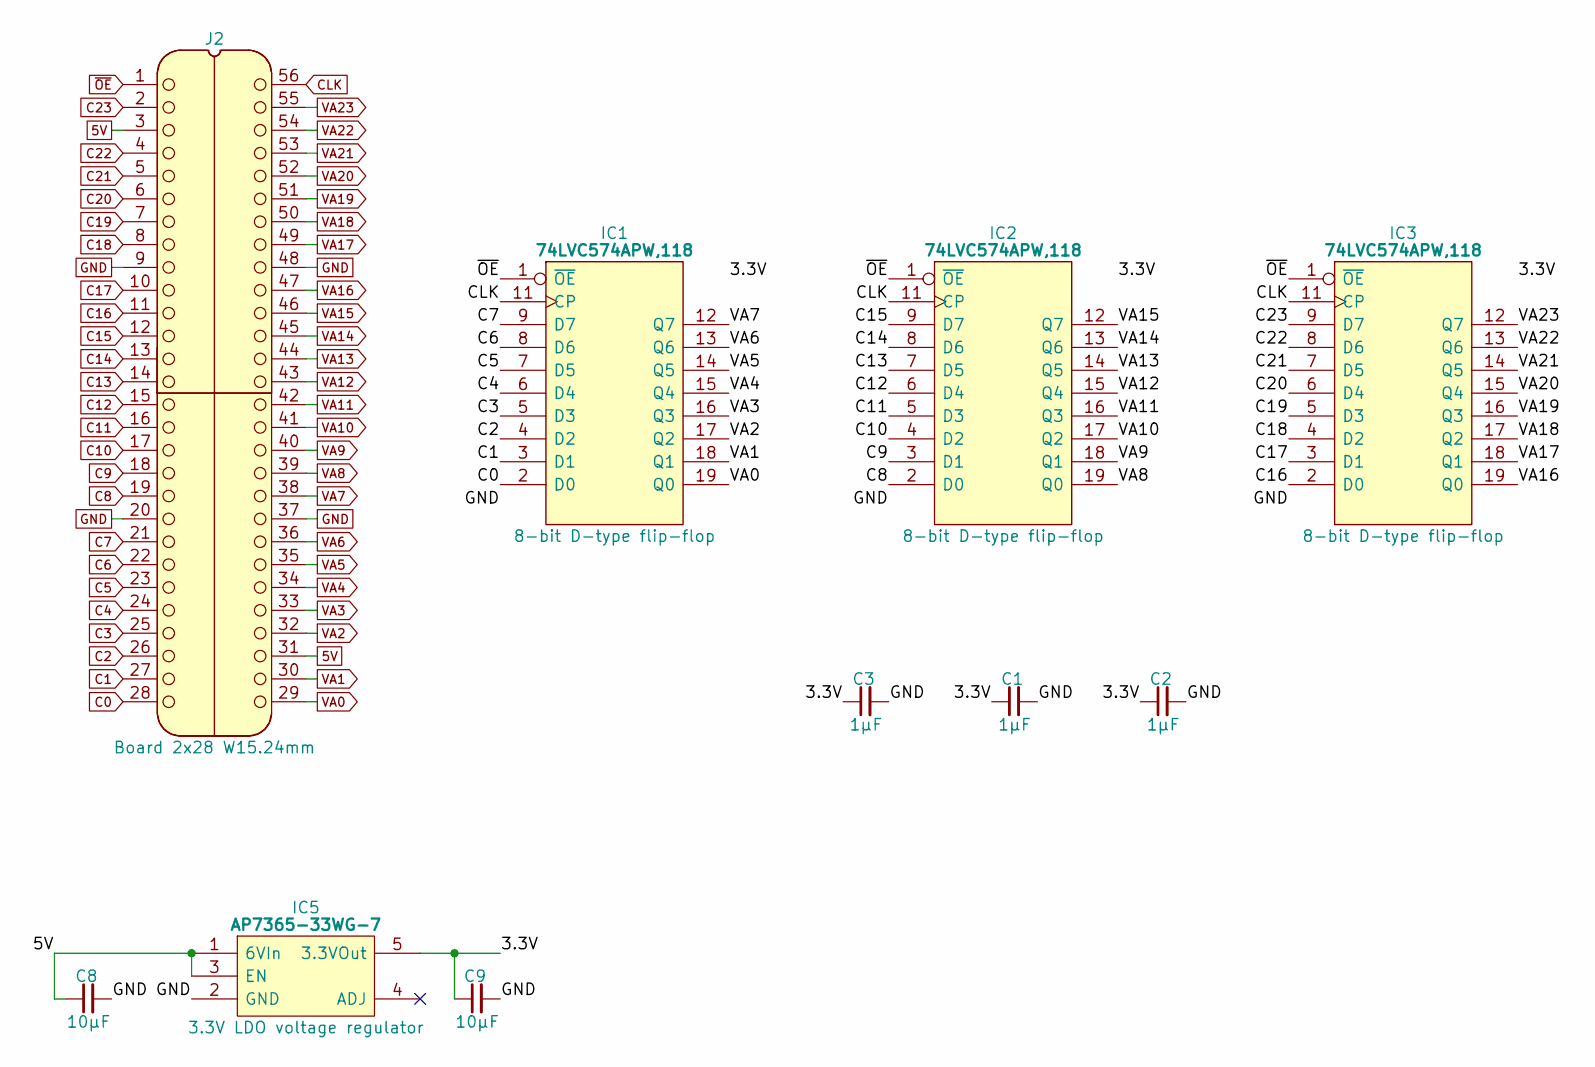
[picture p263: schematic D Flip Flop 24bit.kicad_sch]

Parts:
C1, C2, C3: 1μF; C_0805
C8, C9: 10µF; C_0805
IC1, IC2, IC3: 74LVC574APW,118; SOP65P640X110-20N; Manufacturer_Part_Number 74LVC574APW,118; Mouser Part Number 771-74LVC574APW-T
IC5: AP7365-33WG-7; SOT95P285X130-5N; Manufacturer_Part_Number AP7365-33WG-7; Mouser Part Number 621-AP7365-33WG-7
J2: Board 2x28 W15.24mm; DIP-56_Board_W15.24mm

Connections:
5V: C8.1, IC5.1 (6VIn), IC5.3 (EN), J2.3, J2.31
/3.3V: C1.1, C2.1, C3.1, C9.1, IC1.20 (3V), IC2.20 (3V), IC3.20 (3V), IC5.5 (3.3VOut)
C0: IC1.2 (D0), J2.28
C1: IC1.3 (D1), J2.27
C2: IC1.4 (D2), J2.26
C3: IC1.5 (D3), J2.25
C4: IC1.6 (D4), J2.24
C5: IC1.7 (D5), J2.23
C6: IC1.8 (D6), J2.22
C7: IC1.9 (D7), J2.21
C8: IC2.2 (D0), J2.19
C9: IC2.3 (D1), J2.18
C10: IC2.4 (D2), J2.17
C11: IC2.5 (D3), J2.16
C12: IC2.6 (D4), J2.15
C13: IC2.7 (D5), J2.14
C14: IC2.8 (D6), J2.13
C15: IC2.9 (D7), J2.12
C16: IC3.2 (D0), J2.11
C17: IC3.3 (D1), J2.10
C18: IC3.4 (D2), J2.8
C19: IC3.5 (D3), J2.7
C20: IC3.6 (D4), J2.6
C21: IC3.7 (D5), J2.5
C22: IC3.8 (D6), J2.4
C23: IC3.9 (D7), J2.2
CLK: IC1.11 (CP), IC2.11 (CP), IC3.11 (CP), J2.56
GND: C1.2, C2.2, C3.2, C8.2, C9.2, IC1.10 (GND), IC2.10 (GND), IC3.10 (GND), IC5.2 (GND), J2.9, J2.20, J2.37, J2.48
VA0: IC1.19 (Q0), J2.29
VA1: IC1.18 (Q1), J2.30
VA2: IC1.17 (Q2), J2.32
VA3: IC1.16 (Q3), J2.33
VA4: IC1.15 (Q4), J2.34
VA5: IC1.14 (Q5), J2.35
VA6: IC1.13 (Q6), J2.36
VA7: IC1.12 (Q7), J2.38
VA8: IC2.19 (Q0), J2.39
VA9: IC2.18 (Q1), J2.40
VA10: IC2.17 (Q2), J2.41
VA11: IC2.16 (Q3), J2.42
VA12: IC2.15 (Q4), J2.43
VA13: IC2.14 (Q5), J2.44
VA14: IC2.13 (Q6), J2.45
VA15: IC2.12 (Q7), J2.46
VA16: IC3.19 (Q0), J2.47
VA17: IC3.18 (Q1), J2.49
VA18: IC3.17 (Q2), J2.50
VA19: IC3.16 (Q3), J2.51
VA20: IC3.15 (Q4), J2.52
VA21: IC3.14 (Q5), J2.53
VA22: IC3.13 (Q6), J2.54
VA23: IC3.12 (Q7), J2.55
~OE: IC1.1 (~OE), IC2.1 (~OE), IC3.1 (~OE), J2.1

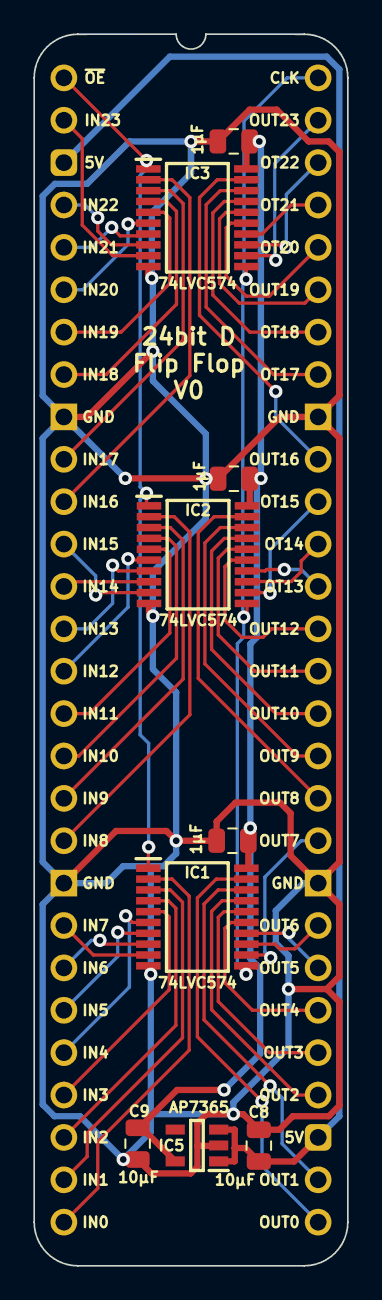
[picture p264: board D Flip Flop 24bit.kicad_pcb from above]

Board: 2 copper layers, 18.8 x 73.8 mm, 10 parts (0 on the bottom side), 53 nets.
