andrewpaterson/HCP65/Kicad/Computer/Component Boards/Register 8bit with IO/Register 8bit with IO.kicad_pcb

## KiCad design Kicad/Computer/Component Boards/Register 8bit with IO/Register 8bit with IO.kicad_pcb (2026-11-01)

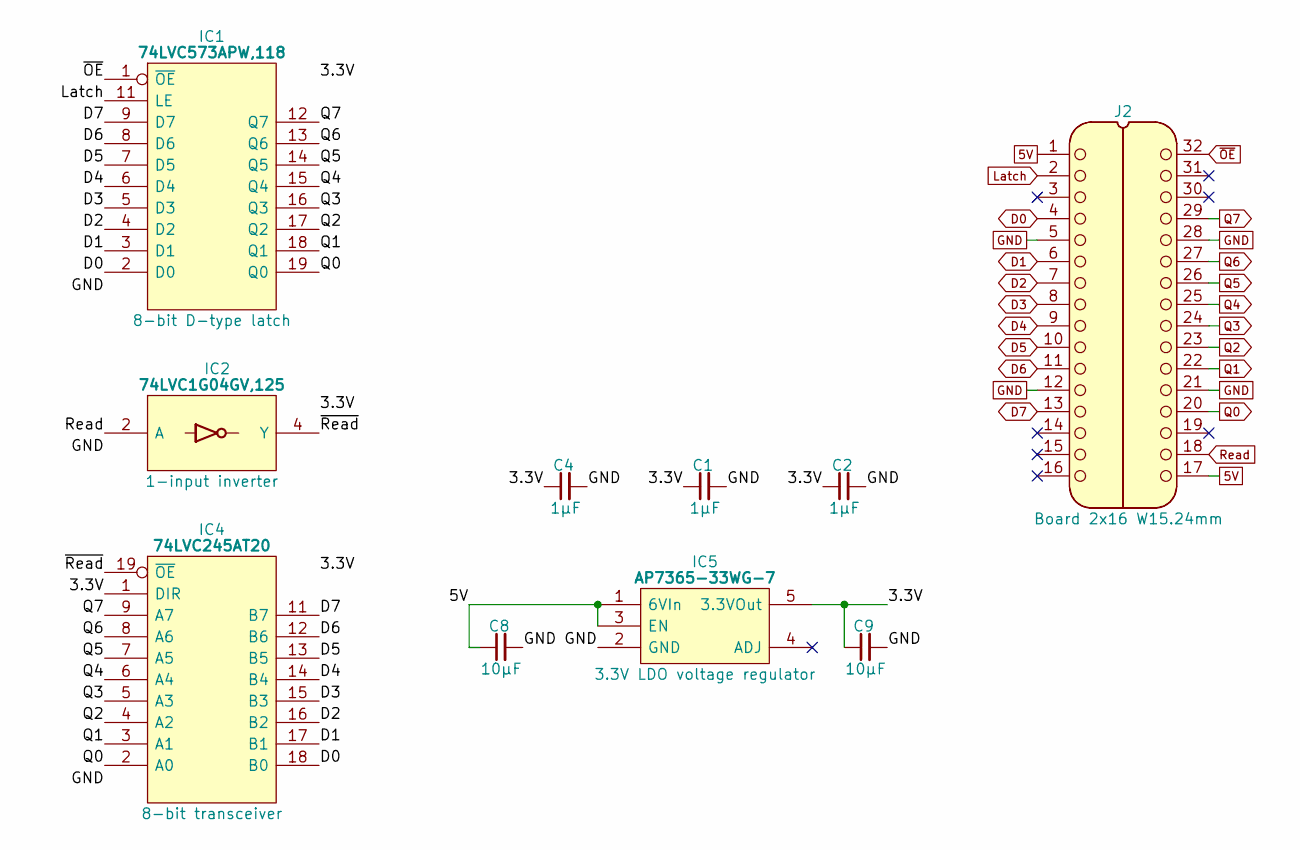
[picture p265: schematic Register 8bit with IO.kicad_sch]

Parts:
C1, C2, C4: 1μF; C_0805
C8, C9: 10µF; C_0805
IC1: 74LVC573APW,118; SOP65P640X110-20N; Manufacturer_Part_Number 74LVC573APW,118; Mouser Part Number 771-74LVC573APW-T
IC2: 74LVC1G04GV,125; SOT95P275X110-5N; Manufacturer_Part_Number 74LVC1G04GV,125; Mouser Part Number 771-74LVC1G04GV
IC4: 74LVC245AT20; SOP65P640X120-20N; Manufacturer_Part_Number 74LVC245AT20-13; Mouser Part Number 621-74LVC245AT20-13
IC5: AP7365-33WG-7; SOT95P285X130-5N; Manufacturer_Part_Number AP7365-33WG-7; Mouser Part Number 621-AP7365-33WG-7
J2: Board 2x16 W15.24mm; DIP-32_Board_W15.24mm

Connections:
5V: C8.1, IC5.1 (6VIn), IC5.3 (EN), J2.1, J2.17
/3.3V: C1.1, C2.1, C4.1, C9.1, IC1.20 (3V), IC2.5 (3V), IC4.1 (DIR), IC4.20 (3V), IC5.5 (3.3VOut)
/~Read: IC2.4 (Y), IC4.19 (~OE)
D0: IC1.2 (D0), IC4.18 (B0), J2.4
D1: IC1.3 (D1), IC4.17 (B1), J2.6
D2: IC1.4 (D2), IC4.16 (B2), J2.7
D3: IC1.5 (D3), IC4.15 (B3), J2.8
D4: IC1.6 (D4), IC4.14 (B4), J2.9
D5: IC1.7 (D5), IC4.13 (B5), J2.10
D6: IC1.8 (D6), IC4.12 (B6), J2.11
D7: IC1.9 (D7), IC4.11 (B7), J2.13
GND: C1.2, C2.2, C4.2, C8.2, C9.2, IC1.10 (GND), IC2.3 (GND), IC4.10 (GND), IC5.2 (GND), J2.5, J2.12, J2.21, J2.28
Latch: IC1.11 (LE), J2.2
Q0: IC1.19 (Q0), IC4.2 (A0), J2.20
Q1: IC1.18 (Q1), IC4.3 (A1), J2.22
Q2: IC1.17 (Q2), IC4.4 (A2), J2.23
Q3: IC1.16 (Q3), IC4.5 (A3), J2.24
Q4: IC1.15 (Q4), IC4.6 (A4), J2.25
Q5: IC1.14 (Q5), IC4.7 (A5), J2.26
Q6: IC1.13 (Q6), IC4.8 (A6), J2.27
Q7: IC1.12 (Q7), IC4.9 (A7), J2.29
Read: IC2.2 (A), J2.18
~OE: IC1.1 (~OE), J2.32

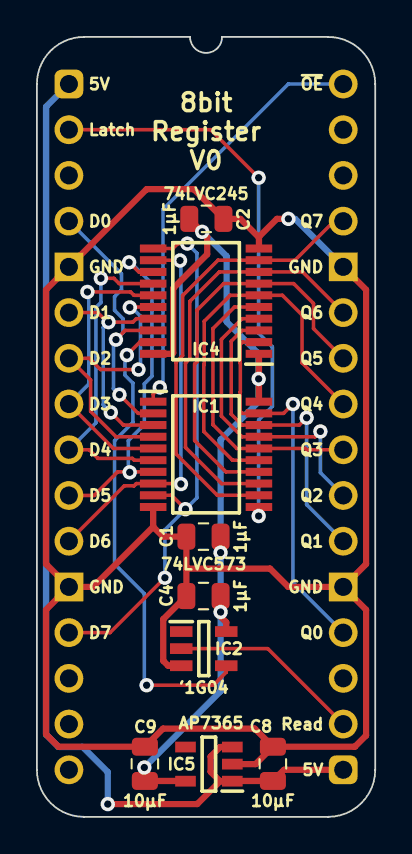
[picture p266: board Register 8bit with IO.kicad_pcb from above]

Board: 2 copper layers, 18.8 x 43.3 mm, 10 parts (0 on the bottom side), 23 nets.
