andrewpaterson/HCP65/Kicad/Computer/Component Boards/Flags Enable Interrupt/Flags Enable Interrupt.kicad_pcb

## KiCad design Kicad/Computer/Component Boards/Flags Enable Interrupt/Flags Enable Interrupt.kicad_pcb (2026-11-01)

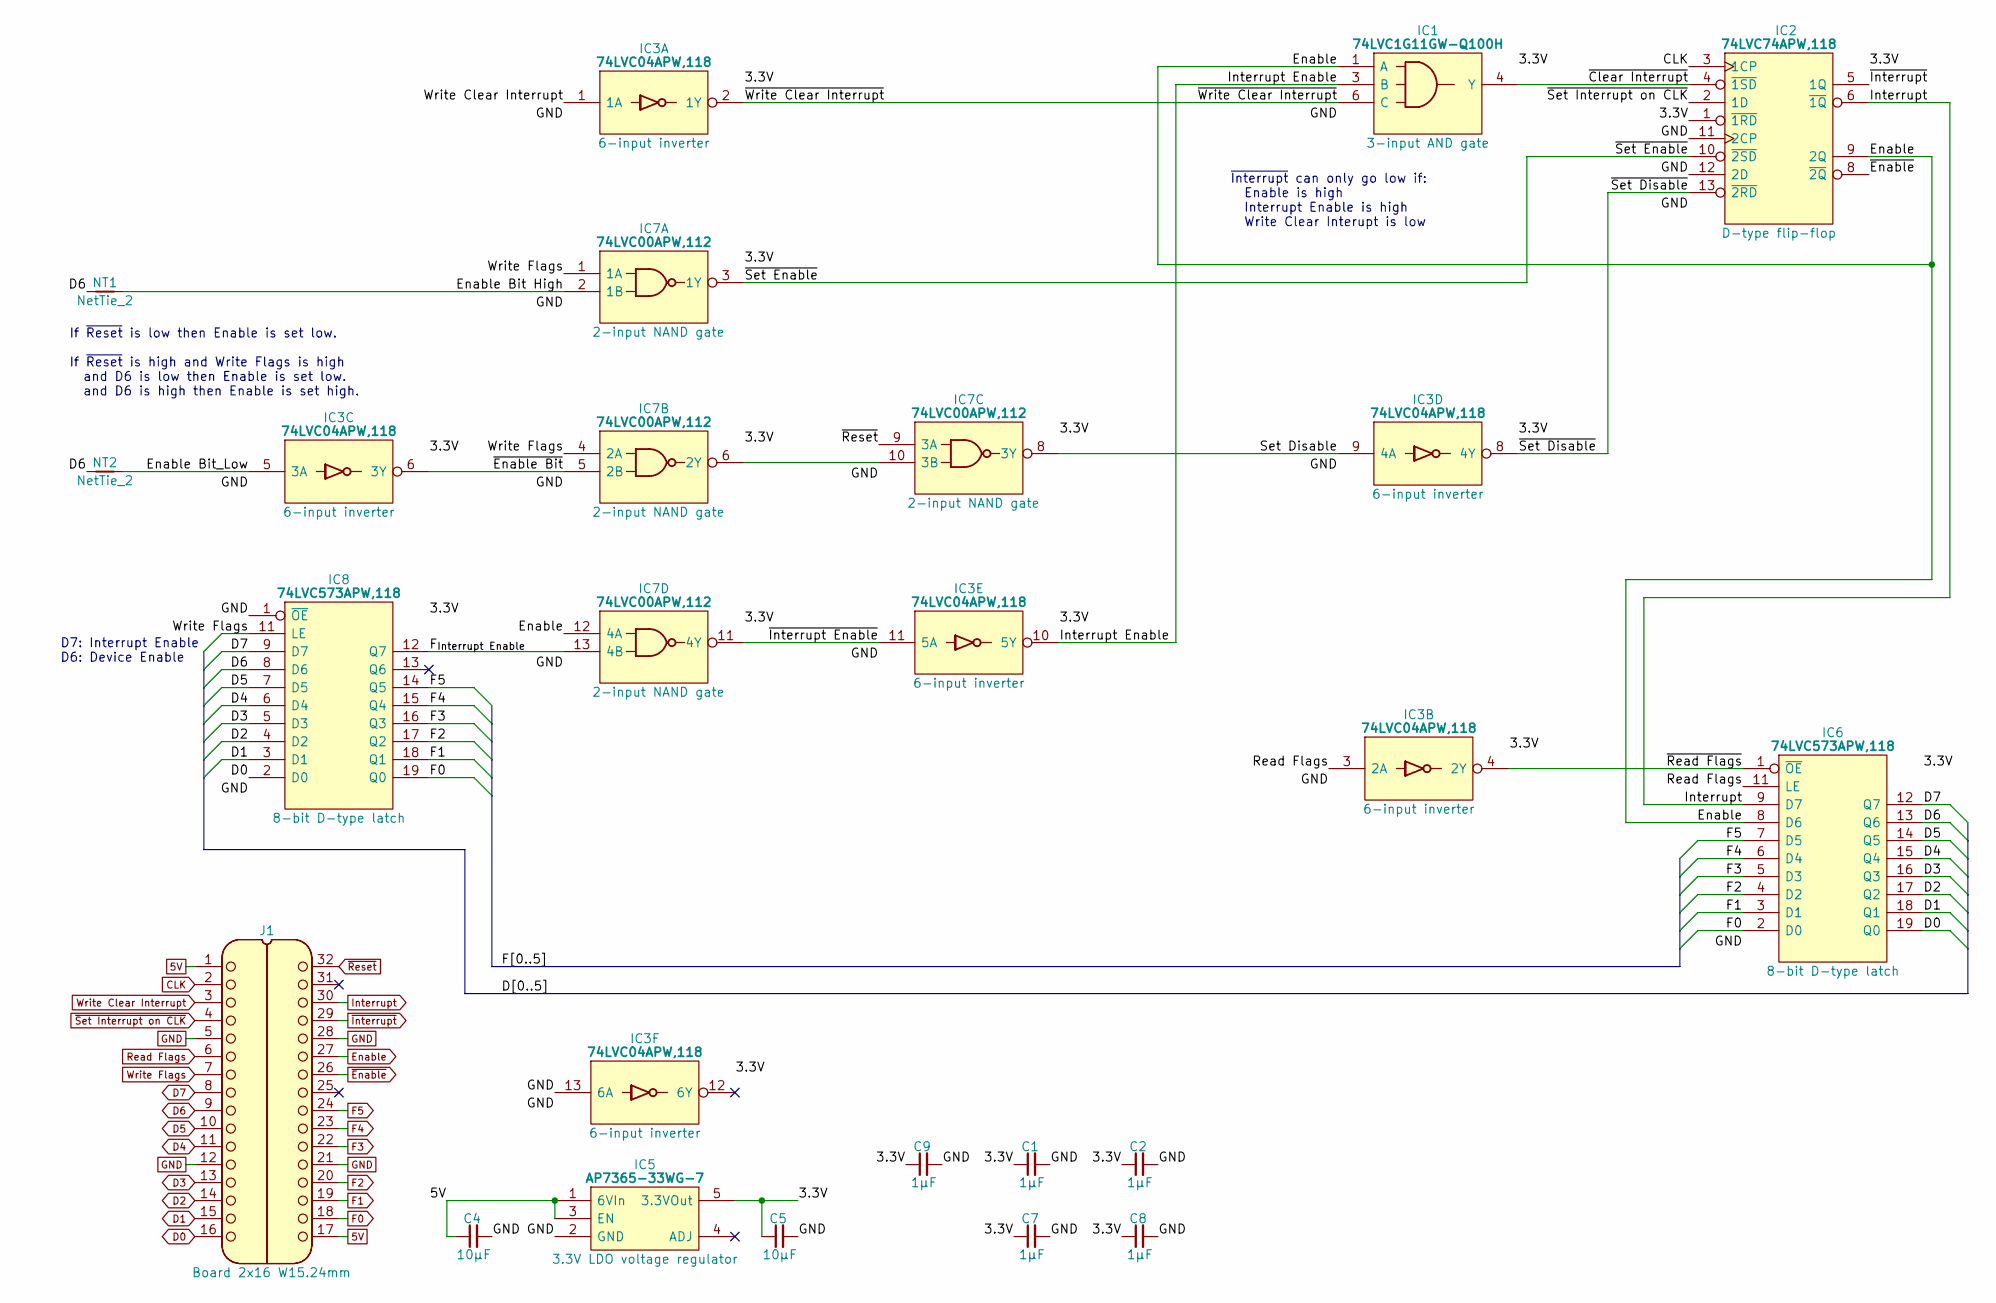
[picture p267: schematic Flags Enable Interrupt.kicad_sch, Flags, Enable and Interrupt]

Parts:
C1, C2, C7, C8, C9: 1μF; C_0805
C4, C5: 10µF; C_0805
IC1: 74LVC1G11GW-Q100H; SOP65P210X110-6N; Manufacturer_Part_Number 74LVC1G11GW-Q100H; Mouser Part Number 771-74LVC1G11GWQ100H
IC2: 74LVC74APW,118; SOP65P640X110-14N; Mouser Part Number 771-74LVC74APW-T
IC3: 74LVC04APW,118; SOP65P640X110-14N; Manufacturer_Part_Number 74LVC04APW,118; Mouser Part Number 771-74LVC04APW-T
IC5: AP7365-33WG-7; SOT95P285X130-5N; Manufacturer_Part_Number AP7365-33WG-7; Mouser Part Number 621-AP7365-33WG-7
IC6, IC8: 74LVC573APW,118; SOP65P640X110-20N; Mouser Part Number 771-74LVC573APW-T
IC7: 74LVC00APW,112; SOP65P640X110-14N; Mouser Part Number 771-74LVC00APW
J1: Board 2x16 W15.24mm; DIP-32_Board_W15.24mm
NT1, NT2: NetTie_2; NetTie-2_SMD_Pad0.5mm

Connections:
5V: C4.1, IC5.1 (6VIn), IC5.3 (EN), J1.1, J1.17
/3.3V: C1.1, C2.1, C5.1, C7.1, C8.1, C9.1, IC1.5 (3V), IC2.1 (~1RD), IC2.14 (3V), IC3.14 (3V), IC5.5 (3.3VOut), IC6.20 (3V), IC7.14 (3V), IC8.20 (3V)
/Enable Bit High: IC7.2 (1B), NT1.2
/Enable Bit_Low: IC3.5 (3A), NT2.2
/F_{Interrupt Enable}: IC7.13 (4B), IC8.12 (Q7)
/Interrupt Enable: IC1.3 (B), IC3.10 (5Y)
/Set Disable: IC3.9 (4A), IC7.8 (3Y)
/~Clear Interrupt: IC1.4 (Y), IC2.4 (~1SD)
/~Enable Bit: IC3.6 (3Y), IC7.5 (2B)
/~Interrupt Enable: IC3.11 (5A), IC7.11 (4Y)
/~Read Flags: IC3.4 (2Y), IC6.1 (~OE)
/~Set Disable: IC2.13 (~2RD), IC3.8 (4Y)
/~Set Enable: IC2.10 (~2SD), IC7.3 (1Y)
/~Write Clear Interrupt: IC1.6 (C), IC3.2 (1Y)
CLK: IC2.3 (1CP), J1.2
D0: IC6.19 (Q0), IC8.2 (D0), J1.16
D1: IC6.18 (Q1), IC8.3 (D1), J1.15
D2: IC6.17 (Q2), IC8.4 (D2), J1.14
D3: IC6.16 (Q3), IC8.5 (D3), J1.13
D4: IC6.15 (Q4), IC8.6 (D4), J1.11
D5: IC6.14 (Q5), IC8.7 (D5), J1.10
D6: IC6.13 (Q6), IC8.8 (D6), J1.9, NT1.1, NT2.1
D7: IC6.12 (Q7), IC8.9 (D7), J1.8
Enable: IC1.1 (A), IC2.9 (2Q), IC6.8 (D6), IC7.12 (4A), J1.27
F0: IC6.2 (D0), IC8.19 (Q0), J1.18
F1: IC6.3 (D1), IC8.18 (Q1), J1.19
F2: IC6.4 (D2), IC8.17 (Q2), J1.20
F3: IC6.5 (D3), IC8.16 (Q3), J1.22
F4: IC6.6 (D4), IC8.15 (Q4), J1.23
F5: IC6.7 (D5), IC8.14 (Q5), J1.24
GND: C1.2, C2.2, C4.2, C5.2, C7.2, C8.2, C9.2, IC1.2 (GND), IC2.7 (GND), IC2.11 (2CP), IC2.12 (2D), IC3.7 (GND), IC3.13 (6A), IC5.2 (GND), IC6.10 (GND), IC7.7 (GND), IC8.1 (~OE), IC8.10 (GND), J1.5, J1.12, J1.21, J1.28
Interrupt: IC2.6 (~1Q), IC6.9 (D7), J1.30
unnamed: IC7.6 (2Y), IC7.10 (3B)
Read Flags: IC3.3 (2A), IC6.11 (LE), J1.6
Write Clear Interrupt: IC3.1 (1A), J1.3
Write Flags: IC7.1 (1A), IC7.4 (2A), IC8.11 (LE), J1.7
~Enable: IC2.8 (~2Q), J1.26
~Interrupt: IC2.5 (1Q), J1.29
~Reset: IC7.9 (3A), J1.32
~Set Interrupt on CLK: IC2.2 (1D), J1.4

Notes on the sheet:
If ~{Reset} is low then Enable is set low. If ~{Reset} is high and Write Flags is high and D6 is low then Enable is set low. and D6 is high then Enable is set high.
~{Interrupt} can only go low if: Enable is high Interrupt Enable is high Write Clear Interupt is low
D7: Interrupt Enable D6: Device Enable

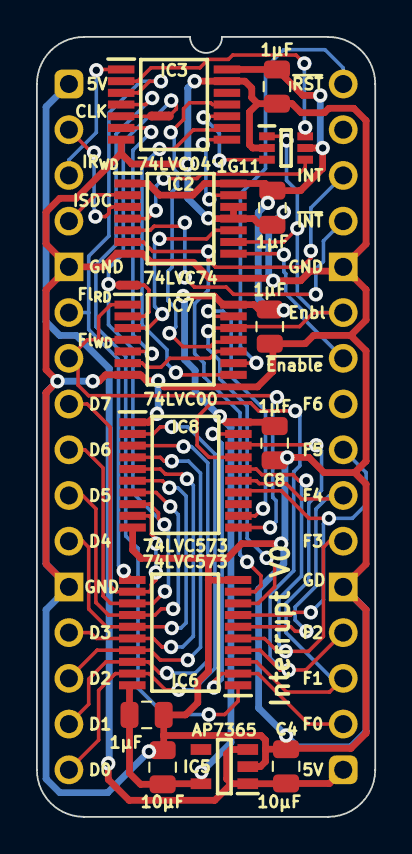
[picture p268: board Flags Enable Interrupt.kicad_pcb from above]

Board: 2 copper layers, 18.8 x 43.3 mm, 17 parts (0 on the bottom side), 40 nets.
