andrewpaterson/HCP65/Kicad/Pico/HCP65 Board Tester/HCP65 Board Tester.kicad_pcb

## KiCad design Kicad/Pico/HCP65 Board Tester/HCP65 Board Tester.kicad_pcb (2026-11-01)

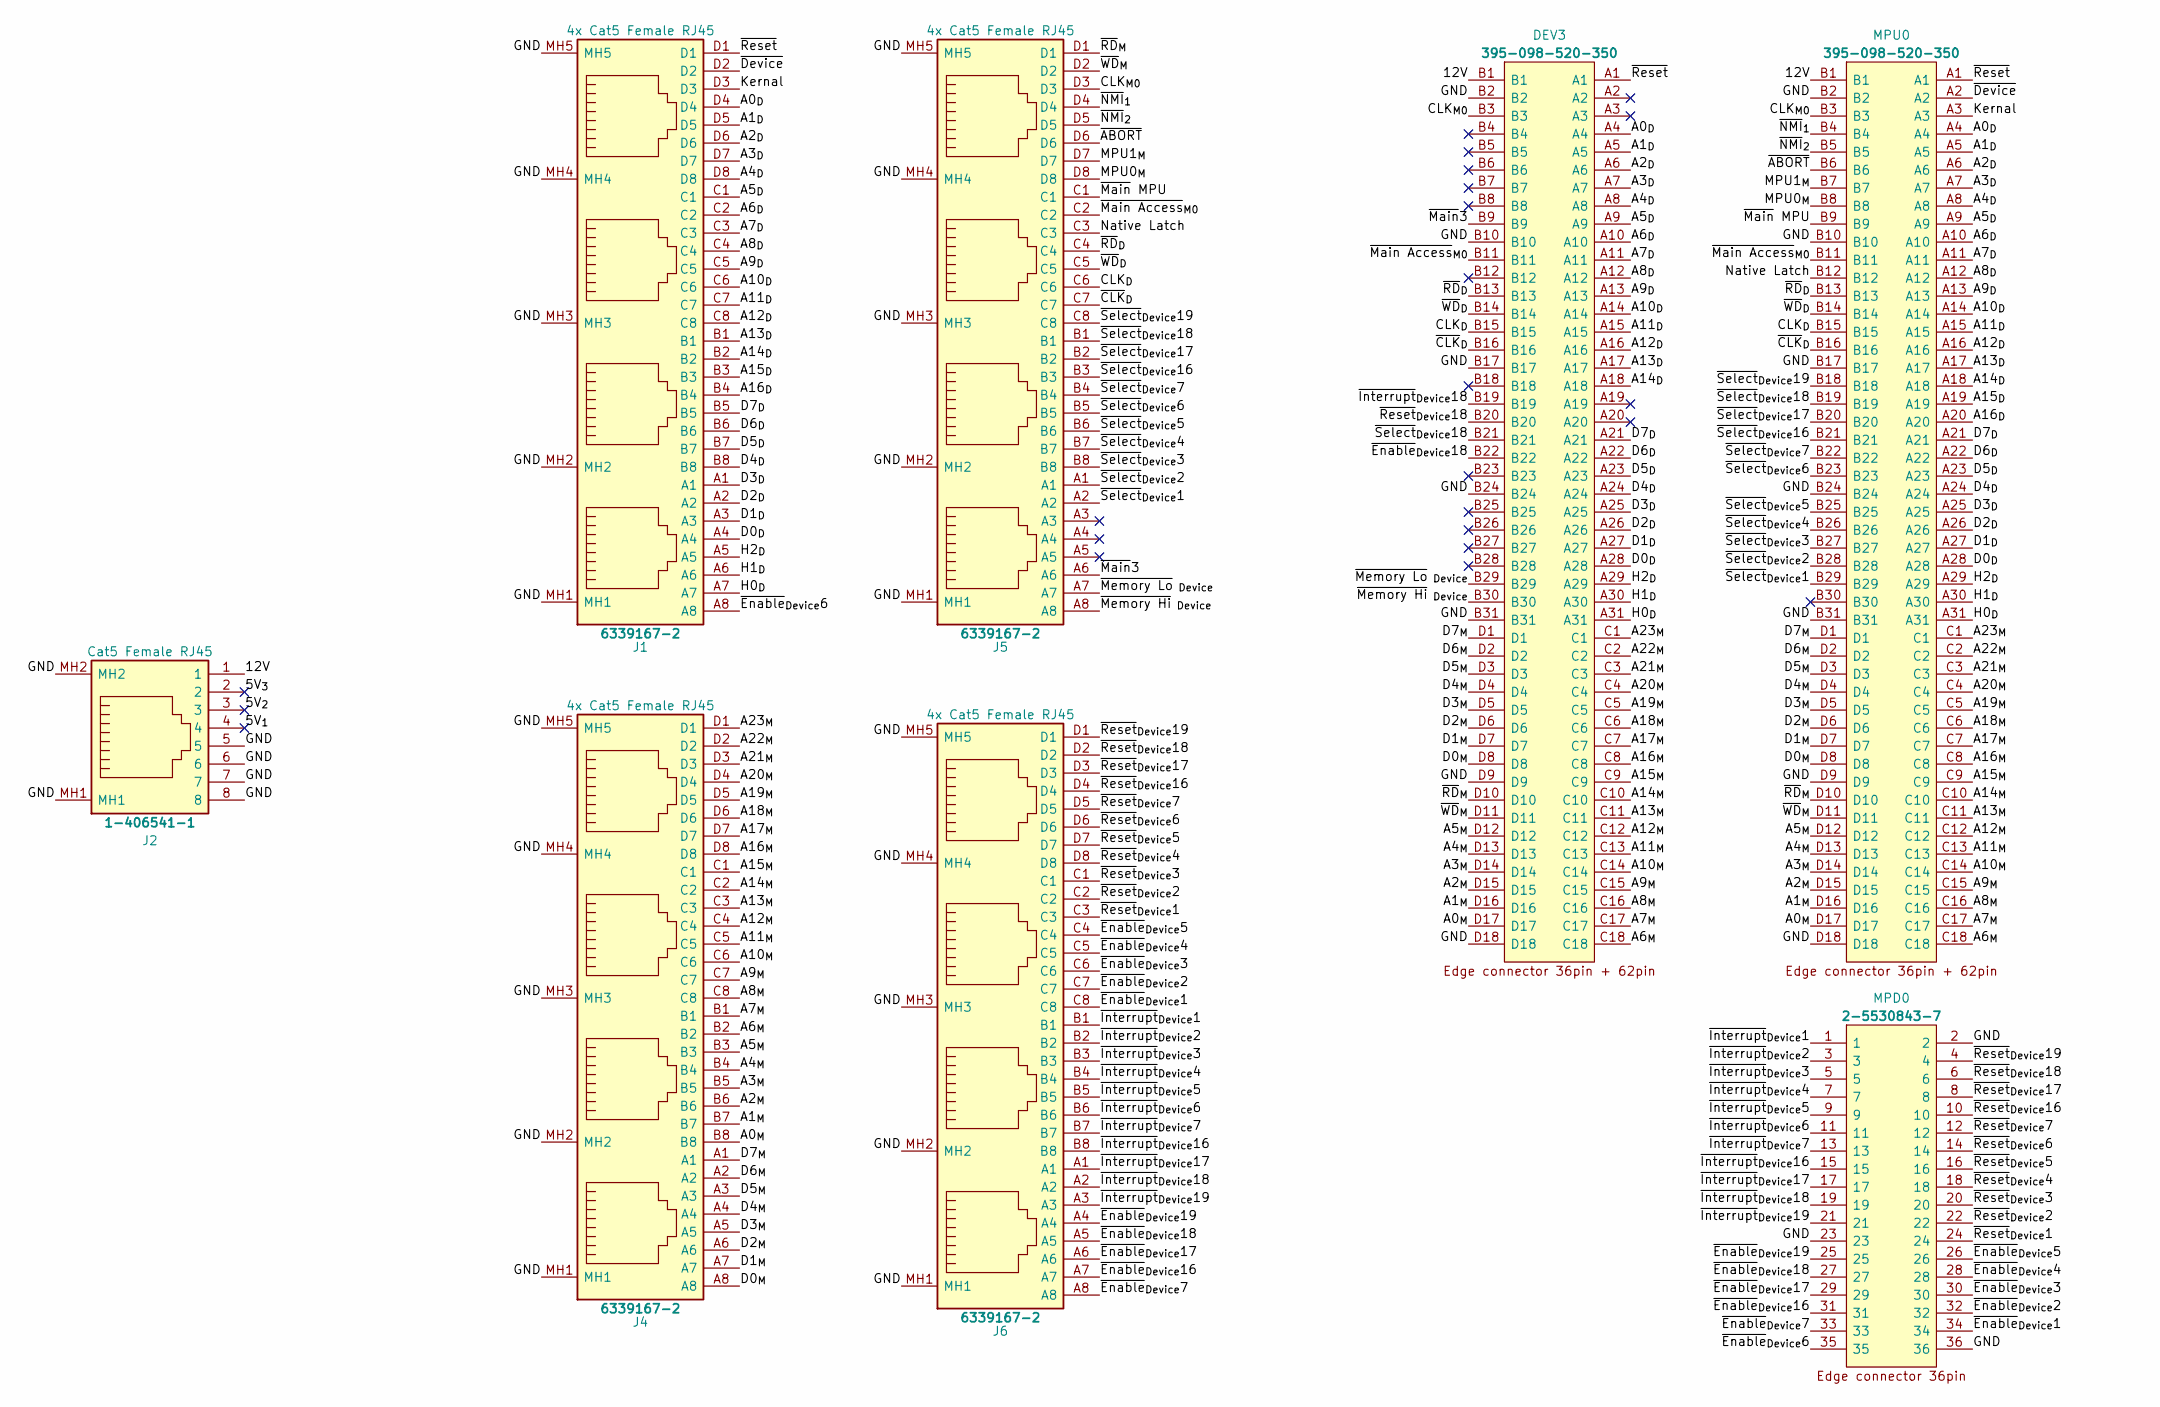
[picture p269: schematic HCP65 Board Tester.kicad_sch]

Parts:
DEV3: 395-098-520-350; 395098520350; Manufacturer_Part_Number 395-098-520-350; Mouser Part Number 587-395-098-520-350
J1, J4, J5, J6: 6339167-2; 63391672; Manufacturer_Part_Number 6339167-2; Mouser Part Number 571-6339167-2
J2: 1-406541-1; 1-406541-1_1; Manufacturer_Part_Number 1-406541-1; Mouser Part Number 571-1-406541-1
MPD0: 2-5530843-7; 255308437; Manufacturer_Part_Number 2-5530843-7; Mouser Part Number 571-2-5530843-7
MPU0: 395-098-520-350; 395098520350; Manufacturer_Part_Number 395-098-520-350; Mouser Part Number 587-395-098-520-350

Connections:
/5V_{1}: J2.4
/5V_{2}: J2.3
/5V_{3}: J2.2
/12V: DEV3.B1, J2.1, MPU0.B1
/A0_{D}: DEV3.A4, J1.D4, MPU0.A4
/A0_{M}: DEV3.D17, J4.B8, MPU0.D17
/A1_{D}: DEV3.A5, J1.D5, MPU0.A5
/A1_{M}: DEV3.D16, J4.B7, MPU0.D16
/A2_{D}: DEV3.A6, J1.D6, MPU0.A6
/A2_{M}: DEV3.D15, J4.B6, MPU0.D15
/A3_{D}: DEV3.A7, J1.D7, MPU0.A7
/A3_{M}: DEV3.D14, J4.B5, MPU0.D14
/A4_{D}: DEV3.A8, J1.D8, MPU0.A8
/A4_{M}: DEV3.D13, J4.B4, MPU0.D13
/A5_{D}: DEV3.A9, J1.C1, MPU0.A9
/A5_{M}: DEV3.D12, J4.B3, MPU0.D12
/A6_{D}: DEV3.A10, J1.C2, MPU0.A10
/A6_{M}: DEV3.C18, J4.B2, MPU0.C18
/A7_{D}: DEV3.A11, J1.C3, MPU0.A11
/A7_{M}: DEV3.C17, J4.B1, MPU0.C17
/A8_{D}: DEV3.A12, J1.C4, MPU0.A12
/A8_{M}: DEV3.C16, J4.C8, MPU0.C16
/A9_{D}: DEV3.A13, J1.C5, MPU0.A13
/A9_{M}: DEV3.C15, J4.C7, MPU0.C15
/A10_{D}: DEV3.A14, J1.C6, MPU0.A14
/A10_{M}: DEV3.C14, J4.C6, MPU0.C14
/A11_{D}: DEV3.A15, J1.C7, MPU0.A15
/A11_{M}: DEV3.C13, J4.C5, MPU0.C13
/A12_{D}: DEV3.A16, J1.C8, MPU0.A16
/A12_{M}: DEV3.C12, J4.C4, MPU0.C12
/A13_{D}: DEV3.A17, J1.B1, MPU0.A17
/A13_{M}: DEV3.C11, J4.C3, MPU0.C11
/A14_{D}: DEV3.A18, J1.B2, MPU0.A18
/A14_{M}: DEV3.C10, J4.C2, MPU0.C10
/A15_{D}: J1.B3, MPU0.A19
/A15_{M}: DEV3.C9, J4.C1, MPU0.C9
/A16_{D}: J1.B4, MPU0.A20
/A16_{M}: DEV3.C8, J4.D8, MPU0.C8
/A17_{M}: DEV3.C7, J4.D7, MPU0.C7
/A18_{M}: DEV3.C6, J4.D6, MPU0.C6
/A19_{M}: DEV3.C5, J4.D5, MPU0.C5
/A20_{M}: DEV3.C4, J4.D4, MPU0.C4
/A21_{M}: DEV3.C3, J4.D3, MPU0.C3
/A22_{M}: DEV3.C2, J4.D2, MPU0.C2
/A23_{M}: DEV3.C1, J4.D1, MPU0.C1
/CLK_{D}: DEV3.B15, J5.C6, MPU0.B15
/CLK_{M0}: DEV3.B3, J5.D3, MPU0.B3
/D0_{D}: DEV3.A28, J1.A4, MPU0.A28
/D0_{M}: DEV3.D8, J4.A8, MPU0.D8
/D1_{D}: DEV3.A27, J1.A3, MPU0.A27
/D1_{M}: DEV3.D7, J4.A7, MPU0.D7
/D2_{D}: DEV3.A26, J1.A2, MPU0.A26
/D2_{M}: DEV3.D6, J4.A6, MPU0.D6
/D3_{D}: DEV3.A25, J1.A1, MPU0.A25
/D3_{M}: DEV3.D5, J4.A5, MPU0.D5
/D4_{D}: DEV3.A24, J1.B8, MPU0.A24
/D4_{M}: DEV3.D4, J4.A4, MPU0.D4
/D5_{D}: DEV3.A23, J1.B7, MPU0.A23
/D5_{M}: DEV3.D3, J4.A3, MPU0.D3
/D6_{D}: DEV3.A22, J1.B6, MPU0.A22
/D6_{M}: DEV3.D2, J4.A2, MPU0.D2
/D7_{D}: DEV3.A21, J1.B5, MPU0.A21
/D7_{M}: DEV3.D1, J4.A1, MPU0.D1
/GND: DEV3.B2, DEV3.B10, DEV3.B17, DEV3.B24, DEV3.B31, DEV3.D9, DEV3.D18, J1.MH1, J1.MH2, J1.MH3, J1.MH4, J1.MH5, J2.5, J2.6, J2.7, J2.8, J2.MH1, J2.MH2, J4.MH1, J4.MH2, J4.MH3, J4.MH4, J4.MH5, J5.MH1, J5.MH2, J5.MH3, J5.MH4, J5.MH5, J6.MH1, J6.MH2, J6.MH3, J6.MH4, J6.MH5, MPD0.2, MPD0.23, MPD0.36, MPU0.B2, MPU0.B10, MPU0.B17, MPU0.B24, MPU0.B31, MPU0.D9, MPU0.D18
/H0_{D}: DEV3.A31, J1.A7, MPU0.A31
/H1_{D}: DEV3.A30, J1.A6, MPU0.A30
/H2_{D}: DEV3.A29, J1.A5, MPU0.A29
/Kernal: J1.D3, MPU0.A3
/MPU0_{M}: J5.D8, MPU0.B8
/MPU1_{M}: J5.D7, MPU0.B7
/Native Latch: J5.C3, MPU0.B12
/~ABORT: J5.D6, MPU0.B6
/~CLK_{D}: DEV3.B16, J5.C7, MPU0.B16
/~Device: J1.D2, MPU0.A2
/~Enable_{Device}1: J6.C8, MPD0.34
/~Enable_{Device}2: J6.C7, MPD0.32
/~Enable_{Device}3: J6.C6, MPD0.30
/~Enable_{Device}4: J6.C5, MPD0.28
/~Enable_{Device}5: J6.C4, MPD0.26
/~Enable_{Device}6: J1.A8, MPD0.35
/~Enable_{Device}7: J6.A8, MPD0.33
/~Enable_{Device}16: J6.A7, MPD0.31
/~Enable_{Device}17: J6.A6, MPD0.29
/~Enable_{Device}18: DEV3.B22, J6.A5, MPD0.27
/~Enable_{Device}19: J6.A4, MPD0.25
/~Interrupt_{Device}1: J6.B1, MPD0.1
/~Interrupt_{Device}2: J6.B2, MPD0.3
/~Interrupt_{Device}3: J6.B3, MPD0.5
/~Interrupt_{Device}4: J6.B4, MPD0.7
/~Interrupt_{Device}5: J6.B5, MPD0.9
/~Interrupt_{Device}6: J6.B6, MPD0.11
/~Interrupt_{Device}7: J6.B7, MPD0.13
/~Interrupt_{Device}16: J6.B8, MPD0.15
/~Interrupt_{Device}17: J6.A1, MPD0.17
/~Interrupt_{Device}18: DEV3.B19, J6.A2, MPD0.19
/~Interrupt_{Device}19: J6.A3, MPD0.21
/~Main Access_{M0}: DEV3.B11, J5.C2, MPU0.B11
/~Main3: DEV3.B9, J5.A6
/~Main MPU: J5.C1, MPU0.B9
/~Memory Hi_{ Device}: DEV3.B30, J5.A8
/~Memory Lo_{ Device}: DEV3.B29, J5.A7
/~NMI_{1}: J5.D4, MPU0.B4
/~NMI_{2}: J5.D5, MPU0.B5
/~RD_{D}: DEV3.B13, J5.C4, MPU0.B13
/~RD_{M}: DEV3.D10, J5.D1, MPU0.D10
/~Reset: DEV3.A1, J1.D1, MPU0.A1
/~Reset_{Device}1: J6.C3, MPD0.24
/~Reset_{Device}2: J6.C2, MPD0.22
/~Reset_{Device}3: J6.C1, MPD0.20
/~Reset_{Device}4: J6.D8, MPD0.18
/~Reset_{Device}5: J6.D7, MPD0.16
/~Reset_{Device}6: J6.D6, MPD0.14
/~Reset_{Device}7: J6.D5, MPD0.12
/~Reset_{Device}16: J6.D4, MPD0.10
/~Reset_{Device}17: J6.D3, MPD0.8
/~Reset_{Device}18: DEV3.B20, J6.D2, MPD0.6
/~Reset_{Device}19: J6.D1, MPD0.4
/~Select_{Device}1: J5.A2, MPU0.B29
/~Select_{Device}2: J5.A1, MPU0.B28
/~Select_{Device}3: J5.B8, MPU0.B27
/~Select_{Device}4: J5.B7, MPU0.B26
/~Select_{Device}5: J5.B6, MPU0.B25
/~Select_{Device}6: J5.B5, MPU0.B23
/~Select_{Device}7: J5.B4, MPU0.B22
/~Select_{Device}16: J5.B3, MPU0.B21
/~Select_{Device}17: J5.B2, MPU0.B20
/~Select_{Device}18: DEV3.B21, J5.B1, MPU0.B19
/~Select_{Device}19: J5.C8, MPU0.B18
/~WD_{D}: DEV3.B14, J5.C5, MPU0.B14
/~WD_{M}: DEV3.D11, J5.D2, MPU0.D11

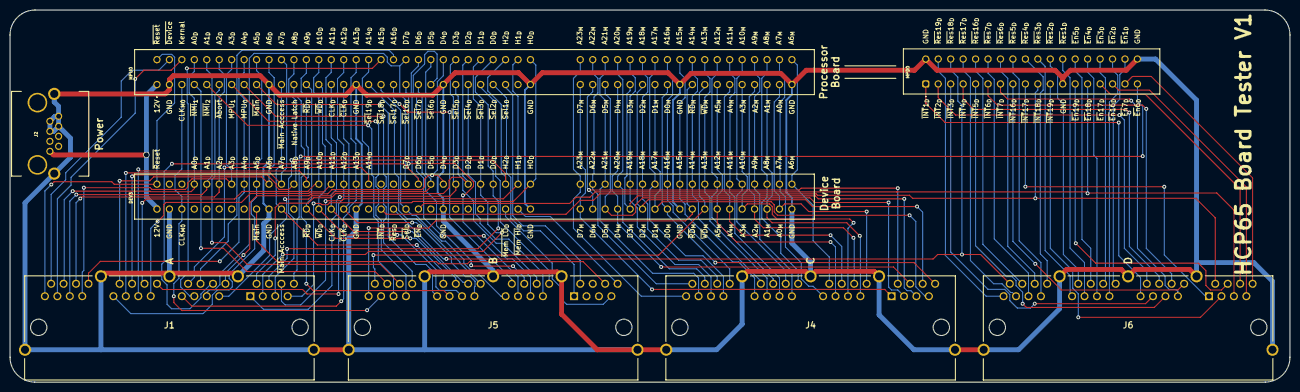
[picture p270: board HCP65 Board Tester.kicad_pcb from above]

Board: 2 copper layers, 261.1 x 75.9 mm, 8 parts (0 on the bottom side), 127 nets.
