andrewpaterson/HCP65/Kicad/Keypad/Keypad.kicad_sch

## KiCad design Kicad/Keypad/Keypad.kicad_sch (2026-11-01)

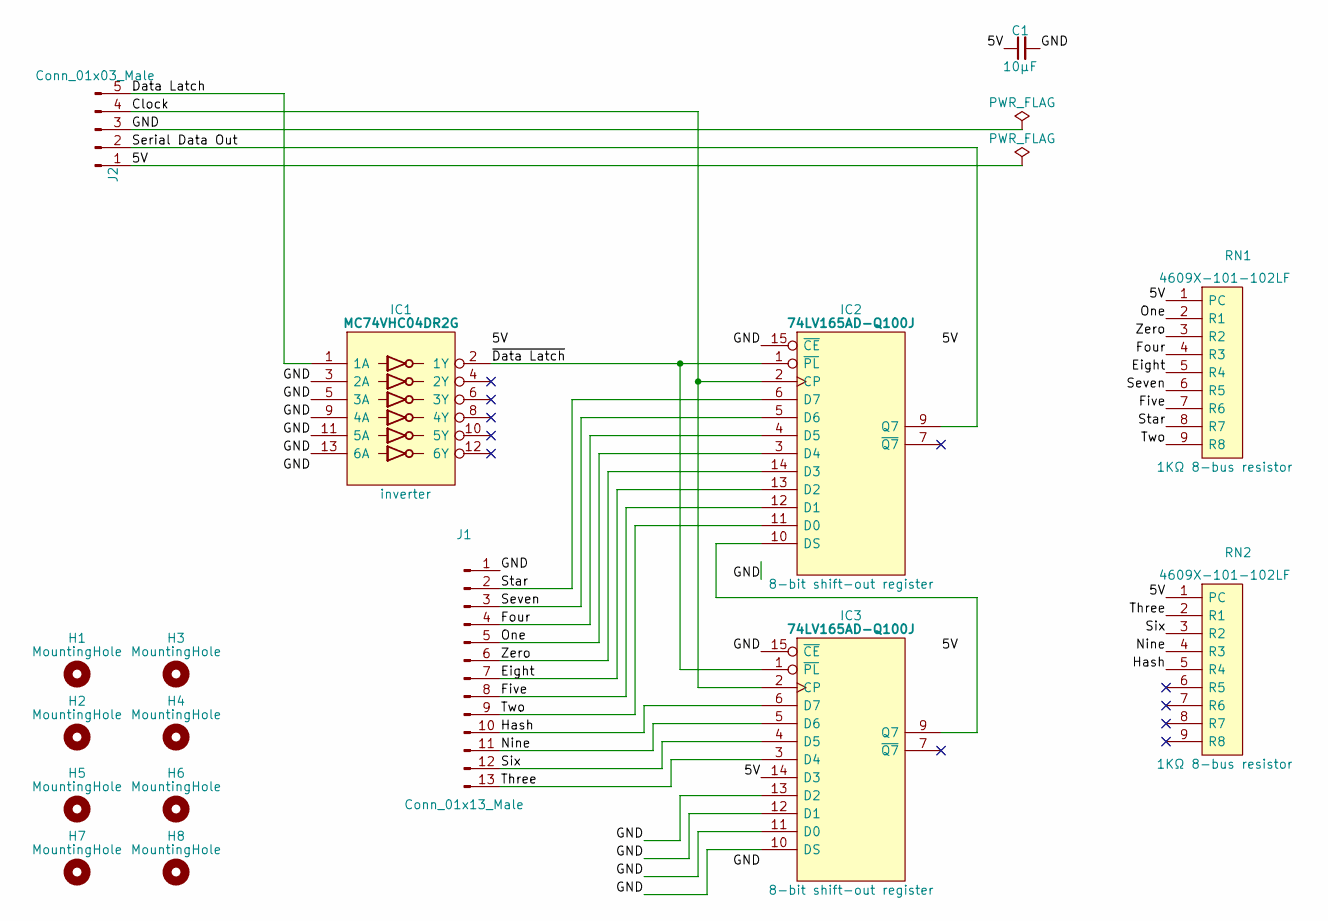
[picture p271: schematic Keypad.kicad_sch]

Parts:
C1: 10μF; C_0805
H1, H2, H3, H4: MountingHole; MountingHole_2.5mm
H5, H6, H7, H8: MountingHole; MountingHole_2mm
IC1: MC74VHC04DR2G; SOIC127P600X175-14N; Manufacturer_Part_Number MC74VHC04DR2G; Mouser Part Number 863-MC74VHC04DR2G
IC2, IC3: 74LV165AD-Q100J; SOIC127P600X175-16N; Mouser Part Number 771-74LV165ADQ100J
J1: Conn_01x13_Male; PinHeader_1x13_P2.54mm_Vertical
J2: Conn_01x03_Male; PinHeader_1x05_P2.54mm_Vertical
RN1, RN2: 4609X-101-102LF; 4609X; Manufacturer_Part_Number 4609X-101-102LF; Mouser Part Number 652-4609X-1LF-1K

Connections:
5V: C1.1, IC1.14 (5V), IC2.16 (VCC), IC3.14 (D3), IC3.16 (VCC), J2.1, RN1.1 (PC), RN2.1 (PC)
Clock: IC2.2 (CP), IC3.2 (CP), J2.4
Data Latch: IC1.1 (1A), J2.5
Eight: IC2.13 (D2), J1.7, RN1.5 (R4)
Five: IC2.12 (D1), J1.8, RN1.7 (R6)
Four: IC2.4 (D5), J1.4, RN1.4 (R3)
GND: C1.2, IC1.3 (2A), IC1.5 (3A), IC1.7 (GND), IC1.9 (4A), IC1.11 (5A), IC1.13 (6A), IC2.8 (GND), IC2.15 (~CE), IC3.8 (GND), IC3.10 (DS), IC3.11 (D0), IC3.12 (D1), IC3.13 (D2), IC3.15 (~CE), J1.1, J2.3
Hash: IC3.6 (D7), J1.10, RN2.5 (R4)
unnamed: IC2.10 (DS), IC3.9 (Q7)
Nine: IC3.5 (D6), J1.11, RN2.4 (R3)
One: IC2.3 (D4), J1.5, RN1.2 (R1)
Serial Data Out: IC2.9 (Q7), J2.2
Seven: IC2.5 (D6), J1.3, RN1.6 (R5)
Six: IC3.4 (D5), J1.12, RN2.3 (R2)
Star: IC2.6 (D7), J1.2, RN1.8 (R7)
Three: IC3.3 (D4), J1.13, RN2.2 (R1)
Two: IC2.11 (D0), J1.9, RN1.9 (R8)
Zero: IC2.14 (D3), J1.6, RN1.3 (R2)
~Data Latch: IC1.2 (1Y), IC2.1 (~PL), IC3.1 (~PL)
