andrewpaterson/HCP65/Kicad/Speed/Speed.kicad_sch

## KiCad design Kicad/Speed/Speed.kicad_sch (2026-11-01)

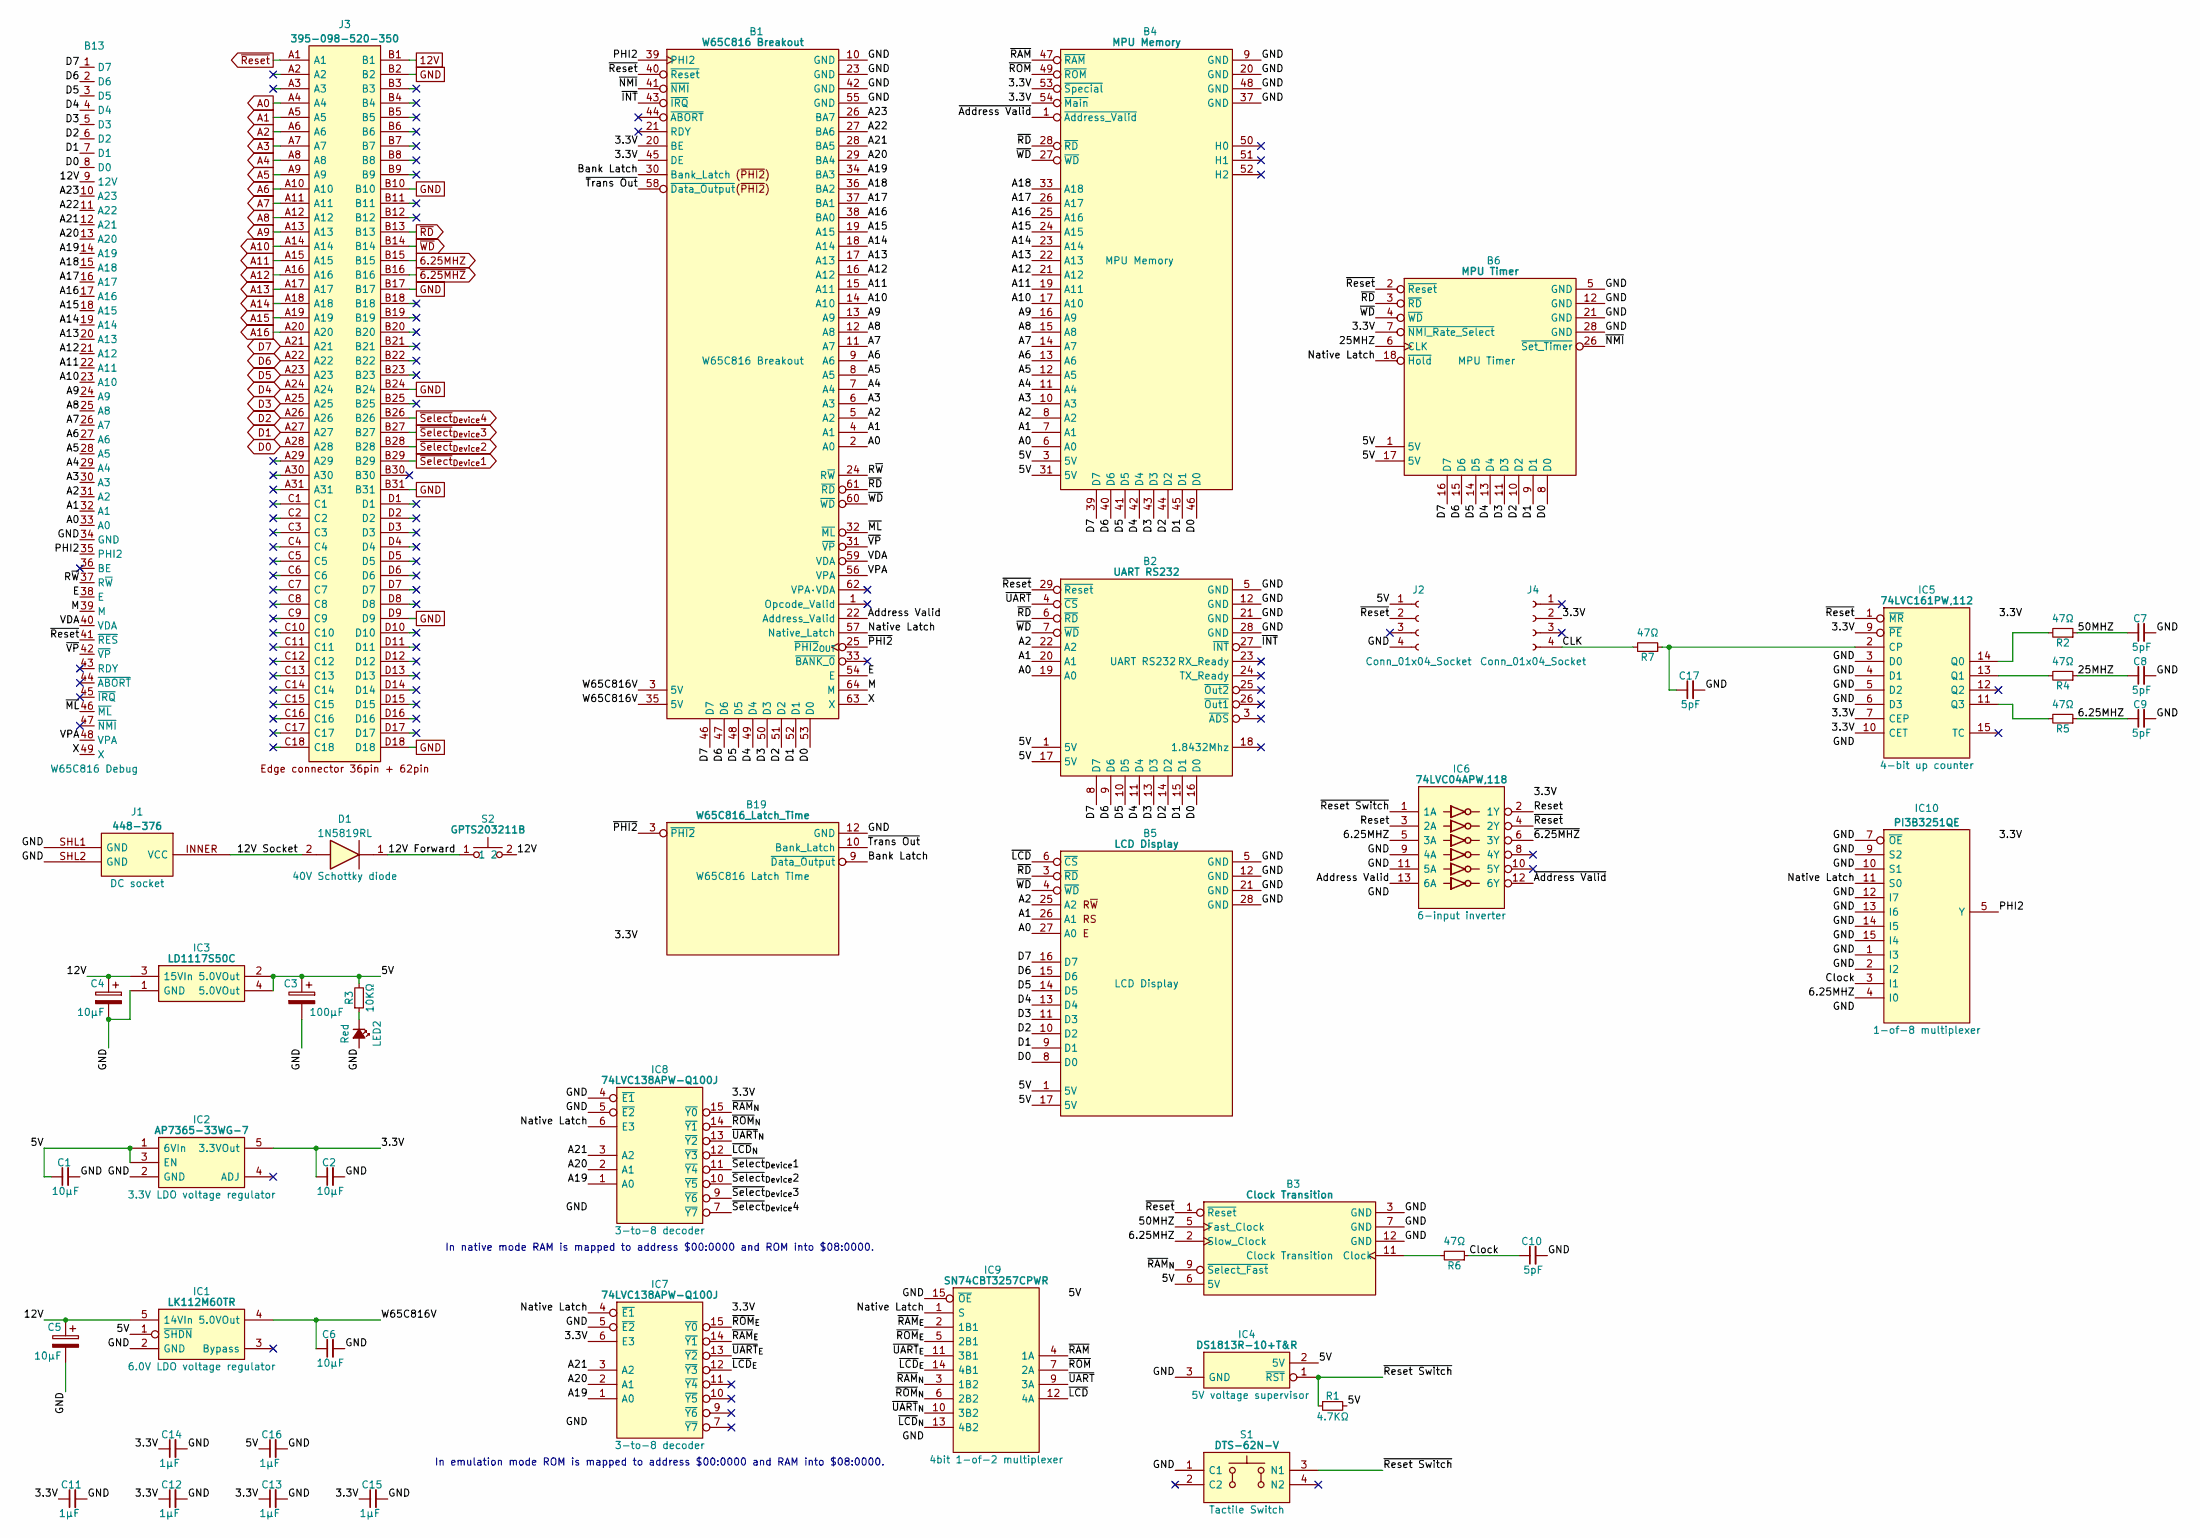
[picture p272: schematic Speed.kicad_sch]

Parts:
B1: W65C816 Breakout; HCP65_W65C816_Breakout
B2: UART RS232; HCP65_RS232_UART
B3: Clock Transition; HCP65_Clock_Transition
B4: MPU Memory; HCP65_MPU_Memory
B5: LCD Display; HCP65_LCD_Display
B6: MPU Timer; HCP65_MPU_Timer
B13: W65C816 Debug; HCP65_W65C816_Debug_Display
B19: W65C816_Latch_Time; HCP65_W65C816_Latch_Time
C1, C2, C6: 10µF; C_0805
C3: 100μF; CP_Radial_D4.0mm_P2.00mm
C4, C5: 10μF; CP_Radial_D4.0mm_P2.00mm
C7, C8, C9, C10, C17: 5pF; C_0805
C11, C12, C13, C14, C15, C16: 1µF; C_0805
D1: 1N5819RL; DIOAD1414W86L464D238; Manufacturer_Part_Number 1N5819RL; Mouser Part Number 511-1N5819-TR
IC1: LK112M60TR; SOT95P285X130-5N; Manufacturer_Part_Number LK112M60TR
IC2: AP7365-33WG-7; SOT95P285X130-5N; Manufacturer_Part_Number AP7365-33WG-7; Mouser Part Number 621-AP7365-33WG-7
IC3: LD1117S50C; LD1117S33C; Manufacturer_Part_Number LD1117S50C
IC4: DS1813R-10+T&R; SOT95P237X112-3N; Mouser Part Number 700-DS1813R-10T&R
IC5: 74LVC161PW,112; SOP65P640X110-16N; Mouser Part Number 771-LVC161PW112
IC6: 74LVC04APW,118; SOP65P640X110-14N; Manufacturer_Part_Number 74LVC04APW,118; Mouser Part Number 771-74LVC04APW-T
IC7, IC8: 74LVC138APW-Q100J; SOP65P640X110-16N; Mouser Part Number 771-74LVC138APWQ100J
IC9: SN74CBT3257CPWR; SOP65P640X120-16N; Manufacturer_Part_Number SN74CBT3257CPWR; Mouser Part Number 595-SN74CBT3257CPWR
IC10: PI3B3251QE; SOP64P599X175-16N; Manufacturer_Part_Number PI3B3251QE; Mouser Part Number 729-PI3B3251QE
J1: 448-376; 448376; Manufacturer_Part_Number 448-376
J2, J4: Conn_01x04_Socket; PinSocket_1x04_P2.54mm_Vertical
J3: 395-098-520-350; 98pin Edge Connector; Manufacturer_Part_Number 395-098-520-350; Mouser Part Number 587-395-098-520-350
LED2: Red; LED_D5.0mm
R1: 4.7KΩ; R_0805
R2, R4, R5, R6, R7: 47Ω; R_0805
R3: 10KΩ; R_0805
S1: DTS-62N-V; DTS62NV; Manufacturer_Part_Number DTS-62N-V; Mouser Part Number 113-DTS-62N-V
S2: GPTS203211B; Manufacturer_Part_Number GPTS203211B; Mouser Part Number 629-GPTS203211B

Connections:
3.3V: B1.20 (BE), B1.45 (DE), B4.53 (~Special), B4.54 (~Main), B6.7 (~NMI_Rate_Select), B19.6 (3.3V), C2.1, C11.1, C12.1, C13.1, C14.1, C15.1, IC2.5 (3.3VOut), IC5.7 (CEP), IC5.9 (~PE), IC5.10 (CET), IC5.16 (3V), IC6.14 (3V), IC7.6 (E3), IC7.16 (3V), IC8.16 (3V), IC10.16 (3V), J4.2
5V: B2.1 (5V), B2.17 (5V), B3.6 (5V), B4.3 (5V), B4.31 (5V), B5.1 (5V), B5.17 (5V), B6.1 (5V), B6.17 (5V), C1.1, C3.1, C16.1, IC1.1 (~SHDN), IC2.1 (6VIn), IC2.3 (EN), IC3.2 (5.0VOut), IC3.4 (5.0VOut), IC4.2 (5V), IC9.16 (5V), J2.1, R1.2, R3.2
6.25MHZ: B3.2 (Slow_Clock), C9.1, IC6.5 (3A), IC10.4 (I0), J3.B15, R5.1
12V: B13.9 (12V), C4.1, C5.1, IC1.5 (14VIn), IC3.3 (15VIn), J3.B1, S2.2
12V Forward: D1.1, S2.1
12V Socket: D1.2, J1.INNER (VCC)
25MHZ: B6.6 (CLK), C8.1, R4.1
50MHZ: B3.5 (Fast_Clock), C7.1, R2.1
A0: B1.2 (A0), B2.19 (A0), B4.6 (A0), B5.27 (A0), B13.33 (A0), J3.A4
A1: B1.4 (A1), B2.20 (A1), B4.7 (A1), B5.26 (A1), B13.32 (A1), J3.A5
A2: B1.5 (A2), B2.22 (A2), B4.8 (A2), B5.25 (A2), B13.31 (A2), J3.A6
A3: B1.6 (A3), B4.10 (A3), B13.30 (A3), J3.A7
A4: B1.7 (A4), B4.11 (A4), B13.29 (A4), J3.A8
A5: B1.8 (A5), B4.12 (A5), B13.28 (A5), J3.A9
A6: B1.9 (A6), B4.13 (A6), B13.27 (A6), J3.A10
A7: B1.11 (A7), B4.14 (A7), B13.26 (A7), J3.A11
A8: B1.12 (A8), B4.15 (A8), B13.25 (A8), J3.A12
A9: B1.13 (A9), B4.16 (A9), B13.24 (A9), J3.A13
A10: B1.14 (A10), B4.17 (A10), B13.23 (A10), J3.A14
A11: B1.15 (A11), B4.19 (A11), B13.22 (A11), J3.A15
A12: B1.16 (A12), B4.21 (A12), B13.21 (A12), J3.A16
A13: B1.17 (A13), B4.22 (A13), B13.20 (A13), J3.A17
A14: B1.18 (A14), B4.23 (A14), B13.19 (A14), J3.A18
A15: B1.19 (A15), B4.24 (A15), B13.18 (A15), J3.A19
A16: B1.38 (BA0), B4.25 (A16), B13.17 (A16), J3.A20
A17: B1.37 (BA1), B4.26 (A17), B13.16 (A17)
A18: B1.36 (BA2), B4.33 (A18), B13.15 (A18)
A19: B1.34 (BA3), B13.14 (A19), IC7.1 (A0), IC8.1 (A0)
A20: B1.29 (BA4), B13.13 (A20), IC7.2 (A1), IC8.2 (A1)
A21: B1.28 (BA5), B13.12 (A21), IC7.3 (A2), IC8.3 (A2)
A22: B1.27 (BA6), B13.11 (A22)
A23: B1.26 (BA7), B13.10 (A23)
Address Valid: B1.22 (Address_Valid), IC6.13 (6A)
Bank Latch: B1.30 (Bank_Latch), B19.9 (~Data_Output)
CLK: J4.4, R7.2
Clock: C10.1, IC10.3 (I1), R6.1
D0: B1.53 (D0), B2.16 (D0), B4.46 (D0), B5.8 (D0), B6.8 (D0), B13.8 (D0), J3.A28
D1: B1.52 (D1), B2.15 (D1), B4.45 (D1), B5.9 (D1), B6.9 (D1), B13.7 (D1), J3.A27
D2: B1.51 (D2), B2.14 (D2), B4.44 (D2), B5.10 (D2), B6.10 (D2), B13.6 (D2), J3.A26
D3: B1.50 (D3), B2.13 (D3), B4.43 (D3), B5.11 (D3), B6.11 (D3), B13.5 (D3), J3.A25
D4: B1.49 (D4), B2.11 (D4), B4.42 (D4), B5.13 (D4), B6.13 (D4), B13.4 (D4), J3.A24
D5: B1.48 (D5), B2.10 (D5), B4.41 (D5), B5.14 (D5), B6.14 (D5), B13.3 (D5), J3.A23
D6: B1.47 (D6), B2.9 (D6), B4.40 (D6), B5.15 (D6), B6.15 (D6), B13.2 (D6), J3.A22
D7: B1.46 (D7), B2.8 (D7), B4.39 (D7), B5.16 (D7), B6.16 (D7), B13.1 (D7), J3.A21
E: B1.54 (E), B13.38 (E)
GND: B1.10 (GND), B1.23 (GND), B1.42 (GND), B1.55 (GND), B2.5 (GND), B2.12 (GND), B2.21 (GND), B2.28 (GND), B3.3 (GND), B3.7 (GND), B3.12 (GND), B4.9 (GND), B4.20 (GND), B4.37 (GND), B4.48 (GND), B5.5 (GND), B5.12 (GND), B5.21 (GND), B5.28 (GND), B6.5 (GND), B6.12 (GND), B6.21 (GND), B6.28 (GND), B13.34 (GND), B19.12 (GND), C1.2, C2.2, C3.2, C4.2, C5.2, C6.2, C7.2, C8.2, C9.2, C10.2, C11.2, C12.2, C13.2, C14.2, C15.2, C16.2, C17.2, IC1.2 (GND), IC2.2 (GND), IC3.1 (GND), IC4.3 (GND), IC5.3 (D0), IC5.4 (D1), IC5.5 (D2), IC5.6 (D3), IC5.8 (GND), IC6.7 (GND), IC6.9 (4A), IC6.11 (5A), IC7.5 (~E2), IC7.8 (GND), IC8.4 (~E1), IC8.5 (~E2), IC8.8 (GND), IC9.8 (GND), IC9.15 (~OE), IC10.1 (I3), IC10.2 (I2), IC10.7 (~OE), IC10.8 (GND), IC10.9 (S2), IC10.10 (S1), IC10.12 (I7), IC10.13 (I6), IC10.14 (I5), IC10.15 (I4), J1.SHL1 (GND), J1.SHL2 (GND), J2.4, J3.B2, J3.B10, J3.B17, J3.B24, J3.B31, J3.D9, J3.D18, LED2.2 (A), S1.1 (C1)
M: B1.64 (M), B13.39 (M)
Native Latch: B1.57 (Native_Latch), B6.18 (~Hold), IC7.4 (~E1), IC8.6 (E3), IC9.1 (S), IC10.11 (S0)
unnamed: B3.11 (Clock), R6.2
unnamed: C17.1, IC5.2 (CP), R7.1
unnamed: IC5.11 (Q3), R5.2
unnamed: IC5.13 (Q1), R4.2
unnamed: IC5.14 (Q0), R2.2
unnamed: LED2.1 (K), R3.1
PHI2: B1.39 (PHI2), B13.35 (PHI2), IC10.5 (Y)
Reset: IC6.2 (1Y), IC6.3 (2A)
R~W: B1.24 (R~W), B13.37 (R~W)
VDA: B1.59 (VDA), B13.40 (VDA)
VPA: B1.56 (VPA), B13.48 (VPA)
W65C816V: B1.3 (5V), B1.35 (5V), C6.1, IC1.4 (5.0VOut)
X: B1.63 (X), B13.49 (X)
~6.25MHZ: IC6.6 (3Y), J3.B16
~Address Valid: B4.1 (~Address_Valid), IC6.12 (6Y)
~INT: B1.43 (~IRQ), B2.27 (~INT)
~LCD: B5.6 (~CS), IC9.12 (4A)
~LCD_{E}: IC7.12 (~Y3), IC9.14 (4B1)
~LCD_{N}: IC8.12 (~Y3), IC9.13 (4B2)
~ML: B1.32 (~ML), B13.46 (~ML)
~NMI: B1.41 (~NMI), B6.26 (~Set_Timer)
~PHI2: B1.25 (~PHI2_{OUT}), B19.3 (~PHI2)
~RAM: B4.47 (~RAM), IC9.4 (1A)
~RAM_{E}: IC7.14 (~Y1), IC9.2 (1B1)
~RAM_{N}: B3.9 (~Select_Fast), IC8.15 (~Y0), IC9.3 (1B2)
~RD: B1.61 (~RD), B2.6 (~RD), B4.28 (~RD), B5.3 (~RD), B6.3 (~RD), J3.B13
~ROM: B4.49 (~ROM), IC9.7 (2A)
~ROM_{E}: IC7.15 (~Y0), IC9.5 (2B1)
~ROM_{N}: IC8.14 (~Y1), IC9.6 (2B2)
~Reset Switch: IC4.1 (~RST), IC6.1 (1A), R1.1, S1.3 (N1)
~Reset: B1.40 (~Reset), B2.29 (~Reset), B3.1 (~Reset), B6.2 (~Reset), B13.41 (~RES), IC5.1 (~MR), IC6.4 (2Y), J2.2, J3.A1
~Select_{Device}1: IC8.11 (~Y4), J3.B29
~Select_{Device}2: IC8.10 (~Y5), J3.B28
~Select_{Device}3: IC8.9 (~Y6), J3.B27
~Select_{Device}4: IC8.7 (~Y7), J3.B26
~Trans Out: B1.58 (~Data_Output), B19.10 (Bank_Latch)
~UART: B2.4 (~CS), IC9.9 (3A)
~UART_{E}: IC7.13 (~Y2), IC9.11 (3B1)
~UART_{N}: IC8.13 (~Y2), IC9.10 (3B2)
~VP: B1.31 (~VP), B13.42 (~VP)
~WD: B1.60 (~WD), B2.7 (~WD), B4.27 (~WD), B5.4 (~WD), B6.4 (~WD), J3.B14

Notes on the sheet:
In emulation mode ROM is mapped to address $00:0000 and RAM into $08:0000.
In native mode RAM is mapped to address $00:0000 and ROM into $08:0000.
