andrewpaterson/HCP65/Kicad/W65C64/W65C64.kicad_sch

## KiCad design Kicad/W65C64/W65C64.kicad_sch (2026-11-01)

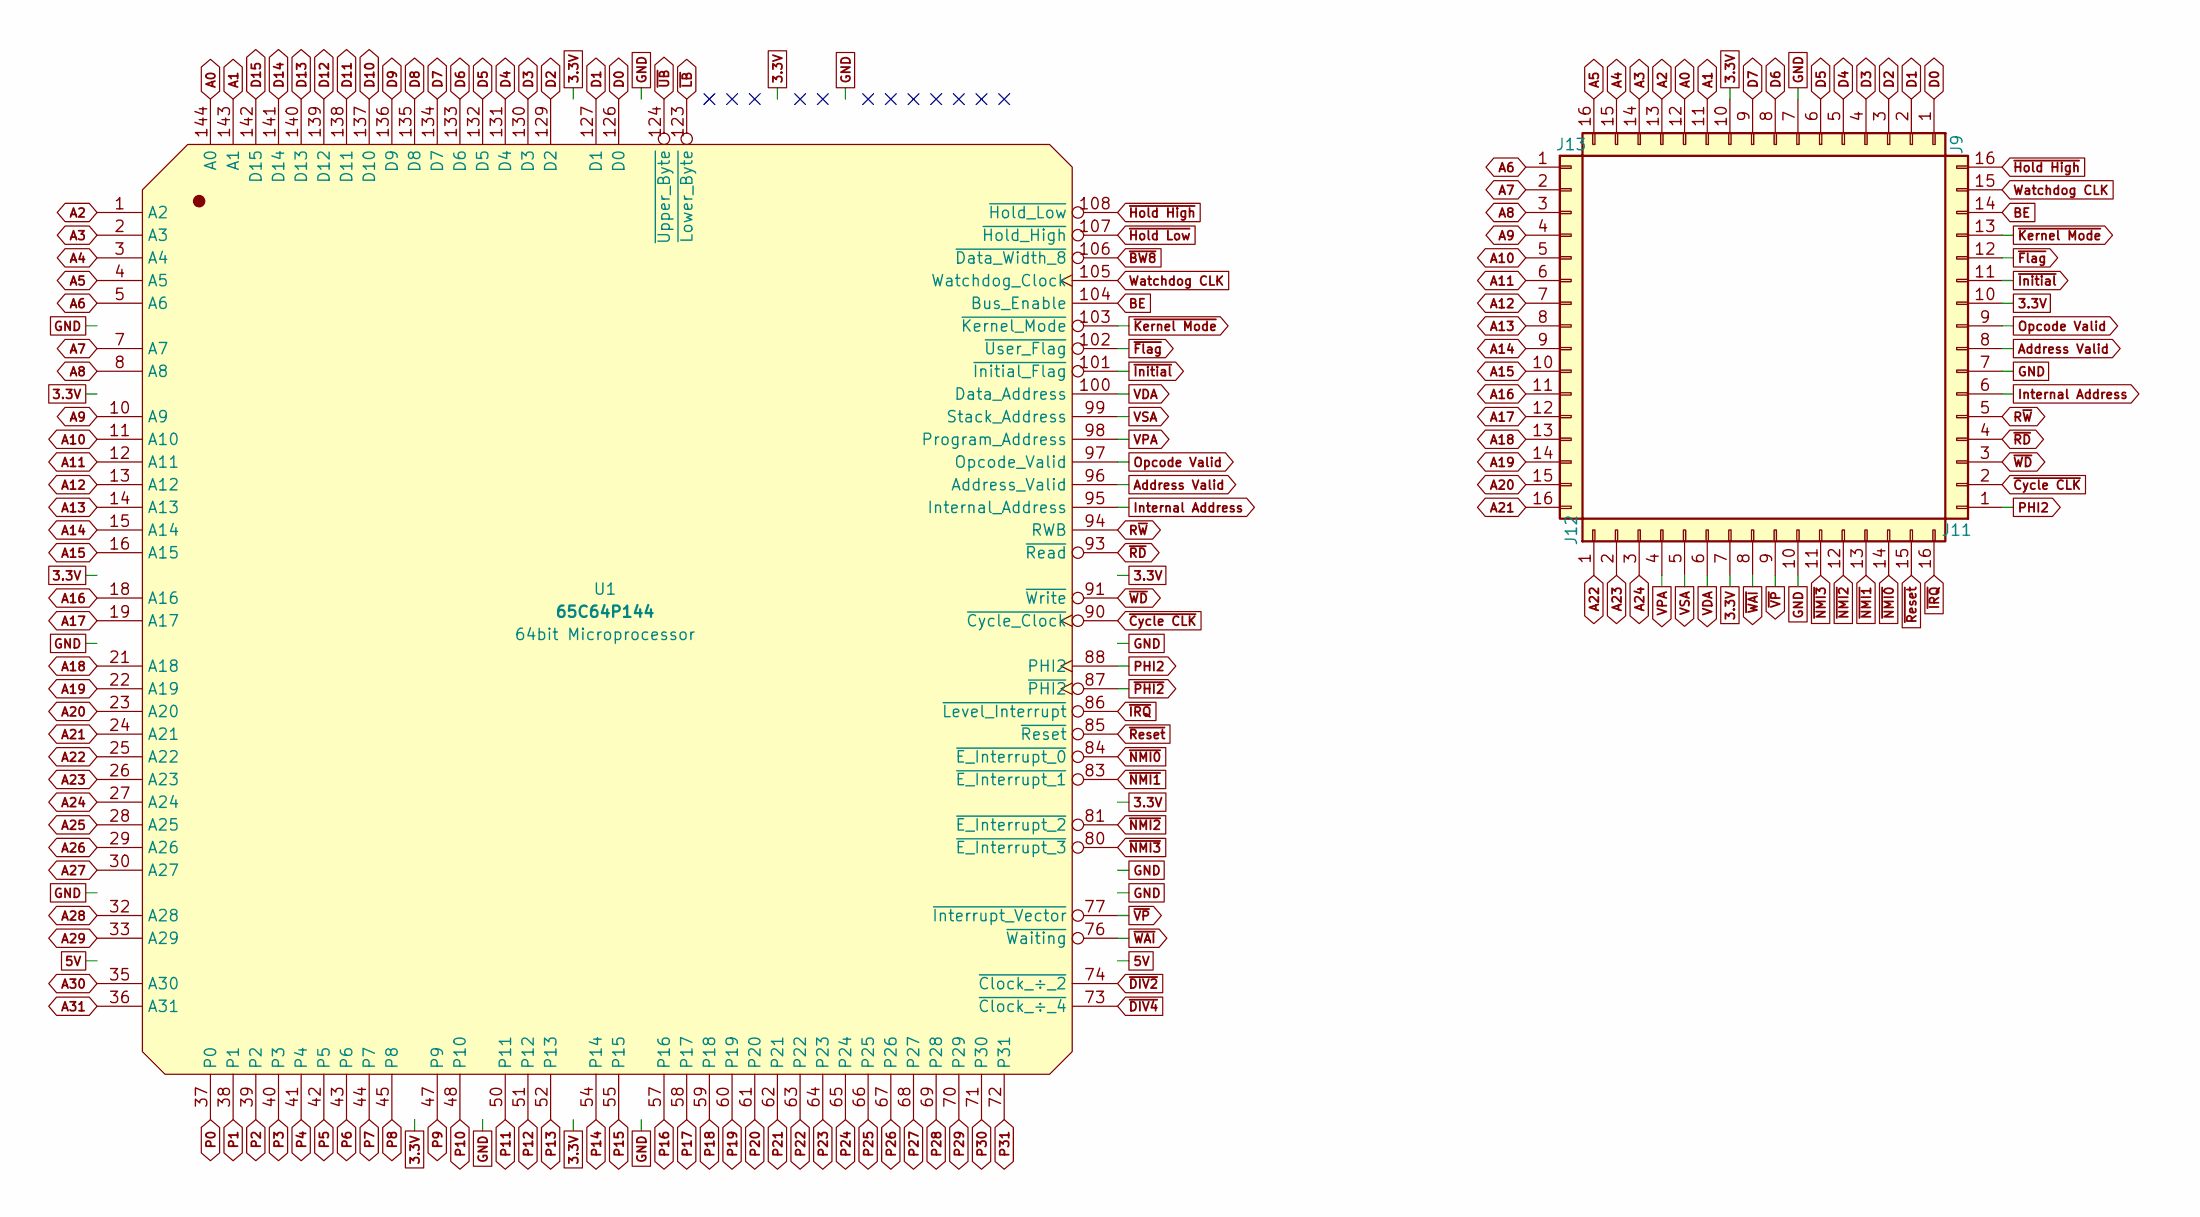
[picture p273: schematic W65C64.kicad_sch]

Parts:
J9, J11, J12, J13: Conn_01x16
U1: 65C64P144

Connections:
3.3V: J9.10, J11.10, J12.7, U1.9 (VDD), U1.17 (VSS), U1.46 (VDD), U1.53 (VDD), U1.82 (VDD), U1.92 (VDD), U1.119 (VDD), U1.128 (VDD)
5V: U1.34 (VDDIO), U1.75 (VDDIO)
A0: J9.12, U1.144 (A0)
A1: J9.11, U1.143 (A1)
A2: J9.13, U1.1 (A2)
A3: J9.14, U1.2 (A3)
A4: J9.15, U1.3 (A4)
A5: J9.16, U1.4 (A5)
A6: J13.1, U1.5 (A6)
A7: J13.2, U1.7 (A7)
A8: J13.3, U1.8 (A8)
A9: J13.4, U1.10 (A9)
A10: J13.5, U1.11 (A10)
A11: J13.6, U1.12 (A11)
A12: J13.7, U1.13 (A12)
A13: J13.8, U1.14 (A13)
A14: J13.9, U1.15 (A14)
A15: J13.10, U1.16 (A15)
A16: J13.11, U1.18 (A16)
A17: J13.12, U1.19 (A17)
A18: J13.13, U1.21 (A18)
A19: J13.14, U1.22 (A19)
A20: J13.15, U1.23 (A20)
A21: J13.16, U1.24 (A21)
A22: J12.1, U1.25 (A22)
A23: J12.2, U1.26 (A23)
A24: J12.3, U1.27 (A24)
A25: U1.28 (A25)
A26: U1.29 (A26)
A27: U1.30 (A27)
A28: U1.32 (A28)
A29: U1.33 (A29)
A30: U1.35 (A30)
A31: U1.36 (A31)
Address Valid: J11.8, U1.96 (Address_Valid)
BE: J11.14, U1.104 (Bus_Enable)
D0: J9.1, U1.126 (D0)
D1: J9.2, U1.127 (D1)
D2: J9.3, U1.129 (D2)
D3: J9.4, U1.130 (D3)
D4: J9.5, U1.131 (D4)
D5: J9.6, U1.132 (D5)
D6: J9.8, U1.133 (D6)
D7: J9.9, U1.134 (D7)
D8: U1.135 (D8)
D9: U1.136 (D9)
D10: U1.137 (D10)
D11: U1.138 (D11)
D12: U1.139 (D12)
D13: U1.140 (D13)
D14: U1.141 (D14)
D15: U1.142 (D15)
GND: J9.7, J11.7, J12.10, U1.6 (VSS), U1.20 (VDD), U1.31 (VSS), U1.49 (VSS), U1.56 (VSS), U1.78 (VSS), U1.79 (VSS), U1.89 (VSS), U1.116 (VSS), U1.125 (VSS)
Internal Address: J11.6, U1.95 (Internal_Address)
Opcode Valid: J11.9, U1.97 (Opcode_Valid)
P0: U1.37 (P0)
P1: U1.38 (P1)
P2: U1.39 (P2)
P3: U1.40 (P3)
P4: U1.41 (P4)
P5: U1.42 (P5)
P6: U1.43 (P6)
P7: U1.44 (P7)
P8: U1.45 (P8)
P9: U1.47 (P9)
P10: U1.48 (P10)
P11: U1.50 (P11)
P12: U1.51 (P12)
P13: U1.52 (P13)
P14: U1.54 (P14)
P15: U1.55 (P15)
P16: U1.57 (P16)
P17: U1.58 (P17)
P18: U1.59 (P18)
P19: U1.60 (P19)
P20: U1.61 (P20)
P21: U1.62 (P21)
P22: U1.63 (P22)
P23: U1.64 (P23)
P24: U1.65 (P24)
P25: U1.66 (P25)
P26: U1.67 (P26)
P27: U1.68 (P27)
P28: U1.69 (P28)
P29: U1.70 (P29)
P30: U1.71 (P30)
P31: U1.72 (P31)
PHI2: J11.1, U1.88 (PHI2)
R~W: J11.5, U1.94 (RWB)
VDA: J12.6, U1.100 (Data_Address)
VPA: J12.4, U1.98 (Program_Address)
VSA: J12.5, U1.99 (Stack_Address)
Watchdog CLK: J11.15, U1.105 (Watchdog_Clock)
~BW8: U1.106 (~Data_Width_8)
~Cycle CLK: J11.2, U1.90 (~Cycle_Clock)
~DIV2: U1.74 (~Clock_÷_2)
~DIV4: U1.73 (~Clock_÷_4)
~Flag: J11.12, U1.102 (~User_Flag)
~Hold High: J11.16, U1.108 (~Hold_Low)
~Hold Low: U1.107 (~Hold_High)
~IRQ: J12.16, U1.86 (~Level_Interrupt)
~Initial: J11.11, U1.101 (~Initial_Flag)
~Kernel Mode: J11.13, U1.103 (~Kernel_Mode)
~LB: U1.123 (~Lower_Byte)
~NMI0: J12.14, U1.84 (~E_Interrupt_0)
~NMI1: J12.13, U1.83 (~E_Interrupt_1)
~NMI2: J12.12, U1.81 (~E_Interrupt_2)
~NMI3: J12.11, U1.80 (~E_Interrupt_3)
~PHI2: U1.87 (~PHI2)
~RD: J11.4, U1.93 (~Read)
~Reset: J12.15, U1.85 (~Reset)
~UB: U1.124 (~Upper_Byte)
~VP: J12.9, U1.77 (~Interrupt_Vector)
~WAI: J12.8, U1.76 (~Waiting)
~WD: J11.3, U1.91 (~Write)
