andrewpaterson/HCP65/Kicad/Programmers/EPM570 Programmer/EPM570 Programmer.kicad_sch

## KiCad design Kicad/Programmers/EPM570 Programmer/EPM570 Programmer.kicad_sch (2026-11-01)

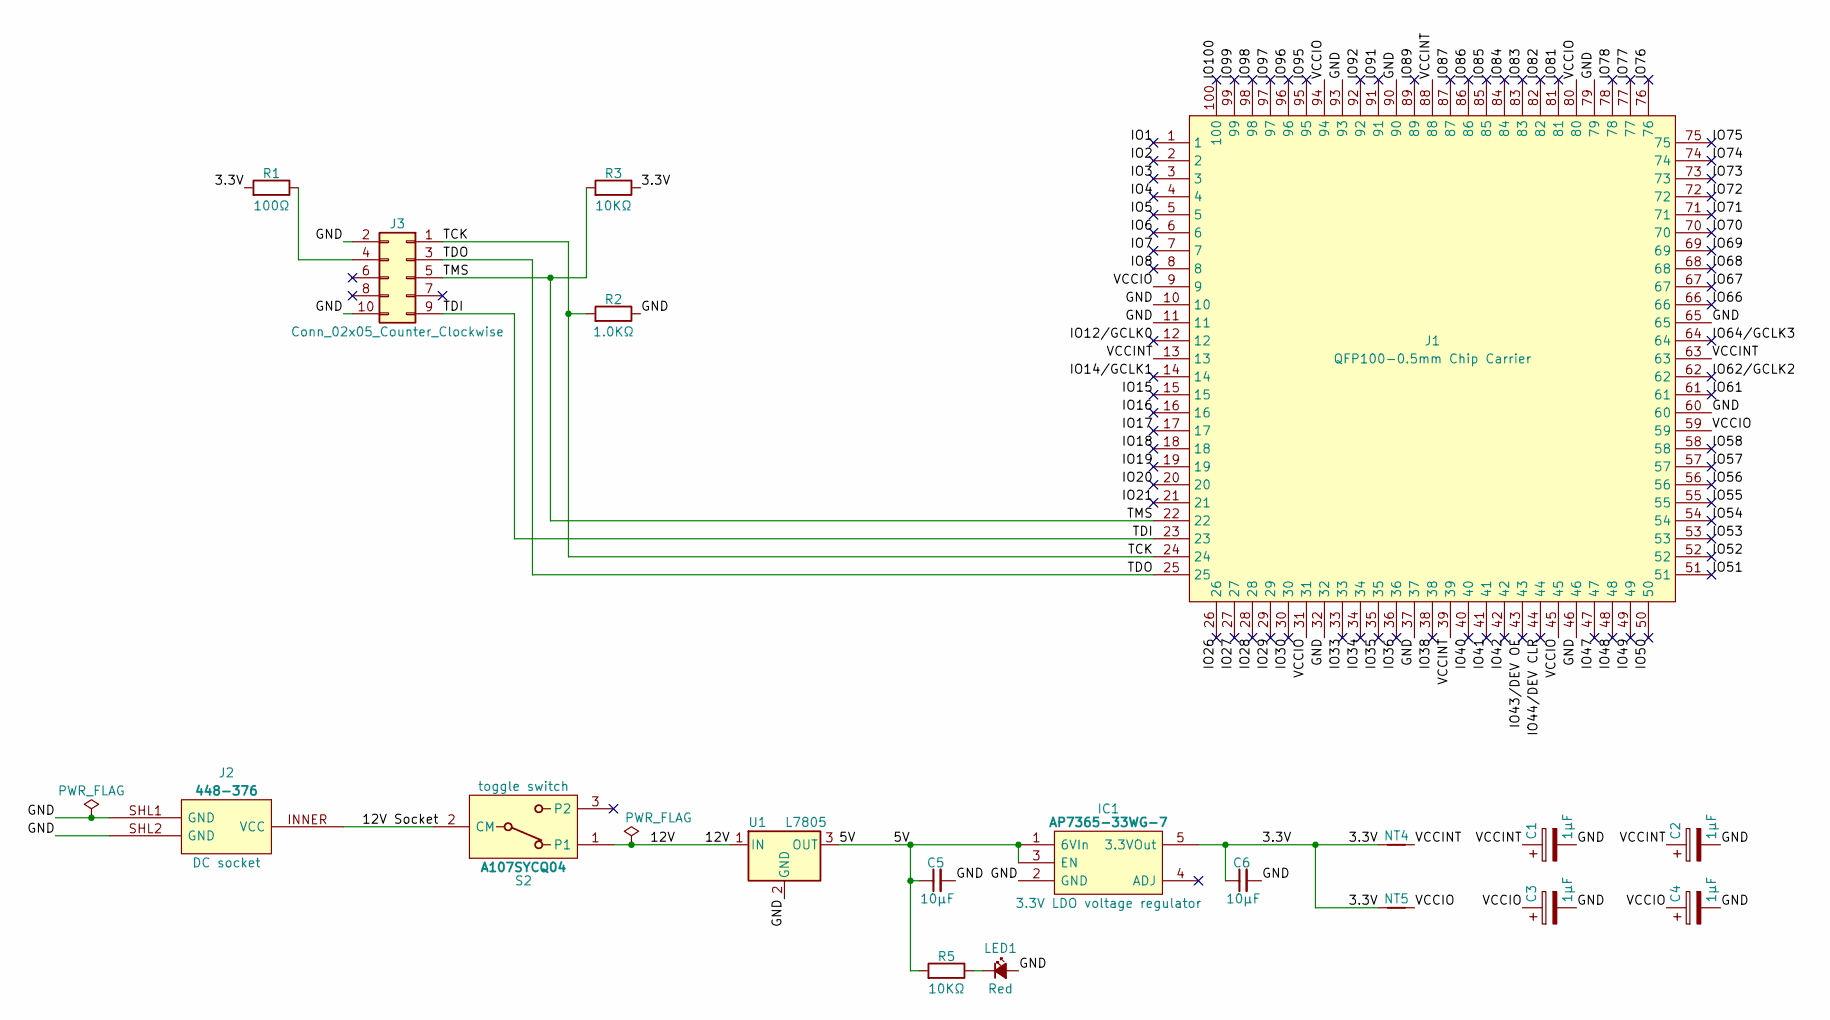
[picture p274: schematic EPM570 Programmer.kicad_sch]

Parts:
C1, C2, C3, C4: 1μF; CP_Radial_D4.0mm_P2.00mm
C5, C6: 10µF; C_0805
IC1: AP7365-33WG-7; SOT95P285X130-5N; Manufacturer_Part_Number AP7365-33WG-7; Mouser Part Number 621-AP7365-33WG-7
J1: AllSocket-QFP-100-14X14-0.5-Clamshell
J2: 448-376; 448376; Manufacturer_Part_Number 448-376
J3: Conn_02x05_Counter_Clockwise; PinHeader_2x05_P2.54mm_Vertical
LED1: Red; LED_D5.0mm
NT4, NT5: NetTie_2; NetTie-2_SMD_Pad0.5mm
R1: 100Ω; R_DIN_P12.70mm
R2: 1.0KΩ; R_DIN_P7.62mm
R3, R5: 10KΩ; R_DIN_P7.62mm
S2: A107SYCQ04; Manufacturer_Part_Number A107SYCQ04; Mouser Part Number 506-5-1825137-1
U1: L7805; TO-220-3_Vertical

Connections:
3.3V: C6.1, IC1.5 (3.3VOut), NT4.1, NT5.1, R1.2, R3.1
5V: C5.1, IC1.1 (6VIn), IC1.3 (EN), R5.2, U1.3 (OUT)
12V: S2.1, U1.1 (IN)
12V Socket: J2.INNER (VCC), S2.2 (CM)
GND: C1.2, C2.2, C3.2, C4.2, C5.2, C6.2, IC1.2 (GND), J1.10, J1.11, J1.32, J1.37, J1.46, J1.60, J1.65, J1.79, J1.90, J1.93, J2.SHL1 (GND), J2.SHL2 (GND), J3.2, J3.10, LED1.2 (A), R2.1, U1.2 (GND)
IO1: J1.1
IO2: J1.2
IO3: J1.3
IO4: J1.4
IO5: J1.5
IO6: J1.6
IO7: J1.7
IO8: J1.8
IO12/GCLK0: J1.12
IO14/GCLK1: J1.14
IO15: J1.15
IO16: J1.16
IO17: J1.17
IO18: J1.18
IO19: J1.19
IO20: J1.20
IO21: J1.21
IO26: J1.26
IO27: J1.27
IO28: J1.28
IO29: J1.29
IO30: J1.30
IO33: J1.33
IO34: J1.34
IO35: J1.35
IO36: J1.36
IO38: J1.38
IO40: J1.40
IO41: J1.41
IO42: J1.42
IO43/DEV OE: J1.43
IO44/DEV CLR: J1.44
IO47: J1.47
IO48: J1.48
IO49: J1.49
IO50: J1.50
IO51: J1.51
IO52: J1.52
IO53: J1.53
IO54: J1.54
IO55: J1.55
IO56: J1.56
IO57: J1.57
IO58: J1.58
IO61: J1.61
IO62/GCLK2: J1.62
IO64/GCLK3: J1.64
IO66: J1.66
IO67: J1.67
IO68: J1.68
IO69: J1.69
IO70: J1.70
IO71: J1.71
IO72: J1.72
IO73: J1.73
IO74: J1.74
IO75: J1.75
IO76: J1.76
IO77: J1.77
IO78: J1.78
IO81: J1.81
IO82: J1.82
IO83: J1.83
IO84: J1.84
IO85: J1.85
IO86: J1.86
IO87: J1.87
IO89: J1.89
IO91: J1.91
IO92: J1.92
IO95: J1.95
IO96: J1.96
IO97: J1.97
IO98: J1.98
IO99: J1.99
IO100: J1.100
unnamed: J3.4, R1.1
unnamed: LED1.1 (K), R5.1
TCK: J1.24, J3.1, R2.2
TDI: J1.23, J3.9
TDO: J1.25, J3.3
TMS: J1.22, J3.5, R3.2
VCCINT: C1.1, C2.1, J1.13, J1.39, J1.63, J1.88, NT4.2
VCCIO: C3.1, C4.1, J1.9, J1.31, J1.45, J1.59, J1.80, J1.94, NT5.2
