andrewpaterson/HCP65/Kicad/Tester/LCD 14 Segment Tester/LED 14 Display.kicad_sch

## KiCad design Kicad/Tester/LCD 14 Segment Tester/LED 14 Display.kicad_sch (2026-11-01)

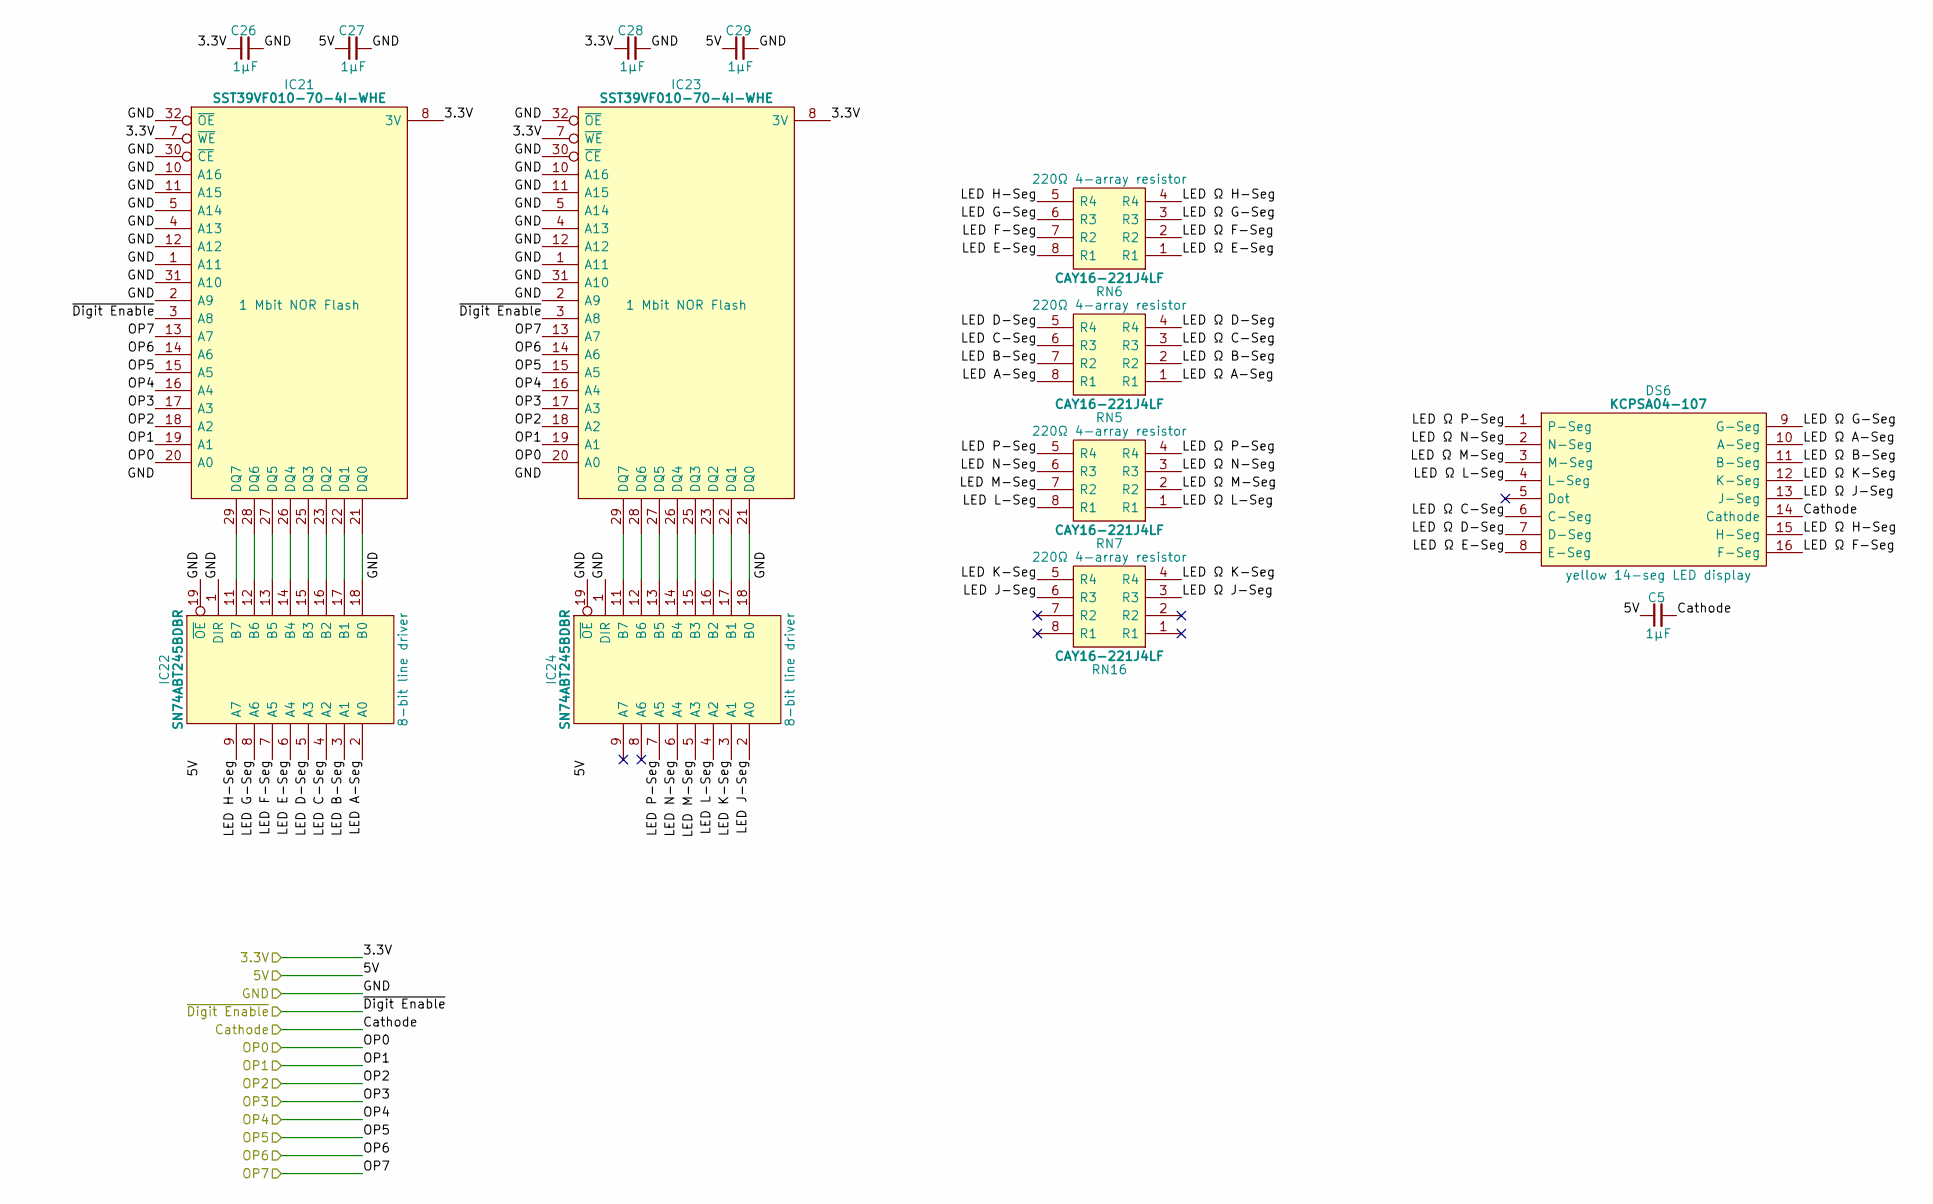
[picture p278: schematic LED 14 Display.kicad_sch]

Parts:
C5, C26, C27, C28, C29: 1μF; C_0805
DS6: KCPSA04-107; KCPSA04107; Manufacturer_Part_Number KCPSA04-107; Mouser Part Number N/A
IC21, IC23: SST39VF010-70-4I-WHE; DIP-32_TSSOP_14mm_Adapter; Manufacturer_Part_Number SST39VF010-70-4I-WHE-T; Mouser Part Number 579-39VF0107IWHET
IC22, IC24: SN74ABT245BDBR; SOP65P780X200-20N; Manufacturer_Part_Number SN74ABT245BDBR; Mouser Part Number 595-SN74ABT245BDBR
RN5, RN6, RN7, RN16: CAY16-221J4LF; CAY16-F4; Manufacturer_Part_Number CAY16-221J4LF; Mouser Part Number 652-CAY16-221J4LF

Connections:
3.3V: C26.1, C28.1, IC21.7 (~WE), IC21.8 (3V), IC23.7 (~WE), IC23.8 (3V)
5V: C5.1, C27.1, C29.1, IC22.20 (5V), IC24.20 (5V)
Cathode: C5.2, DS6.14 (Cathode)
GND: C26.2, C27.2, C28.2, C29.2, IC21.1 (A11), IC21.2 (A9), IC21.4 (A13), IC21.5 (A14), IC21.10 (A16), IC21.11 (A15), IC21.12 (A12), IC21.24 (GND), IC21.30 (~CE), IC21.31 (A10), IC21.32 (~OE), IC22.1 (DIR), IC22.10 (GND), IC22.19 (~OE), IC23.1 (A11), IC23.2 (A9), IC23.4 (A13), IC23.5 (A14), IC23.10 (A16), IC23.11 (A15), IC23.12 (A12), IC23.24 (GND), IC23.30 (~CE), IC23.31 (A10), IC23.32 (~OE), IC24.1 (DIR), IC24.10 (GND), IC24.19 (~OE)
LED A-Seg: IC22.2 (A0), RN5.8 (R1)
LED B-Seg: IC22.3 (A1), RN5.7 (R2)
LED C-Seg: IC22.4 (A2), RN5.6 (R3)
LED D-Seg: IC22.5 (A3), RN5.5 (R4)
LED E-Seg: IC22.6 (A4), RN6.8 (R1)
LED F-Seg: IC22.7 (A5), RN6.7 (R2)
LED G-Seg: IC22.8 (A6), RN6.6 (R3)
LED H-Seg: IC22.9 (A7), RN6.5 (R4)
LED J-Seg: IC24.2 (A0), RN16.6 (R3)
LED K-Seg: IC24.3 (A1), RN16.5 (R4)
LED L-Seg: IC24.4 (A2), RN7.8 (R1)
LED M-Seg: IC24.5 (A3), RN7.7 (R2)
LED N-Seg: IC24.6 (A4), RN7.6 (R3)
LED P-Seg: IC24.7 (A5), RN7.5 (R4)
LED Ω A-Seg: DS6.10 (A-Seg), RN5.1 (R1)
LED Ω B-Seg: DS6.11 (B-Seg), RN5.2 (R2)
LED Ω C-Seg: DS6.6 (C-Seg), RN5.3 (R3)
LED Ω D-Seg: DS6.7 (D-Seg), RN5.4 (R4)
LED Ω E-Seg: DS6.8 (E-Seg), RN6.1 (R1)
LED Ω F-Seg: DS6.16 (F-Seg), RN6.2 (R2)
LED Ω G-Seg: DS6.9 (G-Seg), RN6.3 (R3)
LED Ω H-Seg: DS6.15 (H-Seg), RN6.4 (R4)
LED Ω J-Seg: DS6.13 (J-Seg), RN16.3 (R3)
LED Ω K-Seg: DS6.12 (K-Seg), RN16.4 (R4)
LED Ω L-Seg: DS6.4 (L-Seg), RN7.1 (R1)
LED Ω M-Seg: DS6.3 (M-Seg), RN7.2 (R2)
LED Ω N-Seg: DS6.2 (N-Seg), RN7.3 (R3)
LED Ω P-Seg: DS6.1 (P-Seg), RN7.4 (R4)
unnamed: IC21.21 (DQ0), IC22.18 (B0)
unnamed: IC21.22 (DQ1), IC22.17 (B1)
unnamed: IC21.23 (DQ2), IC22.16 (B2)
unnamed: IC21.25 (DQ3), IC22.15 (B3)
unnamed: IC21.26 (DQ4), IC22.14 (B4)
unnamed: IC21.27 (DQ5), IC22.13 (B5)
unnamed: IC21.28 (DQ6), IC22.12 (B6)
unnamed: IC21.29 (DQ7), IC22.11 (B7)
unnamed: IC23.21 (DQ0), IC24.18 (B0)
unnamed: IC23.22 (DQ1), IC24.17 (B1)
unnamed: IC23.23 (DQ2), IC24.16 (B2)
unnamed: IC23.25 (DQ3), IC24.15 (B3)
unnamed: IC23.26 (DQ4), IC24.14 (B4)
unnamed: IC23.27 (DQ5), IC24.13 (B5)
unnamed: IC23.28 (DQ6), IC24.12 (B6)
unnamed: IC23.29 (DQ7), IC24.11 (B7)
OP0: IC21.20 (A0), IC23.20 (A0)
OP1: IC21.19 (A1), IC23.19 (A1)
OP2: IC21.18 (A2), IC23.18 (A2)
OP3: IC21.17 (A3), IC23.17 (A3)
OP4: IC21.16 (A4), IC23.16 (A4)
OP5: IC21.15 (A5), IC23.15 (A5)
OP6: IC21.14 (A6), IC23.14 (A6)
OP7: IC21.13 (A7), IC23.13 (A7)
~Digit Enable: IC21.3 (A8), IC23.3 (A8)
