andrewpaterson/HCP65/Kicad/Tester/LCD Dual 7 Segment Tester/LED Display.kicad_sch

## KiCad design Kicad/Tester/LCD Dual 7 Segment Tester/LED Display.kicad_sch (2026-11-06)

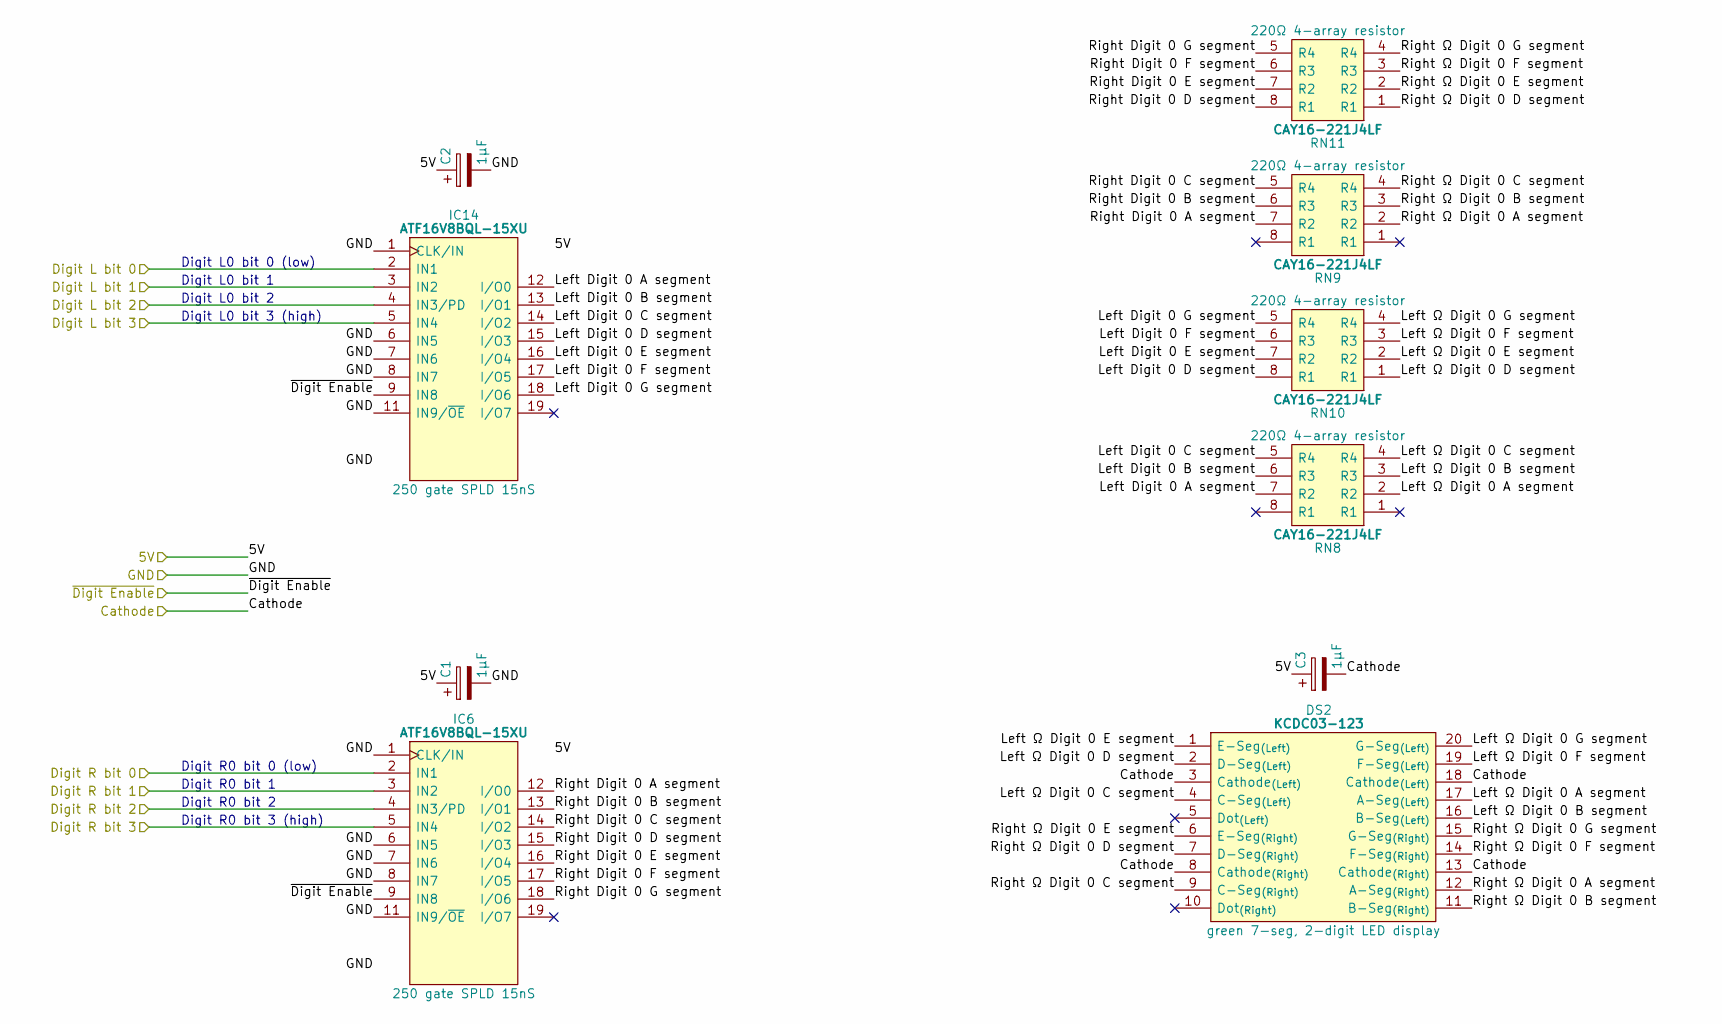
[picture p280: schematic LED Display.kicad_sch]

Parts:
C1, C2, C3: 1μF; CP_Radial_D4.0mm_P2.00mm
DS2: KCDC03-123; KCDC03123; Manufacturer_Part_Number KCDC03-123; Mouser Part Number N/A
IC6, IC14: ATF16V8BQL-15XU; DIP-20_W15.24mm_Socket; Manufacturer_Part_Number ATF16V8BQL-15XU; Mouser Part Number 556-AF16V8BQL15XU
RN8, RN9, RN10, RN11: CAY16-221J4LF; CAY16-F4; Manufacturer_Part_Number CAY16-221J4LF; Mouser Part Number 652-CAY16-221J4LF

Connections:
5V: C1.1, C2.1, C3.1, IC6.20 (5V), IC14.20 (5V)
Cathode: C3.2, DS2.3 (Cathode_{(Left)}), DS2.8 (Cathode_{(Right)}), DS2.13 (Cathode_{(Right)}), DS2.18 (Cathode_{(Left)})
Digit L bit 0: IC14.2 (IN1)
Digit L bit 1: IC14.3 (IN2)
Digit L bit 2: IC14.4 (IN3/PD)
Digit L bit 3: IC14.5 (IN4)
Digit R bit 0: IC6.2 (IN1)
Digit R bit 1: IC6.3 (IN2)
Digit R bit 2: IC6.4 (IN3/PD)
Digit R bit 3: IC6.5 (IN4)
GND: C1.2, C2.2, IC6.1 (CLK/IN), IC6.6 (IN5), IC6.7 (IN6), IC6.8 (IN7), IC6.10 (GND), IC6.11 (IN9/~OE), IC14.1 (CLK/IN), IC14.6 (IN5), IC14.7 (IN6), IC14.8 (IN7), IC14.10 (GND), IC14.11 (IN9/~OE)
Left Digit 0 A segment: IC14.12 (I/O0), RN8.7 (R2)
Left Digit 0 B segment: IC14.13 (I/O1), RN8.6 (R3)
Left Digit 0 C segment: IC14.14 (I/O2), RN8.5 (R4)
Left Digit 0 D segment: IC14.15 (I/O3), RN10.8 (R1)
Left Digit 0 E segment: IC14.16 (I/O4), RN10.7 (R2)
Left Digit 0 F segment: IC14.17 (I/O5), RN10.6 (R3)
Left Digit 0 G segment: IC14.18 (I/O6), RN10.5 (R4)
Left Ω Digit 0 A segment: DS2.17 (A-Seg_{(Left)}), RN8.2 (R2)
Left Ω Digit 0 B segment: DS2.16 (B-Seg_{(Left)}), RN8.3 (R3)
Left Ω Digit 0 C segment: DS2.4 (C-Seg_{(Left)}), RN8.4 (R4)
Left Ω Digit 0 D segment: DS2.2 (D-Seg_{(Left)}), RN10.1 (R1)
Left Ω Digit 0 E segment: DS2.1 (E-Seg_{(Left)}), RN10.2 (R2)
Left Ω Digit 0 F segment: DS2.19 (F-Seg_{(Left)}), RN10.3 (R3)
Left Ω Digit 0 G segment: DS2.20 (G-Seg_{(Left)}), RN10.4 (R4)
Right Digit 0 A segment: IC6.12 (I/O0), RN9.7 (R2)
Right Digit 0 B segment: IC6.13 (I/O1), RN9.6 (R3)
Right Digit 0 C segment: IC6.14 (I/O2), RN9.5 (R4)
Right Digit 0 D segment: IC6.15 (I/O3), RN11.8 (R1)
Right Digit 0 E segment: IC6.16 (I/O4), RN11.7 (R2)
Right Digit 0 F segment: IC6.17 (I/O5), RN11.6 (R3)
Right Digit 0 G segment: IC6.18 (I/O6), RN11.5 (R4)
Right Ω Digit 0 A segment: DS2.12 (A-Seg_{(Right)}), RN9.2 (R2)
Right Ω Digit 0 B segment: DS2.11 (B-Seg_{(Right)}), RN9.3 (R3)
Right Ω Digit 0 C segment: DS2.9 (C-Seg_{(Right)}), RN9.4 (R4)
Right Ω Digit 0 D segment: DS2.7 (D-Seg_{(Right)}), RN11.1 (R1)
Right Ω Digit 0 E segment: DS2.6 (E-Seg_{(Right)}), RN11.2 (R2)
Right Ω Digit 0 F segment: DS2.14 (F-Seg_{(Right)}), RN11.3 (R3)
Right Ω Digit 0 G segment: DS2.15 (G-Seg_{(Right)}), RN11.4 (R4)
~Digit Enable: IC6.9 (IN8), IC14.9 (IN8)

Notes on the sheet:
Digit R0 bit 0 (low)
Digit R0 bit 3 (high)
Digit R0 bit 2
Digit L0 bit 0 (low)
Digit L0 bit 2
Digit R0 bit 1
Digit L0 bit 3 (high)
Digit L0 bit 1
