andrewpaterson/HCP65/Kicad/Tester/TSSOP32-14mm Adapter/TSSOP32-14mm Adapter.kicad_sch

## KiCad design Kicad/Tester/TSSOP32-14mm Adapter/TSSOP32-14mm Adapter.kicad_sch (2026-11-01)

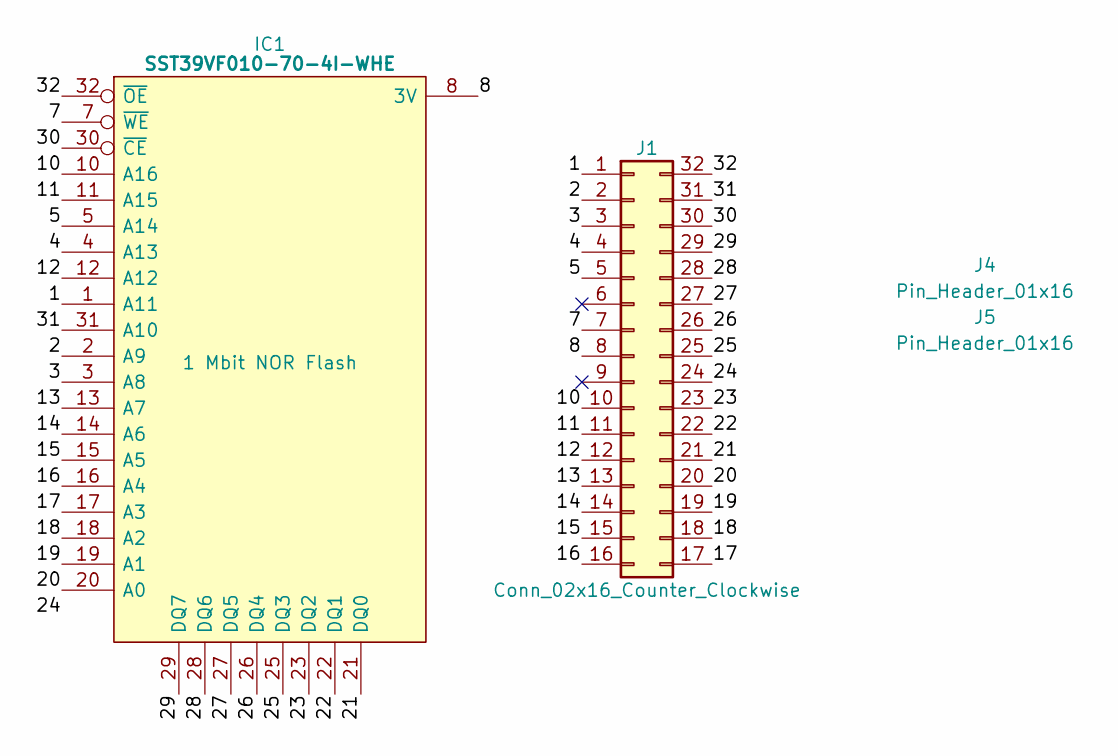
[picture p282: schematic TSSOP32-14mm Adapter.kicad_sch]

Parts:
IC1: SST39VF010-70-4I-WHE; SOP50P1400X120-32N; Manufacturer_Part_Number SST39VF010-70-4I-WHE-T; Mouser Part Number 579-39VF0107IWHET
J1: Conn_02x16_Counter_Clockwise; DIP-32_W15.24mm_Socket
J4, J5: Pin_Header_01x16; PinHeader_1x16_P2.54mm_Vertical

Connections:
1: IC1.1 (A11), J1.1
2: IC1.2 (A9), J1.2
3: IC1.3 (A8), J1.3
4: IC1.4 (A13), J1.4
5: IC1.5 (A14), J1.5
7: IC1.7 (~WE), J1.7
8: IC1.8 (3V), J1.8
10: IC1.10 (A16), J1.10
11: IC1.11 (A15), J1.11
12: IC1.12 (A12), J1.12
13: IC1.13 (A7), J1.13
14: IC1.14 (A6), J1.14
15: IC1.15 (A5), J1.15
16: IC1.16 (A4), J1.16
17: IC1.17 (A3), J1.17
18: IC1.18 (A2), J1.18
19: IC1.19 (A1), J1.19
20: IC1.20 (A0), J1.20
21: IC1.21 (DQ0), J1.21
22: IC1.22 (DQ1), J1.22
23: IC1.23 (DQ2), J1.23
24: IC1.24 (GND), J1.24
25: IC1.25 (DQ3), J1.25
26: IC1.26 (DQ4), J1.26
27: IC1.27 (DQ5), J1.27
28: IC1.28 (DQ6), J1.28
29: IC1.29 (DQ7), J1.29
30: IC1.30 (~CE), J1.30
31: IC1.31 (A10), J1.31
32: IC1.32 (~OE), J1.32
