andrewpaterson/HCP65/Kicad/Boards/Blank/Board 2x06 W15.24/Board 2x06 W15.24.kicad_sch

## KiCad design Kicad/Boards/Blank/Board 2x06 W15.24/Board 2x06 W15.24.kicad_sch (2026-11-01)

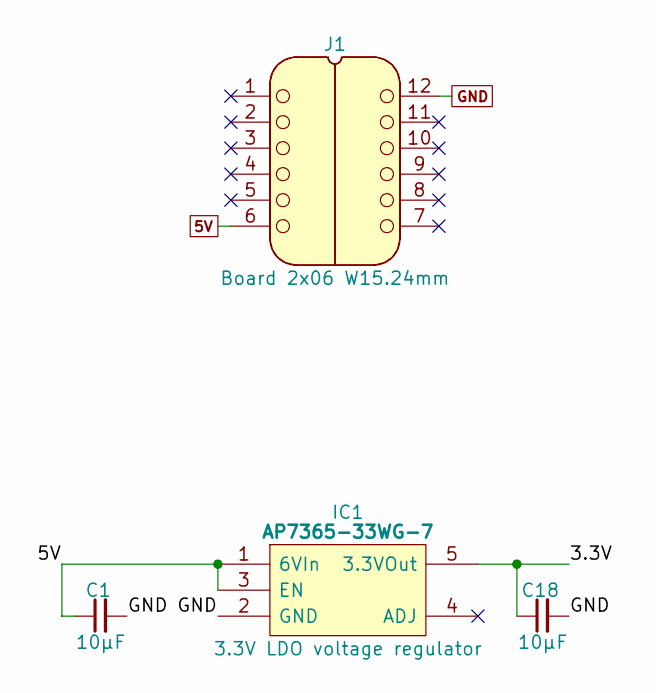
[picture p283: schematic Board 2x06 W15.24.kicad_sch]

Parts:
C1, C18: 10µF; C_0805
IC1: AP7365-33WG-7; SOT95P285X130-5N; Manufacturer_Part_Number AP7365-33WG-7; Mouser Part Number 621-AP7365-33WG-7
J1: Board 2x06 W15.24mm; DIP-12_Board_W15.24mm_Alt

Connections:
3.3V: C18.1, IC1.5 (3.3VOut)
5V: C1.1, IC1.1 (6VIn), IC1.3 (EN), J1.6
GND: C1.2, C18.2, IC1.2 (GND), J1.12
