andrewpaterson/HCP65/Kicad/Boards/Pins/Board 2x06 W15.24/Board 2x06 W15.24.kicad_sch

## KiCad design Kicad/Boards/Pins/Board 2x06 W15.24/Board 2x06 W15.24.kicad_sch (2026-11-01)

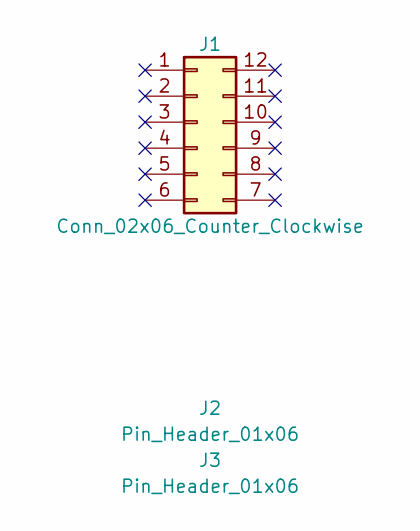
[picture p299: schematic Board 2x06 W15.24.kicad_sch]

Parts:
J1: Conn_02x06_Counter_Clockwise
J2, J3: Pin_Header_01x06; PinHeader_1x06_P2.54mm_Vertical
