andrewpaterson/HCP65/Kicad/Boards/Pins/Board 2x06 W22.86/Board 2x06 W22.86.kicad_sch

## KiCad design Kicad/Boards/Pins/Board 2x06 W22.86/Board 2x06 W22.86.kicad_sch (2026-11-01)

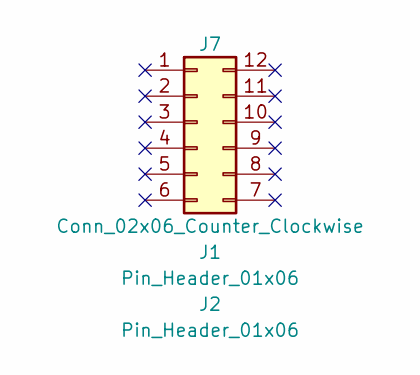
[picture p300: schematic Board 2x06 W22.86.kicad_sch]

Parts:
J1, J2: Pin_Header_01x06; PinHeader_1x06_P2.54mm_Vertical
J7: Conn_02x06_Counter_Clockwise
