andrewpaterson/HCP65/Kicad/Boards/Pins/Board 2x16 W15.24/Board 2x16 W15.24.kicad_sch

## KiCad design Kicad/Boards/Pins/Board 2x16 W15.24/Board 2x16 W15.24.kicad_sch (2026-11-01)

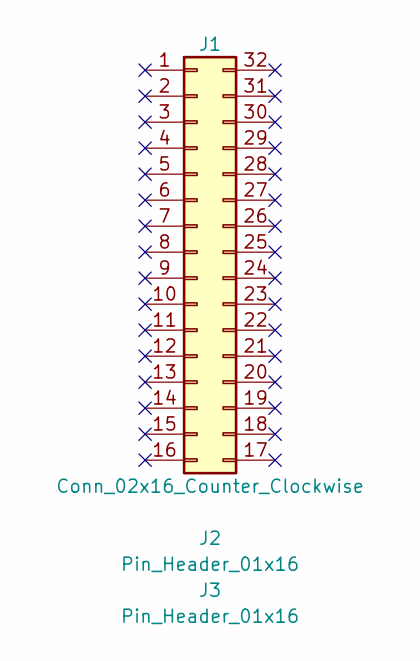
[picture p303: schematic Board 2x16 W15.24.kicad_sch]

Parts:
J1: Conn_02x16_Counter_Clockwise
J2, J3: Pin_Header_01x16; PinHeader_1x16_P2.54mm_Vertical
