andrewpaterson/HCP65/Kicad/Boards/Pins/Board 2x24 W22.86/Board 2x24 W22.86.kicad_sch

## KiCad design Kicad/Boards/Pins/Board 2x24 W22.86/Board 2x24 W22.86.kicad_sch (2026-11-01)

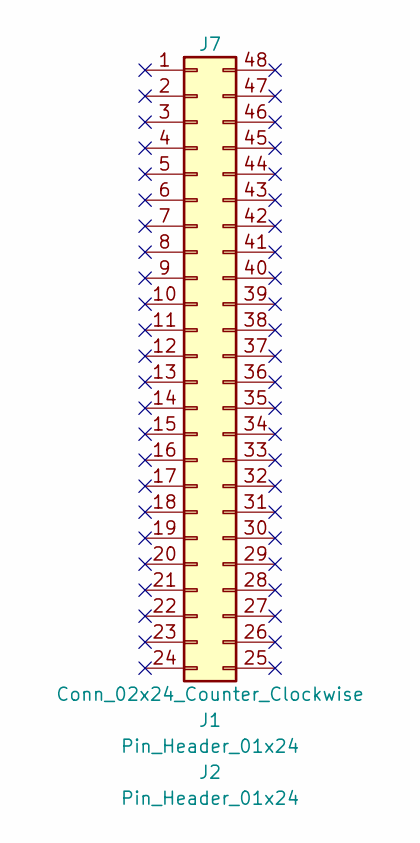
[picture p309: schematic Board 2x24 W22.86.kicad_sch]

Parts:
J1, J2: Pin_Header_01x24; PinHeader_1x24_P2.54mm_Vertical
J7: Conn_02x24_Counter_Clockwise
