andrewpaterson/HCP65/Kicad/Boards/Pins/Board 2x28 W15.24/Board 2x28 W15.24.kicad_sch

## KiCad design Kicad/Boards/Pins/Board 2x28 W15.24/Board 2x28 W15.24.kicad_sch (2026-11-01)

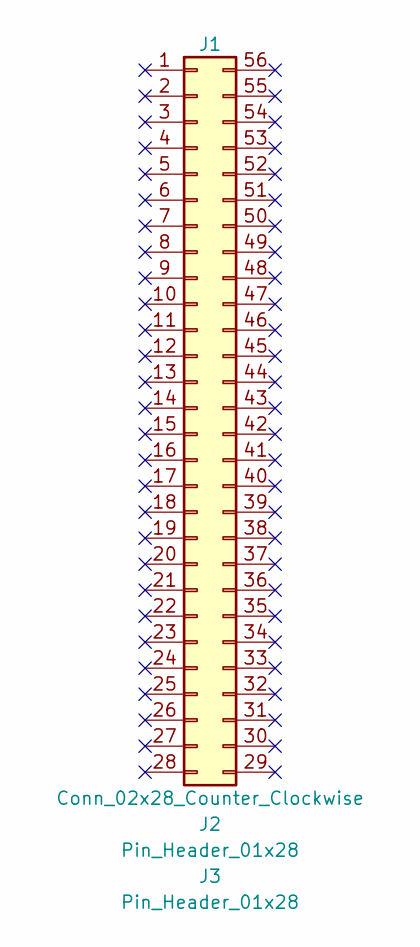
[picture p310: schematic Board 2x28 W15.24.kicad_sch]

Parts:
J1: Conn_02x28_Counter_Clockwise
J2, J3: Pin_Header_01x28; PinHeader_1x28_P2.54mm_Vertical
