andrewpaterson/HCP65/Kicad/Boards/Pins/Board 2x28 W22.86/Board 2x28 W22.86.kicad_sch

## KiCad design Kicad/Boards/Pins/Board 2x28 W22.86/Board 2x28 W22.86.kicad_sch (2026-11-01)

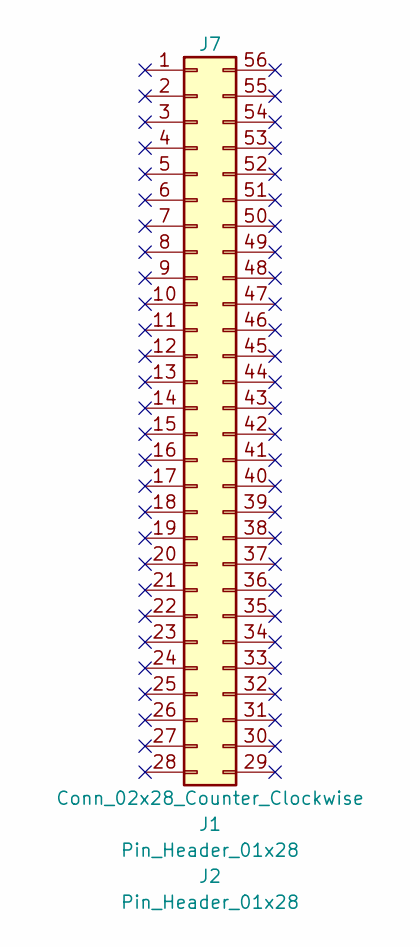
[picture p311: schematic Board 2x28 W22.86.kicad_sch]

Parts:
J1, J2: Pin_Header_01x28; PinHeader_1x28_P2.54mm_Vertical
J7: Conn_02x28_Counter_Clockwise
