andrewpaterson/HCP65/Kicad/Computer/Memory/Memory 1MB/Memory 1MB.kicad_sch

## KiCad design Kicad/Computer/Memory/Memory 1MB/Memory 1MB.kicad_sch (2026-11-01)

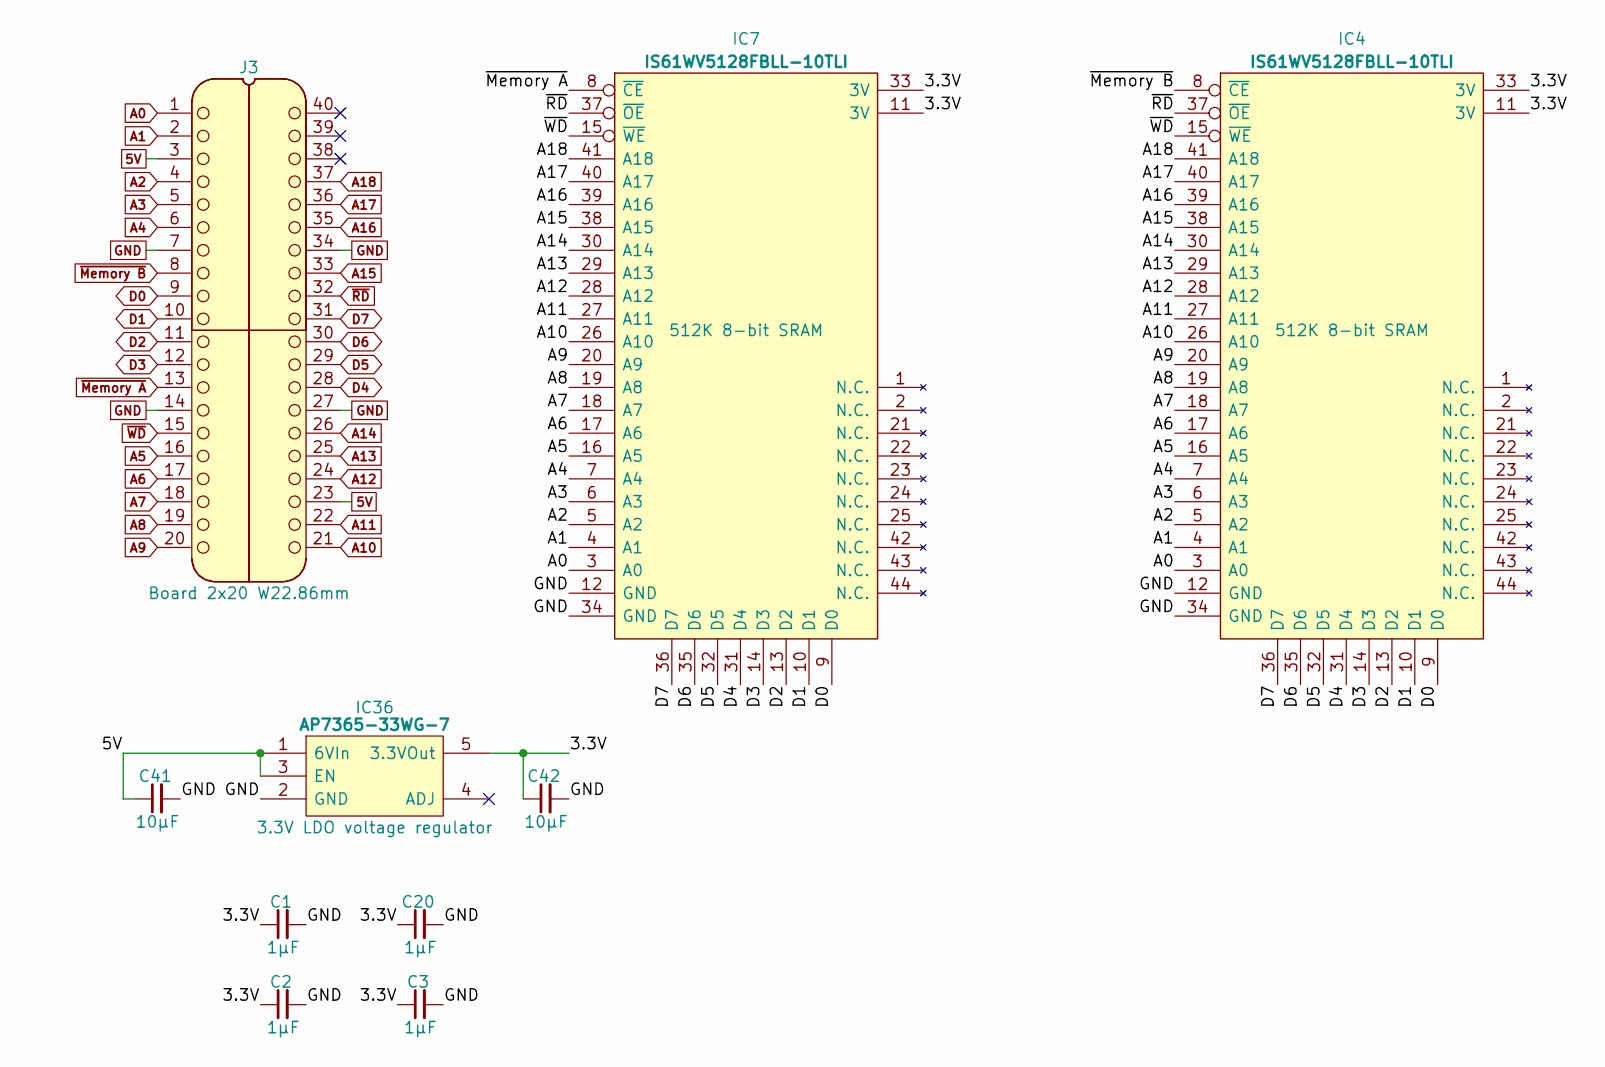
[picture p317: schematic Memory 1MB.kicad_sch]

Parts:
C1, C2, C3, C20: 1μF; C_0805
C41, C42: 10μF; C_0805
IC4, IC7: IS61WV5128FBLL-10TLI; SOP80P1176X120-44N; Manufacturer_Part_Number IS61WV5128FBLL-10TLI
IC36: AP7365-33WG-7; SOT95P285X130-5N; Manufacturer_Part_Number AP7365-33WG-7; Mouser Part Number 621-AP7365-33WG-7
J3: Board 2x20 W22.86mm; DIP-40_Board_W22.86mm

Connections:
3.3V: C1.1, C2.1, C3.1, C20.1, C42.1, IC4.11 (3V), IC4.33 (3V), IC7.11 (3V), IC7.33 (3V), IC36.5 (3.3VOut)
5V: C41.1, IC36.1 (6VIn), IC36.3 (EN), J3.3, J3.23
A0: IC4.3 (A0), IC7.3 (A0), J3.1
A1: IC4.4 (A1), IC7.4 (A1), J3.2
A2: IC4.5 (A2), IC7.5 (A2), J3.4
A3: IC4.6 (A3), IC7.6 (A3), J3.5
A4: IC4.7 (A4), IC7.7 (A4), J3.6
A5: IC4.16 (A5), IC7.16 (A5), J3.16
A6: IC4.17 (A6), IC7.17 (A6), J3.17
A7: IC4.18 (A7), IC7.18 (A7), J3.18
A8: IC4.19 (A8), IC7.19 (A8), J3.19
A9: IC4.20 (A9), IC7.20 (A9), J3.20
A10: IC4.26 (A10), IC7.26 (A10), J3.21
A11: IC4.27 (A11), IC7.27 (A11), J3.22
A12: IC4.28 (A12), IC7.28 (A12), J3.24
A13: IC4.29 (A13), IC7.29 (A13), J3.25
A14: IC4.30 (A14), IC7.30 (A14), J3.26
A15: IC4.38 (A15), IC7.38 (A15), J3.33
A16: IC4.39 (A16), IC7.39 (A16), J3.35
A17: IC4.40 (A17), IC7.40 (A17), J3.36
A18: IC4.41 (A18), IC7.41 (A18), J3.37
D0: IC4.9 (D0), IC7.9 (D0), J3.9
D1: IC4.10 (D1), IC7.10 (D1), J3.10
D2: IC4.13 (D2), IC7.13 (D2), J3.11
D3: IC4.14 (D3), IC7.14 (D3), J3.12
D4: IC4.31 (D4), IC7.31 (D4), J3.28
D5: IC4.32 (D5), IC7.32 (D5), J3.29
D6: IC4.35 (D6), IC7.35 (D6), J3.30
D7: IC4.36 (D7), IC7.36 (D7), J3.31
GND: C1.2, C2.2, C3.2, C20.2, C41.2, C42.2, IC4.12 (GND), IC4.34 (GND), IC7.12 (GND), IC7.34 (GND), IC36.2 (GND), J3.7, J3.14, J3.27, J3.34
~Memory A: IC7.8 (~CE), J3.13
~Memory B: IC4.8 (~CE), J3.8
~RD: IC4.37 (~OE), IC7.37 (~OE), J3.32
~WD: IC4.15 (~WE), IC7.15 (~WE), J3.15
