andrewpaterson/HCP65/Kicad/Computer/Memory/Memory 4MB/Memory 4MB.kicad_sch

## KiCad design Kicad/Computer/Memory/Memory 4MB/Memory 4MB.kicad_sch (2026-11-01)

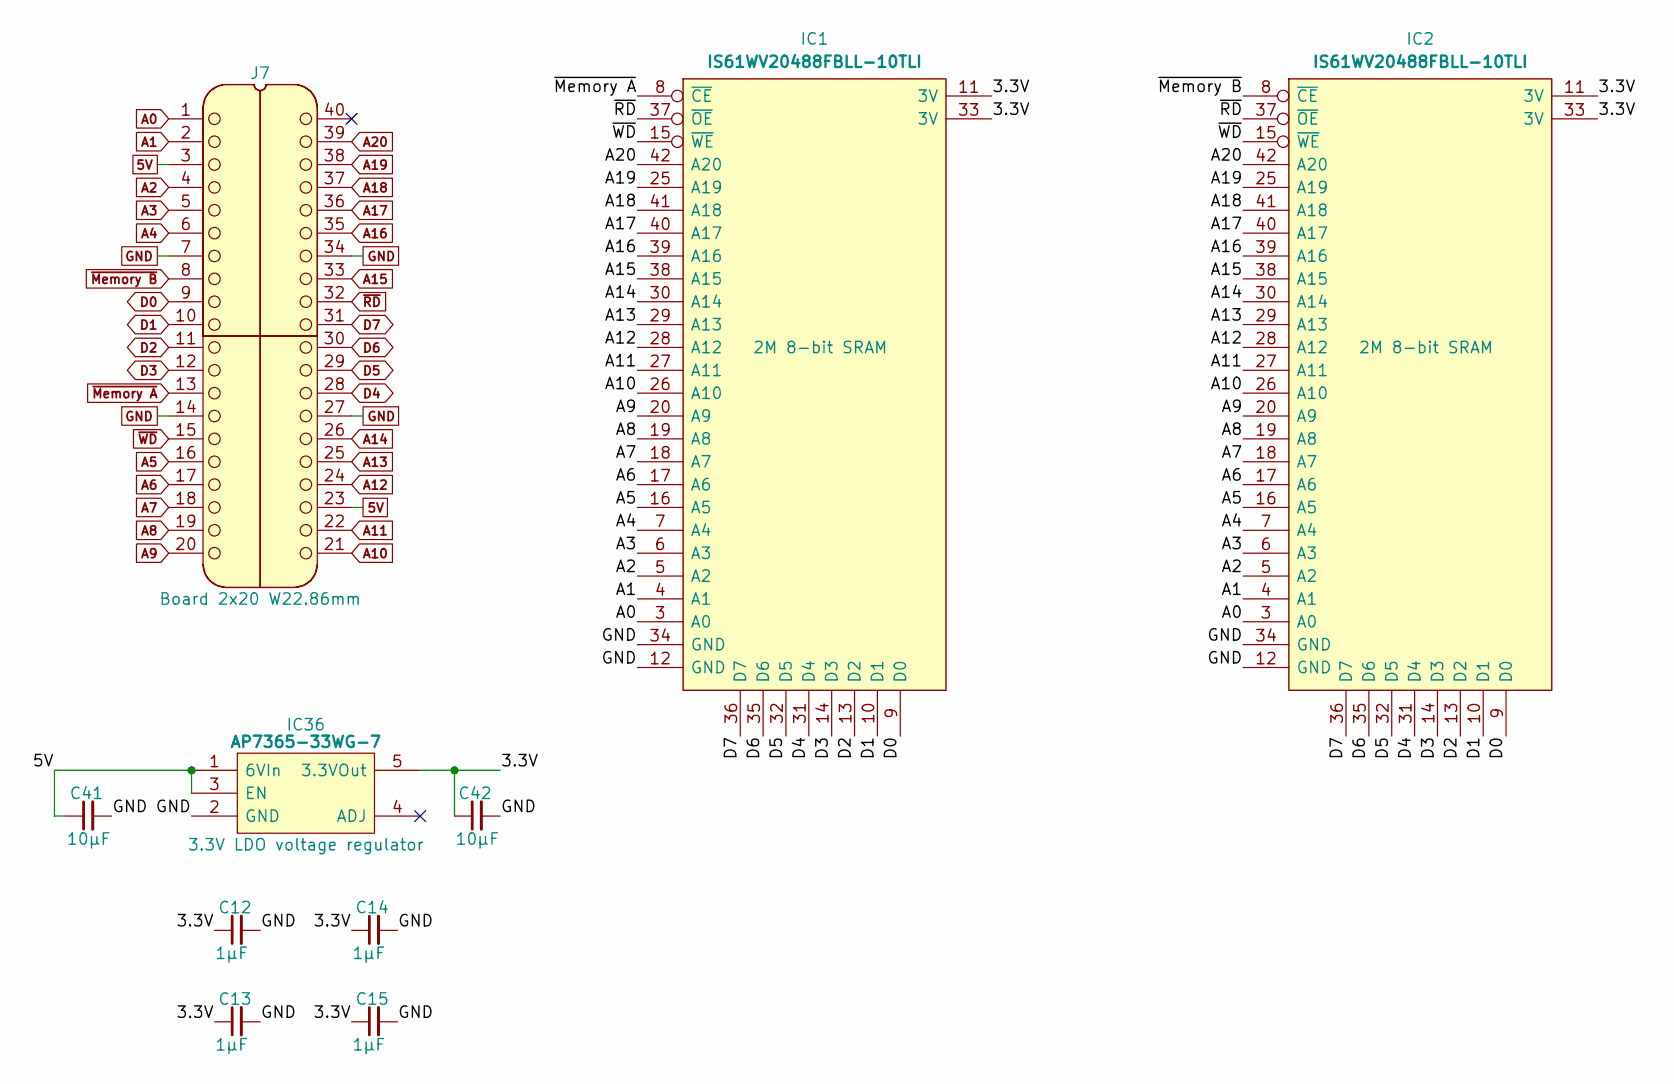
[picture p318: schematic Memory 4MB.kicad_sch]

Parts:
C12, C13, C14, C15: 1µF; C_0805
C41, C42: 10μF; C_0805
IC1, IC2: IS61WV20488FBLL-10TLI; SOP80P1176X120-44N; Mouser Part Number 870-61W20488FBLL10TI
IC36: AP7365-33WG-7; SOT95P285X130-5N; Manufacturer_Part_Number AP7365-33WG-7; Mouser Part Number 621-AP7365-33WG-7
J7: Board 2x20 W22.86mm; DIP-40_Board_W22.86mm

Connections:
3.3V: C12.1, C13.1, C14.1, C15.1, C42.1, IC1.11 (3V), IC1.33 (3V), IC2.11 (3V), IC2.33 (3V), IC36.5 (3.3VOut)
5V: C41.1, IC36.1 (6VIn), IC36.3 (EN), J7.3, J7.23
A0: IC1.3 (A0), IC2.3 (A0), J7.1
A1: IC1.4 (A1), IC2.4 (A1), J7.2
A2: IC1.5 (A2), IC2.5 (A2), J7.4
A3: IC1.6 (A3), IC2.6 (A3), J7.5
A4: IC1.7 (A4), IC2.7 (A4), J7.6
A5: IC1.16 (A5), IC2.16 (A5), J7.16
A6: IC1.17 (A6), IC2.17 (A6), J7.17
A7: IC1.18 (A7), IC2.18 (A7), J7.18
A8: IC1.19 (A8), IC2.19 (A8), J7.19
A9: IC1.20 (A9), IC2.20 (A9), J7.20
A10: IC1.26 (A10), IC2.26 (A10), J7.21
A11: IC1.27 (A11), IC2.27 (A11), J7.22
A12: IC1.28 (A12), IC2.28 (A12), J7.24
A13: IC1.29 (A13), IC2.29 (A13), J7.25
A14: IC1.30 (A14), IC2.30 (A14), J7.26
A15: IC1.38 (A15), IC2.38 (A15), J7.33
A16: IC1.39 (A16), IC2.39 (A16), J7.35
A17: IC1.40 (A17), IC2.40 (A17), J7.36
A18: IC1.41 (A18), IC2.41 (A18), J7.37
A19: IC1.25 (A19), IC2.25 (A19), J7.38
A20: IC1.42 (A20), IC2.42 (A20), J7.39
D0: IC1.9 (D0), IC2.9 (D0), J7.9
D1: IC1.10 (D1), IC2.10 (D1), J7.10
D2: IC1.13 (D2), IC2.13 (D2), J7.11
D3: IC1.14 (D3), IC2.14 (D3), J7.12
D4: IC1.31 (D4), IC2.31 (D4), J7.28
D5: IC1.32 (D5), IC2.32 (D5), J7.29
D6: IC1.35 (D6), IC2.35 (D6), J7.30
D7: IC1.36 (D7), IC2.36 (D7), J7.31
GND: C12.2, C13.2, C14.2, C15.2, C41.2, C42.2, IC1.12 (GND), IC1.34 (GND), IC2.12 (GND), IC2.34 (GND), IC36.2 (GND), J7.7, J7.14, J7.27, J7.34
~Memory A: IC1.8 (~CE), J7.13
~Memory B: IC2.8 (~CE), J7.8
~RD: IC1.37 (~OE), IC2.37 (~OE), J7.32
~WD: IC1.15 (~WE), IC2.15 (~WE), J7.15
