andrewpaterson/HCP65/Kicad/Computer/Memory/Memory Board/Memory Board.kicad_sch

## KiCad design Kicad/Computer/Memory/Memory Board/Memory Board.kicad_sch (2026-11-07)

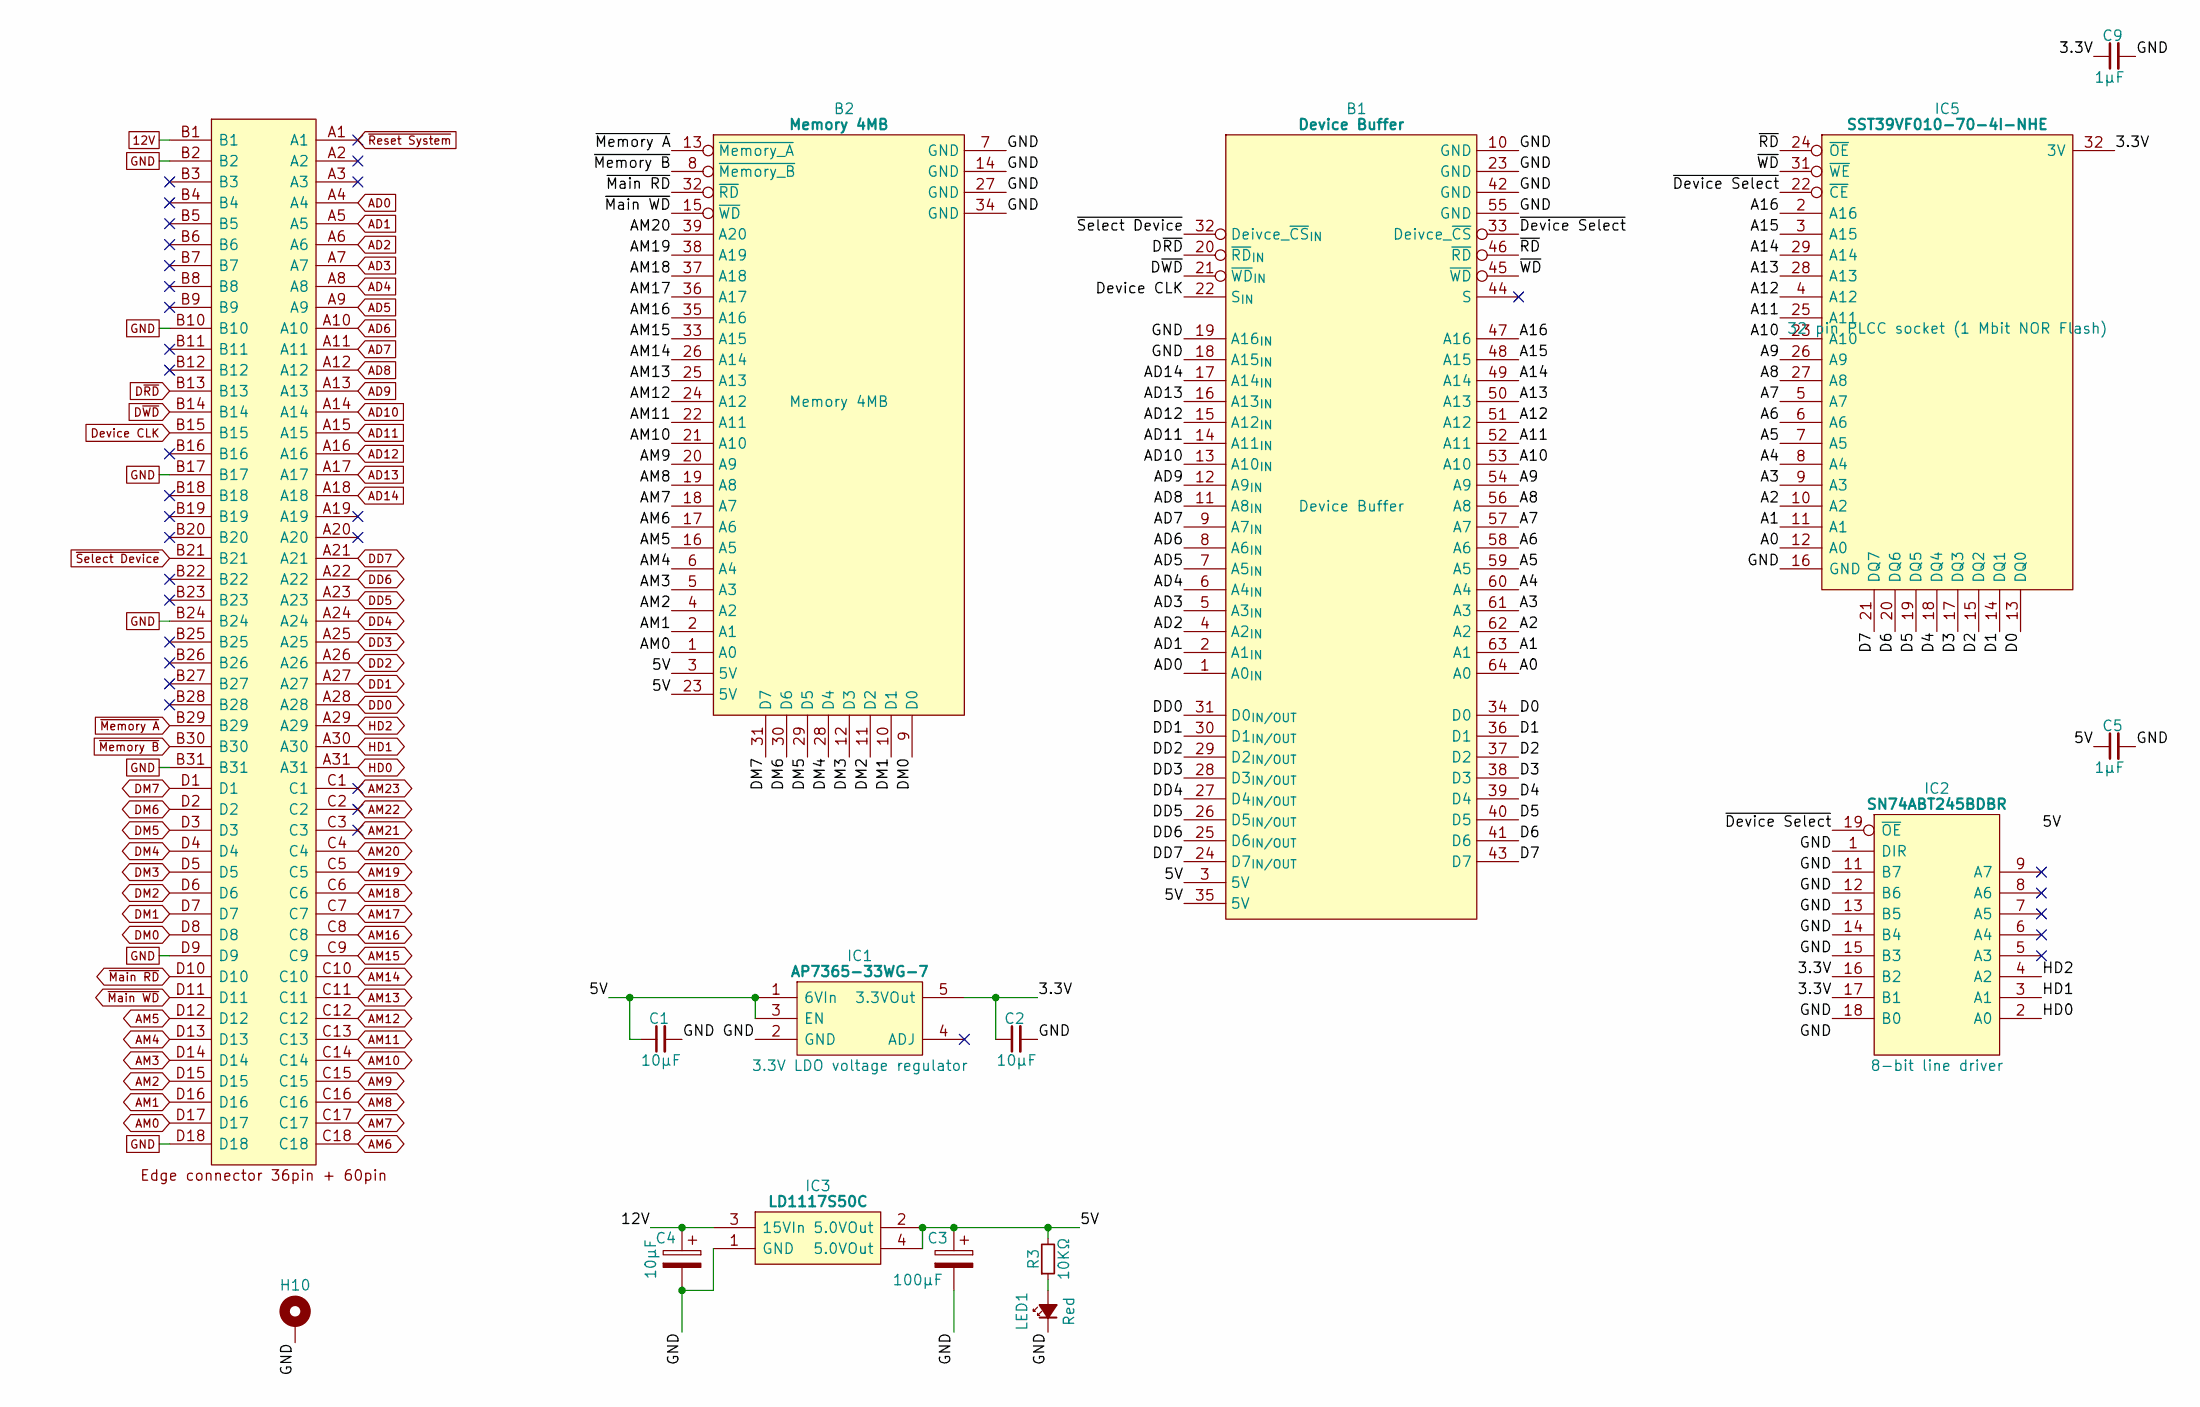
[picture p319: schematic Memory Board.kicad_sch]

Parts:
B1: Device Buffer; HCP65_Device_Buffer
B2: Memory 4MB; HCP65_Memory_4MB
C1, C2: 10µF; C_0805
C3: 100μF; CP_Radial_D4.0mm_P2.00mm
C4: 10μF; CP_Radial_D4.0mm_P2.00mm
C5, C9: 1µF; C_0805
H10: MountingHole_Pad; HCP65_MountingHole_M3_
IC1: AP7365-33WG-7; SOT95P285X130-5N; Manufacturer_Part_Number AP7365-33WG-7; Mouser Part Number 621-AP7365-33WG-7
IC2: SN74ABT245BDBR; SOP65P780X200-20N; Manufacturer_Part_Number SN74ABT245BDBR; Mouser Part Number 595-SN74ABT245BDBR
IC3: LD1117S50C; LD1117S33C; Manufacturer_Part_Number LD1117S50C
IC5: SST39VF010-70-4I-NHE; 5408803224008; Manufacturer_Part_Number SST39VF010-70-4I-NHE
J1: 395-098-520-350; 98pin Edge Connector; Manufacturer_Part_Number 395-098-520-350; Mouser Part Number 587-395-098-520-350
LED1: Red; LED_D5.0mm
R3: 10KΩ; R_0805

Connections:
3.3V: C2.1, C9.1, IC1.5 (3.3VOut), IC2.16 (B2), IC2.17 (B1), IC5.32 (3V)
5V: B1.3 (5V), B1.35 (5V), B2.3 (5V), B2.23 (5V), C1.1, C3.1, C5.1, IC1.1 (6VIn), IC1.3 (EN), IC2.20 (5V), IC3.2 (5.0VOut), IC3.4 (5.0VOut), R3.2
12V: C4.1, IC3.3 (15VIn), J1.B1
A0: B1.64 (A0), IC5.12 (A0)
A1: B1.63 (A1), IC5.11 (A1)
A2: B1.62 (A2), IC5.10 (A2)
A3: B1.61 (A3), IC5.9 (A3)
A4: B1.60 (A4), IC5.8 (A4)
A5: B1.59 (A5), IC5.7 (A5)
A6: B1.58 (A6), IC5.6 (A6)
A7: B1.57 (A7), IC5.5 (A7)
A8: B1.56 (A8), IC5.27 (A8)
A9: B1.54 (A9), IC5.26 (A9)
A10: B1.53 (A10), IC5.23 (A10)
A11: B1.52 (A11), IC5.25 (A11)
A12: B1.51 (A12), IC5.4 (A12)
A13: B1.50 (A13), IC5.28 (A13)
A14: B1.49 (A14), IC5.29 (A14)
A15: B1.48 (A15), IC5.3 (A15)
A16: B1.47 (A16), IC5.2 (A16)
AD0: B1.1 (A0_{IN}), J1.A4
AD1: B1.2 (A1_{IN}), J1.A5
AD2: B1.4 (A2_{IN}), J1.A6
AD3: B1.5 (A3_{IN}), J1.A7
AD4: B1.6 (A4_{IN}), J1.A8
AD5: B1.7 (A5_{IN}), J1.A9
AD6: B1.8 (A6_{IN}), J1.A10
AD7: B1.9 (A7_{IN}), J1.A11
AD8: B1.11 (A8_{IN}), J1.A12
AD9: B1.12 (A9_{IN}), J1.A13
AD10: B1.13 (A10_{IN}), J1.A14
AD11: B1.14 (A11_{IN}), J1.A15
AD12: B1.15 (A12_{IN}), J1.A16
AD13: B1.16 (A13_{IN}), J1.A17
AD14: B1.17 (A14_{IN}), J1.A18
AM0: B2.1 (A0), J1.D17
AM1: B2.2 (A1), J1.D16
AM2: B2.4 (A2), J1.D15
AM3: B2.5 (A3), J1.D14
AM4: B2.6 (A4), J1.D13
AM5: B2.16 (A5), J1.D12
AM6: B2.17 (A6), J1.C18
AM7: B2.18 (A7), J1.C17
AM8: B2.19 (A8), J1.C16
AM9: B2.20 (A9), J1.C15
AM10: B2.21 (A10), J1.C14
AM11: B2.22 (A11), J1.C13
AM12: B2.24 (A12), J1.C12
AM13: B2.25 (A13), J1.C11
AM14: B2.26 (A14), J1.C10
AM15: B2.33 (A15), J1.C9
AM16: B2.35 (A16), J1.C8
AM17: B2.36 (A17), J1.C7
AM18: B2.37 (A18), J1.C6
AM19: B2.38 (A19), J1.C5
AM20: B2.39 (A20), J1.C4
AM21: J1.C3
AM22: J1.C2
AM23: J1.C1
D0: B1.34 (D0), IC5.13 (DQ0)
D1: B1.36 (D1), IC5.14 (DQ1)
D2: B1.37 (D2), IC5.15 (DQ2)
D3: B1.38 (D3), IC5.17 (DQ3)
D4: B1.39 (D4), IC5.18 (DQ4)
D5: B1.40 (D5), IC5.19 (DQ5)
D6: B1.41 (D6), IC5.20 (DQ6)
D7: B1.43 (D7), IC5.21 (DQ7)
DD0: B1.31 (D0_{IN/OUT}), J1.A28
DD1: B1.30 (D1_{IN/OUT}), J1.A27
DD2: B1.29 (D2_{IN/OUT}), J1.A26
DD3: B1.28 (D3_{IN/OUT}), J1.A25
DD4: B1.27 (D4_{IN/OUT}), J1.A24
DD5: B1.26 (D5_{IN/OUT}), J1.A23
DD6: B1.25 (D6_{IN/OUT}), J1.A22
DD7: B1.24 (D7_{IN/OUT}), J1.A21
DM0: B2.9 (D0), J1.D8
DM1: B2.10 (D1), J1.D7
DM2: B2.11 (D2), J1.D6
DM3: B2.12 (D3), J1.D5
DM4: B2.28 (D4), J1.D4
DM5: B2.29 (D5), J1.D3
DM6: B2.30 (D6), J1.D2
DM7: B2.31 (D7), J1.D1
Device CLK: B1.22 (S_{IN}), J1.B15
D~RD: B1.20 (~RD_{IN}), J1.B13
D~WD: B1.21 (~WD_{IN}), J1.B14
GND: B1.10 (GND), B1.18 (A15_{IN}), B1.19 (A16_{IN}), B1.23 (GND), B1.42 (GND), B1.55 (GND), B2.7 (GND), B2.14 (GND), B2.27 (GND), B2.34 (GND), C1.2, C2.2, C3.2, C4.2, C5.2, C9.2, H10.1, IC1.2 (GND), IC2.1 (DIR), IC2.10 (GND), IC2.11 (B7), IC2.12 (B6), IC2.13 (B5), IC2.14 (B4), IC2.15 (B3), IC2.18 (B0), IC3.1 (GND), IC5.16 (GND), J1.B2, J1.B10, J1.B17, J1.B24, J1.B31, J1.D9, J1.D18, LED1.1 (K)
HD0: IC2.2 (A0), J1.A31
HD1: IC2.3 (A1), J1.A30
HD2: IC2.4 (A2), J1.A29
unnamed: LED1.2 (A), R3.1
~Device Select: B1.33 (Deivce_~CS), IC2.19 (~OE), IC5.22 (~CE)
~Main RD: B2.32 (~RD), J1.D10
~Main WD: B2.15 (~WD), J1.D11
~Memory A: B2.13 (~Memory_A), J1.B29
~Memory B: B2.8 (~Memory_B), J1.B30
~RD: B1.46 (~RD), IC5.24 (~OE)
~Reset System: J1.A1
~Select Device: B1.32 (Deivce_~CS_{IN}), J1.B21
~WD: B1.45 (~WD), IC5.31 (~WE)
