andrewpaterson/HCP65/Kicad/Computer/SD Card/SD Card Board/SD Card Board.kicad_sch

## KiCad design Kicad/Computer/SD Card/SD Card Board/SD Card Board.kicad_sch (2026-11-06)

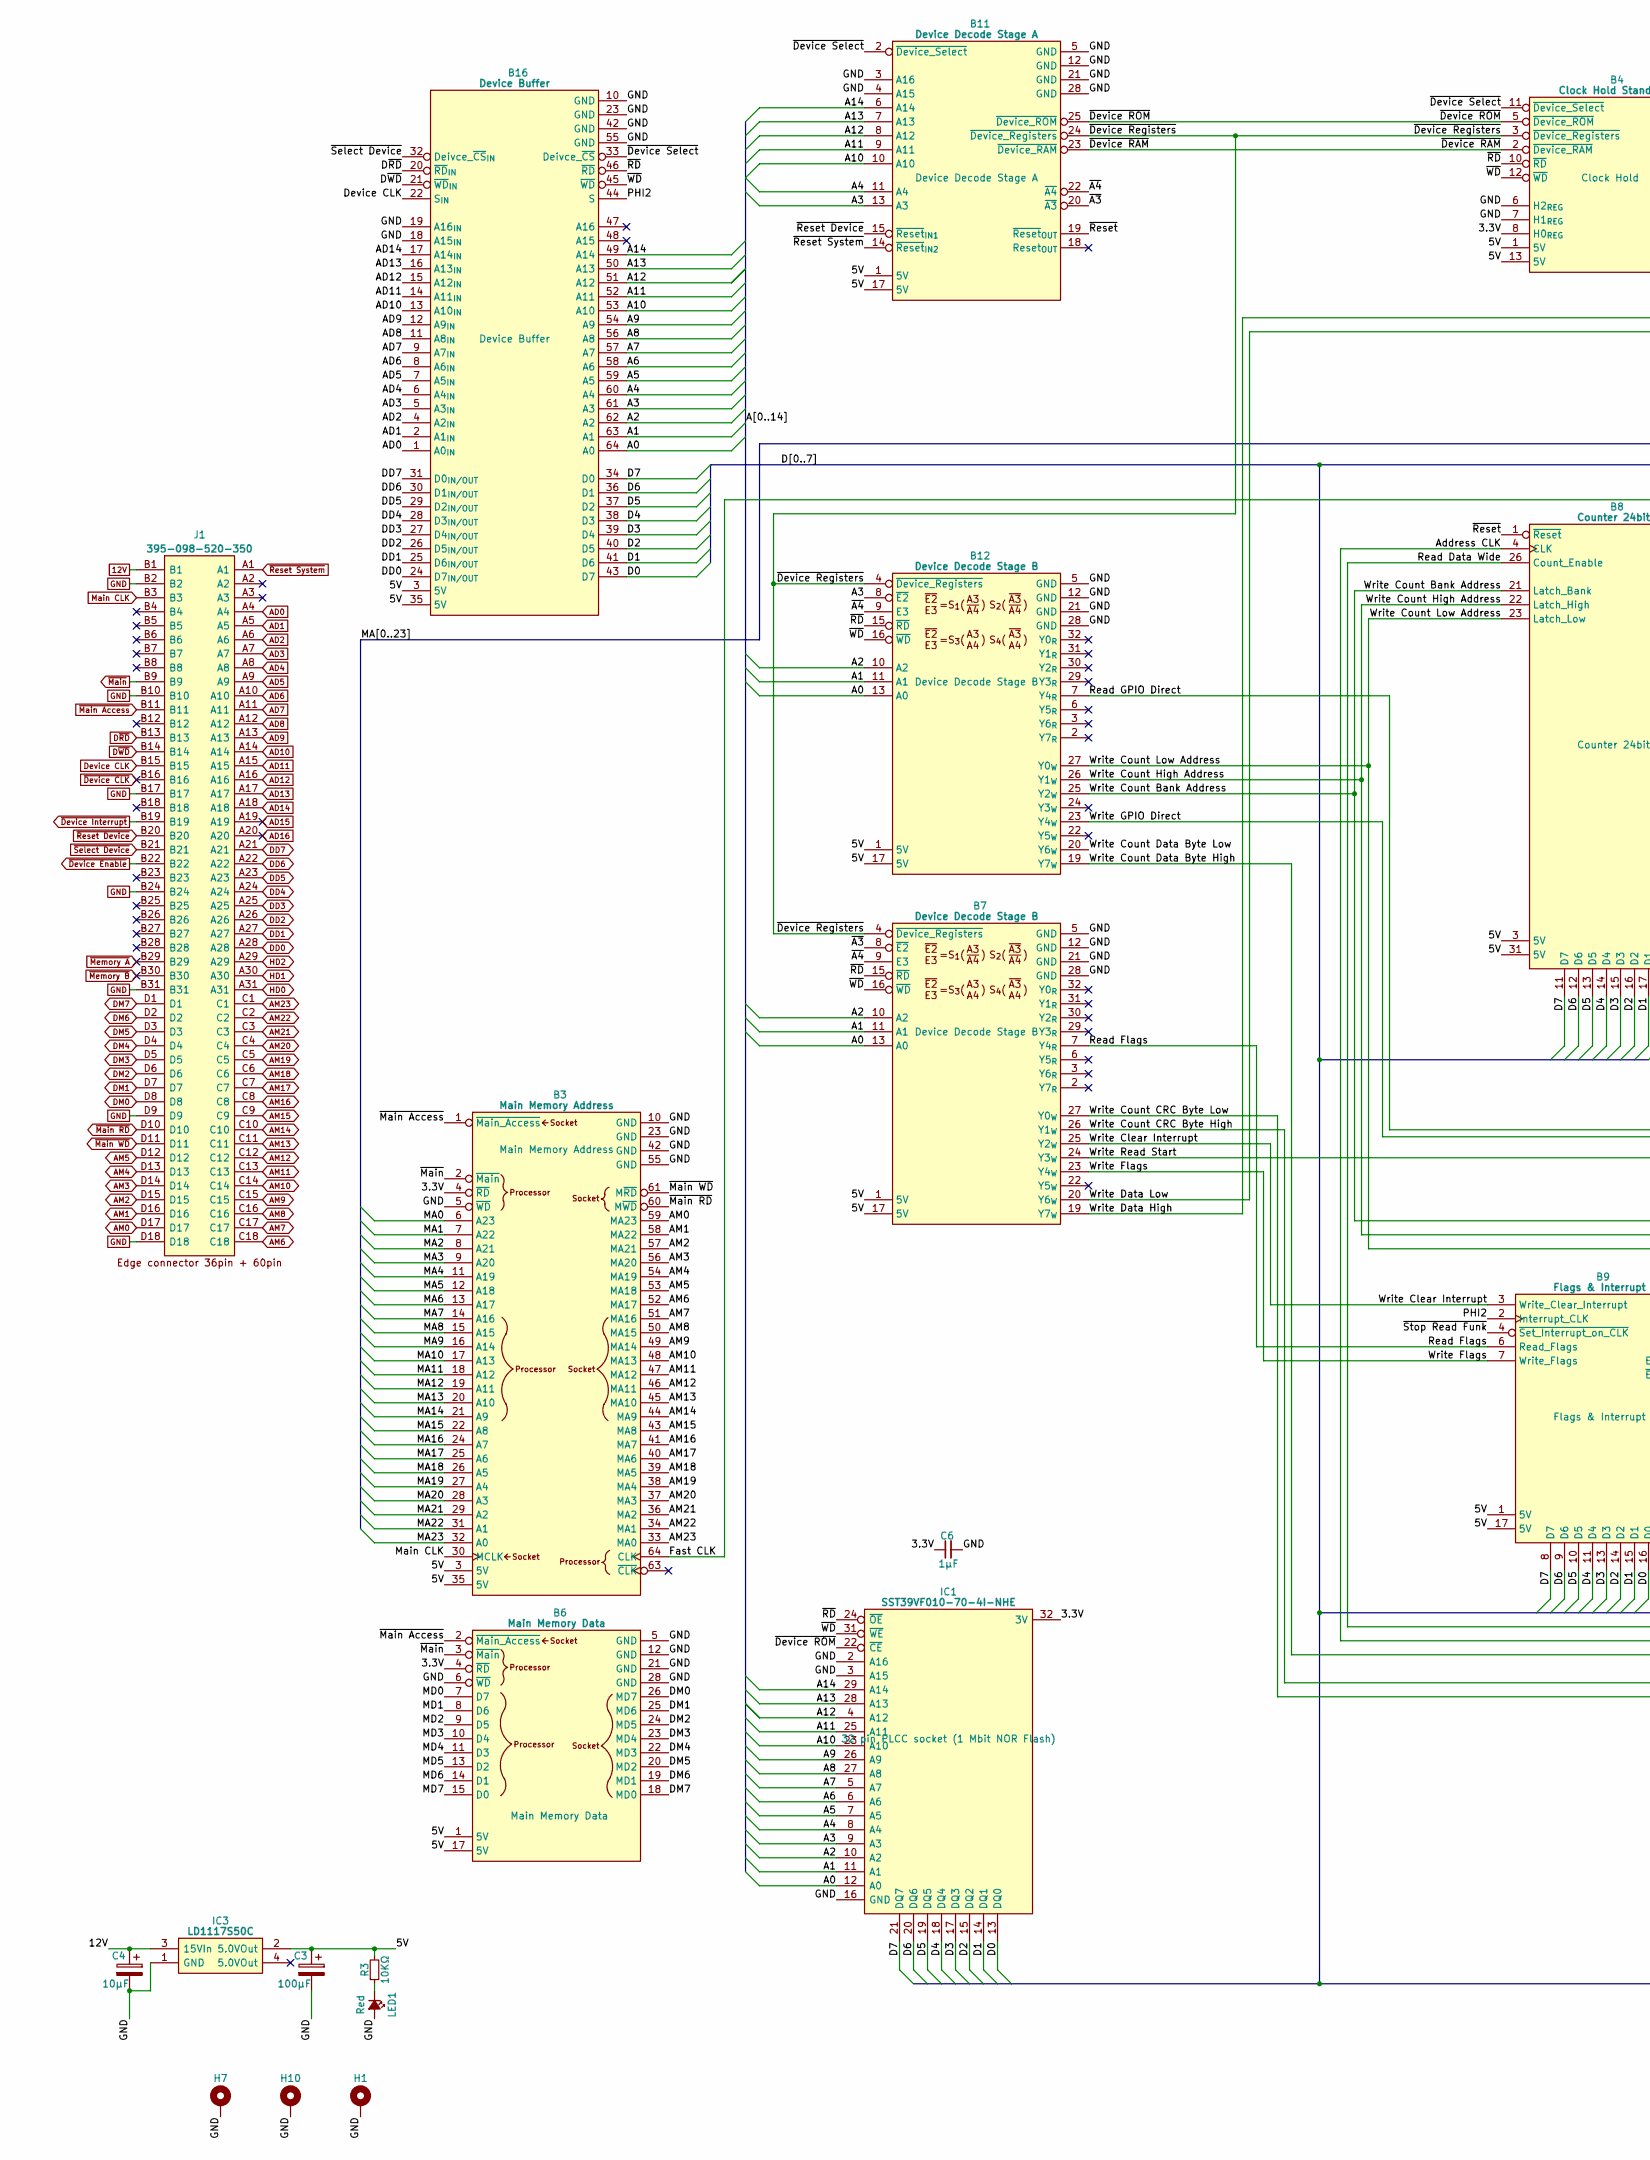
[picture p321: schematic SD Card Board.kicad_sch, part in row 1, column 1]

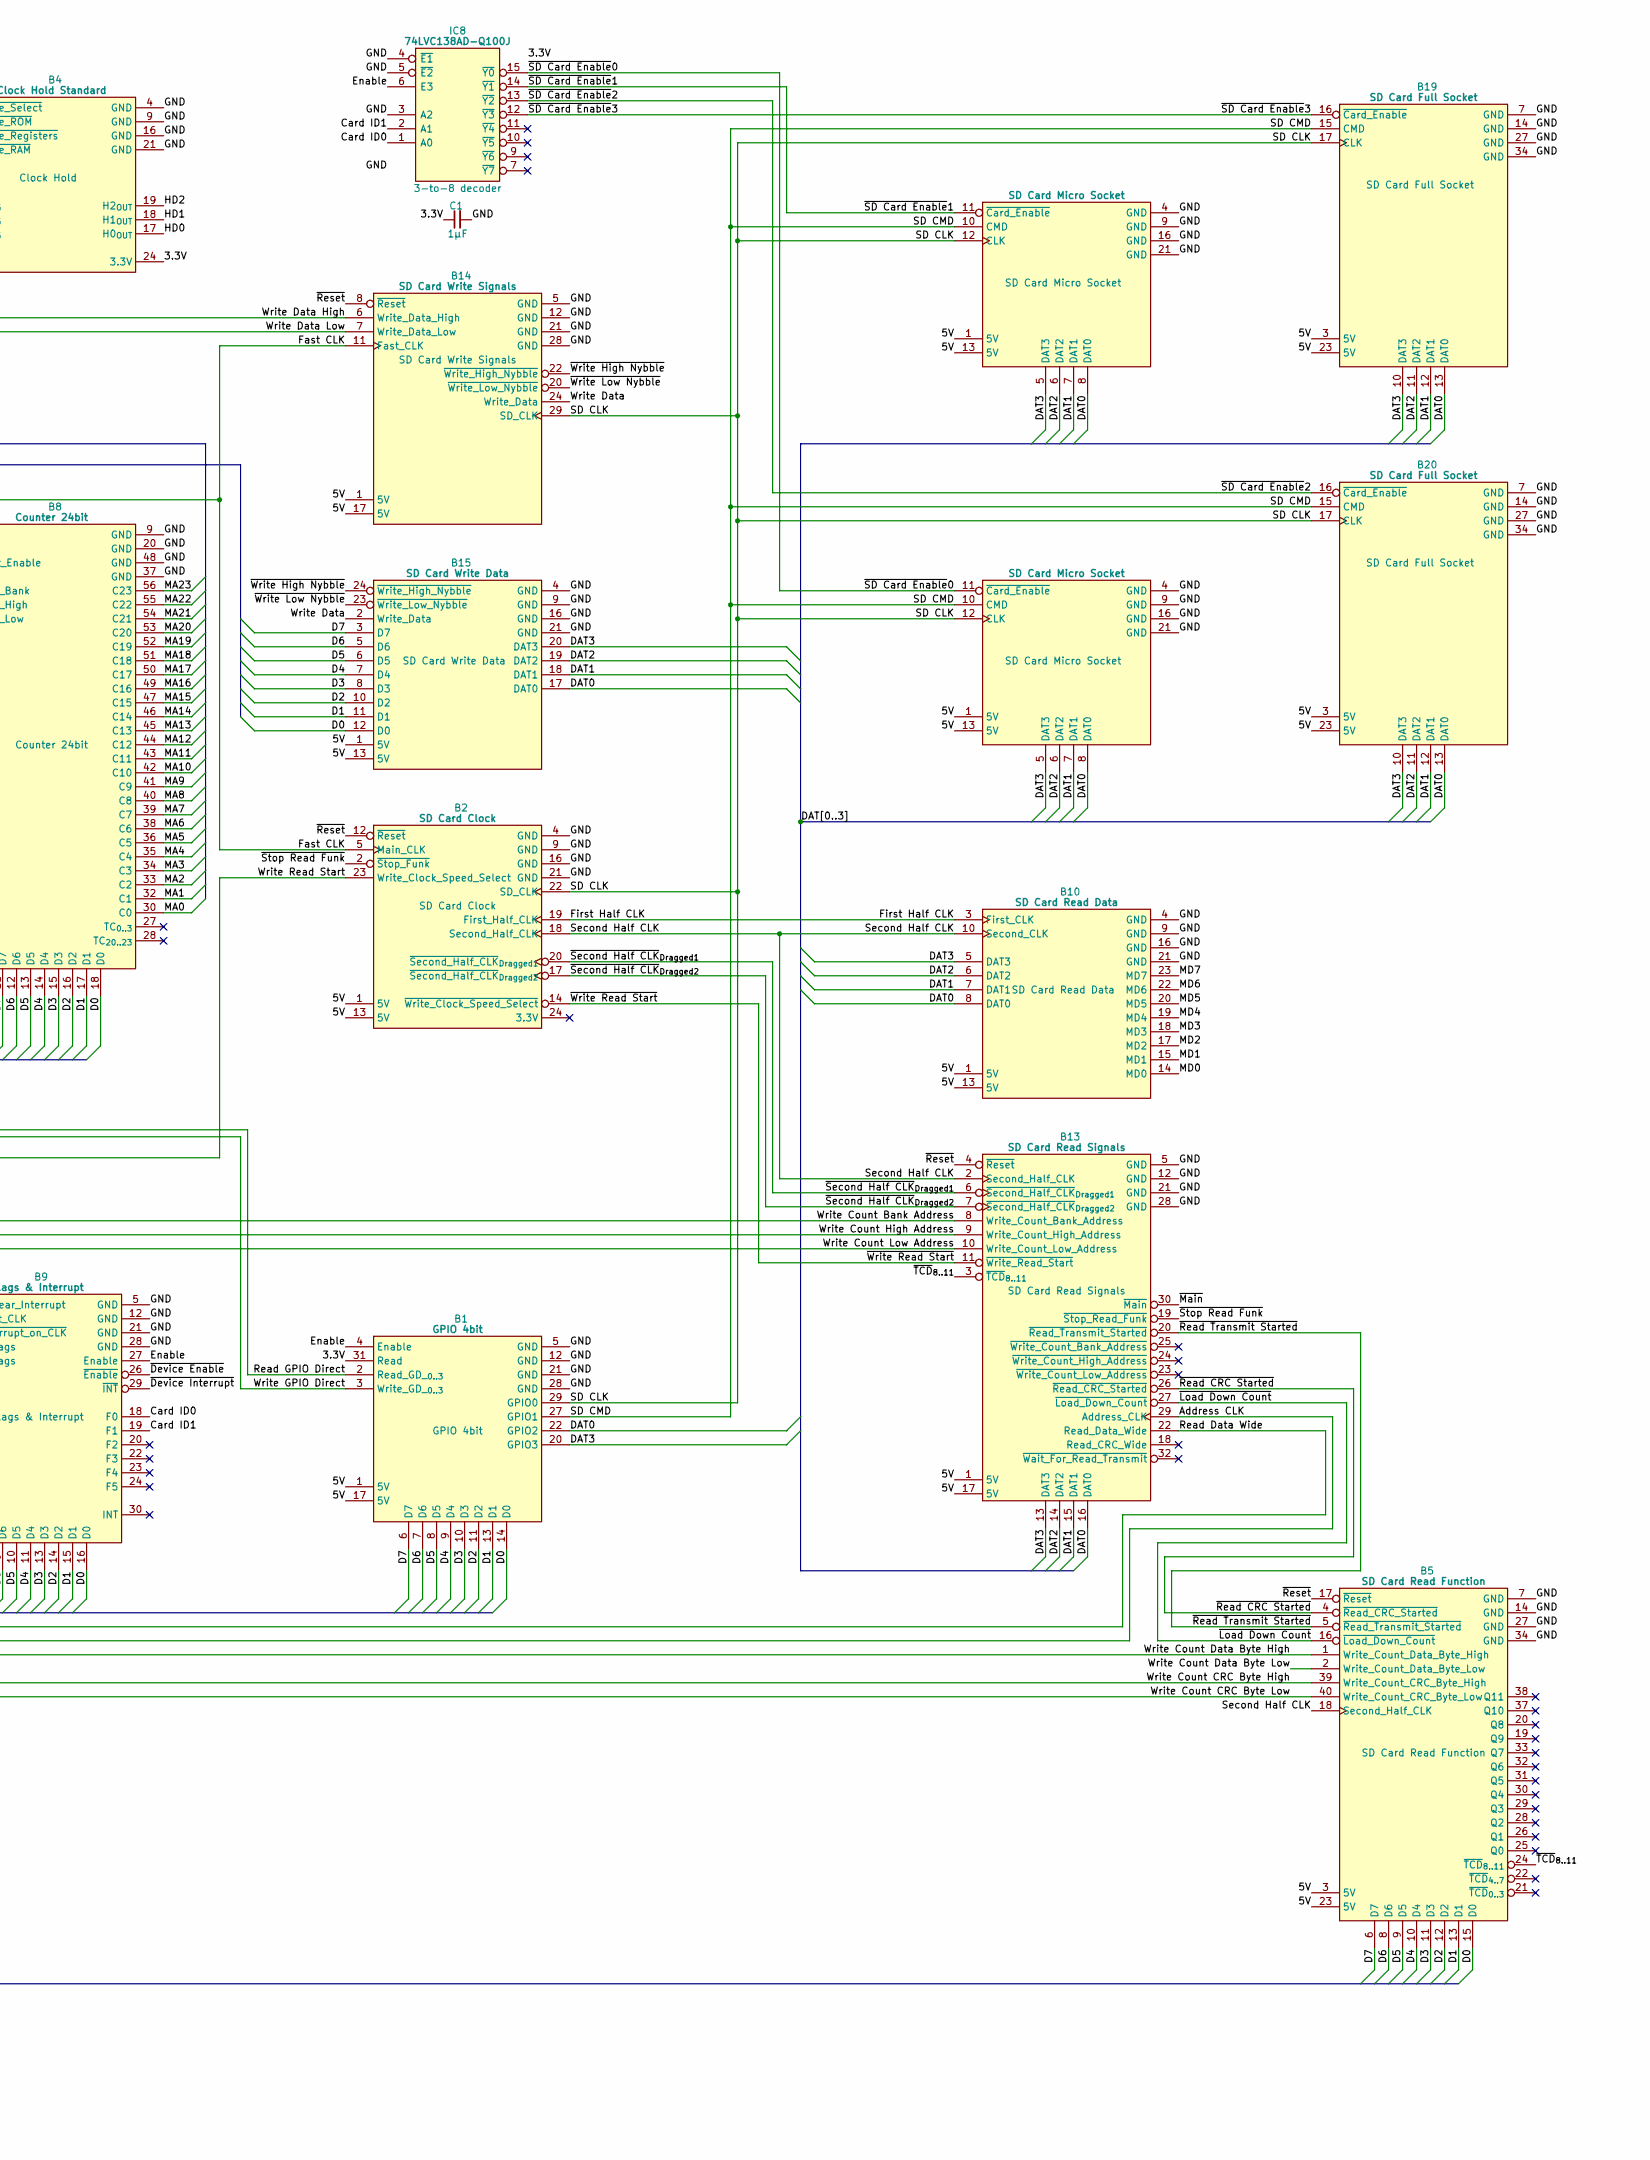
[picture p322: schematic SD Card Board.kicad_sch, part in row 1, column 2]

Parts:
B1: GPIO 4bit; HCP65_GPIO_4bit
B2: SD Card Clock; HCP65_SD_Card_Clock
B3: Main Memory Address; HCP65_Main_Memory_Address
B4: Clock Hold Standard; HCP65_Clock_Hold_Standard
B5: SD Card Read Function; HCP65_SD_Card_Read_Function
B6: Main Memory Data; HCP65_Main_Memory_Data
B7, B12: Device Decode Stage B; HCP65_Device_Decode_Stage_B
B8: Counter 24bit; HCP65_Counter_24bit
B9: Flags & Interrupt; HCP65_Flags_Interrupt
B10: SD Card Read Data; HCP65_SD_Card_Read_Data
B11: Device Decode Stage A; HCP65_Device_Decode_Stage_A
B13: SD Card Read Signals; HCP65_SD_Card_Read_Signals
B14: SD Card Write Signals; HCP65_SD_Card_Write_Signals
B15: SD Card Write Data; HCP65_SD_Card_Write_Data
B16: Device Buffer; HCP65_Device_Buffer
B17, B18: SD Card Micro Socket; HCP65_SD_Card_Micro_Socket
B19, B20: SD Card Full Socket; HCP65_SD_Card_Full_Socket
C1, C6: 1μF; C_0805
C3: 100μF; CP_Radial_D4.0mm_P2.00mm
C4: 10μF; CP_Radial_D4.0mm_P2.00mm
H1, H7, H10: MountingHole_Pad; HCP65_MountingHole_M3_
IC1: SST39VF010-70-4I-NHE; 5408803224008; Manufacturer_Part_Number SST39VF010-70-4I-NHE
IC3: LD1117S50C; LD1117S33C; Manufacturer_Part_Number LD1117S50C
IC8: 74LVC138AD-Q100J; SOIC127P600X175-16N; Mouser Part Number 771-74LVC138ADQ100J
J1: 395-098-520-350; 98pin Edge Connector; Manufacturer_Part_Number 395-098-520-350; Mouser Part Number 587-395-098-520-350
LED1: Red; LED_D5.0mm
R3: 10KΩ; R_0805

Connections:
3.3V: B1.31 (Read), B3.4 (~RD), B4.8 (H0_{REG}), B4.24 (3.3V), B6.4 (~RD), C1.1, C6.1, IC1.32 (3V), IC8.16 (3V)
5V: B1.1 (5V), B1.17 (5V), B2.1 (5V), B2.13 (5V), B3.3 (5V), B3.35 (5V), B4.1 (5V), B4.13 (5V), B5.3 (5V), B5.23 (5V), B6.1 (5V), B6.17 (5V), B7.1 (5V), B7.17 (5V), B8.3 (5V), B8.31 (5V), B9.1 (5V), B9.17 (5V), B10.1 (5V), B10.13 (5V), B11.1 (5V), B11.17 (5V), B12.1 (5V), B12.17 (5V), B13.1 (5V), B13.17 (5V), B14.1 (5V), B14.17 (5V), B15.1 (5V), B15.13 (5V), B16.3 (5V), B16.35 (5V), B17.1 (5V), B17.13 (5V), B18.1 (5V), B18.13 (5V), B19.3 (5V), B19.23 (5V), B20.3 (5V), B20.23 (5V), C3.1, IC3.2 (5.0VOut), R3.2
12V: C4.1, IC3.3 (15VIn), J1.B1
A0: B7.13 (A0), B12.13 (A0), B16.64 (A0), IC1.12 (A0)
A1: B7.11 (A1), B12.11 (A1), B16.63 (A1), IC1.11 (A1)
A2: B7.10 (A2), B12.10 (A2), B16.62 (A2), IC1.10 (A2)
A3: B11.13 (A3), B12.8 (~E2), B16.61 (A3), IC1.9 (A3)
A4: B11.11 (A4), B16.60 (A4), IC1.8 (A4)
A5: B16.59 (A5), IC1.7 (A5)
A6: B16.58 (A6), IC1.6 (A6)
A7: B16.57 (A7), IC1.5 (A7)
A8: B16.56 (A8), IC1.27 (A8)
A9: B16.54 (A9), IC1.26 (A9)
A10: B11.10 (A10), B16.53 (A10), IC1.23 (A10)
A11: B11.9 (A11), B16.52 (A11), IC1.25 (A11)
A12: B11.8 (A12), B16.51 (A12), IC1.4 (A12)
A13: B11.7 (A13), B16.50 (A13), IC1.28 (A13)
A14: B11.6 (A14), B16.49 (A14), IC1.29 (A14)
AD0: B16.1 (A0_{IN}), J1.A4
AD1: B16.2 (A1_{IN}), J1.A5
AD2: B16.4 (A2_{IN}), J1.A6
AD3: B16.5 (A3_{IN}), J1.A7
AD4: B16.6 (A4_{IN}), J1.A8
AD5: B16.7 (A5_{IN}), J1.A9
AD6: B16.8 (A6_{IN}), J1.A10
AD7: B16.9 (A7_{IN}), J1.A11
AD8: B16.11 (A8_{IN}), J1.A12
AD9: B16.12 (A9_{IN}), J1.A13
AD10: B16.13 (A10_{IN}), J1.A14
AD11: B16.14 (A11_{IN}), J1.A15
AD12: B16.15 (A12_{IN}), J1.A16
AD13: B16.16 (A13_{IN}), J1.A17
AD14: B16.17 (A14_{IN}), J1.A18
AD15: J1.A19
AD16: J1.A20
AM0: B3.59 (MA23), J1.D17
AM1: B3.58 (MA22), J1.D16
AM2: B3.57 (MA21), J1.D15
AM3: B3.56 (MA20), J1.D14
AM4: B3.54 (MA19), J1.D13
AM5: B3.53 (MA18), J1.D12
AM6: B3.52 (MA17), J1.C18
AM7: B3.51 (MA16), J1.C17
AM8: B3.50 (MA15), J1.C16
AM9: B3.49 (MA14), J1.C15
AM10: B3.48 (MA13), J1.C14
AM11: B3.47 (MA12), J1.C13
AM12: B3.46 (MA11), J1.C12
AM13: B3.45 (MA10), J1.C11
AM14: B3.44 (MA9), J1.C10
AM15: B3.43 (MA8), J1.C9
AM16: B3.41 (MA7), J1.C8
AM17: B3.40 (MA6), J1.C7
AM18: B3.39 (MA5), J1.C6
AM19: B3.38 (MA4), J1.C5
AM20: B3.37 (MA3), J1.C4
AM21: B3.36 (MA2), J1.C3
AM22: B3.34 (MA1), J1.C2
AM23: B3.33 (MA0), J1.C1
Address CLK: B8.4 (CLK), B13.29 (Address_CLK)
Card ID0: B9.18 (F0), IC8.1 (A0)
Card ID1: B9.19 (F1), IC8.2 (A1)
D0: B1.14 (D0), B5.15 (D0), B8.18 (D0), B9.16 (D0), B15.12 (D0), B16.43 (D7), IC1.13 (DQ0)
D1: B1.13 (D1), B5.13 (D1), B8.17 (D1), B9.15 (D1), B15.11 (D1), B16.41 (D6), IC1.14 (DQ1)
D2: B1.11 (D2), B5.12 (D2), B8.16 (D2), B9.14 (D2), B15.10 (D2), B16.40 (D5), IC1.15 (DQ2)
D3: B1.10 (D3), B5.11 (D3), B8.15 (D3), B9.13 (D3), B15.8 (D3), B16.39 (D4), IC1.17 (DQ3)
D4: B1.9 (D4), B5.10 (D4), B8.14 (D4), B9.11 (D4), B15.7 (D4), B16.38 (D3), IC1.18 (DQ4)
D5: B1.8 (D5), B5.9 (D5), B8.13 (D5), B9.10 (D5), B15.6 (D5), B16.37 (D2), IC1.19 (DQ5)
D6: B1.7 (D6), B5.8 (D6), B8.12 (D6), B9.9 (D6), B15.5 (D6), B16.36 (D1), IC1.20 (DQ6)
D7: B1.6 (D7), B5.6 (D7), B8.11 (D7), B9.8 (D7), B15.3 (D7), B16.34 (D0), IC1.21 (DQ7)
DAT0: B1.22 (GPIO2), B10.8 (DAT0), B13.16 (DAT0), B15.17 (DAT0), B17.8 (DAT0), B18.8 (DAT0), B19.13 (DAT0), B20.13 (DAT0)
DAT1: B10.7 (DAT1), B13.15 (DAT1), B15.18 (DAT1), B17.7 (DAT1), B18.7 (DAT1), B19.12 (DAT1), B20.12 (DAT1)
DAT2: B10.6 (DAT2), B13.14 (DAT2), B15.19 (DAT2), B17.6 (DAT2), B18.6 (DAT2), B19.11 (DAT2), B20.11 (DAT2)
DAT3: B1.20 (GPIO3), B10.5 (DAT3), B13.13 (DAT3), B15.20 (DAT3), B17.5 (DAT3), B18.5 (DAT3), B19.10 (DAT3), B20.10 (DAT3)
DD0: B16.24 (D7_{IN/OUT}), J1.A28
DD1: B16.25 (D6_{IN/OUT}), J1.A27
DD2: B16.26 (D5_{IN/OUT}), J1.A26
DD3: B16.27 (D4_{IN/OUT}), J1.A25
DD4: B16.28 (D3_{IN/OUT}), J1.A24
DD5: B16.29 (D2_{IN/OUT}), J1.A23
DD6: B16.30 (D1_{IN/OUT}), J1.A22
DD7: B16.31 (D0_{IN/OUT}), J1.A21
DM0: B6.26 (MD7), J1.D8
DM1: B6.25 (MD6), J1.D7
DM2: B6.24 (MD5), J1.D6
DM3: B6.23 (MD4), J1.D5
DM4: B6.22 (MD3), J1.D4
DM5: B6.20 (MD2), J1.D3
DM6: B6.19 (MD1), J1.D2
DM7: B6.18 (MD0), J1.D1
Device CLK: B16.22 (S_{IN}), J1.B15
D~RD: B16.20 (~RD_{IN}), J1.B13
D~WD: B16.21 (~WD_{IN}), J1.B14
Enable: B1.4 (Enable), B9.27 (Enable), IC8.6 (E3)
Fast CLK: B2.5 (Main_CLK), B3.64 (CLK), B14.11 (Fast_CLK)
First Half CLK: B2.19 (First_Half_CLK), B10.3 (First_CLK)
GND: B1.5 (GND), B1.12 (GND), B1.21 (GND), B1.28 (GND), B2.4 (GND), B2.9 (GND), B2.16 (GND), B2.21 (GND), B3.5 (~WD), B3.10 (GND), B3.23 (GND), B3.42 (GND), B3.55 (GND), B4.4 (GND), B4.6 (H2_{REG}), B4.7 (H1_{REG}), B4.9 (GND), B4.16 (GND), B4.21 (GND), B5.7 (GND), B5.14 (GND), B5.27 (GND), B5.34 (GND), B6.5 (GND), B6.6 (~WD), B6.12 (GND), B6.21 (GND), B6.28 (GND), B7.5 (GND), B7.12 (GND), B7.21 (GND), B7.28 (GND), B8.9 (GND), B8.20 (GND), B8.37 (GND), B8.48 (GND), B9.5 (GND), B9.12 (GND), B9.21 (GND), B9.28 (GND), B10.4 (GND), B10.9 (GND), B10.16 (GND), B10.21 (GND), B11.3 (A16), B11.4 (A15), B11.5 (GND), B11.12 (GND), B11.21 (GND), B11.28 (GND), B12.5 (GND), B12.12 (GND), B12.21 (GND), B12.28 (GND), B13.5 (GND), B13.12 (GND), B13.21 (GND), B13.28 (GND), B14.5 (GND), B14.12 (GND), B14.21 (GND), B14.28 (GND), B15.4 (GND), B15.9 (GND), B15.16 (GND), B15.21 (GND), B16.10 (GND), B16.18 (A15_{IN}), B16.19 (A16_{IN}), B16.23 (GND), B16.42 (GND), B16.55 (GND), B17.4 (GND), B17.9 (GND), B17.16 (GND), B17.21 (GND), B18.4 (GND), B18.9 (GND), B18.16 (GND), B18.21 (GND), B19.7 (GND), B19.14 (GND), B19.27 (GND), B19.34 (GND), B20.7 (GND), B20.14 (GND), B20.27 (GND), B20.34 (GND), C1.2, C3.2, C4.2, C6.2, H1.1, H7.1, H10.1, IC1.2 (A16), IC1.3 (A15), IC1.16 (GND), IC3.1 (GND), IC8.3 (A2), IC8.4 (~E1), IC8.5 (~E2), IC8.8 (GND), J1.B2, J1.B10, J1.B17, J1.B24, J1.B31, J1.D9, J1.D18, LED1.2 (A)
HD0: B4.17 (H0_{OUT}), J1.A31
HD1: B4.18 (H1_{OUT}), J1.A30
HD2: B4.19 (H2_{OUT}), J1.A29
MA0: B3.6 (A23), B8.30 (C0)
MA1: B3.7 (A22), B8.32 (C1)
MA2: B3.8 (A21), B8.33 (C2)
MA3: B3.9 (A20), B8.34 (C3)
MA4: B3.11 (A19), B8.35 (C4)
MA5: B3.12 (A18), B8.36 (C5)
MA6: B3.13 (A17), B8.38 (C6)
MA7: B3.14 (A16), B8.39 (C7)
MA8: B3.15 (A15), B8.40 (C8)
MA9: B3.16 (A14), B8.41 (C9)
MA10: B3.17 (A13), B8.42 (C10)
MA11: B3.18 (A12), B8.43 (C11)
MA12: B3.19 (A11), B8.44 (C12)
MA13: B3.20 (A10), B8.45 (C13)
MA14: B3.21 (A9), B8.46 (C14)
MA15: B3.22 (A8), B8.47 (C15)
MA16: B3.24 (A7), B8.49 (C16)
MA17: B3.25 (A6), B8.50 (C17)
MA18: B3.26 (A5), B8.51 (C18)
MA19: B3.27 (A4), B8.52 (C19)
MA20: B3.28 (A3), B8.53 (C20)
MA21: B3.29 (A2), B8.54 (C21)
MA22: B3.31 (A1), B8.55 (C22)
MA23: B3.32 (A0), B8.56 (C23)
MD0: B6.7 (D7), B10.14 (MD0)
MD1: B6.8 (D6), B10.15 (MD1)
MD2: B6.9 (D5), B10.17 (MD2)
MD3: B6.10 (D4), B10.18 (MD3)
MD4: B6.11 (D3), B10.19 (MD4)
MD5: B6.13 (D2), B10.20 (MD5)
MD6: B6.14 (D1), B10.22 (MD6)
MD7: B6.15 (D0), B10.23 (MD7)
Main CLK: B3.30 (MCLK), J1.B3
unnamed: LED1.1 (K), R3.1
PHI2: B9.2 (Interrupt_CLK), B16.44 (S)
Read Data Wide: B8.26 (Count_Enable), B13.22 (Read_Data_Wide)
Read Flags: B7.7 (Y4_{R}), B9.6 (Read_Flags)
Read GPIO Direct: B1.2 (Read_GD__{0..3}), B12.7 (Y4_{R})
SD CLK: B1.29 (GPIO0), B2.22 (SD_CLK), B14.29 (SD_CLK), B17.12 (CLK), B18.12 (CLK), B19.17 (CLK), B20.17 (CLK)
SD CMD: B1.27 (GPIO1), B17.10 (CMD), B18.10 (CMD), B19.15 (CMD), B20.15 (CMD)
Second Half CLK: B2.18 (Second_Half_CLK), B5.18 (Second_Half_CLK), B10.10 (Second_CLK), B13.2 (Second_Half_CLK)
Write Clear Interrupt: B7.25 (Y2_{W}), B9.3 (Write_Clear_Interrupt)
Write Count Bank Address: B8.21 (Latch_Bank), B12.25 (Y2_{W}), B13.8 (Write_Count_Bank_Address)
Write Count CRC Byte High: B5.39 (Write_Count_CRC_Byte_High), B7.26 (Y1_{W})
Write Count CRC Byte Low: B5.40 (Write_Count_CRC_Byte_Low), B7.27 (Y0_{W})
Write Count Data Byte High: B5.1 (Write_Count_Data_Byte_High), B12.19 (Y7_{W})
Write Count Data Byte Low: B5.2 (Write_Count_Data_Byte_Low), B12.20 (Y6_{W})
Write Count High Address: B8.22 (Latch_High), B12.26 (Y1_{W}), B13.9 (Write_Count_High_Address)
Write Count Low Address: B8.23 (Latch_Low), B12.27 (Y0_{W}), B13.10 (Write_Count_Low_Address)
Write Data: B14.24 (Write_Data), B15.2 (Write_Data)
Write Data High: B7.19 (Y7_{W}), B14.6 (Write_Data_High)
Write Data Low: B7.20 (Y6_{W}), B14.7 (Write_Data_Low)
Write Flags: B7.23 (Y4_{W}), B9.7 (Write_Flags)
Write GPIO Direct: B1.3 (Write_GD__{0..3}), B12.23 (Y4_{W})
Write Read Start: B2.23 (Write_Clock_Speed_Select), B7.24 (Y3_{W})
~A3: B7.8 (~E2), B11.20 (~A3)
~A4: B7.9 (E3), B11.22 (~A4), B12.9 (E3)
~Device CLK: J1.B16
~Device Enable: B9.26 (~Enable), J1.B22
~Device Interrupt: B9.29 (~INT), J1.B19
~Device RAM: B4.2 (~Device_RAM), B11.23 (~Device_RAM)
~Device ROM: B4.5 (~Device_ROM), B11.25 (~Device_ROM), IC1.22 (~CE)
~Device Registers: B4.3 (~Device_Registers), B7.4 (~Device_Registers), B11.24 (~Device_Registers), B12.4 (~Device_Registers)
~Device Select: B4.11 (~Device_Select), B11.2 (~Device_Select), B16.33 (Deivce_~CS)
~Load Down Count: B5.16 (~Load_Down_Count), B13.27 (~Load_Down_Count)
~Main Access: B3.1 (~Main_Access), B6.2 (~Main_Access), J1.B11
~Main RD: B3.60 (M~WD), J1.D10
~Main WD: B3.61 (M~RD), J1.D11
~Main: B3.2 (~Main), B6.3 (~Main), B13.30 (~Main), J1.B9
~Memory A: J1.B29
~Memory B: J1.B30
~RD: B4.10 (~RD), B7.15 (~RD), B12.15 (~RD), B16.46 (~RD), IC1.24 (~OE)
~Read CRC Started: B5.4 (~Read_CRC_Started), B13.26 (~Read_CRC_Started)
~Read Transmit Started: B5.5 (~Read_Transmit_Started), B13.20 (~Read_Transmit_Started)
~Reset Device: B11.15 (~Reset_{IN1}), J1.B20
~Reset System: B11.14 (~Reset_{IN2}), J1.A1
~Reset: B2.12 (~Reset), B5.17 (~Reset), B8.1 (~Reset), B11.19 (~Reset_{OUT}), B13.4 (~Reset), B14.8 (~Reset)
~SD Card Enable0: B17.11 (~Card_Enable), IC8.15 (~Y0)
~SD Card Enable1: B18.11 (~Card_Enable), IC8.14 (~Y1)
~SD Card Enable2: B20.16 (~Card_Enable), IC8.13 (~Y2)
~SD Card Enable3: B19.16 (~Card_Enable), IC8.12 (~Y3)
~Second Half CLK_{Dragged1}: B2.20 (~Second_Half_CLK_{Dragged1}), B13.6 (~Second_Half_CLK_{Dragged1})
~Second Half CLK_{Dragged2}: B2.17 (~Second_Half_CLK_{Dragged2}), B13.7 (~Second_Half_CLK_{Dragged2})
~Select Device: B16.32 (Deivce_~CS_{IN}), J1.B21
~Stop Read Funk: B2.2 (~Stop_Funk), B9.4 (~Set_Interrupt_on_CLK), B13.19 (~Stop_Read_Funk)
~TCD_{8..11}: B5.24 (~TCD_{8..11}), B13.3 (~TCD_{8..11})
~WD: B4.12 (~WD), B7.16 (~WD), B12.16 (~WD), B16.45 (~WD), IC1.31 (~WE)
~Write High Nybble: B14.22 (~Write_High_Nybble), B15.24 (~Write_High_Nybble)
~Write Low Nybble: B14.20 (~Write_Low_Nybble), B15.23 (~Write_Low_Nybble)
~Write Read Start: B2.14 (~Write_Clock_Speed_Select), B13.11 (~Write_Read_Start)
