andrewpaterson/HCP65/Kicad/Computer/SD Card/SD Card Read Data/SD Card Read Data.kicad_sch

## KiCad design Kicad/Computer/SD Card/SD Card Read Data/SD Card Read Data.kicad_sch (2026-11-01)

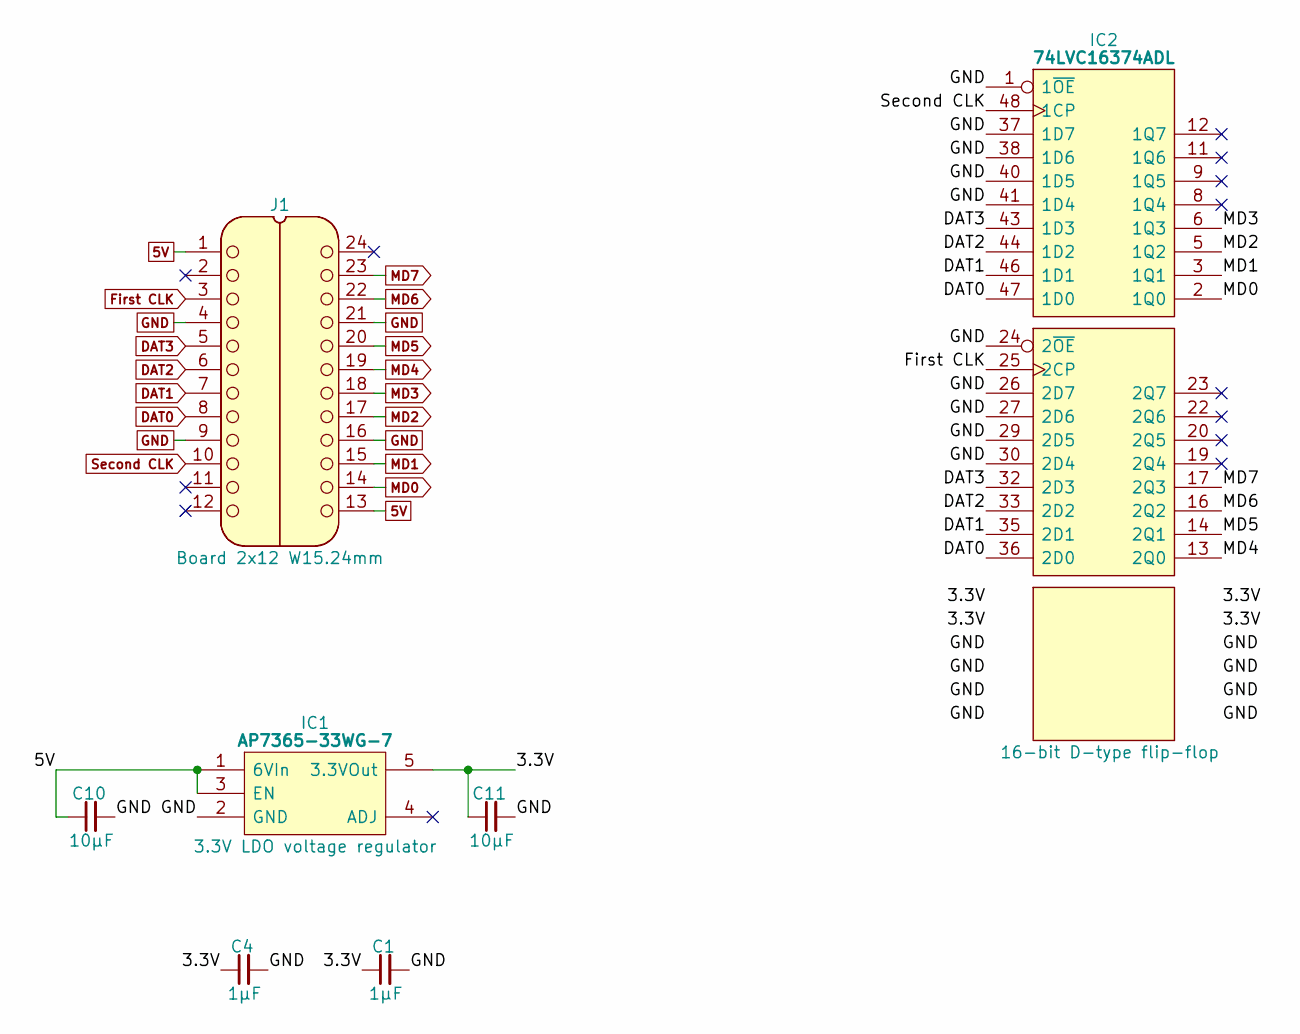
[picture p326: schematic SD Card Read Data.kicad_sch]

Parts:
C1, C4: 1μF; C_0805
C10, C11: 10μF; C_0805
IC1: AP7365-33WG-7; SOT95P285X130-5N; Manufacturer_Part_Number AP7365-33WG-7; Mouser Part Number 621-AP7365-33WG-7
IC2: 74LVC16374ADL; SOP64P1025X280-48N; Manufacturer_Part_Number 74LVC16374ADL; Mouser Part Number 771-74LVC16374ADL
J1: Board 2x12 W15.24mm; DIP-24_Board_W15.24mm

Connections:
3.3V: C1.1, C4.1, C11.1, IC1.5 (3.3VOut), IC2.7 (3V), IC2.18 (3V), IC2.31 (3V), IC2.42 (3V)
5V: C10.1, IC1.1 (6VIn), IC1.3 (EN), J1.1, J1.13
DAT0: IC2.36 (2D0), IC2.47 (1D0), J1.8
DAT1: IC2.35 (2D1), IC2.46 (1D1), J1.7
DAT2: IC2.33 (2D2), IC2.44 (1D2), J1.6
DAT3: IC2.32 (2D3), IC2.43 (1D3), J1.5
First CLK: IC2.25 (2CP), J1.3
GND: C1.2, C4.2, C10.2, C11.2, IC1.2 (GND), IC2.1 (1~OE), IC2.4 (GND), IC2.10 (GND), IC2.15 (GND), IC2.21 (GND), IC2.24 (2~OE), IC2.26 (2D7), IC2.27 (2D6), IC2.28 (GND), IC2.29 (2D5), IC2.30 (2D4), IC2.34 (GND), IC2.37 (1D7), IC2.38 (1D6), IC2.39 (GND), IC2.40 (1D5), IC2.41 (1D4), IC2.45 (GND), J1.4, J1.9, J1.16, J1.21
MD0: IC2.2 (1Q0), J1.14
MD1: IC2.3 (1Q1), J1.15
MD2: IC2.5 (1Q2), J1.17
MD3: IC2.6 (1Q3), J1.18
MD4: IC2.13 (2Q0), J1.19
MD5: IC2.14 (2Q1), J1.20
MD6: IC2.16 (2Q2), J1.22
MD7: IC2.17 (2Q3), J1.23
Second CLK: IC2.48 (1CP), J1.10
