andrewpaterson/HCP65/Kicad/Computer/SD Card/SD Card Read Signals/SD Card Read Signals.kicad_sch

## KiCad design Kicad/Computer/SD Card/SD Card Read Signals/SD Card Read Signals.kicad_sch (2026-11-01)

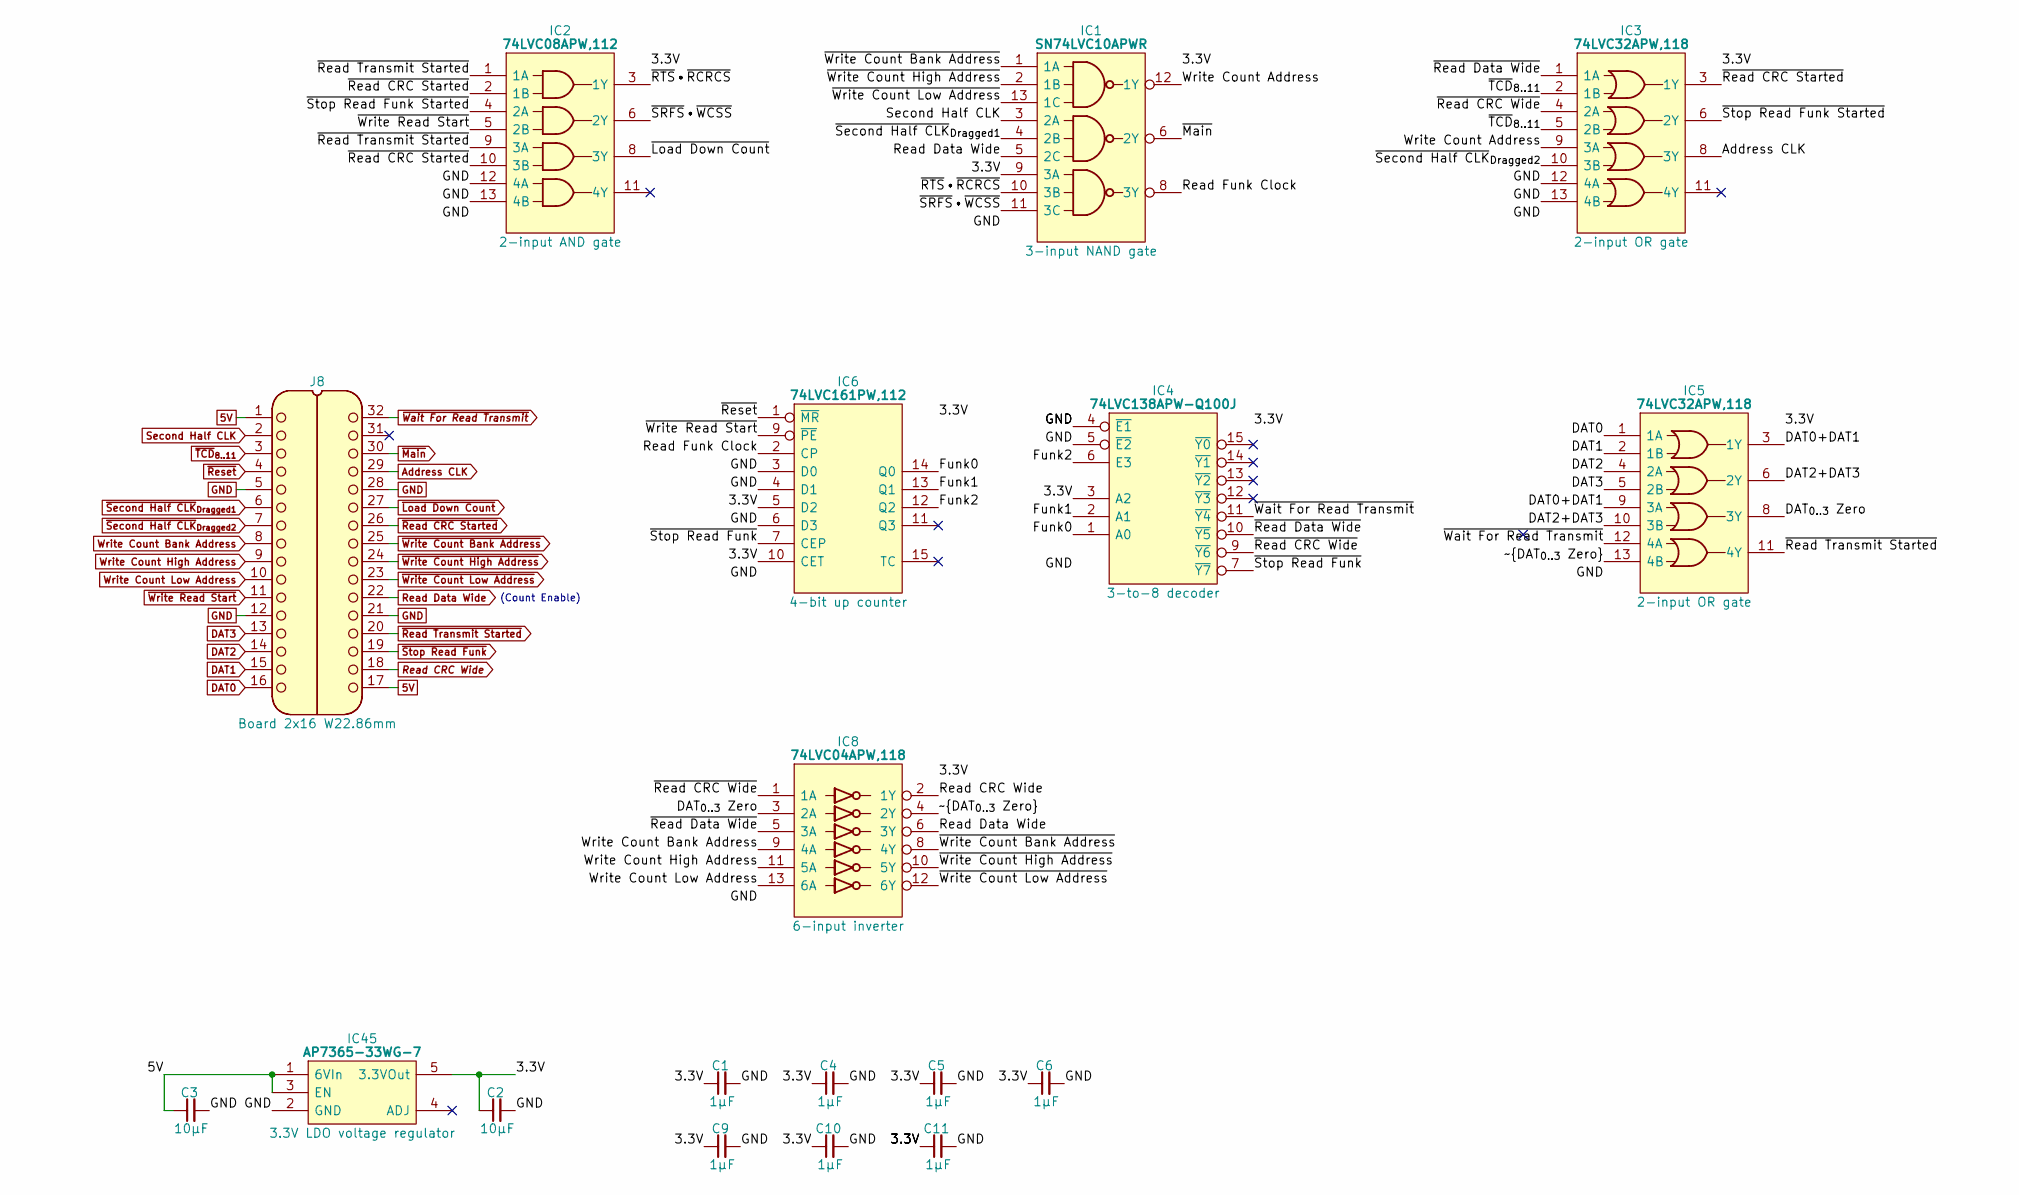
[picture p328: schematic SD Card Read Signals.kicad_sch]

Parts:
C1, C4, C5, C6, C9, C10, C11: 1μF; C_0805
C2, C3: 10μF; C_0805
IC1: SN74LVC10APWR; SOP65P640X120-14N; Manufacturer_Part_Number SN74LVC10APWR; Mouser Part Number 595-SN74LVC10APWR
IC2: 74LVC08APW,112; SOP65P640X110-14N; Manufacturer_Part_Number 74LVC08APW,112; Mouser Part Number 771-74LVC08APW
IC3, IC5: 74LVC32APW,118; SOP65P640X110-14N; Manufacturer_Part_Number 74LVC32APW,118; Mouser Part Number 771-74LVC32APW-T
IC4: 74LVC138APW-Q100J; SOP65P640X110-16N; Mouser Part Number 771-74LVC138APWQ100J
IC6: 74LVC161PW,112; SOP65P640X110-16N; Mouser Part Number 771-LVC161PW112
IC8: 74LVC04APW,118; SOP65P640X110-14N; Manufacturer_Part_Number 74LVC04APW,118; Mouser Part Number 771-74LVC04APW-T
IC45: AP7365-33WG-7; SOT95P285X130-5N; Manufacturer_Part_Number AP7365-33WG-7; Mouser Part Number 621-AP7365-33WG-7
J8: Board 2x16 W22.86mm; DIP-32_Board_W22.86mm

Connections:
3.3V: C1.1, C2.1, C4.1, C5.1, C6.1, C9.1, C10.1, C11.1, IC1.9 (3A), IC1.14 (3V), IC2.14 (3V), IC3.14 (3V), IC4.3 (A2), IC4.16 (3V), IC5.14 (3V), IC6.5 (D2), IC6.10 (CET), IC6.16 (3V), IC8.14 (3V), IC45.5 (3.3VOut)
5V: C3.1, IC45.1 (6VIn), IC45.3 (EN), J8.1, J8.17
Address CLK: IC3.8 (3Y), J8.29
DAT0: IC5.1 (1A), J8.16
DAT0+DAT1: IC5.3 (1Y), IC5.9 (3A)
DAT1: IC5.2 (1B), J8.15
DAT2: IC5.4 (2A), J8.14
DAT2+DAT3: IC5.6 (2Y), IC5.10 (3B)
DAT3: IC5.5 (2B), J8.13
DAT_{0..3} Zero: IC5.8 (3Y), IC8.3 (2A)
Funk0: IC4.1 (A0), IC6.14 (Q0)
Funk1: IC4.2 (A1), IC6.13 (Q1)
Funk2: IC4.6 (E3), IC6.12 (Q2)
GND: C1.2, C2.2, C3.2, C4.2, C5.2, C6.2, C9.2, C10.2, C11.2, IC1.7 (GND), IC2.7 (GND), IC2.12 (4A), IC2.13 (4B), IC3.7 (GND), IC3.12 (4A), IC3.13 (4B), IC4.4 (~E1), IC4.5 (~E2), IC4.8 (GND), IC5.7 (GND), IC6.3 (D0), IC6.4 (D1), IC6.6 (D3), IC6.8 (GND), IC8.7 (GND), IC45.2 (GND), J8.5, J8.12, J8.21, J8.28
Read CRC Wide: IC8.2 (1Y), J8.18
Read Data Wide: IC1.5 (2C), IC8.6 (3Y), J8.22
Read Funk Clock: IC1.8 (3Y), IC6.2 (CP)
Second Half CLK: IC1.3 (2A), J8.2
Write Count Address: IC1.12 (1Y), IC3.9 (3A)
Write Count Bank Address: IC8.9 (4A), J8.8
Write Count High Address: IC8.11 (5A), J8.9
Write Count Low Address: IC8.13 (6A), J8.10
~DAT_{0..3 Zero}: IC5.13 (4B), IC8.4 (2Y)
~Load Down Count: IC2.8 (3Y), J8.27
~Main: IC1.6 (2Y), J8.30
~RTS•~RCRCS: IC1.10 (3B), IC2.3 (1Y)
~Read CRC Started: IC2.2 (1B), IC2.10 (3B), IC3.3 (1Y), J8.26
~Read CRC Wide: IC3.4 (2A), IC4.9 (~Y6), IC8.1 (1A)
~Read Data Wide: IC3.1 (1A), IC4.10 (~Y5), IC8.5 (3A)
~Read Transmit Started: IC2.1 (1A), IC2.9 (3A), IC5.11 (4Y), J8.20
~Reset: IC6.1 (~MR), J8.4
~SRFS•~WCSS: IC1.11 (3C), IC2.6 (2Y)
~Second Half CLK_{Dragged1}: IC1.4 (2B), J8.6
~Second Half CLK_{Dragged2}: IC3.10 (3B), J8.7
~Stop Read Funk Started: IC2.4 (2A), IC3.6 (2Y)
~Stop Read Funk: IC4.7 (~Y7), IC6.7 (CEP), J8.19
~TCD_{8..11}: IC3.2 (1B), IC3.5 (2B), J8.3
~Wait For Read Transmit: IC4.11 (~Y4), IC5.12 (4A), J8.32
~Write Count Bank Address: IC1.1 (1A), IC8.8 (4Y), J8.25
~Write Count High Address: IC1.2 (1B), IC8.10 (5Y), J8.24
~Write Count Low Address: IC1.13 (1C), IC8.12 (6Y), J8.23
~Write Read Start: IC2.5 (2B), IC6.9 (~PE), J8.11

Notes on the sheet:
(Count Enable)
