andrewpaterson/HCP65/Kicad/Computer/SD Card/SD Card Write Signals/SD Card Write Signals.kicad_sch

## KiCad design Kicad/Computer/SD Card/SD Card Write Signals/SD Card Write Signals.kicad_sch (2026-11-01)

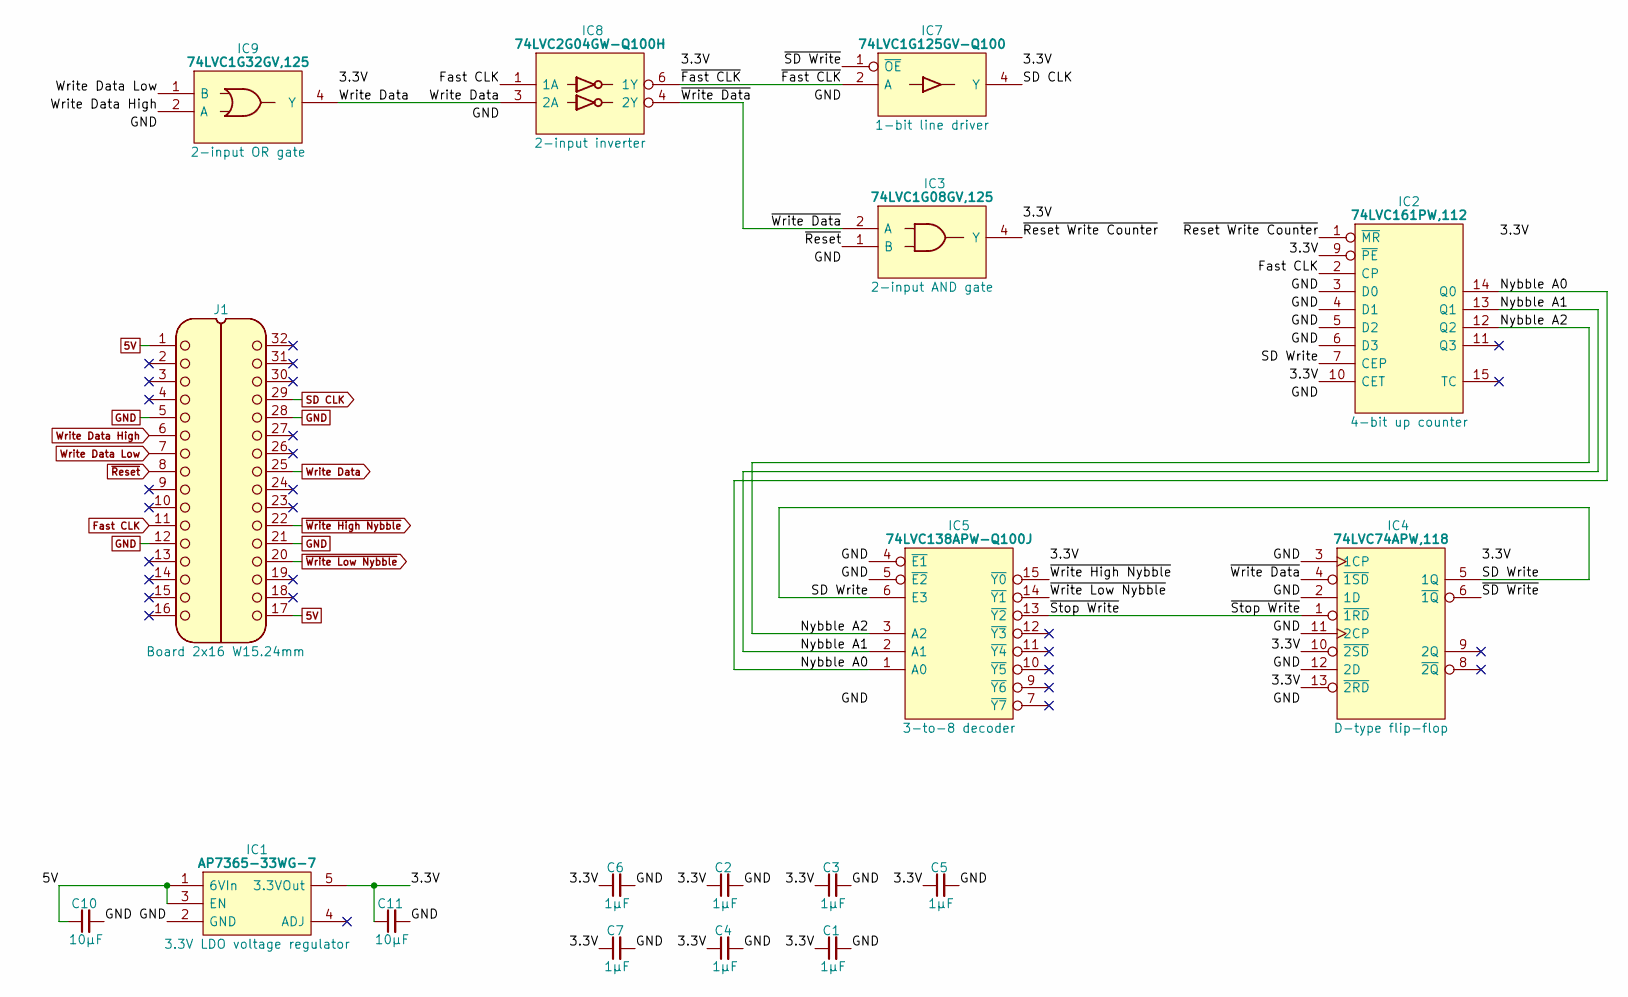
[picture p329: schematic SD Card Write Signals.kicad_sch]

Parts:
C1, C2, C3, C4, C5, C6, C7: 1μF; C_0805
C10, C11: 10μF; C_0805
IC1: AP7365-33WG-7; SOT95P285X130-5N; Manufacturer_Part_Number AP7365-33WG-7; Mouser Part Number 621-AP7365-33WG-7
IC2: 74LVC161PW,112; SOP65P640X110-16N; Mouser Part Number 771-LVC161PW112
IC3: 74LVC1G08GV,125; SOT95P275X110-5N; Manufacturer_Part_Number 74LVC1G08GV,125; Mouser Part Number 771-74LVC1G08GV
IC4: 74LVC74APW,118; SOP65P640X110-14N; Mouser Part Number 771-74LVC74APW-T
IC5: 74LVC138APW-Q100J; SOP65P640X110-16N; Mouser Part Number 771-74LVC138APWQ100J
IC7: 74LVC1G125GV-Q100; SOT95P275X110-5N; Mouser Part Number 771-74LVC1G125GVQ100
IC8: 74LVC2G04GW-Q100H; SOP65P210X110-6N; Manufacturer_Part_Number 74LVC2G04GW-Q100H; Mouser Part Number 771-74LVC2G04GWQ100H
IC9: 74LVC1G32GV,125; SOT95P275X110-5N; Manufacturer_Part_Number 74LVC1G32GV,125; Mouser Part Number 771-LVC1G32GV125
J1: Board 2x16 W15.24mm; DIP-32_Board_W15.24mm

Connections:
3.3V: C1.1, C2.1, C3.1, C4.1, C5.1, C6.1, C7.1, C11.1, IC1.5 (3.3VOut), IC2.9 (~PE), IC2.10 (CET), IC2.16 (3V), IC3.5 (3V), IC4.10 (~2SD), IC4.13 (~2RD), IC4.14 (3V), IC5.16 (3V), IC7.5 (3V), IC8.5 (3V), IC9.5 (3V)
5V: C10.1, IC1.1 (6VIn), IC1.3 (EN), J1.1, J1.17
Fast CLK: IC2.2 (CP), IC8.1 (1A), J1.11
GND: C1.2, C2.2, C3.2, C4.2, C5.2, C6.2, C7.2, C10.2, C11.2, IC1.2 (GND), IC2.3 (D0), IC2.4 (D1), IC2.5 (D2), IC2.6 (D3), IC2.8 (GND), IC3.3 (GND), IC4.2 (1D), IC4.3 (1CP), IC4.7 (GND), IC4.11 (2CP), IC4.12 (2D), IC5.4 (~E1), IC5.5 (~E2), IC5.8 (GND), IC7.3 (GND), IC8.2 (GND), IC9.3 (GND), J1.5, J1.12, J1.21, J1.28
Nybble A0: IC2.14 (Q0), IC5.1 (A0)
Nybble A1: IC2.13 (Q1), IC5.2 (A1)
Nybble A2: IC2.12 (Q2), IC5.3 (A2)
SD CLK: IC7.4 (Y), J1.29
SD Write: IC2.7 (CEP), IC4.5 (1Q), IC5.6 (E3)
Write Data: IC8.3 (2A), IC9.4 (Y), J1.25
Write Data High: IC9.2 (A), J1.6
Write Data Low: IC9.1 (B), J1.7
~Fast CLK: IC7.2 (A), IC8.6 (1Y)
~Reset Write Counter: IC2.1 (~MR), IC3.4 (Y)
~Reset: IC3.1 (B), J1.8
~SD Write: IC4.6 (~1Q), IC7.1 (~OE)
~Stop Write: IC4.1 (~1RD), IC5.13 (~Y2)
~Write Data: IC3.2 (A), IC4.4 (~1SD), IC8.4 (2Y)
~Write High Nybble: IC5.15 (~Y0), J1.22
~Write Low Nybble: IC5.14 (~Y1), J1.20
