andrewpaterson/HCP65/Kicad/Computer/SNES/SNES Controller Reader/SNES Controller Reader.kicad_sch

## KiCad design Kicad/Computer/SNES/SNES Controller Reader/SNES Controller Reader.kicad_sch (2026-11-01)

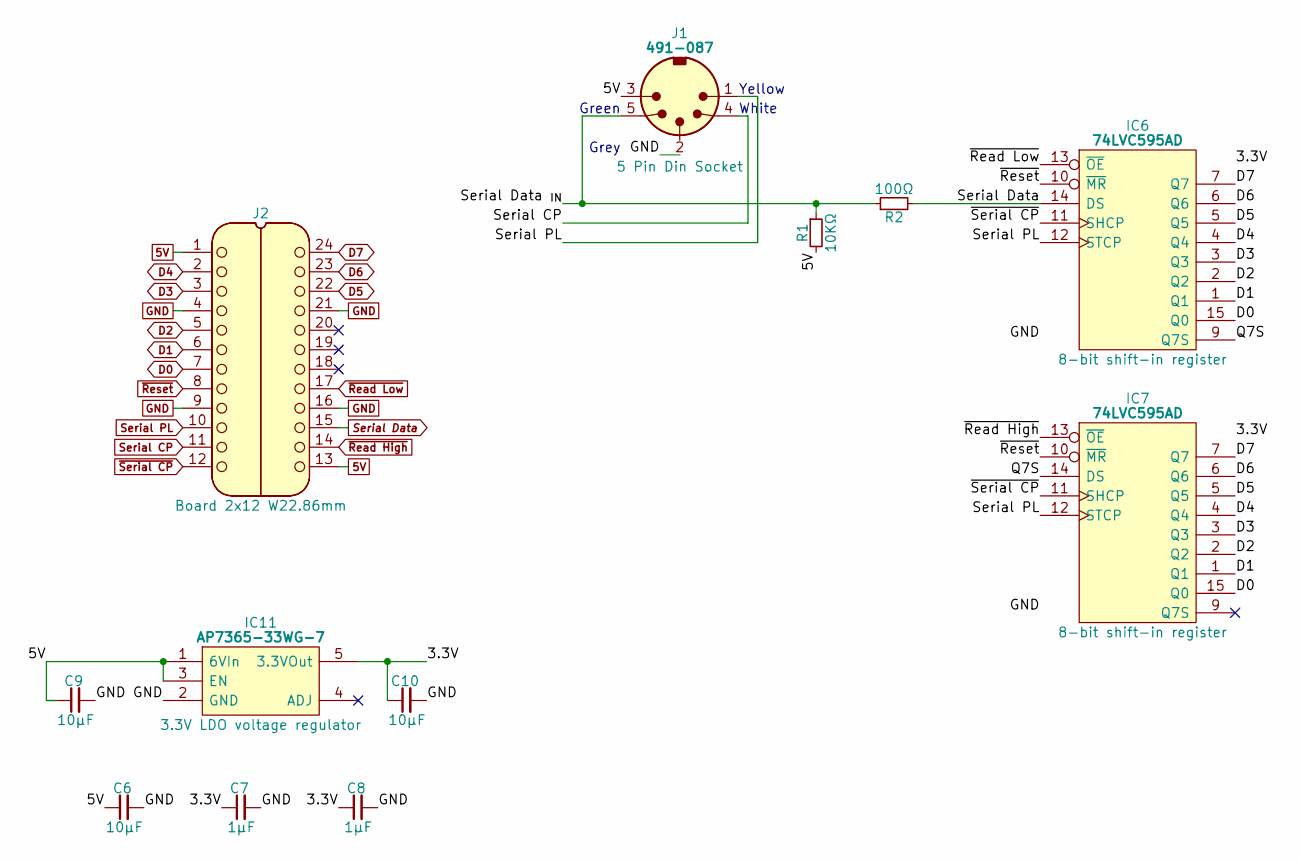
[picture p331: schematic SNES Controller Reader.kicad_sch]

Parts:
C6, C9, C10: 10μF; C_0805
C7, C8: 1μF; C_0805
IC6, IC7: 74LVC595AD; SOIC127P600X175-16N; Mouser Part Number 771-74LVC595AD
IC11: AP7365-33WG-7; SOT95P285X130-5N; Manufacturer_Part_Number AP7365-33WG-7; Mouser Part Number 621-AP7365-33WG-7
J1: 491-087; 491087; Manufacturer_Part_Number 491-087
J2: Board 2x12 W22.86mm; DIP-24_Board_W22.86mm
R1: 10KΩ; R_0805
R2: 100Ω; R_0805

Connections:
3.3V: C7.1, C8.1, C10.1, IC6.16 (3V), IC7.16 (3V), IC11.5 (3.3VOut)
5V: C6.1, C9.1, IC11.1 (6VIn), IC11.3 (EN), J1.3, J2.1, J2.13, R1.2
D0: IC6.15 (Q0), IC7.15 (Q0), J2.7
D1: IC6.1 (Q1), IC7.1 (Q1), J2.6
D2: IC6.2 (Q2), IC7.2 (Q2), J2.5
D3: IC6.3 (Q3), IC7.3 (Q3), J2.3
D4: IC6.4 (Q4), IC7.4 (Q4), J2.2
D5: IC6.5 (Q5), IC7.5 (Q5), J2.22
D6: IC6.6 (Q6), IC7.6 (Q6), J2.23
D7: IC6.7 (Q7), IC7.7 (Q7), J2.24
GND: C6.2, C7.2, C8.2, C9.2, C10.2, IC6.8 (GND), IC7.8 (GND), IC11.2 (GND), J1.2, J2.4, J2.9, J2.16, J2.21
Q7S: IC6.9 (Q7S), IC7.14 (DS)
Serial CP: J1.4, J2.11
Serial Data: IC6.14 (DS), J2.15, R2.2
Serial Data _{IN}: J1.5, R1.1, R2.1
Serial PL: IC6.12 (STCP), IC7.12 (STCP), J1.1, J2.10
~Read High: IC7.13 (~OE), J2.14
~Read Low: IC6.13 (~OE), J2.17
~Reset: IC6.10 (~MR), IC7.10 (~MR), J2.8
~Serial CP: IC6.11 (SHCP), IC7.11 (SHCP), J2.12

Notes on the sheet:
Green
White
Grey
Yellow
