andrewpaterson/HCP65/Kicad/Computer/VIA/VIA Board/VIA Board.kicad_sch

## KiCad design Kicad/Computer/VIA/VIA Board/VIA Board.kicad_sch (2026-11-07)

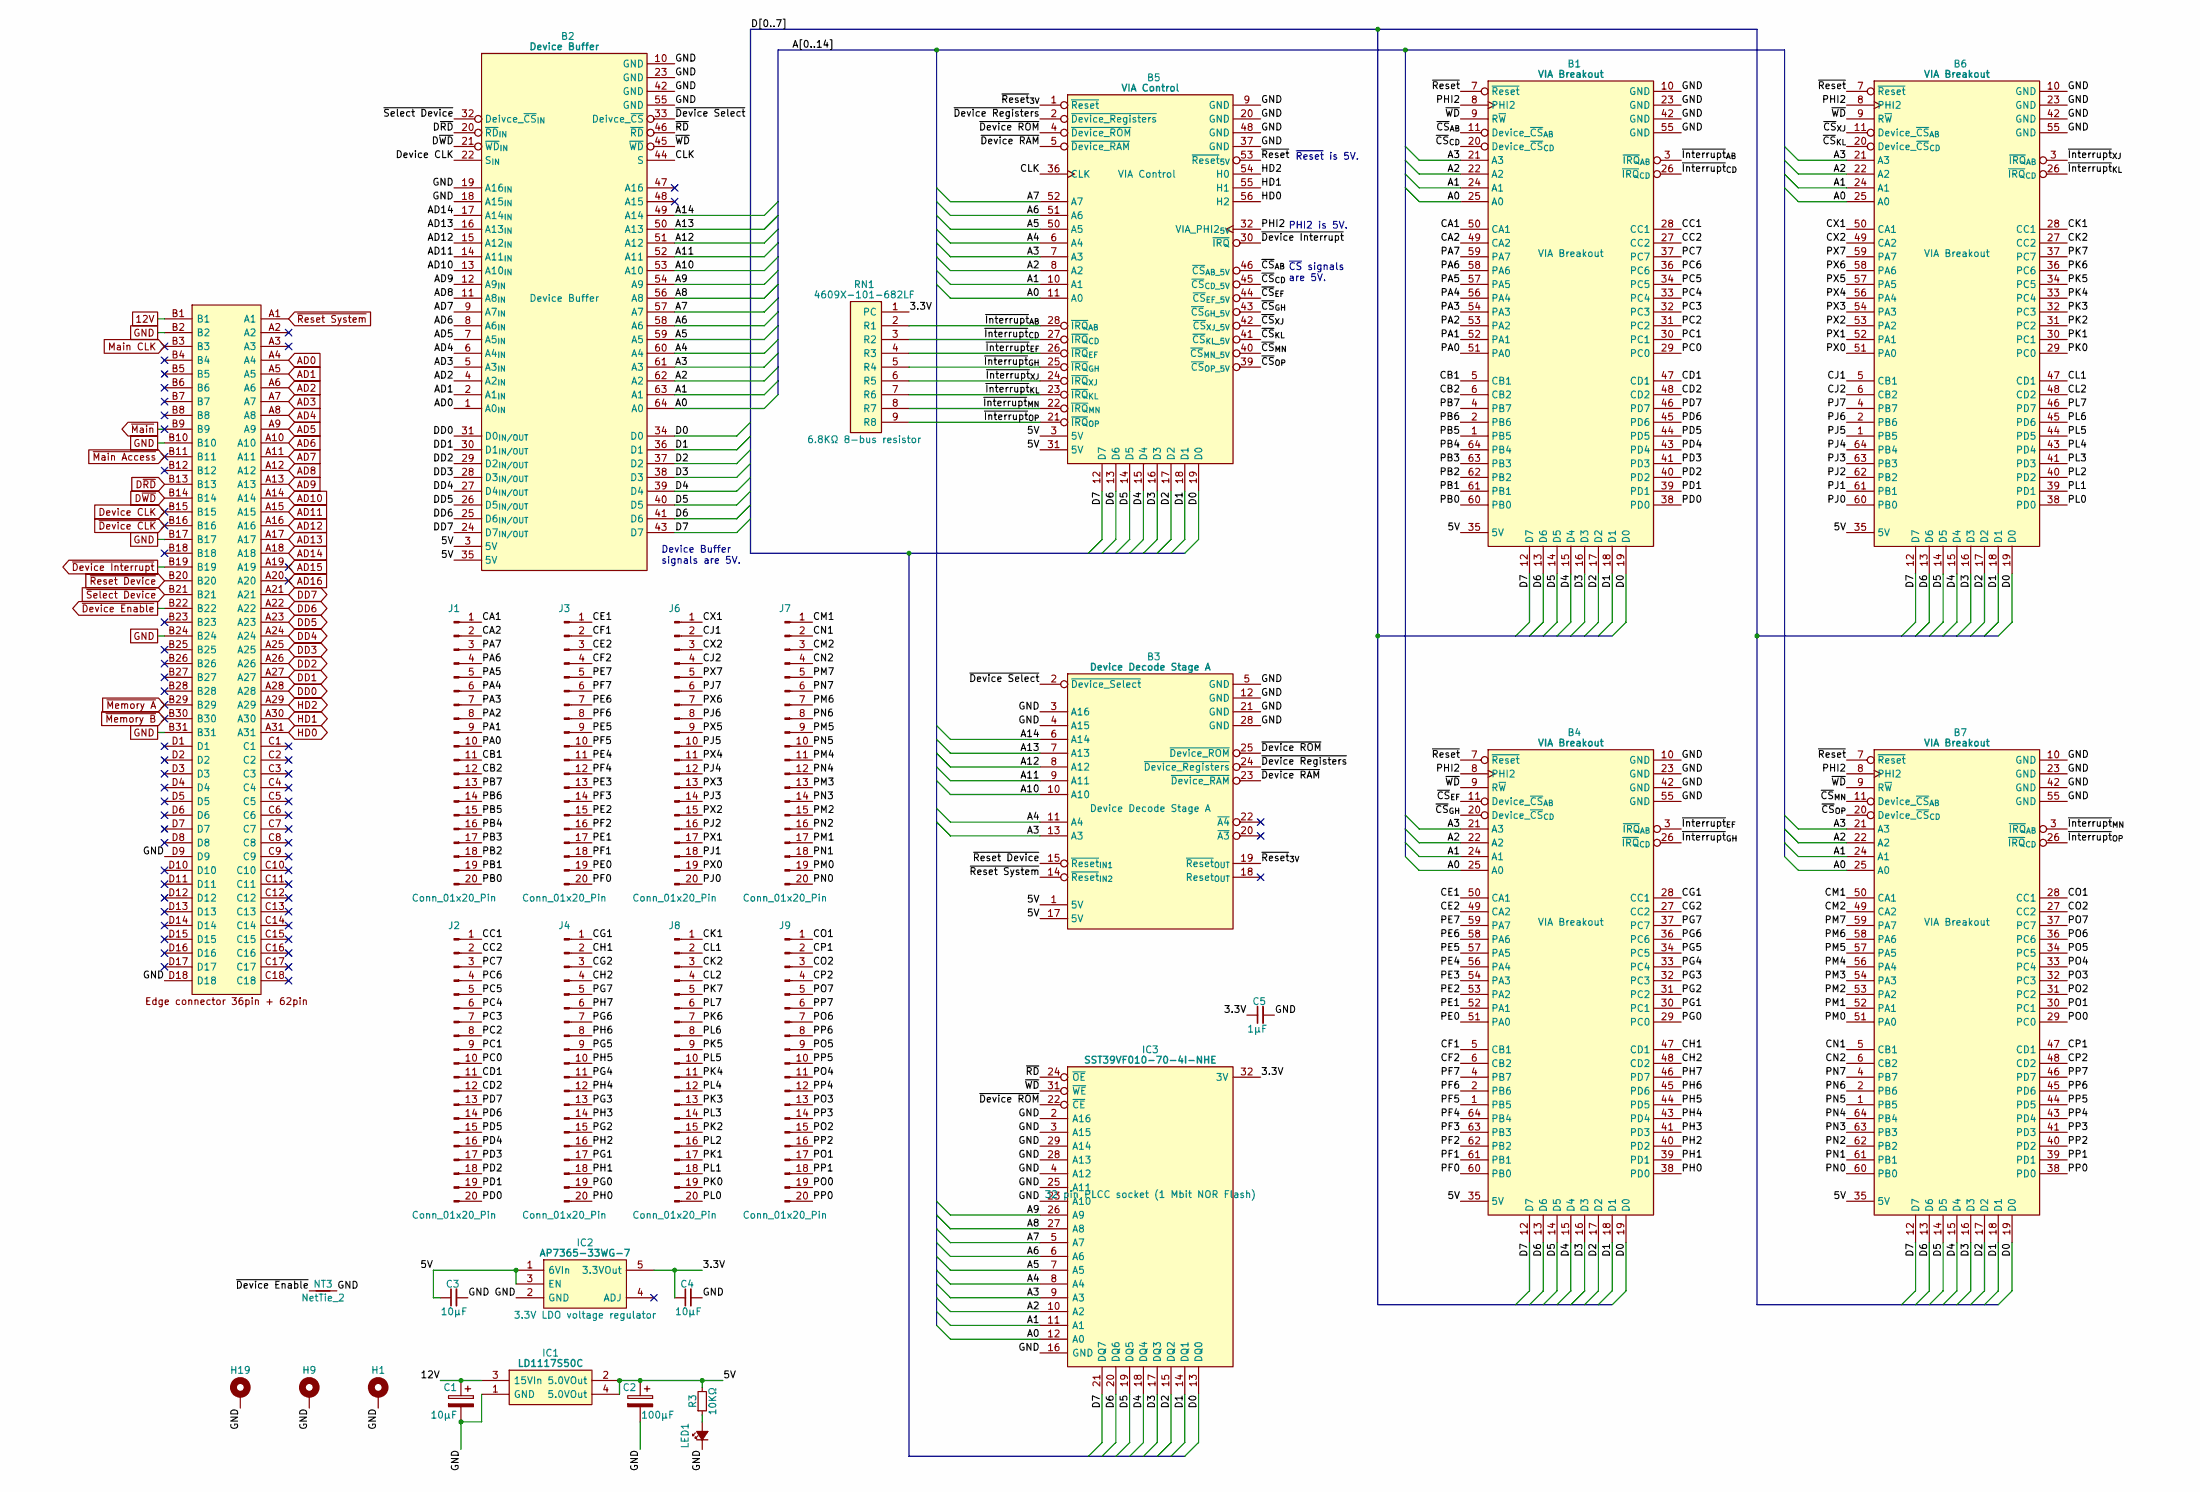
[picture p332: schematic VIA Board.kicad_sch]

Parts:
B1, B4, B6, B7: VIA Breakout; HCP65_VIA_Breakout
B2: Device Buffer; HCP65_Device_Buffer
B3: Device Decode Stage A; HCP65_Device_Decode_Stage_A
B5: VIA Control; HCP65_VIA_Control
C1: 10μF; CP_Radial_D4.0mm_P2.00mm
C2: 100μF; CP_Radial_D4.0mm_P2.00mm
C3, C4: 10µF; C_0805
C5: 1µF; C_0805
H1, H9, H19: MountingHole_Pad; HCP65_MountingHole_M3_
IC1: LD1117S50C; LD1117S33C; Manufacturer_Part_Number LD1117S50C
IC2: AP7365-33WG-7; SOT95P285X130-5N; Manufacturer_Part_Number AP7365-33WG-7; Mouser Part Number 621-AP7365-33WG-7
IC3: SST39VF010-70-4I-NHE; 5408803224008; Manufacturer_Part_Number SST39VF010-70-4I-NHE
J1, J2: Conn_01x20_Pin; PinHeader_1x20_P2.54mm_Horizontal
J3, J4, J6, J7, J8, J9: Conn_01x20_Pin; PinHeader_2x10_P2.54mm_Horizontal
J5: 395-098-520-350; 98pin Edge Connector; Manufacturer_Part_Number 395-098-520-350; Mouser Part Number 587-395-098-520-350
LED1: LED; LED_D5.0mm
NT3: NetTie_2; NetTie-2_SMD_Pad0.5mm
R3: 10KΩ; R_0805
RN1: 4609X-101-682LF; 4609X; Manufacturer_Part_Number 4609X-101-682LF; Mouser Part Number 652-4609X-1LF-6.8K

Connections:
3.3V: C4.1, C5.1, IC2.5 (3.3VOut), IC3.32 (3V), RN1.1 (PC)
5V: B1.35 (5V), B2.3 (5V), B2.35 (5V), B3.1 (5V), B3.17 (5V), B4.35 (5V), B5.3 (5V), B5.31 (5V), B6.35 (5V), B7.35 (5V), C2.1, C3.1, IC1.2 (5.0VOut), IC1.4 (5.0VOut), IC2.1 (6VIn), IC2.3 (EN), R3.2
12V: C1.1, IC1.3 (15VIn), J5.B1
A0: B1.25 (A0), B2.64 (A0), B4.25 (A0), B5.11 (A0), B6.25 (A0), B7.25 (A0), IC3.12 (A0)
A1: B1.24 (A1), B2.63 (A1), B4.24 (A1), B5.10 (A1), B6.24 (A1), B7.24 (A1), IC3.11 (A1)
A2: B1.22 (A2), B2.62 (A2), B4.22 (A2), B5.8 (A2), B6.22 (A2), B7.22 (A2), IC3.10 (A2)
A3: B1.21 (A3), B2.61 (A3), B3.13 (A3), B4.21 (A3), B5.7 (A3), B6.21 (A3), B7.21 (A3), IC3.9 (A3)
A4: B2.60 (A4), B3.11 (A4), B5.6 (A4), IC3.8 (A4)
A5: B2.59 (A5), B5.50 (A5), IC3.7 (A5)
A6: B2.58 (A6), B5.51 (A6), IC3.6 (A6)
A7: B2.57 (A7), B5.52 (A7), IC3.5 (A7)
A8: B2.56 (A8), IC3.27 (A8)
A9: B2.54 (A9), IC3.26 (A9)
A10: B2.53 (A10), B3.10 (A10)
A11: B2.52 (A11), B3.9 (A11)
A12: B2.51 (A12), B3.8 (A12)
A13: B2.50 (A13), B3.7 (A13)
A14: B2.49 (A14), B3.6 (A14)
AD0: B2.1 (A0_{IN}), J5.A4
AD1: B2.2 (A1_{IN}), J5.A5
AD2: B2.4 (A2_{IN}), J5.A6
AD3: B2.5 (A3_{IN}), J5.A7
AD4: B2.6 (A4_{IN}), J5.A8
AD5: B2.7 (A5_{IN}), J5.A9
AD6: B2.8 (A6_{IN}), J5.A10
AD7: B2.9 (A7_{IN}), J5.A11
AD8: B2.11 (A8_{IN}), J5.A12
AD9: B2.12 (A9_{IN}), J5.A13
AD10: B2.13 (A10_{IN}), J5.A14
AD11: B2.14 (A11_{IN}), J5.A15
AD12: B2.15 (A12_{IN}), J5.A16
AD13: B2.16 (A13_{IN}), J5.A17
AD14: B2.17 (A14_{IN}), J5.A18
AD15: J5.A19
AD16: J5.A20
CA1: B1.50 (CA1), J1.1
CA2: B1.49 (CA2), J1.2
CB1: B1.5 (CB1), J1.11
CB2: B1.6 (CB2), J1.12
CC1: B1.28 (CC1), J2.1
CC2: B1.27 (CC2), J2.2
CD1: B1.47 (CD1), J2.11
CD2: B1.48 (CD2), J2.12
CE1: B4.50 (CA1), J3.1
CE2: B4.49 (CA2), J3.3
CF1: B4.5 (CB1), J3.2
CF2: B4.6 (CB2), J3.4
CG1: B4.28 (CC1), J4.1
CG2: B4.27 (CC2), J4.3
CH1: B4.47 (CD1), J4.2
CH2: B4.48 (CD2), J4.4
CJ1: B6.5 (CB1), J6.2
CJ2: B6.6 (CB2), J6.4
CK1: B6.28 (CC1), J8.1
CK2: B6.27 (CC2), J8.3
CL1: B6.47 (CD1), J8.2
CL2: B6.48 (CD2), J8.4
CLK: B2.44 (S), B5.36 (CLK)
CM1: B7.50 (CA1), J7.1
CM2: B7.49 (CA2), J7.3
CN1: B7.5 (CB1), J7.2
CN2: B7.6 (CB2), J7.4
CO1: B7.28 (CC1), J9.1
CO2: B7.27 (CC2), J9.3
CP1: B7.47 (CD1), J9.2
CP2: B7.48 (CD2), J9.4
CX1: B6.50 (CA1), J6.1
CX2: B6.49 (CA2), J6.3
D0: B1.19 (D0), B2.34 (D0), B4.19 (D0), B5.19 (D0), B6.19 (D0), B7.19 (D0), IC3.13 (DQ0)
D1: B1.18 (D1), B2.36 (D1), B4.18 (D1), B5.18 (D1), B6.18 (D1), B7.18 (D1), IC3.14 (DQ1)
D2: B1.17 (D2), B2.37 (D2), B4.17 (D2), B5.17 (D2), B6.17 (D2), B7.17 (D2), IC3.15 (DQ2)
D3: B1.16 (D3), B2.38 (D3), B4.16 (D3), B5.16 (D3), B6.16 (D3), B7.16 (D3), IC3.17 (DQ3)
D4: B1.15 (D4), B2.39 (D4), B4.15 (D4), B5.15 (D4), B6.15 (D4), B7.15 (D4), IC3.18 (DQ4)
D5: B1.14 (D5), B2.40 (D5), B4.14 (D5), B5.14 (D5), B6.14 (D5), B7.14 (D5), IC3.19 (DQ5)
D6: B1.13 (D6), B2.41 (D6), B4.13 (D6), B5.13 (D6), B6.13 (D6), B7.13 (D6), IC3.20 (DQ6)
D7: B1.12 (D7), B2.43 (D7), B4.12 (D7), B5.12 (D7), B6.12 (D7), B7.12 (D7), IC3.21 (DQ7)
DD0: B2.31 (D0_{IN/OUT}), J5.A28
DD1: B2.30 (D1_{IN/OUT}), J5.A27
DD2: B2.29 (D2_{IN/OUT}), J5.A26
DD3: B2.28 (D3_{IN/OUT}), J5.A25
DD4: B2.27 (D4_{IN/OUT}), J5.A24
DD5: B2.26 (D5_{IN/OUT}), J5.A23
DD6: B2.25 (D6_{IN/OUT}), J5.A22
DD7: B2.24 (D7_{IN/OUT}), J5.A21
Device CLK: B2.22 (S_{IN}), J5.B15
D~RD: B2.20 (~RD_{IN}), J5.B13
D~WD: B2.21 (~WD_{IN}), J5.B14
GND: B1.10 (GND), B1.23 (GND), B1.42 (GND), B1.55 (GND), B2.10 (GND), B2.18 (A15_{IN}), B2.19 (A16_{IN}), B2.23 (GND), B2.42 (GND), B2.55 (GND), B3.3 (A16), B3.4 (A15), B3.5 (GND), B3.12 (GND), B3.21 (GND), B3.28 (GND), B4.10 (GND), B4.23 (GND), B4.42 (GND), B4.55 (GND), B5.9 (GND), B5.20 (GND), B5.37 (GND), B5.48 (GND), B6.10 (GND), B6.23 (GND), B6.42 (GND), B6.55 (GND), B7.10 (GND), B7.23 (GND), B7.42 (GND), B7.55 (GND), C1.2, C2.2, C3.2, C4.2, C5.2, H1.1, H9.1, H19.1, IC1.1 (GND), IC2.2 (GND), IC3.2 (A16), IC3.3 (A15), IC3.4 (A12), IC3.16 (GND), IC3.23 (A10), IC3.25 (A11), IC3.28 (A13), IC3.29 (A14), J5.B2, J5.B10, J5.B17, J5.B24, J5.B31, J5.D9, J5.D18, LED1.1 (K), NT3.2
HD0: B5.56 (H2), J5.A31
HD1: B5.55 (H1), J5.A30
HD2: B5.54 (H0), J5.A29
Main CLK: J5.B3
unnamed: LED1.2 (A), R3.1
PA0: B1.51 (PA0), J1.10
PA1: B1.52 (PA1), J1.9
PA2: B1.53 (PA2), J1.8
PA3: B1.54 (PA3), J1.7
PA4: B1.56 (PA4), J1.6
PA5: B1.57 (PA5), J1.5
PA6: B1.58 (PA6), J1.4
PA7: B1.59 (PA7), J1.3
PB0: B1.60 (PB0), J1.20
PB1: B1.61 (PB1), J1.19
PB2: B1.62 (PB2), J1.18
PB3: B1.63 (PB3), J1.17
PB4: B1.64 (PB4), J1.16
PB5: B1.1 (PB5), J1.15
PB6: B1.2 (PB6), J1.14
PB7: B1.4 (PB7), J1.13
PC0: B1.29 (PC0), J2.10
PC1: B1.30 (PC1), J2.9
PC2: B1.31 (PC2), J2.8
PC3: B1.32 (PC3), J2.7
PC4: B1.33 (PC4), J2.6
PC5: B1.34 (PC5), J2.5
PC6: B1.36 (PC6), J2.4
PC7: B1.37 (PC7), J2.3
PD0: B1.38 (PD0), J2.20
PD1: B1.39 (PD1), J2.19
PD2: B1.40 (PD2), J2.18
PD3: B1.41 (PD3), J2.17
PD4: B1.43 (PD4), J2.16
PD5: B1.44 (PD5), J2.15
PD6: B1.45 (PD6), J2.14
PD7: B1.46 (PD7), J2.13
PE0: B4.51 (PA0), J3.19
PE1: B4.52 (PA1), J3.17
PE2: B4.53 (PA2), J3.15
PE3: B4.54 (PA3), J3.13
PE4: B4.56 (PA4), J3.11
PE5: B4.57 (PA5), J3.9
PE6: B4.58 (PA6), J3.7
PE7: B4.59 (PA7), J3.5
PF0: B4.60 (PB0), J3.20
PF1: B4.61 (PB1), J3.18
PF2: B4.62 (PB2), J3.16
PF3: B4.63 (PB3), J3.14
PF4: B4.64 (PB4), J3.12
PF5: B4.1 (PB5), J3.10
PF6: B4.2 (PB6), J3.8
PF7: B4.4 (PB7), J3.6
PG0: B4.29 (PC0), J4.19
PG1: B4.30 (PC1), J4.17
PG2: B4.31 (PC2), J4.15
PG3: B4.32 (PC3), J4.13
PG4: B4.33 (PC4), J4.11
PG5: B4.34 (PC5), J4.9
PG6: B4.36 (PC6), J4.7
PG7: B4.37 (PC7), J4.5
PH0: B4.38 (PD0), J4.20
PH1: B4.39 (PD1), J4.18
PH2: B4.40 (PD2), J4.16
PH3: B4.41 (PD3), J4.14
PH4: B4.43 (PD4), J4.12
PH5: B4.44 (PD5), J4.10
PH6: B4.45 (PD6), J4.8
PH7: B4.46 (PD7), J4.6
PHI2: B1.8 (PHI2), B4.8 (PHI2), B5.32 (VIA_PHI2_{5V}), B6.8 (PHI2), B7.8 (PHI2)
PJ0: B6.60 (PB0), J6.20
PJ1: B6.61 (PB1), J6.18
PJ2: B6.62 (PB2), J6.16
PJ3: B6.63 (PB3), J6.14
PJ4: B6.64 (PB4), J6.12
PJ5: B6.1 (PB5), J6.10
PJ6: B6.2 (PB6), J6.8
PJ7: B6.4 (PB7), J6.6
PK0: B6.29 (PC0), J8.19
PK1: B6.30 (PC1), J8.17
PK2: B6.31 (PC2), J8.15
PK3: B6.32 (PC3), J8.13
PK4: B6.33 (PC4), J8.11
PK5: B6.34 (PC5), J8.9
PK6: B6.36 (PC6), J8.7
PK7: B6.37 (PC7), J8.5
PL0: B6.38 (PD0), J8.20
PL1: B6.39 (PD1), J8.18
PL2: B6.40 (PD2), J8.16
PL3: B6.41 (PD3), J8.14
PL4: B6.43 (PD4), J8.12
PL5: B6.44 (PD5), J8.10
PL6: B6.45 (PD6), J8.8
PL7: B6.46 (PD7), J8.6
PM0: B7.51 (PA0), J7.19
PM1: B7.52 (PA1), J7.17
PM2: B7.53 (PA2), J7.15
PM3: B7.54 (PA3), J7.13
PM4: B7.56 (PA4), J7.11
PM5: B7.57 (PA5), J7.9
PM6: B7.58 (PA6), J7.7
PM7: B7.59 (PA7), J7.5
PN0: B7.60 (PB0), J7.20
PN1: B7.61 (PB1), J7.18
PN2: B7.62 (PB2), J7.16
PN3: B7.63 (PB3), J7.14
PN4: B7.64 (PB4), J7.12
PN5: B7.1 (PB5), J7.10
PN6: B7.2 (PB6), J7.8
PN7: B7.4 (PB7), J7.6
PO0: B7.29 (PC0), J9.19
PO1: B7.30 (PC1), J9.17
PO2: B7.31 (PC2), J9.15
PO3: B7.32 (PC3), J9.13
PO4: B7.33 (PC4), J9.11
PO5: B7.34 (PC5), J9.9
PO6: B7.36 (PC6), J9.7
PO7: B7.37 (PC7), J9.5
PP0: B7.38 (PD0), J9.20
PP1: B7.39 (PD1), J9.18
PP2: B7.40 (PD2), J9.16
PP3: B7.41 (PD3), J9.14
PP4: B7.43 (PD4), J9.12
PP5: B7.44 (PD5), J9.10
PP6: B7.45 (PD6), J9.8
PP7: B7.46 (PD7), J9.6
PX0: B6.51 (PA0), J6.19
PX1: B6.52 (PA1), J6.17
PX2: B6.53 (PA2), J6.15
PX3: B6.54 (PA3), J6.13
PX4: B6.56 (PA4), J6.11
PX5: B6.57 (PA5), J6.9
PX6: B6.58 (PA6), J6.7
PX7: B6.59 (PA7), J6.5
~CS_{AB}: B1.11 (Device_~CS_{AB}), B5.46 (~CS_{AB_5V})
~CS_{CD}: B1.20 (Device_~CS_{CD}), B5.45 (~CS_{CD_5V})
~CS_{EF}: B4.11 (Device_~CS_{AB}), B5.44 (~CS_{EF_5V})
~CS_{GH}: B4.20 (Device_~CS_{CD}), B5.43 (~CS_{GH_5V})
~CS_{KL}: B5.41 (~CS_{KL_5V}), B6.20 (Device_~CS_{CD})
~CS_{MN}: B5.40 (~CS_{MN_5V}), B7.11 (Device_~CS_{AB})
~CS_{OP}: B5.39 (~CS_{OP_5V}), B7.20 (Device_~CS_{CD})
~CS_{XJ}: B5.42 (~CS_{XJ_5V}), B6.11 (Device_~CS_{AB})
~Device CLK: J5.B16
~Device Enable: J5.B22, NT3.1
~Device Interrupt: B5.30 (~IRQ), J5.B19
~Device RAM: B3.23 (~Device_RAM), B5.5 (~Device_RAM)
~Device ROM: B3.25 (~Device_ROM), B5.4 (~Device_ROM), IC3.22 (~CE)
~Device Registers: B3.24 (~Device_Registers), B5.2 (~Device_Registers)
~Device Select: B2.33 (Deivce_~CS), B3.2 (~Device_Select)
~Interrupt_{AB}: B1.3 (~IRQ_{AB}), B5.28 (~IRQ_{AB}), RN1.2 (R1)
~Interrupt_{CD}: B1.26 (~IRQ_{CD}), B5.27 (~IRQ_{CD}), RN1.3 (R2)
~Interrupt_{EF}: B4.3 (~IRQ_{AB}), B5.26 (~IRQ_{EF}), RN1.4 (R3)
~Interrupt_{GH}: B4.26 (~IRQ_{CD}), B5.25 (~IRQ_{GH}), RN1.5 (R4)
~Interrupt_{KL}: B5.23 (~IRQ_{KL}), B6.26 (~IRQ_{CD}), RN1.7 (R6)
~Interrupt_{MN}: B5.22 (~IRQ_{MN}), B7.3 (~IRQ_{AB}), RN1.8 (R7)
~Interrupt_{OP}: B5.21 (~IRQ_{OP}), B7.26 (~IRQ_{CD}), RN1.9 (R8)
~Interrupt_{XJ}: B5.24 (~IRQ_{XJ}), B6.3 (~IRQ_{AB}), RN1.6 (R5)
~Main Access: J5.B11
~Main: J5.B9
~Memory A: J5.B29
~Memory B: J5.B30
~RD: B2.46 (~RD), IC3.24 (~OE)
~Reset Device: B3.15 (~Reset_{IN1}), J5.B20
~Reset System: B3.14 (~Reset_{IN2}), J5.A1
~Reset: B1.7 (~Reset), B4.7 (~Reset), B5.53 (~Reset_{5V}), B6.7 (~Reset), B7.7 (~Reset)
~Reset_{3V}: B3.19 (~Reset_{OUT}), B5.1 (~Reset)
~Select Device: B2.32 (Deivce_~CS_{IN}), J5.B21
~WD: B1.9 (R~W), B2.45 (~WD), B4.9 (R~W), B6.9 (R~W), B7.9 (R~W), IC3.31 (~WE)

Notes on the sheet:
Device Buffer signals are 5V.
~{CS} signals are 5V.
~{Reset} is 5V.
PHI2 is 5V.
