andrewpaterson/HCP65/Kicad/Computer/VIA/VIA Breakout/VIA Breakout.kicad_sch

## KiCad design Kicad/Computer/VIA/VIA Breakout/VIA Breakout.kicad_sch (2026-11-01)

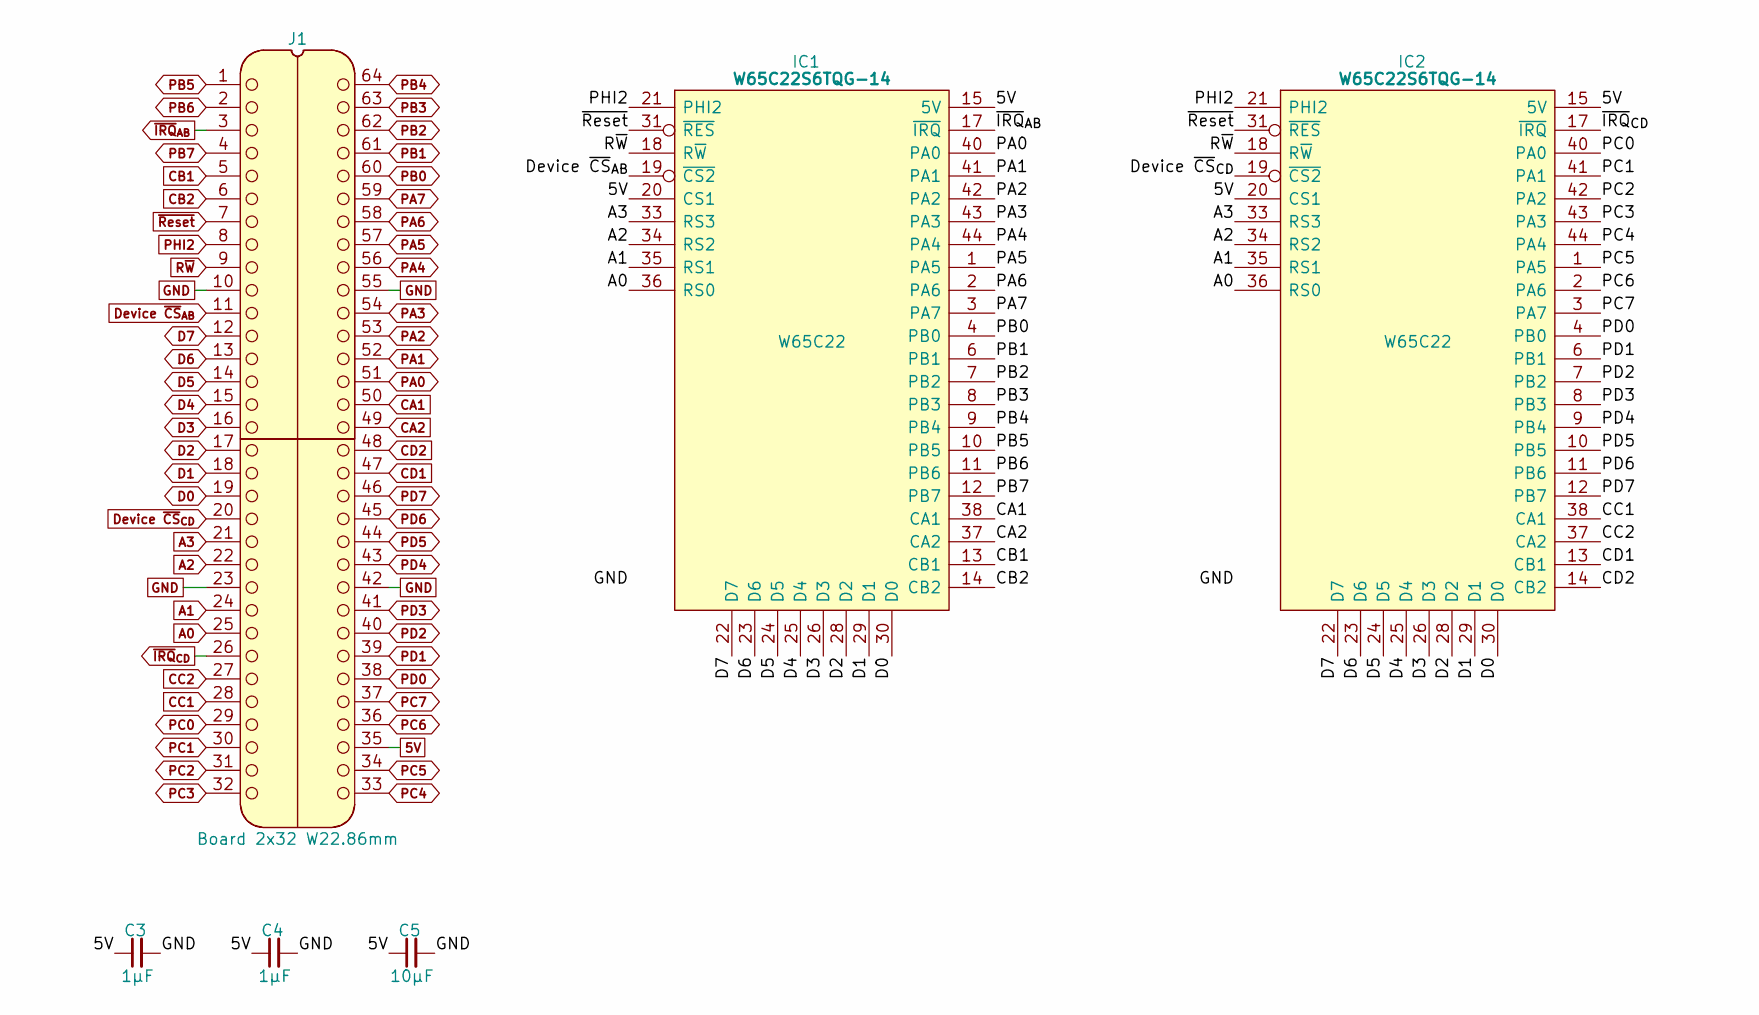
[picture p333: schematic VIA Breakout.kicad_sch]

Parts:
C3, C4: 1μF; C_0805
C5: 10μF; C_0805
IC1, IC2: W65C22S6TQG-14; QFP80P1320X1320X270-44N; Mouser Part Number 955-W65C22S6TQG-14
J1: Board 2x32 W22.86mm; DIP-64_Board_W22.86mm

Connections:
5V: C3.1, C4.1, C5.1, IC1.15 (5V), IC1.20 (CS1), IC2.15 (5V), IC2.20 (CS1), J1.35
A0: IC1.36 (RS0), IC2.36 (RS0), J1.25
A1: IC1.35 (RS1), IC2.35 (RS1), J1.24
A2: IC1.34 (RS2), IC2.34 (RS2), J1.22
A3: IC1.33 (RS3), IC2.33 (RS3), J1.21
CA1: IC1.38 (CA1), J1.50
CA2: IC1.37 (CA2), J1.49
CB1: IC1.13 (CB1), J1.5
CB2: IC1.14 (CB2), J1.6
CC1: IC2.38 (CA1), J1.28
CC2: IC2.37 (CA2), J1.27
CD1: IC2.13 (CB1), J1.47
CD2: IC2.14 (CB2), J1.48
D0: IC1.30 (D0), IC2.30 (D0), J1.19
D1: IC1.29 (D1), IC2.29 (D1), J1.18
D2: IC1.28 (D2), IC2.28 (D2), J1.17
D3: IC1.26 (D3), IC2.26 (D3), J1.16
D4: IC1.25 (D4), IC2.25 (D4), J1.15
D5: IC1.24 (D5), IC2.24 (D5), J1.14
D6: IC1.23 (D6), IC2.23 (D6), J1.13
D7: IC1.22 (D7), IC2.22 (D7), J1.12
Device ~CS_{AB}: IC1.19 (~CS2), J1.11
Device ~CS_{CD}: IC2.19 (~CS2), J1.20
GND: C3.2, C4.2, C5.2, IC1.39 (GND), IC2.39 (GND), J1.10, J1.23, J1.42, J1.55
PA0: IC1.40 (PA0), J1.51
PA1: IC1.41 (PA1), J1.52
PA2: IC1.42 (PA2), J1.53
PA3: IC1.43 (PA3), J1.54
PA4: IC1.44 (PA4), J1.56
PA5: IC1.1 (PA5), J1.57
PA6: IC1.2 (PA6), J1.58
PA7: IC1.3 (PA7), J1.59
PB0: IC1.4 (PB0), J1.60
PB1: IC1.6 (PB1), J1.61
PB2: IC1.7 (PB2), J1.62
PB3: IC1.8 (PB3), J1.63
PB4: IC1.9 (PB4), J1.64
PB5: IC1.10 (PB5), J1.1
PB6: IC1.11 (PB6), J1.2
PB7: IC1.12 (PB7), J1.4
PC0: IC2.40 (PA0), J1.29
PC1: IC2.41 (PA1), J1.30
PC2: IC2.42 (PA2), J1.31
PC3: IC2.43 (PA3), J1.32
PC4: IC2.44 (PA4), J1.33
PC5: IC2.1 (PA5), J1.34
PC6: IC2.2 (PA6), J1.36
PC7: IC2.3 (PA7), J1.37
PD0: IC2.4 (PB0), J1.38
PD1: IC2.6 (PB1), J1.39
PD2: IC2.7 (PB2), J1.40
PD3: IC2.8 (PB3), J1.41
PD4: IC2.9 (PB4), J1.43
PD5: IC2.10 (PB5), J1.44
PD6: IC2.11 (PB6), J1.45
PD7: IC2.12 (PB7), J1.46
PHI2: IC1.21 (PHI2), IC2.21 (PHI2), J1.8
R~W: IC1.18 (R~W), IC2.18 (R~W), J1.9
~IRQ_{AB}: IC1.17 (~IRQ), J1.3
~IRQ_{CD}: IC2.17 (~IRQ), J1.26
~Reset: IC1.31 (~RES), IC2.31 (~RES), J1.7
