andrewpaterson/HCP65/Kicad/Computer/VIA/VIA Control/VIA Control.kicad_sch

## KiCad design Kicad/Computer/VIA/VIA Control/VIA Control.kicad_sch (2026-11-01)

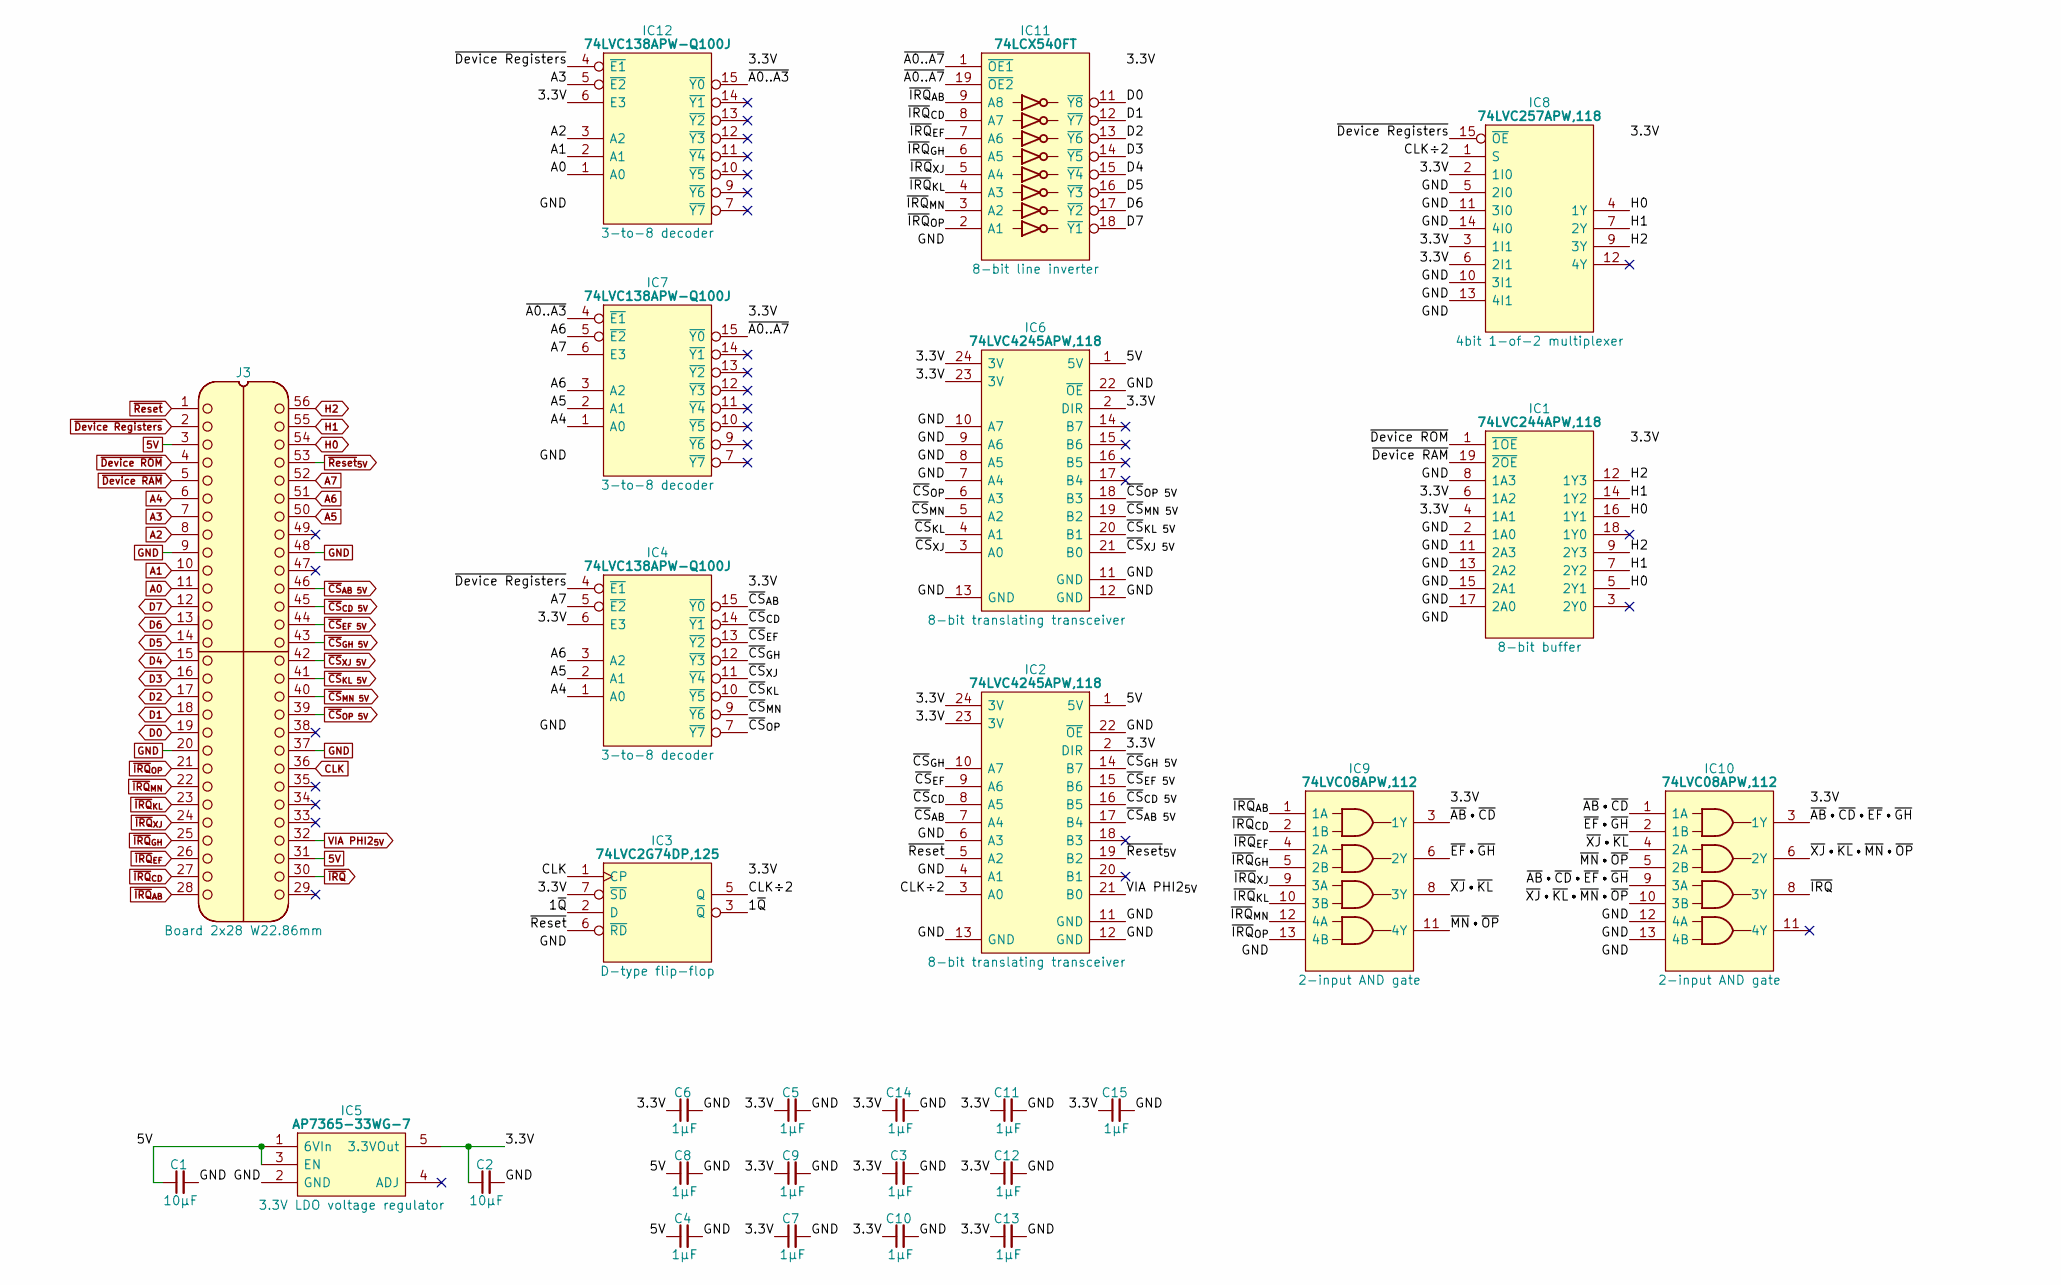
[picture p334: schematic VIA Control.kicad_sch]

Parts:
C1, C2: 10μF; C_0805
C3, C4, C5, C6, C7, C8, C9, C10, C11, C12, C13, C14, C15: 1μF; C_0805
IC1: 74LVC244APW,118; SOP65P640X110-20N; Manufacturer_Part_Number 74LVC244APW,118; Mouser Part Number 771-74LVC244APW-T
IC2, IC6: 74LVC4245APW,118; SOP65P640X110-24N; Mouser Part Number 771-74LVC4245APW-T
IC3: 74LVC2G74DP,125; SOP65P400X110-8N; Manufacturer_Part_Number 74LVC2G74DP,125; Mouser Part Number 771-74LVC2G74DP-G
IC4, IC7, IC12: 74LVC138APW-Q100J; SOP65P640X110-16N; Mouser Part Number 771-74LVC138APWQ100J
IC5: AP7365-33WG-7; SOT95P285X130-5N; Manufacturer_Part_Number AP7365-33WG-7; Mouser Part Number 621-AP7365-33WG-7
IC8: 74LVC257APW,118; SOP65P640X110-16N; Mouser Part Number 771-74LVC257APW-T
IC9, IC10: 74LVC08APW,112; SOP65P640X110-14N; Manufacturer_Part_Number 74LVC08APW,112; Mouser Part Number 771-74LVC08APW
IC11: 74LCX540FT; SOP65P640X120-20N; Manufacturer_Part_Number 74LCX540FT; Mouser Part Number 757-74LCX540FT
J3: Board 2x28 W22.86mm; DIP-56_Board_W22.86mm

Connections:
1~Q: IC3.2 (D), IC3.3 (~Q)
3.3V: C2.1, C3.1, C5.1, C6.1, C7.1, C9.1, C10.1, C11.1, C12.1, C13.1, C14.1, C15.1, IC1.4 (1A1), IC1.6 (1A2), IC1.20 (3V), IC2.2 (DIR), IC2.23 (3V), IC2.24 (3V), IC3.7 (~SD), IC3.8 (3V), IC4.6 (E3), IC4.16 (3V), IC5.5 (3.3VOut), IC6.2 (DIR), IC6.23 (3V), IC6.24 (3V), IC7.16 (3V), IC8.2 (1I0), IC8.3 (1I1), IC8.6 (2I1), IC8.16 (3V), IC9.14 (3V), IC10.14 (3V), IC11.20 (3V), IC12.6 (E3), IC12.16 (3V)
5V: C1.1, C4.1, C8.1, IC2.1 (5V), IC5.1 (6VIn), IC5.3 (EN), IC6.1 (5V), J3.3, J3.31
A0: IC12.1 (A0), J3.11
A1: IC12.2 (A1), J3.10
A2: IC12.3 (A2), J3.8
A3: IC12.5 (~E2), J3.7
A4: IC4.1 (A0), IC7.1 (A0), J3.6
A5: IC4.2 (A1), IC7.2 (A1), J3.50
A6: IC4.3 (A2), IC7.3 (A2), IC7.5 (~E2), J3.51
A7: IC4.5 (~E2), IC7.6 (E3), J3.52
CLK: IC3.1 (CP), J3.36
CLK÷2: IC2.3 (A0), IC3.5 (Q), IC8.1 (S)
D0: IC11.11 (~Y8), J3.19
D1: IC11.12 (~Y7), J3.18
D2: IC11.13 (~Y6), J3.17
D3: IC11.14 (~Y5), J3.16
D4: IC11.15 (~Y4), J3.15
D5: IC11.16 (~Y3), J3.14
D6: IC11.17 (~Y2), J3.13
D7: IC11.18 (~Y1), J3.12
GND: C1.2, C2.2, C3.2, C4.2, C5.2, C6.2, C7.2, C8.2, C9.2, C10.2, C11.2, C12.2, C13.2, C14.2, C15.2, IC1.2 (1A0), IC1.8 (1A3), IC1.10 (GND), IC1.11 (2A3), IC1.13 (2A2), IC1.15 (2A1), IC1.17 (2A0), IC2.4 (A1), IC2.6 (A3), IC2.11 (GND), IC2.12 (GND), IC2.13 (GND), IC2.22 (~OE), IC3.4 (GND), IC4.8 (GND), IC5.2 (GND), IC6.7 (A4), IC6.8 (A5), IC6.9 (A6), IC6.10 (A7), IC6.11 (GND), IC6.12 (GND), IC6.13 (GND), IC6.22 (~OE), IC7.8 (GND), IC8.5 (2I0), IC8.8 (GND), IC8.10 (3I1), IC8.11 (3I0), IC8.13 (4I1), IC8.14 (4I0), IC9.7 (GND), IC10.7 (GND), IC10.12 (4A), IC10.13 (4B), IC11.10 (GND), IC12.8 (GND), J3.9, J3.20, J3.37, J3.48
H0: IC1.5 (2Y1), IC1.16 (1Y1), IC8.4 (1Y), J3.54
H1: IC1.7 (2Y2), IC1.14 (1Y2), IC8.7 (2Y), J3.55
H2: IC1.9 (2Y3), IC1.12 (1Y3), IC8.9 (3Y), J3.56
VIA PHI2_{5V}: IC2.21 (B0), J3.32
~A0..A3: IC7.4 (~E1), IC12.15 (~Y0)
~A0..A7: IC7.15 (~Y0), IC11.1 (~OE1), IC11.19 (~OE2)
~AB•~CD: IC9.3 (1Y), IC10.1 (1A)
~AB•~CD•~EF•~GH: IC10.3 (1Y), IC10.9 (3A)
~CS_{AB 5V}: IC2.17 (B4), J3.46
~CS_{AB}: IC2.7 (A4), IC4.15 (~Y0)
~CS_{CD 5V}: IC2.16 (B5), J3.45
~CS_{CD}: IC2.8 (A5), IC4.14 (~Y1)
~CS_{EF 5V}: IC2.15 (B6), J3.44
~CS_{EF}: IC2.9 (A6), IC4.13 (~Y2)
~CS_{GH 5V}: IC2.14 (B7), J3.43
~CS_{GH}: IC2.10 (A7), IC4.12 (~Y3)
~CS_{KL 5V}: IC6.20 (B1), J3.41
~CS_{KL}: IC4.10 (~Y5), IC6.4 (A1)
~CS_{MN 5V}: IC6.19 (B2), J3.40
~CS_{MN}: IC4.9 (~Y6), IC6.5 (A2)
~CS_{OP 5V}: IC6.18 (B3), J3.39
~CS_{OP}: IC4.7 (~Y7), IC6.6 (A3)
~CS_{XJ 5V}: IC6.21 (B0), J3.42
~CS_{XJ}: IC4.11 (~Y4), IC6.3 (A0)
~Device RAM: IC1.19 (~2OE), J3.5
~Device ROM: IC1.1 (~1OE), J3.4
~Device Registers: IC4.4 (~E1), IC8.15 (~OE), IC12.4 (~E1), J3.2
~EF•~GH: IC9.6 (2Y), IC10.2 (1B)
~IRQ: IC10.8 (3Y), J3.30
~IRQ_{AB}: IC9.1 (1A), IC11.9 (A8), J3.28
~IRQ_{CD}: IC9.2 (1B), IC11.8 (A7), J3.27
~IRQ_{EF}: IC9.4 (2A), IC11.7 (A6), J3.26
~IRQ_{GH}: IC9.5 (2B), IC11.6 (A5), J3.25
~IRQ_{KL}: IC9.10 (3B), IC11.4 (A3), J3.23
~IRQ_{MN}: IC9.12 (4A), IC11.3 (A2), J3.22
~IRQ_{OP}: IC9.13 (4B), IC11.2 (A1), J3.21
~IRQ_{XJ}: IC9.9 (3A), IC11.5 (A4), J3.24
~MN•~OP: IC9.11 (4Y), IC10.5 (2B)
~Reset: IC2.5 (A2), IC3.6 (~RD), J3.1
~Reset_{5V}: IC2.19 (B2), J3.53
~XJ•~KL: IC9.8 (3Y), IC10.4 (2A)
~XJ•~KL•~MN•~OP: IC10.6 (2Y), IC10.10 (3B)
