andrewpaterson/HCP65/Kernal/Kernal.h

#ifndef __KERNAL_H__
#define __KERNAL_H__
#include "BaseLib/PrimitiveTypes.h"


#define KERNAL_BOOT_FILE				"\\boot.exe"
#define KERNAL_NO_BOOT_ARGUMENT			0xFFFF		//guiKernalBootArgument in the ROM: boot.exe's argument is 0.

#define KERNAL_STATE_STARTING			0x0001
#define KERNAL_STATE_DEVICES_SCANNED	0x0002
#define KERNAL_STATE_NO_SD_CARD_BOARD	0x0003
#define KERNAL_STATE_SD_CARD_FAILED		0x0004
#define KERNAL_STATE_MOUNT_FAILED		0x0005
#define KERNAL_STATE_MOUNTED			0x0006
#define KERNAL_STATE_BOOT_FAILED		0x0007
#define KERNAL_STATE_BOOT_EXITED		0x0008
#define KERNAL_STATE_NO_MAIN_MEMORY		0x0009		//No memory board gave enough for the tables and the heap.


//What the kernal found starting up, for tests and debuggers to read.
struct SKernalStatus
{
	uint16	uiState;		//KERNAL_STATE_*.
	uint16	uiSDError;		//KERNAL_SD_* when the card failed.
	uint16	uiFatCode;		//The EFatCode Mount returned.
	uint16	uiFileSystem;	//EFatFileSystemType.
	uint32	uiNumSectors;
	uint32	uiNumClusters;
	uint32	uiFreeClusters;
	uint16	uiBootResult;	//KERNAL_PROCESS_* for boot.exe.
	uint16	uiExitCode;		//boot.exe's exit code.
	uint16	uiUserValue;	//The last value a process gave the kernal (COP 1).
	uint16	uiBootArgument;	//boot.exe's argument (KernalGetArgument), from guiKernalBootArgument.
	uint16	uiSDCards;		//Bit n set: the card in socket n came up.
	uint16	uiSDSocket;		//The socket whose card's volume is mounted.
	uint32	uiStrayInterrupts;	//Bit n set: device n interrupted with no handler, and was reset (KernalInterrupts.asm).
	uint32	uiDevices;			//Bit n set: socket n holds a device whose ROM describes it (KERNAL_DEVICE_PRESENT).
	uint32	uiBadDevices;		//Bit n set: socket n holds a board whose ROM isn't usable or that is in the wrong socket.
	uint32	uiLoadedDrivers;	//Bit n set: socket n's board's driver was loaded from the SD card (KernalDriverLoader.h).
	uint16	uiDriverError;		//Why the last driver that didn't load didn't (KERNAL_LOAD_*), 0 if they all did.
	uint32	uiHeapPeak;			//The most of the kernal's heap (MPU RAM) used, once boot.exe has exited.
	uint32	uiMainHeapPeak;		//The most of its main memory heap used, then.
	uint16	uiMainBanks;		//The banks of main memory the memory boards gave (KernalMemory.h).
};


extern SKernalStatus	gsKernalStatus;
extern uint16			guiKernalBootArgument;	//Image data (the start up doesn't set it): tests patch the ROM.




#endif // __KERNAL_H__
