andrewpaterson/HCP65/HCP65-Emulator/HCP65Lib/HCP65Device.cpp

#include "HCP65Device.h"


//////////////////////////////////////////////////////////////////////////
//
// uiMinimumSlotSize is HCP65_LARGE_SLOT_SIZE for a device that decodes A16.
//
//////////////////////////////////////////////////////////////////////////
void CHCP65Device::Init(uint32 uiMinimumSlotSize)
{
	mpcHCP65 = NULL;
	muiMinimumSlotSize = uiMinimumSlotSize;
	mbHeldInReset = true;
}


//////////////////////////////////////////////////////////////////////////
//
//
//////////////////////////////////////////////////////////////////////////
void CHCP65Device::Kill(void)
{
	mpcHCP65 = NULL;
}


//////////////////////////////////////////////////////////////////////////
//
//
//////////////////////////////////////////////////////////////////////////
void CHCP65Device::Attach(CHCP65* pcHCP65)
{
	mpcHCP65 = pcHCP65;
}


//////////////////////////////////////////////////////////////////////////
//
//
//////////////////////////////////////////////////////////////////////////
uint32 CHCP65Device::GetMinimumSlotSize(void)
{
	return muiMinimumSlotSize;
}


//////////////////////////////////////////////////////////////////////////
//
// A board with nothing to set up takes nothing from its <Board> tag.
// False, with pszError saying why (pcTag's directory is szDirectory), if
// the tag is wrong.
//
//////////////////////////////////////////////////////////////////////////
bool CHCP65Device::LoadXML(CMarkupTag* pcTag, const char* szDirectory, CChars* pszError)
{
	return true;
}


//////////////////////////////////////////////////////////////////////////
//
// A board with nothing to set up adds nothing to its <Board> tag.
//
//////////////////////////////////////////////////////////////////////////
void CHCP65Device::SaveXML(CXMLWriter* pcWriter)
{
}


//////////////////////////////////////////////////////////////////////////
//
// The system reset.
//
//////////////////////////////////////////////////////////////////////////
void CHCP65Device::Reset(void)
{
}


//////////////////////////////////////////////////////////////////////////
//
// The device's bit in the Device Reset/Enable registers.  Held is a reset.
//
//////////////////////////////////////////////////////////////////////////
void CHCP65Device::SetHeldInReset(bool bHeld)
{
	mbHeldInReset = bHeld;
	if (bHeld)
	{
		Reset();
	}
}


//////////////////////////////////////////////////////////////////////////
//
//
//////////////////////////////////////////////////////////////////////////
bool CHCP65Device::IsHeldInReset(void)
{
	return mbHeldInReset;
}


//////////////////////////////////////////////////////////////////////////
//
//
//////////////////////////////////////////////////////////////////////////
void CHCP65Device::CatchUp(uint64 uiCycle)
{
}


//////////////////////////////////////////////////////////////////////////
//
//
//////////////////////////////////////////////////////////////////////////
uint64 CHCP65Device::NextEvent(void)
{
	return HCP65_NEVER;
}


//////////////////////////////////////////////////////////////////////////
//
//
//////////////////////////////////////////////////////////////////////////
bool CHCP65Device::IsInterrupting(void)
{
	return false;
}


//////////////////////////////////////////////////////////////////////////
//
// A memory board's chip iChip (0 is A, 1 is B), HCP65_MEMORY_CHIP_SIZE
// bytes the HCP65 maps into main memory; NULL for any other device.
//
//////////////////////////////////////////////////////////////////////////
uint8* CHCP65Device::GetMemoryChip(int iChip)
{
	return NULL;
}
