andrewpaterson/HCP65/(commit log)

2026-11-01 Moved HCP65 Kicad computer stuff into the HPC65 repository.
    [Added 8bit-B_Cu.gbl, Added 8bit-B_Mask.gbs, Added 8bit-B_Paste.gbp, Added 8bit-B_Silkscreen.gbo, Added 8bit-Edge_Cuts.gm1, Added 8bit-F_Cu.gtl, Added 8bit-F_Mask.gts, Added 8bit-F_Paste.gtp]
2026-11-01 Track 3D models with Git LFS
2026-11-01 Moving ancillary HCP65 files from 658 computer into HCP65.
    [65C64 Instruction Architecture.ods, 65C64 Instruction Architecture.xlsx, Buffers, Transcievers and Translators.ods, Indexed Instructions.ods, Propagation Times (541).csv, Propagation Times (541).ods, Propagation Times.ods, Voltage Levels.ods]
2026-11-03 Beginning to optmise multiply and shift into 816 assembly (again).
2026-11-03 Fixed issues coming out of a full test run.
    [KernalAudio.asm]
2026-11-03 The board tester is a rooted app object that owns its window.
2026-11-03 The board tester app is set up after it is in the root.
    Init(void) makes an empty app; Setup(...) builds the window and the rest
    once the app has been added to the root, so it is built under the root
    rather than as an unrooted graph (every pointer change in an unrooted graph
    walks it to work out its distance to the stack).
2026-11-04 The emulator and Windows board tester app only runs when Setup succeeded.
    All the app mains now do Setup(...) && Run() (as the Linux board tester
    did) instead of ignoring Setup's result and relying on Run checking.
2026-11-04 A frame check finds W65C816 functions storing to their caller's stack.
    CAsm65816FrameCheck runs a program a step at a time and notes each direct
    page store by a function that has pointed D at a frame of its own, at or
    past the lower of its caller's frame (the caller's D + 1) and its caller's
    return address: past its own pushed arguments. Code on its caller's D (a
    runtime routine, a stub) isn't checked, nor stores through pointers.
    CAsm65816Lockstep runs one too (SetFrameCheck), through its BeforeStep and
    AfterStep.
2026-11-04 The frame check keeps the stores it finds as records, and a return ends the call it returns to.
    CAsm65816FrameCheck's faults are SAsm65816FrameWrite records (NumWrites, GetWrite), so a caller can put each
    at its function before AppendWrite writes it. A call remembers the instruction it returns to: a return there
    ends it even when S didn't come back (a frame entry helper reached by jsr moves S and returns), as well as
    those started at or below S.
2026-11-05 The HCP65 can be debugged through EmulatorDebugLib (CHCP65DebugTarget).
    CHCP65DebugTarget runs the HCP65 a budget of cycles at a time and reads and writes memory through its
    memory map as it is now (CHCP65::MemoryAt), without touching devices: they read as $FF and a write stops at
    the first. CHCP65::Run stops at the processor's breakpoints (IsAtBreakpoint) and doesn't count the return
    before one as an instruction. The emulator's solution and the Linux builds have ThreadLib and
    EmulatorDebugLib; TestHCP65Debugger debugs a booted HCP65 through a CDebugServer.
    [HCP65.cpp, HCP65.h, HCP65DebugTarget.cpp, HCP65DebugTarget.h, TestHCP65Debugger.cpp, TestHCP65Lib.cpp]
2026-11-05 The HCP65 Emulator can be debugged: --debug-shm <name> or --debug-tcp <port>.
    CHCP65EmulatorDebugger serves a CDebugServer on a shared memory channel or a TCP port (0 picks one, printed
    as "HCP65 debug port N"); the emulator waits stopped for the debugger, and the HCP65's clock doesn't move
    while it's stopped. --exit-on-detach closes the window when the debugger detaches.
2026-11-05 A W65C816 disassembler (Asm65816Disassemble) writes Assembler65816Syntax.txt's syntax.
    An instruction at an address, with the widths m and x give its immediates (rep and sep change them as they are
    disassembled), as "lda [D + $04]". Every opcode but the branches assembles back to its bytes; a branch's operand
    is the address it goes to.
2026-11-05 The HCP65 Emulator runs until a debugger attaches, or waits for one with --debug-wait.
    Debuggable, it runs from the start and a debugger can attach whenever it likes; over the network another can
    attach after one detaches. --debug-wait holds it before its first instruction until a debugger continues it.
2026-11-05 The W65C816's opcodes say what they do to the flow (Asm65816Flow) and where they go (Asm65816FlowTarget).
    Calls (jsr, jsl, brk, cop), returns, jumps and conditional branches, and the target a branch's, an absolute jump's
    or call's (in the program bank) or a long one's operand gives. For a debugger stepping and disassembling.
2026-11-05 The HCP65's instructions are decoded for the debugger by what the W65C816's assembler knows.
    CAsm65816DebugDecoder gives Asm65816Disassemble's text, Asm65816Flow's kinds and Asm65816FlowTarget's targets,
    with the target's own widths (P and E, changed by rep and sep among the instructions). CHCP65DebugTarget hands it
    out and writes addresses as bank:address. HCP65Lib links Assembler65Lib, in the emulator's solution and its
    Linux builds; TestHCP65Debugger disassembles through it.
2026-11-05 An assembly file's lines that write bytes are source lines, so its code is in the line table.
    CAsm65BaseAssembler::SetSourceFile names the file being assembled into an object: each line of the final pass
    that writes bytes (an instruction or data) becomes a source line at its start, as .line makes compiled code's.
    CAsm65IncludeSource says which file and line each line came from (GetFile, GetLine), so an included file's lines
    are its own.
2026-11-05 CAsm65LineTable can be written to a file and read back (Write, Read, WriteFile, ReadFile), for a debugger.
    A chunk file of the table's files, lines and fingerprints, with a magic and version: a file that isn't a line
    table of this version reads as nothing.
2026-11-05 CAsm65LineTable::FindLineAddresses gives where a source line's code starts, each place, or the next line's with code, as a debugger binds a breakpoint.
    Files are found by path in either case and with either slash (FindFile).
2026-11-05 The HCP65's debug target shows the process ID (PID, read only) after the W65C816's registers, so the debugger shows which process stopped.
2026-11-05 The emulator has a debug port in socket 7, so a debugger follows the kernal's processes.
2026-11-05 Chunk files read with CChunkFile::Init: it no longer hashes (InitUnhashed is gone) and reading never checks hashes.
    [KernalProcess.cpp]
2026-11-05 SD Card Board Faults.txt lists the faults and timing problems found in the SD Card Board's netlists.
2026-11-05 KernalInterrupts.txt plans the kernal's IRQ dispatch: assembly entry and dispatch, trusted handlers while the SD board's DMA has the main bus, devices quietened through their Flags register.
2026-11-06 Query current process for debug.
2026-11-06 The emulator's SD Card Board has a card in each of its four sockets (Flags D0-D1 selects the one the bus reaches; InsertCard, RemoveCard, GetImage and NumSectors take the socket, 0 by default), and i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
2026-11-06 The emulator models main memory contention: a processor access to main memory while the SD Card Board's DMA has it (CHCP65::SetMainMemoryBusy) latches Contention until reset, as the mainboard's Main 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
    [HCP65.cpp, HCP65.h, HCP65SDCard.cpp, TestHCP65Machine.cpp]
2026-11-06 The kernal brings up the card in each of the SD Card Board's four sockets and mounts the first FAT volume (gsKernalStatus.uiSDCards and uiSDSocket); each card selects its socket before using the boar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
2026-11-06 The kernal dispatches IRQs (KernalInterrupts.asm, KernalInterrupts.txt): Start.asm's KernalIrq saves the registers (without the stack when it came from user mode) and the dispatch calls each interrup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
    [Kernal.cpp, Kernal.h, KernalInterrupts.asm, KernalInterrupts.cpp, KernalInterrupts.h, KernalProcess.cpp, KernalProcess.h, KernalSDCard.cpp]
2026-11-06 The emulator has a fill mode (CHCP65::SetMemoryFill, the app's --fill-memory): MPU RAM and main memory are filled with $CC at reset, and each main memory bank the kernal tells the debug port it gave 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
    [HCP65.cpp, HCP65.h, HCP65DebugPort.cpp, HCP65DebugPort.h, TestHCP65Machine.cpp]
2026-11-06 The kernal doesn't clear the main memory banks it gives a process (a program's start up clears its bss); it tells the debug port instead, for the emulator's fill mode. TestHCP65Kernal runs in fill mo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
    [KernalProcess.cpp, KernalProcess.h, TestHCP65Kernal.cpp]
2026-11-06 The kernal is built with no floating point (NoFloats="true" in HCP65Kernal.hcp65build, SetNoFloats in TestHCP65Lib's kernal builder): a float in its code, or in a library function it links, is a buil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
    [HCP65KernalBuilder.cpp]
2026-11-06 The W65C816 runtime routines are Libc65 assembly: IR816Runtime-Common.asm (the divides, shifts, 64 bit multiply and BCD, no table), IR816Runtime-MathTables.asm (the multiplies with MathMult) and IR81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
2026-11-06 The maths tables aren't in the kernal's ROM: boot.exe loads \OS\Math\MULT.BIN and INVERT.BIN (all 256KB) from the SD card into main memory at $400000 and $420000, which the kernal maps into every pro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
    [HCP65ExeBuilder.cpp, HCP65ExeBuilder.h, HCP65KernalBuilder.cpp, HCP65KernalBuilder.h, Kernal.h, KernalProcess.h, Start.asm]
2026-11-06 The signed 16 and 32 bit divides are assembly scratch routines in IR816Runtime-Common.asm (R816_SDiv16, R816_SRem16, R816_SDiv32, R816_SRem32): the magnitudes in place, R816_UDiv16 or R816_UDiv32 on 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
2026-11-06 R816_UDiv64, R816_URem64, R816_SDiv64 and R816_SRem64 are one assembly body (four entries, the pushed convention as before): signed operands made their magnitudes in place, R816_UDiv32 on a scratch f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
2026-11-06 boot.exe loads only INVERT's upper half (the soft float's reciprocals; nothing reads the lower half) from $20000 in \OS\Math\INVERT.BIN, which keeps all of it, to $420000 with KernalFileRead: 128KB l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
    [HCP65KernalBuilder.h, Kernal.h, KernalProcess.h, TestHCP65Kernal.cpp]
2026-11-06 Every device board describes itself in the 1KB device ROM at the start of its slot: the magic $C0DAFE1A, the format, its revision, the device bus it needs (32KB or 128KB), what it does on the main bu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
2026-11-06 DeviceROM (HCP65\DeviceROM, its own solution and a CMakeLists.txt) is the device ROM tool: DeviceROM <board.xml> [<image.bin>] makes a board's 1KB ROM image from its <DeviceROM> description (Name, Ma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
    [TestHCP65Machine.cpp]
2026-11-06 The HCP65 symbol library's component board symbols (Audio Address Decode, Audio Clock, Audio DAC, Clock Hold Standard, Comparator 16bit, Counter 16bit with IO, Device Buffer, Device Decode stage A an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
2026-11-06 The Sound Board's and SD Card Board's device ROM chips (IC2 and IC1, the SST39VF010s on Device Decode Stage A's ~{Device ROM}) have the ROM_Manufacturer ("HCP65") and ROM_Driver (SOUND.DRV, SDCARD.DR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
    [Audio Board.kicad_sch, SD Card Board.kicad_sch]
2026-11-06 The device ROM tool reads a board's KiCad schematic (KicadLib): DeviceROM <board.kicad_sch> [<board.xml> [<image.bin>]] writes the <DeviceROM> description it works out (CDeviceROMSchematic, DeviceRom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
2026-11-06 The kernal's boards have drivers: CKernalDriver (KernalDriver.h) is the driver of the board in one slot, its units numbered within it. Init takes the board out of reset and Kill holds it in reset aga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
    [Kernal.cpp, Kernal.h, KernalDevices.cpp, KernalDevices.h, KernalDriver.cpp, KernalDriver.h, KernalProcess.cpp, KernalProcess.h]
2026-11-06 Updated some Kicad files to version 10.
    [LCD Dual 7 Segment Tester.kicad_sch, LED Display.kicad_sch]
2026-11-06 CAsm65816Profile has call sites: the calls of each function from each source line and the cycles inside them, with everything they called (GetCallSite; "callsite" records in the profile file; a "Call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
2026-11-06 TestHCP65DeviceROMFromXML makes the Output directory before writing BadDeviceROM.xml into it: without one (a fresh checkout) fopen failed and the test crashed.
    [TestHCP65Machine.cpp]
2026-11-06 The kernal loads drivers from the SD card: once the volume is mounted, each present board with no driver whose device ROM names one gets \OS\Drivers\<file>, a relocatable module (Assembler65Lib's CAs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
2026-11-06 TestHCP65DeviceROMFromXML makes Output with TouchDir and checks it is a directory: TouchDir returns false when Output is already there, so asserting what it returned failed every run after the first.
    [TestHCP65Machine.cpp]
2026-11-06 Drivers can drive more than one board of a kind, use more of the kernal and are visible to a debugger. KernalCreateDriver takes an index: a driver file is loaded once and each board that names it get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
2026-11-06 Programs use boards through their drivers with the device calls (HCP65User.h): KernalDeviceInfo lists the boards, KernalDeviceOpen(manufacturer, name, index, unit) gives a handle on a unit, and Kerna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
2026-11-06 Output/ and Listing/ are ignored wherever they are: HCP65-IDE and hcp65build write them beside every solution (ModPlay, Kernal, OperatingSystem, drivers), as the emulator and the tests write Output/.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
2026-11-07 KernalDeviceRead and KernalDeviceWrite say how many bytes they moved (uint32* puiDone, NULL if not wanted): the kernal gives it back in the call block's uiResult, which a driver's Read and Write add 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
2026-11-07 A process owns the units it opens, not the board: the kernal calls the driver's Close(unit, process) when the process closes its last handle on that unit (it matched the slot only), and Close(KERNAL_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
    [KernalDeviceCalls.cpp, KernalDriver.cpp, KernalDriver.h, KernalExports.asm]
2026-11-07 UART Board Bugs.txt (beside the schematic) lists the V0 board's confirmed bugs: Stage A's B4 pin 23 (~{Device_RAM}) drives the device ROM's ~CE and pin 25 the ~{Device RAM} net, the other way round f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
2026-11-07 The emulator has the UART Board (HCP65Lib's CHCP65UARTBoard), as it should be with the Stage A fix: two TL16C550Ds (CHCP65UART), UART1 on the TTL module at $408 and UART2 on the RS232 module at $400,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
    [TestHCP65Machine.cpp]
2026-11-07 UART.DRV drives the UART Board (Drivers/UARTBoard; programs use UserLib's HCP65UARTBoard.h). Its units are the two ports, UART_BOARD_TTL and UART_BOARD_RS232, each opened by its own process (CKernalU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
2026-11-07 TestHCP65KernalUART boots UARTTest (HCP65/UARTTest, as boot.exe on Output/UARTCard.img) at the board's 25MHz with the UART Board, playing both ports' far ends. It checks bad units, codes and argument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
    [TestHCP65Kernal.cpp, UARTTest.cpp]
2026-11-07 The UART driver's IsSent reads LSR through ReadLineStatus, which keeps its errors: it read LSR itself, so an overrun, parity, framing or break error that arrived during a device call (interrupts off)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
    [HCP65UART.cpp, HCP65UART.h, UARTBoard.cpp]
2026-11-07 The emulated UART Board is HCP65Lib's HCP65UART.h and .cpp (guard __HCP65_UART_H__), as the sound board is HCP65Audio.h: as HCP65UARTBoard.h it had UserLib's HCP65UARTBoard.h's name and include guard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
2026-11-07 The UART Board's sizes have names: the driver's rings are UART_RING_SIZE (256, holding UART_BOARD_BUFFER_SIZE), and the emulated board's registers end at HCP65_UART_REGISTERS_END ($800), A0-A2 are HC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
2026-11-07 The UART driver reads a register it only reads to clear (RBR, MSR and IIR in Reset, MSR for a modem status interrupt) with Discard, which says so, in place of a bare volatile read.
    [UARTBoard.cpp, UARTBoard.h]
2026-11-07 The UART driver's Flush turns the received interrupt back on without checking the port has an owner: only Control calls it, through an open handle.
2026-11-07 The UART Board's two UARTs are called TTL and RS232 on both sides, as the units are: the driver's UART_TTL_REGISTERS and UART_RS232_REGISTERS (were UART1_ and UART2_REGISTERS), the emulated board's m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
2026-11-07 KERNAL_DRIVER_IN_USE says another process has the board (or the unit) open, as HCP65User.h's KERNAL_DEVICE_IN_USE does.
2026-11-07 UserLib has KernalDeviceIsOpen(manufacturer, name, index): whether a program has that board open (KernalDeviceInfo's flag), false if there isn't one. It replaces boot.exe's BootIsSoundBoardOpen and U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
    [UARTTest.cpp]
2026-11-07 The kernal tests share their set-up: TestKernalCopyBlankCard copies the blank card to Output, TestKernalSetBootArgument sets boot.exe's argument and gives where the kernal's status is, and TestKernal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
    [TestHCP65Kernal.cpp]
2026-11-07 HCP65User.h has KERNAL_DEVICE_TICKS_PER_SECOND (256), KernalDeviceWait's ticks: UARTTest's wait is a second of them, and the comments that said 256 or the kernal's KERNAL_TICKS_PER_SECOND name it.
2026-11-07 The emulated UART counts the times the far end has a character to send and finds RTS off (CHCP65UART::NumHoldOffs), and TestHCP65KernalUART checks the RS232 port's far end was held off by that count.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
    [HCP65UART.cpp, HCP65UART.h, TestHCP65Kernal.cpp, TestHCP65Machine.cpp]
2026-11-07 CKernalDriver keeps each unit's owner (mauiOwners, up to KERNAL_DRIVER_MAX_UNITS) and does Open, Close and IsOpen itself, no longer virtual: a process has the whole board unless the driver's Init set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
    [KernalDriver.cpp, KernalDriver.h, KernalExports.asm, KernalSDCard.cpp, KernalSDCard.h, UARTBoard.cpp]
2026-11-07 CHCP65::DeviceTick and CycleOfDeviceTick turn CPU cycles into a device clock's ticks and back for any rate, taking whole seconds apart so they don't overflow (a 1.8432MHz tick count times the clock o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
2026-11-07 boot.exe checks a process can't open a unit of a board another process has (checks 15 to 17): with the first sound board's left unit open it runs itself as a child (argument $B0C1, BootChild), which 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
2026-11-07 The assembler counts the kernal's exports: guiKernalNumExports is (KernalExportsEnd - gauiKernalExports) / 8, so adding to the table is enough (the count was kept by hand). TestKernalExports checks t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
2026-11-07 DeviceROMSchematic finds a symbol's pin with CKicadSchemSymbol::IsUnitPin.
2026-11-07 CAsm65Module has its File and Limit and is read and written as a build configuration's <Module File Entry Limit>, as CAsm65Executable is <Executable>; Make keeps its base (the link's __text_start, Ge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
    [HCP65DriverBuilder.cpp]
2026-11-07 The sound board's and the UART Board's drivers have solutions (Drivers\SoundBoard\HCP65SoundBoard.sln, Drivers\UARTBoard\HCP65UARTBoard.sln) and build configurations: Debug and Release|W65C816 link S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
2026-11-07 The emulator's debugger is told of the drivers the kernal loads, as modules: CHCP65DebugTarget gives the debug port's drivers (NumModules, GetModule, TakeModuleEvent), and the port says when a reset 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
    [HCP65DebugPort.cpp, HCP65DebugPort.h, HCP65DebugTarget.cpp, HCP65DebugTarget.h, TestHCP65Debugger.cpp]
2026-11-07 The emulator's main memory is its memory boards' (CHCP65MemoryBoard: a 4MB sub-board of two 2MB chips, its device ROM saying windows A and B, written by hand as DeviceROM/Boards/MemoryBoard.xml) in t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
    [HCP65.cpp, HCP65.h, HCP65Device.cpp, HCP65Device.h, HCP65MemoryBoard.cpp, HCP65MemoryBoard.h]
2026-11-07 The kernal uses the memory boards' windows (KernalMemory): it gives each one its device ROM shows (WindowA, WindowB) the next window, 1, 2, 3 then 0, in socket order (devices 3, 4, 16 to 19), writes 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
    [Kernal.cpp, Kernal.h, KernalDriverLoader.h, KernalMemory.cpp, KernalMemory.h, KernalProcess.cpp, KernalProcess.h, KernalSDCard.cpp]
2026-11-07 CHCP65Emulator's boards, debugger and listeners are U_Unknown, not U_Data: StandardLib only saves U_Data's bytes, which mean nothing for them.
2026-11-07 The boards' device ROM chips say their manufacturer (ROM_Manufacturer HCP65) and driver file (ROM_Driver): Blitter Board BLITTER.DRV, Coprocessor Board COPROC.DRV, Graphics Board GRAPHICS.DRV, LCD an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
    [Blitter Board.kicad_sch, Coprocessor Board - Main.kicad_sch, Graphics Board.kicad_sch, LCD Board.kicad_sch, Memory Board.kicad_sch, PS2 Board.kicad_sch, UART Board.kicad_sch, VIA Board.kicad_sch]
2026-11-07 A register's name from a schematic is plain text: KiCad's ~{}, _{} and ^{} markup is taken out and runs of spaces made one (the PS2 Board's PS2 FIFO_{ 1} is PS2 FIFO 1). TestHCP65DeviceROMFromSchemat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
2026-11-07 UART and VIA Boards: fix the device ROM and device RAM selects swapped at Stage A
    The device ROM's ~CE is on Stage A's ~{Device_ROM} again, as on the other boards.
    [UART Board.kicad_sch, VIA Board.kicad_sch]
2026-11-07 Remove the UART Board's swapped-selects bug note, now fixed in the schematic
    [HCP65UART.h]
2026-11-07 Video Board - Signals: spell Horizontal Sync Start correctly
    The schematic's labels and note and the PCB's net; the Gerbers are left as plotted.
    [Video Board - Signals.kicad_pcb, Video Board - Signals.kicad_sch]
2026-11-07 Device ROMs: a Private main bus flag for a board whose memory windows are its own
    DEVICE_MAIN_BUS_PRIVATE (MainBus "Private"): the Coprocessor Board's windows A and B are its coprocessors' memory,
    swapped onto the main bus only to load programs and collect results. MainBus's words and flags are one table
    (DeviceROMParseMainBus, DeviceROMMainBusText); a schematic's device ROM chip adds words with ROM_MainBus, which the
    Coprocessor Board's now has. Tests: a private description, an unknown word, and the Coprocessor Board's schematic.
    [Coprocessor Board - Main.kicad_sch]
2026-11-07 Kernal: a private board in a memory socket gets a window but isn't main memory
    The memory boards get their windows first, then the private boards (the Coprocessor Board), in socket order; only
    the memory boards' chips become banks. Each device's uiWindow says which window it was given, for a private
    board's driver. CHCP65::GetMemoryChannel lets the tests see the windows: with a private board scanned before the
    Memory Board, the Memory Board is still window 1 and nothing is put in the private board's memory; alone, it isn't
    main memory.
2026-11-07 The emulator's and board tester's colours come from the theme, not JewelColours.h.
    Colours come from the theme instead of JewelColours.h (commonlibraries 23f60eea4): text, icons, panels, editors, separators, the accent, success and failure. The window's background is coloured once the theme exists.
    [TesterApp.cpp]
2026-11-07 Video Board: its device ROM says its video memory is windows A and B, private
    The memory is on the Video Board - Memory board, past a connector DeviceROM doesn't follow, so the device ROM chip's
    ROM_MainBus gives all three words. The kernal gives it a window after the memory boards' and doesn't use its memory.
    [Video Board - Signals.kicad_sch]
2026-11-07 Emulator: the main memory channel's registers are latches that a reset doesn't clear
    On the Main Memory Channel the 74LVC573s' ~OE is tied low and LE comes only from the register write, so a reset
    leaves every socket in its window and at power on they hold anything. The emulator's start at 0 and keep their
    values through a reset; the test checks the windows survive one, and devices.md no longer says a reset puts every
    socket in window 0.
    [HCP65MemoryBoard.cpp, HCP65MemoryBoard.h, TestHCP65Machine.cpp]
2026-11-07 Mainboard Small: saved by KiCad 10
    The schematic's file format goes from KiCad 9's to 10's; its netlist is unchanged (67 parts, 493 nets, the same
    connections and fields).
    [Mainboard Small.kicad_sch]
2026-11-07 DeviceROM: the VIA Board's description, written by hand
    Its eight W65C22s (AB to OP) are selected by VIA Control, not a Stage B, so the schematic gave no registers: 16 each
    from $400 by A6-A4, and the inverted ~IRQs at $480. The test loads it.
    [TestHCP65Machine.cpp]
2026-11-07 DeviceROM: MakeImages.ps1 makes every board's ROM image for the programmer
    Into DeviceROM\Images (not committed): from the board's description in Boards\ if it has one, else from its
    schematic, with the worked-out description beside the image. devices.md says how to burn one.
2026-11-07 VIA Control: the interrupt register's 74LCX540 drives the data bus on writes too
    Written up beside the schematic: IC11's output enables are only the $480 address decode, so a write there has it
    and the Device Buffer's 245 driving D0-D7 against each other. The fix is to put ~OE2 on ~RD through a spare pin.
2026-11-07 Assembler: a negative absolute address is 32 bit two's complement, so [-4 + V] no longer warns.
2026-11-07 Website: move Drivers and Runtime under the HCP65 and add Emulator pages to the HCP65 and the W65C64.
2026-11-07 W65C64: delete the out of date Instruction Architecture .ods, the .xlsx is the current version.
    [65C64 Instruction Architecture.ods]
2026-11-07 The HCP65 Emulator and Board Tester draw only what changed
    Their windows drew all of themselves every paint. They draw only what
    changed now (SetPartialRedraw), as the HCP65 IDE does;
    HCP65_EMULATOR_VERIFY_REDRAW and HCP65_TESTER_VERIFY_REDRAW check each
    partial paint against drawing all of the window and log where they differ.
    The emulator's screen canvas is drawn every paint
    (CCanvas::SetDrawnEveryPaint): the emulated screen changes every tick
    without telling it. A 4 second emulator run with the check on logs no
    difference.
2026-11-08 The UART Board driver's wait kinds shift UART_WAIT_* as 32 bits: UART_WAIT_RX is a 16 bit int on the W65C816, and shifting it by 16 (undefined) kept IsWaitValid and IsWaitOver from compiling
2026-11-08 boot.exe's child opens the second sound board only when there is one: it is run with BOOT_CHILD_TWO when BootCheckDevices counted two or more sound boards, else BOOT_CHILD. The emulator has one sound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
2026-11-08 Libc65's and the kernal's assembly use CppParserLib's labels for const and volatile parameters (MemSwp's PKv, CChars::Init's PKc, KernalFindDriver's PKc, KernalCopyToUser's PKh, KernalSetInterruptHan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
2026-11-08 Ignore KiCad's .history folders and re-export the LCD Board's 3D model.
2026-11-08 Updated for Kicad 10.
    [LCD Board.kicad_sch]
2026-11-08 The emulator's boards come from a mainboard description (CHCP65Mainboard, HCP65Mainboard.h): <Mainboard Type="Small|Any|Full"> with a <Processor Index> holding each <Board Socket Type>, Type being th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
2026-11-08 The SD Card Board's cards are <Card Socket File> tags in its <Board>, one for each of its four card sockets (0 to 3), in place of the one Card attribute: File is relative to the mainboard description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
    [HCP65Mainboard.cpp, HCP65Mainboard.h, HCP65SDCard.cpp, HCP65SDCard.h]
2026-11-08 boot.exe's check 4 (a board the kernal keeps refuses to open) opens the SD Card Board, which every HCP65 has as boot.exe was loaded from it, rather than the Debug Port, which only the emulator has: w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
2026-11-08 TestHCP65Kernal's three machines are mainboard descriptions (Machines/Boot.xml, UART.xml and NoMainMemory.xml), all Small Mainboards, rather than boards plugged in by hand. The SD Card Board moves to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
2026-11-08 The kernal tells the emulator what it does with WDM rather than through a Debug Port board. It fills an SHCP65DebugMessage (Libraries/DebugLib/HCP65DebugMessage.h, the one layout both sides use) and 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
    [HCP65.cpp, HCP65.h, HCP65DebugPort.cpp, HCP65DebugPort.h, HCP65DebugTarget.cpp, HCP65DebugTarget.h]
2026-11-08 Updated Mainboard Small and Processor Board to Kicad 10.
    [Mainboard Small.kicad_pcb, Processor Board.kicad_pcb, Processor Board.kicad_sch]
2026-11-08 CHCP65Mainboard::ChangeBoards makes the sockets hold the boards asked for, at the moment of a system reset. It checks them all first (CanHold) and changes nothing if one won't fit, takes every board 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
    [HCP65Audio.cpp, HCP65Audio.h, HCP65Device.cpp, HCP65Device.h, HCP65Mainboard.cpp, HCP65Mainboard.h, HCP65SDCard.cpp, HCP65SDCard.h]
2026-11-08 The emulator has an HCP65 menu whose Board Configuration opens a dialog with a combo box for each of the mainboard's device sockets, of Empty and the boards that fit it. OK writes the new configurati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
    [BoardConfigurationDialog.h]
2026-11-08 The Board Configuration dialog shows the Small Mainboard's 3D model turning slowly, in perspective with the eye 30 degrees up from its plane, with the boards chosen standing in their sockets as the c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
    [BoardConfigurationDialog.h, BoardScene.cpp]
2026-11-08 The emulator turns off Windows' ghosting of a window that stops answering. Reading a board's model stops the window's loop for seconds, and when Windows took its ghost away the Board Configuration di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
2026-11-08 The Board Configuration dialog's combo boxes are in the order of the sockets along the Small Mainboard: 3 and 4, then 18, 19, 17 and 16. GetTypes reads the rows from the same table, so each still ans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
2026-11-08 Made some change to the Mainboard small PCB.
2026-11-08 The Board Configuration dialog's picture shows the Processor Board standing in its socket (MPU0), always, as the dialog has no combo box for it. It is as tall as a board gets, 161.925mm from the seat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
2026-11-08 The Board Configuration dialog's models go through CMeshFixReversed and CMeshSimplify before they are built, in each model's own units, and models saved by the old way are made again.
2026-11-08 The Board Configuration dialog's models go through CMeshCornerMerge, as CMeshSimplify is now called. Needs CommonLibraries' rename.
2026-11-08 The Board Configuration dialog's models go through CMeshWeldCorners and CMeshEdgeCollapse at 0.25mm, rather than CMeshCornerMerge at 0.75mm. Small text and chip legs survive, and about a third fewer 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
2026-11-08 The Board Configuration dialog's models go through CMeshMergeNormals, keeping only one of the normals that are exactly the same at a corner, which halves their vertices.
2026-11-08 The Board Configuration dialog's picture is drawn by 8 ThreadLib workers, taking a frame from 154ms to 30ms. Needs CommonLibraries' CRasteriser::SetJobs.
2026-11-08 The Board Configuration dialog is wider, with its picture and rows the size they were: they're in a middle column of a fixed width with weighted columns either side, so they stay that size and centre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
    [BoardConfigurationDialog.h]
2026-11-08 The Board Configuration dialog's mainboard goes right round in 30 seconds rather than 60.
2026-11-08 The emulator's window is 1920 x 1200 and the Board Configuration dialog's picture 782 high, half as big again and making the dialog half as high again. The mainboard is simplified to 6mm rather than 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
2026-11-09 The board scene's model version goes up, as CMeshEdgeCollapse's results have changed by a little.
2026-11-09 BoardScene has no cast for its model's filename, as ReadMesh takes a const char*.
2026-11-09 The board scene saves each model's mesh after its modifiers as a .DRG named after it in Output/Models, and loads from that while it's at least as new as the model's export, in place of its .rastermes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
2026-11-10 The board scene builds its models with RasterRenderLib
    CRasterMesh::Build moved to RasterRenderLib's BuildRasterMesh.
2026-11-10 The board scene holds its raster meshes in a CArray
    CRasterMesh is a CObject now. Its build include goes with the other
    libraries'.
2026-11-10 The board scene's instances only turn
    SRasterInstance has light axes and a mirror flag now.
2026-11-10 The board scene leaves removing degenerate triangles to BuildRasterMesh, which now does it for every raster mesh.
2026-11-10 HCP65Emulator has RenderLib in its solution and links it, for the board scene's CRenderScene. The Linux build already had it.
2026-11-10 The board scene is a CScene in millimetres, drawn through CRenderScene and CRasterFrame (ScenePlan step 6). Each model is a CMeshEditor, scaled to millimetres with CMeshEditor::Scale as its export is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
2026-11-10 CHCP65Mainboard::PlugInBoard starts szKnownType at NULL. It's always set before it's used, but MSVC can't tell, and its C4703 is an error in Debug builds, so the emulator's Debug configurations haven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
    [HCP65Mainboard.cpp]
2026-11-10 The Sound Board's frame buffer is under a lock: the host may take frames on another thread than the HCP65 runs on, and both sides move the first frame, as a full buffer drops its oldest.
2026-11-10 The HCP65 runs on a thread of its own, CHCP65EmulatorRunner, so it keeps running while a dialog such as Board Configuration is shown over the window, which stops the window's ticks. The thread runs i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
2026-11-10 The HCP65's sound plays on the window's sound mixer's thread, so it keeps playing while Board Configuration is open: its voice fills a CSound*, and changing the boards locks the mixer while the board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
2026-11-10 CHCP65Mainboard::Write keeps the comments that were before <Mainboard> in the description Read read, and indents with tabs, as the descriptions are written by hand: saving Board Configuration's board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
2026-11-10 The emulator's mainboard descriptions declare their encoding as UTF-8, as CXMLWriter writes it, so that saving one from Board Configuration with the same boards writes it back unchanged.
2026-11-10 The board scene's meshes hold the connections they're placed by, as CInstanceMesh now does.
2026-11-11 CppParserLib is CppCompilerLib (CommonLibraries): the name in the includes, the solutions, projects and CMake files that build it, and where the kernal's, the drivers' and Libc65's comments, the asse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
2026-11-11 The common libraries checkout is CommonLibraries: the CMake files, the apps' input XML paths, the 65 test runners' library paths and their comments name it so, rather than commonlibraries, which no l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
    [TestHCP65Kernal.cpp, TestLibc65Context.cpp]
2026-11-11 softfloat.cpp's and math.cpp's comments name the option that builds them in place of softfloat816.asm (CCPPCompileOptions::SetAssemblyUnits), now that the compiler's switches are options.
2026-11-12 Assembler65C64Syntax.txt: only add, sub and cmp sign extend with memory (cpy and the logical instructions are refused), and the spreadsheet is in HCP65/W65C64.
2026-11-12 Website: add the missing 65C64 pages. Assembler (lines, labels, expressions, directives, shortest forms, errors), Objects and Linking (sections, symbols, relocations, unused removal, COMDAT, lazy loa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
2026-11-12 Website: check the 65C64 pages. tools/check_instruction_tables.py fails when the instruction summary gives an operation or flags its page does not (web.sh runs it before a build), and TestAsm65C64Web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
2026-11-13 The emulator's and the tester's WinMains call BaseLib's BreakOnAllocation and LeakDetection (LeakDetector.h) rather than _CrtSetBreakAlloc and _CrtDumpMemoryLeaks, which only MSVC declares: they comp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
    [HCP65Tester.cpp]
2026-11-13 Website: the HCP65 C++ Compiler section. Building Programs (hcp65build from a solution and as a plain command line, the .hcp65build file, CCPP65Builder), Supported C++ (the types on each processor, t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
2026-11-13 Every 816 class and struct has the W65C816 prefix, as the W65C816 simulator's classes already had: CAsm65816 and SAsm65816 (the assembler), CIR816 and SIR816 (the back end), CFast65C816 and CFlat65C8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
2026-11-13 The rest of the 816 files are named W65C816, as its classes are: the assembler's AsmW65C816Disassembler, AsmW65C816Opcodes and AsmW65C816Instructions, the tests TestAsmW65C816*, TestCPPW65C816*, Test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
2026-11-13 Libc65 project, so HCP65-IDE indexes Libc65
    Libc65.vcxproj lists Libc65's sources, assembly (MathTbls too), headers
    and maths tables. It builds nothing: a Makefile project with no commands,
    in TestLibc65's and the six program solutions (Kernal, ModPlay,
    OperatingSystem, UARTTest, SoundBoard, UARTBoard) with no Build.0 lines.
    The HCP65 build still adds Libc65 to every program by its directory
    (-libc65); with the project listed, HCP65-IDE indexes its code and Rename,
    Find Usages and Go to Definition reach it and its assembly labels.
2026-11-13 W65C816 names in the assembler's syntax notes, Libc65's sections and the docs
    Assembler65816Syntax.txt is AssemblerW65C816Syntax.txt (beside
    Assembler65C64Syntax.txt) and "65816 Ordered Opcodes.txt" is
    "W65C816 Ordered Opcodes.txt"; their mentions follow. Libc65's W65C816
    sections are text.<Name>W65C816 / rodata.BitsW65C816. MathTables.txt and
    the docs site name IRW65C816Runtime.cpp, CIRW65C816Backend and
    CCPP65Builder::AddRuntime.
2026-11-13 W65C816 names for the assembler's enums
    EAsm65816Mode, EAsm65816Base and EAsm65816Flow are EAsmW65C816Mode,
    EAsmW65C816Base and EAsmW65C816Flow, and their values AW65C816M_,
    AW65C816B_ and AW65C816F_ (were A65816M_, A65816B_, A65816F_), as the
    CAsmW65C816 classes are named. Aligned comments and switch cases are
    realigned.
2026-11-13 The profile runs on either processor: CAsm65Profile on a CAsm65ProfiledCore
    CAsmW65C816Profile is CAsm65Profile (Asm65Profile.h/.cpp, its structs
    SAsm65FunctionProfile, SAsm65LineProfile and SAsm65CallSiteProfile), and
    Run takes the processor as a CAsm65ProfiledCore (Asm65ProfiledCore.h/.cpp):
    where it is, whether the instruction there calls, returns or sets the frame
    register, its stack and its cycles. CAsm65ProfiledW65C816 is the W65C816
    as it was profiled (the direct page counts are its frame register's);
    CAsm65Profiled65C64 is the 65C64, which had only a total of cycles.
    The W65C816's profile of TestBaseLib65 is the same: every function's
    calls and recursion, and the cycles.
2026-11-13 Libc65's 65C64 assembly has register entries
    The 65C64 compiler passes a function's first three arguments of 32 bits or
    less in A, B and Y and calls it at a label with a letter for each
    (_memcpy.aby). string.asm's memcpy, memmove, memset, memcmp and strlen
    work from the registers: their plain labels (calls through pointers, and
    from assembly) load them from the stack and go on in. Its other functions,
    and softfloat.asm's routines whose arguments are 32 bits (called by name
    from C++), have register labels that push the registers and call them.
    TestLibc65 on the 65C64: 154765 passed.
2026-11-14 Plan: W65C816 names outside the compiler's back end
    W65C816Names.txt plans renaming the names that still say 816 or 65816 in
    the assembler, the emulator, MicroprocessorLib, EmulatorDebugLib and the 65
    test projects, in seven steps. The back end's names wait until the session
    working on it is done.
2026-11-14 W65C816 names in the assembler's functions, tables and macros
    Step 1 of W65C816Names.txt: Assembler65Lib's Asm65816* functions (AsmW65C816Has,
    AsmW65C816Disassemble, AsmW65C816Flow ...), its gas/gaai/gac/gai/gasz/gb/giAsm65816*
    tables, SAsm65816Opcode, the ASM65816_* macros (ASM_W65C816_*), the include
    guards (__ASM_W65C816_*_H__), Index/Inner/Operand/Bits/Emit65816 and
    TickLow/TickHigh65816 are W65C816, in the library, the HCP65Lib debug decoder
    and the assembler's tests.
2026-11-14 W65C816 names in TestAssembler65Lib
    Step 2 of W65C816Names.txt: the assembler tests' TestAsm65816* functions,
    AssertAsm65816* helpers, gszTestAsm65816* sources and TEST_ASM65816_RUN_MEMORY
    are TestAsmW65C816*, AssertAsmW65C816*, gszTestAsmW65C816* and
    TEST_ASM_W65C816_RUN_MEMORY.
2026-11-14 Libc65's 65C64 assembly no longer keeps W
    W is a register like any other, which a call may change: string.asm pushes
    and pulls only V, and softfloat.asm's sqrt and double routines don't save W
    round their mul and div. 0.2% to 0.3% fewer cycles on the three suites.
2026-11-14 W65C816 names in the assembler's syntax note and the docs site
    Step 7 of W65C816Names.txt: the docs site's assembler pages name
    CAsmW65C816Assembler (was CAsm65816Assembler, the old class name) and
    TestAsmW65C816Opcodes; AssemblerW65C816Syntax.txt names TestAsmW65C816Opcodes
    and TickHigh/TickLowW65C816. InitFast65816 is still its name.
2026-11-14 W65C816 names in TestLibc65; W65C816 picks the target
    Step 6 of W65C816Names.txt: TestLibc65's cMPU816 and aiExpected816 say
    W65C816, and it takes "W65C816" on the command line for the W65C816 target,
    "816" still for short.
    [TestLibc65.cpp, TestLibc65Context.cpp, TestLibc65Context.h, TestLibc65Limits.cpp, TestLibc65SoftFloat.cpp]
2026-11-14 Tidy the W65C816 opcodes header and syntax note
    AsmW65C816Opcodes.h's function declarations are aligned, and
    AssemblerW65C816Syntax.txt's three paragraphs with lines past 100 characters
    are rewrapped to the note's width.
2026-11-14 TestLibc65 refuses an argument it doesn't know
    It takes W65C816 (or 816) for the W65C816 and 65C64 or nothing for the 65C64;
    anything else, or a second argument, is reported and it exits with 2 before
    running, instead of quietly testing the 65C64.
    [TestLibc65.cpp]
